wisehyun-2/my_robot_project/wheeled_biped/docs/balancing_robot_design/설계보고서.md

# 자가균형 로봇 설계 보고서 — ROS 2 + Teensy, 직접구동(Direct-Drive) 휠

> **2026-11-14:** 이 문서는 `balancing_robot_design/` 폴더에 있었다. 그 폴더는 지웠고 보고서 두 편과 `figures/`만 여기로 옮겼다. 본문에 나오는 `sim/`, `sim6/`, `sil/`, `firmware/`, `results/`의 파일은 git 태그 `before-cleanup-2026-11-14`의 `balancing_robot_design/`에 있다.

작성일 2026-10-20. 대상: 1번 레퍼런스(Ryung-coding IONIA)의 부품 구성 + DIABLO(DDTRobot) 아키텍처를 참고해 만드는 2륜 자가균형 로봇.
모든 수치 계산은 `sim/` 폴더의 스크립트로 재현 가능하며, 결과 원본은 `results/*.json`, 그림은 `figures/`에 있다.

---

## 0. 요약 (먼저 읽을 것)

| 질문 | 결론 |
|---|---|
| **1번 프로젝트 문제의 "상당수"가 균형 루프를 ROS 2에서 돌린 탓인가?** | **부분적으로만 사실.** 저자들이 기록한 문제 중 ROS 2/지연을 지목한 것은 하나도 없다. 코드를 보면 (a) 바퀴 속도 피드백이 아예 닫혀 있지 않고, (b) ODrive를 **속도 모드**로 쓰며, (c) 모터 명령이 Python 노드의 USB 동기 왕복 6회를 거치고, (d) IMU도 Python/pyserial을 거친다. 시뮬레이션상 이 구조는 지연과 무관하게 드리프트/불안정하고, I/O 경로 지연(추정 20–50 ms)은 안정 한계(30–40 ms) 근처다. 즉 원인은 "ROS 2 실행기"가 아니라 **제어 구조 + Python I/O 경로 지연 + 속도 모드**다. ROS 2 C++ 노드 100 Hz 자체의 오버헤드는 0.2 ms 수준이다. |
| **균형 루프를 MCU로 옮기는 것이 맞나?** | **맞다.** 다만 이유는 "ROS 2가 100 Hz를 못 돌려서"가 아니라 결정성(지터 µs), 센서→토크 지연 1–2 ms 확보, PC/ROS가 죽어도 서 있는 안전성(DIABLO·PX4·Segway 방식)이다. Ascento(NUC 400 Hz), Ollie(PC 1 kHz)처럼 PC에서도 가능하지만 C++·CAN·RT 커널이 전제다. |
| **어떤 제어기를 쓸 것인가?** | **LQR + 속도 적분(LQI), Teensy 4.1에서 1 kHz(최소 500 Hz), 토크(전류) 모드.** 계산 결과: 캐스케이드 PID는 수식상 상태 피드백의 부분집합이라 같은 게인이면 성능이 동일하고(그림 겹침), LQR은 그 게인을 모델에서 바로 얻는다. MPC는 회복 가능 틸트(40°)·푸시(100 N) 모두 LQR과 **동일**했고, 속도 제한 상황도 "LQR + 레퍼런스 클리핑/램프"가 MPC와 동급이었다. MPC는 Teensy에서 2–8 ms/solve라 100 Hz는 가능하나 1 kHz는 불가 → 2단계(휠-레그, 명시적 제약)로 미룬다. DIABLO도 LQR(8상태, 적분 포함)이다. |
| **직접구동 하드웨어 (5–10 kg, DDT 제품 제외)** | 24 V 6S, **MyActuator RMD-L-9015-35T**(1.67 Nm 연속/5 Nm 최대, Kt 0.45, 650 g, CAN 1 Mbps 전류 지령, 14-bit 엔코더, $219) ×2를 5 kg·10 kg 공통 1순위. 5 kg 경량화면 RMD-L-7015(360 g), 10 kg 연속토크 여유면 RMD-L-9025, 최저가·최대토크면 호버보드 허브 + ODrive S1 + 외부 엔코더, 직접구동 포기 시 CyberGear. Teensy 4.1 + CAN(FD) 트랜시버 + ICM-42688-P(SPI) → CAN 토크 명령 1 kHz, UART 460800으로 PC(ROS 2)와 100 Hz 텔레메트리/50–100 Hz 명령. |

산출물: 설계 보고서(이 문서), 동역학 모델·제어기 비교 시뮬레이션(`sim/`), 게인 생성기(`sim/gen_gains.py`), Teensy 균형 루프 스켈레톤(`firmware/teensy_balance/teensy_balance.ino`), 그림 6장.

---

## 1. 레퍼런스 1 (Ryung-coding / IONIA) 분석

### 1.1 코드가 실제로 하는 일 (저장소 HEAD 기준, 사실)

저장소: https://github.com/Ryung-coding/ICT2024_surveillance_balancing_robot

| 항목 | 내용 | 파일 |
|---|---|---|
| 균형 루프 | C++ ROS 2 노드, `rclcpp::WallRate(100)` + `spin_some` while 루프 → **100 Hz** | `src/controller/src/controller_main.cpp`, `include/controller_main.h` (`#define loop_hz 100`) |
| IMU 입력 | 시리얼 AHRS(921600 baud, roll/pitch/yaw + gyro 패킷)를 **Python pyserial** 노드가 바이트 단위 파싱 → `JointState` 토픽 | `src/serial_reciver/.../serial_reciver_node.py` |
| Teensy 역할 | SBUS 수신기·GPS 패킷을 PC로 전달하는 **센서 브리지뿐**. 균형 루프 없음 | 같은 파일 (`TeensyReceiver`) |
| 모터 명령 | C++ → `Float64MultiArray` 토픽 → **Python ODrive 노드** → `odrive` 라이브러리(USB native/fibre) → `input_vel` (**속도 모드**) | `src/odrive_controller/.../odrive_controller.py` |
| ODrive 콜백당 USB 왕복 | `hall_state`, `axis.error`, `motor.error` 읽기, `input_vel` 쓰기, `vel_estimate`, `pos_estimate` 읽기 = **6회 동기 왕복/명령** | 같은 파일 |
| 구동 바퀴 | **axis0 하나만** 명령 발행. 우측(`odrive_publisher_1`)은 주석 처리 | `controller_main.cpp` |
| "속도 외부 루프" | `computePID(0, ref[1], 0, dt, 0)` — 피드백 자리에 **조종기 스틱값**이 들어감. 바퀴 속도는 쓰이지 않음. 게다가 구독 토픽은 `dubal_vel`, ODrive 노드가 발행하는 토픽은 `dubal_data` (이름 불일치 → 데이터가 오지도 않음) | `controller_main.cpp`, `odrive_controller.py` |
| 내부 각속도 루프 | θ̇ 오차 → 모터 속도 명령. θ̈는 100 Hz 수치미분 + LPF(0.9). 코드 주석: `(Not working!!!!!!!!!!!!)` | `controller_main.cpp` |
| 기타 | 100 Hz마다 `RCLCPP_INFO` 로그, ODrive `enable_watchdog = False`, Hall 센서 기반 속도 추정, 적분 안티와인드업만 존재 | |

정리하면 README의 "3중 루프"는 실제로는 **틸트 PID + 스틱 피드포워드**이고, 바퀴 속도/위치 피드백이 없다.

### 1.2 저자들이 직접 기록한 문제

| 기록 | 출처 | 성격 |
|---|---|---|
| "시리얼 포트가 바뀌는 이슈 있으니 확인하고 해야함" | 커밋 d70d6ab (2024-08-29) | Linux 장치 이름(udev) 문제. 타이밍과 무관 |
| "축이 갈려서 D게인을 실제로 잘 반영을 못하고 있었음" | 커밋 ef11ca7 (2024-08-22) | IMU 축/부호 실수 |
| 게인 튜닝 반복(63bc319, 01f5961, 61a8018, d70d6ab) | 커밋 로그 | 통상적 튜닝 |
| 내부 루프 `Not working` | 코드 주석 | 원인 미기록 |
| 빌드 실패(`dubal_eye_and_web` 디렉토리 이름 불일치) | `log/build_*/` | 패키징 |

ROS 2, 지연, 지터, 메시지 드롭을 언급한 기록은 **없다.** (GitHub 이슈 4건은 제목이 무의미 문자열, Notion 페이지는 README 복제 + 코드 나열.)

### 1.3 "ROS 2 때문"이라는 주장의 검증

**(a) 문헌 수치 — ROS 2/Linux/USB 경로가 실제로 얼마나 느린가**

| 항목 | 수치 | 조건 | 출처 |
|---|---|---|---|
| ROS 2 pub→sub 종단 지연(프로세스 간, 3노드) | 약 0.15–0.2 ms (95%) | Foxy, i7 데스크톱, 일반 커널 | Kronauer et al. 2021, https://arxiv.org/abs/2101.02074 |
| 같은 것, Raspberry Pi 4 | 1.0–1.6 ms | 같은 조건 | 같은 논문 |
| ROS 2 1 kHz 실시간 데모 지연 | 평균 19.9 µs, **최대 2.75 ms** | 일반 커널 rclcpp | https://docs.ros.org/en/dashing/Tutorials/Real-Time-Programming.html |
| 일반 Linux 스케줄링 지연(cyclictest) | I/O 부하 시 > 5 ms, 디스크 부하 시 80–200 ms 스파이크 | 일반 커널 / PREEMPT_RT는 < 50 µs | Cerqueira & Brandenburg, OSPERT 2013 |
| **rclpy(Python) 50 Hz 타이머** | 간격이 최대 **100 ms**까지 벌어짐, 센서 메시지 200 ms 지연 | RPi4, Eloquent | https://www.barkhauseninstitut.org/research/lab-1/our-blog/posts/soft-realtime-performance-of-rclpy |
| FTDI USB-시리얼 latency timer | 기본 **16 ms** 버퍼 플러시 | Linux ftdi_sio | https://granitedevices.com/wiki/FTDI_Linux_USB_latency |
| ODrive USB native 1회 읽기/쓰기 | 0.25–0.3 ms (PC), **1.6–1.7 ms (RPi/Jetson)**; 사용자 보고: 6읽기+2쓰기로 ≈100 Hz 한계 | odrive Python 라이브러리 | https://discourse.odriverobotics.com/t/decreasing-latency/1463 |
| ODrive 공식 권고 | CAN은 "호스트 컴퓨터가 없어 지연·지터가 낮다" | | https://docs.odriverobotics.com/v/latest/guides/can-guide.html |
| ros2_control 공식 문서 | "일반 Linux 커널은 처리량에 최적화되어 하드웨어 제어에 적합하지 않다" → RT 커널·SCHED_FIFO 권고 | | https://control.ros.org/rolling/doc/ros2_control/controller_manager/doc/userdoc.html |

**(b) 실제 균형 로봇들은 어디서 균형 루프를 도는가**

| 로봇 | 위치 / 주기 | 출처 |
|---|---|---|
| DIABLO (DDT) | **MCU(ChibiOS/RT)**, BMI088 SPI, CAN→드라이버, LQR. PC는 UART로 setpoint만 | https://arxiv.org/abs/2407.21500 |
| Ascento (ETH) | Intel NUC, ROS/C++ **400 Hz**, CAN 모터 | https://arxiv.org/pdf/2005.11431 |
| Tencent Ollie | 온보드 x86 PC **1 kHz**, IMU 400 Hz | https://www.frontiersin.org/journals/neurorobotics/articles/10.3389/fnbot.2022.1102259/full |
| Rezero 볼봇 (ETH) | i7 추정기 400 Hz, MPC ≈70 Hz(ROS 노드), 토크 루프는 드라이버 2.5 kHz | https://arxiv.org/pdf/1902.10415 |
| Segway PT | 제어 프레임 ≥ **100 Hz**("100 Hz 미만이면 탑승자가 불안정하게 느낌") | 특허 US6796396B2 |
| PX4 드론 | NuttX RTOS 비행 컨트롤러, Linux는 비전만 | https://docs.px4.io/main/en/concept/architecture.html |

즉 "PC+ROS에서 균형 루프"는 C++·저지연 버스·(대개) RT 커널이면 성립하고, 100 Hz도 Segway 수준이다.

**(c) 이 로봇 모델로 직접 계산한 지연 허용치** (`sim/analysis_controllers.py`, `figures/stability_map_rate_vs_latency.png`)

세 파라미터 세트(1번 로봇 유사 / 계획 로봇 / 무거운 로봇)에 대해, 각 루프 주기마다 이산 LQR을 다시 설계하고 센서→토크 총 지연을 바꿔가며 3° 기울임에서 복귀하는지 시뮬레이션했다.

| 로봇 (불안정 극) | 50 Hz | 100 Hz | 200 Hz | 500 Hz | 1 kHz |
|---|---|---|---|---|---|
| 1번 유사(105 mm 휠, 8.2 rad/s) | 30 ms | 30 ms | 30 ms | 30 ms | 30 ms |
| 계획(10 kg, 6.5" 휠, 6.9 rad/s) | 40 ms | 40 ms | 40 ms | 40 ms | 40 ms |
| 무거운(15 kg, 8" 휠, 6.2 rad/s) | 40 ms | 40 ms | 40 ms | 40 ms | 40 ms |

(표의 값 = 복귀에 성공한 최대 총 지연. 위상여유 72°, 교차주파수 29.6 rad/s 설계 → 이론 지연여유 43 ms와 일치.)

핵심: **이 대역폭의 설계에서는 루프 주기(50 Hz–1 kHz)는 거의 무관하고, 총 지연이 30–40 ms를 넘으면 넘어진다.** 더 뻣뻣한(교차 100 rad/s) 설계라면 허용 지연이 10 ms 수준으로 줄어 1 kHz + 저지연이 필요해진다.

같은 모델에서 100 Hz + 15 ms 지연은 1 kHz + 1 ms와 거의 같은 응답(12° 복귀 정착 1.05 s vs 1.05 s)이지만, **100 Hz + 40 ms**는 서 있기는 해도 정착 3.1 s, 토크 RMS 5배, 바퀴 속도 피크 1.15 m/s(0.49 대비)로 크게 흔들린다(`figures/time_response_comparison.png`, 빨간 선).

**(d) 1번 프로젝트의 경로 지연 추정 (측정값 아님, 문헌 수치로 합산)**

IMU 내부 출력 주기(≈10 ms 추정) + USB-시리얼(CP210x 1 ms / FTDI 최대 16 ms) + Python 파싱·DDS(≈1 ms) + 100 Hz 루프 대기(평균 5 ms) + DDS→Python ODrive 노드(USB 6회 왕복: PC 2 ms, ARM 보드 10 ms) + ODrive 속도 루프(Hall 센서, 수십 ms 응답) ≈ **20–50 ms**. 안정 한계(30 ms) 근처라 "흔들리며 서 있는" 상태와 부합한다.

**(e) 그러나 구조적 문제가 더 크다** (`results/velocity_mode_latency_tolerance.json`)

1번 로봇 모델로 "속도 모드 + 바깥 PD(θ)" 구조를 시뮬레이션하면:

| 구조 | 100 Hz 허용 지연 | 500 Hz 허용 지연 |
|---|---|---|
| 토크 모드, LQR (직접구동 권장 구조) | 30 ms | 30 ms |
| 속도 모드, 드라이버 P 루프만 + 바깥 PD(θ) **+ 바퀴속도 피드백** | 40 ms | 40 ms |
| 속도 모드, 드라이버 **PI** 루프(ODrive 기본) + 바깥 PD(θ)만 (**1번 구조**) | 불안정 (지연 0에서도) | 불안정 |
| 속도 모드, P 루프 + 바깥 PD(θ)만 (바퀴 피드백 없음) | 불안정 | 불안정 |

이유(수식): 드라이버 속도 루프 τ = Kp_v(ω_ref − ω)는 토크 모드로 환산하면 바퀴 속도에 **음의 피드백**(−Kp_v/r)을 거는 것인데, 균형에는 바퀴 속도에 **양의 피드백**(LQR의 k_v > 0 항)이 필요하다. 바깥 루프가 바퀴 속도를 되먹이지 않으면 이를 상쇄할 수 없고, 적분기가 있으면 정상상태에서 토크가 θ에 의존하지 않게 되어 복원력 자체가 사라진다. 토크 모드 캐스케이드라도 바퀴 피드백이 없으면 각도는 잡히지만 속도가 0.3–0.5 m/s로 드리프트한 채 돌아오지 않는다(그림의 갈색 선).

**결론:** "1번의 문제 상당수가 ROS 2에서 균형 루프를 돌린 데서 왔다"는 **근거 없는 과장**이다. 근거 있는 원인은 (1) 바퀴 속도 피드백 누락·토픽 불일치·한쪽 바퀴만 구동, (2) ODrive 속도 모드 + 적분기, (3) Python I/O 경로(pyserial IMU, USB ODrive 6회 왕복)의 20–50 ms 지연, (4) Hall 센서 속도 추정이다. (3)은 MCU+CAN으로 옮기면 1–2 ms로 사라지므로 **이전 결정은 옳지만**, (1)(2)(4)는 Teensy로 옮겨도 그대로 재현된다. 이 보고서의 제어기·하드웨어 설계는 이 네 가지를 모두 제거하는 것을 목표로 한다.

---

## 2. DIABLO 아키텍처 — 무엇을 베낄 것인가

출처: 논문 https://arxiv.org/abs/2407.21500, SDK https://github.com/DDTRobot/diablo_ros2, 문서 https://diablo-sdk-docs.readthedocs.io, 사용자 매뉴얼 V1.1.

| 계층 | DIABLO (문서화된 사실) | 이 프로젝트에 적용 |
|---|---|---|
| 실시간 보드 | ChibiOS/RT MCU. BMI088 IMU(SPI), CAN으로 6개 M1502D 드라이버, LQR 균형/요, PD+FF 높이, 롤, 다리 split, 상보필터 추정기, 점프·낙상복구, BMS, 워치독. 루프 주기·MCU 품번은 미공개(텔레메트리 옵션 1 kHz로 보아 ≥1 kHz 추정) | Teensy 4.1 (Cortex-M7 600 MHz), 1 kHz 타이머 ISR, IMU SPI, CAN 토크, LQI |
| 호스트 링크 | UART **460800 8N1**, OSDK 프레임(SOF 0xAA, 헤더 12 B, CRC16 ×2). 명령: 활성화, 제어권 요청(`timeout_ms` 기본 500 ms 동안 유효한 메시지가 없으면 제어권 자동 해제. 해제 후 동작은 `timeout_act` 비트로 선택: 1 = 실제 RC로 전환, 0 = 전환 없이 끊김 처리 프로그램 실행. **SDK는 0 고정**, `osdk_movement.cpp`), 이동 명령(전진 m/s, 요 rad/s, 높이, 롤, 피치, split), 모드, 변신/점프, 비상 브레이크 | 동일한 UART 460800 + 경량 바이너리 프레임, 또는 micro-ROS (3.4절) |
| 텔레메트리 | 토픽별 1/10/50/100/500/1000 Hz 선택. ROS 노드는 IMU·모터 **50 Hz**, 상태 10 Hz, 전원 1 Hz. 대역폭 ≤ 0.75×baud 가드 | 상태 100 Hz, IMU 200 Hz(옵션), 전원 1 Hz |
| 명령 주기/안전 | 이동 명령은 ACK 없이 스트리밍, 마지막 명령을 **180 ms마다 재전송**(keep-alive), 모드 변경은 100 ms ACK, 수신 타임아웃 1 s → DISCONNECT. 제어권 만료 시 SDK 기본값(`timeout_act=0`)으로는 RC로 넘어가지 않고 MCU의 끊김 처리 프로그램 실행(동작 내용은 펌웨어 비공개라 미확인), RC 자동 전환은 `timeout_act=1`일 때만 | 명령 타임아웃 0.5 s → v=0 유지, 2 s → 모터 OFF, RC(SBUS) 백업 |
| 제어기 | 8상태 LQR [γ, θ, x, γ̇, θ̇, ẋ, ∫γ, ∫x], Q/R 튜닝 후 DARE 풀이(Webots), 요 LQR, 높이 PD+FF. "LQR·MPC 중 해석 가능성과 튜닝 용이성 때문에 모델 기반 LQR 선택", WBC는 향후 과제 | 5상태 LQI [x(0), ẋ, θ, θ̇, ∫ẋ] + 요 PD. 다리(높이) 추가 시 PD+FF |
| 액추에이터 | M1502D 직접구동 ×6: 정격 9.6 Nm/115 rpm, 스톨 17 Nm, 24 V, Kt 0.88, 16384 cnt 절대 엔코더, 2.3–2.6 kg. 로봇 22.9 kg, 2 m/s | 3.2절의 M15 계열 |

DDT가 "왜 균형을 MCU에 두는가"를 명시한 문장은 없지만, 논문은 "주변장치 통신과 모션 제어는 RTOS MCU, 내비게이션·인식 등 연산 집약 작업은 ROS 미니 PC"로 역할을 나누고, 균형 루프의 레퍼런스가 PC 또는 RC 둘 중 어디서든 올 수 있게 해 **PC가 없어도 서 있도록** 설계했다. 2026-10 DDT 블로그는 SDK 사용자에게 "네트워크 지연, 오래된 명령, 제어권 상실에 대한 동작을 직접 정의하라"고 쓴다.

---

## 3. 하드웨어 아키텍처 (직접구동, 고 Kt 모터)

### 3.1 필요한 토크·속도 (모델 계산, `results/torque_sizing.json`, `results/sizing_options_*.json`)

모델: 2륜 역진자(TWIP), 직접구동이라 모터 토크 = 바퀴 토크, 반작용이 몸체에 작용. 파라미터는 **가정값**이며 실제 로봇에서 측정 후 `gen_gains.py`로 재계산해야 한다. 목표 로봇 질량은 **5–10 kg**이므로 두 끝단을 모두 계산했다.

| 파라미터 세트 | 총질량 | 몸체 M_b | 휠(모터 포함) m_w | 반경 r | 무게중심 높이 l | 몸체 관성 I_b | 불안정 극 | 10°/20° 정적 유지 토크(합) |
|---|---|---|---|---|---|---|---|---|
| **소형(5 kg급)** | ≈4.6 kg | 3.2 kg | 0.7 kg | 65 mm (5") | 0.16 m | 0.07 | 6.9 rad/s (145 ms) | 0.9 / 1.7 Nm |
| **대형(10 kg급)** | ≈9.4 kg | 7 kg | 1.2 kg | 82.5 mm (6.5") | 0.25 m | 0.20 | 6.9 rad/s (145 ms) | 3.0 / 5.9 Nm |
| (참고) 1번 유사 | 5.2 kg | 4 kg | 0.6 kg | 52.5 mm | 0.18 m | 0.06 | 8.2 rad/s (122 ms) | 1.2 / 2.4 Nm |
| (참고) 15 kg급 | 15.2 kg | 12 kg | 1.6 kg | 100 mm (8") | 0.35 m | 0.60 | 6.2 rad/s (161 ms) | 7.2 / 14.1 Nm |

**바퀴당** 요구 토크 (LQR 1 kHz로 복귀 시 피크, IMU 노이즈 포함; 소형은 1번 유사 세트와 거의 같다):

| 상황 | 소형 5 kg급 (1번 유사) | **대형 10 kg급** | 15 kg급 |
|---|---|---|---|
| 5° 기울임 복귀 피크 | 0.56 Nm | 1.56 Nm | 3.2 Nm |
| 10° 복귀 피크 | 1.13 | 3.12 | 6.4 |
| 15° 복귀 피크 | 1.69 | **4.69** | 9.6 |
| 20° 복귀 피크 | 2.25 | 6.25 | 12.8 |
| 40 N × 0.1 s 푸시 | ≈0.7 | 1.36 | — |
| 1 m/s 속도 스텝(1 m/s² 램프) | 0.2 | 0.34–0.5 | — |
| 10° / 15° 경사 유지(연속) | 0.23 / 0.35 | 0.66 / 0.98 | 1.29 / 1.93 |
| 1.0 / 1.5 m/s에 필요한 바퀴 rpm | 147 / 220 (r 65 mm) | 116 / 174 | 96 / 143 |

요구 사양 요약 (바퀴당):

| | 소형 5 kg급 | 대형 10 kg급 |
|---|---|---|
| 정지 연속 토크 | ≥ 0.5–1 Nm | ≥ 1.5–2 Nm |
| 피크 토크(15–20° 복귀) | ≥ 2–2.5 Nm | ≥ 5–6.5 Nm |
| 무부하 속도 | ≥ 250 rpm (1.5 m/s + 여유) | ≥ 220 rpm |
| 휠+모터 질량 | ≤ 0.9 kg | ≤ 1.5 kg (호버보드급 2.9 kg도 가능하나 총질량 상승) |
| 전원 | 24 V (6S), 피크 15 A 이내 | 24 V (6S), 피크 15–20 A |

직접구동은 정지 상태에서 토크를 내므로 "정지 연속 토크(열)"가 구속 조건이고, 프로펠러 냉각을 전제로 한 드론 모터 스펙은 그대로 쓸 수 없다.

### 3.2 모터 + 드라이버 후보 (DDT/DIABLO 제품 제외, 시판품만. 2026-10 판매 페이지 기준, 1개 정가)

DDT를 제외하면 "기어 없는 직접구동 + FOC 드라이버·엔코더 내장 + CAN 토크 모드"를 만족하는 시판 모터는 사실상 **MyActuator RMD-L 시리즈**와 **LK Tech MF 시리즈**뿐이다. 그 외는 (a) 허브 모터 + 외부 FOC 드라이버, (b) 짐벌 모터 + 외부 FOC 드라이버, (c) 저감속비 유성기어 액추에이터(직접구동 포기)다. 구매 채널: RobotShop(한국 배송), OpenELAB, AliExpress 공식 스토어, mjbots, ODrive 공식몰; 국내몰(디바이스마트·엘레파츠)은 Teensy·IMU·트랜시버·배터리 등 주변 부품 위주.

**표 A. 직접구동 + 드라이버 내장 (1순위 계열)**

| 모델 | 정격 / 최대 토크 | Kt | 질량 | 전압 / 속도 | 엔코더·버스 | 토크 모드 | 가격 | 적합 등급 | 출처 |
|---|---|---|---|---|---|---|---|---|---|
| **MyActuator RMD-L-9015-35T** | 1.67 / **5.0 Nm** (11 A) | 0.45 | 650 g | 24 V (8–36), 정격 290 / 무부하 500 rpm | 14-bit 자기식, **CAN 1 Mbps** / RS485 | "Torque open loop"(전류 지령) 명시 | **$219** | **5 kg·10 kg 모두** | https://www.robotshop.com/products/myactuator-rmd-l-9015-35t-bldc-can-bus-servo |
| **MyActuator RMD-L-9025-35T** | 2.42–2.79 / 4.58–5.8 Nm (리셀러마다 상이) | 0.76 | 880 g | 24 V, 130–490 rpm | 14-bit, CAN 1 Mbps (2 kHz 통신) | 전류 지령 | $237–350 (일부 품절) | 10 kg | https://www.robotshop.com/products/myactuator-rmd-l-9025-35t-brushless-dc-servo-motor-can |
| **MyActuator RMD-L-7015-23T** | 1.0 / **3.8 Nm** (15 A) | 0.28 | **360 g** | 12–24 V, 정격 580 / 최대 805 rpm | 18-bit, CAN 2.0B 1 Mbps | 전류 지령 | $199 (£107) | **5 kg** | https://openelab.com/products/myactuator-rmd-l-7015-can |
| LK Tech MF9025 V2 | 2.42 / 4.5 Nm | ≈0.7 | ≈0.9 kg | 24 V | 18-bit, CAN/RS485, 토크 루프 24 kHz | 전류 지령 | 리셀러 | 10 kg | https://www.roboticscenter.ai/pt/store/product/lkmtech-mf9025-v2-motor |
| Waveshare DDSM115 | 0.96 / 2.0 Nm (8 A) | 0.75 | 770 g (타이어 포함) | 12–24 V, 115 / 200 rpm | 4096, **RS485 115200, ≤500 Hz** | 전류 루프 | $65 | 5 kg (속도 1.3 m/s 한계) | https://www.waveshare.com/wiki/DDSM115 |

DDSM115는 Waveshare 브랜드로 Waveshare 스토어·AliExpress에서 팔리지만 제조는 DDT(M0601C와 동일 스펙)이므로, DDT 제품을 피하는 이유가 "브랜드 자체"라면 제외한다.

**표 B. 허브 모터 + 외부 FOC 드라이버 (저가·재활용 계열)**

| 모터 | 토크 | Kt | 질량 | 센서 | 드라이버 | 평가 | 출처 |
|---|---|---|---|---|---|---|---|
| 호버보드 6.5" 허브 (36 V 250–350 W, 15극쌍) | 데이터시트 없음. 사용자 보고: 연속 2–3 Nm(열), 20 A 피크 ≈ 10 Nm | ≈0.52 (KV≈16, ODrive 규약 8.27/KV) | ≈2.9 kg/휠 | Hall 90 cpr → **외부 엔코더 추가 권장**(AS5047P/MT6701 + 회전 커버에 직경자화 자석, 또는 ODrive S1 온보드 엔코더) | ODrive S1 ($149, 40/80 A, CAN 1 Mbps, 8 kHz 루프, 토크 모드 `Set_Input_Torque`) | 10 kg급에 토크 여유 최대. 무겁고 총질량이 커짐. 1번 프로젝트 부품 재활용 가능 | https://docs.odriverobotics.com/v/0.5.6/hoverboard.html , https://shop.odriverobotics.com/products/odrive-s1 |
| 전동킥보드 8"/8.5" 허브 (36 V 250 W, Xiaomi M365류) | 사용자 보고 수준 | ≈0.5 | ≈2 kg | Hall | ODrive S1 / Micro | 10 kg급 대안. 타이어 포함 완제품이라 조립 쉬움 | 리셀러 |

**표 C. 짐벌/아웃러너 모터 + 외부 FOC (경량·고대역폭 계열)**

| 모터 | 토크 | Kt | 질량 | 드라이버 | 평가 | 출처 |
|---|---|---|---|---|---|---|
| iPower GM110-8 (24N28P 짐벌) | 0.78–1.18 Nm @2 A, ≤60 W | ≈0.5–0.8 | 534 g | moteus c1 ($69, 5/14 A, CAN-FD) 또는 ODrive Micro ($89, 3.5/7 A) | **5 kg에 한계**: 무부하 130 rpm(0.9 m/s), 피크 2 Nm → 모델상 30° 복귀·30 N 푸시까지. 저속 실내용 | https://shop.iflight.com/ipower-motor-gm110-8-brushless-gimbal-motor-pro197 |
| mjbots mj5208 | 1.7 Nm 피크(600 W), 연속 ≈0.4 Nm | ≈0.03 | 193 g | moteus c1 | 피크는 충분하나 피크 전류 57 A·정지 연속 토크 부족 → 5 kg도 냉각 전제 | https://mjbots.com/products/mj5208 |
| T-Motor U8 Lite KV85 / U10 II KV100 | 180 s 피크 2.1 / 3.6 Nm | ≈0.11 / 0.095 | 243 / 415 g | moteus n1 ($149, CAN-FD 5 M) | 10 kg에 피크는 가능, 정지 연속 토크는 냉각 필요. 연구용 | https://store.tmotor.com |

**표 D. 저감속 유성기어 액추에이터 (직접구동 포기 시 대안, 모두 CAN MIT식 토크 모드)**

| 모델 | 감속비 | 정격 / 최대 토크 | 질량 | 가격 | 평가 | 출처 |
|---|---|---|---|---|---|---|
| Xiaomi CyberGear | 7.75:1 | 4 / 12 Nm | 317 g | $90–165 | 가장 싸고 가볍다. 백래시·기어 마찰이 토크 투명성 저하, 지연여유 13–23 ms로 줄어듦(관성 반영) | https://openelab.io/blogs/learn/xiaomi-cybergear-micromotor-guide |
| CubeMars AK60-6 V3 | 6:1 | 3 / 9 Nm | 380 g | $230–300 | 5–10 kg 모두 가능 | https://www.cubemars.com |
| CubeMars AK70-10 / AK80-9 | 10:1 / 9:1 | 8.3 / 24 Nm, 9 / 18 Nm | 520 / 485 g | $400–580 | 10 kg 이상 | https://www.cubemars.com |

**후보별 모델 계산 결과** (`sim/sizing_options.py`, 1 kHz LQI, 2 ms 지연, 모터 토크-속도 포락선 포함)

| 후보 (바퀴당) | 5 kg급: 최대 복귀 틸트 / 푸시(0.1 s) / 1.5 m/s | 10 kg급: 틸트 / 푸시 / 1.5 m/s | 피크 상전류 |
|---|---|---|---|
| RMD-L-7015-23T | 45° / 190 N / 가능 | — (피크 3.8 Nm으로 15° 복귀 한계) | 13.6 A |
| **RMD-L-9015-35T** | 45° / 120 N / 가능 | 45° / 200 N / 가능 | 11.1 A |
| RMD-L-9025-35T | 45° / 120 N / 가능 | 45° / 200 N / 가능 | 6.0 A |
| LK MF9025 V2 | — | 45° / 170 N / 가능 | 6.4 A |
| DDSM115 | 40° / 40 N / **불가(무부하 200 rpm)** | — | 2.7 A |
| 호버보드 + ODrive S1 (12–20 A) | — | 45° / 200 N / 가능 | 11.5–19 A |
| GM110-8 + moteus c1 | 30° / 30 N / 불가 | — | 2.5 A |
| CyberGear (기어) | 45° / 110 N / 가능 | 45° / 200 N / 가능 | 13.8 A |

(틸트·푸시 상한 45°·200 N은 스윕 범위 끝이며 물리 한계가 아니다.)

**선정**

| 등급 | 1순위 | 2순위 | 근거 |
|---|---|---|---|
| **5 kg급** | **RMD-L-9015-35T ×2** ($219, 650 g, 5 Nm 피크) | RMD-L-7015-23T ×2 ($199, 360 g, 3.8 Nm 피크) — 더 가볍고 빠르나 Kt 0.28이라 피크 15 A | 요구(연속 0.5–1, 피크 2–2.5 Nm, 250 rpm)를 2배 여유로 충족, CAN 1 Mbps 전류 지령, 14/18-bit 엔코더 내장 |
| **10 kg급** | **RMD-L-9015-35T ×2** 또는 **RMD-L-9025-35T ×2** | 호버보드 6.5" + ODrive S1 + 외부 엔코더 (최저가, 토크 여유 최대, 무거움) | 9015는 피크 5 Nm으로 15–16° 복귀까지, 9025는 연속 2.4 Nm으로 경사·연속 주행 여유. 20° 이상 복귀나 거친 외란이 필요하면 호버보드+ODrive |
| 공통 대안 | CyberGear ×2 | — | 직접구동을 포기할 수 있다면 가장 싸고 가볍다 |

**RMD-L 시리즈는 5–10 kg 전 구간에서 같은 모델(9015)로 통일 가능**하므로 1순위로 둔다. 바퀴는 모터 출력 플랜지에 직접 볼트 체결하는 5"(소형) 또는 6.5"(대형) 림+타이어(전동킥보드 솔리드 타이어, AliExpress)를 쓴다. 구매 전 확인: MyActuator CAN 프로토콜 문서의 "torque closed-loop control command"(0xA1, Iq 지령 단위·스케일)와 2 kHz 통신 주기, 리셀러마다 다른 피크 토크 수치(4.58 vs 5.8 Nm)는 공식 데이터시트로 확정.

Kt 환산: Kt[Nm/A] ≈ 9.55/KV[rpm/V] (SI), ODrive 표기 규약은 8.27/KV. 벤더 간 10–15 % 차이(RMS/peak 규약)가 있으니 **전류 명령 스케일은 실측(매달고 토크 측정)으로 보정**한다.

### 3.2a 전체 BOM (시판품, 5 kg급 기준; 10 kg급은 ★ 표시 항목만 교체)

| # | 부품 | 모델 / 사양 | 수량 | 단가(USD) | 구매처 |
|---|---|---|---|---|---|
| 1 | 휠 모터(FOC·엔코더 내장) | **MyActuator RMD-L-9015-35T** CAN (★10 kg: 9015 유지 또는 9025-35T) | 2 | 219 (★ 237–350) | RobotShop, AliExpress MyActuator 공식 |
| 2 | 림+타이어 | 5" 솔리드 타이어 + 알루미늄 림, 모터 플랜지 체결 (★ 6.5") | 2 | 15–30 | AliExpress |
| 3 | MCU | **Teensy 4.1** (핀 헤더 포함) | 1 | 35 | 디바이스마트 / PJRC / SparkFun |
| 4 | CAN 트랜시버 | SN65HVD230 3.3 V 브레이크아웃(CAN 2.0B, RMD용) — CAN-FD 드라이버(moteus) 쓸 때만 MCP2562FD/TCAN330 | 1–2 | 3–10 | 디바이스마트 / AliExpress |
| 5 | IMU (SPI) | **ICM-42688-P** 브레이크아웃 (대안: Adafruit ISM330DHCX/LSM6DSOX, BMI088 보드) | 1 | 10–25 | AliExpress / Adafruit(국내 리셀러) |
| 6 | RC 수신기(백업·킬스위치) | SBUS 수신기 (FrSky/Radiomaster/ELRS) | 1 | 20–30 | 국내 RC몰 |
| 7 | 배터리 | **6S Li-ion 22.2 V 3–5 Ah** + BMS (★ 5–10 Ah) | 1 | 60–120 | 국내 배터리몰 / AliExpress |
| 8 | 전원 보호 | 블레이드 퓨즈 15 A (★ 30 A), E-stop 스위치 + 릴레이/컨택터(모터 전원만 차단), TVS 다이오드 또는 브레이크 저항(회생) | 1식 | 20–40 | 디바이스마트 |
| 9 | DC-DC | 24→5 V 5 A (Teensy·IMU·RC), 24→5 V 5 A 또는 19 V (PC) | 2 | 10–20 | 디바이스마트 |
| 10 | 컴패니언 PC | Raspberry Pi 5 8 GB (비전 경량) 또는 Jetson Orin Nano Dev Kit (비전 중량) | 1 | 80 / 250 | 국내 리셀러 |
| 11 | 카메라 | Raspberry Pi Camera 3 / USB 글로벌셔터 | 1 | 25–60 | 국내 리셀러 |
| 12 | 배선 | CAN 트위스트페어 + 120 Ω 종단 2개, XT60/XT30, 전원 분배보드 | 1식 | 20 | 디바이스마트 |
| 13 | 프레임 | 알루미늄 프로파일 2020 + 3D 프린트 브래킷 | 1식 | 50–100 | 국내 |
| | **합계(모터 2개 포함)** | | | **≈ 650–900 (5 kg) / ≈ 750–1100 (10 kg)** | |

호버보드+ODrive 경로로 바꿀 때: 1→ 호버보드 모터 중고 2개(≈40) + ODrive S1 2개(298) + AS5047P 엔코더 2개(20) + 자석·브래킷, 7→ 36 V 10S 또는 24 V(ODrive S1 12–48 V), 8→ 퓨즈 40 A·브레이크 저항 필수(ODrive S1 내장 브레이크 초퍼 사용).

### 3.2b 구매 링크 (2026-10-20 확인. ✔ = 상품 페이지 확인, 🔍 = 검색 페이지·키워드)

| 부품 | 링크 | 비고 |
|---|---|---|
| RMD-L-9015-35T | ✔ https://www.robotshop.com/products/myactuator-rmd-l-9015-35t-bldc-can-bus-servo | $219.34, 한국 배송. 제조사 코드 RMD-L-9015-200-C(CAN) 확인 후 주문 |
| RMD-L-9025-35T | ✔ https://www.robotshop.com/products/myactuator-rmd-l-9025-35t-brushless-dc-servo-motor-can | $237–350, 품절 잦음 |
| RMD-L-7015-23T | ✔ https://openelab.com/products/myactuator-rmd-l-7015-can , ✔ https://uk.robotshop.com/products/myactuator-rmd-l-7015-200-bldc-motor-w-controller-position-sensor-can-bus | $199 / £107 |
| MyActuator 전체 | ✔ https://community.robotshop.com/forum/t/myactuator-is-now-officially-part-of-the-robotshop-marketplace/78207 (RobotShop 공식 벤더), 제조사 https://www.myactuator.com | 데이터시트·CAN 프로토콜 문서는 제조사 사이트 |
| ODrive S1 / Micro | ✔ https://shop.odriverobotics.com/products/odrive-s1 , ✔ https://shop.odriverobotics.com/products/odrive-micro | 호버보드 가이드 ✔ https://docs.odriverobotics.com/v/0.5.6/hoverboard.html |
| moteus c1 / n1 / r4.11, mj5208 | ✔ https://mjbots.com/products/moteus-n1 , ✔ https://mjbots.com/products/moteus-r4-11 , ✔ https://mjbots.com/products/mj5208 , c1는 mjbots.com 상점에서 "moteus-c1" | CAN-FD, 미국 발송 |
| Waveshare DDSM115 | ✔ https://www.waveshare.com/wiki/DDSM115 (상품 링크는 위키 상단) | DDT 제조품 |
| iPower GM110-8 | ✔ https://shop.iflight.com/ipower-motor-gm110-8-brushless-gimbal-motor-pro197 | 짐벌 모터 |
| CyberGear / CubeMars | ✔ https://openelab.io/blogs/learn/xiaomi-cybergear-micromotor-guide , ✔ https://www.cubemars.com/product/ak60-6-v3-0-kv80-robotic-actuator.html | 기어드 대안 |
| Teensy 4.1 | ✔ https://www.pjrc.com/store/teensy41.html , ✔ https://www.sparkfun.com/products/16771 , 🔍 https://www.devicemart.co.kr/goods/search?keyword=Teensy%204.1 | 국내는 디바이스마트·엘레파츠 검색 |
| CAN 트랜시버 | ✔ https://www.waveshare.com/sn65hvd230-can-board.htm (CAN 2.0B, 3.3 V), ✔ https://protosupplies.com/product/mcp2562fd-high-speed-can-bus-transceiver/ (CAN-FD), ✔ https://www.tindie.com/products/fusion/single-can-fd-adapter-for-teensy-41/ , 🔍 https://www.devicemart.co.kr/goods/search?keyword=SN65HVD230 | RMD-L은 CAN 2.0B라 SN65HVD230이면 충분 |
| IMU | ✔ https://www.elecrow.com/icm-42688-p-ultra-low-power-imu-breakout.html (ICM-42688-P), ✔ https://www.digikey.com/en/products/detail/tdk-invensense/QCIOT-ICM42688P/25676496 (Pmod), ✔ https://www.adafruit.com/product/4502 (ISM330DHCX), ✔ https://www.adafruit.com/product/4438 (LSM6DSOX), 🔍 AliExpress "ICM-42688-P module" | SPI 핀이 나와 있는 보드만. Grove BMI088은 I2C 전용이라 제외 |
| 라즈베리파이 5 / Jetson | 🔍 https://www.devicemart.co.kr/goods/search?keyword=%EB%9D%BC%EC%A6%88%EB%B2%A0%EB%A6%AC%ED%8C%8C%EC%9D%B4%205 , ICbanQ·엘레파츠 "라즈베리파이 5 8GB" / "Jetson Orin Nano" | 국내 공식 리셀러 |
| 배터리·DC-DC·퓨즈·릴레이·SBUS 수신기 | 🔍 디바이스마트 "6S 리튬이온 배터리", "DC-DC 24V 5V 5A", "블레이드 퓨즈", 국내 RC몰 "SBUS 수신기 ELRS" | 범용품 |

해외 직구 시 미화 150달러(미국발 200달러) 초과분은 관세·부가세 대상이므로 모터 2개는 분할 주문이 유리할 수 있다.

### 3.3 시스템 블록도

```
                 ┌──────────────────────── 24 V 6S Li-ion 10 Ah ─────────────────────┐
                 │  메인 퓨즈 30 A ─ E-stop 컨택터(모터 전원만) ─ 회생 보호(TVS/브레이크 저항 또는 충전 허용 BMS)
                 │  DC-DC 5 V 5 A (Teensy, IMU, RC RX)   DC-DC 12/19 V (PC)
                 └──────────────┬──────────────────────────────┬──────────────────────┘
                                │                              │
   ┌──────────── Teensy 4.1 (1 kHz 균형 루프) ────────────┐    ┌───── 컴패니언 PC (ROS 2) ─────┐
   │ ICM-42688-P (SPI 10 MHz, ODR 1 kHz, LPF ≈150 Hz)    │    │ Jetson Orin Nano / RPi 5     │
   │ 상보필터/칼만 → θ, θ̇, ψ̇                             │UART│ mcu_bridge (C++)             │
   │ LQI(ẋ, θ, θ̇, ∫ẋ) + 요 PD → τ_L, τ_R                │◄──►│  /cmd_vel 50–100 Hz →        │
   │ 안전: 틸트 컷, 명령 타임아웃, 피드백 타임아웃, 토크/속도 리밋│460800│  ← /imu, /joint_states 100 Hz│
   │ SBUS RX (백업 RC, 킬 스위치)                           │    │ 카메라/비전, nav2, rosbag      │
   │ 배터리 전압·전류 ADC, 부저/LED                          │    └──────────────────────────────┘
   │ CAN1 (2.0B 1 Mbps) 또는 CAN3 (FD) + MCP2562FD/TCAN330 │
   └───────────────┬──────────────────────┬───────────────┘
                   │ 1 kHz Iq 명령 / 피드백 │
          ┌────────▼────────┐    ┌────────▼────────┐
          │ 좌 휠 RMD-L-9015 │    │ 우 휠 RMD-L-9015 │   (FOC·전류루프·절대엔코더 내장, 120 Ω 종단)
          └─────────────────┘    └─────────────────┘
```

| 버스 | 주기 | 부하 | 비고 |
|---|---|---|---|
| CAN 토크 명령 + 피드백 | 1 kHz × 2 모터 | ≈2×(8+8) B/ms ≈ 32 kbit/s ≪ 1 Mbps | Teensy 4.1 CAN1/2 = 2.0B, CAN3 = FD (FlexCAN_T4, https://github.com/tonton81/FlexCAN_T4). moteus는 CAN-FD 1M/5M |
| UART Teensy↔PC | 명령 50–100 Hz, 텔레메트리 100 Hz × ≈40 B | ≈32 kbit/s @460800 | USB CDC 대신 하드웨어 UART(결정성). DIABLO와 동일 |
| IMU SPI | 1 kHz | — | I2C 금지(지터). 차축 높이 근처, 진동 절연 마운트 |

IMU 선택: ICM-42688-P(자이로 2.8 mdps/√Hz, 1 kHz 루프에 최적) 또는 BMI088(DIABLO와 동일, 진동 강건; 230 Hz BW 설정 권장). BNO085 같은 퓨전 IMU는 회전벡터 400 Hz·지연 미문서라 균형 루프용으로는 비권장(원시 자이로+가속도에 자체 필터).

PC는 균형 루프에 **절대 끼어들지 않는다.** PC가 죽으면 Teensy는 v=0으로 제자리 균형을 유지하고, 2 s 후에도 명령이 없으면 모터를 끈다(낙상보다 안전한 쪽을 선택해 조정). RC 킬 스위치는 Teensy에 직결.

### 3.4 ROS 2 인터페이스

| 토픽 | 방향 | 메시지 | 주기 | QoS |
|---|---|---|---|---|
| `/cmd_vel` | PC→MCU | `geometry_msgs/Twist` (linear.x m/s, angular.z rad/s) | 50–100 Hz | best-effort, depth 1 |
| `/balance/state` | MCU→PC | 커스텀: θ, θ̇, ẋ, ψ̇, τ_L, τ_R, 모드, 배터리 | 100 Hz | best-effort |
| `/imu/data` | MCU→PC | `sensor_msgs/Imu` | 100–200 Hz | best-effort |
| `/joint_states` | MCU→PC | `sensor_msgs/JointState` (휠 각도·속도) → `/odom` | 100 Hz | best-effort |
| `/balance/mode` (서비스) | PC→MCU | arm / disarm / e-stop | 요청 시 | reliable |

링크 구현 두 가지:

| | micro-ROS (Teensy 4.1 공식 지원) | 커스텀 바이너리 프로토콜 (DIABLO 방식) |
|---|---|---|
| 장점 | 토픽이 그대로 보임, 브리지 코드 없음 | 가볍고 결정적, 프레임·CRC·타임아웃 직접 통제, ROS 없이도 테스트 가능 |
| 단점 | Teensy 메모리·CPU 사용, 세션 끊김 처리 번거로움 | PC 쪽 C++ 브리지 노드 작성 필요 |
| 권고 | 균형 루프를 **하드웨어 타이머 ISR**에 두고 micro-ROS spin은 메인 루프에서 돌리면 안전. 빠른 시작용 | 최종 제품·안전 요구가 명확하면 이쪽. 펌웨어 스켈레톤은 이 방식의 훅(`hostPoll/hostTelemetry`)을 둠 |

어느 쪽이든 **IMU·모터는 PC를 거치지 않는다**는 원칙이 핵심이며, 1번 프로젝트의 Python 직렬 노드는 재사용하지 않는다.

---

## 4. 제어기 선택 — 조사·계산·판단

### 4.1 모델

상태 x = [x_w, ẋ_w, θ, θ̇], 입력 τ = τ_L + τ_R (직접구동이라 모터 토크 = 바퀴 토크).

```
a11 ẍ + a12 θ̈ − M_b l sinθ θ̇² + b ẋ = τ / r
a21 ẍ + a22 θ̈ − M_b g l sinθ        = −τ
a11 = M_b + 2m_w + 2I_w/r²,  a12 = a21 = M_b l cosθ,  a22 = I_b + M_b l²
```
선형화(θ≈0)하면 Ẋ = AX + Bτ. 계획 로봇의 열린 루프 극: +6.88, −6.9, 0, −0.05 rad/s → **불안정 시정수 145 ms**. 제어기는 이보다 3–5배 빠른 교차주파수(20–35 rad/s)가 필요하고, 그 교차주파수에서의 위상여유가 허용 지연을 결정한다. 요(ψ) 축은 분리되어 I_z ψ̈ = (τ_R − τ_L)·d/(2r).

### 4.2 후보 비교

| 기준 | 캐스케이드 PID (각도 PD + 속도 PI) | **LQR / LQI** | 선형 MPC |
|---|---|---|---|
| 안정성·게인 결정 | 손 튜닝. 바깥 루프 부호가 직관과 반대(앞으로 갈수록 더 앞으로 토크)라 1번처럼 `Kp=-0.002` 식의 실수가 잦음 | 모델에서 Riccati로 한 번에. 모든 상태를 동시에 고려, 위상여유 ≥ 60° 보장(단일 입력) | 모델 + 제약 + QP. 가장 많은 설계 변수 |
| 수식 관계 | u = kp_th(θ−θ_ref) + kd_th θ̇, θ_ref = −(kp_v ev + ki_v ∫ev) ⇒ **u = −K x 꼴의 상태 피드백**. LQR 게인 공간의 한 점 | — | 제약이 활성화되지 않으면 LQR과 동일한 해 |
| 지연·주기 민감도 | 같은 게인이면 LQR과 동일 | 1 kHz–100 Hz 게인 차이 10 % (표 4.3) | 100 Hz 이하로 돌면 그 자체가 지연 |
| 제약 처리 | 클리핑 | 클리핑 + 레퍼런스 클리핑/램프 | 명시적(토크, 속도, 틸트, 토크-속도 포락선) |
| Teensy 4.1 연산량 | 수 µs | **수 µs** (5개 곱셈) | 2–8 ms/solve (TinyMPC 기준, 4.3) |
| 확장성(휠-레그) | 루프 추가마다 재튜닝 | 상태 추가·게인 스케줄링(DIABLO 8상태) | 점프·높이 제약에 유리 |
| 실제 사용 | 취미 로봇 대다수 | **DIABLO, Ascento, Segway 계열** | Rezero(70 Hz, PC), 연구 |

### 4.3 계산 결과 (`sim/analysis_controllers.py`, `sim/mpc_compare.py`)

**LQR 설계 (계획 로봇).** Q = diag(1/1², 1/1², 1/0.2², 1/2²) (위치 1 m, 속도 1 m/s, 틸트 0.2 rad, 각속도 2 rad/s 허용), R = 1/(0.5·τ_max)².

| 항목 | 값 |
|---|---|
| 연속 LQR K = [k_x, k_ẋ, k_θ, k_θ̇] | [−4.0, −7.27, −36.0, −5.87] (u = −Kx) |
| 닫힌 루프 극 | −18.8, −9.45, −0.98 ± 0.47j rad/s |
| 플랜트 입력 기준 마진 | 위상여유 72°, 교차 29.6 rad/s, 이득여유 −12.9 dB(조건 안정), **지연여유 43 ms** (`figures/bode_lqr_baseline.png`) |
| 이산 LQR 게인 100 / 200 / 500 / 1000 Hz | k_θ = −32.0 / −33.9 / −35.2 / −35.6 (1 kHz 대비 100 Hz에서 10 % 감소) |
| 등가 캐스케이드 PID | 내부 Kp_θ = 36.0 Nm/rad, Kd_θ = 5.87 Nm·s/rad; 외부 Kp_v = 0.20 rad/(m/s), Ki_v = 0.12 rad/m |

**시간 응답** (IMU 노이즈 포함, `figures/time_response_comparison.png`, `results/time_response_metrics.json`)

| 경우 | 12° 복귀 피크 토크/휠 | 정착(1°) | 40 N 푸시 피크 토크/휠 | 정착 |
|---|---|---|---|---|
| LQR 1 kHz, 1 ms | 3.84 Nm | 1.05 s | 1.36 Nm | 1.98 s |
| LQR 500 Hz, 3 ms | 3.80 | 1.02 | 1.35 | 1.97 |
| LQR 100 Hz, 15 ms | 3.54 | 1.05 | 1.55 | 2.01 |
| LQR 100 Hz, 40 ms (PC+Python 경로) | 4.64 | **3.11** | 3.81 | **3.66** |
| 캐스케이드 PID(등가 게인) 1 kHz | 3.79 | 1.06 | 1.35 | 1.96 |
| 캐스케이드 PID, 바퀴 피드백 없음(1번 구조) | 3.86 | 0.45* | 0.87 | — |

\* 각도는 빨리 잡히지만 속도가 0.3–0.5 m/s로 드리프트한 채 복귀하지 않음(실제로는 속도 한계까지 가속 → 전도).

→ **같은 게인이면 PID와 LQR은 구별되지 않는다.** 차이는 "그 게인을 어떻게 얻고, 어떤 상태를 되먹이느냐"뿐이다.

**LQI 속도 추종** (`figures/lqi_velocity_step.png`): 1 m/s 계단 레퍼런스를 그대로 주면 13.7° 기울고 3.7 Nm/휠이 필요하지만, 레퍼런스를 1 m/s²로 램프하면 5.6°, 0.34 Nm로 줄어든다(아래 MPC 표). **펌웨어에 레퍼런스 램프를 반드시 넣는다.**

**MPC vs LQR** (토크 5 Nm/휠, 모터 무부하 2.1 m/s의 토크-속도 포락선 포함, 100 Hz, N = 30, OSQP; `figures/mpc_vs_lqr_*.png`, `results/mpc_vs_lqr.json`)

| 지표 | LQR + 클리핑 | MPC(소프트 |v| ≤ 1.5, 포락선 제약) |
|---|---|---|
| 회복 가능 최대 초기 틸트 | **40°** | **40°** |
| 견디는 최대 푸시(0.1 s) | **100 N** | **100 N** |
| 1.0 m/s 스텝: 피크 틸트 / 토크·휠 | 7.1° / 1.15 Nm (레퍼런스 클리핑+램프: **5.6° / 0.34**) | 7.1° / 1.14 |
| 1.5 m/s 스텝 | 10.7° / 1.67 (클리핑+램프: 7.0° / 0.41) | 10.6° / 1.65 |
| 2.0 m/s 스텝(무부하 속도의 95 %) | 14.3° / 2.22, 피크 속도 2.11 m/s (클리핑+램프: 7.0° / 0.41, 1.40 m/s) | 10.6° / 1.65, 1.69 m/s |
| 한 번 풀이 비용(이 PC, 4코어) | — | 평균 0.51 ms, p95 0.74 ms, 최대 3.8 ms, 평균 48회 반복(185변수·401제약) |
| **Teensy 4.1 추정** (TinyMPC ICRA 2024 포스터: N = 30에서 152 µs/반복(12상태), 4상태 15 µs/반복) | — | **2.2–7.4 ms/solve** → 100–200 Hz 가능, 1 kHz 불가 |

출처: https://a2r-lab.org/files/TinyMPC_ICRA_Poster.pdf, https://tinympc.org/, https://arxiv.org/abs/2310.16985

→ 평범한 2륜 균형(다리 없음)에서는 **회복 한계가 물리(토크·속도)로 정해지고 MPC가 그 한계를 넓히지 못한다.** 속도 제한도 LQR에 레퍼런스 클리핑·램프를 붙이는 것으로 MPC와 동급 이상이다. MPC가 값어치를 하는 곳은 (1) 휠-레그에서 높이·점프·접촉 제약, (2) 토크-속도 포락선을 **명시적으로** 지켜야 하는 고속 주행, (3) PC에서 100 Hz로 레퍼런스(ẋ_ref, θ_ref)를 생성하고 MCU LQR이 1 kHz로 추종하는 계층 구조다.

### 4.4 판단

**Teensy 4.1에서 1 kHz(최소 500 Hz) LQI, 토크 모드.** 요 축은 자이로 요레이트 PD. 다리를 달면 DIABLO처럼 상태를 늘리고(γ, 높이) 높이는 PD+FF, 게인은 높이별 스케줄링. MPC는 2단계에서 PC(100 Hz) 레퍼런스 생성기 또는 TinyMPC로 실험.

근거 요약: (1) 수식상 PID 캐스케이드 ⊂ 상태 피드백이므로 PID를 고를 이유가 "익숙함"뿐이고, 1번 프로젝트의 실패(부호·피드백 누락)는 정확히 손 튜닝의 함정이었다. (2) LQR은 5개 곱셈이라 MCU 1 kHz에 비용이 없고, 지연여유 43 ms 설계가 MCU+CAN 경로(1–2 ms)에서 20배 여유를 갖는다. (3) MPC는 측정 가능한 이득이 없고 Teensy에서 100 Hz가 한계다. (4) DIABLO(상용)와 Ascento(학술) 모두 LQR이다.

### 4.5 구현 사양 (펌웨어 `firmware/teensy_balance/teensy_balance.ino`)

| 블록 | 사양 |
|---|---|
| 타이밍 | `IntervalTimer` 1 kHz ISR이 플래그만 세우고 메인 루프에서 IMU 읽기→추정→LQI→CAN 송신. CAN 수신·UART 파싱은 비차단 |
| 추정기 | 상보필터 θ = α(θ + g_y Δt) + (1−α)·atan2(a_x, a_z), α = τ/(τ+Δt), τ = 0.5 s. θ̇는 자이로 직접 사용(수치미분 금지). 바퀴 속도는 드라이버 엔코더 피드백 평균 × r. 2단계: 자이로 바이어스 포함 칼만 |
| 제어 법칙 | u = −(K_V(ẋ−v_ref) + K_TH θ + K_THD θ̇ + K_I z), z = ∫(ẋ−v_ref)dt, |z| ≤ 1 m(안티와인드업). τ_L = u/2 − τ_yaw/2, τ_R = u/2 + τ_yaw/2, τ_yaw = Kp_yaw(ψ̇_ref − ψ̇) |
| 레퍼런스 | v_ref 램프 1 m/s², |v_ref| ≤ 0.7×무부하 속도 |
| 안전 | |θ| > 34° → FAULT(토크 0); 명령 0.5 s 없음 → v_ref = 0; 2 s → OFF; 드라이버 피드백 50 ms 없음 → FAULT; 토크 리밋 τ_max; 암(arm)은 |θ| < 3°일 때만 |
| 모터 어댑터 | Iq = τ/Kt를 CAN으로. MyActuator RMD-L(0xA1 토크 지령, 응답이 피드백), moteus(위치 모드 Kp=Kd=0 + feedforward torque), ODrive(`Set_Input_Torque` 0x00E + 워치독) 중 택일 |

**게인 표 (이산 LQI, u = −(K_V·ev + K_TH·θ + K_THD·θ̇ + K_I·z))** — `python3 sim/gen_gains.py --M_b ... --l ...` 로 재생성

| 로봇 | 주기 | K_V [Nm/(m/s)] | K_TH [Nm/rad] | K_THD [Nm·s/rad] | K_I [Nm/m] |
|---|---|---|---|---|---|
| **소형 5 kg급, RMD-L-9015 (τ_max 5)** | 1 kHz | −4.424 | −18.698 | −2.762 | −2.446 (PM 77°, 지연여유 31 ms) |
| 소형 5 kg급, RMD-L-7015 (τ_max 3.8) | 1 kHz | −3.304 | −14.773 | −2.178 | −1.860 |
| **대형 10 kg급, RMD-L-9015 (τ_max 5)** | 1 kHz | −4.487 | −24.854 | −3.947 | −2.465 |
| 대형 10 kg급(τ_max 8) | 1 kHz | −7.164 | −35.588 | −5.800 | −3.940 |
| 대형 10 kg급(τ_max 8) | 500 Hz | −7.059 | −35.166 | −5.731 | −3.881 |
| 1번 유사(4 kg, τ_max 2) | 1 kHz | −1.769 | −9.701 | −1.327 | −0.985 |
| 무거운(12 kg, τ_max 15) | 1 kHz | −13.538 | −72.845 | −13.805 | −7.402 |

부호 규약: θ > 0 = 앞으로 기욺, ẋ > 0 = 전진, τ > 0 = 바퀴를 앞으로 미는 모터 토크. 게인이 모두 음수이고 u = −Kx이므로 **앞으로 기울면 앞으로 밀고, 앞으로 가고 있으면 더 앞으로 민다**(양의 바퀴속도 피드백). 이 부호가 손 튜닝에서 가장 자주 틀리는 부분이다.

### 4.6 튜닝·검증 절차

1. **파라미터 측정**: 총질량, 휠 질량, r, 무게중심 높이 l(축에서 매달아 평형점), I_b(양방향 진자 주기법), 모터 Kt(매달고 전류 vs 토크). → `gen_gains.py`에 입력.
2. **드라이버 단독**: 토크 모드에서 전류 명령 → 토크 부호·스케일 확인, 엔코더 속도 부호 확인, CAN 1 kHz 왕복 확인(Teensy에서 피드백 타임스탬프 통계).
3. **IMU 단독**: 축 정렬, 정지 노이즈(θ̇ 0.1 °/s급), 상보필터 시정수.
4. **매달기 테스트**: 바퀴가 공중에 뜬 상태에서 몸체를 기울이면 바퀴가 "넘어지는 쪽"으로 가속하는지(부호 검증), 지면 없이 토크 리밋 확인.
5. **저게인 착지**: 게인을 0.5배로 시작해 서 있으면 1.0배. 진동(≈ 교차주파수 5 Hz 근처)이 보이면 지연/필터 지연 확인(위상여유 소비).
6. **푸시·경사·속도 스텝** 로그를 rosbag으로 남기고 시뮬레이션과 비교해 모델 파라미터 보정.

흔한 실패 체크리스트: IMU 축/부호, rev/s vs rad/s, Kt의 RMS/peak 규약, 엔코더 방향, 좌우 모터 회전 방향 반전, CAN 종단 저항, 속도 모드로 잘못 설정된 드라이버, 적분 와인드업, 레퍼런스 램프 누락, 100 Hz 로그 출력으로 인한 지터.

---

## 5. 다음 단계

1. 모터 확정 전 MyActuator 공식 데이터시트로 RMD-L-9015/9025의 피크 토크(리셀러 간 4.58 vs 5.8 Nm 불일치)·CAN 토크 지령(0xA1) 스케일·통신 주기 확인. 대안으로 ODrive S1 + 외부 엔코더 경로를 동시에 준비(펌웨어 어댑터만 다름).
2. 실측 파라미터로 `gen_gains.py` → `twip_model.py` 파라미터 세트 교체 → `analysis_controllers.py` 재실행해 지연 맵·토크 피크 재확인.
3. 펌웨어 스켈레톤에 IMU 드라이버·CAN 어댑터·UART 프레임 채우기 → 매달기 테스트 → 착지.
4. ROS 2 측 `mcu_bridge` 노드(C++) 또는 micro-ROS 구성, `/cmd_vel` 램프는 MCU에서 처리.
5. 다리(휠-레그)로 확장 시 DIABLO의 8상태 LQR + 높이 PD+FF로 모델 확장, 그 단계에서 MPC 실험.

## 6. 가정과 한계

- 모델 파라미터(질량·l·I_b·마찰)는 가정값. 모터 전기 시정수, 코깅, 타이어 컴플라이언스, 백래시는 미포함(직접구동이라 백래시는 없음).
- 1번 프로젝트의 지연값은 문헌 수치의 합산 추정이며 실측이 아니다. Notion 페이지의 후속 버전(1 kHz Python 타이머로 ODrive 토크 모드)은 USB 왕복 비용상 1 kHz로 돌 수 없다는 점만 추론으로 덧붙인다.
- 제품 가격·스펙은 2026-10-20 판매 페이지 기준. DDT/DIABLO 제품은 구매 불가 조건이라 후보에서 제외했고, 5 kg급 파라미터 세트(3.2 kg 몸체, 65 mm 휠)는 가정값이다.

## 7. 주요 출처

- 1번 프로젝트: https://github.com/Ryung-coding/ICT2024_surveillance_balancing_robot
- DIABLO 논문: https://arxiv.org/abs/2407.21500 ; SDK: https://github.com/DDTRobot/diablo_ros2 ; 문서: https://diablo-sdk-docs.readthedocs.io ; 모터 예제: https://github.com/DDTRobot/motor-driver-examples
- ROS 2 지연: https://arxiv.org/abs/2101.02074 ; https://docs.ros.org/en/dashing/Tutorials/Real-Time-Programming.html ; https://design.ros2.org/articles/realtime_background.html ; https://control.ros.org/rolling/doc/ros2_control/controller_manager/doc/userdoc.html ; https://www.barkhauseninstitut.org/research/lab-1/our-blog/posts/soft-realtime-performance-of-rclpy
- USB/ODrive 지연: https://granitedevices.com/wiki/FTDI_Linux_USB_latency ; https://discourse.odriverobotics.com/t/decreasing-latency/1463 ; https://docs.odriverobotics.com/v/latest/guides/can-guide.html ; https://discourse.odriverobotics.com/t/torque-setpoint-update-rate-through-can-odrive-micro/13101
- 균형 로봇 사례: Ascento https://arxiv.org/pdf/2005.11431 ; Ollie https://www.frontiersin.org/journals/neurorobotics/articles/10.3389/fnbot.2022.1102259/full ; Rezero https://arxiv.org/pdf/1902.10415 ; Segway US6796396B2
- 모터/드라이버: https://www.robotshop.com/products/myactuator-rmd-l-9015-35t-bldc-can-bus-servo ; https://openelab.com/products/myactuator-rmd-l-7015-can ; https://www.roboticscenter.ai/pt/store/product/lkmtech-mf9025-v2-motor ; https://openelab.io/blogs/learn/xiaomi-cybergear-micromotor-guide ; https://www.cubemars.com ; https://www.waveshare.com/wiki/DDSM115 ; https://shop.odriverobotics.com ; https://mjbots.com ; https://blog.mjbots.com/2024/05/16/optimizing-moteus-command-rate/ ; https://store.tmotor.com
- Teensy/IMU: https://www.pjrc.com/store/teensy41.html ; https://github.com/tonton81/FlexCAN_T4 ; https://invensense.tdk.com/products/icm-42688-p/ ; https://www.bosch-sensortec.com/en/products/motion-sensors/imus/bmi088/
- MPC on MCU: https://tinympc.org/ ; https://a2r-lab.org/files/TinyMPC_ICRA_Poster.pdf ; https://arxiv.org/abs/2310.16985
