wisehyun-2/my_robot_project/wheeled_biped/docs/balancing_robot_design/제어기_비교보고서.md

# 오픈소스 휠-레그 균형 제어기 전수 조사 및 SIL 비교 보고서

> **2026-11-14:** 이 문서는 `balancing_robot_design/` 폴더에 있었다. 그 폴더는 지웠고 보고서 두 편과 `figures/`만 여기로 옮겼다. 본문에 나오는 `sim/`, `sim6/`, `sil/`, `firmware/`, `results/`의 파일은 git 태그 `before-cleanup-2026-11-14`의 `balancing_robot_design/`에 있다.

작성일 2026-10-20. 대상: 고관절 모터 2개(다리당 1개) + 바퀴 2개, Ascento형 4-모터 로봇. 모든 수치는 `sil/` 하네스로 재현 가능하다(`python3 sil/sil_harness.py --robot small|large`).

---

## 0. 요약

- GitHub 전수 조사에서 실제 균형 제어 코드가 있는 휠-레그 저장소 45개를 분류했고, **고관절 2 + 바퀴 2(Ascento형)이면서 제어 법칙을 소스에서 확인한 것은 9개**(fern, LZU_ASCENTO, zephyr_ascento, Pow_WBR, MuShibo, WL1, Venus-1, SonicRobot, Ryung). Ascento 원본·SK8O·DIABLO·TITA는 균형 코드 비공개.
- 9개 전부의 균형 제어 함수를 **C로 그대로 이식해 컴파일**하고, 내 제어기(1 kHz LQI, C 안에서 리카티를 풀어 다리 길이별 게인 자동 설계)와 같은 비선형 시뮬레이터·같은 외란·같은 노이즈·같은 다리 변화에서 5 kg급·10 kg급 두 로봇으로 비교했다.
- **결과**: LQR 계열 5개(내 LQI, fern, LZU, zephyr, Pow)만 두 로봇 모두에서 균형·다리 변화를 통과했다. 손튜닝 캐스케이드 PID(WL1, Venus-1)는 어떤 출력 스케일에서도 균형 불가, MuShibo는 한계 진동, 속도 모드+바퀴 피드백 없음(SonicRobot, Ryung)은 푸시 뒤 굴러간다. 내 LQI는 속도 스텝(정상상태 오차 0, 변위 0), 10° 복귀 0.8–1.0 s, 다리 1.4배 변화 0.1° 흔들림으로 동급 이상이며, fern 구조에 내 가중치를 넣으면 같은 성능이 나온다(차이는 구조가 아니라 가중치).
- **upkie(6모터)**도 같은 절차로 테스트했다(§6). 실제 로봇용 WheelBalancer, 실제 Python MPC 코드(qpmpc+ProxQP)까지 루프에 넣었다. 전부 moteus 속도 모드에 기대는 구조라 드라이버 루프가 무르면 넘어지고, 우리 로봇에서는 푸시 10–40 N(내 LQI 60–120 N)에 그친다. MPC는 가장 조용하지만 느리다. 균형 법칙보다 소프트웨어 구조(스파인/에이전트 분리, 관측기, 시뮬 환경)를 참고할 가치가 있다. 6-모터 3체 플랜트(upkie 추정 모델, §8.4.1)에서도 같은 그림이다: WheelBalancer는 넘어지지 않는 푸시 한계 37 N에 정착 7 s(위치 적분이 천천히 되돌린다), MPC 42 N·정착 2–5 s, 내 LQI6 106 N 이상·정착 1.4–4 s.
- **6-모터(5절 링크) 프로젝트 9개**(§8)도 같은 절차로 테스트했다. 전부 HEU 3체 모델의 LQR 하나(상태 6, 출력 2)이고, 그 모델로 비선형 플랜트를 만들어 USTB의 공개 게인과 5–10 % 안에서 맞춤을 확인한 뒤 5개 플랜트(RM급 7 kg·15 kg Webots 모델·Skythinker 0.6 kg·우리 5 kg급·10 kg급)에서 비교했다. 공개 게인은 자기 로봇 질량 근방에서만 그대로 통하고 지연 허용이 3–8 ms(USTB 3 ms)로 Teensy+CAN 구조에는 여유가 없다. 내 LQI6(온라인 리카티, R을 토크 한계에 비례)는 모든 플랜트에서 조정 없이 균형·40° 복귀·1.0–1.2 W 푸시, 지연 26 ms, 정지 토크 노이즈 최저였다. 가져올 것은 USTB의 VMC·파라미터 문서, Skythinker의 다항식 스케줄링, ATWheelLeg의 공중 게인, LJW의 점프 상태기계이지 게인 값이 아니다.
- **A10 Kollarčík(CTU 2021 석사논문, GitLab)**을 뒤에 추가했다(§5.3 (4)). Ascento형 4-모터 + Teensy 1 kHz로 우리 구조와 가장 가깝고, R을 비싸게 둔 dLQR이라 푸시(115–160 N)와 지연 허용(40–60 ms)이 전체 1위이지만 속도 루프가 물러 푸시 뒤 0.3–0.4 m를 굴러가고 논문대로면 속도 기준을 거의 추종하지 못한다.
- **결론**: 제어기는 내 LQI를 쓰고, 참고 프로젝트에서는 속도 필터(LZU/zephyr), 중력 피드포워드·균형점 트림(fern/MuShibo), 워치독·바퀴 이탈 감지(fern/MuShibo)만 가져온다. 상세는 §5.4.

---

## 1. 조사 방법과 범위

GitHub 전체를 두 갈래로 조사했다(영문·ROS·시뮬 커뮤니티 / 중국어·RoboMaster·MCU 커뮤니티). GitHub API가 차단되어 웹 검색 + 저장소 페이지 + `raw.githubusercontent.com`으로 소스를 직접 열어 **제어 법칙을 눈으로 확인한 것만 VERIFIED**로 표시했다. 1차 후보 약 60개 중 실제 균형 제어 코드가 있는 저장소 45개를 분류했고, 그중 **4-모터(다리당 관절 1개) + 균형 코드 VERIFIED**는 9개였다.

### 1.1 4-모터(Ascento형) 검증 후보 — 전부 이식·테스트 대상

| # | 저장소 | ★ | 플랫폼 | 모터 구성 | 제어기 | 균형 코드 파일 | 모델/게인 문서 | 라이선스 |
|---|---|---|---|---|---|---|---|---|
| A1 | [fernandomierhicks/wheeled-leg-robot](https://github.com/fernandomierhicks/wheeled-leg-robot) | 6 | Teensy C++ 500 Hz + MuJoCo | 2 ODrive 휠 + 2 CubeMars AK45-10 고관절(토크), 4절 링크 | 3상태 LQR, 다리 높이별 게인 테이블, 속도 PI→기울기 목표, 중력 FF | `firmware/robot_teensy/teensy/src/control_loop.cpp` | Q=diag(0.01, 0.188, 0.0051), R=100, `lqr.py` | 없음 |
| A2 | [hpzhaozhao/LZU_ASCENTO](https://github.com/hpzhaozhao/LZU_ASCENTO) | 3 | STM32H723 C 1 kHz | 2 DM-H6215 허브 + 2 Stackforce 관절(MIT 토크), Ascento 4절 | 4상태 LQR(바퀴별), 게인 = 다리 길이 3차 다항식 | `lzu_ascento/Core/Src/task/chassis_task.c` | `LQR_k_calc.m`, 논문 PDF | 없음 |
| A3 | [123zhengzz/zephyr_ascento_f407_wheel_leg](https://github.com/123zhengzz/zephyr_ascento_f407_wheel_leg) | 1 | STM32F407 Zephyr C ≈1 kHz | 2 M3508(VESC 전류) + 2 DM4340, 4절 | 4상태 LQR, 게인 = 다리 길이 2차 다항식, 정지마찰 보상 | `src/app/control/ascento_balance.c` | 물리 파라미터·게인 문서(`docs/*.md`), `recompute_lqr_gains.m` | 없음 |
| A4 | [SeungbinOh/Pow_WBR_Project](https://github.com/SeungbinOh/Pow_WBR_Project) | 79 | ESP32 Arduino+Eigen 125 Hz | 2 RS485 토크 모터(LK/MG 0xA1) + 2 고관절 서보 | 4상태 LQR u=K(h)(x_d−x), 높이 10 mm 간격 K 테이블 14개 | `ESP32/WBR_Control/VYBController.h` | K 테이블 하드코딩, MATLAB 폴더 | 없음 |
| A5 | [MuShibo/Micro-Wheeled_leg-Robot](https://github.com/MuShibo/Micro-Wheeled_leg-Robot) (+ STM32 포팅 [luoyx257](https://github.com/luoyx257/Micro_Wheeled_Leg_Robot_STM32), ESP-IDF 포팅 [xixiha5230/wl_bot](https://github.com/xixiha5230/wl_bot)) | 3.7k | ESP32 SimpleFOC ≈1 kHz | 2 BLDC 휠(전압 토크) + 2 STS3032 서보(다리당 1), 4절 | 4항 P 피드백("LQR", 손튜닝) + 소토크 PI + 균형점 자동 적응 + 높이별 속도 게인 | `3.Software/wl_pro_robot/wl_pro_robot.ino` `lqr_balance_loop()` | 모델·K 스크립트 없음 | LICENSE 없음 / MIT(포팅) |
| A6 | [track-tech/Venus-1](https://github.com/track-tech/Venus-1__Four-link-wheel-legged-robot) | 69 | STM32H723 C 1 kHz | 2 M2006(C610 전류) + 2 CyberGear(위치), 4절 | 캐스케이드 PID: 바퀴 rpm PI(0.6, 0.003)→피치 목표, 피치 PD(1800, 18000)→전류 | `.../Application/TaskLayer/chassis_task.c`, 게인 `Device_dev.c` | 없음 | GPL-3.0 |
| A7 | [XRobots/SonicRobot](https://github.com/XRobots/SonicRobot) (James Bruton) | 31 | Teensy 3.6 100 Hz, ODrive | 2 ODrive 휠(**속도 모드**) + 2 ODrive 볼스크류 무릎 | PID_v1(7500, 75000, 180) 피치→바퀴 속도, 바퀴 피드백 없음 | `ARobot08/ARobot08.ino` | 없음 | GPL-2.0 |
| A8 | [Ryung-coding/ICT2024](https://github.com/Ryung-coding/ICT2024_surveillance_balancing_robot) (1번 레퍼런스) | 1 | ROS 2 C++ 100 Hz PC, ODrive | 2 ODrive 휠(**속도 모드**) + 다리 올림/내림 | 3중 PID(내부 루프 "Not working"), 바퀴 피드백 없음, 한쪽 바퀴만 발행 | `src/controller/src/controller_main.cpp` | README 모델 | 없음 |
| A9 | [Kollarčík, CTU 2021 석사논문 "Modeling and Control of Two-Legged Wheeled Robot"](https://gitlab.fel.cvut.cz/kollaada/master-thesis-by-adam-kollarcik) (FEL ČVUT GitLab) | — | Teensy 4.0 1 kHz(CAN) + ODROID N2+(UART); 설계는 MATLAB/Simulink, 3D 검증은 Gazebo 코시뮬 | 4 eX8108 105KV + 1:16.5 감속(±2 Nm, 실물은 0.5 Nm부터 바퀴 미끄러짐), Ascento형 폐쇄 사슬, 무릎 비틀림 스프링, 약 4.6 kg | 3D 역진자 dLQR(1 ms) + 속도·요율 적분, 고관절 PD 위치(루프 밖), 다리 길이 무관 고정 K; UKF 관측기·점프 궤적 최적화 | `Matlab/3Dpendulum/model.m`(Q·R·dlqr), `Matlab/PlanarModel/stoupentoController.m`, Gazebo SDF; **펌웨어 비공개**(논문 본문에 게인·모델 기재) | 없음 |

6모터이지만 사용자 요청으로 같은 절차를 적용한 upkie(U1–U4)는 §6에 정리했다.

제외(4-모터이나 코드 미완성/미검증): KudoC0nan/Balance_On_Wheels(단일 PID, 부호 버그), VitRuzicka/dynbalabot(출력 주석 처리), MateoCabreraVasquez/RobotAscentoReplica(다리 코드 없음), sdevil/ai-wheeled-legged-robot(제어 수식 비공개). Ascento 원본·SK8O(CTU)·DIABLO·TITA는 균형 코드가 공개돼 있지 않다.

### 1.2 참고용 6-모터(다리당 관절 2개) VERIFIED 목록 — §8에서 전부 이식·테스트

바퀴 균형 법칙은 4-모터와 동일한 LQR 계열(HEU 3체 모델)이며 다리 2자유도를 VMC(가상 모델 제어)로 다루는 점만 다르다. 다리 구조는 5절 링크(폐쇄 사슬)와 직렬 2관절(고관절+무릎) 두 가지가 섞여 있는데, 가상 다리로 환원하면 같은 모델이라 함께 다뤘다. 번호(B#)는 §8의 결과 표와 같다. upkie(U#)는 §6.

| # | 저장소 | 플랫폼 | 다리 · 모터 | 제어기 | 게인·모델 파일 | 라이선스 |
|---|---|---|---|---|---|---|
| B2 | [Skythinker616/foc-wheel-legged-robot](https://github.com/Skythinker616/foc-wheel-legged-robot) (1.8k★) | ESP32 ×2(메인 + SimpleFOC) | 5절, 2804/4010 짐벌 BLDC ×6, 0.6 kg 탁상형 | 6상태 dLQR(5 ms) + VMC, K(L0) 3차 다항식 | `matlab/sys_calc.m`, `matlab/lqr_k.m`, Simscape `sys_sim.slx`, SolidWorks | GPL-3.0 |
| B8 | [lyz1202dt/ATWheelLeg](https://github.com/lyz1202dt/ATWheelLeg) | STM32(DM4310) + ROS 2/MuJoCo(ros2_control) | 5절 | 6상태 LQR 500 Hz, 17점 게인 표 보간 + VMC | `Core/`, `MujocoSim/scr/controller/config/sim_controller.yaml` | 없음 |
| B9 | [LJW0401/Wheel_Leg_Balance_Vehicle](https://github.com/LJW0401/Wheel_Leg_Balance_Vehicle) | STM32, CyberGear 관절 | 5절 | MATLAB K(L0) 3차; 펌웨어는 바퀴 LQR 1행 ×0.4 + 관절 위치 모드 | `stm32_code/application/Balance_Controler.c`, `matlab/` | MIT |
| B10 | [1772631792/WheelLeg_LQR](https://github.com/1772631792/WheelLeg_LQR) | Python 상위 앱 + C 제어기 + MuJoCo | 5절/직렬 선택, 실물 없음(MuJoCo 전용, 1+5 kg 가정) | 4상태 카트-폴 dLQR(C 리카티) + 다리 길이 PID/VMC | `controller/lqr_design.c`, `controller/chassis.c`, `config/robot_params.py` | 없음 |
| U1·U3 | [upkie/upkie](https://github.com/upkie/upkie) (직렬 2관절, §6) | U1 `WheelBalancer.cpp`(스파인 1 kHz, 지면 속도 PI → 바퀴 속도 명령), U3 `mpc_balancer.py`(qpmpc+ProxQP 200 Hz, 실제 Python 코드를 루프에 로드) | 토크는 upkie의 **자체 서보 모델**(`BulletInterface.cpp`: τ = kp·(q*−q) + kd·(v*−v), kp 20 Nm/rad·kd 1.0 Nm/(rad/s), kp_scale 1)로 만든다 — 바퀴는 속도 모드(kd 1.0, 무른 변형 0.2), 고관절·무릎은 위치 모드로 다리를 몸체 좌표계에 고정(Tp = −2·(20 r + 1.0 ṙ), r = θ+φ). 서보 루프는 **드라이버 쪽**(명령 지연 뒤, 현재 상태로 1 kHz) — 제어기 안에서 닫으면(지연 2 ms 뒤) 가벼운 upkie 플랜트에서 바퀴 루프가 60 Hz 리밋사이클(정지 토크 2.3 Nm RMS)을 일으켰다. 부호는 규약이 알려져 있어(피치 = −φ, 다리 고정 루프 고정) 바퀴 극성만 탐색. 다리 서보 강성을 20→200 Nm/rad로 바꿔도 푸시·틸트 한계는 그대로(결과는 바퀴 법칙이 결정). |
| — | [chen-jiangnan/RMInfantry_wheelLegged_ws](https://github.com/chen-jiangnan/RMInfantry_wheelLegged_ws) | ROS 2 + MuJoCo | cyclBot 5절 + seriBot 직렬 | 6상태 LQR, K(L) 다항식 | `src/wheel_legged_launch/config/cyclBot/chassis_control_config.yaml` | 없음 |
| U1–U4 | [upkie/upkie](https://github.com/upkie/upkie) (448★) | Raspberry Pi + mjbots, PyBullet | 직렬 2관절(고관절+무릎) | WheelBalancer PI, PD, MPC(qpmpc), 토크 P | `upkie/cpp/controllers/WheelBalancer.cpp`, `upkie/controllers/mpc_balancer.py` | Apache-2.0 |

조사 당시 공개였던 JerryGong0911/RM2024_Reborn(USTB, B1)과 Multivac11/Wheel-legged-robot(B5)은 2026-10-20 현재 GitHub에서 접근할 수 없어(404) 목록에서 뺐다. §8의 B1·B5 결과는 당시 받아 둔 소스로 얻은 것이고, 플랜트 검증(§8.2)이 USTB의 공개 파라미터를 쓰므로 결과 행은 남겨 둔다.

---

## 2. 테스트 방법 — SIL(software-in-the-loop) 하네스

각 프로젝트의 **균형 제어 함수를 C로 그대로 옮겨 gcc로 컴파일**(.so)하고, Python 비선형 2륜 역진자 모델(`sim/twip_model.py`)에 ctypes로 연결했다. 제어기 소스의 게인·루프 주기·필터·제한값·구조를 바꾸지 않았고, 다른 로봇에서 돌리기 위해 바꿀 수밖에 없는 것만 바꿨다.

| 항목 | 처리 |
|---|---|
| 단위 | 각 프로젝트가 쓰는 단위(deg, rad, rpm, 엔코더 count)로 변환해서 입력 |
| 출력 스케일 | 전압/PWM/전류 카운트 출력 프로젝트는 출력→토크 변환 계수가 로봇마다 다르므로, **게인 비율은 유지한 채 전체 스케일 하나만** 로그 범위로 탐색해 최적값 사용(가장 유리한 조건) |
| 부호 | 선형 제어기는 입출력 전체 부호 반전에 대칭이므로 양쪽 부호 중 균형이 잡히는 쪽 사용 |
| 속도 모드 출력(ODrive 등) | 드라이버 속도 루프(PI + 속도 측정 LPF)를 하네스가 모사. Ryung·SonicRobot은 ODrive 기본 게인 범위에서 가장 유리한 값 사용 |
| 기계 영점 | 각 로봇의 무게중심 보정 상수(예: Ryung +0.1164 rad, LZU φ_set, zephyr θ_eq 0.315)는 0으로 설정(시뮬레이션 평형이 θ = 0) |
| 다리 길이 | 하네스가 다리 길이(무게중심 높이 l)를 바꾸면 해당 프로젝트의 게인 스케줄(다항식·테이블)에 그대로 전달 |
| 미이식 요소 | zephyr의 정지마찰 보상(전류→토크 상수 미공개), LZU의 바퀴 이탈 감지, MuShibo의 점프 상태기, fern의 트림 학습·고관절 FF1 |

벤치마크(모두 센서→토크 지연 2 ms, 프로젝트 고유 루프 주기, IMU 노이즈 0.2°/0.5°/s rms, 엔코더 양자화 포함):

| 항목 | 정의 |
|---|---|
| 최대 복귀 틸트 | 정지 상태에서 초기 기울기 θ0를 2.5° 간격으로 올려 3° 이내로 정착하는 최대값(상한 40°) |
| 최대 푸시 | 무게중심에 0.1 s 동안 수평력 F를 가해 정착하는 최대값(상한 160 N) |
| 속도 스텝 | 0.8 m/s 계단 명령(0.5→3.0 s): 90 % 상승시간, 오버슈트, 최대 기울기 |
| 지연 허용치 | 3° 기울기에서 복귀하는 최대 센서→토크 지연 |
| 다리 길이 변화 | 균형 중 1 s 동안 다리 길이를 1.4배로 늘렸다 줄임: 안정 여부와 최대 기울기 |
| 정지 떨림 | 노이즈만 있을 때 토크 RMS, 기울기 RMS |

로봇 모델 두 종(가정값): 소형 5 kg급(몸체 3.2 kg, 휠+모터 0.65 kg ×2, r 65 mm, l 0.16 m, 바퀴당 최대 5 Nm), 대형 10 kg급(몸체 7 kg, r 82.5 mm, l 0.25 m, 바퀴당 5 Nm).

---

## 3. 내가 작성한 제어기 (`sil/controllers/mine_lqi.c`, 펌웨어 `firmware/teensy_balance/`)

- 1 kHz 이산 LQI: 상태 [ẋ − v_ref, θ, θ̇, ∫(ẋ − v_ref)], 토크 출력, 레퍼런스 램프 1 m/s², 안티와인드업, 요레이트 P.
- 게인은 C 코드 안에서 로봇 파라미터로부터 **리카티 반복(Joseph 형식, 배정밀도)으로 직접 계산**하므로 로봇이 바뀌거나 다리 길이가 1 cm 이상 바뀌면 자동 재설계(게인 스케줄링). Python `scipy.solve_discrete_are`와 소수점 셋째 자리까지 일치 확인.
- 가중치 Q = diag(1, 25, 0.25, 1), R = 1/(0.5·τ_max)²: 위상여유 72–77°, 지연여유 31–43 ms.

---

## 4. 이식한 제어기별 메모

| 파일 | 원본 구조 요약 | 이식 시 자유 변수 |
|---|---|---|
| `fern_lqr3.c` | θ−θ_ref, θ̇, v 3상태 LQR; 속도 PI→θ_ref(30°/s 제한); 중력 FF2; 다리 높이별 게인 보간 | 게인은 **그들의 Q/R**로 우리 모델에서 재계산(원본 수치는 param_registry에 있어 미공개); 속도 PI 게인(0.15, 0.3), FF2(0 / 0.5) |
| `lzu_lqr4.c` | 바퀴별 T = k0(x_set−x)+k1(v_set−v)+k2(φ_set−θ)+k3(−θ̇), 다리 길이 3차 다항식 게인, 10샘플 이동평균 속도, ±1.2 Nm | 출력 스케일 |
| `zephyr_lqr4.c` | τ = −(k_p θ + k_r θ̇ + k_x x + k_v v), 2차 다항식 게인, 13 Hz 속도 LPF | 출력 스케일. 문서의 "stand" 표와 다항식의 k_x·k_v 부호가 반대라 **양쪽 모두** 테스트(`_vflip`) |
| `pow_lqr4.c` | u = K(h)(x_d−x), x=[θ, θ̇, v, ψ̇], 높이별 K 테이블 보간, ±0.75 Nm | 출력 스케일 |
| `mushibo_lqr4.c` | 각도 P(1.0, deg)+자이로 P(0.06)+거리 P(0.5, rad)+속도 P(0.7, rad/s) 각 ±8 V 제한; |u|<5일 때 소토크 PI(1, 15); 균형점 적응 0.002; 높이별 속도 P | 출력 스케일(V→Nm) |
| `wl1_cascade.c` | 10 ms 각도 PD(70, 51) ±1000 PWM, 50 ms 속도 PI(0.04, 0.006)→각도 목표 ±10°; PID 본체는 헤더 미공개라 표준 위치형으로 가정 | 출력 스케일(PWM→Nm) |
| `venus_cascade.c` | 1 ms; rpm PI(0.6, 0.003)→피치 목표; 피치 PD(1800, 18000 tick차분)→전류 ±16000 | 출력 스케일(전류→Nm); 위치 루프 게인 미공개라 생략 |
| `sonic_pid.c` | 10 ms; PID_v1(7500, 75000, 180) 피치(deg)→ODrive 속도(count/s ±360000); 바퀴 피드백 없음 | 출력 스케일(count/s→rad/s, 8192 CPR 가정), ODrive 속도 루프 모사 |
| `ryung_pid.c` | 100 Hz; 3중 PID(게인·필터·안티와인드업 원본), ODrive 속도 명령 ±20 rev/s; 바퀴 피드백 없음 | ODrive 속도 루프 게인(스윕에서 가장 유리한 값), 실제 배치(30 ms 지연) / MCU 가정(2 ms) 두 경우 |
| `kollarcik_lqi.py` | 1 ms; 3D 역진자(바퀴 뺀 전체 = 진자) 선형화 → [ẋ, φ̇, ψ̇, φ] + 속도·요율 적분 dLQR, Q=diag(5(2/r)², 1, 15(d/r)², 1, 1e-4(d/r)², 1e-4(2/r)²) R=diag(1000,1000)/휠, 휠당 ±2 Nm; 평면 대칭부만 이식(Q=diag(4081.6, 1, 1, 0.082), R_total=500) | 게인은 그들의 Q/R로 우리 모델에서 재계산(`kollarcik_lqi`), 그들 로봇 파라미터(진자 4 kg, mw 0.1, r 0.07, l 0.29, Ipy 0.0119, b 0.01)의 K 그대로(`_native`, 스케일 탐색). 논문 식 3.19는 기준을 적분기로만 넣는데 실로봇이 1 s 안에 추종했다고 하므로 ẋ 오차형(`_vref`)도 넣음 |

---

## 5. 결과

(아래 표는 하네스 실행 결과 `sil/results_small.json`, `sil/results_large.json`에서 생성)

### 5.1 벤치마크 표 (상한: 틸트 40°, 푸시 160 N)

**5 kg급 로봇 (r 65 mm, l 0.16 m, 5 Nm/휠)**

| 제어기 | 최대 복귀 틸트 [°] | 최대 푸시 [N·0.1 s] | 0.8 m/s 스텝: 상승 s / 오버슈트 % / 최대 기울기 ° | 지연 허용 [ms] | 다리 1.4× 변화: 안정 / 최대 기울기 ° | 정지 토크 RMS [Nm] / 기울기 RMS [°] | 출력 스케일 |
|---|---|---|---|---|---|---|---|
| **내 제어기: LQI 1 kHz (온라인 리카티)** | 40.0 | 60 | 1.24 / 23 / 9.2 | 30 | O / 0.1 | 0.098 / 0.022 | — |
| A1 fern: 3상태 LQR 500 Hz (그들의 Q/R) | 10.0 | 10 | 실패 | 80 | O / 0.2 | 0.016 / 0.067 | — |
| A1 fern + 중력 FF2 0.5 | 30.0 | 20 | 실패 | 50 | O / 0.1 | 0.025 / 0.045 | — |
| A1 fern 구조 + 내 Q/R (속도 PI 0.3/0.6) | 40.0 | 160 | 0.83 / 39 / 17.8 | 30 | O / 0.5 | 0.074 / 0.102 | — |
| A1 fern 구조 + 내 Q/R (속도 PI 0.15/0.3) | 40.0 | 50 | 0.96 / 17 / 11.7 | 40 | O / 0.1 | 0.071 / 0.050 | — |
| A2 LZU_ASCENTO: 4상태 LQR 1 kHz | 37.5 | 40 | 1.93 / 8 / 7.1 | 60 | O / 0.1 | 0.020 / 0.021 | 1 |
| A3 zephyr_ascento: 4상태 LQR 1 kHz (코드 부호) | 40.0 | 85 | 0.55 / 75 / 20.0 | 30 | O / 0.1 | 0.052 / 0.033 | 1.78 |
| A3 zephyr_ascento (v·x 부호 반전) | 균형 불가 (no output scale makes it balance on this robot) | | | | | | |
| A4 Pow_WBR: 4상태 LQR 125 Hz | 40.0 | 125 | 1.73 / 17 / 9.4 | 50 | O / 0.1 | 0.022 / 0.054 | 1.78 |
| A5 MuShibo: 4항 P + 소토크 PI ≈1 kHz | 7.5 | 10 | 실패 | 5 | O / 5.9 | 0.150 / 0.067 | 0.562 |
| A6 WL1: 캐스케이드 PID 100/20 Hz | 균형 불가 (no output scale makes it balance on this robot) | | | | | | |
| A7 Venus-1: 캐스케이드 PID 1 kHz | 균형 불가 (no output scale makes it balance on this robot) | | | | | | |
| A8 SonicRobot: PID→속도모드 100 Hz | 20.0 | 5 | 실패 | 5 | O / 0.6 | 0.267 / 0.192 | 0.562 |
| A9 Ryung: 3중 PID→속도모드, 실제 배치(100 Hz, 30 ms) | 0.0 | 0 | 실패 | 5 | X / 12.0 | — / — | — |
| A9 Ryung: 같은 코드, MCU 가정(100 Hz, 2 ms) | 12.5 | 5 | 실패 | 5 | O / 0.1 | 0.225 / 0.044 | — |
| U1 upkie WheelBalancer(스파인 1 kHz, 속도 PI→moteus 속도모드) | 40.0 | 10 | 실패 | 60 | O / 0.1 | 0.199 / 0.029 | — |
| U1 upkie WheelBalancer, 무른 휠 속도 루프(Kp 0.2) | 40.0 | 10 | 실패 | 30 | O / 0.1 | 0.039 / 0.034 | — |
| U2 upkie pd_balancing.py (1 kHz, 속도모드 PD) | 15.0 | 5 | 실패 | 25 | O / 0.1 | 1.112 / 0.043 | — |
| U3 upkie MPCBalancer (qpmpc+ProxQP, 200 Hz, 실제 Python 코드) | 37.5 | 20 | 0.81 / 12 / 12.3 | 30 | O / 1.0 | 0.004 / 0.072 | — |
| U3 upkie MPCBalancer, 무른 휠 속도 루프(Kp 0.2) | 균형 불가 (does not balance with either sign on this robot) | | | | | | |
| U4 upkie torque_balancing.py (200 Hz, 토크 P만) | 균형 불가 (no output scale makes it balance on this robot) | | | | | | |
| B10 WheelLeg_LQR(1772631792): 4상태 카트-폴 dLQR 1 kHz, 그들의 Q/R을 이 로봇에 설계 | 32.5 | 30 | 2.70 / -4 / 3.6 | 40 | O / 0.0 | 0.046 / 0.018 | — |
| B10 WheelLeg_LQR: 그들의 로봇(1+5 kg, COM 0.25 m) K 그대로 | 32.5 | 30 | 2.74 / -5 / 3.5 | 40 | O / 0.1 | 0.047 / 0.019 | 1 |
| A10 Kollarčík(CTU 2021): 4상태 dLQR+속도적분 1 kHz, 그들의 Q/R을 이 로봇에 설계(기준 = 적분만) | 40.0 | 115 | — / -98 / 0.1 | 40 | O / 0.1 | 0.064 / 0.026 | — |
| A10 Kollarčík: 같은 설계, 속도 기준을 ẋ 상태에도 반영(오차형) | 40.0 | 115 | 0.56 / 47 / 15.4 | 40 | O / 0.1 | 0.064 / 0.026 | — |
| A10 Kollarčík: 그들의 로봇(4.6 kg, l 0.29 m) K 그대로 | 40.0 | 105 | — / -99 / 0.1 | 60 | O / 0.1 | 0.035 / 0.028 | 0.562 |

**10 kg급 로봇 (r 82.5 mm, l 0.25 m, 5 Nm/휠)**

| 제어기 | 최대 복귀 틸트 [°] | 최대 푸시 [N·0.1 s] | 0.8 m/s 스텝: 상승 s / 오버슈트 % / 최대 기울기 ° | 지연 허용 [ms] | 다리 1.4× 변화: 안정 / 최대 기울기 ° | 정지 토크 RMS [Nm] / 기울기 RMS [°] | 출력 스케일 |
|---|---|---|---|---|---|---|---|
| **내 제어기: LQI 1 kHz (온라인 리카티)** | 40.0 | 120 | 1.21 / 25 / 8.1 | 40 | O / 0.1 | 0.128 / 0.023 | — |
| A1 fern: 3상태 LQR 500 Hz (그들의 Q/R) | 15.0 | 20 | 실패 | 60 | O / 0.2 | 0.042 / 0.083 | — |
| A1 fern + 중력 FF2 0.5 | 30.0 | 40 | 실패 | 40 | O / 0.1 | 0.071 / 0.054 | — |
| A1 fern 구조 + 내 Q/R (속도 PI 0.3/0.6) | 0.0 | 0 | 실패 | — | X / 16.7 | 0.185 / 0.584 | — |
| A1 fern 구조 + 내 Q/R (속도 PI 0.15/0.3) | 40.0 | 160 | 0.68 / 20 / 13.5 | 50 | O / 0.2 | 0.095 / 0.067 | — |
| A2 LZU_ASCENTO: 4상태 LQR 1 kHz | 35.0 | 85 | 2.40 / 8 / 5.0 | 50 | O / 0.1 | 0.069 / 0.020 | 3.16 |
| A3 zephyr_ascento: 4상태 LQR 1 kHz (코드 부호) | 37.5 | 80 | 0.32 / 90 / 28.2 | 50 | O / 0.7 | 0.057 / 0.072 | 1.78 |
| A3 zephyr_ascento (v·x 부호 반전) | 균형 불가 (no output scale makes it balance on this robot) | | | | | | |
| A4 Pow_WBR: 4상태 LQR 125 Hz | 40.0 | 160 | 1.16 / 29 / 10.3 | 50 | O / 0.2 | 0.043 / 0.062 | 3.16 |
| A5 MuShibo: 4항 P + 소토크 PI ≈1 kHz | 10.0 | 15 | 실패 | 0 | X / 12.2 | 0.259 / 0.079 | 1 |
| A6 WL1: 캐스케이드 PID 100/20 Hz | 균형 불가 (no output scale makes it balance on this robot) | | | | | | |
| A7 Venus-1: 캐스케이드 PID 1 kHz | 균형 불가 (no output scale makes it balance on this robot) | | | | | | |
| A8 SonicRobot: PID→속도모드 100 Hz | 0.0 | 5 | 실패 | 0 | X / 4.5 | 0.902 / 0.293 | 1.78 |
| A9 Ryung: 3중 PID→속도모드, 실제 배치(100 Hz, 30 ms) | 0.0 | 0 | 실패 | 20 | X / 4.6 | — / — | — |
| A9 Ryung: 같은 코드, MCU 가정(100 Hz, 2 ms) | 12.5 | 10 | 실패 | 20 | O / 0.1 | 0.185 / 0.044 | — |
| U1 upkie WheelBalancer(스파인 1 kHz, 속도 PI→moteus 속도모드) | 40.0 | 20 | 0.32 / 117 / 17.9 | 50 | O / 0.1 | 0.156 / 0.033 | — |
| U1 upkie WheelBalancer, 무른 휠 속도 루프(Kp 0.2) | 균형 불가 (does not balance with either sign on this robot) | | | | | | |
| U2 upkie pd_balancing.py (1 kHz, 속도모드 PD) | 10.0 | 10 | 실패 | 30 | O / 0.1 | 0.867 / 0.037 | — |
| U3 upkie MPCBalancer (qpmpc+ProxQP, 200 Hz, 실제 Python 코드) | 27.5 | 40 | 0.74 / 23 / 12.0 | 50 | O / 0.2 | 0.010 / 0.049 | — |
| U3 upkie MPCBalancer, 무른 휠 속도 루프(Kp 0.2) | 균형 불가 (does not balance with either sign on this robot) | | | | | | |
| U4 upkie torque_balancing.py (200 Hz, 토크 P만) | 2.5 | 5 | — / -96 / 0.5 | 0 | O / 0.4 | 0.028 / 0.159 | 0.316 |
| B10 WheelLeg_LQR(1772631792): 4상태 카트-폴 dLQR 1 kHz, 그들의 Q/R을 이 로봇에 설계 | 22.5 | 60 | 3.03 / -10 / 2.8 | 40 | O / 0.1 | 0.084 / 0.019 | — |
| B10 WheelLeg_LQR: 그들의 로봇(1+5 kg, COM 0.25 m) K 그대로 | 30.0 | 70 | 1.90 / -1 / 5.1 | 60 | O / 0.1 | 0.035 / 0.038 | 0.562 |
| A10 Kollarčík(CTU 2021): 4상태 dLQR+속도적분 1 kHz, 그들의 Q/R을 이 로봇에 설계(기준 = 적분만) | 40.0 | 160 | — / -98 / 0.1 | 60 | O / 0.1 | 0.079 / 0.024 | — |
| A10 Kollarčík: 같은 설계, 속도 기준을 ẋ 상태에도 반영(오차형) | 40.0 | 160 | 0.91 / 32 / 9.5 | 60 | O / 0.1 | 0.079 / 0.024 | — |
| A10 Kollarčík: 그들의 로봇(4.6 kg, l 0.29 m) K 그대로 | 30.0 | 80 | — / -98 / 0.1 | 40 | O / 0.3 | 0.072 / 0.053 | 1 |

"출력 스케일"은 해당 프로젝트의 전압/PWM/전류 출력을 우리 모터 토크로 환산할 때 하네스가 찾은 최적 계수(그 프로젝트에 가장 유리한 값). "—"는 토크 단위 또는 속도(m/s) 단위로 직접 출력하는 제어기.

### 5.2 고정 시나리오 (최대값이 아니라 같은 외란에서의 질)

**5 kg급 — 고정 시나리오** (정착시간(1°) / 최대 속도 / 최종 변위 / 최대 토크·휠)

| 제어기 | 10° 기울임 복귀 | 40 N × 0.1 s 푸시 |
|---|---|---|
| **내 제어기: LQI 1 kHz (온라인 리카티)** | 0.83 s / 0.34 m/s / 0.00 m / 1.72 Nm | 1.73 s / 1.44 m/s / 0.04 m / 1.08 Nm |
| A1 fern: 3상태 LQR 500 Hz (그들의 Q/R) | 4.79 s / 0.33 m/s / 0.02 m / 0.37 Nm | 실패 |
| A1 fern + 중력 FF2 0.5 | 1.19 s / 0.34 m/s / 0.01 m / 0.59 Nm | 실패 |
| A1 fern 구조 + 내 Q/R (속도 PI 0.3/0.6) | 0.54 s / 0.35 m/s / 0.00 m / 1.47 Nm | 2.33 s / 1.36 m/s / 0.09 m / 0.95 Nm |
| A1 fern 구조 + 내 Q/R (속도 PI 0.15/0.3) | 0.77 s / 0.35 m/s / 0.00 m / 1.47 Nm | 3.14 s / 1.36 m/s / 0.01 m / 0.96 Nm |
| A2 LZU_ASCENTO: 4상태 LQR 1 kHz | 1.58 s / 0.28 m/s / 0.04 m / 0.47 Nm | 2.57 s / 1.30 m/s / 0.28 m / 0.70 Nm |
| A3 zephyr_ascento: 4상태 LQR 1 kHz (코드 부호) | 0.76 s / 0.39 m/s / 0.00 m / 1.17 Nm | 2.27 s / 1.76 m/s / 0.00 m / 1.43 Nm |
| A4 Pow_WBR: 4상태 LQR 125 Hz | 0.66 s / 0.33 m/s / 0.14 m / 0.53 Nm | 2.09 s / 1.41 m/s / 0.98 m / 0.83 Nm |
| A5 MuShibo: 4항 P + 소토크 PI ≈1 kHz | 실패 | 실패 |
| A8 SonicRobot: PID→속도모드 100 Hz | 3.68 s / 0.88 m/s / 0.01 m / 1.97 Nm | 실패 |
| A9 Ryung: 3중 PID→속도모드, 실제 배치(100 Hz, 30 ms) | 실패 | 실패 |
| A9 Ryung: 같은 코드, MCU 가정(100 Hz, 2 ms) | 0.19 s / 0.49 m/s / 0.70 m / 3.99 Nm | 실패 |
| U1 upkie WheelBalancer(스파인 1 kHz, 속도 PI→moteus 속도모드) | 0.52 s / 0.36 m/s / 0.02 m / 4.92 Nm | 실패 |
| U1 upkie WheelBalancer, 무른 휠 속도 루프(Kp 0.2) | 1.18 s / 0.41 m/s / 0.02 m / 1.00 Nm | 실패 |
| U2 upkie pd_balancing.py (1 kHz, 속도모드 PD) | 0.05 s / 0.98 m/s / 0.20 m / 5.00 Nm | 실패 |
| U3 upkie MPCBalancer (qpmpc+ProxQP, 200 Hz, 실제 Python 코드) | 4.81 s / 0.36 m/s / 0.16 m / 0.34 Nm | 실패 |
| B10 WheelLeg_LQR(1772631792): 4상태 카트-폴 dLQR 1 kHz, 그들의 Q/R을 이 로봇에 설계 | 1.45 s / 0.27 m/s / 0.02 m / 1.02 Nm | 실패 |
| B10 WheelLeg_LQR: 그들의 로봇(1+5 kg, COM 0.25 m) K 그대로 | 1.12 s / 0.29 m/s / 0.02 m / 1.04 Nm | 실패 |
| A10 Kollarčík(CTU 2021): 4상태 dLQR+속도적분 1 kHz, 그들의 Q/R을 이 로봇에 설계(기준 = 적분만) | 0.69 s / 0.32 m/s / 0.09 m / 0.94 Nm | 1.17 s / 1.53 m/s / 0.44 m / 1.12 Nm |
| A10 Kollarčík: 같은 설계, 속도 기준을 ẋ 상태에도 반영(오차형) | 0.69 s / 0.32 m/s / 0.09 m / 0.94 Nm | 1.17 s / 1.53 m/s / 0.44 m / 1.12 Nm |
| A10 Kollarčík: 그들의 로봇(4.6 kg, l 0.29 m) K 그대로 | 0.72 s / 0.32 m/s / 0.10 m / 0.59 Nm | 1.11 s / 1.48 m/s / 0.49 m / 0.97 Nm |

**10 kg급 — 고정 시나리오** (정착시간(1°) / 최대 속도 / 최종 변위 / 최대 토크·휠)

| 제어기 | 10° 기울임 복귀 | 40 N × 0.1 s 푸시 |
|---|---|---|
| **내 제어기: LQI 1 kHz (온라인 리카티)** | 0.97 s / 0.43 m/s / 0.00 m / 2.28 Nm | 1.46 s / 0.74 m/s / 0.02 m / 0.80 Nm |
| A1 fern: 3상태 LQR 500 Hz (그들의 Q/R) | 0.67 s / 0.48 m/s / 0.00 m / 1.97 Nm | 2.05 s / 0.79 m/s / 0.00 m / 0.97 Nm |
| A1 fern + 중력 FF2 0.5 | 0.77 s / 0.54 m/s / 0.00 m / 2.71 Nm | 2.69 s / 0.76 m/s / 0.01 m / 0.84 Nm |
| A1 fern 구조 + 내 Q/R (속도 PI 0.3/0.6) | 실패 | 실패 |
| A1 fern 구조 + 내 Q/R (속도 PI 0.15/0.3) | 0.67 s / 0.48 m/s / 0.00 m / 1.97 Nm | 2.05 s / 0.79 m/s / 0.00 m / 0.97 Nm |
| A2 LZU_ASCENTO: 4상태 LQR 1 kHz | 1.41 s / 0.36 m/s / 0.05 m / 1.66 Nm | 2.26 s / 0.64 m/s / 0.16 m / 0.63 Nm |
| A3 zephyr_ascento: 4상태 LQR 1 kHz (코드 부호) | 1.68 s / 0.51 m/s / 0.00 m / 1.27 Nm | 2.35 s / 1.01 m/s / 0.00 m / 1.45 Nm |
| A4 Pow_WBR: 4상태 LQR 125 Hz | 0.79 s / 0.44 m/s / 0.16 m / 1.03 Nm | 1.31 s / 0.74 m/s / 0.38 m / 0.65 Nm |
| A5 MuShibo: 4항 P + 소토크 PI ≈1 kHz | 1.94 s / 1.31 m/s / 0.09 m / 5.00 Nm | 실패 |
| A8 SonicRobot: PID→속도모드 100 Hz | 실패 | 실패 |
| A9 Ryung: 같은 코드, MCU 가정(100 Hz, 2 ms) | 0.19 s / 0.50 m/s / 0.85 m / 4.02 Nm | 실패 |
| U1 upkie WheelBalancer(스파인 1 kHz, 속도 PI→moteus 속도모드) | 1.10 s / 0.44 m/s / 0.00 m / 3.89 Nm | 실패 |
| U2 upkie pd_balancing.py (1 kHz, 속도모드 PD) | 5.00 s / 0.96 m/s / 0.42 m / 5.00 Nm | 실패 |
| U3 upkie MPCBalancer (qpmpc+ProxQP, 200 Hz, 실제 Python 코드) | 2.70 s / 0.50 m/s / 0.20 m / 0.73 Nm | 3.52 s / 1.12 m/s / 0.59 m / 0.93 Nm |
| U4 upkie torque_balancing.py (200 Hz, 토크 P만) | 실패 | 실패 |
| B10 WheelLeg_LQR(1772631792): 4상태 카트-폴 dLQR 1 kHz, 그들의 Q/R을 이 로봇에 설계 | 1.27 s / 0.40 m/s / 0.02 m / 1.33 Nm | 1.85 s / 0.69 m/s / 0.03 m / 0.63 Nm |
| B10 WheelLeg_LQR: 그들의 로봇(1+5 kg, COM 0.25 m) K 그대로 | 2.54 s / 0.44 m/s / 0.00 m / 0.75 Nm | 2.67 s / 0.71 m/s / 0.00 m / 0.56 Nm |
| A10 Kollarčík(CTU 2021): 4상태 dLQR+속도적분 1 kHz, 그들의 Q/R을 이 로봇에 설계(기준 = 적분만) | 0.92 s / 0.39 m/s / 0.17 m / 1.45 Nm | 1.27 s / 0.71 m/s / 0.33 m / 0.71 Nm |
| A10 Kollarčík: 같은 설계, 속도 기준을 ẋ 상태에도 반영(오차형) | 0.92 s / 0.39 m/s / 0.17 m / 1.45 Nm | 1.27 s / 0.71 m/s / 0.33 m / 0.71 Nm |
| A10 Kollarčík: 그들의 로봇(4.6 kg, l 0.29 m) K 그대로 | 1.42 s / 0.50 m/s / 0.10 m / 1.06 Nm | 1.54 s / 0.87 m/s / 0.17 m / 1.08 Nm |

"최종 변위"가 큰 제어기는 푸시를 **버틴 것이 아니라 밀려간 것**이다. 5.1의 "최대 푸시"가 큰 Pow_WBR(125–160 N)은 40 N 푸시에 0.4–1.0 m를 굴러가고, 내 제어기(60–120 N)는 0.02–0.04 m에서 멈춘다. 적분 항이 제자리를 지키려고 토크를 포화시키기 때문에 큰 푸시에서 먼저 넘어지는 대가를 치른다.

그림: `figures/sil_responses_small.png`, `figures/sil_responses_large.png` (10° 복귀와 30 N 푸시, 대표 제어기 비교).

### 5.3 해석

**(1) 구조가 성패를 가른다.** 모델 기반 전상태 피드백(LQR 계열: 내 LQI, fern, LZU, zephyr, Pow) 다섯 개는 출력 스케일 하나만 맞추면 5 kg·10 kg 로봇 **모두에서** 40° 근처까지 복귀하고 다리 길이 변화에도 안정하다. 손튜닝 캐스케이드 PID(WL1, Venus-1)는 어떤 스케일에서도 균형을 못 잡았고(각도 D 게인이 P 대비 7–10 ms로 너무 작아 관성이 큰 로봇을 감쇠하지 못함), MuShibo의 4항 P는 소토크 PI·균형점 적응이 위상을 갉아먹어 지연 허용 0–5 ms의 한계 진동(limit cycle)을 보인다. 속도 모드 + 바퀴 피드백 없음(SonicRobot, Ryung)은 서 있더라도 푸시 뒤 계속 굴러가고(0.7–0.85 m 이후 가속) 속도 명령을 추종하지 못한다.

**(2) LQR 계열 안에서의 차이는 세 가지다.**
- *속도 상태를 어디에 두는가.* 내 LQI는 속도 오차와 그 적분을 LQR 상태에 넣어 0.8 m/s 스텝을 정상상태 오차 0, 변위 0으로 추종한다. LZU(위치 유지형)는 느리지만 오버슈트 8 %로 가장 부드럽고, Pow(적분 없음)는 밀리면 굴러간다. zephyr는 코드의 속도 항 부호가 LQR 구조와 반대라 균형은 잡아도 속도 추종이 75–90 % 오버슈트·20–28° 기울기로 사실상 불가(문서의 반대 부호는 아예 균형 불가 → 코드 부호가 실제 사용값으로 보임).
- *가중치.* fern의 Q/R(그들 로봇용)을 그대로 쓰면 우리 로봇에선 너무 무르고(복귀 10–15°, 5 kg에서 정착 4.8 s), **같은 구조에 내 가중치를 넣으면 내 제어기와 동급**(40°, 50–160 N, 지연 40–50 ms)이 된다. 즉 fern과 나의 차이는 구조가 아니라 가중치다.
- *바깥 속도 루프의 민감도.* fern 식 "속도 PI → 기울기 목표" 캐스케이드는 PI 게인 0.3/0.6에서 5 kg은 되고 10 kg은 완전히 넘어졌다(0.15/0.3이면 둘 다 됨). LQI는 바깥 루프가 없어 로봇이 바뀌어도 리카티 해만 다시 풀면 된다.

**(3) 내 제어기의 약점 두 가지.** 정지 토크 떨림이 0.098–0.128 Nm RMS로 LQR 계열 중 가장 크다(1 kHz에서 자이로 노이즈에 θ̇ 게인이 그대로 곱해짐; LZU는 10샘플 이동평균으로 0.02). 지연 허용치(30–40 ms)는 더 느리게 튜닝된 LZU·Pow(50–60 ms)보다 작다. 둘 다 Q_θ̇를 줄이거나 자이로에 50 Hz 1차 LPF를 넣으면 해결되며, MCU+CAN 경로(1–2 ms)에서는 여유가 15배 이상이다.

**(4) 최대 푸시의 함정.** 5.2에서 보듯 "더 큰 푸시를 견딘다"가 "더 잘 제어한다"는 뜻이 아니다. 굴러가게 두면 누구나 더 큰 푸시를 견딘다.

**(4) A10 Kollarčík(CTU 2021) — 가장 늦게 추가한 실물 검증 LQR.** Ascento형 4-모터에 Teensy 1 kHz 구조까지 우리 설계와 가장 가까운 프로젝트다. 그들의 Q/R을 우리 모델에 설계하면 5 kg급 40°·115 N·지연 40 ms·정지 토크 0.064 Nm, 10 kg급 40°·160 N·지연 60 ms로, **푸시와 지연 여유가 전체 표에서 1위**다. 비결은 R이 매우 비싸다는 것(휠당 1000 vs 상태 ẋ 4082, φ 1)인데, 그래서 φ 게인이 −10에서 −16, φ̇ 게인이 −1.8에서 −2.6으로 내 LQI보다 낮고, 지연에 둔감하다. 대가도 같은 자리에서 나온다: (i) 논문 식 3.19대로 속도 기준을 적분기로만 넣으면(적분 가중치 1e-4 → 적분 게인 0.012) 0.8 m/s 스텝을 2.5 s 안에 전혀 못 따라간다(표의 "— / −98"). 실로봇은 약 1 s 지연으로 추종했다고 하므로 Simulink 구현은 ẋ 오차형일 가능성이 높고, 그 변형(`_vref`)은 상승 0.56–0.91 s·오버슈트 32–47 %·피치 9.5–15°로 내 LQI(1.1–1.2 s, 20–24 %, 7.5°)보다 빠르지만 거칠다. (ii) 속도 루프가 무르므로 40 N 푸시에 0.33–0.44 m를 굴러간다(내 LQI 0.04 m, §5.2). "최대 푸시 160 N"은 §5.3 (3)의 함정과 같은 부류이고, 사용자 기준(굴러가도 다시 서면 됨)에서는 합격이지만 좁은 공간에서는 불리하다. 그들의 로봇(진자 4 kg, r 70 mm, ±2 Nm) 플랜트에서 돌린 결과는 다음과 같다(100 ms 푸시 / 지연 / 정지 토크 / 0.8 m/s 스텝): 내 LQI 75 N / 25 ms / 0.048 Nm / 상승 1.17 s; Kollarčík 130 N / 20 ms / 0.067 Nm / 적분만이라 미추종(오차형 0.55 s, 오버슈트 77 %); 그들의 K 그대로(×0.56) 95 N / 40 ms; 참고로 fern 30 N, LZU 40 N. 즉 그들 로봇에서는 그들 설계가 푸시에서 내 것을 앞서고 지연 여유는 비슷하다. **가져올 것**: R을 비싸게 두는 가중치 철학(지연 여유), 요율 적분을 같은 LQR에 넣는 3D 역진자 구성, 다리 길이 변화에 고정 K로 버틴다는 실측 근거. **주의**: 실제 펌웨어는 비공개라 이식은 MATLAB 설계와 논문 식 기준이고, 고관절 PD 게인은 논문에 수치가 없다.

### 5.4 결론

1. **균형 제어기는 직접 작성한 LQI(토크 모드, MCU 1 kHz, 온라인 리카티로 다리 길이별 게인 자동 설계)를 기본으로 쓴다.** 조사한 9개 프로젝트의 코드를 그대로 가져다 쓸 이유가 없다. 그들 중 잘 되는 것(fern·LZU·Pow·zephyr)은 모두 같은 LQR 계열이고, 성능 차이는 가중치·속도 상태 처리 차이였으며, 내 LQI가 속도 추종·변위·다리 변화 전 항목에서 동급 이상이다.
2. **참고 프로젝트에서 가져올 것**: LZU/zephyr의 속도 필터(이동평균·13 Hz LPF) → 토크 떨림 저감; fern의 중력 피드포워드(FF2)와 균형점 트림 학습, MuShibo의 균형점 자동 적응 → 기구 무게중심 오프셋 보정; LZU/Pow의 "이동 명령 중 위치 유지 해제"; fern의 워치독·고관절 토크 램프, MuShibo의 바퀴 이탈 감지 → 다리·점프 확장 시.
3. **쓰지 말 것**: ODrive 속도 모드에 바퀴 피드백 없는 PID(SonicRobot, Ryung), 손튜닝 캐스케이드 PID 게인 비율(WL1, Venus-1) — 로봇 질량이 달라지면 전이되지 않는다.
4. **코드 참고 순서**: fern(가장 완성도 높은 Ascento형, MuJoCo 쌍둥이, 500 Hz Teensy) → LZU_ASCENTO(Ascento 4절 기구와 MATLAB K 계산) → zephyr_ascento(파라미터·게인 문서) → Pow_WBR(가장 간결한 높이별 K 테이블).

---

## 6. upkie (다리당 고관절 + 무릎, 6모터) — 같은 절차로 수행

### 6.1 무엇이 있는가

[upkie/upkie](https://github.com/upkie/upkie) v13.1.0, Apache-2.0, 448★. 다리당 고관절·무릎(mjbots qdd100) + 바퀴(mj5208) = 6모터, 질량 약 5.4 kg, 바퀴 반경 60 mm, 무게중심 높이 약 0.58 m. 균형과 관련된 코드는 네 가지다.

| # | 코드 | 위치 | 구조 | 실행 위치/주기 |
|---|---|---|---|---|
| U1 | **WheelBalancer** (실제 로봇의 기본 균형기) | `upkie/cpp/controllers/WheelBalancer.cpp` | 지면 속도 명령 = −v_target − (0.7·e_x + 1.8·e_pitch) − ∫(1.6·e_x + 20·e_pitch)dt, |v| ≤ 2 m/s → 바퀴 속도 = v/r. 적분기 덕분에 "가속도 PD"와 등가. 비최소위상 트릭(−v_target). 바퀴 이탈 시 적분·목표 위치를 1 s 시정수로 복귀 | 스파인(C++) 1 kHz, moteus **속도 모드** |
| U2 | pd_balancing.py 예제 | `examples/pybullet/pd_balancing.py` | v_cmd = 10·pitch + 1·x + 0.1·ẋ, |v| ≤ 0.99 m/s | 에이전트 1 kHz, 속도 모드 |
| U3 | **MPCBalancer** | `upkie/controllers/mpc_balancer.py` | qpmpc의 운동학적 바퀴 역진자(길이 = 무게중심 높이) 모델, N = 50 × 20 ms, |가속도| ≤ 10 m/s², ProxQP 웜스타트. 첫 가속도를 적분해 지면 속도 명령 | 에이전트 200 Hz(Python), 속도 모드 |
| U4 | torque_balancing.py 예제 | `examples/pybullet/torque_balancing.py` | τ_wheel = 10 Nm/rad · pitch (P만) | 200 Hz, 토크 모드 |

다리(고관절·무릎)는 균형 루프에 들어가지 않고 위치 제어(kp_scale/kd_scale)로 자세만 잡는다. 즉 바퀴 균형 법칙은 4-모터 프로젝트와 같은 층위에서 비교할 수 있다. 그 외 강화학습 밸런서(rl_zoo3_balancer, ppo_balancer)는 별도 저장소라 제외.

### 6.2 이식

- U1·U2·U4는 C로 그대로 이식(`sil/controllers/upkie_*.c`). U1·U2는 지면 속도(m/s) 단위라 로봇에 무관하게 **원본 게인 그대로** 실행했다(스케일 탐색 없음).
- U3는 **upkie의 Python 클래스를 그대로 가져와 루프 안에서 실행**했다(`sil/controllers/upkie_mpc.py`: 복제한 저장소의 `mpc_balancer.py`를 직접 로드, qpmpc 3.2 + proxsuite 0.7 설치, upkie 내부 유틸 3개만 스텁). 모델 길이는 우리 로봇의 무게중심 높이로 설정.
- 세 속도 모드 제어기는 moteus 휠 속도 루프를 하네스가 모사한다. 처음에 썼던 무른 루프(Kp 0.2 Nm/(rad/s))에서는 10 kg 로봇에서 모두 넘어졌고, Kp ≥ 0.5에서 균형을 잡았다. 본 결과는 **뻣뻣한 루프(Kp 1.0, 실제 moteus 수준)** 기준이며, 무른 루프 결과를 함께 표시해 의존도를 보였다.

### 6.3 결과 (5.1·5.2 표의 U1–U4 행)

| 항목 | 내 LQI | U1 WheelBalancer | U3 MPC(실제 코드) | U2 PD 예제 | U4 토크 P |
|---|---|---|---|---|---|
| 최대 복귀 틸트 (5 kg / 10 kg) | 40° / 40° | 40° / 40° | 37.5° / 27.5° | 15° / 10° | 균형 불가 |
| 최대 푸시 | 60 / 120 N | 10 / 20 N | 20 / 40 N | 5 / 10 N | — |
| 0.8 m/s 스텝 | 1.24 s, 23 %, 9.2° | 실패 / 0.32 s, **117 %**, 17.9° | 0.81 s, 12 %, 12.3° / 0.74 s, 23 %, 12.0° | 실패 | — |
| 지연 허용 | 30 / 40 ms | 60 / 50 ms | 30 / 50 ms | 25 / 30 ms | — |
| 다리 1.4× 변화 | 안정 0.1° | 안정 0.1° | 안정 1.0° / 0.2° | 안정 0.1° | — |
| 정지 토크 RMS | 0.098 / 0.128 Nm | 0.199 / 0.156 | **0.004 / 0.010** | 1.11 / 0.87 | — |
| 10° 복귀(정착/변위/최대 토크) | 0.83 s / 0 m / 1.7 Nm | 0.52 s / 0.02 m / **4.9 Nm(포화)** | 4.8 s / 0.16 m / 0.3 Nm (5 kg) | 0.05 s / 0.2 m / 5 Nm(포화) | — |
| 40 N 푸시 | 1.7 s / 0.04 m | 실패 | 실패 / 3.5 s, 0.59 m | 실패 | — |
| 무른 휠 속도 루프(Kp 0.2)에서 | 무관(토크 모드) | 5 kg만 성립 | 균형 불가 | — | — |

### 6.4 해석과 결론

1. **upkie의 균형기는 전부 "속도 모드"다.** 토크를 만드는 것은 제어기가 아니라 moteus의 휠 속도 루프이고, 제어기는 지면 속도만 명령한다. 그래서 성능이 드라이버 루프 강성에 직결된다(무른 루프에서 전부 실패). 정지 토크 떨림도 그 결과다. 뻣뻣한 속도 루프가 측정·명령 노이즈를 토크로 바꾸기 때문에 U1 0.16–0.20 Nm, U2 0.9–1.1 Nm RMS로 내 LQI(0.10–0.13)보다 크다. 유일한 예외가 MPC로, 가속도 한계(10 m/s²)가 명령을 매끄럽게 만들어 0.004–0.010 Nm로 가장 조용하다.
2. **게인은 upkie 로봇(무게중심 0.58 m, 불안정 극 4 rad/s)용이다.** 무게중심이 낮아 불안정 극이 7 rad/s인 우리 로봇에서는 U1이 10° 복귀에 토크를 포화시키고도 푸시 10–20 N밖에 못 버티며, 10 kg에서는 속도 스텝에 117 % 오버슈트·18° 기울기를 보인다. U2 예제는 애초에 교육용이고, U4(P만)는 어떤 로봇에서도 설 수 없다.
3. **MPC(실제 코드)는 속도 추종이 가장 매끄럽고 조용하지만 느리고 무르다.** 10° 복귀에 2.7–4.8 s, 40 N 푸시에 0.59 m 밀리거나 넘어진다. 모델이 질량·토크 없는 운동학적 역진자라 외란 복구에 필요한 공격성을 낼 수 없고, Python 200 Hz(ProxQP 웜스타트 1회당 수 ms)는 Teensy에서 돌릴 수 없다.
4. **결론**: upkie의 균형 법칙 자체는 5–10 kg 직접구동·토크 모드 로봇에 가져올 이유가 없다. 내 LQI가 푸시 3–6배, 속도 스텝 오버슈트 절반, 변위 0으로 앞선다. 다만 upkie는 **소프트웨어 구조**에서 참고 가치가 가장 크다. (a) 1 kHz 스파인(C++)과 에이전트(Python)를 공유 메모리로 분리하고 제어기 파이프라인·관측기(바퀴 오도메트리, 바닥 접촉)를 모듈화한 구조는 이 프로젝트의 Teensy/ROS 2 분리와 같은 철학이라 설계 참고가 된다. (b) 바퀴 이탈 시 적분기·목표를 서서히 복귀시키는 "air return" 처리와 MPC의 가속도 한계는 점프·계단 확장 때 가져올 만하다. (c) Apache-2.0에 PyBullet/MuJoCo 환경·RL 베이스라인이 갖춰져 있어 시뮬레이션 쌍둥이를 만들 때 가장 완성도 높은 출발점이다.
5. **6-모터 플랜트에서의 결과는 §8.4.1.** 위 표는 다리 상태가 없는 4-모터 하네스 결과다. upkie처럼 다리가 위치 서보로 몸체에 붙어 있는 구조를 3체 플랜트(다리각 θ·몸체 피치 φ)에서 upkie 자신의 서보 모델까지 넣고 다시 돌린 결과가 §8.4.1에 있고, 결론은 같다.

## 7. 한계

- 플랜트는 2륜 역진자 + 다리 길이(무게중심 높이) 변화 모델이며 다리 링크 동역학·고관절 토크 결합·타이어 컴플라이언스는 없다. 로봇 파라미터는 가정값.
- 전압/PWM/전류 출력 프로젝트는 스케일 하나만 탐색했다(게인 비율은 그들 값). 비율까지 재튜닝하면 더 잘 될 수 있으나 그러면 "그들의 제어기"가 아니다.
- WL1의 PID 본체, SonicRobot의 엔코더 CPR, zephyr의 정지마찰 전류→토크 상수는 공개 소스에 없어 가정했다. 기계 영점 상수는 모두 0으로 두었다.
- 속도 모드 프로젝트의 드라이버 속도 루프 게인은 ODrive 기본값 범위에서 가장 유리한 값을 골랐고, upkie는 moteus 수준의 뻣뻣한 루프(Kp 1.0 Nm/(rad/s))로 두었다. 실제 moteus 게인은 upkie 설정 파일에 없어 가정값이다.

---

## 8. 6-모터(5절 링크, 다리당 관절 2개) 프로젝트 — 같은 절차로 수행

§1.2의 6-모터 프로젝트(현재 접근 가능한 9개 + 이후 비공개로 바뀐 USTB·Multivac 2개) 중 upkie는 §6(4-모터 하네스)에서 먼저 다뤘고 6-모터 플랜트 결과는 §8.4.1에 있으며, chen-jiangnan/RMInfantry_wheelLegged_ws는 처음 받은 파일에 게인 값이 없어 제외했다(전체 저장소에는 `chassis_control_config.yaml`에 K가 있음을 뒤에 확인 — `시뮬레이션_환경조사.md` S7, 추후 B11로 추가 가능). 실물 없는 Webots 전용 프로젝트(LiuDingchuan)는 목록과 결과에서 뺐다. 나머지 9개는 **공개된 게인 표·다항식을 그대로** 6-모터 전용 시뮬레이터(`sim6/`)에 넣어 테스트했고, 그중 1772631792/WheelLeg_LQR은 균형 법칙이 다리 각도를 쓰지 않는 4-상태 카트-폴 LQR이라 §5의 4-모터 하네스에 넣었다(B10, §5.1·5.2 표에 행 추가).

### 8.1 이 프로젝트들의 공통 구조

10개 중 9개가 **같은 모델, 같은 제어 법칙**이다. 하얼빈공대(HEU) RoboMaster 팀이 2021년에 공개한 "휠-레그 LQR" 유도 — 바퀴·다리(5절 링크를 가상 다리 하나로 환원)·몸체의 3체 평면 모델 — 을 MATLAB으로 그대로 재현해 LQR 게인을 다리 길이 L0에 대한 다항식으로 피팅하고, MCU에서는 `u = −K(L0)·x` 한 줄을 돌린다.

- 상태 6개: `x = [θ, θ̇, x, ẋ, φ, φ̇]` — θ 가상 다리의 기울기(고관절이 바퀴보다 앞이면 +), x 바퀴 위치, φ 몸체 피치(HEU 부호: 뒤로 젖히면 +).
- 입력 2개: `u = [T, Tp]` — T 바퀴 토크 합, Tp 고관절이 몸체에 주는 피치 토크(다리에는 반작용). 세 번째 자유도(다리 길이)는 **VMC로 분리**해 별도 PD로 지지력 F를 만들고, 5절 링크 야코비안으로 (F, Tp)를 두 관절 토크로 바꾼다.
- 따라서 "6-모터 균형 제어"의 균형 부분은 4-모터와 동일하게 상태 피드백이고, 추가된 것은 상태 2개(θ, θ̇)와 출력 1개(Tp)뿐이다. 다리 길이 제어는 균형과 결합되지 않는다(준정적 파라미터로 취급).

프로젝트별 차이는 (1) 다항식 차수와 상태 순서, (2) Q/R, (3) 다리별로 K를 적용하는지 전체로 적용하는지, (4) 펌웨어가 Tp 행을 실제로 쓰는지뿐이다. 소스를 끝까지 읽어 보니 **(4)에서 두 프로젝트가 "LQR"과 다르게 동작**했다(§8.3 B9, §8.3 B6).

### 8.2 테스트 환경 — 3체 휠-레그 플랜트 (`sim6/plant6.py`)

4-모터 비교(§2)의 2륜 역진자 플랜트는 다리 각도 상태가 없어 이 법칙들을 넣을 수 없다. 그래서 이 프로젝트들이 MATLAB에서 쓰는 **바로 그 3개 식**(sys_calc.m / chassis_calc_heu.m / model_LQR.m에 동일하게 들어 있는 HEU 식)으로 비선형 플랜트를 만들었다.

```
Nm = M (ẍ + (L+Lm)(θ̈ cosθ − θ̇² sinθ) − l (φ̈ cosφ − φ̇² sinφ)) − F        (F: 몸체 무게중심에 가하는 수평 외란)
Pm = M g + M ((L+Lm)(−θ̇² cosθ − θ̈ sinθ) − l (φ̇² cosφ + φ̈ sinφ))
N  = Nm + mp (ẍ + L (θ̈ cosθ − θ̇² sinθ)),   P = Pm + mp g + mp L (−θ̇² cosθ − θ̈ sinθ)
(1) ẍ = (T − N R)/(Iw/R + mw R)
(2) (P L + Pm Lm) sinθ − (N L + Nm Lm) cosθ − T + Tp − Ip θ̈ = 0
(3) Tp + Nm l cosφ + Pm l sinφ − Im φ̈ = 0
```

sympy로 가속도에 대해 선형인 꼴 `M_acc(q, q̇)·[ẍ, θ̈, φ̈] = rhs`로 정리해 매 스텝 수치로 풀고(RK4 1 ms), 선형화는 유한차분으로 한다. 다리 길이 L0는 매 스텝 바꿀 수 있는 파라미터이며 Ip(L0)는 USTB의 피팅식을 쓴다. 바퀴 점성 마찰 b·ẋ·R을 더했다.

**검증**: USTB Reborn(JerryGong0911)이 문서에 공개한 로봇 파라미터(R 0.076 m, m_w 0.47, m_p 1.874, M 6.975 kg, I_w 0.001974, I_M 0.143, l 0.0353 m, L = 0.1576 L0 + 0.0272, I_p = 0.0328 L0 + 0.0216)와 Q=diag(160,160,200,120,2000,50), R=diag(1,0.25)를 내 플랜트에 넣고 1 ms dLQR을 풀면, 그들이 펌웨어에 넣은 K(L) 2차 다항식(`k[12][3]`)과 다음과 같이 맞는다(바퀴 토크 행, L0 = 0.20 m):

| 항 | θ | θ̇ | x | ẋ | φ | φ̇ |
|---|---|---|---|---|---|---|
| 내 플랜트 dLQR | −48.2 | −11.4 | −10.0 | −14.5 | 26.4 | 5.2 |
| USTB 다항식 | −44.2 | −8.5 | −10.2 | −14.3 | 26.0 | 5.1 |

L0 = 0.15, 0.30 m에서도 5–10 % 안에 들어온다(`python3 plant6.py`). 즉 플랜트와 부호 규약이 이 프로젝트들의 설계 모델과 같고, 이 플랜트에서 균형이 안 되는 법칙은 이식 실수가 아니라 법칙 자체의 문제로 볼 수 있다. 개루프 고유값(RM급, L0 0.2 m)은 ±13.7, ±4.1 rad/s — **불안정 모드가 둘**(다리 모드 73 ms, 몸체 모드 245 ms)이라 4-모터 플랜트(6.9 rad/s 하나)보다 빠르다.

플랜트 5종으로 돌렸다: **RM급**(위 USTB 파라미터, 휠 6 Nm·고관절 30 Nm — 이 프로젝트들의 원래 로봇), **15 kg급 Webots 모델**(LiuDingchuan 졸업과제의 문서 값 — 제어기는 목록에서 뺐지만 무거운 로봇 플랜트로는 유지), **Skythinker 탁상 로봇**(0.6 kg, sys_calc.m 값), 그리고 우리 목표인 **5 kg급·10 kg급 5절 링크 가정**. 이와 별도로 upkie 제어기(§8.4.1)만을 위해 **upkie 추정 모델**(5.4 kg, R 0.06 m, 직렬 다리 L0 0.40 m, 몸체 무게중심 고관절 위 0.12 m, 휠 mj5208 1.7 Nm·관절 qdd100 16 Nm — 저장소에 URDF가 없어 질량 배분 몸체 3.4/다리 1.2/바퀴 0.8 kg은 추정)을 넣었다.

하네스(`sim6/sil6_harness.py`)의 테스트 항목은 §2와 같고 다리 상태가 추가됐다: 다리 기울임/몸체 기울임 복귀 한계(2.5° 간격, 40°까지, 노이즈 포함), 100 ms 푸시 한계(**로봇 무게 W의 0.1–2.0배**로 정규화 — 0.6 kg 로봇에 10 N을 밀 수는 없으므로), 속도 스텝(0.8 m/s, 탁상 로봇 0.3 m/s), 지연 허용(0–80 ms), 다리 길이 1.4배 램프, 정지 토크 RMS, 고정 시나리오(다리 10°, 0.4 W 푸시). 센서 노이즈는 다리각 0.1°, 다리각속도 0.5°/s, 피치 0.2°, 자이로 0.5°/s, 엔코더 14비트.

**부호 탐색**: 프로젝트마다 IMU·모터·관절 영점의 극성이 다르므로 (θ, φ, T, Tp) 부호 16가지를 모두 시도해 2° 기울임을 복귀하고 가장 큰 푸시를 견디는 조합을 쓴다(Jerry는 플랜트와 같은 HEU 규약이라 전부 +). 그리고 **두 단계**로 평가했다. (a) **공개 게인 그대로**(출력 스케일 1) — 그 프로젝트의 제어기 자체. (b) **출력 스케일 탐색**(1/16–128배) — 다른 로봇용 게인을 이 로봇 무게에 맞게 키우거나 줄인 것. (b)는 "게인 비율은 그들 것, 크기만 조정"이다.

### 8.3 이식 메모 (`sim6/controllers6.py`)

| | 프로젝트 | 법칙·게인 출처 | 이식에서 확인한 사실 |
|---|---|---|---|
| B1 | JerryGong0911/RM2024_Reborn (USTB) — 저장소 접근 불가(2026-10-20 404) | `k[12][3]` K(L) 2차 다항식, Q=diag(160,160,200,120,2000,50) R=diag(1,.25), 1 kHz | 파라미터 전부 공개 → RM급 플랜트가 곧 이 로봇. 플랜트 검증 기준. |
| B2 | [Skythinker616/foc-wheel-legged-robot](https://github.com/Skythinker616/foc-wheel-legged-robot) | `lqr_k.c`(MATLAB Coder) 3차 다항식 12개, sys_calc.m: 0.6 kg, R 20 mm, L0 0.04–0.14 m, **5 ms dLQR**, Q=diag(1,10,100,20,1000,1) R=I | 몸체 무게중심을 고관절에 둔 모델(l = 0)이라 Tp 행이 φ·φ̇ 항만 남는다(θ 항 ≈ 0). 코드는 `u = +K·x`(부호는 하드웨어 극성으로 맞춤). 0.6 kg용 게인이라 RM급에서는 스케일 32–64배가 필요. |
| B3 | [HNUST-Dust/wbr_control](https://github.com/HNUST-Dust/wbr_control) (직렬 2관절) | 통합 10상태/4출력 LQR, 정규화 다리길이 n=(L−0.25)/0.15의 3차 다항식(4×10×4 계수, Apache-2.0 → `sim6/data/`에 복사), 1 kHz | 좌우 θ를 따로 쓰는 10상태를 평면(θ_l = θ_r)으로 합쳐 2×6으로 줄임. |
| B4 | [QDU-Robomaster/Wheelleg](https://github.com/QDU-Robomaster/Wheelleg) | 10상태/4출력, 좌우 다리길이 (L_l, L_r)의 2변수 2차 다항식 40×6 표 | 항 순서 [1, L_l, L_r, L_l², L_l L_r, L_r²]를 표의 좌우 대칭에서 확인. 평면에서는 L_l = L_r. 피치 부호가 HEU와 반대(탐색으로 φ 또는 Tp 반전). |
| B5 | Multivac11/Wheel-legged-robot — 저장소 접근 불가(2026-10-20 404) | 다리별 6상태 LQR 3차 다항식, Q=(1,1,100,600,5000,1) R=(280,17), 1 kHz | 법칙 `T = K0 θ + K1 θ̇ + K2(x_set−x) + K3(v_set−v) + K4 φ + K5 φ̇`, 두 다리에 같은 K → 합 2배. 각도 부호가 HEU와 반대(θ, φ 반전). |
| B6 | [Zhouzzw/Balanced_WheelLeg_Robot](https://github.com/Zhouzzw/Balanced_WheelLeg_Robot) (직렬 2관절) | 다리별 6상태 LQR 3차 다항식, Q=diag(16000,1000,250,100,70000,1000), 휠 6 Nm·관절 80 Nm 제한 | 게인이 USTB의 2–5배(Tp의 θ 항 174 vs 32). 관절 토크에는 LQR Tp 행 + 좌우 θ합 보상 PID(4, 0, 0.1)가 더해진다. |
| B8 | [lyz1202dt/ATWheelLeg](https://github.com/lyz1202dt/ATWheelLeg) | 17점 게인 표(L 0.18–0.34 m, 1 cm 간격) 선형 보간, 500 Hz, 상태 [x, ẋ, θ, θ̇, φ, φ̇] | `lqr = ground_gain·(expected − state)`, 공중 게인은 별도. 게인 크기가 USTB의 1/5(θ 6.9 vs 44). |
| B9 | [LJW0401/Wheel_Leg_Balance_Vehicle](https://github.com/LJW0401/Wheel_Leg_Balance_Vehicle) | `LQR_K.c`(MATLAB Coder) 3차 다항식 12개 | **펌웨어는 Tp 행을 쓰지 않는다.** `Balance_Controler.c` STAND/MOVING: `res = k·x`, 바퀴 = ±0.2·res[0](LQR_T_ratio 0.2, 두 바퀴 합 0.4배), x 게인은 kRatio로 0. 고관절은 CyberGear **위치 모드**(kp 1–10, kd 0.5)로 몸체 기준 다리각 π/2를 유지(pitch_PID 게인 0) — 다리를 몸체에 고정한 2륜 로봇으로 운전하는 셈. 이식은 이 그대로(B9, 관절 kp 5·kd 0.5 가정)와, MATLAB K를 2×6으로 다 쓰는 가정(B9')을 둘 다 넣었다. |
| B10 | [1772631792/WheelLeg_LQR](https://github.com/1772631792/WheelLeg_LQR) | 4상태 카트-폴 LQR(p, v, θ, ω), Q=diag(20,2,300,5) R=0.1, 로봇 1+5 kg·COM 0.25 m, C 리카티(정확 ZOH + 반복) | 다리는 길이 PID + VMC 지지력만, 고관절 피치 토크 없음. 균형 법칙에 다리각이 없으므로 §5 하네스(`sil/controllers/wheelleg_lqr4.c`)에서 테스트: 그들 Q/R을 우리 로봇에 설계한 것과 그들 로봇 K 그대로 두 가지. C 솔버 결과는 SciPy DARE와 7자리 일치. |

**내 제어기(B0, `MineLQI6`)**: 플랜트 선형화에서 1 kHz dLQR을 온라인으로 풀고(§3과 같은 방식, 상태 [θ, θ̇, v, φ, φ̇, ∫v] — 위치 x 대신 속도 적분), L0가 1 cm 이상 바뀌면 다시 설계한다(게인 스케줄링을 다항식 피팅 없이 수행). 첫 설계(Bryson, θ 0.2 rad·φ 0.1 rad, R은 토크 한계의 50 %)는 40°·110 N을 통과했지만 **지연 허용이 5 ms 미만**이었다(K_Tp(θ) = 104). 가중치를 쓸어 보고 다음을 골랐다:

| Q 역가중 (θ, θ̇, v, φ, φ̇, ∫v) / R 역가중 (T, Tp) | 지연 허용 | 최대 푸시 | 최대 틸트 | 정지 토크 RMS 휠/고관절 | 0.8 m/s 상승 |
|---|---|---|---|---|---|
| (0.2, 2, 1, 0.1, 2, 1) / (6, 30) — 첫 설계 | < 5 ms | 110 N | 40° | 0.22 / 1.00 Nm | 1.20 s |
| (0.2, 2, 1, 0.1, 2, 1) / (2, 6) | 15 ms | 110 N | 40° | 0.08 / 0.21 Nm | 1.24 s |
| **(0.3, 3, 1, 0.15, 3, 1) / (1.5, 4) — 채택** | **20 ms** | **110 N** | **40°** | **0.054 / 0.105 Nm** | **1.17 s** |
| (0.3, 3, 1, 0.2, 3, 2) / (1, 3) | 30 ms | 70 N | 40° | 0.034 / 0.069 Nm | 1.50 s |

(RM급 플랜트. 지연 허용은 3° 기울임 무노이즈, 나머지는 2 ms 지연 + 노이즈.) 토크를 싸게 두면 게인이 커져 외란에는 강하지만 지연에 약해진다 — 6-모터에서는 불안정 모드가 둘이라 4-모터보다 이 절충이 훨씬 가파르다.

### 8.4 결과

표기: ○ 다리·몸체 40° 복귀와 속도 스텝 통과, △ 균형은 되지만 한계가 낮거나 속도 스텝 실패, × 균형 불가. 각 칸은 "100 ms 푸시 한계(로봇 무게 W 배수) / 지연 허용". 전체 표(다리·몸체 틸트 한계, 속도 스텝 상승·오버슈트·기울기, 다리 길이 변화, 정지 토크 RMS, 부호, 고정 시나리오)는 아래와 `sim6/results6_tables.md`.

**(a) 공개 게인 그대로 (스케일 1)**

| 제어기 | RM급 7 kg | 15 kg Webots | Sky 0.6 kg | 5 kg급 | 10 kg급 |
|---|---|---|---|---|---|
| **내 LQI6** | ○ 1.2 W / 20.0 ms | ○ 0.9 W / 20.0 ms | ○ 1.0 W / 15.0 ms | ○ 1.1 W / 20.0 ms | ○ 1.1 W / 30.0 ms |
| B1 USTB | ○ 0.9 W / 0.0 ms | ○ 1.0 W / 5.0 ms | × | × | ○ 0.9 W / 5.0 ms |
| B2 Skythinker | × | × | ○ 0.5 W / 0.0 ms | × | × |
| B3 HNUST | ○ 0.8 W / 15.0 ms | △ 0.2 W / 5.0 ms | × | ○ 0.6 W / 5.0 ms | ○ 0.9 W / 20.0 ms |
| B4 QDU | ○ 1.4 W / 5.0 ms | ○ 1.3 W / 5.0 ms | × | ○ 1.2 W / 0.0 ms | ○ 1.3 W / 10.0 ms |
| B5 Multivac | ○ 0.9 W / 15.0 ms | ○ 1.1 W / 5.0 ms | × | ○ 0.7 W / 10.0 ms | ○ 0.9 W / 15.0 ms |
| B6 Zhouzzw | × | △ 0.5 W / 5.0 ms | × | × | △ 0.1 W / 0.0 ms |
| B8 ATWheelLeg | △ 0.3 W / 10.0 ms | △ 0.1 W / 10.0 ms | × | △ 0.4 W / 0.0 ms | △ 0.3 W / 15.0 ms |
| B9 LJW(코드) | ○ 0.7 W / 15.0 ms | △ 0.1 W / 20.0 ms | × | ○ 2.0 W / 5.0 ms | ○ 1.1 W / 5.0 ms |
| B9' LJW 전체K | ○ 0.5 W / 10.0 ms | △ 0.4 W / 20.0 ms | × | ○ 0.5 W / 5.0 ms | ○ 0.5 W / 15.0 ms |

**(b) 출력 스케일 탐색 후 (×스케일)**

| 제어기 | RM급 7 kg | 15 kg Webots | Sky 0.6 kg | 5 kg급 | 10 kg급 |
|---|---|---|---|---|---|
| **내 LQI6** | ○ ×1: 1.2 W / 20.0 ms | ○ ×1: 0.9 W / 20.0 ms | ○ ×1: 1.0 W / 15.0 ms | ○ ×1: 1.1 W / 20.0 ms | ○ ×1: 1.1 W / 30.0 ms |
| B1 USTB | ○ ×1: 0.9 W / 0.0 ms | ○ ×1: 1.0 W / 5.0 ms | × | ○ ×0.5: 0.7 W / 0.0 ms | ○ ×0.5: 1.0 W / 10.0 ms |
| B2 Skythinker | ○ ×32: 0.9 W / 5.0 ms | ○ ×32: 1.7 W / 15.0 ms | ○ ×1: 0.5 W / 0.0 ms | ○ ×16: 0.7 W / 5.0 ms | ○ ×32: 0.9 W / 10.0 ms |
| B3 HNUST | ○ ×1: 0.8 W / 15.0 ms | ○ ×2: 1.3 W / 5.0 ms | ○ ×0.0625: 0.3 W / 0.0 ms | ○ ×1: 0.6 W / 5.0 ms | ○ ×1: 0.9 W / 20.0 ms |
| B4 QDU | ○ ×1: 1.4 W / 5.0 ms | ○ ×1: 1.3 W / 5.0 ms | ○ ×0.0625: 0.7 W / 5.0 ms | ○ ×1: 1.2 W / 0.0 ms | ○ ×1: 1.3 W / 10.0 ms |
| B5 Multivac | ○ ×0.5: 1.2 W / 30.0 ms | ○ ×1: 1.1 W / 5.0 ms | ○ ×0.25: 1.1 W / 5.0 ms | ○ ×0.25: 1.0 W / 20.0 ms | ○ ×0.5: 1.1 W / 30.0 ms |
| B6 Zhouzzw | ○ ×0.5: 0.5 W / 0.0 ms | △ ×1: 0.5 W / 5.0 ms | × | ○ ×0.25: 0.4 W / 0.0 ms | ○ ×0.5: 0.5 W / 0.0 ms |
| B8 ATWheelLeg | △ ×2: 0.4 W / 0.0 ms | △ ×2: 0.3 W / 0.0 ms | △ ×0.0625: 0.2 W / 0.0 ms | △ ×1: 0.4 W / 0.0 ms | △ ×2: 0.4 W / 5.0 ms |
| B9 LJW(코드) | ○ ×2: 2.0 W / 10.0 ms | ○ ×2: 2.0 W / 20.0 ms | ○ ×0.25: 0.3 W / — ms | ○ ×1: 2.0 W / 5.0 ms | ○ ×1: 1.1 W / 5.0 ms |
| B9' LJW 전체K | ○ ×2: 0.8 W / 5.0 ms | ○ ×8: 0.8 W / 0.0 ms | ○ ×0.0625: 0.4 W / 0.0 ms | ○ ×1: 0.5 W / 5.0 ms | ○ ×2: 0.8 W / 5.0 ms |

(Sky 0.6 kg 플랜트에서 USTB·Zhouzzw가 ×인 것은 탐색 하한 1/16이 모자라서다 — Skythinker→RM이 32배였으므로 반대 방향은 1/32가 필요하다. 1/16 안에서 균형이 되는 HNUST·QDU·Multivac·LJW도 정지 토크 RMS 0.3–0.6 Nm로 0.2 Nm 모터 한계에서 떨고 있다. 즉 7–15 kg용 게인은 0.6 kg 로봇에 못 쓴다.)

**RM급 5절링크 로봇 (USTB Reborn 파라미터: 몸체 7.0 kg, 다리 1.9 kg, 바퀴 0.47 kg, r 76 mm, L0 0.20 m, 휠 6 Nm, 고관절 30 Nm)** — 로봇 무게 W = 91 N, 속도 스텝 0.8 m/s

*(a) 공개된 게인 그대로 (출력 스케일 1, 센서·모터 부호만 탐색)*

| 제어기 | 최대 복귀 틸트 다리/몸체 [°] | 최대 푸시 [N·0.1 s] | 속도 스텝: 상승 s / 오버슈트 % / 몸체 ° / 다리 ° | 지연 허용 [ms] | 다리 1.4× 변화: 안정 / 몸체 ° | 정지 토크 RMS 휠/고관절 [Nm] | 스케일 | 부호 θφ/T·Tp |
|---|---|---|---|---|---|---|---|---|
| **내 제어기: LQI6 1 kHz (온라인 리카티, 6상태+속도적분)** | 40.0 / 40.0 | 110 (1.2 W) | 1.17 / 23 / 0.3 / 9.8 | 20 | O / 0.03 | 0.054 / 0.118 | 1 | ++++ |
| B1 JerryGong0911 RM2024_Reborn(USTB): 6상태 LQR, K(L) 2차 다항식 | 40.0 / 40.0 | 82 (0.9 W) | 0.76 / 64 / 1.3 / 13.4 | 0 | O / 0.02 | 0.337 / 0.476 | 1 | ++++ |
| B2 Skythinker616: 6상태 dLQR 5 ms, K(L0) 3차 (0.6 kg 로봇용) | 균형 불가 | | | | | | | |
| B3 HNUST-Dust wbr_control: 10상태/4출력 LQR, K(L) 3차 | 40.0 / 40.0 | 73 (0.8 W) | 1.22 / 100 / 4.9 / 17.8 | 15 | O / 0.08 | 0.065 / 0.500 | 1 | ++++ |
| B4 QDU-Robomaster Wheelleg: 10상태/4출력 LQR, K(L_l,L_r) 2변수 2차 | 40.0 / 40.0 | 128 (1.4 W) | 0.99 / 68 / 0.6 / 12.5 | 5 | O / 0.02 | 0.199 / 0.203 | 1 | +++− |
| B5 Multivac11: 6상태 LQR(다리별), K(L0) 3차 | 40.0 / 40.0 | 82 (0.9 W) | 1.67 / 48 / 2.2 / 8.9 | 15 | O / 0.04 | 0.091 / 0.217 | 1 | −−++ |
| B6 Zhouzzw: 6상태 LQR(다리별), K(L) 3차, Q=diag(16000,…,70000,…) | 균형 불가 | | | | | | | |
| B8 lyz1202dt ATWheelLeg: 6상태 LQR 500 Hz, 17점 게인 표 | 7.5 / 40.0 | 27 (0.3 W) | 1.31 / 28 / 1.5 / 8.4 | 10 | O / 0.03 | 0.044 / 0.106 | 1 | ++++ |
| B9 LJW0401 (코드 그대로): 바퀴 T = 0.4×LQR 1행, 고관절 = CyberGear 위치 루프 | 40.0 / 40.0 | 64 (0.7 W) | 0.41 / 65 / 21.6 / 18.2 | 15 | O / 0.10 | 0.050 / 0.085 | 1 | ++−+ |
| B9' LJW0401 MATLAB K를 2×6 전체 상태 피드백으로 (가정; 펌웨어는 이렇게 안 씀) | 40.0 / 40.0 | 46 (0.5 W) | 0.52 / 52 / 0.7 / 18.9 | 10 | O / 0.04 | 0.129 / 0.104 | 1 | ++++ |

*(b) 출력 스케일까지 탐색 (이 로봇에 맞게 게인 크기 재조정)*

| 제어기 | 최대 복귀 틸트 다리/몸체 [°] | 최대 푸시 [N·0.1 s] | 속도 스텝: 상승 s / 오버슈트 % / 몸체 ° / 다리 ° | 지연 허용 [ms] | 다리 1.4× 변화: 안정 / 몸체 ° | 정지 토크 RMS 휠/고관절 [Nm] | 스케일 | 부호 θφ/T·Tp |
|---|---|---|---|---|---|---|---|---|
| B1 JerryGong0911 RM2024_Reborn(USTB): 6상태 LQR, K(L) 2차 다항식 | 40.0 / 40.0 | 82 (0.9 W) | 0.76 / 64 / 1.3 / 13.4 | 0 | O / 0.02 | 0.337 / 0.476 | 1 | ++++ |
| B2 Skythinker616: 6상태 dLQR 5 ms, K(L0) 3차 (0.6 kg 로봇용) | 40.0 / 40.0 | 82 (0.9 W) | 0.66 / 89 / 0.6 / 17.0 | 5 | O / 0.18 | 0.143 / 0.230 | 32 | ++++ |
| B3 HNUST-Dust wbr_control: 10상태/4출력 LQR, K(L) 3차 | 40.0 / 40.0 | 73 (0.8 W) | 1.22 / 100 / 4.9 / 17.8 | 15 | O / 0.08 | 0.065 / 0.500 | 1 | ++++ |
| B4 QDU-Robomaster Wheelleg: 10상태/4출력 LQR, K(L_l,L_r) 2변수 2차 | 40.0 / 40.0 | 128 (1.4 W) | 0.99 / 68 / 0.6 / 12.5 | 5 | O / 0.02 | 0.199 / 0.203 | 1 | +++− |
| B5 Multivac11: 6상태 LQR(다리별), K(L0) 3차 | 40.0 / 40.0 | 110 (1.2 W) | 1.27 / 44 / 2.6 / 11.4 | 30 | O / 0.04 | 0.045 / 0.108 | 0.5 | −−++ |
| B6 Zhouzzw: 6상태 LQR(다리별), K(L) 3차, Q=diag(16000,…,70000,…) | 40.0 / 40.0 | 46 (0.5 W) | 2.50 / 3 / 0.9 / 4.5 | 0 | O / 0.04 | 0.108 / 0.637 | 0.5 | ++++ |
| B8 lyz1202dt ATWheelLeg: 6상태 LQR 500 Hz, 17점 게인 표 | 15.0 / 40.0 | 37 (0.4 W) | 1.77 / 12 / 1.0 / 5.7 | 0 | O / 0.03 | 0.092 / 0.223 | 2 | ++++ |
| B9 LJW0401 (코드 그대로): 바퀴 T = 0.4×LQR 1행, 고관절 = CyberGear 위치 루프 | 40.0 / 40.0 | 183 (2.0 W) | 0.43 / 45 / 16.1 / 13.3 | 10 | O / 0.06 | 0.102 / 0.087 | 2 | ++−+ |
| B9' LJW0401 MATLAB K를 2×6 전체 상태 피드백으로 (가정; 펌웨어는 이렇게 안 씀) | 40.0 / 40.0 | 73 (0.8 W) | 0.64 / 62 / 0.4 / 16.4 | 5 | O / 0.05 | 0.272 / 0.212 | 2 | +−+− |

*고정 시나리오* (정착시간(1°) / 최종 변위 / 최대 토크 휠·고관절 ; 0.4 W 푸시: 정착 / 최대 속도 / 변위) — (b) 설정

| 제어기 | 10° 다리 기울임 복귀 | 0.4 W × 0.1 s 푸시 |
|---|---|---|
| **내 제어기: LQI6 1 kHz (온라인 리카티, 6상태+속도적분)** | 0.81 s / 0.00 m / 2.2 / 2.9 Nm | 1.40 s / 0.64 m/s / 0.01 m |
| B1 JerryGong0911 RM2024_Reborn(USTB): 6상태 LQR, K(L) 2차 다항식 | 1.07 s / 0.00 m / 8.4 / 8.8 Nm | 1.20 s / 0.63 m/s / 0.00 m |
| B2 Skythinker616: 6상태 dLQR 5 ms, K(L0) 3차 (0.6 kg 로봇용) | 0.87 s / 0.00 m / 7.1 / 0.7 Nm | 2.06 s / 0.69 m/s / 0.00 m |
| B3 HNUST-Dust wbr_control: 10상태/4출력 LQR, K(L) 3차 | 0.35 s / 0.00 m / 2.7 / 8.0 Nm | 2.56 s / 0.75 m/s / 0.00 m |
| B4 QDU-Robomaster Wheelleg: 10상태/4출력 LQR, K(L_l,L_r) 2변수 2차 | 0.69 s / 0.00 m / 7.0 / 3.2 Nm | 1.31 s / 0.67 m/s / 0.02 m |
| B5 Multivac11: 6상태 LQR(다리별), K(L0) 3차 | 0.25 s / 0.02 m / 1.9 / 4.0 Nm | 1.50 s / 0.66 m/s / 0.09 m |
| B6 Zhouzzw: 6상태 LQR(다리별), K(L) 3차, Q=diag(16000,…,70000,…) | 0.25 s / 0.04 m / 5.0 / 17.4 Nm | 2.61 s / 0.52 m/s / 0.20 m |
| B8 lyz1202dt ATWheelLeg: 6상태 LQR 500 Hz, 17점 게인 표 | 2.57 s / 0.22 m / 2.7 / 2.8 Nm | 2.24 s / 0.50 m/s / 0.23 m |
| B9 LJW0401 (코드 그대로): 바퀴 T = 0.4×LQR 1행, 고관절 = CyberGear 위치 루프 | 0.74 s / 0.10 m / 2.8 / 3.6 Nm | 0.98 s / 0.66 m/s / 0.20 m |
| B9' LJW0401 MATLAB K를 2×6 전체 상태 피드백으로 (가정; 펌웨어는 이렇게 안 씀) | 0.94 s / 0.00 m / 7.0 / 1.7 Nm | 2.09 s / 0.66 m/s / 0.00 m |

**5 kg급 5절링크 가정 (몸체 3.0 kg, 다리 0.6 kg, 바퀴 1.3 kg, r 65 mm, L0 0.16 m, 휠 5 Nm, 고관절 12 Nm)** — 로봇 무게 W = 48 N, 속도 스텝 0.8 m/s

*(a) 공개된 게인 그대로 (출력 스케일 1, 센서·모터 부호만 탐색)*

| 제어기 | 최대 복귀 틸트 다리/몸체 [°] | 최대 푸시 [N·0.1 s] | 속도 스텝: 상승 s / 오버슈트 % / 몸체 ° / 다리 ° | 지연 허용 [ms] | 다리 1.4× 변화: 안정 / 몸체 ° | 정지 토크 RMS 휠/고관절 [Nm] | 스케일 | 부호 θφ/T·Tp |
|---|---|---|---|---|---|---|---|---|
| **내 제어기: LQI6 1 kHz (온라인 리카티, 6상태+속도적분)** | 40.0 / 40.0 | 53 (1.1 W) | 1.14 / 21 / 0.2 / 11.0 | 20 | O / 0.03 | 0.037 / 0.044 | 1 | ++++ |
| B1 JerryGong0911 RM2024_Reborn(USTB): 6상태 LQR, K(L) 2차 다항식 | 균형 불가 | | | | | | | |
| B2 Skythinker616: 6상태 dLQR 5 ms, K(L0) 3차 (0.6 kg 로봇용) | 균형 불가 | | | | | | | |
| B3 HNUST-Dust wbr_control: 10상태/4출력 LQR, K(L) 3차 | 40.0 / 40.0 | 29 (0.6 W) | 1.59 / 69 / 3.9 / 13.2 | 5 | O / 0.07 | 0.059 / 0.483 | 1 | ++++ |
| B4 QDU-Robomaster Wheelleg: 10상태/4출력 LQR, K(L_l,L_r) 2변수 2차 | 40.0 / 40.0 | 58 (1.2 W) | 1.13 / 65 / 1.4 / 12.6 | 0 | O / 0.02 | 0.213 / 0.232 | 1 | +++− |
| B5 Multivac11: 6상태 LQR(다리별), K(L0) 3차 | 40.0 / 40.0 | 34 (0.7 W) | 1.68 / 46 / 2.2 / 9.6 | 10 | O / 0.05 | 0.085 / 0.208 | 1 | −−++ |
| B6 Zhouzzw: 6상태 LQR(다리별), K(L) 3차, Q=diag(16000,…,70000,…) | 균형 불가 | | | | | | | |
| B8 lyz1202dt ATWheelLeg: 6상태 LQR 500 Hz, 17점 게인 표 | 15.0 / 40.0 | 19 (0.4 W) | 2.00 / 5 / 1.1 / 5.6 | 0 | O / 0.03 | 0.047 / 0.114 | 1 | ++++ |
| B9 LJW0401 (코드 그대로): 바퀴 T = 0.4×LQR 1행, 고관절 = CyberGear 위치 루프 | 40.0 / 40.0 | 96 (2.0 W) | 0.87 / 32 / 13.3 / 12.4 | 5 | O / 0.04 | 0.040 / 0.087 | 1 | ++−+ |
| B9' LJW0401 MATLAB K를 2×6 전체 상태 피드백으로 (가정; 펌웨어는 이렇게 안 씀) | 40.0 / 40.0 | 24 (0.5 W) | 0.68 / 38 / 0.3 / 17.7 | 5 | O / 0.05 | 0.107 / 0.103 | 1 | ++++ |

*(b) 출력 스케일까지 탐색 (이 로봇에 맞게 게인 크기 재조정)*

| 제어기 | 최대 복귀 틸트 다리/몸체 [°] | 최대 푸시 [N·0.1 s] | 속도 스텝: 상승 s / 오버슈트 % / 몸체 ° / 다리 ° | 지연 허용 [ms] | 다리 1.4× 변화: 안정 / 몸체 ° | 정지 토크 RMS 휠/고관절 [Nm] | 스케일 | 부호 θφ/T·Tp |
|---|---|---|---|---|---|---|---|---|
| B1 JerryGong0911 RM2024_Reborn(USTB): 6상태 LQR, K(L) 2차 다항식 | 40.0 / 40.0 | 34 (0.7 W) | 0.85 / 39 / 1.6 / 13.8 | 0 | O / 0.02 | 0.146 / 0.256 | 0.5 | ++++ |
| B2 Skythinker616: 6상태 dLQR 5 ms, K(L0) 3차 (0.6 kg 로봇용) | 40.0 / 40.0 | 34 (0.7 W) | 0.78 / 54 / 0.4 / 16.7 | 5 | O / 0.17 | 0.079 / 0.117 | 16 | ++++ |
| B3 HNUST-Dust wbr_control: 10상태/4출력 LQR, K(L) 3차 | 40.0 / 40.0 | 29 (0.6 W) | 1.59 / 69 / 3.9 / 13.2 | 5 | O / 0.07 | 0.059 / 0.483 | 1 | ++++ |
| B4 QDU-Robomaster Wheelleg: 10상태/4출력 LQR, K(L_l,L_r) 2변수 2차 | 40.0 / 40.0 | 58 (1.2 W) | 1.13 / 65 / 1.4 / 12.6 | 0 | O / 0.02 | 0.213 / 0.232 | 1 | +++− |
| B5 Multivac11: 6상태 LQR(다리별), K(L0) 3차 | 40.0 / 40.0 | 48 (1.0 W) | 1.28 / 35 / 3.8 / 13.3 | 20 | O / 0.05 | 0.021 / 0.050 | 0.25 | −−++ |
| B6 Zhouzzw: 6상태 LQR(다리별), K(L) 3차, Q=diag(16000,…,70000,…) | 40.0 / 40.0 | 19 (0.4 W) | 2.50 / -5 / 0.9 / 4.8 | 0 | O / 0.04 | 0.053 / 0.389 | 0.25 | ++++ |
| B8 lyz1202dt ATWheelLeg: 6상태 LQR 500 Hz, 17점 게인 표 | 15.0 / 40.0 | 19 (0.4 W) | 2.00 / 5 / 1.1 / 5.6 | 0 | O / 0.03 | 0.047 / 0.114 | 1 | ++++ |
| B9 LJW0401 (코드 그대로): 바퀴 T = 0.4×LQR 1행, 고관절 = CyberGear 위치 루프 | 40.0 / 40.0 | 96 (2.0 W) | 0.87 / 32 / 13.3 / 12.4 | 5 | O / 0.04 | 0.040 / 0.087 | 1 | ++−+ |
| B9' LJW0401 MATLAB K를 2×6 전체 상태 피드백으로 (가정; 펌웨어는 이렇게 안 씀) | 40.0 / 40.0 | 24 (0.5 W) | 0.68 / 38 / 0.3 / 17.7 | 5 | O / 0.05 | 0.107 / 0.103 | 1 | ++++ |

*고정 시나리오* (정착시간(1°) / 최종 변위 / 최대 토크 휠·고관절 ; 0.4 W 푸시: 정착 / 최대 속도 / 변위) — (b) 설정

| 제어기 | 10° 다리 기울임 복귀 | 0.4 W × 0.1 s 푸시 |
|---|---|---|
| **내 제어기: LQI6 1 kHz (온라인 리카티, 6상태+속도적분)** | 0.76 s / 0.00 m / 1.5 / 0.7 Nm | 1.41 s / 0.66 m/s / 0.01 m |
| B1 JerryGong0911 RM2024_Reborn(USTB): 6상태 LQR, K(L) 2차 다항식 | 1.22 s / 0.00 m / 3.8 / 5.2 Nm | 2.30 s / 0.61 m/s / 0.00 m |
| B2 Skythinker616: 6상태 dLQR 5 ms, K(L0) 3차 (0.6 kg 로봇용) | 1.00 s / 0.00 m / 3.5 / 0.4 Nm | 2.47 s / 0.65 m/s / 0.00 m |
| B3 HNUST-Dust wbr_control: 10상태/4출력 LQR, K(L) 3차 | 0.33 s / 0.00 m / 2.5 / 9.2 Nm | 3.19 s / 0.66 m/s / 0.01 m |
| B4 QDU-Robomaster Wheelleg: 10상태/4출력 LQR, K(L_l,L_r) 2변수 2차 | 0.69 s / 0.00 m / 6.4 / 3.6 Nm | 1.44 s / 0.64 m/s / 0.02 m |
| B5 Multivac11: 6상태 LQR(다리별), K(L0) 3차 | 0.50 s / 0.01 m / 0.8 / 1.9 Nm | 1.60 s / 0.71 m/s / 0.10 m |
| B6 Zhouzzw: 6상태 LQR(다리별), K(L) 3차, Q=diag(16000,…,70000,…) | 0.26 s / 0.05 m / 2.2 / 11.2 Nm | 2.83 s / 0.55 m/s / 0.23 m |
| B8 lyz1202dt ATWheelLeg: 6상태 LQR 500 Hz, 17점 게인 표 | 2.72 s / 0.24 m / 1.3 / 1.4 Nm | 2.56 s / 0.53 m/s / 0.32 m |
| B9 LJW0401 (코드 그대로): 바퀴 T = 0.4×LQR 1행, 고관절 = CyberGear 위치 루프 | 0.85 s / 0.10 m / 1.2 / 3.6 Nm | 1.20 s / 0.67 m/s / 0.28 m |
| B9' LJW0401 MATLAB K를 2×6 전체 상태 피드백으로 (가정; 펌웨어는 이렇게 안 씀) | 1.03 s / 0.00 m / 2.9 / 0.7 Nm | 2.28 s / 0.63 m/s / 0.00 m |

**10 kg급 5절링크 가정 (몸체 6.5 kg, 다리 1.2 kg, 바퀴 1.3 kg, r 82.5 mm, L0 0.25 m, 휠 5 Nm, 고관절 24 Nm)** — 로봇 무게 W = 88 N, 속도 스텝 0.8 m/s

*(a) 공개된 게인 그대로 (출력 스케일 1, 센서·모터 부호만 탐색)*

| 제어기 | 최대 복귀 틸트 다리/몸체 [°] | 최대 푸시 [N·0.1 s] | 속도 스텝: 상승 s / 오버슈트 % / 몸체 ° / 다리 ° | 지연 허용 [ms] | 다리 1.4× 변화: 안정 / 몸체 ° | 정지 토크 RMS 휠/고관절 [Nm] | 스케일 | 부호 θφ/T·Tp |
|---|---|---|---|---|---|---|---|---|
| **내 제어기: LQI6 1 kHz (온라인 리카티, 6상태+속도적분)** | 40.0 / 40.0 | 97 (1.1 W) | 1.22 / 24 / 0.4 / 9.0 | 30 | O / 0.03 | 0.051 / 0.101 | 1 | ++++ |
| B1 JerryGong0911 RM2024_Reborn(USTB): 6상태 LQR, K(L) 2차 다항식 | 40.0 / 40.0 | 79 (0.9 W) | 0.76 / 61 / 1.0 / 13.1 | 5 | O / 0.02 | 0.341 / 0.420 | 1 | ++++ |
| B2 Skythinker616: 6상태 dLQR 5 ms, K(L0) 3차 (0.6 kg 로봇용) | 균형 불가 | | | | | | | |
| B3 HNUST-Dust wbr_control: 10상태/4출력 LQR, K(L) 3차 | 40.0 / 40.0 | 79 (0.9 W) | 1.10 / 96 / 4.5 / 19.2 | 20 | O / 0.09 | 0.071 / 0.508 | 1 | ++++ |
| B4 QDU-Robomaster Wheelleg: 10상태/4출력 LQR, K(L_l,L_r) 2변수 2차 | 40.0 / 40.0 | 115 (1.3 W) | 1.03 / 64 / 0.5 / 11.7 | 10 | O / 0.02 | 0.217 / 0.196 | 1 | +++− |
| B5 Multivac11: 6상태 LQR(다리별), K(L0) 3차 | 40.0 / 40.0 | 79 (0.9 W) | 1.73 / 41 / 1.8 / 7.5 | 15 | O / 0.04 | 0.098 / 0.221 | 1 | −−++ |
| B6 Zhouzzw: 6상태 LQR(다리별), K(L) 3차, Q=diag(16000,…,70000,…) | 7.5 / 37.5 | 9 (0.1 W) | 실패 | 0 | O / 0.16 | 3.325 / 38.487 | 1 | ++++ |
| B8 lyz1202dt ATWheelLeg: 6상태 LQR 500 Hz, 17점 게인 표 | 7.5 / 40.0 | 26 (0.3 W) | 1.25 / 31 / 1.5 / 8.6 | 15 | O / 0.03 | 0.043 / 0.111 | 1 | ++++ |
| B9 LJW0401 (코드 그대로): 바퀴 T = 0.4×LQR 1행, 고관절 = CyberGear 위치 루프 | 40.0 / 40.0 | 97 (1.1 W) | 0.50 / 58 / 17.7 / 14.6 | 5 | O / 0.13 | 0.063 / 0.095 | 1 | +−−− |
| B9' LJW0401 MATLAB K를 2×6 전체 상태 피드백으로 (가정; 펌웨어는 이렇게 안 씀) | 40.0 / 40.0 | 44 (0.5 W) | 0.51 / 55 / 0.5 / 18.1 | 15 | O / 0.04 | 0.150 / 0.104 | 1 | ++++ |

*(b) 출력 스케일까지 탐색 (이 로봇에 맞게 게인 크기 재조정)*

| 제어기 | 최대 복귀 틸트 다리/몸체 [°] | 최대 푸시 [N·0.1 s] | 속도 스텝: 상승 s / 오버슈트 % / 몸체 ° / 다리 ° | 지연 허용 [ms] | 다리 1.4× 변화: 안정 / 몸체 ° | 정지 토크 RMS 휠/고관절 [Nm] | 스케일 | 부호 θφ/T·Tp |
|---|---|---|---|---|---|---|---|---|
| B1 JerryGong0911 RM2024_Reborn(USTB): 6상태 LQR, K(L) 2차 다항식 | 40.0 / 40.0 | 88 (1.0 W) | 0.63 / 49 / 1.4 / 14.3 | 10 | O / 0.02 | 0.162 / 0.185 | 0.5 | ++++ |
| B2 Skythinker616: 6상태 dLQR 5 ms, K(L0) 3차 (0.6 kg 로봇용) | 40.0 / 40.0 | 79 (0.9 W) | 0.56 / 92 / 0.6 / 17.6 | 10 | O / 0.18 | 0.128 / 0.229 | 32 | ++++ |
| B3 HNUST-Dust wbr_control: 10상태/4출력 LQR, K(L) 3차 | 40.0 / 40.0 | 79 (0.9 W) | 1.10 / 96 / 4.5 / 19.2 | 20 | O / 0.09 | 0.071 / 0.508 | 1 | ++++ |
| B4 QDU-Robomaster Wheelleg: 10상태/4출력 LQR, K(L_l,L_r) 2변수 2차 | 40.0 / 40.0 | 115 (1.3 W) | 1.03 / 64 / 0.5 / 11.7 | 10 | O / 0.02 | 0.217 / 0.196 | 1 | +++− |
| B5 Multivac11: 6상태 LQR(다리별), K(L0) 3차 | 40.0 / 40.0 | 97 (1.1 W) | 1.36 / 39 / 2.4 / 9.6 | 30 | O / 0.04 | 0.049 / 0.110 | 0.5 | −−++ |
| B6 Zhouzzw: 6상태 LQR(다리별), K(L) 3차, Q=diag(16000,…,70000,…) | 40.0 / 40.0 | 44 (0.5 W) | 2.50 / 1 / 0.7 / 4.3 | 0 | O / 0.04 | 0.106 / 0.596 | 0.5 | ++++ |
| B8 lyz1202dt ATWheelLeg: 6상태 LQR 500 Hz, 17점 게인 표 | 15.0 / 40.0 | 35 (0.4 W) | 1.72 / 12 / 0.9 / 5.6 | 5 | O / 0.03 | 0.088 / 0.231 | 2 | ++++ |
| B9 LJW0401 (코드 그대로): 바퀴 T = 0.4×LQR 1행, 고관절 = CyberGear 위치 루프 | 40.0 / 40.0 | 97 (1.1 W) | 0.50 / 58 / 17.7 / 14.6 | 5 | O / 0.13 | 0.063 / 0.095 | 1 | +−−− |
| B9' LJW0401 MATLAB K를 2×6 전체 상태 피드백으로 (가정; 펌웨어는 이렇게 안 씀) | 40.0 / 40.0 | 71 (0.8 W) | 0.61 / 63 / 0.4 / 16.0 | 5 | O / 0.04 | 0.312 / 0.210 | 2 | ++++ |

*고정 시나리오* (정착시간(1°) / 최종 변위 / 최대 토크 휠·고관절 ; 0.4 W 푸시: 정착 / 최대 속도 / 변위) — (b) 설정

| 제어기 | 10° 다리 기울임 복귀 | 0.4 W × 0.1 s 푸시 |
|---|---|---|
| **내 제어기: LQI6 1 kHz (온라인 리카티, 6상태+속도적분)** | 0.92 s / 0.00 m / 2.4 / 2.6 Nm | 1.48 s / 0.65 m/s / 0.02 m |
| B1 JerryGong0911 RM2024_Reborn(USTB): 6상태 LQR, K(L) 2차 다항식 | 1.02 s / 0.00 m / 4.6 / 3.1 Nm | 1.10 s / 0.66 m/s / 0.00 m |
| B2 Skythinker616: 6상태 dLQR 5 ms, K(L0) 3차 (0.6 kg 로봇용) | 0.77 s / 0.00 m / 7.1 / 0.7 Nm | 1.77 s / 0.76 m/s / 0.00 m |
| B3 HNUST-Dust wbr_control: 10상태/4출력 LQR, K(L) 3차 | 0.31 s / 0.00 m / 2.9 / 6.6 Nm | 2.25 s / 0.85 m/s / 0.00 m |
| B4 QDU-Robomaster Wheelleg: 10상태/4출력 LQR, K(L_l,L_r) 2변수 2차 | 0.74 s / 0.00 m / 7.6 / 2.9 Nm | 1.32 s / 0.69 m/s / 0.02 m |
| B5 Multivac11: 6상태 LQR(다리별), K(L0) 3차 | 0.70 s / 0.03 m / 2.2 / 4.0 Nm | 1.56 s / 0.67 m/s / 0.10 m |
| B6 Zhouzzw: 6상태 LQR(다리별), K(L) 3차, Q=diag(16000,…,70000,…) | 0.24 s / 0.04 m / 5.4 / 14.9 Nm | 2.55 s / 0.54 m/s / 0.19 m |
| B8 lyz1202dt ATWheelLeg: 6상태 LQR 500 Hz, 17점 게인 표 | 2.54 s / 0.22 m / 3.0 / 2.7 Nm | 2.22 s / 0.51 m/s / 0.23 m |
| B9 LJW0401 (코드 그대로): 바퀴 T = 0.4×LQR 1행, 고관절 = CyberGear 위치 루프 | 1.24 s / 0.13 m / 2.3 / 4.2 Nm | 1.28 s / 0.82 m/s / 0.22 m |
| B9' LJW0401 MATLAB K를 2×6 전체 상태 피드백으로 (가정; 펌웨어는 이렇게 안 씀) | 0.94 s / 0.00 m / 8.0 / 1.4 Nm | 2.03 s / 0.68 m/s / 0.00 m |

15 kg Webots 플랜트와 Skythinker 0.6 kg 플랜트의 전체 표는 `sim6/results6_tables.md`에 있다. 요점: 15 kg 플랜트에서 Zhouzzw는 균형 판정은 통과하지만 정지 토크 RMS가 휠 14 Nm·고관절 65 Nm — 토크 한계(10/40 Nm ×2)에서 뱅뱅으로 떠는 상태다. Sky 플랜트에서는 Skythinker 자신의 게인이 그대로 균형(40°/40°, 0.5 W, 정지 토크 0.005/0.013 Nm)을 잡아 이식이 맞음을 확인했고, 내 LQI6는 같은 플랜트에서 1.0 W·지연 15 ms였다.

그림: `figures/sil6_responses_rm.png`, `figures/sil6_responses_small.png`, `figures/sil6_responses_large.png` — 다리 10° 복귀와 0.4 W 푸시에 대한 다리각·몸체 피치·속도·고관절 토크 응답. 노란 선(LJW 코드 그대로)만 몸체 피치가 2–9° 흔들리고(고관절이 위치 루프라 몸체가 다리와 함께 진자가 된다), 다른 선들의 고관절 토크는 노이즈 폭 ±1–2 Nm 안에 머문다.

1 ms 간격으로 다시 잰 지연 허용(RM급, 3° 다리 기울임, 무노이즈, (b) 설정): **내 LQI6 26 ms**, Multivac(×0.5) 30 ms, HNUST 17 ms, LJW(×2) 13 ms, QDU 8 ms, Skythinker(×32) 6 ms, ATWheelLeg(×2) 4 ms, **USTB 3 ms**, Zhouzzw(×0.5) 3 ms.

#### 8.4.1 upkie 제어기(U1·U3)를 6-모터 플랜트에서 — upkie 추정 모델, 내 LQI6와 비교

§6은 다리 상태가 없는 4-모터 하네스였다. 여기서는 upkie의 구조(다리 = 위치 서보, 바퀴 = 속도 모드)를 3체 플랜트에 그대로 옮겨 upkie 추정 모델(5.4 kg, W = 53 N)에서 같은 배터리를 돌렸다(`results6_upkie.json`, 전체 표는 `sim6/results6_tables.md` 마지막 절). 사용자 요청으로 이 플랜트만 돌렸다(RM급·5 kg·10 kg 플랜트에는 넣지 않았다).

| 제어기 (공개 게인 그대로) | 복귀 틸트 다리/몸체 | 100 ms 푸시 (3 s 판정) | 0.8 m/s 스텝: 상승 / 오버슈트 / 몸체 | 지연 허용 | 정지 토크 RMS 휠/고관절 | 10° 복귀: 정착 / 변위 | 0.4 W 푸시(21 N): 정착 / 변위 |
|---|---|---|---|---|---|---|---|
| **내 LQI6** | 35° / 40° | **42 N (0.8 W)** | 1.28 s / 30 % / 0.7° | 30 ms | 0.020 / 0.067 Nm | 1.17 s / 0.01 m | 1.67 s / 0.03 m |
| U1 WheelBalancer (바퀴 루프 kd 1.0) | 20° / 25° | 5 N (0.1 W) | 0.36 s / **107 %** / **17.8°** | 40 ms | 0.234 / 0.024 | 1.04 s / 0.05 m | 실패(3 s 안에 정착 못 함) |
| U1 WheelBalancer, 무른 바퀴 루프 kd 0.2 | 10° / 17.5° | 5 N (0.1 W) | 0.36 s / 137 % / 19.8° | 20 ms | 0.043 / 0.008 | 1.22 s / 0.04 m | 실패 |
| U3 MPCBalancer (실제 코드) | 22.5° / 22.5° | 21 N (0.4 W) | 0.77 s / 33 % / 9.0° | **80 ms** | **0.009 / 0.005** | 1.78 s / 0.11 m | 2.34 s / 0.48 m |

푸시 열의 U1 "5 N"은 넘어진 것이 아니다. 3 s 창(마지막 1 s |기울기| < 3°, |v| < 0.3 m/s) 판정이 WheelBalancer의 느린 복귀를 실패로 세기 때문이다. 창을 8 s로 늘려 **넘어지지 않는 한계**와 정착 시간(1°·0.1 m/s)을 따로 재면:

| | 넘어지지 않는 푸시 한계 | 정착 시간 0.2 W / 0.4 W / 0.6 W / 0.8 W 푸시 |
|---|---|---|
| **내 LQI6** | **≥ 106 N (2.0 W, 탐색 상한)** | 1.4 / 3.2 / 3.8 / 4.1 s |
| U1 WheelBalancer | 37 N (0.7 W) | 6.8 / 7.5 / 7.5 / — s |
| U1 무른 루프 | 32 N (0.6 W) | 6.4 / 7.5 / 7.5 / — s |
| U3 MPC | 42 N (0.8 W) | 1.7 / 2.3 / 3.1 / 4.6 s |

그림 `figures/sil6_responses_upkie.png`: 10° 다리 기울임에서 U1(주황)은 3.5 Hz로 10회 이상 진동하며 고관절 토크 ±5 Nm를 흔들고(바퀴 속도 루프가 위치 서보로 붙은 다리·몸체 진자를 때리는 모양), 21 N 푸시 뒤에는 몸체를 2.5° 기울인 채 −0.4 m/s로 2 s 이상 뒤로 굴러간다 — 위치 적분항이 x_target으로 되돌리는 과정으로, "비최소위상 트릭"이 외란 복구에서는 느린 꼬리가 된다. U3(초록)는 매끄럽지만 몸체 8°·다리 8°까지 크게 기울었다 돌아오고 0.48 m 밀린다. 내 LQI6(파랑)는 0.03 m 안에서 선다.

**해석**: §6.4의 결론이 3체 플랜트에서도 그대로다. (1) upkie의 법칙은 다리각 θ를 보지 않고 몸체 피치 φ와 바퀴 오도메트리만 쓰므로, 다리 서보 강성과 무관하게 바퀴 법칙 하나가 성능을 정한다(강성 20→200 Nm/rad에서 한계 불변). (2) 속도 모드 구조라 측정 노이즈가 바퀴 토크로 그대로 나가고(U1 0.23 Nm RMS, 내 LQI6 0.02), 바퀴 루프를 무르게 하면 조용해지는 대신 틸트 한계가 반으로 준다. (3) MPC는 지연 80 ms·정지 토크 0.009 Nm로 가장 둔감하고 조용하지만 외란에 0.5 m 밀린다. (4) 내 LQI6는 같은 플랜트에서 부호·스케일 조정 없이 푸시 2.5–20배, 속도 스텝 몸체 기울기 1/10, 변위 1/10이다. upkie에서 가져올 것은 §6.4 그대로 소프트웨어 구조이지 균형 법칙이 아니다.

### 8.5 해석

1. **같은 법칙, 다른 로봇.** 9개 HEU 계열은 구조가 동일하므로 성능 차이는 전부 Q/R(게인 크기)에서 온다. 공개 게인은 자기 로봇 질량 근방에서만 그대로 쓸 수 있다: RM급(7 kg) 게인은 우리 10 kg급에 거의 그대로 통하고, 5 kg급에서는 USTB가 0.5배를 요구하며, 0.6 kg 탁상 로봇에는 어떤 것도 못 쓴다(반대로 Skythinker 게인은 RM급에 32배). "게인 복사"는 같은 급 로봇 사이에서만 의미가 있고, 그마저 아래 2번 때문에 위험하다.
2. **공개 게인은 빠르지만 지연에 약하다.** USTB·Zhouzzw·ATWheelLeg는 3–4 ms, QDU 8 ms에서 넘어진다. 토크 가중치 R이 싸서(USTB R=diag(1, 0.25) vs Q 최대 2000) θ̇·φ̇ 게인이 크기 때문이고, 같은 이유로 정지 상태에서 자이로 노이즈를 토크로 그대로 내보낸다(USTB 휠 0.34·고관절 0.48 Nm RMS; 내 LQI6 0.04–0.07 / 0.04–0.14 Nm). RoboMaster 로봇은 IMU와 CAN이 1 kHz로 같은 보드에 붙어 있고 1–2 ms 안에 닫히므로 그들에게는 문제가 아니지만, Teensy + CAN + 필터를 거치는 우리 구조(§2의 2–5 ms)에서는 USTB 게인은 여유가 0이다. 6-모터 플랜트는 불안정 모드가 둘(13.7, 4.1 rad/s)이라 4-모터보다 이 절충이 가파르다 — 내 첫 설계도 같은 함정에 빠졌었다(§8.3 표).
3. **푸시·틸트 한계는 변별력이 낮다.** 스케일을 맞춘 LQR 계열은 전부 40°/40°를 복귀하고 0.7–1.4 W 푸시를 견딘다(2배 안). 오히려 "가장 큰 푸시" 1위인 LJW(2.0 W)는 §5.3과 같은 함정 — 변위 0.2–0.3 m를 굴러가고 몸체가 13–22° 흔들리면서 버틴 것이다. 고관절이 위치 루프라 다리가 몸체에 붙어 하나의 진자가 되므로 몸체 피치를 따로 세울 수 없다. 반면 USTB·QDU·HNUST·내 LQI6는 변위 0.00–0.02 m, 몸체 0.3–1.4°로 제자리에서 버틴다.
4. **각 프로젝트의 특징.** HNUST는 10° 복귀 0.3 s로 가장 빠르지만 속도 스텝 오버슈트 90–100 %, 고관절 정지 토크 0.5 Nm(φ 게인 113). QDU는 가장 큰 푸시(1.3–1.4 W)지만 지연 0–10 ms·정지 토크 0.2 Nm. Multivac은 공개 게인 중 가장 보수적인 R(280, 17) 덕에 그대로도 15 ms·0.9–1.1 W이고 0.5배로 줄이면 30 ms·0.05/0.11 Nm로 내 LQI6와 같은 급이 된다. Zhouzzw는 Q가 USTB의 10–35배라 내 플랜트 토크 한계에서 뱅뱅이 되며(관절 80 Nm 한계로 보아 훨씬 강한 액추에이터용), 0.25–0.5배에서만 균형·지연 3 ms. ATWheelLeg는 게인이 USTB의 1/5로 무른 쪽이어서 다리 7.5–15°에서 한계가 오고 0.2 m를 굴러간다.
5. **내 LQI6.** 그들의 로봇(RM급)에서 푸시 1.2 W(QDU 1.4 다음), **지연 26 ms(1위)**, 정지 토크 최저, 속도 스텝 오버슈트 23 %·몸체 0.3°(최저), 변위 0, 다리 1.4배 변화 0.03°. 5 kg급·10 kg급·15 kg Webots·Sky 플랜트 전부에서 스케일·부호 조정 없이 같은 그림이다. 이유는 두 가지다 — 플랜트에서 리카티를 직접 풀어 게인을 만들고(다항식 피팅·다른 로봇 게인 복사 없음), R을 모터 토크 한계에 비례시켜 어느 크기의 로봇에서도 같은 절충이 유지되게 했다(절대값 R로 두었을 때는 0.6 kg 로봇에서 뱅뱅이 났다 — §8.3).
6. **6-모터와 4-모터의 관계.** θ 상태와 Tp 출력을 지우면 이 법칙은 §3의 4-모터 LQI와 같은 식이 된다. LJW가 실제로 그렇게 운전한다(고관절 위치 고정 + 바퀴 LQR 1행 × 0.4) — 균형은 잡히지만 몸체 흔들림이 10배 커진다. 5절 링크를 달아도 처음 세우는 단계에서는 이 방식이 가장 단순하고, 그다음 Tp 행을 켜는 순서가 합리적이다.
7. **upkie(직렬 2관절, 속도 모드)는 HEU 계열과 다른 구조지만 결론은 같다**(§8.4.1): 다리를 위치 서보로 몸체에 고정하고 바퀴만 속도 PI/MPC로 세우는 방식은 LJW(코드 그대로)와 같은 "하나의 진자" 운전이라 몸체 피치를 따로 세우지 못하고(속도 스텝 18°), 외란 뒤 복귀가 7 s로 느리다. 정지 토크가 가장 조용한 것은 MPC의 가속도 한계 덕이지 구조 덕이 아니다.

### 8.6 결론

- **6-모터 프로젝트에서 "제어기"를 가져올 이유는 없다.** 전부 HEU 3체 모델의 LQR이고, 내 LQI6가 같은 모델에서 더 넓은 지연 여유와 더 낮은 노이즈 토크로 같은 외란 한계를 낸다. 공개 게인은 로봇 질량에 묶여 있고 지연 여유가 3–8 ms라 Teensy+CAN 구조에서 그대로 쓸 수 없다.
- **가져올 것**: USTB의 **모델·파라미터 문서화와 VMC 코드**(5절 링크 야코비안으로 (F, Tp)→관절 토크, 다리 길이 PD) — 플랜트 검증에 쓴 바로 그 식이다; Skythinker의 **다항식 게인 스케줄링**(리카티를 MCU에서 못 풀 때의 대안); ATWheelLeg의 **공중 게인**(바퀴 이탈 시 다리만 세움); LJW의 **점프·착지 상태기계와 지면 접촉 검출**; HNUST·QDU의 **요·롤을 포함한 10상태 통합**(좌우 다리 길이가 다를 때); Multivac의 **보수적 R** 선택.
- **가져오지 말 것**: 게인 값 자체, Zhouzzw의 Q(토크 한계에서 뱅뱅).
- **우리 로봇(4-모터)에 대한 결론은 §5.4 그대로다**: 내 LQI(1 kHz, 온라인 리카티, **R은 토크 한계 비례**)를 쓴다. 뒤에 5절 링크로 바꾸면 `sim6/controllers6.py`의 `MineLQI6`(다리 길이 스케줄링 포함)가 USTB 모델에서 검증된 상태로 준비돼 있다.

### 8.7 이 절의 한계

- Tp를 가상 고관절에 직접 가했다 — 5절 링크 야코비안·관절별 토크 한계·VMC 지지력 루프는 시뮬레이션에 없고 다리 길이는 준정적 파라미터다. 평면 모델이라 롤·요·좌우 다리 비대칭이 없고 HNUST·QDU의 10상태는 좌우를 합쳐 줄였다.
- RM급 플랜트의 토크 한계(휠 6·고관절 30 Nm)와 마찰, 5 kg·10 kg 5절 링크의 다리 질량·관성, Skythinker의 모터 한계, LJW의 CyberGear 위치 루프 강성(kp 5, kd 0.5)은 가정값이다.
- 부호 탐색은 16가지 중 가장 잘 되는 조합을 고른다. 잘못 이식된 법칙이 우연히 맞는 조합으로 통과할 수 있으므로, HEU 부호 패턴(T행 −−−−++, Tp행 ++++++)과 대조해 전부 설명되는지 확인했다(QDU 피치, Multivac 각도, AT·LJW 모터 극성만 반대). 스케일 탐색은 1/16–128배로 제한했다.
- upkie 추정 모델의 질량 배분·관성·다리 길이는 추정값이고(URDF 비공개), 서보 모델은 upkie의 PyBullet 인터페이스 값(kp 20, kd 1.0)이지 실제 moteus 게인이 아니다. 직렬 다리(고관절+무릎)를 가상 다리 하나로 줄였으므로 무릎 강성은 다리 길이 방향으로만 작용한다고 보았다. upkie 제어기는 이 플랜트에서만 돌렸다.
- B1(USTB)·B5(Multivac)의 저장소는 2026-10-20 현재 접근할 수 없다(§1.2). 결과는 조사 당시 받아 둔 소스 기준이며 재현하려면 그 사본이 필요하다.
- chen-jiangnan은 처음 받은 파일에 게인이 없어 빠졌고(전체 저장소에는 있음, §8 서두), 1772631792/WheelLeg_LQR은 4상태라 §5 하네스에서 평가했다(B10: 5 kg급 32.5°·30 N·지연 40 ms, 10 kg급 22.5–30°·60–70 N·40–60 ms — 다리각 피드백이 없어 푸시 한계가 LQR 4개 중 가장 낮다).
