wisehyun-2/my_robot_project/wheeled_biped/v5_mpc/TEST/results/stage_report.md

# 단계별 통과 시험 요약 — MPC

| 단계 | 내용 | 판정 | 시험 수 | 실패 | 오류 | 시간 [s] |
|---|---|---|---|---|---|---|
| 4 | + ∫기울기 | **실패** | 27 | 7 | 0 | 232.3 |

로봇: `robot_cad_v5` (mass_properties.json), 제어 주기 1000 Hz, 센서→토크 지연 10 ms, 센서 노이즈 켬, 시드 [0], 정지 시험 30 s / 외란 정지 30 s.

## 단계 4: MPC + ∫위치 + ∫기울기 — 실패 9건

| 시험 | 시드 | 지표 | 측정 | 기준 | 판정 |
|---|---|---|---|---|---|
| 1-1 정지 30 s (기준 1번) | 0 | pitch_ma_max (20 ms 이동평균 \|피치\|) | 0.352 | <= 1 deg | 통과 |
| 1-1 정지 30 s (기준 1번) | 0 | pitch_rms | 0.187 | <= 0.5 deg | 통과 |
| 1-1 정지 30 s (기준 1번) | 0 | drift_max (max \|x(t) − x(0)\|, t ≥ 2 s) | 0.026 | <= 0.05 m | 통과 |
| 1-1 정지 30 s (기준 1번) | 0 | alive (넘어지지 않음) | 1 | >= 1  | 통과 |
| 1-1 정지 30 s (기준 1번) | 0 | knee_flipped (무릎이 완전 신장 반대쪽으로 넘어가지 않음) | 0 | <= 0  | 통과 |
| 1-1 정지 30 s (기준 1번) | 0 | leg_margin_mm (완전 신장까지 남은 다리 길이) | 38.983 | >= 5 mm | 통과 |
| 1-1 정지 30 s (기준 1번) | 0 | wheel_peak (바퀴 토크 피크 ≤ AKE60 피크의 80 %) | 0.637 | <= 10 N m | 통과 |
| 1-1 정지 30 s (기준 1번) | 0 | leg_peak (hip·무릎 토크 피크 ≤ AKE60 피크의 80 %) | 3.926 | <= 10 N m | 통과 |
| 1-1 정지 30 s (기준 1번) | 0 | leg_rms (hip·무릎 토크 rms ≤ 정격) | 3.482 | <= 5 N m | 통과 |
| 1-1 정지 30 s (기준 1번) | 0 | wheel_rms10 (바퀴 토크 10 s rms ≤ 정격의 50 %) | 0.201 | <= 2.5 N m | 통과 |
| 1-2 초기 기울기 10° 복귀 (기준 2번) | 0 | settled (정착) | 1 | >= 1  | 통과 |
| 1-2 초기 기울기 10° 복귀 (기준 2번) | 0 | settle_s | 1.846 | <= 2 s | 통과 |
| 1-2 초기 기울기 10° 복귀 (기준 2번) | 0 | disp (이동) | 0.150 | <= 0.3 m | 통과 |
| 1-2 초기 기울기 10° 복귀 (기준 2번) | 0 | alive (넘어지지 않음) | 1 | >= 1  | 통과 |
| 1-2 초기 기울기 10° 복귀 (기준 2번) | 0 | knee_flipped (무릎이 완전 신장 반대쪽으로 넘어가지 않음) | 0 | <= 0  | 통과 |
| 1-2 초기 기울기 10° 복귀 (기준 2번) | 0 | leg_margin_mm (완전 신장까지 남은 다리 길이) | 38.465 | >= 5 mm | 통과 |
| 1-2 초기 기울기 10° 복귀 (기준 2번) | 0 | wheel_peak (바퀴 토크 피크 ≤ AKE60 피크의 80 %) | 4.842 | <= 10 N m | 통과 |
| 1-2 초기 기울기 10° 복귀 (기준 2번) | 0 | leg_peak (hip·무릎 토크 피크 ≤ AKE60 피크의 80 %) | 7.658 | <= 10 N m | 통과 |
| 1-2 초기 기울기 10° 복귀 (기준 2번) | 0 | leg_rms (hip·무릎 토크 rms ≤ 정격) | 3.476 | <= 5 N m | 통과 |
| 1-2 초기 기울기 10° 복귀 (기준 2번) | 0 | wheel_rms10 (바퀴 토크 10 s rms ≤ 정격의 50 %) | 0.369 | <= 2.5 N m | 통과 |
| 1-3 밀기 0.5 W, 0.1 s (기준 5번) | 0 | settled (정착) | 1 | >= 1  | 통과 |
| 1-3 밀기 0.5 W, 0.1 s (기준 5번) | 0 | settle_s | 2.112 | <= 3 s | 통과 |
| 1-3 밀기 0.5 W, 0.1 s (기준 5번) | 0 | pitch_peak | 5.792 | <= 8 deg | 통과 |
| 1-3 밀기 0.5 W, 0.1 s (기준 5번) | 0 | disp (이동) | 0.173 | <= 0.5 m | 통과 |
| 1-3 밀기 0.5 W, 0.1 s (기준 5번) | 0 | alive (넘어지지 않음) | 1 | >= 1  | 통과 |
| 1-3 밀기 0.5 W, 0.1 s (기준 5번) | 0 | knee_flipped (무릎이 완전 신장 반대쪽으로 넘어가지 않음) | 0 | <= 0  | 통과 |
| 1-3 밀기 0.5 W, 0.1 s (기준 5번) | 0 | leg_margin_mm (완전 신장까지 남은 다리 길이) | 38.834 | >= 5 mm | 통과 |
| 1-3 밀기 0.5 W, 0.1 s (기준 5번) | 0 | wheel_peak (바퀴 토크 피크 ≤ AKE60 피크의 80 %) | 3.735 | <= 10 N m | 통과 |
| 1-3 밀기 0.5 W, 0.1 s (기준 5번) | 0 | leg_peak (hip·무릎 토크 피크 ≤ AKE60 피크의 80 %) | 9.375 | <= 10 N m | 통과 |
| 1-3 밀기 0.5 W, 0.1 s (기준 5번) | 0 | leg_rms (hip·무릎 토크 rms ≤ 정격) | 3.458 | <= 5 N m | 통과 |
| 1-3 밀기 0.5 W, 0.1 s (기준 5번) | 0 | wheel_rms10 (바퀴 토크 10 s rms ≤ 정격의 50 %) | 0.428 | <= 2.5 N m | 통과 |
| 1-4 속도 스텝 0 → 0.5 m/s → 0 (기준 8번) | 0 | rise_s (90 % 도달) | 0.899 | <= 1.5 s | 통과 |
| 1-4 속도 스텝 0 → 0.5 m/s → 0 (기준 8번) | 0 | overshoot_pct | 9.362 | <= 20 % | 통과 |
| 1-4 속도 스텝 0 → 0.5 m/s → 0 (기준 8번) | 0 | ss_err (2.0~3.0 s 평균) | 0.035 | <= 0.05 m/s | 통과 |
| 1-4 속도 스텝 0 → 0.5 m/s → 0 (기준 8번) | 0 | pitch_peak | 2.030 | <= 5 deg | 통과 |
| 1-4 속도 스텝 0 → 0.5 m/s → 0 (기준 8번) | 0 | stop_disp (정지 명령 뒤 최대 이탈) | 0.214 | <= 0.5 m | 통과 |
| 1-4 속도 스텝 0 → 0.5 m/s → 0 (기준 8번) | 0 | settled (정지 뒤 정착) | 1 | >= 1  | 통과 |
| 1-4 속도 스텝 0 → 0.5 m/s → 0 (기준 8번) | 0 | stop_settle_s (정지 명령 뒤 정착 시간) | 0.997 | <= 3 s | 통과 |
| 1-4 속도 스텝 0 → 0.5 m/s → 0 (기준 8번) | 0 | alive (넘어지지 않음) | 1 | >= 1  | 통과 |
| 1-4 속도 스텝 0 → 0.5 m/s → 0 (기준 8번) | 0 | knee_flipped (무릎이 완전 신장 반대쪽으로 넘어가지 않음) | 0 | <= 0  | 통과 |
| 1-4 속도 스텝 0 → 0.5 m/s → 0 (기준 8번) | 0 | leg_margin_mm (완전 신장까지 남은 다리 길이) | 38.983 | >= 5 mm | 통과 |
| 1-4 속도 스텝 0 → 0.5 m/s → 0 (기준 8번) | 0 | wheel_peak (바퀴 토크 피크 ≤ AKE60 피크의 80 %) | 1.867 | <= 10 N m | 통과 |
| 1-4 속도 스텝 0 → 0.5 m/s → 0 (기준 8번) | 0 | leg_peak (hip·무릎 토크 피크 ≤ AKE60 피크의 80 %) | 4.483 | <= 10 N m | 통과 |
| 1-4 속도 스텝 0 → 0.5 m/s → 0 (기준 8번) | 0 | leg_rms (hip·무릎 토크 rms ≤ 정격) | 3.499 | <= 5 N m | 통과 |
| 1-4 속도 스텝 0 → 0.5 m/s → 0 (기준 8번) | 0 | wheel_rms10 (바퀴 토크 10 s rms ≤ 정격의 50 %) | 0.359 | <= 2.5 N m | 통과 |
| 2-10 한쪽 짐: 왼쪽 15 cm에 20 N | 0 | roll_end_deg (마지막 1 s 평균) | 0.018 | <= 0.1 deg | 통과 |
| 2-10 한쪽 짐: 왼쪽 15 cm에 20 N | 0 | roll_peak_deg | 0.619 | <= 1 deg | 통과 |
| 2-10 한쪽 짐: 왼쪽 15 cm에 20 N | 0 | alive (넘어지지 않음) | 1 | >= 1  | 통과 |
| 2-10 한쪽 짐: 왼쪽 15 cm에 20 N | 0 | knee_flipped (무릎이 완전 신장 반대쪽으로 넘어가지 않음) | 0 | <= 0  | 통과 |
| 2-10 한쪽 짐: 왼쪽 15 cm에 20 N | 0 | leg_margin_mm (완전 신장까지 남은 다리 길이) | 38.983 | >= 5 mm | 통과 |
| 2-10 한쪽 짐: 왼쪽 15 cm에 20 N | 0 | wheel_peak (바퀴 토크 피크 ≤ AKE60 피크의 80 %) | 0.668 | <= 10 N m | 통과 |
| 2-10 한쪽 짐: 왼쪽 15 cm에 20 N | 0 | leg_peak (hip·무릎 토크 피크 ≤ AKE60 피크의 80 %) | 5.939 | <= 10 N m | 통과 |
| 2-10 한쪽 짐: 왼쪽 15 cm에 20 N | 0 | leg_rms (hip·무릎 토크 rms ≤ 정격) | 5.263 | <= 5 N m | **실패** |
| 2-10 한쪽 짐: 왼쪽 15 cm에 20 N | 0 | wheel_rms10 (바퀴 토크 10 s rms ≤ 정격의 50 %) | 0.195 | <= 2.5 N m | 통과 |
| 2-11 방향: 왼쪽 바퀴만 날카로운 턱 2 cm, 0.3 m/s | 0 | heading_peak_deg (방향 틀어짐 최대) | 3.708 | <= 6 deg | 통과 |
| 2-11 방향: 왼쪽 바퀴만 날카로운 턱 2 cm, 0.3 m/s | 0 | heading_end_deg (정지 3 s 뒤 방향) | 1.045 | <= 2 deg | 통과 |
| 2-11 방향: 왼쪽 바퀴만 날카로운 턱 2 cm, 0.3 m/s | 0 | y_end_cm (옆 이동) | 4.748 | <= 15 cm | 통과 |
| 2-11 방향: 왼쪽 바퀴만 날카로운 턱 2 cm, 0.3 m/s | 0 | roll_peak_deg | 0.470 | <= 1 deg | 통과 |
| 2-11 방향: 왼쪽 바퀴만 날카로운 턱 2 cm, 0.3 m/s | 0 | pitch_peak | 1.672 | <= 6 deg | 통과 |
| 2-11 방향: 왼쪽 바퀴만 날카로운 턱 2 cm, 0.3 m/s | 0 | alive (넘어지지 않음) | 1 | >= 1  | 통과 |
| 2-11 방향: 왼쪽 바퀴만 날카로운 턱 2 cm, 0.3 m/s | 0 | knee_flipped (무릎이 완전 신장 반대쪽으로 넘어가지 않음) | 0 | <= 0  | 통과 |
| 2-11 방향: 왼쪽 바퀴만 날카로운 턱 2 cm, 0.3 m/s | 0 | leg_margin_mm (완전 신장까지 남은 다리 길이) | 37.366 | >= 5 mm | 통과 |
| 2-11 방향: 왼쪽 바퀴만 날카로운 턱 2 cm, 0.3 m/s | 0 | wheel_peak (바퀴 토크 피크 ≤ AKE60 피크의 80 %) | 3.170 | <= 10 N m | 통과 |
| 2-11 방향: 왼쪽 바퀴만 날카로운 턱 2 cm, 0.3 m/s | 0 | leg_peak (hip·무릎 토크 피크 ≤ AKE60 피크의 80 %) | 5.197 | <= 10 N m | 통과 |
| 2-11 방향: 왼쪽 바퀴만 날카로운 턱 2 cm, 0.3 m/s | 0 | leg_rms (hip·무릎 토크 rms ≤ 정격) | 3.909 | <= 5 N m | 통과 |
| 2-11 방향: 왼쪽 바퀴만 날카로운 턱 2 cm, 0.3 m/s | 0 | wheel_rms10 (바퀴 토크 10 s rms ≤ 정격의 50 %) | 0.534 | <= 2.5 N m | 통과 |
| 2-12 방향: 왼쪽 바퀴만 날카로운 턱 4 cm, 0.5 m/s | 0 | heading_peak_deg (방향 틀어짐 최대) | 16.325 | <= 15.5 deg | **실패** |
| 2-12 방향: 왼쪽 바퀴만 날카로운 턱 4 cm, 0.5 m/s | 0 | heading_end_deg (정지 3 s 뒤 방향) | 2.022 | <= 3.1 deg | 통과 |
| 2-12 방향: 왼쪽 바퀴만 날카로운 턱 4 cm, 0.5 m/s | 0 | y_end_cm (옆 이동) | 15.084 | <= 15 cm | **실패** |
| 2-12 방향: 왼쪽 바퀴만 날카로운 턱 4 cm, 0.5 m/s | 0 | roll_peak_deg | 1.447 | <= 1 deg | **실패** |
| 2-12 방향: 왼쪽 바퀴만 날카로운 턱 4 cm, 0.5 m/s | 0 | pitch_peak | 3.180 | <= 6 deg | 통과 |
| 2-12 방향: 왼쪽 바퀴만 날카로운 턱 4 cm, 0.5 m/s | 0 | alive (넘어지지 않음) | 1 | >= 1  | 통과 |
| 2-12 방향: 왼쪽 바퀴만 날카로운 턱 4 cm, 0.5 m/s | 0 | knee_flipped (무릎이 완전 신장 반대쪽으로 넘어가지 않음) | 0 | <= 0  | 통과 |
| 2-12 방향: 왼쪽 바퀴만 날카로운 턱 4 cm, 0.5 m/s | 0 | leg_margin_mm (완전 신장까지 남은 다리 길이) | 36.750 | >= 5 mm | 통과 |
| 2-12 방향: 왼쪽 바퀴만 날카로운 턱 4 cm, 0.5 m/s | 0 | wheel_peak (바퀴 토크 피크 ≤ AKE60 피크의 80 %) | 5.777 | <= 10 N m | 통과 |
| 2-12 방향: 왼쪽 바퀴만 날카로운 턱 4 cm, 0.5 m/s | 0 | leg_peak (hip·무릎 토크 피크 ≤ AKE60 피크의 80 %) | 7.329 | <= 10 N m | 통과 |
| 2-12 방향: 왼쪽 바퀴만 날카로운 턱 4 cm, 0.5 m/s | 0 | leg_rms (hip·무릎 토크 rms ≤ 정격) | 3.935 | <= 5 N m | 통과 |
| 2-12 방향: 왼쪽 바퀴만 날카로운 턱 4 cm, 0.5 m/s | 0 | wheel_rms10 (바퀴 토크 10 s rms ≤ 정격의 50 %) | 0.777 | <= 2.5 N m | 통과 |
| 2-13 방향: 오른쪽 바퀴만 날카로운 턱 4 cm, 1 m/s | 0 | heading_peak_deg (방향 틀어짐 최대) | 14.039 | <= 15 deg | 통과 |
| 2-13 방향: 오른쪽 바퀴만 날카로운 턱 4 cm, 1 m/s | 0 | heading_end_deg (정지 3 s 뒤 방향) | 1.350 | <= 2 deg | 통과 |
| 2-13 방향: 오른쪽 바퀴만 날카로운 턱 4 cm, 1 m/s | 0 | y_end_cm (옆 이동) | 16.926 | <= 17.5 cm | 통과 |
| 2-13 방향: 오른쪽 바퀴만 날카로운 턱 4 cm, 1 m/s | 0 | roll_peak_deg | 1.908 | <= 1 deg | **실패** |
| 2-13 방향: 오른쪽 바퀴만 날카로운 턱 4 cm, 1 m/s | 0 | pitch_peak | 4.821 | <= 7.5 deg | 통과 |
| 2-13 방향: 오른쪽 바퀴만 날카로운 턱 4 cm, 1 m/s | 0 | alive (넘어지지 않음) | 1 | >= 1  | 통과 |
| 2-13 방향: 오른쪽 바퀴만 날카로운 턱 4 cm, 1 m/s | 0 | knee_flipped (무릎이 완전 신장 반대쪽으로 넘어가지 않음) | 0 | <= 0  | 통과 |
| 2-13 방향: 오른쪽 바퀴만 날카로운 턱 4 cm, 1 m/s | 0 | leg_margin_mm (완전 신장까지 남은 다리 길이) | 34.968 | >= 5 mm | 통과 |
| 2-13 방향: 오른쪽 바퀴만 날카로운 턱 4 cm, 1 m/s | 0 | wheel_peak (바퀴 토크 피크 ≤ AKE60 피크의 80 %) | 8.146 | <= 10 N m | 통과 |
| 2-13 방향: 오른쪽 바퀴만 날카로운 턱 4 cm, 1 m/s | 0 | leg_peak (hip·무릎 토크 피크 ≤ AKE60 피크의 80 %) | 9.383 | <= 10 N m | 통과 |
| 2-13 방향: 오른쪽 바퀴만 날카로운 턱 4 cm, 1 m/s | 0 | leg_rms (hip·무릎 토크 rms ≤ 정격) | 3.994 | <= 5 N m | 통과 |
| 2-13 방향: 오른쪽 바퀴만 날카로운 턱 4 cm, 1 m/s | 0 | wheel_rms10 (바퀴 토크 10 s rms ≤ 정격의 50 %) | 1.048 | <= 2.5 N m | 통과 |
| 2-14 IMU: 1 m/s 출발·정지의 자세 추정 | 0 | pitch_err_deg (추정 − 실제 피치, 50 ms 평균의 최대) | 0.160 | <= 0.5 deg | 통과 |
| 2-14 IMU: 1 m/s 출발·정지의 자세 추정 | 0 | pitch_peak (실제 피치 최대) | 3.289 | <= 3.2 deg | **실패** |
| 2-14 IMU: 1 m/s 출발·정지의 자세 추정 | 0 | alive (넘어지지 않음) | 1 | >= 1  | 통과 |
| 2-14 IMU: 1 m/s 출발·정지의 자세 추정 | 0 | knee_flipped (무릎이 완전 신장 반대쪽으로 넘어가지 않음) | 0 | <= 0  | 통과 |
| 2-14 IMU: 1 m/s 출발·정지의 자세 추정 | 0 | leg_margin_mm (완전 신장까지 남은 다리 길이) | 38.983 | >= 5 mm | 통과 |
| 2-14 IMU: 1 m/s 출발·정지의 자세 추정 | 0 | wheel_peak (바퀴 토크 피크 ≤ AKE60 피크의 80 %) | 1.799 | <= 10 N m | 통과 |
| 2-14 IMU: 1 m/s 출발·정지의 자세 추정 | 0 | leg_peak (hip·무릎 토크 피크 ≤ AKE60 피크의 80 %) | 4.405 | <= 10 N m | 통과 |
| 2-14 IMU: 1 m/s 출발·정지의 자세 추정 | 0 | leg_rms (hip·무릎 토크 rms ≤ 정격) | 3.536 | <= 5 N m | 통과 |
| 2-14 IMU: 1 m/s 출발·정지의 자세 추정 | 0 | wheel_rms10 (바퀴 토크 10 s rms ≤ 정격의 50 %) | 0.510 | <= 2.5 N m | 통과 |
| 2-15 IMU: 1 m/s로 가며 2 rad/s 회전의 자세 추정 | 0 | pitch_err_deg (추정 − 실제 피치) | 0.406 | <= 0.5 deg | 통과 |
| 2-15 IMU: 1 m/s로 가며 2 rad/s 회전의 자세 추정 | 0 | roll_err_deg (추정 − 실제 롤) | 0.200 | <= 0.5 deg | 통과 |
| 2-15 IMU: 1 m/s로 가며 2 rad/s 회전의 자세 추정 | 0 | alive (넘어지지 않음) | 1 | >= 1  | 통과 |
| 2-15 IMU: 1 m/s로 가며 2 rad/s 회전의 자세 추정 | 0 | knee_flipped (무릎이 완전 신장 반대쪽으로 넘어가지 않음) | 0 | <= 0  | 통과 |
| 2-15 IMU: 1 m/s로 가며 2 rad/s 회전의 자세 추정 | 0 | leg_margin_mm (완전 신장까지 남은 다리 길이) | 37.040 | >= 5 mm | 통과 |
| 2-15 IMU: 1 m/s로 가며 2 rad/s 회전의 자세 추정 | 0 | wheel_peak (바퀴 토크 피크 ≤ AKE60 피크의 80 %) | 3.098 | <= 10 N m | 통과 |
| 2-15 IMU: 1 m/s로 가며 2 rad/s 회전의 자세 추정 | 0 | leg_peak (hip·무릎 토크 피크 ≤ AKE60 피크의 80 %) | 7.829 | <= 10 N m | 통과 |
| 2-15 IMU: 1 m/s로 가며 2 rad/s 회전의 자세 추정 | 0 | leg_rms (hip·무릎 토크 rms ≤ 정격) | 5.027 | <= 5 N m | **실패** |
| 2-15 IMU: 1 m/s로 가며 2 rad/s 회전의 자세 추정 | 0 | wheel_rms10 (바퀴 토크 10 s rms ≤ 정격의 50 %) | 0.682 | <= 2.5 N m | 통과 |
| 2-16 IMU: 2 rad/s로 30 s 회전 뒤 정지 | 0 | yaw_err_pct (회전 끝의 요 속도 오차) | 0.009 | <= 5 % | 통과 |
| 2-16 IMU: 2 rad/s로 30 s 회전 뒤 정지 | 0 | yaw_rate_end (정지 뒤 남은 요 속도) | 0.001 | <= 0.01 rad/s | 통과 |
| 2-16 IMU: 2 rad/s로 30 s 회전 뒤 정지 | 0 | alive (넘어지지 않음) | 1 | >= 1  | 통과 |
| 2-16 IMU: 2 rad/s로 30 s 회전 뒤 정지 | 0 | knee_flipped (무릎이 완전 신장 반대쪽으로 넘어가지 않음) | 0 | <= 0  | 통과 |
| 2-16 IMU: 2 rad/s로 30 s 회전 뒤 정지 | 0 | leg_margin_mm (완전 신장까지 남은 다리 길이) | 38.983 | >= 5 mm | 통과 |
| 2-16 IMU: 2 rad/s로 30 s 회전 뒤 정지 | 0 | wheel_peak (바퀴 토크 피크 ≤ AKE60 피크의 80 %) | 1.284 | <= 10 N m | 통과 |
| 2-16 IMU: 2 rad/s로 30 s 회전 뒤 정지 | 0 | leg_peak (hip·무릎 토크 피크 ≤ AKE60 피크의 80 %) | 5.901 | <= 10 N m | 통과 |
| 2-16 IMU: 2 rad/s로 30 s 회전 뒤 정지 | 0 | leg_rms (hip·무릎 토크 rms ≤ 정격) | 3.982 | <= 5 N m | 통과 |
| 2-16 IMU: 2 rad/s로 30 s 회전 뒤 정지 | 0 | wheel_rms10 (바퀴 토크 10 s rms ≤ 정격의 50 %) | 0.360 | <= 2.5 N m | 통과 |
| 2-17 곡선 턱 10 cm, 왼쪽 바퀴, 0.3 m/s | 0 | roll_peak_deg (턱 구간 롤 최대) | 0.495 | <= 1 deg | 통과 |
| 2-17 곡선 턱 10 cm, 왼쪽 바퀴, 0.3 m/s | 0 | pitch_peak | 1.588 | <= 4 deg | 통과 |
| 2-17 곡선 턱 10 cm, 왼쪽 바퀴, 0.3 m/s | 0 | heading_peak_deg | 5.063 | <= 8 deg | 통과 |
| 2-17 곡선 턱 10 cm, 왼쪽 바퀴, 0.3 m/s | 0 | rise_mm (몸통 상승(턱 높이의 절반이면 평균 길이 유지)) | 8.641 | <= 22 mm | 통과 |
| 2-17 곡선 턱 10 cm, 왼쪽 바퀴, 0.3 m/s | 0 | heave_peak (몸통 수직 가속도) | 0.232 | <= 1.5 m/s^2 | 통과 |
| 2-17 곡선 턱 10 cm, 왼쪽 바퀴, 0.3 m/s | 0 | alive (넘어지지 않음) | 1 | >= 1  | 통과 |
| 2-17 곡선 턱 10 cm, 왼쪽 바퀴, 0.3 m/s | 0 | knee_flipped (무릎이 완전 신장 반대쪽으로 넘어가지 않음) | 0 | <= 0  | 통과 |
| 2-17 곡선 턱 10 cm, 왼쪽 바퀴, 0.3 m/s | 0 | leg_margin_mm (완전 신장까지 남은 다리 길이) | 27.950 | >= 5 mm | 통과 |
| 2-17 곡선 턱 10 cm, 왼쪽 바퀴, 0.3 m/s | 0 | wheel_peak (바퀴 토크 피크 ≤ AKE60 피크의 80 %) | 1.930 | <= 10 N m | 통과 |
| 2-17 곡선 턱 10 cm, 왼쪽 바퀴, 0.3 m/s | 0 | leg_peak (hip·무릎 토크 피크 ≤ AKE60 피크의 80 %) | 7.135 | <= 10 N m | 통과 |
| 2-17 곡선 턱 10 cm, 왼쪽 바퀴, 0.3 m/s | 0 | leg_rms (hip·무릎 토크 rms ≤ 정격) | 3.872 | <= 5 N m | 통과 |
| 2-17 곡선 턱 10 cm, 왼쪽 바퀴, 0.3 m/s | 0 | wheel_rms10 (바퀴 토크 10 s rms ≤ 정격의 50 %) | 0.723 | <= 2.5 N m | 통과 |
| 2-18 곡선 턱 14 cm, 오른쪽 바퀴, 0.3 m/s | 0 | roll_peak_deg (턱 구간 롤 최대) | 0.642 | <= 1.5 deg | 통과 |
| 2-18 곡선 턱 14 cm, 오른쪽 바퀴, 0.3 m/s | 0 | pitch_peak | 1.615 | <= 4 deg | 통과 |
| 2-18 곡선 턱 14 cm, 오른쪽 바퀴, 0.3 m/s | 0 | heading_peak_deg | 5.593 | <= 8 deg | 통과 |
| 2-18 곡선 턱 14 cm, 오른쪽 바퀴, 0.3 m/s | 0 | alive (넘어지지 않음) | 1 | >= 1  | 통과 |
| 2-18 곡선 턱 14 cm, 오른쪽 바퀴, 0.3 m/s | 0 | knee_flipped (무릎이 완전 신장 반대쪽으로 넘어가지 않음) | 0 | <= 0  | 통과 |
| 2-18 곡선 턱 14 cm, 오른쪽 바퀴, 0.3 m/s | 0 | leg_margin_mm (완전 신장까지 남은 다리 길이) | 18.523 | >= 5 mm | 통과 |
| 2-18 곡선 턱 14 cm, 오른쪽 바퀴, 0.3 m/s | 0 | wheel_peak (바퀴 토크 피크 ≤ AKE60 피크의 80 %) | 1.972 | <= 10 N m | 통과 |
| 2-18 곡선 턱 14 cm, 오른쪽 바퀴, 0.3 m/s | 0 | leg_peak (hip·무릎 토크 피크 ≤ AKE60 피크의 80 %) | 7.850 | <= 10 N m | 통과 |
| 2-18 곡선 턱 14 cm, 오른쪽 바퀴, 0.3 m/s | 0 | leg_rms (hip·무릎 토크 rms ≤ 정격) | 4.156 | <= 5 N m | 통과 |
| 2-18 곡선 턱 14 cm, 오른쪽 바퀴, 0.3 m/s | 0 | wheel_rms10 (바퀴 토크 10 s rms ≤ 정격의 50 %) | 0.863 | <= 2.5 N m | 통과 |
| 2-19 곡선 턱 20 cm, 왼쪽 바퀴, 0.3 m/s | 0 | alive (넘어지지 않음) | 1 | >= 1  | 통과 |
| 2-19 곡선 턱 20 cm, 왼쪽 바퀴, 0.3 m/s | 0 | knee_flipped (무릎이 완전 신장 반대쪽으로 넘어가지 않음) | 0 | <= 0  | 통과 |
| 2-19 곡선 턱 20 cm, 왼쪽 바퀴, 0.3 m/s | 0 | leg_margin_mm (완전 신장까지 남은 다리 길이) | 7.509 | >= 5 mm | 통과 |
| 2-19 곡선 턱 20 cm, 왼쪽 바퀴, 0.3 m/s | 0 | roll_peak_deg (턱 구간 롤 최대) | 3.038 | <= 8 deg | 통과 |
| 2-19 곡선 턱 20 cm, 왼쪽 바퀴, 0.3 m/s | 0 | roll_top_deg (턱 위 평균 롤) | 2.320 | <= 7 deg | 통과 |
| 2-19 곡선 턱 20 cm, 왼쪽 바퀴, 0.3 m/s | 0 | pitch_peak | 1.591 | <= 5 deg | 통과 |
| 2-19 곡선 턱 20 cm, 왼쪽 바퀴, 0.3 m/s | 0 | leg_peak (hip·무릎 토크 피크 ≤ AKE60 피크) | 12.500 | <= 12.5 N m | 통과 |
| 2-19 곡선 턱 20 cm, 왼쪽 바퀴, 0.3 m/s | 0 | leg_rms (hip·무릎 토크 rms ≤ 정격) | 4.871 | <= 5 N m | 통과 |
| 2-1 높이: 4 cm 웅크림 후 복귀 (기준 10번) | 0 | pitch_peak | 0.503 | <= 3 deg | 통과 |
| 2-1 높이: 4 cm 웅크림 후 복귀 (기준 10번) | 0 | settled (복귀 후 정착) | 1 | >= 1  | 통과 |
| 2-1 높이: 4 cm 웅크림 후 복귀 (기준 10번) | 0 | crouch_err_mm (웅크린 길이 오차) | 0.029 | <= 3 mm | 통과 |
| 2-1 높이: 4 cm 웅크림 후 복귀 (기준 10번) | 0 | return_err_mm (복귀 길이 오차) | 0.045 | <= 3 mm | 통과 |
| 2-1 높이: 4 cm 웅크림 후 복귀 (기준 10번) | 0 | alive (넘어지지 않음) | 1 | >= 1  | 통과 |
| 2-1 높이: 4 cm 웅크림 후 복귀 (기준 10번) | 0 | knee_flipped (무릎이 완전 신장 반대쪽으로 넘어가지 않음) | 0 | <= 0  | 통과 |
| 2-1 높이: 4 cm 웅크림 후 복귀 (기준 10번) | 0 | leg_margin_mm (완전 신장까지 남은 다리 길이) | 34.372 | >= 5 mm | 통과 |
| 2-1 높이: 4 cm 웅크림 후 복귀 (기준 10번) | 0 | wheel_peak (바퀴 토크 피크 ≤ AKE60 피크의 80 %) | 0.707 | <= 10 N m | 통과 |
| 2-1 높이: 4 cm 웅크림 후 복귀 (기준 10번) | 0 | leg_peak (hip·무릎 토크 피크 ≤ AKE60 피크의 80 %) | 7.385 | <= 10 N m | 통과 |
| 2-1 높이: 4 cm 웅크림 후 복귀 (기준 10번) | 0 | leg_rms (hip·무릎 토크 rms ≤ 정격) | 4.235 | <= 5 N m | 통과 |
| 2-1 높이: 4 cm 웅크림 후 복귀 (기준 10번) | 0 | wheel_rms10 (바퀴 토크 10 s rms ≤ 정격의 50 %) | 0.216 | <= 2.5 N m | 통과 |
| 2-20 감속: 곡선 턱 10 cm, 명령 0.5 m/s | 0 | v_top (턱 위 속도) | 0.180 | <= 0.3 m/s | 통과 |
| 2-20 감속: 곡선 턱 10 cm, 명령 0.5 m/s | 0 | brake_peak (감속도 최대) | 0.595 | <= 1.2 m/s^2 | 통과 |
| 2-20 감속: 곡선 턱 10 cm, 명령 0.5 m/s | 0 | roll_peak_deg | 0.763 | <= 1.5 deg | 통과 |
| 2-20 감속: 곡선 턱 10 cm, 명령 0.5 m/s | 0 | pitch_peak | 2.034 | <= 4 deg | 통과 |
| 2-20 감속: 곡선 턱 10 cm, 명령 0.5 m/s | 0 | alive (넘어지지 않음) | 1 | >= 1  | 통과 |
| 2-20 감속: 곡선 턱 10 cm, 명령 0.5 m/s | 0 | knee_flipped (무릎이 완전 신장 반대쪽으로 넘어가지 않음) | 0 | <= 0  | 통과 |
| 2-20 감속: 곡선 턱 10 cm, 명령 0.5 m/s | 0 | leg_margin_mm (완전 신장까지 남은 다리 길이) | 28.490 | >= 5 mm | 통과 |
| 2-20 감속: 곡선 턱 10 cm, 명령 0.5 m/s | 0 | wheel_peak (바퀴 토크 피크 ≤ AKE60 피크의 80 %) | 2.064 | <= 10 N m | 통과 |
| 2-20 감속: 곡선 턱 10 cm, 명령 0.5 m/s | 0 | leg_peak (hip·무릎 토크 피크 ≤ AKE60 피크의 80 %) | 6.534 | <= 10 N m | 통과 |
| 2-20 감속: 곡선 턱 10 cm, 명령 0.5 m/s | 0 | leg_rms (hip·무릎 토크 rms ≤ 정격) | 3.789 | <= 5 N m | 통과 |
| 2-20 감속: 곡선 턱 10 cm, 명령 0.5 m/s | 0 | wheel_rms10 (바퀴 토크 10 s rms ≤ 정격의 50 %) | 0.602 | <= 2.5 N m | 통과 |
| 2-21 감속 복귀: 곡선 턱 10 cm, 명령 1 m/s | 0 | v_after (턱을 지나 2.5 s 뒤 속도) | 0.988 | >= 0.8 m/s | 통과 |
| 2-21 감속 복귀: 곡선 턱 10 cm, 명령 1 m/s | 0 | brake_peak (감속도 최대) | 0.939 | <= 1.2 m/s^2 | 통과 |
| 2-21 감속 복귀: 곡선 턱 10 cm, 명령 1 m/s | 0 | roll_peak_deg | 1.205 | <= 1.5 deg | 통과 |
| 2-21 감속 복귀: 곡선 턱 10 cm, 명령 1 m/s | 0 | pitch_peak | 3.218 | <= 4 deg | 통과 |
| 2-21 감속 복귀: 곡선 턱 10 cm, 명령 1 m/s | 0 | alive (넘어지지 않음) | 1 | >= 1  | 통과 |
| 2-21 감속 복귀: 곡선 턱 10 cm, 명령 1 m/s | 0 | knee_flipped (무릎이 완전 신장 반대쪽으로 넘어가지 않음) | 0 | <= 0  | 통과 |
| 2-21 감속 복귀: 곡선 턱 10 cm, 명령 1 m/s | 0 | leg_margin_mm (완전 신장까지 남은 다리 길이) | 28.490 | >= 5 mm | 통과 |
| 2-21 감속 복귀: 곡선 턱 10 cm, 명령 1 m/s | 0 | wheel_peak (바퀴 토크 피크 ≤ AKE60 피크의 80 %) | 2.678 | <= 10 N m | 통과 |
| 2-21 감속 복귀: 곡선 턱 10 cm, 명령 1 m/s | 0 | leg_peak (hip·무릎 토크 피크 ≤ AKE60 피크의 80 %) | 5.521 | <= 10 N m | 통과 |
| 2-21 감속 복귀: 곡선 턱 10 cm, 명령 1 m/s | 0 | leg_rms (hip·무릎 토크 rms ≤ 정격) | 3.888 | <= 5 N m | 통과 |
| 2-21 감속 복귀: 곡선 턱 10 cm, 명령 1 m/s | 0 | wheel_rms10 (바퀴 토크 10 s rms ≤ 정격의 50 %) | 0.766 | <= 2.5 N m | 통과 |
| 2-2 요: 1 rad/s, 2 s (기준 9번) | 0 | yaw_err_pct (마지막 1 s 평균) | 0.399 | <= 10 % | 통과 |
| 2-2 요: 1 rad/s, 2 s (기준 9번) | 0 | pitch_peak | 0.120 | <= 2 deg | 통과 |
| 2-2 요: 1 rad/s, 2 s (기준 9번) | 0 | alive (넘어지지 않음) | 1 | >= 1  | 통과 |
| 2-2 요: 1 rad/s, 2 s (기준 9번) | 0 | knee_flipped (무릎이 완전 신장 반대쪽으로 넘어가지 않음) | 0 | <= 0  | 통과 |
| 2-2 요: 1 rad/s, 2 s (기준 9번) | 0 | leg_margin_mm (완전 신장까지 남은 다리 길이) | 38.983 | >= 5 mm | 통과 |
| 2-2 요: 1 rad/s, 2 s (기준 9번) | 0 | wheel_peak (바퀴 토크 피크 ≤ AKE60 피크의 80 %) | 1.235 | <= 10 N m | 통과 |
| 2-2 요: 1 rad/s, 2 s (기준 9번) | 0 | leg_peak (hip·무릎 토크 피크 ≤ AKE60 피크의 80 %) | 5.846 | <= 10 N m | 통과 |
| 2-2 요: 1 rad/s, 2 s (기준 9번) | 0 | leg_rms (hip·무릎 토크 rms ≤ 정격) | 4.203 | <= 5 N m | 통과 |
| 2-2 요: 1 rad/s, 2 s (기준 9번) | 0 | wheel_rms10 (바퀴 토크 10 s rms ≤ 정격의 50 %) | 0.412 | <= 2.5 N m | 통과 |
| 2-3 롤: 기준 3° | 0 | roll_err_deg (마지막 1 s 평균의 오차) | 0.047 | <= 0.5 deg | 통과 |
| 2-3 롤: 기준 3° | 0 | pitch_peak | 0.228 | <= 2 deg | 통과 |
| 2-3 롤: 기준 3° | 0 | alive (넘어지지 않음) | 1 | >= 1  | 통과 |
| 2-3 롤: 기준 3° | 0 | knee_flipped (무릎이 완전 신장 반대쪽으로 넘어가지 않음) | 0 | <= 0  | 통과 |
| 2-3 롤: 기준 3° | 0 | leg_margin_mm (완전 신장까지 남은 다리 길이) | 36.032 | >= 5 mm | 통과 |
| 2-3 롤: 기준 3° | 0 | wheel_peak (바퀴 토크 피크 ≤ AKE60 피크의 80 %) | 0.708 | <= 10 N m | 통과 |
| 2-3 롤: 기준 3° | 0 | leg_peak (hip·무릎 토크 피크 ≤ AKE60 피크의 80 %) | 6.057 | <= 10 N m | 통과 |
| 2-3 롤: 기준 3° | 0 | leg_rms (hip·무릎 토크 rms ≤ 정격) | 5.193 | <= 5 N m | **실패** |
| 2-3 롤: 기준 3° | 0 | wheel_rms10 (바퀴 토크 10 s rms ≤ 정격의 50 %) | 0.224 | <= 2.5 N m | 통과 |
| 2-4 다리 벌어짐: 0.5 m/s로 가며 1 rad/s 회전 | 0 | yaw_err_pct | 0.169 | <= 10 % | 통과 |
| 2-4 다리 벌어짐: 0.5 m/s로 가며 1 rad/s 회전 | 0 | split_peak_deg (좌우 다리각 차 최대) | 3.274 | <= 5 deg | 통과 |
| 2-4 다리 벌어짐: 0.5 m/s로 가며 1 rad/s 회전 | 0 | pitch_peak | 2.071 | <= 5 deg | 통과 |
| 2-4 다리 벌어짐: 0.5 m/s로 가며 1 rad/s 회전 | 0 | stop_settle_s (정지 명령 뒤 정착 시간) | 1.159 | <= 3 s | 통과 |
| 2-4 다리 벌어짐: 0.5 m/s로 가며 1 rad/s 회전 | 0 | alive (넘어지지 않음) | 1 | >= 1  | 통과 |
| 2-4 다리 벌어짐: 0.5 m/s로 가며 1 rad/s 회전 | 0 | knee_flipped (무릎이 완전 신장 반대쪽으로 넘어가지 않음) | 0 | <= 0  | 통과 |
| 2-4 다리 벌어짐: 0.5 m/s로 가며 1 rad/s 회전 | 0 | leg_margin_mm (완전 신장까지 남은 다리 길이) | 38.170 | >= 5 mm | 통과 |
| 2-4 다리 벌어짐: 0.5 m/s로 가며 1 rad/s 회전 | 0 | wheel_peak (바퀴 토크 피크 ≤ AKE60 피크의 80 %) | 1.903 | <= 10 N m | 통과 |
| 2-4 다리 벌어짐: 0.5 m/s로 가며 1 rad/s 회전 | 0 | leg_peak (hip·무릎 토크 피크 ≤ AKE60 피크의 80 %) | 6.468 | <= 10 N m | 통과 |
| 2-4 다리 벌어짐: 0.5 m/s로 가며 1 rad/s 회전 | 0 | leg_rms (hip·무릎 토크 rms ≤ 정격) | 3.998 | <= 5 N m | 통과 |
| 2-4 다리 벌어짐: 0.5 m/s로 가며 1 rad/s 회전 | 0 | wheel_rms10 (바퀴 토크 10 s rms ≤ 정격의 50 %) | 0.441 | <= 2.5 N m | 통과 |
| 2-5 무릎 결합 보상: 경사 10° 정지 | 0 | leg_err_mm (마지막 1 s 평균 \|L0 − L_ref\|) | 0.432 | <= 1 mm | 통과 |
| 2-5 무릎 결합 보상: 경사 10° 정지 | 0 | alive (넘어지지 않음) | 1 | >= 1  | 통과 |
| 2-5 무릎 결합 보상: 경사 10° 정지 | 0 | knee_flipped (무릎이 완전 신장 반대쪽으로 넘어가지 않음) | 0 | <= 0  | 통과 |
| 2-5 무릎 결합 보상: 경사 10° 정지 | 0 | leg_margin_mm (완전 신장까지 남은 다리 길이) | 38.797 | >= 5 mm | 통과 |
| 2-5 무릎 결합 보상: 경사 10° 정지 | 0 | wheel_peak (바퀴 토크 피크 ≤ AKE60 피크의 80 %) | 1.541 | <= 10 N m | 통과 |
| 2-5 무릎 결합 보상: 경사 10° 정지 | 0 | leg_peak (hip·무릎 토크 피크 ≤ AKE60 피크의 80 %) | 4.251 | <= 10 N m | 통과 |
| 2-5 무릎 결합 보상: 경사 10° 정지 | 0 | leg_rms (hip·무릎 토크 rms ≤ 정격) | 3.883 | <= 5 N m | 통과 |
| 2-5 무릎 결합 보상: 경사 10° 정지 | 0 | wheel_rms10 (바퀴 토크 10 s rms ≤ 정격의 50 %) | 0.990 | <= 2.5 N m | 통과 |
| 2-6 무릎 결합 보상: 밀기 0.5 W, 0.1 s | 0 | leg_dev_mm (밀기 뒤 다리 길이 오차 변화 최대) | 2.514 | <= 3 mm | 통과 |
| 2-6 무릎 결합 보상: 밀기 0.5 W, 0.1 s | 0 | alive (넘어지지 않음) | 1 | >= 1  | 통과 |
| 2-6 무릎 결합 보상: 밀기 0.5 W, 0.1 s | 0 | knee_flipped (무릎이 완전 신장 반대쪽으로 넘어가지 않음) | 0 | <= 0  | 통과 |
| 2-6 무릎 결합 보상: 밀기 0.5 W, 0.1 s | 0 | leg_margin_mm (완전 신장까지 남은 다리 길이) | 38.834 | >= 5 mm | 통과 |
| 2-6 무릎 결합 보상: 밀기 0.5 W, 0.1 s | 0 | wheel_peak (바퀴 토크 피크 ≤ AKE60 피크의 80 %) | 3.735 | <= 10 N m | 통과 |
| 2-6 무릎 결합 보상: 밀기 0.5 W, 0.1 s | 0 | leg_peak (hip·무릎 토크 피크 ≤ AKE60 피크의 80 %) | 9.375 | <= 10 N m | 통과 |
| 2-6 무릎 결합 보상: 밀기 0.5 W, 0.1 s | 0 | leg_rms (hip·무릎 토크 rms ≤ 정격) | 3.303 | <= 5 N m | 통과 |
| 2-6 무릎 결합 보상: 밀기 0.5 W, 0.1 s | 0 | wheel_rms10 (바퀴 토크 10 s rms ≤ 정격의 50 %) | 0.784 | <= 2.5 N m | 통과 |
| 2-7 순응 롤: 왼쪽 바퀴만 턱 4 cm, 0.5 m/s | 0 | roll_peak_deg (턱 구간 롤 최대) | 0.299 | <= 0.5 deg | 통과 |
| 2-7 순응 롤: 왼쪽 바퀴만 턱 4 cm, 0.5 m/s | 0 | roll_top_deg (턱 위 평균 롤) | 0.082 | <= 0.2 deg | 통과 |
| 2-7 순응 롤: 왼쪽 바퀴만 턱 4 cm, 0.5 m/s | 0 | yield_pct (턱 위 좌우 다리 길이 차 / 턱 높이) | 102.972 | >= 90 % | 통과 |
| 2-7 순응 롤: 왼쪽 바퀴만 턱 4 cm, 0.5 m/s | 0 | pitch_peak | 1.594 | <= 3 deg | 통과 |
| 2-7 순응 롤: 왼쪽 바퀴만 턱 4 cm, 0.5 m/s | 0 | alive (넘어지지 않음) | 1 | >= 1  | 통과 |
| 2-7 순응 롤: 왼쪽 바퀴만 턱 4 cm, 0.5 m/s | 0 | knee_flipped (무릎이 완전 신장 반대쪽으로 넘어가지 않음) | 0 | <= 0  | 통과 |
| 2-7 순응 롤: 왼쪽 바퀴만 턱 4 cm, 0.5 m/s | 0 | leg_margin_mm (완전 신장까지 남은 다리 길이) | 37.840 | >= 5 mm | 통과 |
| 2-7 순응 롤: 왼쪽 바퀴만 턱 4 cm, 0.5 m/s | 0 | wheel_peak (바퀴 토크 피크 ≤ AKE60 피크의 80 %) | 1.806 | <= 10 N m | 통과 |
| 2-7 순응 롤: 왼쪽 바퀴만 턱 4 cm, 0.5 m/s | 0 | leg_peak (hip·무릎 토크 피크 ≤ AKE60 피크의 80 %) | 5.874 | <= 10 N m | 통과 |
| 2-7 순응 롤: 왼쪽 바퀴만 턱 4 cm, 0.5 m/s | 0 | leg_rms (hip·무릎 토크 rms ≤ 정격) | 3.936 | <= 5 N m | 통과 |
| 2-7 순응 롤: 왼쪽 바퀴만 턱 4 cm, 0.5 m/s | 0 | wheel_rms10 (바퀴 토크 10 s rms ≤ 정격의 50 %) | 0.487 | <= 2.5 N m | 통과 |
| 2-8 순응 롤: 오른쪽 바퀴만 턱 4 cm, 1 m/s | 0 | roll_peak_deg (턱 구간 롤 최대) | 0.484 | <= 0.5 deg | 통과 |
| 2-8 순응 롤: 오른쪽 바퀴만 턱 4 cm, 1 m/s | 0 | roll_top_deg (턱 위 평균 롤) | 0.087 | <= 0.2 deg | 통과 |
| 2-8 순응 롤: 오른쪽 바퀴만 턱 4 cm, 1 m/s | 0 | yield_pct (턱 위 좌우 다리 길이 차 / 턱 높이) | 97.502 | >= 90 % | 통과 |
| 2-8 순응 롤: 오른쪽 바퀴만 턱 4 cm, 1 m/s | 0 | pitch_peak | 2.711 | <= 3 deg | 통과 |
| 2-8 순응 롤: 오른쪽 바퀴만 턱 4 cm, 1 m/s | 0 | alive (넘어지지 않음) | 1 | >= 1  | 통과 |
| 2-8 순응 롤: 오른쪽 바퀴만 턱 4 cm, 1 m/s | 0 | knee_flipped (무릎이 완전 신장 반대쪽으로 넘어가지 않음) | 0 | <= 0  | 통과 |
| 2-8 순응 롤: 오른쪽 바퀴만 턱 4 cm, 1 m/s | 0 | leg_margin_mm (완전 신장까지 남은 다리 길이) | 37.804 | >= 5 mm | 통과 |
| 2-8 순응 롤: 오른쪽 바퀴만 턱 4 cm, 1 m/s | 0 | wheel_peak (바퀴 토크 피크 ≤ AKE60 피크의 80 %) | 2.404 | <= 10 N m | 통과 |
| 2-8 순응 롤: 오른쪽 바퀴만 턱 4 cm, 1 m/s | 0 | leg_peak (hip·무릎 토크 피크 ≤ AKE60 피크의 80 %) | 5.211 | <= 10 N m | 통과 |
| 2-8 순응 롤: 오른쪽 바퀴만 턱 4 cm, 1 m/s | 0 | leg_rms (hip·무릎 토크 rms ≤ 정격) | 3.635 | <= 5 N m | 통과 |
| 2-8 순응 롤: 오른쪽 바퀴만 턱 4 cm, 1 m/s | 0 | wheel_rms10 (바퀴 토크 10 s rms ≤ 정격의 50 %) | 0.714 | <= 2.5 N m | 통과 |
| 2-9 다리 길이 한계: 기립 +20 mm에서 롤 6° 명령 | 0 | roll_end_deg (한계 안에서 낼 수 있는 롤) | 6.154 | >= 3 deg | 통과 |
| 2-9 다리 길이 한계: 기립 +20 mm에서 롤 6° 명령 | 0 | alive (넘어지지 않음) | 1 | >= 1  | 통과 |
| 2-9 다리 길이 한계: 기립 +20 mm에서 롤 6° 명령 | 0 | knee_flipped (무릎이 완전 신장 반대쪽으로 넘어가지 않음) | 0 | <= 0  | 통과 |
| 2-9 다리 길이 한계: 기립 +20 mm에서 롤 6° 명령 | 0 | leg_margin_mm (완전 신장까지 남은 다리 길이) | 14.316 | >= 5 mm | 통과 |
| 2-9 다리 길이 한계: 기립 +20 mm에서 롤 6° 명령 | 0 | wheel_peak (바퀴 토크 피크 ≤ AKE60 피크의 80 %) | 0.796 | <= 10 N m | 통과 |
| 2-9 다리 길이 한계: 기립 +20 mm에서 롤 6° 명령 | 0 | leg_peak (hip·무릎 토크 피크 ≤ AKE60 피크의 80 %) | 7.850 | <= 10 N m | 통과 |
| 2-9 다리 길이 한계: 기립 +20 mm에서 롤 6° 명령 | 0 | leg_rms (hip·무릎 토크 rms ≤ 정격) | 6.479 | <= 5 N m | **실패** |
| 2-9 다리 길이 한계: 기립 +20 mm에서 롤 6° 명령 | 0 | wheel_rms10 (바퀴 토크 10 s rms ≤ 정격의 50 %) | 0.259 | <= 2.5 N m | 통과 |
| 3-1 경사 5° 정지 30 s: 위치 | 0 | offset_end_cm (마지막 5 s 평균 위치 − 출발 위치) | 1.394 | <= 3 cm | 통과 |
| 3-1 경사 5° 정지 30 s: 위치 | 0 | excursion_max_cm (최대 이탈, t ≥ 2 s (기준 12·16·17번)) | 3.996 | <= 10 cm | 통과 |
| 3-1 경사 5° 정지 30 s: 위치 | 0 | alive (넘어지지 않음) | 1 | >= 1  | 통과 |
| 3-1 경사 5° 정지 30 s: 위치 | 0 | knee_flipped (무릎이 완전 신장 반대쪽으로 넘어가지 않음) | 0 | <= 0  | 통과 |
| 3-1 경사 5° 정지 30 s: 위치 | 0 | leg_margin_mm (완전 신장까지 남은 다리 길이) | 38.946 | >= 5 mm | 통과 |
| 3-1 경사 5° 정지 30 s: 위치 | 0 | wheel_peak (바퀴 토크 피크 ≤ AKE60 피크의 80 %) | 1.212 | <= 10 N m | 통과 |
| 3-1 경사 5° 정지 30 s: 위치 | 0 | leg_peak (hip·무릎 토크 피크 ≤ AKE60 피크의 80 %) | 4.163 | <= 10 N m | 통과 |
| 3-1 경사 5° 정지 30 s: 위치 | 0 | leg_rms (hip·무릎 토크 rms ≤ 정격) | 3.687 | <= 5 N m | 통과 |
| 3-1 경사 5° 정지 30 s: 위치 | 0 | wheel_rms10 (바퀴 토크 10 s rms ≤ 정격의 50 %) | 0.550 | <= 2.5 N m | 통과 |
| 3-2 IMU 피치 오차 +1° 정지 30 s: 위치 | 0 | offset_end_cm (마지막 5 s 평균 위치 − 출발 위치) | 0.070 | <= 3 cm | 통과 |
| 3-2 IMU 피치 오차 +1° 정지 30 s: 위치 | 0 | excursion_max_cm (최대 이탈, t ≥ 2 s (기준 12·16·17번)) | 8.630 | <= 10 cm | 통과 |
| 3-2 IMU 피치 오차 +1° 정지 30 s: 위치 | 0 | alive (넘어지지 않음) | 1 | >= 1  | 통과 |
| 3-2 IMU 피치 오차 +1° 정지 30 s: 위치 | 0 | knee_flipped (무릎이 완전 신장 반대쪽으로 넘어가지 않음) | 0 | <= 0  | 통과 |
| 3-2 IMU 피치 오차 +1° 정지 30 s: 위치 | 0 | leg_margin_mm (완전 신장까지 남은 다리 길이) | 38.946 | >= 5 mm | 통과 |
| 3-2 IMU 피치 오차 +1° 정지 30 s: 위치 | 0 | wheel_peak (바퀴 토크 피크 ≤ AKE60 피크의 80 %) | 0.754 | <= 10 N m | 통과 |
| 3-2 IMU 피치 오차 +1° 정지 30 s: 위치 | 0 | leg_peak (hip·무릎 토크 피크 ≤ AKE60 피크의 80 %) | 3.932 | <= 10 N m | 통과 |
| 3-2 IMU 피치 오차 +1° 정지 30 s: 위치 | 0 | leg_rms (hip·무릎 토크 rms ≤ 정격) | 3.492 | <= 5 N m | 통과 |
| 3-2 IMU 피치 오차 +1° 정지 30 s: 위치 | 0 | wheel_rms10 (바퀴 토크 10 s rms ≤ 정격의 50 %) | 0.203 | <= 2.5 N m | 통과 |
| 3-3 앞쪽 짐 0.5 kg (+10 cm) 정지 30 s: 위치 | 0 | offset_end_cm (마지막 5 s 평균 위치 − 출발 위치) | 0.602 | <= 3 cm | 통과 |
| 3-3 앞쪽 짐 0.5 kg (+10 cm) 정지 30 s: 위치 | 0 | excursion_max_cm (최대 이탈, t ≥ 2 s (기준 12·16·17번)) | 6.016 | <= 10 cm | 통과 |
| 3-3 앞쪽 짐 0.5 kg (+10 cm) 정지 30 s: 위치 | 0 | alive (넘어지지 않음) | 1 | >= 1  | 통과 |
| 3-3 앞쪽 짐 0.5 kg (+10 cm) 정지 30 s: 위치 | 0 | knee_flipped (무릎이 완전 신장 반대쪽으로 넘어가지 않음) | 0 | <= 0  | 통과 |
| 3-3 앞쪽 짐 0.5 kg (+10 cm) 정지 30 s: 위치 | 0 | leg_margin_mm (완전 신장까지 남은 다리 길이) | 39.057 | >= 5 mm | 통과 |
| 3-3 앞쪽 짐 0.5 kg (+10 cm) 정지 30 s: 위치 | 0 | wheel_peak (바퀴 토크 피크 ≤ AKE60 피크의 80 %) | 0.654 | <= 10 N m | 통과 |
| 3-3 앞쪽 짐 0.5 kg (+10 cm) 정지 30 s: 위치 | 0 | leg_peak (hip·무릎 토크 피크 ≤ AKE60 피크의 80 %) | 4.362 | <= 10 N m | 통과 |
| 3-3 앞쪽 짐 0.5 kg (+10 cm) 정지 30 s: 위치 | 0 | leg_rms (hip·무릎 토크 rms ≤ 정격) | 3.901 | <= 5 N m | 통과 |
| 3-3 앞쪽 짐 0.5 kg (+10 cm) 정지 30 s: 위치 | 0 | wheel_rms10 (바퀴 토크 10 s rms ≤ 정격의 50 %) | 0.203 | <= 2.5 N m | 통과 |
| 4-1 경사 5° 정지 30 s: 몸통 기울기 | 0 | pitch_end_deg (마지막 5 s 평균 실제 피치) | 0.005 | <= 0.5 deg | 통과 |
| 4-1 경사 5° 정지 30 s: 몸통 기울기 | 0 | pitch_rms_end_deg (마지막 5 s 흔들림) | 0.206 | <= 0.5 deg | 통과 |
| 4-2 IMU 피치 오차 +1° 정지 30 s: 몸통 기울기 | 0 | pitch_end_deg (마지막 5 s 평균 실제 피치) | 0.000 | <= 0.5 deg | 통과 |
| 4-2 IMU 피치 오차 +1° 정지 30 s: 몸통 기울기 | 0 | pitch_rms_end_deg (마지막 5 s 흔들림) | 0.214 | <= 0.5 deg | 통과 |
| 4-3 앞쪽 짐 0.5 kg (+10 cm) 정지 30 s: 몸통 기울기 | 0 | pitch_end_deg (마지막 5 s 평균 실제 피치) | 0.181 | <= 0.5 deg | 통과 |
| 4-3 앞쪽 짐 0.5 kg (+10 cm) 정지 30 s: 몸통 기울기 | 0 | pitch_rms_end_deg (마지막 5 s 흔들림) | 0.183 | <= 0.5 deg | 통과 |
