wisehyun-2/my_robot_project/robot_cad_v5/calc/strength_v5.md

# v5 강도 손계산 — 링크를 PETG로 (`python calc/strength_v5.py`)

사용자 결정: 11-01 허벅지·정강이를 MJF PA12 대신 **PETG(FDM)** 로 계산, 11-02 **PETG로 출력하기로 함**, 11-07 **링크 25 cm + 리브 3.0**.  형상은 v5 (`fusion/legs_v5.py`, 링크 250 mm): 바깥 막대 y 263.5 ~ 288.5, 갈래 틈 59.5, 허벅지 상자 폭 110.5, 정강이 기본층 y 208 ~ 238(무릎 판과 틈 4.0), 바퀴는 바깥쪽(타이어 중심면 y 270.0, 11-02 바퀴 묶음 2.5 mm 바깥으로), hub 인서트는 6061 받침 링으로 PETG 벽을 끼워 고정(11-02).  하중·식은 v4(`v4/calc/strength_v4.py`)와 같다: 정지 60 N/바퀴, 설계 300 N, 검토 600 N(안전계수 2), 옆 150 / 300 N, 관절 토크 설계 12.5 / 검토 25 N·m.  응력은 검토 하중, 처짐은 설계 하중.

재료: PETG — 탄성 2000 MPa, 층 안 인장·굽힘 45 MPa, 지압 50 MPa(v2·v3 값), **층 사이(출력 높이 방향)는 0.6배인 27 MPa로 가정**(시험 출력으로 확인), 밀도 1.27, HDT 약 70 °C.  링크는 안쪽 면을 바닥에 놓고(y가 출력 높이) 출력한다고 본다: 링크 굽힘·비틀림의 면판 응력은 층 안, 인서트를 뽑는 힘은 층 사이로 간다.  비교로 MJF PA12(탄성 1700, 인장 48)도 같은 단면으로 계산했다.

## 1. 링크 — 갈래 허벅지와 정강이 상자

단면은 링크 축을 따라 200곳에서 잡았다.  허벅지는 크로치(s 153.2)까지 상자 하나(y 178 ~ 288, 벽 3.5), 그 아래는 안쪽 갈래와 바깥 막대 두 상자다.  두 상자가 **함께 굽는다고 본 값(무릎 끝이 정강이 머리와 두 베어링으로 이어짐)**과 **따로 굽는다고 본 값(아래 한계)** 을 둘 다 냈다.  비틀림은 두 칸을 더하기만 했다(틀 작용 무시, 보수적).  정강이는 r 70 패드가 깊이 전체를 덮는 곳까지(무릎에서 약 57 mm)만 패드를 넣었다.  리브는 단면마다 하나가 대각선으로 걸린다고 보고 옆 굽힘에만 넣었다(v4와 같음).  "링크 끝 옆 처짐"은 v2부터 쓴 지표(옆 굽힘만, 한계 1 mm), "접지점 옆 변위"는 굽힘 + 비틀림 전체다.

| 단면 | 링크 끝 옆 처짐 허벅지 / 정강이 [mm] (한계 1) | 접지점 옆 변위 [mm] (비틀림) | 검토 응력 / 강도 [MPa] | 면판 압축 / 좌굴 [MPa] | 판정 |
| --- | --- | --- | --- | --- | --- |
| **PETG, 갈래 함께 굽음** | 0.45 / 4.98 | 17.5 (6.4) | 18 (정강이 s 250) / 45 | 16 / 29 (폭 80) | **초과** |
| PETG, 갈래 따로 굽음 (아래 한계) | 1.33 / 4.98 | 22.3 (6.4) | 18 (정강이 s 250) / 45 | 16 / 29 (폭 80) | **초과** |
| 참고: MJF PA12, 갈래 함께 굽음 | 0.54 / 5.86 | 20.8 (7.8) | 18 (정강이 s 250) / 48 | 16 / 24 (폭 80) | **초과** |

**링크 25 cm + 리브 3.0 (11-07)**: 관절 사이 거리를 75 mm 늘렸다.  관절 원과 그 안의 모터 자리, 갈래는 175 mm 링크 그대로고, 옆면은 관절 원에서 관절 원까지 한 직선이다.  리브 간격을 유지해 허벅지 9개, 정강이 10개로 늘렸다.  링크 응력은 거의 그대로지만 옆 처짐은 길이만큼 늘고, **리브를 2.0 → 3.0로 두껍게 해도 옆 처짐은 정강이 끝 5.06 → 4.98 mm, 접지점 17.7 → 17.5 mm로 거의 줄지 않는다**(옆 처짐은 면·옆 벽이 정한다).  리브가 좋아지는 곳은 리브 자체의 전단 좌굴이다(10.5 → 23.5 MPa).

| 항목 | 175 mm, 리브 2.0 (허브 버전 9) | 250 mm, 리브 3.0 |
| --- | --- | --- |
| 검토 응력 [MPa] | 18.4 | 18.2 |
| 링크 끝 옆 처짐 허벅지 / 정강이 [mm] | 0.18 / 1.90 | 0.45 / 4.98 |
| 접지점 옆 변위, 갈래 함께 / 따로 [mm] | 8.6 / 12.2 | 17.5 / 22.3 |
| 로봇 질량 [kg] | 10.931 | 11.597 |

- PETG(탄성 2000)는 MJF PA12(1700)보다 조금 단단해서 같은 형상이면 처짐이 약 15 % 작다.  강도는 비슷하다(45 / 48).
- **정강이 옆 처짐 4.98 mm가 v2부터 쓴 링크 하나 1 mm 기준을 넘는다**: 정강이는 무릎 패드(r 70) 밖에서 폭이 30 mm뿐이다(v4 정강이는 바깥으로 55까지 넓혔지만, v5는 그쪽에 타이어가 있다).  허벅지는 폭 110 상자라 단단하다(0.45 mm).  접지점 전체 옆 변위는 17.5 mm로 v4(10.5) · v2(12.8) · 175 mm v5(8.6)보다 크다.  링크 하나 기준을 지킬지, 접지점 변위로 볼지는 결정할 것 — 줄이려면 정강이 폭을 키워야 하는데 바깥에 타이어, 안쪽에 허벅지가 있다.
- 갈래를 따로 굽는다고 보면 접지점 옆 변위 17.5 → 22.3 mm, 검토 응력 18 → 18 MPa — 실제는 그 사이다.  크로치 아래 두 상자를 잇는 것은 무릎 끝(모터 + 61807)뿐이라 함께 굽음은 위쪽 값이다.
- 비교: v4 SLA 레진 상자(바퀴 안쪽) 링크 끝 처짐 0.87 / 0.94 mm, 접지점 옆 변위 10.5 mm, v2 PETG 0.95 / 1.00 · 12.8 mm.
- 질량(Fusion 부피, 한쪽): 허벅지 651.6 cm³ → PETG **828 g** (PA12였다면 658), 정강이 331.3 cm³ → **421 g** (335), 6061 받침 링 12 g × 2.  벽 3.5 · 리브 2.0은 노즐 0.4로 둘레선만으로 채워지므로 꽉 찬 밀도로 셌다.  로봇(PETG 다리 모델) **11.60 kg** (PA12였다면 약 11.09 kg).  닫힌 칸은 허벅지 1294 cm³ · 정강이 428 cm³ — FDM이라 빈칸 그대로다(11-02 배출 구멍 없앰).

## 2. 관절부

| 부위 | 응력·힘 | 판정 |
| --- | --- | --- |
| hip 출력면 옆 모멘트 검토 225 N·m | ② M3 12.9 인장 7499 N (보증 4879), 와셔 면압 246 MPa (6061 260), 6061 Ø28 보스 굽힘 115 MPa (276) | **초과** |
| hip ⑥ 플랜지 → 받침 링 (PETG 벽 6 mm를 끼움), 검토 | M3 × 16 12.9 6개 (r 18, 6061 링 탭 6 mm 물림) 하나에 외력 4166 N + 예압 1000 = 5166 N (보증 4879); 받침 링 밑 PETG 벽 압축 44 MPa (50, 층 사이로 눌림) | **초과** |
| hip 출력면 옆 모멘트 설계 112 N·m | ② M3 12.9 인장 3749 N (보증 4879), 와셔 면압 123 MPa (6061 260), 6061 Ø28 보스 굽힘 57 MPa (276) | 통과 |
| hip ⑥ 플랜지 → 받침 링 (PETG 벽 6 mm를 끼움), 설계 | M3 × 16 12.9 6개 (r 18, 6061 링 탭 6 mm 물림) 하나에 외력 2083 N + 예압 1000 = 3083 N (보증 4879); 받침 링 밑 PETG 벽 압축 26 MPa (50, 층 사이로 눌림) | 통과 |
| knee 출력면 옆 모멘트 검토 144 N·m (모터가 다 받을 때) | ② M3 12.9 인장 4807 N (보증 4879), 와셔 면압 158 MPa (6061 260), 6061 Ø28 보스 굽힘 74 MPa (276) | 통과 |
| knee ⑥ 플랜지 → 받침 링 (PETG 벽 6 mm를 끼움), 검토 | M3 × 16 12.9 6개 (r 18, 6061 링 탭 6 mm 물림) 하나에 외력 2670 N + 예압 1000 = 3670 N (보증 4879); 받침 링 밑 PETG 벽 압축 31 MPa (50, 층 사이로 눌림) | 통과 |
| knee 출력면 옆 모멘트 설계 72 N·m (모터가 다 받을 때) | ② M3 12.9 인장 2403 N (보증 4879), 와셔 면압 79 MPa (6061 260), 6061 Ø28 보스 굽힘 37 MPa (276) | 통과 |
| knee ⑥ 플랜지 → 받침 링 (PETG 벽 6 mm를 끼움), 설계 | M3 × 16 12.9 6개 (r 18, 6061 링 탭 6 mm 물림) 하나에 외력 1335 N + 예압 1000 = 2335 N (보증 4879); 받침 링 밑 PETG 벽 압축 20 MPa (50, 층 사이로 눌림) | 통과 |
| hip 고정링 ① M2.5 12.9 · 6061 hip 판, 검토 | 인장 4109 N (보증 3288), 머리 면압 422 MPa (260); hip 판 웹 5 mm (v3 식 비례: 한 단면이 다 받으면) 489 MPa (276) | **초과** |
| hip 고정링 ① M2.5 12.9 · 6061 hip 판, 설계 | 인장 2054 N (보증 3288), 머리 면압 211 MPa (260); hip 판 웹 5 mm (v3 식 비례: 한 단면이 다 받으면) 244 MPa (276) | 통과 |
| knee PETG 모터 판 9 mm + 고정링 ① M2.5 8.8, 검토: 144 N·m (모터가 다 받을 때) | 판 굽힘 바깥 고정 34 / 단순 지지 48 (리드 홈 자리 7 mm: 80) MPa; 나사 인장 2634 N (보증 2034), SUS 링 밑 PETG 면압 29 MPa | **초과** |
| knee PETG 모터 판 9 mm + 고정링 ① M2.5 8.8, 설계: 72 N·m (모터가 다 받을 때) | 판 굽힘 바깥 고정 17 / 단순 지지 24 (리드 홈 자리 7 mm: 40) MPa; 나사 인장 1317 N (보증 2034), SUS 링 밑 PETG 면압 14 MPa | 통과 |
| wheel PETG 모터 판 9 mm + 고정링 ① M2.5 8.8, 검토: 65 N·m | 판 굽힘 바깥 고정 15 / 단순 지지 22 (리드 홈 자리 7 mm: 36) MPa; 나사 인장 1195 N (보증 2034), SUS 링 밑 PETG 면압 13 MPa | 통과 |
| wheel PETG 모터 판 9 mm + 고정링 ① M2.5 8.8, 설계: 33 N·m | 판 굽힘 바깥 고정 8 / 단순 지지 11 (리드 홈 자리 7 mm: 18) MPa; 나사 인장 597 N (보증 2034), SUS 링 밑 PETG 면압 7 MPa | 통과 |
| ⑥ 토크 25 N·m (검토) | 예압 마찰(μ 0.2)로 22 N·m; 마찰을 빼도 볼트 하나에 옆 힘 231 N → PETG 벽 구멍 지압 11.3 MPa (Ø3.4 × 6) | 통과 |
| 고정링 → PETG 모터 판, 토크 25 N·m (검토) | M2.5 6 (r 18.25): 개당 228 N → 구멍 지압 32.6 MPa (웹 2.8 mm) | 통과 |

**무릎 바깥 지지 (61807)** — 모터 출력 베어링이 모멘트를 못 받는다고(핀) 보면 무릎 옆 모멘트는 두 베어링의 짝힘이 된다.  AKE60 출력 베어링 자리는 비공개라 출력면 안쪽 4 mm로 잡았다.

| 경우 | 힘·응력 | 판정 |
| --- | --- | --- |
| 무릎 검토: 모멘트 147 N·m를 모터 베어링과 61807이 짝힘으로 (간격 56 mm) | 61807 반경 하중 2.64 kN (C0 3.35 kN), 정강이 자리 PETG 면압 8.0 MPa; 캡 관 굽힘 17 MPa (6061, 팔 14.0 mm); 캡 관이 막대 구멍에 꼭 맞음(Ø35 H7/g6, 11-02) → 구멍 면압 26 MPa (50), 캡 M2.5 인서트 3개는 예압만 (관이 놀면 인발 3091 N, 어림 한계 600) | 61807·자리·관 통과, 캡 구멍 통과 |
| 무릎 설계: 모멘트 73 N·m를 모터 베어링과 61807이 짝힘으로 (간격 56 mm) | 61807 반경 하중 1.32 kN (C0 3.35 kN), 정강이 자리 PETG 면압 4.0 MPa; 캡 관 굽힘 8 MPa (6061, 팔 14.0 mm); 캡 관이 막대 구멍에 꼭 맞음(Ø35 H7/g6, 11-02) → 구멍 면압 13 MPa (50), 캡 M2.5 인서트 3개는 예압만 (관이 놀면 인발 1545 N, 어림 한계 600) | 61807·자리·관 통과, 캡 구멍 통과 |

## 3. 정리

- **링크 몸통(PETG 상자) 강도는 통과**: 검토 응력 18 MPa < 45, 면판 좌굴 여유 2.4배.  처짐은 허벅지 0.45 mm로 단단하고 **정강이 4.98 mm는 v2의 링크 하나 1 mm 기준을 넘는다**(1절); 접지점 전체 옆 변위는 17.5 mm(갈래 따로 굽으면 22.3)로 v4(10.5) · v2(12.8)보다 크다.  정강이는 바깥에 타이어, 안쪽에 허벅지가 있어 폭 30을 못 넘는다 — **기준을 접지점 변위로 볼지 결정할 것**.
- **⑥ hub 인서트 고정은 hip 검토 하중에서 보증을 넘는다 (링크 25 cm, 설계 하중은 통과)**: M3 × 16 12.9 6개가 플랜지 → PETG 벽 6 mm → 6061 받침 링(Ø43 / Ø29 × 6, 링크 바깥 면 쪽 Ø44 구멍으로 넣음)의 탭에 물린다.  PETG는 눌리기만 한다.  hip 검토 하중에서 볼트 하나 5.2 kN(예압 1 kN 포함, 보증 4.9 kN, 175 mm에서 4.4 kN), 벽 압축 44 MPa (50).  hip이 높아져 옆 힘의 팔이 길어진 탓이고, 관절부를 바꾸지 않기로 해서(사용자 11-07) 그대로 두었다.  조임은 약 0.7 N·m + 나사 고정제, 처음 몇 주 다시 조인다(PETG 크리프).
- **hip 출력 ② M3 12.9는 검토 하중에서 보증을 넘는다**(7499 N > 4879, 바깥 바퀴 + 긴 링크로 hip 옆 모멘트가 225 N·m가 됨, 175 mm에서 185, 안쪽 바퀴였다면 167).  ① M2.5 12.9도 넘고, hip 판 웹은 한 단면이 다 받는다고 보면 489 MPa로 6061 항복을 넘는다.  링크 재료와 무관한 바깥 바퀴 + AKE60 출력부(M3 6개, PCD 20)의 한계라 다리 설계로는 못 고친다(설계 하중에서는 통과).
- 바퀴 PETG 모터 판·고정링은 통과.  **무릎은 모터가 옆 모멘트를 다 받는다고 보면 검토 하중에서 PETG 판(리드 홈 자리 7 mm)과 고정링 M2.5 8.8이 넘는다**.  실제로는 61807이 짝힘으로 나눠 받아 통과 쪽이며, 11-02 캡 관을 막대 구멍에 꼭 맞게 해 61807 쪽 길이 단단해졌다(실제 몫은 두 베어링 강성에 달림).  61807과 정강이 자리·캡 관·캡 구멍은 통과.

## 4. 열 · 출력 메모 (PETG FDM)

- PETG는 약 70 °C에서 물러진다.  무릎·바퀴 모터가 PETG 판에 붙는다(v2와 같음).  v2 계산: 짐 5 kg에 L0 0.240 m면 무릎 정지 토크가 정격의 144 % → 모터 외피가 PETG 연화 온도에 가까워질 수 있음.  실물에서 모터 링 면 온도를 재서 50 °C 밑인지 확인할 것.
- 출력 방향(11-02): **정강이는 안쪽 면(y 208, 평평)을 바닥에** — 바퀴 모터 칸(Ø74) 안, 바퀴 판 밑에만 받침.  **허벅지는 바깥 면(y 288.5, 평평: Ø44 hip 구멍과 무릎 캡 자리만)을 바닥에** — 무릎 하우징이 안쪽 면보다 4 mm 나와 있어 그쪽은 바닥으로 못 쓴다.  허벅지 안쪽 갈래는 갈래 틈(59.5 mm) 위에 떠 있어 틈 안에 받침이 필요하다(무릎 쪽이 열려 있어 빼기 쉬움).  닫힌 칸의 천장은 리브 칸 위를 브리지로 건넌다 — 칸 폭이 넓은 곳(약 30~40 mm)은 첫 층이 처질 수 있으니 브리지 설정(냉각 최대, 느리게)을 쓴다.
- 링크에 남은 열압입 인서트는 컵 기둥 M2.5와 무릎 캡 M2.5뿐이다(⑥ 인서트 없앰).  벽 3.5는 둘레선(0.45 × 8)으로 채우고 채움 100 %%로 출력한다.  PETG는 오래 눌리면 줄어든다(크리프) — 조임 토크를 낮게(M3 0.7~1.0 N·m, M2.5 0.5 N·m), 나사 고정제를 쓰고 처음 몇 주 다시 조인다.
