wisehyun-2/my_robot_project/wheeled_biped/docs/robot_v5_model.md

# v5 로봇 전용 모델과 IMU (2026-11-07)

v5 시뮬레이션과 제어기에서 upkie의 URDF와 IMU 값을 빼고, Fusion 모델에서 뽑은 값으로 바꾼 기록이다.
실제 코드와 측정값의 위치를 함께 적었다. 측정은 모두 시뮬레이션이고 실기로 확인한 값은 아니다.

**11-07 사용자: 링크 25 cm(허브 버전 10).** 모델과 게인은 25 cm로 옮겼고 내용은 10절에 있다. 1절 대조표는 25 cm 값이고, 3~7절의 측정값은 17.5 cm 때 값이다.

## 1. 모델: `models/wheelbiped_v5`

| 파일 | 내용 |
|---|---|
| `wheelbiped_v5.urdf`, `meshes/` | 로봇 기술. 링크 7개 + IMU, 메시는 Fusion에서 링크별로 내보낸 것 |
| `wheelbiped_v5.xml`, `scene.xml` | URDF에서 컴파일한 MuJoCo 모델(자유 관절, 모터, IMU 센서, 접촉 설정) |
| `plant_params.json` | 이 모델에서 계산한 제어기 플랜트 파라미터 |
| `description.json` | 타이어, 윤거, 모터 한계, 관절 부호, IMU 위치·방향, 게인 |

다시 만드는 순서:
1. Fusion: `v5run.save_mass_json()`(숨긴 몸체를 켠 상태), `v5run.urdf_export()` → `robot_cad_v5/calc/mass_properties.json`, `calc/urdf_data.json`, `export/links_stl/*.stl`
2. `wheeled_biped/`에서 `python -m wbr.models.build_v5`
3. 플랜트 대조: `python -m wbr.models.verify_plan4_plant --model wheelbiped_v5 --out results/wheelbiped_v5_model`

프레임: q = 0은 다리를 곧게 편 자세다. 베이스 원점은 **hip 축 중앙**(DIABLO 논문의 몸통 프레임)이고 x 앞, y 왼쪽, z 위다.
**로봇의 앞은 로커 스위치 쪽이다**(11-07 사용자). 이것은 CAD의 −x라서, 베이스 축은 CAD 축을 z축으로 180° 돌린 것이다(`R_ROBOT_FROM_CAD`). 기구는 그대로이고 로봇 기준으로 무릎이 뒤를 향한다(`KNEE_SIGN` +1).
Fusion JSON의 좌표는 CAD 좌표 그대로지만 부품 이름은 로봇 기준이다(11-08 사용자): `shell_front`는 스위치 쪽, `_L` 부품은 로봇 왼쪽(CAD −y)이다. `build_v5`는 이름과 CAD 쪽이 어긋난 JSON(허브 버전 10 이전에서 뽑은 것)이면 멈춘다.
관절 축 6개는 모두 +y라서 양의 각도가 좌우 모두 제어기의 u-규약과 같다(`JOINT_SIGNS` 전부 +1). upkie의 좌우 반대 관절과 부호표는 없다.

CAD와 대조한 값(기본 자세, `tests/test_robot_v5.py`):

| 항목 | 모델 | Fusion |
|---|---|---|
| 총 질량 | 11.5970 kg | 11.5970 kg |
| 무게중심 | (−21.29, +0.06, 409.71) mm | CAD (21.29, −0.06, 409.71)을 돌린 값 (0.01 mm 안) |
| 관성 Ixx / Iyy / Izz | 967511 / 594153 / 474998 kg mm² 근방 | 같음 (2 kg mm² 안) |
| 관절 위치 | hip (0, 543.86), 무릎 (−116.06, 322.43), 바퀴 (0, 101) mm(그리는 자세 L0 442.86) | CAD 무릎 x +116.06을 돌린 값 |

플랜트와 MuJoCo의 일치: L0 460 mm 불안정 극 6.127 / 8.014 ↔ 6.125 / 8.003 rad/s(차이 0.15 % 이하), L0 372 mm 6.326 / 8.154 ↔ 6.326 / 8.157, L0 485 mm 6.068 / 7.975 ↔ 6.068 / 7.975(`results/wheelbiped_v5_model`, `--L0 0.46 0.40 0.372 0.485`).

## 2. pi3hat의 축과 프레임

[pi3hat docs/reference.md](https://github.com/mjbots/pi3hat/blob/master/docs/reference.md)의 "Orientation":
- 원시 IMU 축: **+x CAN 커넥터·Pi HDMI 쪽, +y Pi USB 쪽, +z Pi에서 hat 쪽**
- 자세의 기준 프레임: x 앞, y 오른쪽, z 아래(FRD). 장착 각도를 안 넣으면 "Pi를 뒤집어야 roll·pitch가 0"이다.

v5에서 잰 방향(Fusion, `v5run.imu_pose()`, 커넥터 형상까지 확인):

| pi3hat 축 | CAD 축 | 로봇 기준 |
|---|---|---|
| +x (CAN·HDMI) | +x | 뒤(무릎 쪽) |
| +y (USB) | +y | 오른쪽 |
| +z (Pi → hat) | +z | 위 |

그래서 **`R_base_to_imu` = diag(−1, −1, 1)**이다(z축 180°). 예전 코드의 `diag(−1, 1, −1)`은 Pi를 뒤집어 단 upkie의 값이었다. 시뮬레이션이 같은 상수로 쓰고 읽어서 시험에서는 드러나지 않았지만,
실기에서는 수평으로 선 로봇이 롤 180°로 읽혀 바로 FAULT가 났을 값이다(`tests/test_robot_v5.py`).

hat이 위를 보는 v5는 수평일 때 보드 자세가 롤 180°로 나온다(`q ≈ (0, 1, 0, 0)`). 정상이고, `R_ars_to_world = diag(1, −1, −1)`이 이것을 수평으로 되돌린다. 보드의 요 0은 자기 +x(로봇 뒤)라서 베이스 요는 180°로 나오지만, 제어기는 롤·피치와 요 속도만 쓰므로 영향이 없다:

```
R_base_to_world = R_ars_to_world · R_imu_to_ars(보드 쿼터니언) · R_base_to_imu
```

실기 설정: `mounting_deg`는 0, 0, 0, `attitude_rate_hz`는 1000(라이브러리 기본값 400).

`images/13_imu_axes.png`에 표시했다.

## 3. IMU 위치

강체에서 **각도와 각속도는 어느 점에서나 같다.** 위치가 들어가는 것은 가속도계뿐이다: `a_imu = a_hip + α × r + ω × (ω × r)`.
DIABLO 논문에서 IMU를 hip 축 중앙에 둔 것은 몸통 프레임의 원점을 거기 잡기 위해서이고, 논문 식에도 우리 플랜트에도 IMU 위치 항은 없다.
논문이 IMU 때문에 언급한 오차는 위치가 아니라 **장착 각도**다(Fig. 9의 θ 치우침).

측정(시드 3개, 1 kHz, 지연 10 ms, 잡음 켬, 추정 오차는 50 ms 평균의 최대). 로봇 좌표로 이전 칩 위치 (−8, +68.3, −35.5) mm, 새 위치 (−0.5, −2.45, −35.5) mm, hip 중앙 (0, 0, 0):

| 보드 자세만 쓸 때 | 이전 위치 | 새 위치 | hip 중앙 |
|---|---|---|---|
| 제자리 2 rad/s: 피치 추정 오차 | 0.28° | 0.06° | 0.06° |
| 1 m/s + 2 rad/s: 피치 추정 오차 / 실제 롤 최대 | 1.56° / 1.06° | 1.78° / 1.22° | 1.78° / 1.22° |
| 밀기 0.5 W: 실제 피치 최대 | 3.44° | 3.52° | 3.54° |
| 1 m/s 출발·정지, 턱 | 차이 없음 | | |

- 새 위치와 hip 중앙은 같은 값을 낸다. 즉 높이(hip 축 아래 35.5 mm)는 영향이 없다.
- 옆(y) 오프셋의 영향은 **주행·회전 방향에 따라 부호가 바뀐다.** 스위치 쪽 앞 기준의 왼쪽 회전에서는 이전 위치가 오히려 작게 나오고(1.56°), 같은 회전을 무릎 쪽으로 주행하면 크다(앞을 무릎 쪽으로 두고 쟀을 때 2.10°, 새 위치 1.78°). 제자리 회전 오차는 위치와 함께 커진다.
- 그래서 전장 데크에서 **Pi와 pi3hat을 중심선으로 옮겼다**(`torso.centre_imu()`, `v5run.relayout()`). 방향에 따른 치우침이 없어지고, 제자리 회전 오차가 줄어든다. 높이를 hip 축까지 올리는 것은 41 mm 받침이 더 필요하고 재본 이득이 없어 하지 않았다.
- 몸통 무게중심의 옆 치우침도 CAD y −0.71 → −0.13 mm로 줄었다.

## 4. 시뮬레이션의 IMU 경로

```
MuJoCo 사이트 imu(칩 위치, 원시 축) → 자이로·가속도(지렛대 효과 포함) → 센서 잡음(자이로 0.5°/s, 가속도 0.05 m/s²)
→ pi3hat 펌웨어 필터 포팅(wbr/observers/pi3hat_ars.py, UKF 7상태, 같은 잡음 값) → 지연 10 ms → MCU
```

`wbr/plans/plan_v5.py`. 예전에는 참 자세에 흰 잡음 0.2°를 얹었다(`imu_model="ideal"`로 비교 가능). 합격기준의 흰 잡음은 Plan 4(upkie) 판정에 그대로 남겼다.

펌웨어 필터를 넣자 두 가지가 드러났다.

**가속도를 기울기로 읽는다.** 필터가 가속도계를 중력으로 본다. 수평인 몸통이 2 m/s²로 0.5 s 가속하면 1.6°(전원 켠 뒤 1분 기준) 틀어지고, hip이 그 값을 따라가 몸통이 실제로 기운다.

**회전 후 요 속도가 틀어진다.** 펌웨어에는 yaw 관측이 없어서 "요 속도 0" 가짜 측정이 z 바이어스를 끌어간다. `rate_dps`를 그대로 요 제어에 쓰면 회전이 끝나도 로봇이 계속 돈다.

## 5. MCU의 자세 추정

DIABLO 논문의 구조(III-C절 "IMU, 모터 엔코더, 모터 드라이버 정보를 쓰는 상보 필터 기반 상태 추정기")대로 MCU에 상보 필터를 넣었다. `wbr/observers/body_attitude.py`.

```
위 방향 ẑ: 자이로로 적분, 시간 상수 5 s로 (f − a_imu) 방향에 맞춤
a_imu = a_hip + α × r + ω × (ω × r)      r: hip 중앙에서 IMU까지 (여기에 IMU 위치가 들어간다)
a_hip = d/dt(v + d/dt(L0 sin θ), d/dt(L0 cos θ)), 옆으로 ω_z · v
```

충격 중에는(로봇 자체 가속도 3 m/s² 초과, 또는 보정 후 크기가 1 g에서 1 m/s² 넘게 벗어남) 가속도 보정을 건너뛰고 자이로만 쓴다.
요 속도는 원시 자이로(`rate − bias`)에서, 바퀴가 돌지 않을 때 배운 오프셋을 뺀 값이다(`McuParams.yaw_offset_tau` 20 s).

| 시드 3개, 새 위치 | 보드 자세·속도만 | **MCU 필터** | 참 자세(비교용) |
|---|---|---|---|
| 1 m/s 출발·정지: 피치 추정 오차 / 실제 피치 최대 | 1.49° / 3.92° | **0.14° / 2.56°** | — / 2.46° |
| 1 m/s + 2 rad/s: 피치 / 롤 추정 오차 | 1.78° / 1.02° | **0.13° / 0.15°** | — |
| 밀기 0.5 W: 실제 피치 최대 | 3.52° | **3.32°** | 3.37° |
| 턱 4 cm 0.5 m/s: 실제 피치 최대 | 2.76° | **1.84°** | 1.81° |
| 2 rad/s 6 s 뒤 / 30 s 뒤 남은 요 속도 | 0.157 / 0.69 rad/s | **0.000 / 0.000 rad/s** | 0.000 |

이 필터에서는 이전 위치도 hip 중앙과 같은 값을 낸다(위치를 알려 줄 때). 위치를 무시하면(r = 0) 이전 위치의 제자리 2 rad/s 피치 오차가 0.05 → 0.19°가 된다. 새 위치에서는 무시해도 차이가 없다.

실기 브리지에서 받을 값(pi3hat 라이브러리 `Attitude`, `request_attitude_detail`):
- 원시 자이로 = `rate_dps − bias_dps`, 원시 가속도 = `accel_mps2 + 9.81 × conj(q)·(0, 0, −1)`(펌웨어 `OrientationToAccel`: ARS 프레임의 위 방향을 IMU 축으로 본 값, hat이 위인 정지 상태에서 (0, 0, +1); 물리적인 아래 방향으로 넣으면 부호가 틀린다)
- 시뮬레이션의 `obs["imu"]`: `orientation`(보드 쿼터니언), `angular_velocity`(`rate`), `bias_rps`, `linear_acceleration`(원시)

지연 여유(밀기 0.25 / 0.5 / 1 W × 시드 2개, 마지막 3 s 피치 흔들림 3° 초과를 "떨림"으로 셈):

| 센서 → 토크 지연 | 10 ms | 11 ms | 12 ms | 13 ms |
|---|---|---|---|---|
| 전체 제어기, 펌웨어 필터 + MCU 필터 | 0/6 | 0/6 | 4/6 | 6/6 |
| 전체 제어기, 참 자세 + 흰 잡음 | | | 4/6 | 6/6 |
| 순수 LQR, 펌웨어 필터 + MCU 필터 | | 4/6 | 6/6 | 6/6 |
| 전체 제어기, 예전 upkie 모델 경로(`--model upkie`, 무릎 쪽이 앞) | | 0/6 | 2/6 | 6/6 |
| 순수 LQR, 예전 upkie 모델 경로 | | 0/6 | 6/6 | |

IMU 경로는 지연 여유를 줄이지 않는다(위 두 줄이 같다). 모델을 바꿔도 시작점이 12~13 ms로 거의 같다. 단계 시험은 10 ms에서 돌므로 이 절벽을 보지 못한다. 10 s 안에 넘어지지는 않았지만 12 ms부터 몸통 피치가 8~10° 폭으로 흔들리고 다리 토크 명령 `Tp`의 rms가 19~22 N·m까지 오른다.

## 6. 앞뒤 방향에 따른 차이

기구는 앞뒤가 대칭이 아니다. 같은 로봇을 양쪽 방향으로 잰 값이다(단계 4, 시드 0). 스위치 쪽 앞 기준의 주행은 **무릎이 뒤따르는** 방향이고, 2-11~2-13, 2-5의 기준을 정할 때 재지 않았던 방향이다.

| 시나리오 | 스위치 쪽으로(앞) | 무릎 쪽으로(뒤) |
|---|---|---|
| 날카로운 턱 4 cm, 0.5 m/s: 방향 최대 / 정지 뒤 방향 / 옆 이동 | 16.5° / 3.3° / 18.5 cm | 8.6° / 0.8° / 9.3 cm |
| 날카로운 턱 4 cm, 1 m/s: 방향 최대 / 옆 이동 / hip 피크 | 12.7° / 20.2 cm / 10.9 N·m | 7.0° / 10.5 cm / 4.6 N·m |
| 날카로운 턱 2 cm, 0.3 m/s: 방향 최대 | 3.5° | 2.8° |
| 경사 10° 정지(스위치 쪽이 오르막 / 내리막): 다리 길이 오차 | 1.2 mm | 0.2 mm |
| 기울기 25°에서 복귀(스위치 쪽으로 / 무릎 쪽으로): 무릎 피크 | 10.9 N·m | 4.8 N·m |

`kw_yaw`로는 앞 방향 턱을 고치지 못했다. 5배 → 7.5·10배에서 바퀴와 hip이 12.5 N·m로 포화하고 결과가 들쭉날쭉하며, 15배면 평지 회전에서도 넘어진다(`ki_yaw` 2~4배 조합 포함). 그래서 게인은 그대로 뒀다. 
### 원인 (전체 제어기, 시드 0, 코드 변경 없는 측정)

**턱의 방향 틀어짐: 무릎 쪽 기하.** 충돌 접촉 힘(4 cm 턱에서 진행 방향 뒤로 0.8, 위로 0.6)이 무릎을 접느냐, 정강이를 따라 hip으로 가느냐가 방향에 따라 다르다.

| L0 310 mm, 턱 4 cm, 전체 모델의 충격량 계산 | 무릎이 뒤따름(앞 주행) | 무릎이 앞섬(뒤 주행) |
|---|---|---|
| 접촉 힘선과 정강이의 각도 | 34° | 77° |
| 힘선에서 무릎까지 거리 | 85 mm | 170 mm |
| 1 N·s당 무릎 / hip 각속도 | 0.61 / 1.53 rad/s | 2.96 / 0.02 rad/s |

무릎이 뒤따르면 정강이가 버팀대처럼 힘을 받아 다리가 줄지 않고 다리 전체가 hip을 중심으로 돈다. 시계열(0.5 m/s)도 같다: 눌린 다리 길이 100 ms 뒤 310.0 / 302.2 mm, 바퀴가 뜬 시간 121 / 58 ms, 다시 닿을 때 수직력 121 / 92 N, 턱 오르는 시간 341 / 277 ms, 요 속도 최대 1.39 / 0.92 rad/s.

다른 후보는 하나씩 바꿔 확인했다(4 cm, 0.5 m/s, 방향 최대, 앞 / 뒤 주행).

| 바꾼 것 | 앞 주행 | 뒤 주행 | 판단 |
|---|---|---|---|
| 기준 | 16.4° | 8.5° | |
| 몸통 무게중심 +28.5 mm(양쪽 다리 기울기 1.1~1.3°로 같음) | 17.2° | 8.6° | 기울기는 원인이 아니다. 이 줄이 무릎 쪽 기하만 남긴 비교다 |
| 몸통 무게중심 +57 mm(기울기 뒤집힘) | 16.1° | 8.7° | 같음 |
| hip·무릎 회전자 관성 0 | 16.8° | 8.3° | 원인 아님 |
| hip·무릎 마찰 0 | 14.7° | 8.2° | 일부 |
| 무릎 결합 보상 끔 | 12.3° | 11.4° | 모터 반작용이 앞 주행에서는 다리를 줄여 돕고 뒤 주행에서는 늘여 방해한다. 보상이 이것을 지워 기하 차이만 남는다 |

보상을 늦춰도 해결되지 않는다: 지연 50 ms에서 14.4 / 10.1°이지만 정지 뒤 방향 2.9°, 옆 이동 16.7 cm는 기준을 넘고, 밀기 뒤 다리 길이 변화가 0.43 → 3.0 mm(기준 3)가 된다. 100 ms 이상이면 3.9 mm 이상이고 1 m/s에서 hip이 12.5 N·m로 포화한다.

**2-13의 hip 피크: 다리 벌어짐 PD의 D항.** 충격이 눌린 쪽 hip으로만 들어가 좌우 다리 각속도 차가 커진다. `tau_split` 최대 13.2(앞) / 7.5 N·m(뒤).

**2-5의 다리 길이 오차: 기울기에서의 정적 힘.** 무릎 결합 보상 문제가 아니다. 다리 무게중심이 무릎 쪽에 있어 정적 기울기가 +3.8°이고, 경사가 더해지면 스위치 쪽 오르막에서 8.9°, 내리막에서 −0.9°가 된다. 제어기는 `F_ff / cos θ`를 쓰는데, 필요한 힘은 `½ g [(m_b + m_l c') cos θ − m_l d' sin θ]`다(`d' = 0.49`: 다리 길이가 변할 때 다리 무게중심이 앞뒤로 움직인다).

| 경사 | 다리 기울기 | 측정 오차 | 위 식의 예측 | cos 항 / 다리 무게중심 항 |
|---|---|---|---|---|
| +10° | 8.9° | +1.20 mm | +1.43 mm | +0.47 / +0.82 |
| +5° | 6.4° | +0.77 mm | +0.92 mm | +0.23 / +0.57 |
| 0° | 4.1° | +0.26 mm | +0.52 mm | +0.12 / +0.41 |
| −5° | 1.5° | +0.07 mm | +0.17 mm | +0.02 / +0.18 |
| −10° | −0.9° | −0.23 mm | −0.09 mm | 0.00 / −0.07 |

한계: 타이어가 단단한 타원체라 충돌 크기는 실물과 다를 수 있다. 위 비교는 전체 제어기, 시드 하나다.

### 수정 (11-07, 전체 제어기, 시드 5개)

1. **다리 정적 힘**: `SerialPlant.static_leg_force(L0, θ)`(위 식, 표에서 c', d'를 L0별로 읽음)가 `F_ff / cos θ`를 대신한다(`PlanV5Config.exact_leg_force`, Plan 4는 그대로).
2. **벌어짐 PD 80 / 2**(`ake_cad.SPLIT_KP`, `SPLIT_KD`, 전 60 / 3, Plan 4는 그대로). D를 낮추면 hip 피크가 줄고, P는 낮추면 안 된다. 벌어짐 모드는 로봇 무게가 얹혀 중립에 가깝다: 회전 중 벌어짐이 kp 100에서 1.8°, 80에서 2.4°, 60에서 3.4°, 50에서 5.7°이고 30에서는 85° 넘게 벌어지며 20에서는 넘어진다. 처음 생각한 절반(30 / 1.5)은 쓸 수 없는 값이었다.

| 지표 | 전 | 후 | 기준 |
|---|---|---|---|
| 2-5 경사 10° 다리 길이 오차 | 1.16~1.30 mm | **0.12~0.28 mm** | ≤ 1 |
| 2-1 웅크림 / 복귀 다리 길이 오차 | 0.64~0.73 / 0.46~0.51 mm | 0.01~0.06 / 0.01~0.07 mm | ≤ 3 |
| 2-4 좌우 다리각 차 | 3.4° | 2.4° | ≤ 5 |
| 2-6 밀기 뒤 다리 길이 변화 | 0.39~0.43 mm | 0.57~0.63 mm | ≤ 3 |
| 2-12 방향 최대 | 15.2~16.5° | 14.5~15.0° | ≤ 15 |
| 2-12 정지 뒤 방향 / 옆 이동 | 3.1~3.3° / 17.2~18.5 cm | **2.9~3.1° / 16.8~17.2 cm** | ≤ 2 / 15 |
| 2-13 방향 최대 | 12.5~12.9° | 11.9~12.1° | ≤ 12 |
| 2-13 정지 뒤 방향 | 2.1~2.2° | 1.6° | ≤ 2 |
| 2-13 옆 이동 | 20.1~20.5 cm | **17.9~18.2 cm** | ≤ 15 |
| 2-13 다리 토크 피크 / 피치 | 10.4~11.0 N·m / 5.8~6.0° | 7.7~7.9 N·m / 5.4~5.6° | ≤ 10 / 6 |
| 벤치 기울기 25° 무릎 피크(로봇) | 10.52 N·m | 9.40 N·m | |

이 표는 7절의 서스펜션·감속을 넣기 전 값이다. 넣은 뒤의 값과 다시 정한 기준은 `v5_lqi/TEST/README.md` 5절에 있다.

## 7. 과속방지턱: 서스펜션과 감속 (11-07 사용자: 속도보다 안정성, 부드럽게, 다리가 턱에 순응)

턱 모양은 `v5_lqi/TEST/README.md` 3절. 전체 제어기, 시드 0, 한쪽 바퀴.

**다리.** 이전에는 평균 다리 길이를 유지해서 한쪽 바퀴가 올라가면 몸통도 턱 높이의 절반만큼 들리고 반대쪽 다리가 늘어났다. 이제 긴 쪽 다리의 길이를 유지한다(`McuParams.suspension`). 턱에 오른 다리는 밀어내는 힘 없이 접히고 몸통 높이는 거의 그대로다. 다리별 댐퍼(`kd_leg_own`)가 바퀴 튐을 막는다. 다리 차가 50 mm를 넘으면 반대쪽 다리도 서서히 함께 움직여(`suspension_share`) 어느 쪽도 범위 끝에 갑자기 닿지 않는다. 벽은 기존의 절반으로 무르게 했다(`LEG_WALL_SCALE`).

| 턱 높이(0.3 m/s) | 4 cm | 6 cm | 8 cm | 10 cm | 12 cm | 14 cm | 16 cm | 18 cm | 20 cm |
|---|---|---|---|---|---|---|---|---|---|
| 롤 피크 | 0.11° | 0.16° | 0.26° | 0.32° | 0.36° | 0.46° | 1.96° | 4.13° | 6.37° |
| 턱 위 평균 롤 | 0.04° | 0.04° | 0.07° | 0.09° | 0.12° | 0.22° | 1.38° | 3.35° | 5.49° |
| 몸통 상승 | 2 mm | 2 mm | 8 mm | 15 mm | 22 mm | 32 mm | 42 mm | 51 mm | 60 mm |
| 다리 토크 피크 | 4.6 | 5.1 | 5.7 | 6.1 | 6.6 | 8.0 | 8.9 | 9.2 | 9.4 N·m |

이전 방식: 10 cm 롤 0.84°, 상승 31 mm / 14 cm 2.75°, 43 mm / 20 cm 11.6°, 74 mm. 명령 1 m/s에서는 20 cm 롤 6.36°, 다리 토크 9.8 N·m, 완전 신장 여유 4.7 mm(권장 5 mm보다 약간 작다). 넘어지거나 무릎이 꺾인 경우는 없다.

**20 cm가 완전히 수평이 되지 않는 이유.** 수평이려면 다리 길이 차가 200 mm여야 하는데 쓸 수 있는 범위가 약 144 mm(200~344 mm)다. 남는 56 mm가 윤거 540 mm에 대해 약 6°다.
- 무릎을 더 펴도 효과가 작다. 거의 펴진 다리는 무릎 각도가 크게 변해도 길이가 조금만 변한다(339 mm 29°, 345 mm 19°, 349 mm 9°, 350 mm 0°). 349 mm까지 펴도 롤은 6.6°에서 5.8°다. 벽을 344 mm 이상으로 두면 무릎이 반대로 꺾였다.
- 더 짧게 접는 쪽(200 mm 아래)은 Fusion 간섭 검사 범위 밖이라 쓰지 않았다.

**반대쪽 다리의 움직임.** 긴 쪽 다리는 기준을 2~25 ms 지연으로 따라간다. 늦어 보이는 것은 제어 지연이 아니라 필요할 때까지 움직이지 않게 설계했기 때문이다. 눌린 다리가 80 mm 접혔을 때 8 mm, 110 mm일 때 19 mm, 130 mm일 때 26 mm 움직인다.

**속도.** 다리 길이 차가 5 mm를 넘는 순간부터 제한이 내려와 30 mm에서 0.2 m/s가 된다(`uneven_speed`, `uneven_d0`, `uneven_d1`). 기준은 0.8 m/s²로, 0.2 s 필터를 거쳐 내려가고(`uneven_brake`, `uneven_brake_tau`), 다리를 그만큼 뒤로 기울인다(`uneven_lean`: 균형 로봇은 기울어야 감속한다). 다리 차가 없어지고 0.5 s 뒤 1 m/s²로 돌아온다. 주행 중 다리 차가 있는 동안 위치·기울기 적분을 멈춘다(`uneven_hold_int`): 멈추지 않으면 늦어진 만큼 따라잡으려고 0.5 m/s로 다시 가속했다.

| 명령 1 m/s | 10 cm | 14 cm | 20 cm |
|---|---|---|---|
| 턱 위 속도 | 0.81 m/s | 0.68 m/s | 0.46 m/s |
| 감속도 최대 | 0.77 m/s² | 0.64 m/s² | 0.74 m/s² |

명령 0.5 m/s, 10 cm에서 턱 위 속도는 0.22 m/s다. 턱에 올라선 뒤에야 알 수 있어 빠르게 들어오면 짧은 턱 위에서는 충분히 줄지 않는다. 그래도 10 cm에서 롤 0.42°, 몸통 상승 19 mm로 흔들림은 작다. 양쪽 바퀴가 함께 넘는 턱은 다리 차가 없어 이 동작이 걸리지 않는다(서스펜션 전 측정: 20 cm, 0.3 m/s에서 롤 0.03°, 피치 4.1°).

날카로운 턱에는 불리한 점도 있다. 4 cm 턱을 0.3 m/s로 들어가면 바퀴가 끼여 방향이 44° 틀어진다(이전에도 같음, 시험 범위 밖).

## 8. upkie 값 점검표

| 항목 | 예전 | 지금 |
|---|---|---|
| 모델 | upkie URDF의 링크를 늘리고 질량을 덮어씀(몸체 34개 +34 g, upkie 충돌 상자) | v5 URDF |
| 관절 부호 | `UPKIE_JOINT_SIGNS` | 전부 +1 |
| 베이스 원점 | upkie `base` | hip 축 중앙 |
| IMU 회전 | `diag(−1, 1, −1)` | `diag(−1, −1, 1)`(Fusion 측정 + 앞이 스위치 쪽, URDF `imu_fix`) |
| IMU 위치 | `base` 사이트, 효과 없음 | 칩 실제 위치, 필터에 사용 |
| 자세 입력 | 참값 + 흰 잡음 | 펌웨어 필터 → MCU 상보 필터 |
| 바닥에 닿는 부분 | upkie 발목 상자(약 57 mm) | 바퀴 모터 하우징 r 46.4(바닥에서 54.6 mm), 링크 치수 |
| 모터 한계 | upkie 값 패치 | AKE60-8 12.5 N·m(`description.json`) |
| LQR 토크 가중치 | upkie 한계 × 질량·반경 비 | `m g R`의 11.6 %, `m g × 0.31 m`의 29.6 %(10절) |
| 적분 멈춤 토크 | 2 × 6.3 / 2 × 32.9 N·m(upkie 환산) | 2 × 12.5 N·m(모터 피크) |
| 요·다리 길이 게인 | upkie 값 × 환산비 | 대역폭 상수 `YAW_WC` 10.06, `LEG_WN` 23.93 rad/s 등(값은 거의 같다) |
| 마찰 보상 | upkie 0.08 / 0.016 N·m | AKE60 추정 백드라이브의 0.8배 |
| 다리 벌어짐 PD 60 / 3 | upkie 튜닝 | 80 / 2 × 링크 길이 비(v5에서 측정해 결정, 6·10절) |
| 다리 정적 힘 | `F_ff / cos θ` | `static_leg_force(L0, θ)`(v5 플랜트, 6절) |
| 관절 점성 0.02 / 0.001 | upkie 값 | **유지(가정)**: AKE60 자료가 없다 |
| L_min 240, L_max 335 | upkie에서 온 값 | 링크 길이에서 계산(`build_v5.leg_range`, 372 / 460 / 485 mm, 10절), CAD 간섭 검사 범위(286~479 mm와 460·372 mm) 안 |
| 엔코더 14비트 | 설계 보고서 값 | **유지**: 실제는 로터 14비트 + 8:1이라 더 좋다(보수적) |

코드에 upkie 이름이 남은 곳은 하네스 클래스 상속(`PlanV5` ← `Plan4LQI8`), 파라미터 계산 함수 위치(`wbr/models/upkie_params.py`)다. v5 경로에서 upkie 값은 쓰지 않는다(`tests/test_robot_v5.py`가 확인).
Plan 2·4 기본값 궤적은 이번 변경 전과 차이 0.0이다. v2~v4 CAD와 `--model upkie`는 예전 경로로 그대로 돈다.

## 9. 실기로 확인할 것

- 타이어는 단단한 타원체이고 점으로 닿는다. 날카로운 턱의 끼임 결과는 실제와 다를 수 있다.
- 자이로 바이어스 잔차를 넣지 않았다(보드가 수렴했다고 가정). 전원을 켠 직후에는 필터가 더 흔들린다(가속 0.5 s에 10초 뒤 2.9°, 1분 뒤 1.6°, 15분 뒤 0.9°).
- 데크(PETG)의 진동은 모델에 없다. 몸통이 강체라는 가정에서 나온 결과다.
- r4.5 IMU 위치는 `hw/r4.5/pi3_hat.brd`의 값이다. 모델의 hat STEP은 커넥터 배치가 r4.1~r4.4 것이어서 JC3~JC5 자리가 실물과 몇 mm 다르다. BMI088(U8)과 ICM-42688(U14) 중 어느 칩이 실렸는지는 실물에서 확인한다(시뮬레이션은 BMI088, 두 자리 차이 5 mm).
  - **2026-11-14 실물 확인: ICM-42688-P(U14)가 실렸고 BMI088 자리(U8)는 비어 있다.** 근거는 칩 윗면 표기 `I428P`(TDK 데이터시트 11절의 ICM-42688-P 표기)와 IMU 주기다. `pi3hat_tool`의 400 Hz 요청이 1000 Hz로 올라갔는데, 이 칩의 주기 표에는 200 Hz 다음이 1000 Hz다(`fw/icm42688.cc:184-196`). 그래서 이 보드에서 쓸 수 있는 IMU 주기는 100 / 200 / 1000 Hz이고, 설정 `attitude_rate_hz = 1000`은 그대로 맞다.
  - **남은 일(시뮬레이션은 아직 BMI088 자리):** `wbr/models/build_v5.py`의 `IMU_CHIP`를 `"ICM42688"`로 바꾼다 → `python -m wbr.models.build_v5` → `python -m unittest discover -s tests` → `python v5_lqi/TEST/run_stages.py --stage 4 --keep-going` → 결과 비교 뒤 커밋. IMU는 로봇 축으로 (+1.0, +4.9, 0) mm 옮겨지므로 결과 차이는 작을 것으로 본다. 2026-11-14 Windows PC에서 시도했지만, 스마트 앱 컨트롤이 `mujoco\_structs.cp314-win_amd64.pyd`를 막아 하지 못했다(사용자: 데스크톱에 Ubuntu를 설치한 뒤 다시 한다).
- 25 cm PETG 링크의 옆 휨(10절). 롤 대역을 올리기 전에 실물에서 확인한다.

## 10. 링크 25 cm (11-07 사용자, 허브 버전 10)

허벅지 = 정강이 = 250 mm, 11.597 kg, 무게중심 높이 409.7 mm(L0 442.86 기준). upkie·v2~v4 경로는 바뀌지 않았다(단위 테스트 131개 통과).

| 항목 | 17.5 cm | 25 cm | 코드 | 이유 |
|---|---|---|---|---|
| 기립 / 최저 / 최고 다리 길이 | 310 / 240 / 335 mm | **460 / 372 / 485 mm** | `build_v5.leg_range` | 완전 신장에서 같은 거리(40, 15 mm). 최저는 짐 5 kg 정지 무릎 10 N·m가 되는 자세 |
| 한쪽 다리 벽 | 208 / 337 mm | 326 / 485 mm | `PlanV5Config.L_min_margin`, `L_max_margin` | 20 cm 턱에서도 완전 신장까지 5 mm 이상 |
| 게인 표 범위 | 220 ~ 340 mm | 312 ~ 497 mm | `build_v5`, `PlanV5._lqi_design` | 다리 길이 범위를 덮도록 |
| LQR hip 가중치 | `0.296 m g L0` | **`0.296 m g × 0.31 m`** | `ake_cad.LQR_R_HIP_ARM` | hip은 몸통을 움직이고 몸통 관성은 그대로다. L0에 비례시키면 hip 루프가 빨라져 지연 10 ms에서 13~14 Hz로 떨렸다(28개 중 8개 회복) |
| 다리 벌어짐 PD | 80 / 2 | **114.3 / 2.86** | `ake_cad.v5_gains` | 벌어짐 모드의 음의 강성이 무게 × 다리 길이에 비례 |
| 롤 대역 | 34 rad/s | **17 rad/s** | `ake_cad.V5_ROLL_WN` | PETG 옆 휨(아래) |

나머지 게인은 같은 식으로 새 모델에서 다시 계산된다: 요 PI 1.76 / 10.58, `kw_yaw` 8.82, 다리 길이 PD 1503 / 75, 롤 577 / 346 / 71.9. 전체 값은 `models/wheelbiped_v5/description.json`이고, **실기 MCU에도 같은 값을 넣어야 한다.**

**벤치(`results/ake_cad_v5`, 시나리오 28개, 잡음):**

| 경우 | 지연 | 회복 | 최대 토크 hip / 무릎 / 바퀴 [N·m] | 무릎 정지 토크, 최저 / 기립 |
|---|---|---|---|---|
| 로봇만 | 2 ms | 27 (밀기 1.5 W 넘어짐) | 12.50 / 11.88 / 10.47 | 5.85 / 3.47 |
| 로봇만 | 10 ms | 27 (같음) | 12.50 / 12.02 / 9.75 | 5.86 / 3.47 |
| 로봇만 | 12 ms | 27 (같음) | 12.50 / 12.50 / 9.75 | 같음 |
| 로봇만 | 14 ms | 14 (hip 떨림) | 12.50 / 12.50 / 9.75 | 같음 |
| 짐 5 kg | 2 ms | 28 | 12.50 / 12.50 / 12.50 | 10.03 / 5.90 |
| 짐 5 kg | 10 ms | 27 (밀기 1.5 W 넘어짐) | 12.50 / 12.50 / 12.50 | 10.02 / 5.90 |

17.5 cm는 모두 회복했고 로봇만 지연 12 ms 25개, 14 ms 9개였다. 지연 여유는 오히려 늘었고, 잃은 것은 무게의 1.5배 밀기다. 짐 5 kg 기립 무릎 5.90 N·m는 정격 5 N·m를 넘는다.

**PETG 옆 휨.** MuJoCo 링크는 강체라서 옆 휨이 없다. hip에 x축 힌지를 넣어 접지점 옆 강성을 맞췄다(`calc/strength_v5.py`로 0.09 mm/N, 감쇠비 2 %, 제어기는 모른다). 무릎 rms / 피크 [N·m], 지연 10 ms:

| 롤 대역 | 휨 | 기립 460 | 중간 416 | 최저 372 | 회전 1 rad/s | 0.5 W 밀기 |
|---|---|---|---|---|---|---|
| 17 | 없음 | 3.46 / 3.8 | 4.94 / 5.3 | 5.93 / 6.4 | 4.13 / 6.0 | 3.44 / 7.3 |
| **17** | **0.09** | **3.46 / 3.8** | **4.92 / 5.3** | **5.91 / 6.5** | **4.02 / 5.2** | **4.65 / 7.9** |
| 24 | 0.09 | 3.47 / 3.9 | 6.92 / 10.8 | 8.12 / 12.5 | 4.84 / 8.1 | 4.77 / 8.0 |
| 34 | 0.09 | 4.90 / 8.0 | 7.12 / 11.4 | 8.24 / 12.5 | 5.00 / 8.2 | 4.95 / 11.1 |

힌지 하나는 대략적인 대용품이다. 약 40 Hz로 몸통이 다리 위에서 까딱이는 모드가 나오는데 실제 링크와 같은 모드라고 볼 근거는 없다. 17.5 cm도 이 힌지를 넣으면 턱 시험의 롤이 나빠지므로(4 cm 턱 0.8~1.2°) 절대값이 아니라 대역 사이의 비교로만 썼다.

**단계 시험**은 일부 기준을 넘는다. 표와 이유는 `v5_lqi/TEST/README.md` "링크 25 cm 결과". 기준은 바꾸지 않았다.
