wisehyun-2/my_robot_project/wheeled_biped/docs/HANDOFF.md

# 인수인계: Windows 세션 → 우분투(듀얼부팅)에서 이어가기

작성 2026-10-22, 갱신 2026-10-23(Plan 4), 2026-11-11(Plan 1·2·3의 코드·모델·벤치마크·ROS 2 패키지 삭제 — 사용자 결정, ROS 2는 TITA 구조로 새로 짬; 결과와 보고서는 기록으로 남김; 균형 제어기 이름은 LQI8). 이 문서는 Windows PC의 Claude Code 세션에서 한 일과, 우분투에서 Claude Code로 이어갈 때 필요한 것을 정리한 것이다. 대화 기록 요약본은 `docs/session_log_2026-10-21.md`, 기술 결론은 `docs/비교보고서.md`(Plan 4는 11절), 독립 검토는 `docs/review_opus*.md`·`docs/review_plan4_r*.md`에 있다.

## 0. 최종 확정안 (2026-10-22)

**Plan 4 = upkie 하드웨어(직렬 무릎 다리, qdd100 ×4 + mj5208 ×2, 112 mm 타이어) + LQI8 균형기 + DIABLO식 호스트/MCU 분리.** 2단계로 호스트 MPC 기준 생성기를 LQI8 위에 둔다. 라이다·카메라·SLAM·로봇팔 2개는 균형 제어가 실기에서 안정된 뒤에 붙인다(그때 팔 관절 질량 피드포워드, 롤 보상, Jetson 호스트, 3D 라이다 관성 오도메트리가 필요).

핵심 문서: `docs/합격기준.md`(사용자가 정한 시뮬 합격 기준), `docs/plan4_model.md`(플랜트 유도·MuJoCo 대조), `docs/plan4_lqi8.md`(제어기·합격 판정 결과), `docs/plan4_mpc_host.md`(2단계).

## 1. 한 일 (상태)

| 항목 | 상태 | 위치 |
|---|---|---|
| ROS 비의존 코어 `wbr`(MuJoCo 백엔드, LQI8 + 직렬 다리 VMC, DIABLO MCU/호스트 링크 에뮬레이션, pi3hat 필터 포팅·MCU 자세 필터, 합격 판정·단계 시험, 라이브 뷰어, 영상) | 완료, Windows에서 검증 | `wbr/` |
| 로봇 모델: **upkie_plan4(타이어 0.056 = BOM 112 mm)**, v5 로봇 `wheelbiped_v5`(Fusion에서 뽑음) | 완료. Plan 1의 upkie(타이어 0.05)와 DIABLO-lite 6 kg 모델은 2026-11-11 삭제 | `models/`, `wbr/models/` |
| Plan 1/2/3 조립과 벤치마크 | 완료(비교보고서 0~10절) 뒤 2026-11-11 코드 삭제(git 이력). 결과·보고서만 남김 | `results/bench`, `docs/비교보고서.md` |
| **Plan 4**: 직렬 다리 기구학(`serial_leg.py`), 3체 플랜트 라그랑지안 유도·선형화(`plant_serial.py`), 파라미터 표(`upkie_params.py`), MuJoCo 대조(`verify_plan4_plant.py`), 조립(`plans/plan4_lqi8.py`), 합격 판정 배터리(`bench/acceptance.py`) | 완료, Windows에서 검증. 모델은 `models/upkie_plan4`(112 mm 타원체 타이어) | `wbr/`, `docs/plan4_*.md`, `results/acceptance/` |
| 2단계 호스트 MPC(`wbr/controllers/mpc_host/`) | 완료(검토 2라운드 반영판): 두 주기 모두 19~23 통과(19번 정지 최대 이탈 여유 ×0.99 — 넘김 1.0 s·제동 1.17배로 맞춤), 24번 기록 통과 | `docs/plan4_mpc_host.md` |
| Plan 4 합격 판정(전체 매트릭스, 캐시 `r5_s1`·`r5_s2`, 코드 해시 345db37b94) | **두 주기 모두 합격**: 1단계 1~13·16·17 통과(16·17은 2026-10-23 사용자 위임 결정 — 드리프트 x(0) 기준·10 cm, 합격기준 6.3: 7.2~8.7 cm), 2단계 19~23 통과; 15번 기록 20/25 ms(강건 여유 12/15 ms) | `results/acceptance/` |
| 독립 검토 | 1라운드(Opus 5.5 ×2) major 10건, 2라운드 major 5건 전부 반영(`docs/review_plan4_r1_response.md`, 1·2라운드 절); 3라운드(축소: 반영 추적·재현) `docs/review_plan4_r3.md`·`review_plan4_mpc_r3.md` | `docs/` |
| Plan 2 15 kg 모터 토크 산정(2026-10-23, qdd100 품절로 Plan 2 재검토) | 완료(시뮬): 권장 hip ×4 정격 ≥ 10·최대 ≥ 20 N·m, 바퀴 ×2 정격 ≥ 2.5·최대 7~8 N·m·≥ 60 rad/s(R 65 mm). 확정안은 아직 Plan 4. 계산 코드(`wbr/bench/torque_sizing.py`)는 2026-11-11 Plan 2와 함께 삭제 | `docs/plan2_15kg_torque_sizing.md`, `results/torque_sizing/` |
| 사용자 제작안 AKE 모터 점검(2026-10-25, upkie 다리 + 몸통 2.5 kg, 전체 4.88 kg, hip·knee AKE50-8 / 바퀴 AKE60-8) | 완료(시뮬, Plan 4 LQI8): AKE50-8 사용 가능(무릎 최저 자세 정지 유지가 정격의 81 %로 연속 여유 작음), AKE60-8 바퀴 지름 125~400 mm 사용 가능·권장 150~300 mm(112 mm는 속도 부족으로 1.5 W 밀기 실패). upkie 다리 배치 그대로면 바퀴(다리 안쪽)가 Ø250부터 무릎 모터 브래킷에 닿아 실제 권장은 150~240 mm | `docs/ake_motor_sizing.md`, `wbr/bench/ake_sizing.py`, `results/ake_sizing/` |
| 단위 테스트 | `python -m unittest discover -s tests`. 2026-11-11 Plan 1~3 시험을 빼고 `test_core.py`(MuJoCo 없이 도는 10개)의 LQI8 시험을 v5 플랜트로, MCU 시험 2개(변신 거부, 연결 끊김 뒤 모터 끄기)를 `test_plan4.py`로 옮김 | `tests/` |
| ROS 2 Jazzy 패키지(메시지 3종, upkie 4패키지, diablo_lite 4패키지) | Plan 1·2용으로 작성만 하고 빌드하지 않은 채 2026-11-11 삭제. 실기용은 TITA `ros2_control` 구조로 새로 짬(`ros2_ws/README.md`) | `ros2_ws/README.md` |

## 2. 우분투에서 할 일 (순서대로)

1. 환경: Ubuntu 24.04 + ROS 2 Jazzy desktop, `git clone https://github.com/wisehyun-2/my_robot_project`, NVIDIA 드라이버(RTX 5080은 570 이상, 오픈 커널 모듈 권장).
2. 파이썬: `ros2_ws/README.md` 1절의 (a) 방식 — `python3 -m venv --system-site-packages ~/wbr_venv && source ~/wbr_venv/bin/activate && pip install -e wheeled_biped`. (`qpsolvers`, `daqp`, `osqp`, `qpmpc`, `sympy`, `imageio[ffmpeg]`도 필요.)
3. 코어 확인(ROS 없이): `cd wheeled_biped && python -m wbr.models.build_upkie --out models/upkie_plan4 --tire-radius 0.056 --tire-shape ellipsoid --tire-condim 4 && python -m wbr.models.upkie_params && python -m wbr.models.build_v5 && python -m unittest discover -s tests && python -m wbr.viewer.live --plan 4 --noise --latency-ms 10`. 합격 판정 재현: `python -m wbr.bench.acceptance --rate both --matrix full --seeds 5`(8분, 12프로세스; upkie PI 참고 열 `--reference`는 Plan 1과 함께 2026-11-11 삭제) 뒤 `python -m wbr.bench.acceptance --host mpc --stage2 --rate both --matrix full --seeds 5`(10분; 20번이 1단계 JSON을 읽는다). v5 로봇: `python v5_lqi/TEST/run_stages.py --stage 4 --keep-going`.
4. ROS 2(2026-11-12부터 브랜치 `ros2-v5`, 준비 순서·결정·구조 안·작업 순서는 `ros2_ws/README.md`): 이 저장소의 옛 패키지(Plan 1·2용)는 2026-11-11 삭제했다. 실기용은 TITA `ros2_control` 패키지 구조(Jazzy, 2026-11-08 결정)를 가져와 균형 제어기 자리만 `wbr` 이식으로 바꾼다 — 이식 대상은 `wbr/controllers/diablo_arch/mcu.py`, `wbr/controllers/lqi8/`, `wbr/observers/body_attitude.py`, 하드웨어 인터페이스는 pi3hat·moteus, URDF는 `models/wheelbiped_v5`(`ros2_ws/README.md`).
5. 지연 예산: ROS 경로를 거칠 때 지연·지터가 지연 허용(Plan 4: 설계 10 ms; 강건 여유 1 kHz 12 ms·200 Hz 15 ms, 3° 무노이즈 기준 시험 20/25 ms — 합격 판정 15번과 `docs/plan4_lqi8.md` 2절 12; v5는 `docs/robot_v5_model.md` 5절, 12 ms부터 떨림)의 몇 %인지 측정한다.
6. (선택) Isaac Sim 5.x로 `models/upkie_plan4/upkie.xml`(또는 upkie URDF) 교차 검증.
7. 실기 전: 설계보고서 §4.6 절차(파라미터 측정 → `wbr/models/upkie_params.py` 재생성 또는 `models/upkie_plan4/plan4_params.json` 교체 → 게인 자동 생성 → 매달기 테스트 → 저게인 착지). 실기에서 확정할 것: qdd100 연속 토크(합격기준 1절), 관절 건마찰 크기(마찰 보상 파라미터 `friction_comp_Nm`), 112 mm 타이어 사용 여부(100 mm면 발목 하우징이 7°에서 바닥에 닿음), 드라이버 피드백 타임아웃.

### 2.1 실기 이식 체크리스트 (검토 1라운드 반영, 2026-10-23)

검토 문서 `docs/review_plan4_r1.md`·`review_plan4_mpc_r1.md`와 응답 `docs/review_plan4_r1_response.md`의 실기 관련 항목이다. 시뮬에서 검증한 것과 실기에서 반드시 확인할 것을 나눈다.

**시뮬에서 이미 들어간 보호(그대로 가져갈 것)**
- 센서 가드(`DiabloMcu.estimate`): 비유한 쿼터니언/자이로/관절값은 추정값 유지 → 5주기 넘으면 FAULT; 시간 스탬프가 50 ms 멈추면 FAULT; 비유한 토크 명령은 0 + FAULT + 이벤트. 실기에서는 관측 dict의 `time`에 스파인의 표본 시각을 넣어야 정지 감시가 작동한다.
- IMU 관례 어댑터: MCU가 upkie `BaseOrientation`과 같은 변환(`imu_rotation_base_to_imu` = diag(−1, 1, −1), `imu_rotation_ars_to_world` = diag(1, −1, −1))을 쓴다. 스파인의 `imu.orientation`(ARS 좌표 IMU 자세)과 `imu.angular_velocity`(IMU 좌표)를 그대로 넣으면 된다. 실기의 IMU 장착 회전이 URDF와 다르면 `rotation_base_to_imu`를 URDF에서 다시 읽어 넘길 것.
- 피치·롤 34° FAULT, 호스트 링크 타임아웃 500 ms → 단절 프로그램(속도·요 0, 자세 유지).

**실기에서 확인할 것(순서대로)**
1. **첫 매달기 시험에서 부호 확인**: 로봇을 들고 앞으로 기울이면 `est.pitch` > 0, 오른쪽으로 기울이면 `est.roll` 부호가 롤 PI의 다리 길이 보정 방향(오른쪽 다리 신장)과 맞는지, 왼쪽으로 돌리면 `est.yaw_rate` > 0인지 각각 확인한다. 셋 중 하나라도 뒤집히면 롤·요 루프가 양의 되먹임이 된다(검토 M3).
2. **무장 해제 시작**: 실기 진입점은 `mcu.reset(mode, armed=False)` 뒤 직립 확인 후 `arm()`을 부른다(시뮬 하네스는 `armed=True`). 들림(바퀴 접지 상실) 감지와 관절 한계 FAULT는 아직 없다 — 균형 코드 바깥의 안전 루프(모터 전원 차단 스위치)를 먼저 둘 것.
3. **마찰 보상은 0에서 시작**: 시뮬 값 0.08/0.016 Nm는 모델의 건마찰(0.1/0.02 Nm)의 80 %다. 실기 관절 마찰을 재고(`friction_comp_Nm`, `friction_comp_wheel_Nm`) 0부터 올린다. 피치 속도 게이트(`friction_comp_rate_gate` 0.1 rad/s)는 유지.
4. **지연 예산**: 설계 지연 10 ms. 강건 여유(노이즈·2 mm 낙하·0.5 W 밀기)는 1 kHz 12 ms, 200 Hz 15 ms이고 그 위에서는 ±3° 13 Hz 한계 사이클 → 전복이다. 실기 루프 지연(IMU 필터 + CAN + 제어 주기)을 재서 10 ms 안인지 확인한다. 넘으면 10 ms 예측기(`predict_ms`, 밀기 피치 2배 비용) 또는 게인 재설계.
5. **MPC 호스트 텔레메트리**: 호스트는 `est.v`(지상 속도)와 `est.v_ref`(MCU 자체 기준)를 쓴다. 실기 50 Hz 텔레메트리 형식을 정한 뒤 관측기 잡음(`obs_sigma_v`)과 예측 모델의 지연(`plan.cfg.latency_ms` 대신 측정 지연)을 다시 맞춘다.
6. **타이어 접촉**: Plan 4 모델은 타원체 타이어 + condim 4(비틀림 마찰 0.005). 제자리 회전 바퀴 전류를 재서 9번 요 항목의 유지 토크(시뮬 0.08~0.11 Nm rms)와 비교한다.
7. **관측 시각과 서보별 신선도**: MCU의 정지 감시는 관측 dict의 `time`만 본다. 실기 진입점에서 `time`은 필수(없으면 감시가 꺼진다 → 진입점에서 FAULT 처리)이고, 시각은 진행하는데 특정 서보만 마지막 값을 되돌려 주는 드라이버(응답 누락)는 검출하지 못하므로 moteus 응답 카운터나 서보별 표본 나이 감시를 진입점에 둘 것(2라운드 검토 m7).
8. **바퀴 관성**: 시뮬의 바퀴 로터 아마추어 J_w는 MuJoCo 의미론(관절 속도)이다. 실기에서는 바퀴+로터 관성을 통째로 재서 I_w에 넣고 J_w = 0(`docs/plan4_model.md` 2절).
9. **저마찰 바닥**: 20° 기울기(4번)는 μ0.5에서 세 질량 모두 전복한다(바퀴 접지 한계). 실기 저마찰 바닥에서 큰 기울기 시험은 피한다.
10. **마찰 보상의 게이트는 필수**: 보상(3번 항목)을 켜면 피치 속도 게이트(`friction_comp_rate_gate` 0.1 rad/s)도 켜 둘 것 — 게이트 없이는 0.75 W 밀기 복귀의 바퀴 rms가 0.21 Nm(기준 0.2)로 실패했다.
11. **호스트 패킷**: MCU 링크는 비유한 필드가 있는 MotionCtrl을 거부하고(이벤트), 계속되면 500 ms 타임아웃으로 단절 프로그램에 들어간다. 호스트 쪽에서도 송신 전 유한성 검사를 둘 것.
12. **기동 시 영점 보정(16·17 대응)**: 로봇을 세워 놓고(또는 거치대에서) 2~3 s 정지한 뒤 ① IMU 피치 바이어스 = 엔코더 다리각 θ + φ로 추정한 정적 기울기와 IMU 피치의 차, ② 탑재물·무게중심 오프셋 = 정적 엉덩이 토크 (Tp − Tp_ff)의 평균을 저장해 Tp_ff와 IMU 영점에 더한다. 시뮬 판정의 16·17은 보정 없이 10 cm 이탈 안에서 서는 것을 보장하는 상한 시험이다(합격기준 6.3).
13. **MPC 호스트의 명령 지연**: 호스트 → MCU 명령 경로 지연이 10~20 ms만 있어도 19번 정지 거리가 0.30~0.31 m로 늘어난다(2라운드 검토 m7). 실기 지연을 재서 `MpcConfig.model_extra_latency_ms`에 넣고(예측 모델의 **기준 입력에 순수 지연**으로 들어간다, MCU 스텝 단위; 3라운드 검토 m1 — 전에는 관측 지연에 더해져 10 ms 이상이면 내부 루프 모델이 불안정 판정을 받아 MPC가 꺼졌다) 제동 계수(`decel_factor`)를 다시 맞춘다. 정지 넘김은 목표 0 뒤 1.0 s 이상 지났고 텔레메트리 속도 < 0.05 m/s일 때(최대 3 s)이므로 실기 텔레메트리에는 `est.v`가 꼭 실려야 한다(3라운드 m2). 50 Hz 단일 표본 텔레메트리·텔레메트리 20 ms 지연·`v_ref` 부재는 영향이 작다.

## 3. 우분투에서 Claude Code에 줄 첫 메시지(예시)

```
이 저장소의 CLAUDE.md와 wheeled_biped/docs/HANDOFF.md, docs/비교보고서.md(11절), docs/plan4_lqi8.md, docs/합격기준.md를 읽고,
HANDOFF.md 2절의 순서대로 우분투에서 코어 확인 뒤 TITA ros2_control 구조로 ROS 2 Jazzy 패키지를 만들어줘. v5 로봇(LQI8)부터.
```

## 4. 이 기록이 있는 곳

- GitHub: https://github.com/wisehyun-2/my_robot_project (브랜치 `main`).
- 대화 기록 요약본: `wheeled_biped/docs/session_log_2026-10-21.md` (사용자 발화 + Claude 서술만).
- 전체 원본(도구 출력 포함, 약 18 MB zip): Windows PC `C:\Users\User\Downloads\session-export-*.zip` — 필요하면 USB 등으로 옮겨 Claude에게 파일을 읽히면 된다(저장소에는 넣지 않았다).
- Windows의 Claude Code 메모리(`C:\Users\User\.claude\projects\C--Users-User-Desktop-myrobot\memory\`)의 요점은 저장소 루트 `CLAUDE.md`에 옮겨 적었다. 우분투에서는 경로가 달라 자동으로 로드되지 않는다.

## 5. Windows 쪽에서 알아둘 것

- Windows에는 ROS 2·WSL·Docker·MSVC가 없고, MuJoCo는 `C:\Users\User\Desktop\myrobot\.venv`(Python 3.14)에서 동작한다(Smart App Control이 새 DLL을 한 번 막았다가 허용함; `scipy.optimize`는 차단되어 쓰지 않음).
- 참조 저장소 클론은 `C:\Users\User\Desktop\myrobot\references\`에 있다(저장소 밖).
- 합격 판정 결과 캐시는 `results/acceptance/cache/<tag>/`에 있고 제어기 소스 해시로 키가 매겨진다(코드를 바꾸면 자동 무효화).
