wisehyun-2/my_robot_project/wheeled_biped/docs/ake_motor_sizing.md

# 사용자 로봇(upkie 다리 + CubeMars AKE 모터)의 모터 적정성과 바퀴 지름 산정

작성 2026-10-25. 대상: 무릎 토크 계산기에 저장한 값(2026-10-24)대로 만든 upkie 직렬 다리 로봇에 hip·knee = CubeMars **AKE50-8 KV110**, 바퀴 = **AKE60-8 KV80**을 단 경우. 측정 코드는 `wbr/bench/ake_sizing.py`, 결과는 `results/ake_sizing/`(케이스별 `*.json`, 표 `summary.md`, 바퀴와 다리 사이 틈 `clearance.md`).

재현(표준 케이스 16개, 케이스마다 약 70 s, 병렬):
```
python -m wbr.bench.ake_sizing
python -m wbr.bench.ake_sizing --diameter 180 --tag my_case [--seed 1] [--volt 22.2]   # 임의 지름 하나
python -m wbr.bench.ake_sizing --clearance            # upkie 배치에서 바퀴와 다리 부품 사이 틈(4.5절)
```

## 0. 요약

| 질문 | 답 | 근거(시뮬, 24 V) |
|---|---|---|
| **AKE50-8을 hip에 써도 되나** | **된다(여유 큼)** | 최대 4.3~5.2 N·m(최대 7.5의 58~69 %), RMS 최대 0.46~0.52 N·m(정격 2.5의 18~21 %), 속도 최대 7.9 rad/s(무부하 33.5) |
| **AKE50-8을 knee에 써도 되나** | **된다. 다만 연속 토크 여유가 작다** | 가장 낮은 자세(다리 길이 0.24 m) 정지 유지 2.03 N·m = **정격의 81 %**(기본 자세 0.31 m에서는 1.20 N·m, 48 %). 최대 3.2~3.3 N·m(Ø300 이하) |
| **AKE60-8 바퀴로 쓸 수 있는 지름** | **125~400 mm, 최대 400 mm** | Ø112는 1.5 W 밀기에서 넘어짐(바퀴가 무부하 속도 25 rad/s에 걸림). Ø450부터 바퀴 12.5 N·m·무릎·hip 7.5 N·m 포화로 넘어짐 |
| **권장 바퀴 지름** | **150~300 mm** | 22.2 V(6S 배터리 공칭)에서도 통과하는 최소 지름이 150 mm. 300 mm까지는 큰 외란에서 바퀴가 바닥에서 뜨는 시간이 30 ms 이하이고 무릎 충격이 없다. Ø400은 1.5 W 밀기에서 바퀴가 76~82 ms 뜨고, 다시 닿을 때 무릎이 6.8~7.5 N·m(최대치)까지 올라가는 한계선 |
| **upkie 다리 배치 그대로 쓸 수 있는 지름** | **240 mm 이하** | upkie는 바퀴가 정강이 **안쪽**에 있고, 허벅지 링크·무릎 모터 브래킷이 바퀴와 같은 좌우 위치에 있다. Ø250부터 무릎 브래킷에, Ø300부터 허벅지 링크에도 닿는다(4.5절). 그래서 upkie 배치로는 **150~240 mm**가 실제 권장 범위 |

- upkie 원래 타이어(112 mm)는 AKE60-8과 맞지 않는다. 토크는 충분한데 **속도가 모자란다**: 1.5 W 밀기를 받아내려면 바퀴가 26 rad/s 이상 돌아야 하는데, AKE60-8의 24 V 무부하 속도가 25.1 rad/s다(4.3절).
- 무릎은 위쪽 질량에 거의 비례한다. 지금 몸통(2.5 kg)에 약 0.9 kg을 더 얹으면 가장 낮은 자세에서 정지 유지만으로 정격 2.5 N·m에 닿는다(4.1절 식으로 추정).
- 시뮬레이션은 타이어가 바닥과만 닿게 해서 바퀴와 다리의 간섭을 뺐다(3.3절). 토크 결과는 바퀴를 어디에 달든 거의 같지만, 250 mm 이상을 쓰려면 바퀴 위치나 무릎 브래킷을 다시 설계해야 한다. upkie는 바퀴가 다리 안쪽이라 "조금 바깥으로 빼기"로는 안 되고, 바깥으로 옮기려면 한쪽 약 130 mm를 옮겨야 한다(4.5절).

## 1. 배경

- 2026-10-24: 사용자가 무릎 토크 계산기(아티팩트)에 실제 제작안을 저장했다. 몸통 2.5 kg(배터리 1.8 kg, 라즈베리파이 4B 약 0.15 kg, 3D 프린팅 프레임), 몸통 무게중심은 몸통 길이 정중앙(hip 축 위), 링크·바퀴 질량은 upkie 값, 모터 질량은 고른 모터 값. 저장된 결과: 전체 4.88 kg, upkie 균형 자세 θ = 93°(다리 길이 249 mm)에서 무릎 토크 한쪽 1.949 N·m.
- 2026-10-25: hip·knee에 AKE50-8, 바퀴에 AKE60-8을 고른 뒤 두 가지를 물었다. (1) 이 모터들로 토크가 충분한가, (2) 바퀴 모터로 쓸 수 있는 최대 바퀴 지름은 얼마인가.
- Plan 4의 qdd100(hip·knee)이 품절이라 upkie 다리 구조는 유지하고 모터만 바꾸는 안이다. 제어기는 Plan 4(LQI8 + DIABLO식 MCU)를 그대로 쓴다.

## 2. 로봇과 모터

### 2.1 질량 (MuJoCo 모델, 한쪽 기준)

| 항목 | 질량 | 비고 |
|---|---|---|
| 몸통(모터 제외) | 2.50 kg | 배터리 1.80 kg를 hip 축 바로 위에 두고, 나머지 0.70 kg(라즈베리파이·프레임·손잡이·IMU)는 몸통 바디에. 몸통 무게중심 = hip 축 위 |
| hip 모터 AKE50-8 | 0.19 kg × 2 | upkie qdd100 자리(고정자 0.175 + 로터 0.015) |
| 허벅지 링크 | 0.207 kg × 2 | upkie 값(hip 혼 + 대퇴 + 무릎 브래킷) |
| knee 모터 AKE50-8 | 0.19 kg × 2 | |
| 정강이 링크 | 0.208 kg × 2 | upkie 값(무릎 혼 + 경골 + 발목 베이스·플레이트) |
| 바퀴 모터 AKE60-8 | 0.26 kg × 2 | upkie mj5208 자리(고정자 0.21 + 로터 0.05) |
| 바퀴(허브 + 타이어) | 0.135 kg × 2 | **모든 지름에서 같은 질량**, 타이어 관성만 지름² 비례로 키움 |
| **전체** | **4.881 kg** | 계산기 4.88 kg과 같음 |

링크 길이(허벅지 168 mm, 정강이 175 mm), 다리 길이 범위 0.24~0.335 m(기본 0.31 m), 좌우 바퀴 간격은 upkie 그대로다.

### 2.2 모터 사양과 모델

| | AKE50-8 KV110 (hip, knee) | AKE60-8 KV80 (바퀴) |
|---|---|---|
| 최대 / 정격 토크(출력축) | 7.5 / 2.5 N·m | 12.5 / 5.0 N·m |
| 기어비 | 8:1 | 8:1 |
| 무부하 속도(24 V) | 320 rpm = 33.5 rad/s | 240 rpm = 25.1 rad/s |
| 토크 상수(모터축) / 저항 | 0.104 N·m/A / 0.792 Ω | 0.13 N·m/A / 0.577 Ω |
| 로터 관성 → 출력축 반사 관성(× 8²) | 153.81 g·cm² → 9.84×10⁻⁴ kg·m² | 647.39 g·cm² → 4.14×10⁻³ kg·m² |
| 역구동 토크 | 0.09 N·m | 0.12 N·m(**미공개, 가정**) |
| 질량 | 190 g | 260 g |
| 최대 토크를 낼 수 있는 속도(24 V / 22.2 V) | 23.5 / 21.0 rad/s | 17.9 / 16.0 rad/s |
| 토크가 0이 되는 속도(24 V / 22.2 V) | 33.5 / 31.0 rad/s | 25.1 / 23.2 rad/s |

모델에 넣은 방식:
- **토크-속도 한계**: 모터가 힘을 내는 방향(τ·ω > 0)일 때 낼 수 있는 토크 = min(최대, K_t·(V − K_e·|ω|)/R). K_e는 24 V 무부하 속도에서 구했다(K_e = 24 V / ω₀). 제동 방향은 최대 토크까지 허용한다. 서보 모델 출력과 MuJoCo 관절 한계(`actfrcrange`) 둘 다에 건다.
- **반사 로터 관성**을 관절 armature로, **역구동 토크**를 관절 마찰(`frictionloss`)로 넣었다. 마찰 보상은 Plan 4와 같이 역구동 토크의 80 %.
- 저항 값이 상간인지 선간인지, 드라이버 전류 한계, 약계자, 발열은 넣지 않았다(6절).

## 3. 방법

### 3.1 제어

- 제어 스택은 Plan 4 그대로다: DIABLO식 MCU 1 kHz, LQI8(다리 길이별 이산 LQR 게인표), IMU·엔코더 노이즈, 관측 지연 2 ms. Plan 4 코드는 바꾸지 않고, 케이스 하나 동안만 모델 폴더·바퀴 반경·토크 한계를 바꿔 끼운다(`patched_plan4()`).
- 플랜트 파라미터는 이 모델에서 다시 뽑았다(`upkie_params.build_params`): 다리 위 질량 m_b = 2.85 kg, 몸통 무게중심 앞뒤 오프셋 b_x = 0, 바퀴 반사 관성 J_w = 8.3×10⁻³ kg·m²(두 바퀴).
- LQI8 입력 가중치는 토크 예산의 비율로 정해진다. 예산은 Plan 4 튜닝(바퀴 1.7, hip 16 N·m)을 질량비(4.881/5.339)와 바퀴 반경비(R/0.056)로 키웠다: 바퀴 1.55(Ø112) ~ 5.55 N·m(Ø400), hip 14.6 N·m. 검증된 Plan 4와 같은 폐루프를 쓰겠다는 뜻이고, **실제 모터 한계(7.5 / 12.5 N·m와 토크-속도 직선)는 구동기에서 자른다.** 즉 "Plan 4 제어기를 그대로 올렸을 때 AKE 모터가 버티는가"를 본 것이다.

### 3.2 측정

- 1 kHz마다 참값 `actuator_force`(모터 6개), 관절 속도, 몸통 속도, **타이어별 수직 접촉력과 미끄럼 속도**(바퀴 중심 속도 − 림 속도, 구르면 0)를 기록한다.
- 시나리오별로 hip·knee·바퀴 각각 최대 |τ|, 모터별 RMS 중 최댓값, 최대 관절 속도, **포화율**(|τ|가 그 속도에서 낼 수 있는 토크의 98 % 이상인 시간 비율)을 낸다. 정지 시나리오는 정상 구간 평균(유지 토크)도 낸다.
- **바퀴가 뜬 시간**: 수직 접촉력 < 1 N인 시간(바퀴 둘 중 긴 쪽). 리셋 직후 0.1 s(0.5 mm 위에서 떨어뜨리는 구간)는 뺀다.
- **넘어짐**: |피치| > 1 rad 또는 바닥 위 높이 < 서 있는 높이의 절반. **회복**: 넘어지지 않고 마지막 1 s 동안 |피치| < 3°.

### 3.3 타이어 접촉

처음 스윕에서 Ø300 이상은 모터 한계를 풀어도 넘어졌다. 추적해 보니 커진 타이어가 로봇 자신의 다리 부품과 겹쳐 바퀴가 잠긴 채(바퀴 속도 ≈ 0) 미끄러지고 있었다. 겹친 부품은 **허벅지 쪽의 무릎 모터 브래킷과 허벅지 링크**다. upkie는 바퀴가 정강이 안쪽에 있어서 이 부품들과 좌우 위치가 같다(4.5절). 이 문서의 목적은 모터 토크와 지름에 따른 동특성을 보는 것이라, 타이어는 **바닥과만** 닿게 했다(타이어 `contype 2, conaffinity 0`, 바닥 `conaffinity 3`). 즉 시뮬레이션은 바퀴가 다리에 닿지 않게 만들었다고 가정한 결과다. 바퀴의 좌우 위치(좌우 바퀴 간격)는 upkie 그대로 두었다. 타이어는 Plan 4와 같은 타원체(condim 4)다.

### 3.4 시나리오 (케이스마다 28개)

| 이름 | 내용 |
|---|---|
| `stand_L*` | 다리 길이 0.24 / 0.27 / 0.31 / 0.335 m에서 5 s 정지(유지 토크 = 2 s 뒤 평균) |
| `tilt_*` | 몸통 5~25° 기울인 채 시작, 6 s 회복 |
| `push_*` | 1 s 뒤 몸통에 체중 × 0.25~1.5의 힘을 0.1 s 가함, 6 s 회복 |
| `velocity_*` | 0.5 / 0.8 / 1.0 m/s 스텝 3 s 뒤 정지 3 s |
| `yaw_1.0` | 제자리 회전 1 rad/s, 2.5 s |
| `height_full_range` | 기본 → 최저 0.24 → 최고 0.335 → 기본, 각 2 s |
| `slope_*` | 바닥을 5 / 10 / 15° 기울여 6 s 정지(유지 토크 = 3 s 뒤 평균), 오르막·내리막 0.5 m/s 주행 |

케이스: 지름 112, 125, 135, 150, 200, 250, 300, 400, 450, 500, 600 mm(시드 0, 24 V), 112·150·400 mm 시드 1, 125·150 mm 22.2 V(6S 리튬폴리머 공칭 전압).

## 4. 결과

전체 표는 `results/ake_sizing/summary.md`.

### 4.1 hip과 knee (AKE50-8)

| 항목 | 측정(Ø112~Ø400) | AKE50-8 | 비율 |
|---|---|---|---|
| knee 정지 유지, 최저 자세 0.24 m | 2.02~2.03 N·m | 정격 2.5 | **81 %** |
| knee 정지 유지, 0.27 / 0.31(기본) / 0.335 m | 1.75 / 1.20 / 0.59 N·m | 정격 2.5 | 70 / 48 / 24 % |
| knee RMS 최댓값(= 최저 자세 정지) | 2.03 N·m | 정격 2.5 | 81 % |
| knee 최대 | 3.17~3.31 N·m(Ø300 이하, 1.5 W 밀기) / 6.79~7.50(Ø400, 1.5 W 밀기 착지) | 최대 7.5 | 42~44 % / 91~100 % |
| knee 속도 최대 | 3.7~4.4 rad/s(Ø300 이하) / 14.6~15.7(Ø400) | 무부하 33.5 | |
| hip 정지 유지 | ≈ 0(0.01 N·m 이하) | | 몸통 무게중심이 hip 축 위라서 |
| hip RMS 최댓값 | 0.46 N·m(Ø125~300) / 0.52(Ø400). Ø112는 넘어지는 1.5 W 밀기에서 1.21 | 정격 2.5 | 18~21 % |
| hip 최대 | 4.31~5.18 N·m(25° 기울기 회복, 지름이 클수록 큼) | 최대 7.5 | 58~69 % |
| hip 속도 최대 | 7.4~7.9 rad/s | 무부하 33.5 | |

- **계산기와 대조**: 계산기 저장값은 다리 길이 249 mm에서 1.949 N·m다. MuJoCo 정지 유지 토크(0.24 m 2.02, 0.27 m 1.75)를 249 mm로 보간하면 1.94 N·m로 0.5 % 안에서 맞는다.
- **무릎 연속 토크 여유**: 균형 자세 무릎 토크는 τ = g·d·(몸통/2 + hip 모터 + 허벅지 + knee 모터 + 정강이 × 0.417)이다(d = 무릎과 바퀴축의 수평 거리). 괄호 안이 지금 1.92 kg이고 최저 자세에서 g·d ≈ 1.06 m²/s²(= 2.03 N·m ÷ 1.92 kg)이므로, 괄호 안이 2.37 kg(몸통 기준 약 +0.9 kg)이 되면 정지 유지만으로 정격 2.5 N·m에 닿는다. 팔·라이다 등을 올릴 계획이면 최저 자세에 오래 머물지 않게 하거나 무릎 모터를 한 단계 큰 것으로 바꾸는 안을 검토해야 한다(예: AKE60-8은 정격 5 N·m, 개당 +70 g. 이 안은 시뮬하지 않았다).
- hip은 몸통 무게중심이 hip 축 바로 위라서 정지 부하가 거의 없다. 무게중심이 앞뒤로 2 cm 벗어나면 hip 하나당 약 0.25 N·m(2.5 kg × g × 0.02 / 2)가 더해지는데, 정격 대비 10 % 수준이다.

### 4.2 바퀴 지름별 결과 (AKE60-8)

| 지름 [mm] | 회복 실패 | 바퀴 최대 [N·m] | 바퀴 RMS 최대 | 1.5 W 밀기 포화율 | 1.5 W 밀기 피치 최대 | 15° 경사 정지 유지 | 바퀴 뜬 시간 최대 / 미끄럼 최대 | hip / knee 최대 |
|---|---|---|---|---|---|---|---|---|
| 112(upkie) | `push_1.5`(시드 0·1 모두) | 3.30 | 0.62 | **76.5 %** | 33°(넘어짐) | 0.31 | 0 ms / 0.01 m/s | 4.34 / 3.31 |
| 125 | 없음 | 3.46 | 0.48 | 10.8 % | 11.6° | 0.35 | 0 / 0.01 | 4.50 / 3.29 |
| 125, 22.2 V | `push_1.5` | 3.46 | 0.54 | **78.6 %** | 30°(넘어짐) | 0.35 | 0 / 0.01 | 4.50 / 3.29 |
| 135 | 없음 | 3.64 | 0.51 | 3.9 % | 10.7° | 0.37 | 0 / 0.01 | 4.58 / 3.29 |
| **150** | 없음(시드 0·1) | 3.85 | 0.56 | 2.1 % | 10.9° | 0.42 | 2 / 0.02 | 4.68 / 3.23 |
| **150, 22.2 V** | 없음 | 3.85 | 0.56 | 2.7 % | 10.9° | 0.42 | 2 / 0.02 | 4.68 / 3.23 |
| 200 | 없음 | 4.71 | 0.70 | 0.9 % | 11.5° | 0.58 | 5 / 0.03 | 4.84 / 3.19 |
| 250 | 없음 | 5.53 | 0.86 | 0.0 % | 11.9° | 0.76 | 19 / 0.07 | 4.94 / 3.17 |
| **300** | 없음 | 6.44 | 1.01 | 0.0 % | 12.1° | 0.96 | 30 / 0.15 | 5.02 / 3.21 |
| 400 | 없음(시드 0·1) | 8.22~8.35 | 1.31 | 0.7 % | 12.5° | 1.19 | **76~82 / 1.27~1.54** | 5.18 / **6.79~7.50** |
| 450 | `push_1.5`, `slope_15_down` | **12.50(포화)** | 4.98 | 49.9 % | 58°(넘어짐) | 1.34 | – | 7.50 / 7.50 |
| 500 | 4건 | 12.50 | 5.06 | 60.4 % | 넘어짐 | 1.50 | – | 7.50 / 7.50 |
| 600 | 7건 | 12.50 | 5.58 | 56.4 % | 넘어짐 | 넘어짐 | – | 7.50 / 7.50 |

- 바퀴 최대 토크는 모두 25° 기울기 회복(`tilt_25`)에서 나왔고, 바퀴 RMS 최댓값은 15° 오르막 주행에서 나왔다(정격 5 N·m의 10~26 %).
- 1.0 m/s 명령은 모든 지름에서 따라간다(측정 평균 1.04~1.09 m/s).
- 15° 경사 정지 유지 토크는 해석값 m·g·R·sin α / 2와 맞는다(Ø400: 해석 1.24, 시뮬 1.19 N·m).
- 뜬 시간과 미끄럼은 회복한 시나리오만 셌다(넘어지는 경우는 당연히 뜬다).

### 4.3 작은 바퀴가 실패하는 이유: 속도

1.5 W 밀기의 충격량은 1.5 × 4.881 kg × 9.81 × 0.1 s = 7.2 N·s로, 로봇 전체 속도를 1.47 m/s 바꾼다. 바퀴가 몸통 아래로 다시 들어가려면 바퀴가 이보다 빨리 굴러야 한다.

| 지름 | 필요한 바퀴 속도 1.47 m/s ÷ R | AKE60-8 무부하 24 V / 22.2 V | 결과 |
|---|---|---|---|
| 112 mm | 26.3 rad/s | 25.1 / 23.2 rad/s | 두 전압 모두 실패(포화율 76 %) |
| 125 mm | 23.5 rad/s | 25.1 / 23.2 | 24 V 통과(포화 10.8 %), 22.2 V 실패 |
| 150 mm | 19.6 rad/s | 25.1 / 23.2 | 두 전압 모두 통과 |

AKE60-8은 17.9 rad/s(24 V) 위에서 토크가 직선으로 줄어 25.1 rad/s에서 0이 된다. 토크(최대 3.3 N·m, 한계 12.5)는 남는데 속도가 막히는 것이다. 그래서 **최소 지름은 전압으로 정해지고**, 배터리가 방전돼 전압이 내려가면 더 커진다. 무부하 기준 최고 주행 속도는 ω₀·R = 1.41 m/s(Ø112), 1.88 m/s(Ø150), 3.77 m/s(Ø300)다.

### 4.4 큰 바퀴가 실패하는 이유: 토크와 바퀴 뜸

- 같은 바닥 힘을 내는 데 필요한 바퀴 토크는 R에 비례한다. 25° 기울기 회복 최대는 3.3 N·m(Ø112) → 8.2 N·m(Ø400)으로 커지고, Ø450에서는 1.5 W 밀기 중 절반(49.9 %)이 12.5 N·m에 걸린 채 넘어진다.
- 바퀴가 커지면 로봇 전체가 그만큼 높이 서고 바퀴 관성도 커져서, 큰 외란에서 다리가 바퀴를 들어 올리는 일이 생긴다. 1.5 W 밀기에서 바퀴가 뜬 시간은 0 ms(Ø150) → 5(Ø200) → 19(Ø250) → 30(Ø300) → **76~82 ms(Ø400)**로 늘었다. 뜬 동안 바퀴 모터가 바퀴를 무부하 속도(25 rad/s)까지 헛돌리고, 다시 닿을 때 1.3~1.5 m/s 미끄러지면서 무릎에 6.8~7.5 N·m(AKE50-8 최대치)의 충격이 걸린다. Ø400은 두 시드 모두 회복했지만 바퀴·무릎이 모두 한계에 닿은 경계 지점이다.
- 해석 한계는 실제 제약이 아니었다: 바닥 마찰 한계 μ·m·g·R/2 = 12.5 N·m가 되는 지름은 1.04 m(μ = 1), 15° 경사 정지 유지가 정격 5 N·m가 되는 지름은 1.61 m다. 동적 외란 회복이 Ø400~450에서 먼저 막힌다.

### 4.5 바퀴와 다리의 간섭 (upkie 배치)

MuJoCo 충돌 모양으로 바퀴(왼쪽)와 다리 부품 사이 가장 작은 틈을 쟀다(`--clearance`, `mj_geomDistance`). 무릎을 굽힐 수 있는 범위 전체를 훑었다. 전체 표는 `results/ake_sizing/clearance.md`.

좌우 배치(로봇 중심선에서 바깥쪽으로 잰 거리 |y|):

| 부품 | |y| [mm] | 바퀴와의 관계 |
|---|---|---|
| hip 모터(qdd100) | 85~115 | 바퀴보다 안쪽 |
| hip 혼(허벅지 위쪽 끝) | 114~164 | **바퀴와 같은 폭** |
| 무릎 모터 브래킷(허벅지 쪽, 무릎 축을 중심으로 반지름 약 50 mm) | 121~181 | **바퀴와 같은 폭** |
| 허벅지 링크 | 127~151 | **바퀴와 같은 폭** |
| **타이어** | **132~172** | |
| 바퀴 모터(mj5208 자리) → 발목 → 정강이 | 175~257 | 바퀴 바로 바깥 |
| 무릎 모터 몸체 / 무릎 혼 | 181~211 / 210~260 | 바퀴 바깥 |

가장 작은 틈 [mm]. 왼쪽은 Plan 4 다리 길이 0.24~0.335 m, 오른쪽은 무릎 내각 60° 이상(이 로봇이 균형 자세로 갈 수 있는 62~180°를 덮음). 음수 = 겹침:

| 부품 | Ø150 | Ø200 | Ø240 | Ø250 | Ø260 | Ø300 | Ø400 |
|---|---|---|---|---|---|---|---|
| 무릎 모터 브래킷 | 50 / 50 | 25 / 25 | 5 / 5 | **0 / 0** | **−5 / −5** | **−25 / −25** | **−44 / −44** |
| 허벅지 링크 | 67 / 66 | 42 / 42 | 23 / 22 | 18 / 17 | 13 / 13 | **−3 / −4** | **−12 / −13** |
| hip 혼 | ≥ 100 / 59 | 94 / 34 | 74 / 15 | 69 / 10 | 64 / 5 | 45 / **−11** | **−3 / −24** |
| 바퀴 모터 로터(옆면) | 3 | 3 | 3 | 3 | 3 | 3 | 3 |

- **무릎 모터 브래킷이 상한을 정한다.** 무릎 축과 바퀴축 사이 거리는 정강이 길이 175 mm로 자세와 관계없이 같고, 브래킷은 무릎 축을 중심으로 반지름 약 50 mm다. 그래서 바퀴 반지름이 175 − 50 = 125 mm(Ø250)를 넘으면 **어떤 자세에서든** 닿는다. 일반식: 최대 바퀴 반지름 = 175 mm − (바퀴와 같은 폭에 있는 무릎 부품의 반지름) − 여유.
- 무릎 모터 몸체는 바퀴보다 9 mm 바깥이라 직접 닿지 않는다. 바퀴 모터 로터는 바퀴 바로 옆(3 mm)에 붙어 있는 정상 배치다.
- 허벅지 링크·hip 혼은 깊게 웅크릴수록 바퀴에 가까워진다(Ø300 이상에서 닿음).
- 이 수치는 upkie 부품(qdd100 무릎 모터와 그 브래킷) 기준이다. AKE50-8에 맞춰 브래킷을 새로 설계하면 그 치수로 다시 재야 한다.

250 mm 이상을 쓰는 방법과 비용:
- **바퀴를 다리 바깥쪽으로 옮기기**: 바퀴가 다리 안쪽에 있으므로, 바깥으로 옮기려면 타이어 안쪽 면이 무릎 혼·발목(260 mm)보다 바깥에 있어야 한다. 한쪽 약 130 mm, 좌우 바퀴 간격은 약 260 mm 넓어진다. 바퀴축이 그만큼 튀어나와 바퀴 모터·정강이에 굽힘 모멘트가 걸린다(정지 때 바퀴 하나 약 24 N × 0.13 m ≈ 3 N·m, Ø400 1.5 W 밀기에서는 바퀴 하나의 수직력이 순간 57 N까지 올라 약 7 N·m). 모터 토크가 아니라 축·베어링·구조물이 견뎌야 하는 하중이다.
- **바퀴를 안쪽으로 옮기기**: hip 모터(85~115 mm)와 hip 혼(114~164 mm)이 바로 안쪽에 있어 공간이 거의 없다.
- **무릎 브래킷을 작게 다시 설계**: 바퀴와 같은 폭에 있는 무릎 부품의 반지름을 줄이면 위 식대로 상한이 올라간다(예: 반지름 30 mm면 반지름 145 mm = Ø290까지, 여유 제외).

바퀴의 좌우 위치는 피치 방향(앞뒤 균형) 토크에 거의 영향이 없어서, 4.1~4.4절의 토크 결과와 무릎 토크 계산기 값은 그대로 쓸 수 있다. 다만 바퀴를 옮겼을 때 달라지는 좌우 간격(회전·롤), 축 연장 부품의 질량, 굽힘 하중은 시뮬레이션에 없다.

## 5. 결론과 권장

**hip·knee: AKE50-8 사용 가능**
- hip은 최대·연속 모두 여유가 크다(최대 69 % 이하, 연속 21 % 이하).
- knee는 최대 토크 여유는 크지만(Ø300 이하에서 44 % 이하) 연속 여유가 작다. 가장 낮은 자세 정지 유지가 정격의 81 %다. 기본 자세(0.31 m)로 서 있으면 48 %라 문제없다. 탑재물을 늘리면 4.1절 식으로 다시 확인한다.

**바퀴: AKE60-8, 지름 125~400 mm 사용 가능(최대 400 mm), 권장 150~300 mm**
- 하한 150 mm: 6S 배터리 공칭 22.2 V에서도 1.5 W 밀기를 받아낸다(125 mm는 24 V에서만 통과).
- 상한 300 mm: 큰 외란에서 바퀴가 뜨는 시간이 30 ms 이하, 미끄럼 0.15 m/s 이하, 바퀴 최대 6.4 N·m(최대치의 52 %), 무릎 최대 3.2 N·m로 지름의 영향을 받지 않는다.
- 400 mm는 통과는 하지만 바퀴가 뜨고 무릎이 최대치에 닿는 경계라 권하지 않는다. 450 mm 이상은 쓸 수 없다.
- upkie 원래 112 mm 타이어는 AKE60-8로는 쓸 수 없다(1.5 W 밀기 실패). 112 mm를 써야 한다면 무부하 속도가 더 높은(KV가 높은) 바퀴 모터가 필요하다.
- **upkie 다리 배치를 그대로 쓰면 상한은 240 mm**다. 250 mm부터 바퀴가 무릎 모터 브래킷에 닿는다(4.5절). 따라서 실제 권장은 **150~240 mm**이고, 250~300 mm를 쓰려면 바퀴 위치나 무릎 브래킷을 다시 설계해야 한다.

**제작할 때 확인할 것**
- 바퀴와 같은 좌우 폭에 있는 무릎·허벅지 부품이 바퀴 원 안에 들어오지 않는지 확인한다: 바퀴 반지름 < 175 mm − (그 부품의 무릎 축 기준 반지름) − 여유(4.5절). AKE50-8용 브래킷을 설계하면 `--clearance`로 다시 잰다(모델에 반영한 뒤).
- 바퀴를 다리 바깥쪽으로 옮기면 좌우 간격이 넓어져 회전 저항과 요 동특성이 바뀌고, 튀어나온 축에 굽힘 하중이 걸린다.
- 큰 바퀴의 실제 질량은 이 모델(0.135 kg 고정)보다 무겁다. 바퀴 질량이 크게 늘면 그 값을 넣어 다시 돌린다.
- 배터리 전압을 정하면 `--volt`로 다시 돌린다. 하한 지름은 전압에 거의 반비례한다.

## 6. 가정과 한계

- 모터 모델은 단순화했다: 최대 토크 클램프 + 전압 직선(24 V 무부하 속도와 카탈로그 저항으로 계산). 드라이버 전류 한계, 약계자, 발열(정격 = 연속 열 한계로 가정), 배터리 전압 강하, 토크 리플, 기어 백래시는 넣지 않았다. AKE60-8의 역구동 토크 0.12 N·m는 공개 값이 없어 가정했다.
- LQI8 가중치는 AKE 한계에 맞춰 다시 설계하지 않았다. Plan 4 예산을 질량·반경으로 키운 값이고(hip 예산 14.6 N·m > AKE50-8 최대 7.5), 실제 한계는 구동기에서 자른다. 실제 한계로 다시 설계하면 큰 바퀴의 결과는 조금 나아질 수 있다.
- 바퀴 질량은 지름과 관계없이 0.135 kg으로 두고 타이어 관성만 R²로 키웠다. 바닥은 평평하고 마찰은 기본값이며, 턱·착지 같은 충격은 없다.
- 시드는 0(일부 1)만 돌렸다. Plan 4 합격 판정(`docs/합격기준.md`)처럼 질량·마찰 변동 × 시드 매트릭스로 검증하지 않았다. 지름과 모터를 확정하면 그 모델로 합격 판정 배터리를 다시 돌려야 한다.
- 1.5 W 밀기는 이 스윕에서 정한 큰 외란이다. 1.0 W 밀기까지는 Ø112도 회복한다(포화율 1.2 %).

## 7. 재현

```
python -m wbr.bench.ake_sizing                        # 표준 16케이스 -> results/ake_sizing/*.json, summary.md
python -m wbr.bench.ake_sizing --only d150 d400       # 표준 케이스 중 일부
python -m wbr.bench.ake_sizing --diameter 180 --tag d180 --volt 22.2 --seed 1
python -m wbr.bench.ake_sizing --diameter 300 --tag d300_nolim --no-limits     # 모터 한계 해제(진단용)
python -m wbr.bench.ake_sizing --clearance [150 250 300]   # 바퀴와 다리 부품 사이 틈 -> results/ake_sizing/clearance.md
```

모델은 케이스마다 임시 폴더에 새로 만든다(`build_model()`: Plan 4 빌더로 지름을 바꿔 만든 뒤 질량·모터·접촉을 고침). 질량이나 모터를 바꾸려면 `Case`의 `torso_kg`·`battery_kg`, 모듈의 `AKE50_8`·`AKE60_8` 값을 고친다.
