wisehyun-2/my_robot_project/wheeled_biped/docs/plan4_lqi8.md

# Plan 4 균형 제어기(LQI8 + 정적 자세·위치 적분)와 합격 판정 결과

작성 2026-10-23(검토 1라운드 반영판; 1라운드 전 판의 내용은 git 이력과 `docs/review_plan4_r1.md`·`docs/review_plan4_r1_response.md`에 있다). 대상: Plan 4 = upkie 하드웨어(직렬 무릎 다리, 112 mm 둥근 타이어) + LQI8 + DIABLO식 호스트/MCU 분리(`wbr/plans/plan4_lqi8.py`). 플랜트 유도와 모델 대조는 `docs/plan4_model.md`, 합격 기준은 `docs/합격기준.md`(측정 정의 변경은 6.2절), 판정 코드는 `wbr/bench/acceptance.py`, 결과는 `results/acceptance/plan4_<rate>Hz.md|json`(1단계, 램프 호스트)과 `plan4_mpc_<rate>Hz.md|json`(2단계, MPC 호스트: `docs/plan4_mpc_host.md`).

재현(전체 매트릭스 9조합 × 5시드 × 2주기 + 생존 항목 시드 5개 + 기록 항목; 12프로세스):
```
python -m wbr.bench.acceptance --rate both --matrix full --seeds 5 --reference --tag r4_s1 --jobs 12
```

## 0. 요약

| | 1 kHz | 200 Hz |
|---|---|---|
| 필수 항목 통과 | **1~13·16·17 (15/15)** | **1~13·16·17 (15/15)** |
| 16·17(일정 외란 정지, 드리프트 ≤ 10 cm — 합격기준 6.3) | 16: max \|x(t) − x(0)\| (t ≥ 2 s) 0.072 m(×0.72, m×1.15 μ0.5 s3), 17: 0.086 m(×0.86, m×0.85 μ0.75 s2) | 16: 0.073 m(×0.73), 17: 0.087 m(×0.87) |
| 기록 15(지연 허용, 3° 기울기·무노이즈) | 20 ms(기준 25 ms 미달); 강건 여유(노이즈·2 mm 낙하·0.5 W 밀기) **12 ms** | 25 ms(통과); 강건 여유 **15 ms** |
| 기록 24(0.3 m/s 순항 중 0.75 W 밀기) | 정착 1.90 s, 후진 0.003 m/s | 정착 1.99 s, 후진 0.004 m/s |
| 가장 빠듯한 통과 지표(여유율) | 2 바퀴 피크 1.323/1.36 Nm(×0.97, m×0.85·μ0.5 s3), 13 도달 1.384/1.5 s(×0.92), 13 바퀴 rms 0.176/0.2(×0.88), 8 도달 1.250/1.5(×0.83), 11 정지 2.36/3 s(×0.79), 12 바퀴 rms 0.156/0.2(×0.78) | 2 바퀴 피크 1.288/1.36(×0.95), 13 도달 1.405/1.5(×0.94), 13 바퀴 rms 0.178/0.2(×0.89), 8 도달 1.245/1.5(×0.83), 11 정지 2.39/3(×0.80), 12 바퀴 rms 0.159/0.2(×0.79) |

종합 판정은 두 주기 모두 **합격**(캐시 `r5_s1`, 코드 해시 345db37b94). 16·17은 2026-10-23 사용자가 위임한 결정(합격기준 6.3: 드리프트 기준점 x(0)·탐색 t ≥ 2 s, 두 항목의 한계는 12번과 같은 10 cm)으로 통과했고, 그 외 수치는 2라운드 반영판 `r4_s1`과 1,170/1,170회 비트 단위로 같다(3라운드 반영은 판정 코드·가드·테스트만 바꿨다). 1라운드 전과 비교: 1 kHz 6번(밀기 0.75 W)의 바퀴 10 s rms 실패(m×0.85·μ0.75/1.0, 10/45회, 0.22 Nm)가 **사라졌다**(최악 0.122 Nm). 원인은 **마찰 보상의 피치 속도 게이트**다: 현재 모델·게인에서 게이트만 끄면 같은 조합이 0.208~0.214 Nm로 다시 실패하고(2라운드 검토 m2), 보상을 아예 끄면 0.113~0.115로 통과한다 — 밀기 복귀 중 릴레이형 보상이 바퀴 토크 rms를 키우던 것이다. 정의 변경(최대 이탈·유지 1 s·모터별 rms)으로 바뀐 판정은 없다. 2단계(MPC 호스트)의 결과는 `docs/plan4_mpc_host.md` 7절.

**검토 1라운드 반영으로 바뀐 것**(상세 `docs/review_plan4_r1_response.md`):
- **플랜트**: 바퀴 로터 아마추어 J_w와 바퀴 점성 감쇠를 바퀴 관절 속도 ẋ/R − θ̇에 붙였다(전에는 I_w에 합쳐 절대 회전에). MuJoCo 대조 오차가 빠른 극 3 % → 0.02 %, B 성분 7 % → 0.3 %가 됐고 LQI8 게인이 2~3 % 바뀌었다(1.2절).
- **MCU 센서 가드**: 비유한 표본은 추정값 유지 → 5주기 넘으면 FAULT, 시간 스탬프 정지 50 ms → FAULT, 비유한 토크 명령 → 0 + FAULT, 롤 34° FAULT. LQI8은 비유한 입력에서 직전 출력 유지(1.6절).
- **IMU 관례 어댑터**: MCU가 upkie 스파인의 `BaseOrientation` 변환(ARS 좌표 + IMU 180° 장착)을 갖고, 시뮬레이션은 IMU 표본을 스파인이 보고하는 방식으로 내보내 어댑터가 모든 판정에서 실행된다(1.1절).
- **마찰 보상 피치 속도 게이트** 1/(1 + (φ̇/0.1 rad/s)²): 보상은 정지 보조로만 작동하고 균형 루프 대역에 이득을 더하지 않는다(1.4절, 2절 12).
- **타이어 접촉**: 타원체 + `condim 4`(비틀림 마찰 0.005). 9번 요 항목의 유지 토크가 조금 늘었다(바퀴 rms 0.07 → 0.11 Nm, 기준 0.2).
- **판정 정의**(합격기준 6.2): 이동·정지 거리 = 최대 이탈, 정착 유지 1 s, 정지형 항목 생존 검사, 모터별 rms, 생존 항목 시드 5개, 11번 3 s 순항 뒤 끊김, 15번 강건 여유 기록, 24번 기록 항목(주행 중 밀기), 캐시 해시 범위.
- **시뮬 지연선**: 준비 구간의 반복 표본을 과거 시각으로 스탬프한다(`ObservationDelay(dt=…)`). 정지 감시가 시작 시 추정을 붙잡으면 첫 표본의 1스텝 미분 속도 잡음이 10 ms 동안 유지되어 1 kHz 10°·15° 복귀가 깨졌다(2절 13).
- 2단계용으로 LQI8 플레인 모드(호스트 성형 기준)에 "가속 중 적분기 전부 동결"이 들어갔다. 1단계(램프 호스트, 자체 성형)에는 영향이 없다.

## 1. 제어기 구조

### 1.1 상태와 입력

MCU(`DiabloMcu`, 1 kHz 또는 200 Hz)가 IMU와 6개 관절을 읽어 추정하고 `LQI8Law`가 총 바퀴 토크 T와 총 엉덩이 토크 Tp를 낸다(u = −K x). 상태(플랜트 규약은 `docs/plan4_model.md` 3절):

| 상태 | 정의 | 측정 |
|---|---|---|
| θ | 가상 다리 월드 각 − θ_eq(L0) (θ_eq(0.31) = −3.48°) | 엔코더(몸체 기준 다리각) + IMU 피치 |
| θ̇ | 다리각 속도 | 5 ms 위치 차분 속도 + 자이로 |
| v − v_ref | 바퀴 접지 속도 − 성형된 기준 | 바퀴·종아리 5 ms 차분 속도 + 자이로 |
| φ | 몸체 피치(−IMU 피치, 뒤로 기울면 +) | IMU |
| φ̇ | 몸체 피치 속도 | 자이로 |
| z1 | ∫(v − v_ref) dt (= 위치 오차) | |
| z2 | ∫e_att dt, e_att = θ + φ + (Tp − T)/(g·M(L0)) — 정적 몸체 기울기(IMU 바이어스가 θ + φ에서 상쇄) | 엔코더 + 명령 토크 |
| z3 | ∫z1 dt — 위치 오차의 적분(일정 외란 토크를 위치 오프셋 없이 떠안음) | |

- **IMU 입력**: 실기 upkie의 pi3hat은 IMU 자세를 ARS 좌표(x 앞, y 오른쪽, z 아래)로, 각속도를 IMU 좌표로 보고하고 IMU는 토르소에 y축 180° 돌려 붙어 있다. MCU는 upkie 스파인과 같은 변환 R_base→world = R_ARS→world · R_IMU→ARS · R_base→IMU(`McuParams.imu_rotation_base_to_imu` = diag(−1, 1, −1), `imu_rotation_ars_to_world` = diag(1, −1, −1))으로 base 자세·각속도를 복원한다. 시뮬 플랜은 base 사이트의 센서값을 그 관례로 재표현해 넘긴다(`Plan4Config.real_imu_convention`, 기본 켬) — 변환 왕복이 세계 좌표 추정과 1e−9 안에서 같음을 단위 테스트로 확인했다. 실기에서 장착 회전이 다르면 URDF에서 다시 읽어 넘긴다.
- 입력 u = [T, Tp]: T는 두 바퀴 합(양 = 전진 구동), Tp는 두 엉덩이 합(다리에 +y로 작용). MCU가 T·Tp에 마찰 보상, 요 토크(차동), anti-split, 다리 길이 PD + 무게 피드포워드를 더해 직렬 다리 VMC(τ = Jᵀ[F u + (Tp/L0) u′])로 관절 토크를 만든다. VMC의 무릎 토크에는 hip 토크의 영향 보상(`L2 cos β / L0 · τ_h`, L1 = L2면 τ_h/2)이 이미 들어 있다. 바퀴 토크 반작용 보상(`L1 cos α / L0 · τ_w`, `wheel_reaction_ff`)은 Plan 4 기본값에서 꺼져 있고 CAD 로봇(`wbr.bench.ake_cad`, 11-06)에서 켠다(`robot_cad_v5/README.md` 6절). upkie 관절은 좌우 거울상이라 부호 어댑터(`UPKIE_JOINT_SIGNS`)를 거친다. MCU에 넘기는 관측 dict에는 시뮬 참값(`sim` 키)이 없다.

### 1.2 게인 설계

- 플랜트: `plant_serial.py`의 3체 직렬 다리 모델을 L0 = 0.22~0.34 m(5 mm 간격)에서 선형화, 제어 주기 Ts(1 ms 또는 5 ms)로 ZOH 이산화, 적분 상태 z1·z2·z3을 붙여 이산 LQR(DARE)을 격자마다 풀어 표로 두고 실행 중에는 측정 L0로 보간한다(MCU 안에서 리카티를 풀지 않음). 플랜트 파라미터는 `models/upkie_plan4/plan4_params.json`(`python -m wbr.models.upkie_params`로 재생성, 실기 측정값으로 교체 가능).
- Bryson 가중치(Q = diag(1/q²), R = diag(1/(r·τ_max)²)): q_θ 0.3 rad, q_θ̇ 3 rad/s, q_v 0.5 m/s, q_φ 0.15 rad, q_φ̇ 3 rad/s, q_int 0.2 m, q_att 0.2 rad·s, q_pos 0.5 m·s, r_wheel 0.2 × 1.7 Nm(바퀴가 병목), r_hip 0.3 × 16 Nm.
- L0 = 0.31 게인(8상태 [θ, θ̇, v−v_ref, φ, φ̇, z1, z2, z3]):
  - 1 kHz: K_T = [−7.62, −1.13, −1.98, 1.59, 0.23, −2.25, 0.47, −0.64], K_Tp = [20.36, 2.72, 5.32, 29.56, 1.43, 8.42, 22.11, 2.56]
  - 200 Hz: K_T = [−7.37, −1.09, −1.88, 1.54, 0.22, −2.14, 0.46, −0.61], K_Tp = [17.09, 2.25, 4.38, 25.35, 1.28, 6.97, 18.77, 2.12]
- 위치 강성(정상상태 외란 토크 → 위치 오프셋)은 z1 게인 2.25 Nm/m가 정하고, z3이 그 오프셋을 시간이 지나면 0으로 되돌린다. 바퀴 채널의 θ 게인(−7.6 Nm/rad)과 엉덩이 채널의 φ 게인(30 Nm/rad)이 각각 다리와 몸체의 역진자를 세운다.

### 1.3 정적 자세 적분 z2

정지 상태에서 Σm·x(바퀴축 기준) = T/g 이고 엉덩이 정적 토크 = 몸체(+탑재물)의 엉덩이 기준 중력 모멘트다. θ, φ에 대해 선형화하면 φ_실제 ≈ Δθ_body + (ΔTp − T)/(g M), M = ∂Σm x/∂θ ≈ 1.15 kg·m(L0 = 0.31)이고 Δθ_body = θ + φ는 엔코더만으로 정해진다(IMU 바이어스 상쇄). 이것을 적분 상태로 LQR에 넣어 정상상태에서 실제 몸체가 수평이 되게 한다. 유효한 것은 준정적 상태뿐이라 기준 가속도(0.1 s 저역통과)가 0.1 m/s²를 넘는 동안과 그 뒤 0.1 s(유지 시간 `freeze_hold_s`)는 적분을 멈춘다. 이 유지 시간은 2단계 2라운드 검토(m4)로 추가된 것인데 1단계 자체 성형 모드의 z2 동결에도 적용되어 8·11·13번 수치가 판정 지표 기준 최대 2.2 % 바뀌었다(판정 불변; 3라운드 검토 m2 — 11.6절의 "r3_s1과 같다"는 서술은 이 때문에 틀렸었다). 남는 오차: 탑재물 질량 자체의 모멘트 차(17번에서 +0.4°), 질량 ±15 %(∓0.25°).

### 1.4 피드포워드와 보상

- Tp 피드포워드 Tp_eq = m_b g b_x = −0.314 Nm(몸체 무게중심이 엉덩이 1.15 cm 뒤). 상수는 선형화를 바꾸지 않는다.
- 다리 힘 피드포워드 F_ff = ½(m_b + (c/L0) m_l) g = 18.2 N/다리(다리 무게의 42 %만 가상 다리로 전달; 전체 무게를 쓰면 7 mm 과신장). 다리 길이 PD 800 N/m, 40 N s/m.
- **마찰 보상**(모델 건마찰 엉덩이 0.1·바퀴 0.02 Nm의 80 %): 엉덩이 +2·0.08·tanh(dev/0.02), 바퀴 +2·0.016·tanh(T/0.02), dev = (Tp − Tp_ff) − LPF₁ₛ(Tp − Tp_ff). 두 항에 **피치 속도 게이트** 1/(1 + (φ̇/0.1)²)를 곱한다(검토 1라운드 M1): 보상은 정지 중 건마찰 헌팅(피치·x 왕복)을 없애기 위한 것이고, 릴레이처럼 작동하는 tanh 항이 큰 진폭 진동에서 균형 루프의 고주파 이득을 키우던 것을 막는다. 정지 품질·드리프트는 게이트 전과 같고(피치 MA 0.28°, 드리프트 2 cm) 1 kHz 12 ms 지연에서 2.1° 한계 사이클이 사라진다(2절 12). 실기에서는 0에서 시작해 측정한 마찰로 올린다(HANDOFF 2.1).
- anti-split PD kp 60 Nm/rad·kd 3 Nm s/rad(upkie의 가벼운 다리는 Plan 2의 15/0.8로는 묶이지 않아 차동 토크가 요 대신 다리를 벌렸다). 요 PI kp 0.4·ki 0.8, 적분 한계 1.0 rad. 롤: 다리 길이 차 PI. CAD 로봇(`wbr.bench.ake_cad`, 11-07)은 순응 롤을 쓴다(`roll_compliant`: 다리 길이 PD는 평균 길이만 잡고, IMU 롤의 차동 힘 + 다리 범위 벽으로 한쪽 턱에서 몸통 수평 유지. `robot_cad_v5/README.md` 6절)와 바퀴 속도 차 요 항(`kw_yaw`: 날카로운 턱에 한쪽 바퀴가 멈춰도 로봇이 돌지 않게 차동 토크가 바퀴 속도 차에도 반응, 같은 절)을 쓴다; Plan 4 기본값에서는 둘 다 꺼져 있다.
- 속도 기준 성형(1단계·폴백): 램프 2 m/s² → 1차 전치필터 τ 0.3 s(가속 시에만) → 기준이 움직이는 동안 z1·z2·z3 동결, 전치필터가 램프의 0.05 m/s 안에 들면 해제. 0.5 m/s 스텝 오버슈트 7~13 %(전체 매트릭스), 90 % 도달 1.14~1.25 s, 정지 최대 이탈 0.21~0.24 m(끝점 0.08~0.09 m: 정지 뒤 0.12~0.16 m 되돌아감 — 동결이 풀린 z1이 정지 중 쌓인 속도 오차를 되갚는 것. 2라운드 2단계 검토 n5). 가속 피드포워드는 비최소위상 특성 때문에 악화된다(47 %).

### 1.5 200 Hz 지원

같은 설계를 Ts = 5 ms로 다시 이산화한다(게인 표, 지연 10 ms = 2 스텝, 속도 창 5 ms = 1 스텝). 200 Hz 결과는 1 kHz와 거의 같고 지연 허용(15번)은 25 ms로 기준을 만족한다(1 kHz 20 ms).

### 1.6 센서 가드와 FAULT (검토 1라운드 M2·m12)

| 조건 | 동작 |
|---|---|
| IMU 쿼터니언 비유한 또는 노름 ≠ 1 ± 0.1, 자이로·관절 위치·속도 비유한 | 추정값 유지(위치 차분 창은 시간축 유지), `max_bad_samples`(5) 연속 초과 → FAULT + 이벤트 |
| 관측 시간 스탬프가 전진하지 않음(드라이버 데이터 정지) | 추정값 유지, 50 ms(`stale_fault_s`) 초과 → FAULT |
| LQI8 입력 비유한 | 직전 출력 유지(적분기 갱신 없음) |
| 관절 토크 명령 비유한 | 0 전송 + FAULT + 이벤트(전에는 조용히 0) |
| \|피치\| > 34°, \|롤\| > 34° | FAULT(전 관절 무토크) |
| 호스트 MotionCtrl에 비유한 필드(forward·left·up·roll·pitch·leg_split) | 링크가 패킷을 거부(명령·하트비트 갱신 없음, 이벤트). 계속되면 500 ms 타임아웃 → 단절 프로그램. MCU 쪽도 비유한 명령은 적용하지 않고 `Ramp`는 비유한 목표를 무시 |
| 균형 법칙 입력 비유한 5주기 초과 | FAULT(LQI8은 그동안 직전 출력 유지) |
| 호스트 링크 500 ms 타임아웃 | 단절 프로그램(속도·요 0, 자세 유지, `host_shaped = False` → 자체 성형) |

VMC·다리 PD는 마지막 유효 서보 표본을 쓴다(2라운드 검토 M1: 엉덩이·무릎 위치 NaN이 원시 관측을 통해 VMC로 들어가 즉시 FAULT·전복했다). 단위 테스트(`tests/test_plan4_safety.py`, 두 주기): 자이로·바퀴·엉덩이·무릎 NaN 1표본(유지, 전복 없음)·8표본(FAULT 이벤트에 원인 채널명, 무토크), 같은 관측 dict를 제자리에서 NaN으로 바꿔도 유지(3라운드 m1: 200 Hz에서는 속도 창이 1스텝이라 유지 표본이 호출자 dict의 별칭이었다 → 복사해 보관), 정지 시간 스탬프(40 ms 유지, 60 ms FAULT), 시간축 유지, 지연선 준비 구간, 롤 FAULT, IMU 어댑터 왕복, 호스트 NaN 패킷(6개 필드 각각 거부, forward·pitch 0.7 s 지속 시 단절 프로그램으로 서 있음, 거부 이벤트는 첫 번째와 50개마다), 법칙 입력 비유한 계수 → MCU FAULT. 실기 진입점은 `reset(armed=False)` 뒤 직립 확인 후 `arm()`(시뮬 하네스는 armed=True); 들림 감지·관절 한계 FAULT는 아직 없다(HANDOFF 2.1).

### 1.7 호스트 성형 플래그와 플레인 모드

호스트가 `MotionCtrl.host_shaped = True`를 보내면(2단계 MPC) MCU가 LQI8을 플레인 추종(램프 4 m/s², 필터 없음)으로 바꾸고, **기준이 가속하는 동안(저역통과 0.1 s 가속도 > 0.1 m/s²) 적분기 z1·z2·z3 전부를 동결**한다(`freeze_int_on_accel_plain`). 링크 타임아웃이나 호스트의 QP 실패(폴백) 때는 플래그가 거짓이 되어 1단계 성형으로 돌아간다. MCU는 자체 기준 `v_ref`(성형된 v_filt)를 텔레메트리에 싣는다(호스트의 무충격 재동기용).

## 2. 튠 과정에서 배운 것

1. **건마찰 헌팅**: 엉덩이·무릎 0.1 Nm 건마찰은 선형 모델에 없고, 노이즈를 모두 꺼도 피치 왕복(rms 0.16°)과 x 왕복 ±3 cm를 만든다(마찰을 끄면 사라짐). 토크 노이즈가 디더 역할을 하고 있었기 때문에 속도 필터만 넣으면 헌팅이 커진다 → 운동 방향 기준 마찰 보상과 함께 써야 한다. 엉덩이 보상을 끄면 정지 피치 MA가 0.28 → 0.46~0.50°로 나빠진다.
2. **바퀴 떨림의 원인은 엔코더 미분 노이즈**: 14-bit 엔코더를 1 kHz 한 스텝으로 미분한 ±0.38 rad/s 노이즈가 θ̇ 게인을 거쳐 바퀴 토크 노이즈(rms 0.096 Nm)와 베이스 고주파 속도 6.1 mm/s가 됐다. 5 ms 위치 차분(지연 2.5 ms)으로 0.037 Nm·1.0 mm/s. 바퀴 보상(0.016 Nm)을 끄면 토크 rms가 0.029로 더 줄지만 피치 MA 0.27 → 0.44°, 드리프트 1.8 → 2.7 cm로 나빠져 유지한다.
3. **바퀴 토크 1.7 Nm 병목**: 10° 기울기 복귀 바퀴 피크가 1.27~1.32 Nm(한계 1.36)로 가장 먼저 걸린다. 위치·속도 루프를 세게 하는 모든 변경이 이 한계에 먼저 닿는다.
4. **저마찰 15° 복귀는 바퀴 슬립과의 경쟁**: m×0.85·μ0.5에서 바퀴가 0.1 s 이상 포화하면 미끄러져 넘어진다. q_pos 0.5가 포화를 0.007 s로 줄여 통과시켰고, 더 센 적분(q_int 0.1~0.15)은 다시 넘어지거나 1 kHz에서 불안정했다.
5. **요가 다리 벌어짐으로 샌다**: anti-split 60 Nm/rad. 그리고 **타이어 스크럽**: 원기둥 충돌체의 림 양끝 두 접점이 제자리 회전 때 서로 미끄러져 바퀴당 0.12~0.22 Nm를 계속 먹는다 → 타원체 충돌체. condim 4(비틀림 마찰)에서도 9번은 바퀴 rms 0.11 Nm로 통과한다(기준 0.2).
6. **경사가 적용되지 않던 버그**: `geom_quat`만 바꾸면 컴파일러의 `geom_sameframe` 표시 때문에 무시된다.
7. **질량 스케일과 밀기 힘**: `body_mass`만 바꾸면 총질량 파생값이 갱신되지 않는다(`mj_setConst`).
8. **일정 외란은 위치 이탈로 나타난다**: z1(속도 적분 = 위치)이 외란 토크를 떠안아 이동 = 외란 토크 / K_z1. 경사·페이로드·IMU 바이어스가 모두 같은 식이다. q_int 0.2 + q_pos 0.5로 경사 정지(12)는 10 cm 기준을 통과하지만 16·17의 5 cm 기준은 9~11 cm로 미달이다(4절).
9. **z_att의 유효 범위**: 가속 중에는 적분하면 안 된다(2단계 19번). 반대로 속도 오차가 클 때 멈추면 밀기 복귀가 느려진다(5번).
10. **지연 허용은 엉덩이 루프 대역폭이 정한다**: r_hip 0.15로 낮추면 30 ms지만 밀기 피치가 +3°. 10 ms 예측기를 켜면 30 ms지만 밀기 피치가 두 배다.
11. **극한 강건성과의 교환**: 합격 판정용 튠으로 표준 벤치마크의 최대 기울기는 30 → 25°, 최대 밀기는 2.5 → 1.5 W(1 kHz)·1.75 W(200 Hz)로 줄었다. 기준(20° 생존, 1.0 W 생존)은 유지된다.
12. **지연 여유는 15번 시험(3° 기울기·무노이즈)이 보여주는 것보다 작다**(검토 1라운드 M1): 노이즈·2 mm 낙하·0.5 W 밀기 조건에서 1 kHz는 12 ms까지만 깨끗하고 13 ms부터 ±3° 13 Hz 한계 사이클(20 s 동안 전복은 없음), 14 ms부터 전복; 200 Hz는 15 ms까지, 20 ms 전복. 마찰 보상을 둘 다 꺼도 같다. **주 요인은 5 ms 위치 차분 속도 창의 지연(+2.5 ms)**이다(2라운드 검토 m1): 창을 2 ms로 줄이면 1 kHz 강건 여유가 15 ms 이상이 되지만(정지 바퀴 rms 0.037 → 0.044 Nm) 10° 기울기 바퀴 피크가 1.39~1.47 Nm(> 1.36, 2번 실패), m×0.85·μ0.5 15° 복귀가 미정착(3번 실패)이 되어 5 ms를 유지한다 — 속도 창 지연 ↔ 바퀴 피크·저마찰 복귀의 교환이다. 보상의 피치 속도 게이트는 12 ms를 깨끗하게 만든다(+1 ms). 15번 기준값(≥ 25 ms)은 1 kHz 20 ms로 미달, 200 Hz 25 ms로 충족이며, 강건 여유(12/15 ms)를 함께 기록한다. 실기 루프 지연은 10 ms 안이어야 한다.
13. **지연선 준비 구간**: 시뮬 지연선이 첫 표본을 10번 반복하면 MCU의 정지 감시가 추정을 붙잡아(첫 틱의 1스텝 미분 속도 잡음 ±0.38 rad/s를 10 ms 유지) 1 kHz 10° 복귀 바퀴 피크가 1.38 Nm(> 1.36), 15° μ0.5 복귀가 공회전·전복으로 변했다. 반복 표본을 과거 시각으로 스탬프해 해결. 실기에서는 표본마다 시각이 전진하므로 생기지 않는다.
14. **타이어 condim**: 3(비틀림 마찰 없음)이 가장 낙관적이고 4가 접촉 패치를 반영한다. 9번 바퀴 rms 0.07 → 0.11 Nm 외에는 결과 차이가 작다.

## 3. 합격 판정 결과 (전체 매트릭스, `results/acceptance/plan4_<rate>Hz.md`)

### 3.1 1 kHz

| # | 항목 | 등급 | 판정 | 실행 수 | 가장 빠듯한 지표 (측정 / 기준, 여유율) | 최악 조합 |
|---|---|---|---|---|---|---|
| 1 | 정지 60 s | 필수-정착 | 통과 | 45 | pitch_rms: 0.288 <= 0.500 (×0.58) | m×1.15 μ1.00 s0 |
| 2 | 초기 기울기 10° | 필수-정착 | 통과 | 45 | wheel_peak: 1.323 <= 1.360 (×0.97) | m×0.85 μ0.50 s3 |
| 3 | 초기 기울기 15° | 필수-정착 | 통과 | 45 | wheel_rms10: 0.125 <= 0.200 (×0.63) | m×0.85 μ0.50 s0 |
| 4 | 초기 기울기 20° | 필수-생존 | 통과 | 5 | alive: O >= 1 (×0.00) | m×1.00 μ0.75 s0 |
| 5 | 밀기 0.5 W | 필수-정착 | 통과 | 45 | settle_s: 1.899 <= 3.000 (×0.63) | m×0.85 μ0.75 s1 |
| 6 | 밀기 0.75 W | 필수-정착 | 통과 | 45 | wheel_rms10: 0.122 <= 0.200 (×0.61) | m×0.85 μ1.00 s3 |
| 7 | 밀기 1.0 W | 필수-생존 | 통과 | 5 | alive: O >= 1 (×0.00) | m×1.00 μ0.75 s0 |
| 8 | 속도 스텝 0.5 m/s | 필수-정착 | 통과 | 45 | rise_s: 1.250 <= 1.500 (×0.83) | m×0.85 μ1.00 s1 |
| 9 | 요 1 rad/s | 필수-정착 | 통과 | 45 | wheel_rms10: 0.107 <= 0.200 (×0.53) | m×1.15 μ1.00 s1 |
| 10 | 4 cm 웅크림 후 복귀 | 필수-정착 | 통과 | 45 | leg_rms: 1.975 <= 4.000 (×0.49) | m×1.15 μ0.50 s2 |
| 11 | 링크 끊김(0.5 m/s 주행 중) | 필수-정착 | 통과 | 45 | stop_time: 2.358 <= 3.000 (×0.79) | m×0.85 μ1.00 s2 |
| 12 | 경사 5° 정지 | 필수-정착 | 통과 | 45 | wheel_rms10: 0.156 <= 0.200 (×0.78) | m×1.15 μ0.75 s2 |
| 13 | 경사 5° 주행 0.5 m/s(오르기·내리기) | 필수-정착 | 통과 | 45 | rise_s: 1.384 <= 1.500 (×0.92) | m×1.15 μ0.50 s0 |
| 15 | 지연 스윕(3° 기울기, 무노이즈; 강건 여유도 함께 기록) | 기록 | **실패** | 1 | max_latency_ms: 20 >= 25.000 (×1.25) | m×1.00 μ0.75 s0 |
| 16 | IMU 피치 바이어스 +1° | 필수-정착 | 통과 | 45 | drift_max: 0.072 <= 0.100 (×0.72) | m×1.15 μ0.50 s3 |
| 17 | 무게중심 전방 오프셋(0.3 kg, +10 cm) | 필수-정착 | 통과 | 45 | drift_max: 0.086 <= 0.100 (×0.86) | m×0.85 μ0.75 s2 |
| 24 | 주행 중 밀기(0.3 m/s 순항, 0.75 W; 기록, 검토 r1) | 기록 | 통과 | 1 | settle_s: 1.897 <= 4.000 (×0.47) | m×1.00 μ0.75 s0 |

실패 목록(조합별 집계):
- 15 지연 스윕(3° 기울기, 무노이즈; 강건 여유도 함께 기록): `max_latency_ms` 1회 실패(측정 20.000~20.000, 기준 >= 25.0) — m×1.00 μ0.75

### 3.2 200 Hz

| # | 항목 | 등급 | 판정 | 실행 수 | 가장 빠듯한 지표 (측정 / 기준, 여유율) | 최악 조합 |
|---|---|---|---|---|---|---|
| 1 | 정지 60 s | 필수-정착 | 통과 | 45 | pitch_ma_max: 0.686 <= 1.000 (×0.69) | m×1.15 μ0.75 s4 |
| 2 | 초기 기울기 10° | 필수-정착 | 통과 | 45 | wheel_peak: 1.288 <= 1.360 (×0.95) | m×0.85 μ0.50 s0 |
| 3 | 초기 기울기 15° | 필수-정착 | 통과 | 45 | wheel_rms10: 0.118 <= 0.200 (×0.59) | m×1.15 μ0.50 s3 |
| 4 | 초기 기울기 20° | 필수-생존 | 통과 | 5 | alive: O >= 1 (×0.00) | m×1.00 μ0.75 s0 |
| 5 | 밀기 0.5 W | 필수-정착 | 통과 | 45 | settle_s: 1.940 <= 3.000 (×0.65) | m×0.85 μ0.50 s3 |
| 6 | 밀기 0.75 W | 필수-정착 | 통과 | 45 | wheel_rms10: 0.112 <= 0.200 (×0.56) | m×1.15 μ0.50 s2 |
| 7 | 밀기 1.0 W | 필수-생존 | 통과 | 5 | alive: O >= 1 (×0.00) | m×1.00 μ0.75 s0 |
| 8 | 속도 스텝 0.5 m/s | 필수-정착 | 통과 | 45 | rise_s: 1.245 <= 1.500 (×0.83) | m×0.85 μ0.50 s3 |
| 9 | 요 1 rad/s | 필수-정착 | 통과 | 45 | wheel_rms10: 0.109 <= 0.200 (×0.54) | m×1.15 μ1.00 s1 |
| 10 | 4 cm 웅크림 후 복귀 | 필수-정착 | 통과 | 45 | leg_rms: 1.977 <= 4.000 (×0.49) | m×1.15 μ1.00 s4 |
| 11 | 링크 끊김(0.5 m/s 주행 중) | 필수-정착 | 통과 | 45 | stop_time: 2.390 <= 3.000 (×0.80) | m×0.85 μ0.50 s1 |
| 12 | 경사 5° 정지 | 필수-정착 | 통과 | 45 | wheel_rms10: 0.159 <= 0.200 (×0.79) | m×1.15 μ1.00 s2 |
| 13 | 경사 5° 주행 0.5 m/s(오르기·내리기) | 필수-정착 | 통과 | 45 | rise_s: 1.405 <= 1.500 (×0.94) | m×1.15 μ0.50 s0 |
| 15 | 지연 스윕(3° 기울기, 무노이즈; 강건 여유도 함께 기록) | 기록 | 통과 | 1 | max_latency_ms: 25 >= 25.000 (×1.00) | m×1.00 μ0.75 s0 |
| 16 | IMU 피치 바이어스 +1° | 필수-정착 | 통과 | 45 | drift_max: 0.073 <= 0.100 (×0.73) | m×1.15 μ0.75 s4 |
| 17 | 무게중심 전방 오프셋(0.3 kg, +10 cm) | 필수-정착 | 통과 | 45 | drift_max: 0.087 <= 0.100 (×0.87) | m×0.85 μ1.00 s1 |
| 24 | 주행 중 밀기(0.3 m/s 순항, 0.75 W; 기록, 검토 r1) | 기록 | 통과 | 1 | settle_s: 1.990 <= 4.000 (×0.50) | m×1.00 μ0.75 s0 |

실패 목록(조합별 집계):
- 없음

### 3.3 참고 열: upkie 기본 PI 제어기(plan1_pid, 같은 하드웨어·1 kHz·공칭·시드 0, 판정에 쓰지 않음)

| 항목 | upkie PI(참고) | Plan 4 LQI8(1 kHz 최악, 3.1절) |
|---|---|---|
| 1 정지 60 s | 피치 MA 피크 2.06°, rms 1.07°, 드리프트 0.334 m | 3.1절 표 |
| 2·3·4 기울기 10/15/20° | 생존하지만 정착 못 함(바퀴 1.7 Nm 포화) | 정착, 20° 생존 |
| 5 밀기 0.5 W | 정착 못 함, 피치 16° | 정착 ≤ 2 s |
| 6·7 밀기 0.75/1.0 W | 전복 | 정착/생존 |
| 8 속도 스텝 0.5 m/s | 오버슈트 42 %, 정상 오차 0.18 m/s, 피치 11.7° | 오버슈트 ≤ 11 %, 0.04 m/s |
| 9 요 1 rad/s | 오차 7.3 %, 바퀴 rms 0.215 Nm | ≤ 0.5 %, 0.11 Nm |
| 10 4 cm 웅크림 | 생존, 피치 6.2° | 정착 |

## 4. 실패·미해결 항목의 원인과 선택지

### 4.1 16·17(IMU 바이어스 +1°, 페이로드 0.3 kg): max |x(t) − x(0)| (t ≥ 2 s) 6.0~8.7 cm — 기준 10 cm(합격기준 6.3) 통과, 5 cm였다면 45/45회 실패

**결정(2026-10-23, 사용자 위임)**: (1) 드리프트 = 합격기준 3절 문구대로 기준점 x(0), 최댓값 탐색은 리셋 과도 2 s 뒤(`drift_max`; 옛 2 s-시점 기준은 `drift_max_from_t2`, 전 구간 x(0) 기준은 `drift_max_from_t0`로 함께 기록). (2) 16·17은 12번(경사 5° 정지)과 같은 "일정 외란 아래의 정지" 부류이고 외란 토크도 같은 등급(0.25 Nm ≈ 0.29 Nm)이라 드리프트 한계를 10 cm로 둔다; 1번은 5 cm 유지. 근거는 합격기준 6.3. **r5_s1 결과**(45회 × 2주기): 16번 7.0~7.2 / 7.1~7.3 cm(1 kHz / 200 Hz; 전 구간 x(0) 기준 최대 7.3 / 7.5, 옛 2 s 기준 8.4~8.8 / 8.4~9.1), 17번 6.2~8.6 / 6.0~8.7 cm(전 구간 x(0) 기준 최대 9.0 / 9.2, 옛 2 s 기준 8.2~10.7 / 8.1~11.0 — 옛 기준이면 m×0.85 15/45회가 10 cm를 넘는다), 1번 ≤ 1.9 / 2.0 cm(옛 2 s 기준 ≤ 2.5). 어느 x(0) 기준으로도 16·17은 10 cm 안이고 5 cm 기준으로는 두 정의 모두 실패다. 아래는 결정 전의 분석(그대로 유효).

놓은 뒤 2~4 s 동안 로봇이 6~7 cm 이동하며 새 평형(기울어진 몸체 또는 바뀐 무게중심)을 찾고, 이후 느린 왕복 ±2 cm가 겹친다. 이동량은 위치 루프의 강성(K_z1 ≈ 2.3 Nm/m)과 외란 모멘트(0.29 Nm 페이로드, 바이어스 1°에 대한 LQR 토크)로 정해지며 적분기 속도(z2·z3을 정지 중 3~10배 빠르게)로는 줄지 않았다. 강성을 더 올리는 조합(q_int 0.1~0.15, q_pos 0.3, q_v 0.3)은 모두 다른 필수 항목을 깨뜨렸다: 10° 기울기 바퀴 피크 1.45~1.53 Nm(> 1.36), μ0.5 15° 전복, 1 kHz 정지 불안정, 밀기 정착 3.2 s. 가장 가까운 조합(q_int 0.15·r_wheel 0.15·q_pos 0.2·r_hip 0.25)도 6.1~7.1 cm였다. 실제 피치는 두 항목 모두 수평에 가깝다(16번 평균 −0.01°, 17번 +0.4°: z2가 작동). **드리프트 기준점**: 합격기준 3절은 max |x(t) − x(0)|, 6절은 "2 s 시점 위치 기준"이고 배터리는 6절(2 s 기준)을 쓴다. 16·17에서는 2 s 기준이 초기 과도 중간을 기준점으로 잡아 실행마다 1~2 cm 더 크다(2라운드 검토 m3): 17번은 2 s 기준으로 10 cm를 m×0.85 전 조합 15/45회(10.2~11.0 cm) 넘지만 x(0) 기준으로는 전부 9.2 cm 이하, 16번은 두 정의 모두 ≤ 9.1 cm, 1번은 x(0) 기준 ≤ 2.0 cm(2 s 기준 ≤ 2.5 cm; 3라운드 n5). 5 cm 기준에서는 두 정의 모두 실패라 판정은 같다. **선택지였던 것**: (가) 16·17의 이탈 기준을 경사 정지(12)와 같은 10 cm로 두기 → **채택**(합격기준 6.3), (나) 실기에서 기동 시 무게중심·IMU 영점 보정 절차 → HANDOFF 2.1 12번에 운용 절차로 둠(10 cm는 보정 없이 제어기가 보장하는 상한), (다) 바퀴 모터를 2~2.5 Nm급으로 올려 위치 루프를 세게 할 여유 확보 → 하드웨어 변경이라 보류.

### 4.2 15번(지연 허용, 기록): 기준 시험 1 kHz 20 ms(미달)·200 Hz 25 ms, 강건 여유 12 / 15 ms

기준 시험(3° 기울기, 무노이즈, 정착)으로는 1 kHz 20 ms(1라운드 전 15 ms; 게이트 효과), 200 Hz 25 ms다. 검토 1라운드가 지적한 대로 이 시험은 큰 진폭의 한계 사이클을 보지 못한다: 노이즈·2 mm 낙하·0.5 W 밀기 조건에서는 1 kHz 12 ms, 200 Hz 15 ms까지만 깨끗하고 그 위에서는 13 Hz ±3° 한계 사이클 → 전복이다(2절 12). 마찰 보상을 꺼도 같고, 주 요인은 5 ms 위치 차분 속도 창의 지연이다(2라운드 검토 m1). 넓히는 방법은 r_hip 0.15(30 ms, 밀기 피치 +3°), 10 ms 예측기(30 ms, 밀기 피치 2배), 속도 창 2 ms(1 kHz 강건 여유 ≥ 15 ms, 그러나 10° 기울기 바퀴 피크 1.39~1.47 Nm로 2번 실패·μ0.5 15° 미정착으로 3번 실패)인데 모두 다른 필수 항목의 여유를 깎아 채택하지 않았다. 실기가 200 Hz(강건 15 ms)로 돈다면 1 kHz 여유는 참고값이다. 실기 루프 지연은 10 ms 안이어야 하며 측정 절차를 HANDOFF 2.1에 적었다. 15번은 사용자 결정으로 기록 항목으로 유지한다(강건 여유는 기준이 아니라 실기 요구치; `합격기준.md` 6.4).

### 4.3 4번(20° 기울기)의 저마찰 바닥 — 기록

기준상 4번은 공칭 조합(μ0.75)에서만 판정하며 시드 0~4 모두 생존한다. 참고로 μ0.5에서는 세 질량 모두 전복한다(1 kHz 피치 34~44°, 200 Hz 38~44°, 바퀴 포화 0.10~0.13 s; μ1.0은 모두 생존). 20° 복귀에 필요한 바퀴 토크가 μ0.5 접지 한계(바퀴당 약 0.6 Nm)를 넘기 때문이고, 실기에서 저마찰 바닥 위의 큰 기울기는 피해야 한다(HANDOFF 2.1).

### 4.4 측정점: base 원점

판정의 속도(vx)·위치(x)는 몸체(base) 원점 기준이다. 바퀴축 기준으로 재면 다리가 기울어진 만큼 달라서 5번 이동이 +0.04~0.05 m, 8번 정지 최대 이탈이 +0.02~0.03 m 길다(1단계 기준 0.5 m 안, 판정 불변; 2단계 19번의 0.3 m에는 민감 — `docs/plan4_mpc_host.md` 9절). 측정점은 사용자 결정으로 base 원점으로 확정(`합격기준.md` 6.4).

### 4.5 3·6번 "포화 허용"의 해석(2026-10-23 사용자 결정: 현행 유지)

판정 코드는 "포화 허용" 항목에서 바퀴 피크 상한만 빼고 10 s 이동 rms 상한은 유지한다(보수적). 이 해석과 정지 거리 정의(최대 이탈·base 원점, 4.4절), 15번의 기록 항목 유지(4.2절)는 사용자가 현행대로 확정했다(`합격기준.md` 6.4).

## 5. 남은 과제

- 16·17의 사용자 결정(4절), 3·6번 "포화 허용" 해석, 15번 강건 여유의 기준 편입 여부(합격기준 6.2).
- 실기 전 확인(HANDOFF 2.1): IMU·관절 부호, 무장 해제 시작, 마찰 보상 0부터, 루프 지연 10 ms 안, qdd100 연속 토크(다리 rms 기준 4 Nm는 가정), 112 mm 타이어와 제자리 회전 바퀴 전류.
- 다리 길이 변화 중(웅크림) 주행과 큰 롤 외란은 시험 항목에 없다.
- 플랜트 파라미터는 MuJoCo 모델값이다. 실기 측정 후 `plan4_params.json`을 다시 만들면 게인 표가 자동으로 바뀐다.

## 부록: 검토 1라운드 코드 변경(2026-10-23)

- `wbr/controllers/diablo_arch/mcu.py`: `_sample_valid`·정지 감시·`_hold_history`(센서 가드), `BaseOrientation` 어댑터(`imu_rotation_*`), `fall_roll`, `friction_comp_rate_gate`, `Estimate.v_ref`, 비유한 토크 → FAULT.
- `wbr/controllers/lqi8/lqi8.py`: 비유한 입력 가드, `reset()`이 성형 복원, `freeze_int_on_accel_plain`(플레인 모드 적분기 동결).
- `wbr/controllers/lqi8/plant_serial.py`, `wbr/models/upkie_params.py`: J_w(관절 속도), 바퀴 감쇠 관절 속도, I_w 강체만.
- `wbr/models/verify_plan4_plant.py`: 대조용 강성 접촉(`--soft-contact`), 성분별 B 오차, 선형 구간 rms, `linearization.md`.
- `wbr/models/build_upkie.py`: `--tire-condim`. 모델 `models/upkie_plan4` 재생성(타원체, condim 4).
- `wbr/plans/plan4_lqi8.py`: IMU 관례 에뮬레이션(`real_imu_convention`), 참값 키 제거, `fallen` 실제 피치, 게이트 전달. `wbr/plans/common.py`: `ObservationDelay(dt=…)` 준비 구간 스탬프.
- `wbr/controllers/diablo_arch/host_link.py`: HostEmulator 고정 게시 격자.
- `wbr/bench/acceptance.py`, `acceptance_mpc.py`: 합격기준 6.2의 정의 변경, 15번 강건 기록, 20번 자동 행, 21번 패킷 검사, 23번 일시 실패 변형, 24번.
- 2라운드: `mcu.py` VMC 입력을 마지막 유효 서보 표본으로, 쿼터니언 정규화, 법칙 입력 비유한 FAULT, 호스트 패킷 거부 이벤트; `host_link.py` 비유한 MotionCtrl 거부; `lqi8.py` 비유한 계수; `filters.py Ramp` NaN 무시; `acceptance.py` 11번 `motors_on`에 fault 반영, 캐시 키에 mujoco·numpy 버전.
- 3라운드(`docs/review_plan4_r3.md`·`review_plan4_mpc_r3.md`): `mcu.py` 유지 서보 표본을 복사해 보관(200 Hz 별칭, m1), 센서 FAULT 이벤트에 채널명(n1), 거부 패킷 이벤트 상한(n2); `acceptance.py` 16·17 드리프트 정의·10 cm(`STAND_CHECKS_DISTURBED`, 합격기준 6.3), 캐시 키에 scipy 버전(n8), 20번 이름 "< 10 %"; `acceptance_mpc.py` 패킷 속도 상한을 구간 첫 패킷에도; `reference_mpc.py`·`model.py` 명령 지연 = 기준 입력 순수 지연(`with_input_delay`, 2단계 m1), 넘김 조건(텔레메트리 속도 < 0.05 m/s, 최대 3 s)과 예측 없을 때 제동 방향 = 텔레메트리 속도(2단계 m2), QP 캐시 키, 독스트링(2단계 m4); `regression.py` 머리말.
- `tests/test_plan4_safety.py`(25개: 2라운드 20 + 3라운드 5 — 제자리 NaN·거부 이벤트 상한·법칙 입력 → MCU FAULT·지연 손잡이·0.8 m/s 정지 넘김; 기존 테스트는 두 주기·6개 필드로 확장), `tests/test_plan4.py`(기대값 2곳 갱신): 총 **83개**.
