wisehyun-2/my_robot_project/wheeled_biped/docs/review_plan4_r1.md

# Plan 4 1단계 독립 검토 — 1차 (review_plan4_r1)

작성 2026-10-23. 대상: Plan 4 1단계 = upkie 하드웨어(직렬 무릎 다리, qdd100 ×4 + mj5208 ×2, 112 mm 타이어) + LQI6(직렬 다리 3체 플랜트로 설계) + DIABLO식 호스트/MCU 분리, 램프 호스트, MuJoCo. 코드 해시 `c0d681a94d`(보고된 `results/acceptance/plan4_1000Hz.json`·`plan4_200Hz.json`과 같음). 검토자는 저자 결론을 모르는 상태에서 시작한 독립 검증자(Opus 5.5)다. 2단계 MPC 호스트(`wbr/controllers/mpc_host/`)는 다른 검토자의 범위이며 여기서는 `host_shaped` 플래그가 1단계에 미치는 영향만 봤다.

검토 중 저장소 파일은 이 문서 외에 하나도 바꾸지 않았다. 재현 실행·실험 스크립트·로그는 모두 `results/review_scratch/`(gitignore 대상)에 있다(부록 목록).

---

## 0. 요약

**major 5 · minor 13 · nit 8**

**한 줄 결론**: 보고된 합격 판정 수치는 비트 단위로 재현되고(축소 매트릭스 84회, 값 1,410개 차이 0) 판정 코드의 계산도 원시 시뮬 상태로 독립 재계산한 값과 일치하며 1단계 종합 불합격(1 kHz 6·16·17, 200 Hz 16·17)도 맞다. 그러나 **실기 안전 측면에서 (1) 1 kHz의 실제 지연 여유가 1 ms 수준(12 ms부터 한계 사이클, 15 ms 전복)으로 15번 기록 시험이 보고한 15 ms/25 ms보다 훨씬 작고, (2) NaN 센서 샘플 하나로 적분기가 영구 오염되어 FAULT 없이 넘어지며, (3) 부호 어댑터가 관절만 다뤄 실기 upkie 스파인의 IMU 관례에서 롤·요 부호가 뒤집힌다.** 문서의 6번 실패 건수(3/45 → 실제 10/45)와 모델 대조 표(원기둥 타이어 시절 수치)는 결과 파일·현재 모델로 재현되지 않는다.

| # | major 요지 | 위치 |
|---|---|---|
| M1 | 지연 여유 과대 보고: 1 kHz 정지에서 12 ms(설계 10 ms의 +20 %)부터 한계 사이클(12 ms 피치 rms 2.2°, 13 ms 13 Hz·3.4°·바퀴 rms 0.63 Nm), 15 ms 전복. 원인은 엉덩이 마찰 보상(+5 ms 속도 창). 15번 시험(3° 기울기·무노이즈·6 s)이 못 잡음 | `mcu.py:322-333`, `plan4_upkie_lqi6.py:67-69`, `acceptance.py:421-434`, `plan4_lqi8.md:16,22,85,154-161` |
| M2 | NaN 샘플 하나(자이로, 1 kHz에서는 바퀴 엔코더도)가 LQI 적분기를 영구 NaN으로 만들어 토크 0 → FAULT·이벤트 없이 0.25 s 안에 전복 | `mcu.py:176-203,348-350`, `lqi6.py:227-252` |
| M3 | 부호 어댑터가 관절만 변환. 실기 스파인의 `imu`(ARS 좌표 + IMU 180° 장착)를 그대로 넣으면 피치는 맞지만 롤·롤 속도·요 속도 부호 반전 → 롤·요 루프 양의 되먹임 | `plan4_upkie_lqi6.py:211-215`, `mcu.py:178-183`, `upkie.xml:31,240-242` |
| M4 | 6번 실패를 문서 4곳이 "m×0.85·μ0.75 시드 0~2, 45회 중 3회"로 적었으나 결과 파일은 10/45(μ0.75·μ1.0 × 시드 0~4). 원인 분석("경계 조합")도 틀림 | `plan4_lqi8.md:15,146-148`, `비교보고서.md:302`, `HANDOFF.md:20` |
| M5 | `plan4_model.md` 0·5절과 `비교보고서.md` 11.2의 MuJoCo 대조 수치가 현재 모델(타원체 타이어)로 재현되지 않음(예: L0 = 0.25 3° 응답 오차 1.33°/1.38° → 2.63°/3.07°, 정적 엉덩이 토크 −0.304~−0.310 → −0.272~−0.303 Nm). 커밋된 `linearization.json`은 L0 = 0.31 하나뿐 | `plan4_model.md:11,101,106-113`, `비교보고서.md:268` |

---

## 1. 재현 결과

### 1.1 실행

```
python -m wbr.bench.acceptance --rate both --matrix reduced --seeds 1 --tag review_r1 --jobs 6 --out results/review_scratch/acceptance
```

- 84회(정착 13항목 × 3조합 × 2주기 + 생존·기록 3 × 2), 6프로세스 61 s, 코드 해시 `c0d681a94d`. 작업자를 브리프의 8 대신 6으로 둔 것은 같은 시각 대조·단위 테스트 프로세스 2개와 합쳐 8개 이하를 지키기 위해서다. 각 실행은 시드로 결정되므로 결과는 작업자 수와 무관하다.
- 판정: 1 kHz 불합격(16·17 실패, 15 기록 실패), 200 Hz 불합격(16·17 실패). 축소 조합에는 6번의 실패 조합(m×0.85·μ ≥ 0.75)이 없으므로 6번 통과는 정상이다.
- **같은 실행끼리 비교**: 코드 해시가 같으면 캐시 키가 같으므로 84개 실행을 저자 캐시 `results/acceptance/cache/final_s1/`의 같은 키 파일과 1:1로 비교했다(`results/review_scratch/compare_runs.py`). 비교한 값 1,410개, **최대 상대 차이 0(비트 단위 동일), 판정 뒤집힘 0**.
- **보고 JSON 자체의 정합성**: 저자 캐시 1,176개(전체 매트릭스 9조합 × 5시드 × 2주기 + 생존·기록) 전부를 현재 `summarize()`에 넣어 만든 요약이 `plan4_1000Hz.json`·`plan4_200Hz.json`의 통과 여부·실패 목록·항목별 최악값과 모두 일치(불일치 0).

### 1.2 항목별 비교표

각 항목에서 재현 실행의 가장 빠듯한 지표(여유율 최대)를 골라, 같은 (항목, 조합, 시드 0, 주기)의 보고값(저자 캐시)과 재현값을 적었다. 마지막 열은 보고 JSON의 전체 매트릭스 최악값(다른 시드·조합일 수 있음)이다. ✗ = 기준 초과.

| # | 주기 | 지표 | 조합(시드 0) | 보고값 | 재현값 | 차이 | 보고 JSON 최악값 (최악 조합) |
|---|---|---|---|---|---|---|---|
| 1 | 1 kHz | pitch_rms [°] | m×1.15 μ1.00 | 0.2883 | 0.2883 | 0 | 0.2896 (m×1.15 μ1.00 s3) |
| 2 | 1 kHz | wheel_peak [Nm] | m×0.85 μ0.50 | 1.287 | 1.287 | 0 | 1.293 (m×0.85 μ0.50 s3) |
| 3 | 1 kHz | wheel_rms10 [Nm] | m×0.85 μ0.50 | 0.1171 | 0.1171 | 0 | 0.1243 (m×0.85 μ0.50 s4) |
| 4 | 1 kHz | alive | 공칭 | O | O | 0 | O |
| 5 | 1 kHz | settle_s [s] | m×0.85 μ0.50 | 1.875 | 1.875 | 0 | 1.882 (m×0.85 μ0.75 s3) |
| 6 | 1 kHz | wheel_rms10 [Nm] | m×1.15 μ1.00 | 0.1179 | 0.1179 | 0 | 0.2269 ✗ (m×0.85 μ0.75 s2) |
| 7 | 1 kHz | alive | 공칭 | O | O | 0 | O |
| 8 | 1 kHz | rise_s [s] | m×0.85 μ0.50 | 1.234 | 1.234 | 0 | 1.248 (m×0.85 μ0.50 s1) |
| 9 | 1 kHz | wheel_rms10 [Nm] | m×1.15 μ1.00 | 0.06837 | 0.06837 | 0 | 0.06891 (m×1.15 μ1.00 s2) |
| 10 | 1 kHz | leg_rms [Nm] | m×1.15 μ1.00 | 1.406 | 1.406 | 0 | 1.407 (m×1.15 μ0.50 s1) |
| 11 | 1 kHz | stop_time [s] | m×0.85 μ0.50 | 2.259 | 2.259 | 0 | 2.286 (m×0.85 μ0.50 s2) |
| 12 | 1 kHz | wheel_rms10 [Nm] | m×1.15 μ1.00 | 0.1543 | 0.1543 | 0 | 0.1547 (m×1.15 μ0.50 s2) |
| 13 | 1 kHz | rise_s [s] | m×1.15 μ1.00 | 1.385 | 1.385 | 0 | 1.390 (m×1.15 μ0.50 s2) |
| 15 | 1 kHz | max_latency_ms | 공칭 | 15 | 15 | 0 | 15 ✗ (기준 ≥ 25, 기록) |
| 16 | 1 kHz | drift_max [m] | m×0.85 μ0.50 | 0.08623 ✗ | 0.08623 ✗ | 0 | 0.08688 ✗ (m×0.85 μ0.50 s2) |
| 17 | 1 kHz | drift_max [m] | m×0.85 μ0.50 | 0.1036 ✗ | 0.1036 ✗ | 0 | 0.1048 ✗ (m×0.85 μ0.50 s1) |
| 1 | 200 Hz | pitch_ma_max [°] | m×1.15 μ1.00 | 0.6212 | 0.6212 | 0 | 0.6874 (m×1.15 μ0.50 s4) |
| 2 | 200 Hz | wheel_peak [Nm] | 공칭 | 1.251 | 1.251 | 0 | 1.251 (m×1.00 μ0.50 s0) |
| 3 | 200 Hz | wheel_rms10 [Nm] | m×1.15 μ1.00 | 0.1167 | 0.1167 | 0 | 0.1175 (m×1.15 μ0.50 s3) |
| 4 | 200 Hz | alive | 공칭 | O | O | 0 | O |
| 5 | 200 Hz | settle_s [s] | m×0.85 μ0.50 | 1.935 | 1.935 | 0 | 1.945 (m×0.85 μ0.50 s1) |
| 6 | 200 Hz | wheel_rms10 [Nm] | m×1.15 μ1.00 | 0.1099 | 0.1099 | 0 | 0.1120 (m×1.15 μ0.75 s2) |
| 7 | 200 Hz | alive | 공칭 | O | O | 0 | O |
| 8 | 200 Hz | rise_s [s] | m×0.85 μ0.50 | 1.215 | 1.215 | 0 | 1.245 (m×0.85 μ0.50 s3) |
| 9 | 200 Hz | wheel_rms10 [Nm] | m×1.15 μ1.00 | 0.0711 | 0.0711 | 0 | 0.07339 (m×1.15 μ1.00 s2) |
| 10 | 200 Hz | leg_rms [Nm] | m×1.15 μ1.00 | 1.406 | 1.406 | 0 | 1.409 (m×1.15 μ0.50 s4) |
| 11 | 200 Hz | stop_time [s] | m×0.85 μ0.50 | 2.300 | 2.300 | 0 | 2.365 (m×0.85 μ0.50 s1) |
| 12 | 200 Hz | wheel_rms10 [Nm] | m×1.15 μ1.00 | 0.1557 | 0.1557 | 0 | 0.1558 (m×1.15 μ0.75 s0) |
| 13 | 200 Hz | rise_s [s] | m×1.15 μ1.00 | 1.410 | 1.410 | 0 | 1.410 (m×1.15 μ0.50 s0) |
| 15 | 200 Hz | max_latency_ms | 공칭 | 25 | 25 | 0 | 25 |
| 16 | 200 Hz | drift_max [m] | 공칭 | 0.08765 ✗ | 0.08765 ✗ | 0 | 0.08817 ✗ (m×0.85 μ0.50 s4) |
| 17 | 200 Hz | drift_max [m] | m×0.85 μ0.50 | 0.0990 ✗ | 0.0990 ✗ | 0 | 0.1075 ✗ (m×0.85 μ0.75 s1) |

5 % 초과 차이나 판정 뒤집힘은 없다(브리프 기준의 재현 major 없음).

### 1.3 원시 로그로 한 독립 재계산 (판정 코드 버그 탐지)

`results/review_scratch/independent_metrics.py`: 판정 시나리오와 같은 호출 순서(같은 RNG·물리)로 돌리되, 매 제어 스텝 뒤 `mujoco.MjData`에서 직접(지연 없는 `actuator_force`, `xmat`에서 자체 공식으로 구한 피치, 바퀴축 위치) 기록하고, 이동평균·10 s 이동 rms·정착 시간을 판정 코드를 쓰지 않고 다시 구현해 계산했다.

| 항목 | 지표 | 독립 1 kHz | 판정/캐시 1 kHz | 독립 200 Hz | 판정/캐시 200 Hz |
|---|---|---|---|---|---|
| 1 | pitch_ma_max(2 s 이후, 20 ms 중심 이동평균, 가장자리 복제) | 0.2932° | 0.2932° | 0.4212° | 0.4212° |
| 1 | pitch_rms | 0.1484° | 0.1484° | 0.1511° | 0.1511° |
| 1 | drift_max(2 s 시점 기준) | 0.0228 m | 0.0228 m | 0.0170 m | 0.0170 m |
| 1 | wheel_rms10(지연 없는 실제 토크) | 0.0372 Nm | 0.0372 Nm | 0.0443 Nm | 0.0443 Nm |
| 1 | wheel_peak / 포화 비율 | 0.1207 / 0 | 0.1207 / 0 | 0.1291 / 0 | 0.1291 / 0 |
| 5 | settle_s | 1.817 s | 1.817 s | 1.795 s | 1.795 s |
| 5 | pitch_peak | 2.600° | 2.600° | 3.089° | 3.089° |
| 5 | wheel_peak / wheel_rms10 | 0.4492 / 0.0740 | 0.4492 / 0.0740 | 0.3095 / 0.0693 | 0.3095 / 0.0693 |
| 8 | rise_s / overshoot / ss_err | 1.222 s / 8.97 % / 0.0344 | 같음 | 1.200 s / 10.40 % / 0.0351 | 같음 |
| 8 | pitch_peak | 1.232° | 1.232° | 1.306° | 1.306° |
| 11 | stop_time | 2.162 s | 2.162 s | 2.160 s | 2.160 s |
| 10 | 최소 다리 길이(실제 기하 / MCU 추정) | 0.2662 m | 0.2661 m | 0.2654 m | 0.2655 m |
| 2 | settle_s | 1.348 s | 1.347 s | 1.380 s | 1.375 s |
| 2 | wheel_peak | 1.2341 Nm | 1.2341 Nm | 1.2509 Nm | 1.2509 Nm |

2번 settle_s의 1샘플 차이는 경계 부등호(내 구현 `≥ 1°`, 판정 `> 1°`) 차이다. **로그 토크가 10 ms 지연된 관측값이라는 점(아래 5절)은 피크·rms에 영향이 없음**을 확인했다. 같은 스크립트의 대안 정의 값(끝점 대신 최대 이탈 등)은 m2·m5에 정리했다.

---

## 2. 모델 유도 검토 (`docs/plan4_model.md`, `plant_serial.py`, `serial_leg.py`, `upkie_params.py`)

### 2.1 유도의 수학적 타당성 — 정상

- **일반화 좌표**: q = (x, θ, φ). θ = 가상 다리(바퀴축→엉덩이) 각, +y 회전·엉덩이가 앞일 때 양; φ = 몸체 피치, −y 회전(= −IMU 피치). 엉덩이 p_h = (x + L0 sin θ, R + L0 cos θ), 몸체 COM = p_h + R_y(−φ)(b_x, b_z), 다리 COM = 바퀴축 + c(sin θ, cos θ) + d(cos θ, −sin θ). 모두 회전 규약과 일치한다(`plant_serial.py:66-68`).
- **운동 에너지**: 바퀴 ½(m_w + I_w/R²)ẋ², 다리 ½m_l|ṗ_l|² + ½I_l θ̇²(L0 고정 → 허벅지·종아리가 가상 다리와 강체 회전), 몸체 ½m_b|ṗ_b|² + ½I_b φ̇², 엉덩이 로터 ½J_h(θ̇ + φ̇)². 위치 에너지 V = g(m_l z_l + m_b z_b)(바퀴 높이 일정).
- **입력(가상일)**: 엉덩이 모터는 몸체–허벅지 사이 → δW = Tp(δθ − δψ_body) = Tp(δθ + δφ) ⇒ θ·φ 모두 +Tp. 바퀴 모터는 종아리–바퀴 사이 → δW = T(δx/R − δθ) ⇒ Q_x = T/R, Q_θ = −T(반작용은 다리만). 브리프의 "q_hip = θ + φ, 양쪽 +Tp, 다리에 −T"와 정확히 같다(`plant_serial.py:81`). 평행사변형 가정은 없다(5절 링크용 `plant6.py`를 쓰지 않음).
- **평형**: φ = 0, T = 0에서 ∂V/∂θ = Q_θ = Tp, ∂V/∂φ = Q_φ = Tp ⇒ m_l(d cos θ + c sin θ) + m_b(L0 sin θ + b_x) = 0(전체 COM이 바퀴축 위), Tp_eq = m_b g b_x = −0.314 Nm. 직접 다시 유도해 같은 식을 얻었다.
- **선형화**: E가 q에 무관하고 평형에서 q̇ = 0이므로 M(q_eq)δq̈ = −H_V δq − Dδq̇ + Eδu가 정확한 1차 근사다(코리올리 항은 2차, ∂V/∂q ≠ 0인 평형이지만 H_V로 선형화하는 것이 맞음). 단위 테스트가 비선형 deriv의 수치 미분과 A·B를 1e−6 수준으로 맞춘다.
- **정적 자세 적분 e_att = θ + φ + (Tp − T)/(gM)**: 정적 방정식 −gM δθ = −δT + δTp에서 정지 시 e_att = φ_true가 되고, IMU 바이어스는 θ + φ(= 엔코더의 몸체 기준 다리각)에서 상쇄된다. 수식이 맞고 결과도 일치한다(16번 실제 피치 평균 −0.006~−0.017°, 17번 +0.39°: 문서 1.3절과 같음). M(0.31) = 1.153 kg·m(문서 1.15).

### 2.2 `python -m wbr.models.verify_plan4_plant` 재실행

기본 `--out`이 저장소의 `results/plan4_model/`을 덮어쓰므로 `--out results/review_scratch/plan4_model`로 돌렸다(n6 참고). L0 = 0.31 결과는 커밋된 `linearization.json`과 비트 단위로 같다.

| L0 [m] | θ_eq | 불안정 극 모델 / MuJoCo [rad/s] | 극 오차 | B 오차(노름) 바퀴 / 엉덩이 | 3° 0.3 s rms 오차 θ / φ / x | 0.3 s 후 θ MuJoCo / 모델 | 정적 엉덩이 토크 MuJoCo / 모델 [Nm] |
|---|---|---|---|---|---|---|---|
| 0.25 | −8.00° | 6.114, 10.255 / 6.146, 9.943 | 0.52 %, 3.04 % | 5.04 % / 1.26 % | 2.63° / 3.07° / 12.2 mm | 11.3° / 21.1° | −0.272 / −0.314 |
| 0.28 | −5.79° | 6.122, 10.175 / 6.148, 9.875 | 0.42 %, 2.95 % | 4.83 % / 1.13 % | 0.24° / 1.79° / 2.0 mm | 20.8° / 22.4° | −0.280 / −0.314 |
| 0.31 | −3.48° | 6.127, 10.065 / 6.146, 9.778 | 0.31 %, 2.85 % | 4.61 % / 1.01 % | 0.28° / 1.21° / 1.9 mm | 22.9° / 23.7° | −0.291 / −0.314 |
| 0.33 | −1.54° | 6.128, 9.979 / 6.142, 9.702 | 0.22 %, 2.78 % | 4.46 % / 0.93 % | 0.43° / 0.64° / 2.3 mm | 23.8° / 25.0° | −0.303 / −0.314 |

- 브리프 기준: **불안정 극 오차 < 10 %(두 극 모두) 충족, B 오차 < 10 % 충족**. 개루프 3° 응답은 L0 ≥ 0.28에서 양호, L0 = 0.25에서 0.3 s 뒤 θ가 MuJoCo 11.3° vs 모델 21.1°로 크게 갈린다(문서 표는 15.0° vs 21.1°로 적혀 있어 재현되지 않음 → M5).
- 모든 L0에서 정적 평형의 base 잔차가 1.18(성분: **Fz = −1.176 N**, My = 0.0225 Nm)이고 정적 토크를 건 순동역학 가속도가 0이 아니다(base 0.93, hip 1.17). 원인은 m10 참고.
- **B 행렬 성분별 오차**(L0 = 0.31): 바퀴 토크 (ẍ, θ̈, φ̈) = (3.3 %, 4.8 %, 0.2 %), 엉덩이 토크 = (**7.2 %**, 3.6 %, 0.2 %). 벡터 노름 오차(1.0 %)는 큰 φ̈ 성분이 지배해 ẍ 성분의 7 %를 가린다.

### 2.3 단순화에 대한 의견

- **무릎 잠금(아마추어 1000 kg·m²)**: 질량 행렬의 슈어 보수로 보면 M_kk → ∞에서 나머지 자유도는 무릎을 강체로 묶은 계와 같아지므로 축약 모델의 가정(L0 고정)을 검증하는 방법으로 타당하다. 다만 폐루프에서는 다리 PD(800 N/m, ≈3 Hz)가 L0를 잡으므로 다리 길이 모드는 모델 밖이다(문서 6절에 명시).
- **건마찰 0으로 끔**: 쿨롱 마찰은 미분할 수 없어 유한 차분 선형화에서 꺼야 한다(켜면 엉덩이가 잠긴 것처럼 보여 극 하나가 사라짐: 문서 5절). 그러나 **폐루프 거동에서는 이 0.1 Nm 마찰과 그 보상기가 지배적인 비선형성**이 되어(M1의 한계 사이클), 선형 모델의 지연 여유가 실제 여유를 대표하지 못한다.
- **noslip 끔**: `mj_inverse`와의 일관성을 위해 필요하다. 합격 판정 시뮬은 noslip 2를 쓰지만 선형 대조에는 영향이 작다.
- **연한 접촉 임피던스(solimp 0.9/0.95)**: base 잔차 Fz −1.18 N과 정적 엉덩이 토크의 7 % 차이(−0.291 vs −0.314)의 원인이다. 바닥·타이어 solimp를 0.99/0.999로 올리면 잔차 0.16 N, 정적 토크 −0.3165(0.8 %), 느린 극 오차 0.03 %, 3° φ 오차 1.21° → 0.03°가 된다(B 오차는 변하지 않음). 즉 플랜트 문제가 아니라 대조 절차의 문제다(m10).
- **바퀴 로터 아마추어의 처리**(문서에 없는 단순화): `upkie_params.py:116`이 바퀴 관절 아마추어(2×0.0003 kg·m², I_w의 63 %)를 I_w에 넣어 절대 회전 ẋ/R에 붙이는데, MuJoCo는 아마추어를 관절 상대 속도 ẋ/R − θ̇에 붙인다. 이것을 ½J_a(ẋ/R − θ̇)²로 고치면(바퀴 감쇠도 상대 속도로) **빠른 불안정 극 오차가 2.8~3.1 % → 0.04~0.05 %(네 L0 모두, MuJoCo 극 기준), B 성분 오차가 최대 7.2 % → 1.3 %**로 줄어든다. 문서가 "다리 관성의 집중화와 로터 아마추어 처리에서 오는 것으로 보인다"고 한 3 % 차이의 원인이 이것으로 특정된다(m9).

---

## 3. 코드 검토 findings (등급순)

### Major

#### M1. 지연 여유가 15번 기록 시험보다 훨씬 작다 — 1 kHz는 12 ms부터 한계 사이클, 15 ms 전복 (실기 안전)

- **위치**: `wbr/controllers/diablo_arch/mcu.py:322-333`(엉덩이·바퀴 마찰 보상), `wbr/plans/plan4_upkie_lqi6.py:67-69`(0.08 / 0.016 Nm, 5 ms 속도 창), `wbr/bench/acceptance.py:421-434`(15번: 3° 기울기·무노이즈·6 s만), 문서 `plan4_lqi8.md:16,22,85,154-161`, `HANDOFF.md:31`.
- **근거**(`results/review_scratch/latency_stand.log`, `latency_excitation.log`, `latency_tilt_vs_stand.log`, `limit_cycle_cause.log`, `extra_checks.json`):
  - 1 kHz, 30 s 정지(1번과 같은 0.5 mm 낙하 시작): 10~12 ms 피치 rms 0.09~0.16°. **13 ms: 노이즈 유무와 무관하게 13.1 Hz 진동이 계속(피치 rms 3.4°, 바퀴 rms 0.63 Nm)**, 14 ms: 12.6 Hz·4.0°, **15·16 ms: 0.9~1.9 s 안에 전복**(시드 3개 + 무노이즈 모두).
  - 교란 크기별(1 kHz): 10·11 ms는 2·5 mm 낙하, 0.2·0.5 W 밀기(+노이즈)에 모두 견고. **12 ms: 2 mm 낙하나 0.5 W 밀기 뒤 피치 rms 2.22°의 한계 사이클이 끝까지 남음**. 13 ms + 노이즈 + 0.5 W 밀기 → 3.45 s에 전복. 즉 견고한 여유는 설계 지연 10 ms 대비 **+1 ms**다.
  - 같은 지연에서 3° 기울기로 시작하거나 낙하 없이 시작하면 30 s 동안 안정하다(13·15·16 ms). 평형점은 국소적으로 안정하지만 **큰 진폭의 한계 사이클이 공존**하는 비선형 거동이라, 기울기 시작만 보는 15번 시험(그리고 저자의 1 ms 단위 결과 16 ms까지 "정착")은 이것을 볼 수 없다.
  - 200 Hz: 15 ms는 낙하·밀기·노이즈에 견고, **20 ms는 2 mm·5 mm 낙하에서 0.75~1.0 s에 전복**, 노이즈 3° 기울기 20 ms는 5시드 중 3개, 25 ms는 5개 모두 전복(15번 보고값 25 ms는 무노이즈 기준).
  - 원인 분리(1 kHz, 낙하 시작, 무노이즈): 엉덩이 마찰 보상만 끄면 13 ms 0.14°·15 ms 0.12°(안정), 바퀴 보상만 끄면 13 ms 안정·15 ms 전복, tanh 폭 0.02 → 0.2 Nm는 효과 없음(3.41°, 전복), 속도 창 5 → 2 ms면 13·15 ms 모두 0.08°, 10 ms 예측기를 켜면 0.09°. **엉덩이 마찰 보상이 고역통과된 토크 편차(dev − LPF₁ₛ(dev))를 ±0.16 Nm 릴레이에 넣어 균형 루프의 고주파 이득을 키우는 것이 주 원인이고, 5 ms 위치 차분 속도(지연 +2.5 ms)가 여유를 더 깎는다.**
- **영향**: 1·16·17번 같은 정지 항목의 판정 조건(10 ms)에서는 문제가 없지만, 실기 지연이 12 ms만 돼도 바닥 착지나 가벼운 접촉으로 ±5° 13 Hz 진동이 시작될 수 있다. 문서의 "지연 허용 1 kHz 15 ms·200 Hz 25 ms(20 ms)"는 실기 안전 판단 근거로 쓸 수 없다.
- **수정안**: (1) 엉덩이 마찰 보상을 균형 루프 대역(≈10 Hz)에 이득을 더하지 않는 형태로 바꾼다 — 측정 관절 속도의 부호(데드밴드·히스테리시스)나 0.5 Hz 이하로 저역통과한 dev를 쓰거나, 크기를 낮추거나, 끄고 헌팅은 적분기 설계로 다룬다. (2) 속도 창을 2 ms로 줄이거나 지연이 작은 2차 필터로 바꾼다. (3) 1 kHz는 10 ms 예측기도 후보(문서 3.5의 밀기 피치 비용과 비교). (4) 바꾼 뒤 전체 매트릭스 재판정. (5) 사용자에게 15번 보조 기록 지표를 제안: "수평 시작 2 mm 낙하 + 0.5 W 밀기 + 노이즈, 20 s, 1 kHz는 1 ms·200 Hz는 5 ms 간격, 마지막 10 s 피치 rms < 0.5°를 유지하는 최대 지연"(기준 변경은 사용자 결정). (6) `plan4_lqi8.md`·`HANDOFF.md`·`비교보고서.md`의 지연 허용 서술 정정.

#### M2. NaN 센서 샘플 하나로 적분기가 영구 오염되어 FAULT 없이 넘어진다 (실기 안전)

- **위치**: `mcu.py:176-203`(추정기에 입력 검증 없음), `lqi6.py:227-252`(z, z_att, z_pos가 NaN을 그대로 적분), `mcu.py:348-350`(NaN 토크를 조용히 0으로 바꿈, 이벤트·FAULT 없음).
- **근거**(`results/review_scratch/extra_checks.py` D, 노이즈 ON, 10 ms 지연, t = 2 s에 한 샘플만 NaN): 1 kHz 자이로 NaN → 2.253 s에 전복, `fault=False, armed=True, events=[]`, 적분기 비유한. 1 kHz 왼쪽 바퀴 엔코더 NaN → 같은 결과(5 ms 위치 차분이 NaN 속도를 만듦). 200 Hz 자이로 NaN → 2.255 s 전복. 200 Hz 엔코더 NaN만 생존(이 주기에서는 위치 차분을 쓰지 않음).
- **영향**: 실기에서 IMU 패킷 손상·CAN 읽기 오류 한 번이면 모든 토크가 0이 된 채(무장 상태 유지) 로봇이 쓰러지고 원인 기록도 남지 않는다. `review B13`의 "모터에 NaN을 보내지 않는다" 보호가 오히려 고장을 숨긴다.
- **수정안**: 추정기 입구에서 쿼터니언(유한, 노름 ≈ 1)·자이로·관절 위치·속도의 유한성을 검사하고, 무효면 마지막 유효 샘플을 최대 N주기(예: 5 ms) 유지한 뒤 FAULT로 전환한다. LQI6 적분기는 비유한 입력이면 갱신하지 않고 이전 값을 복원한다. 출력 토크가 비유한이면 0으로 바꾸는 대신 FAULT + 이벤트를 남긴다. 두 주기 × (자이로, 엔코더) NaN 주입 단위 테스트를 추가한다.

#### M3. 부호 어댑터가 관절만 다룬다 — 실기 upkie의 IMU 관례에서 롤·요 부호가 뒤집힌다 (실기 안전, 이식 시 확실히 발생)

- **위치**: `plan4_upkie_lqi6.py:211-215`(관절 위치·속도·토크만 변환), `mcu.py:178-183`(`obs["imu"]`를 월드(z 위) 기준 base 자세로 가정), `models/upkie_plan4/upkie.xml:240-242`(시뮬 IMU 센서는 `base` 사이트), `:31`(실제 IMU 바디는 quat `0 0 1 0` = y축 180° 장착).
- **근거**: 참조 upkie 스파인에서 `observation("imu")`의 `orientation`은 ARS 좌표(+x 앞, +y 오른쪽, +z 아래)의 IMU 자세, `angular_velocity`는 IMU 좌표다(`references/upkie/upkie/cpp/observers/BaseOrientation.cpp:19-30`, `upkie/model/model.py:105-106`의 `rotation_ars_to_world = diag(1, −1, −1)`, `rotation_base_to_imu`는 URDF에서). `results/review_scratch/imu_convention_check.py`로 MCU 추정 세 줄을 그 관례에 적용하면: 피치 +5° → +5°, 피치 속도 정상, **롤 +4° → −4°, 롤 속도 +0.2 → −0.2, 요 속도 +1.0 → −1.0 rad/s**. 롤 PI(다리 길이 차)와 요 PI(차동 바퀴 토크)가 양의 되먹임이 된다. HANDOFF 2절 5단계는 "`Plan4UpkieLQI6`의 MCU를 균형 노드로 쓰고"라고만 적어 이 변환이 빠질 위험이 크다.
- **수정안**: 어댑터에 IMU 변환을 추가한다 — upkie의 `compute_base_orientation_from_imu`·`compute_base_angular_velocity_from_imu`(ARS → 월드, IMU → base)와 같은 변환을 하거나 스파인의 `base_orientation` 관측기 출력을 쓴다. 시뮬도 IMU 센서를 `imu` 사이트 + ARS 반전으로 내보내게 바꿔 어댑터가 매 판정에서 실행되게 하고, 알려진 base 운동(롤·피치·요)에 대해 MCU 추정 부호를 확인하는 단위 테스트를 둔다. 실기 첫 매달기 시험에서 롤·요 부호를 따로 확인하는 절차를 HANDOFF에 넣는다.

#### M4. 6번 실패 건수와 원인 분석이 결과 파일과 다르다 (재현되지 않는 수치, 사용자 결정에 영향)

- **위치**: `docs/plan4_lqi8.md:15`(요약표), `:146-148`(4.1절 제목·분석), `docs/비교보고서.md:302`, `docs/HANDOFF.md:20`.
- **근거**: 네 곳 모두 "m×0.85·μ0.75 시드 0~2, 45회 중 3회"라고 적었지만 `results/acceptance/plan4_1000Hz.md`의 실패 목록과 저자 캐시는 **10/45회**: m×0.85·μ0.75 시드 0~4(0.2219~0.2269 Nm)와 m×0.85·μ1.00 시드 0~4(0.2215~0.2258 Nm). 200 Hz는 0/45. 4.1절의 "가벼운 로봇(0.85)이 μ0.75에서 접지가 잡힐 때의 경계 조합"이라는 설명도 μ1.0이 같은 크기로 실패하므로 맞지 않다. 이 실패는 시드와 무관한 **m×0.85·μ ≥ 0.75의 체계적 실패**다.
- **수정안**: 네 곳을 "10/45회(m×0.85의 μ0.75·μ1.0, 시드 0~4, 0.2215~0.2269 Nm)"로 고치고, 4.1절의 원인 분석과 선택지(1 kHz 바퀴 채널 게인 조정 vs 200 Hz 운용)를 이 사실에 맞게 다시 쓴다. 200 Hz 운용으로 "확정"하는 것은 18번(두 주기 모두 채점)과 충돌하므로 사용자 결정임을 분명히 한다.

#### M5. 모델 대조 문서 수치가 현재 모델로 재현되지 않는다 (재현되지 않는 수치)

- **위치**: `docs/plan4_model.md:11`(요약), `:101`(정적 토크), `:106-113`(대조 표), `docs/비교보고서.md:268`(11.2), `results/plan4_model/linearization.json`(L0 = 0.31만 있음).
- **근거**(2.2절 표, `results/review_scratch/verify_plant.log`): 문서 vs 재실행 — 정적 엉덩이 토크 −0.304~−0.310 vs **−0.272~−0.303 Nm**; L0 = 0.31 MuJoCo 극 6.133, 9.771 vs 6.146, 9.778; 3° rms θ/φ 0.47°/0.61° vs **0.28°/1.21°**; L0 = 0.25 1.33°/1.38°/6.0 mm vs **2.63°/3.07°/12.2 mm**, 0.3 s 후 θ(MuJoCo) 15.0° vs **11.3°**; L0 = 0.28 φ 0.79° vs 1.79°. 문서 수치는 타이어를 원기둥에서 타원체로 바꾸기 전(`plan4_lqi8.md:26`)의 것으로 보이며, 커밋된 JSON은 L0 = 0.31 하나만 다시 만들어졌다. 결론("극 오차 < 10 %")은 유지된다.
- **수정안**: 현재 모델로 네 L0를 모두 다시 돌려 `linearization.json`·그림·두 문서의 표와 요약을 갱신한다. 표에 base 잔차와 B 성분별 오차를 추가하고 m9·m10을 반영한 뒤의 값도 함께 적는다.

### Minor

| # | 내용 | 위치 | 근거 | 수정안 |
|---|---|---|---|---|
| m1 | 필수-생존(4·7)을 시드 0 하나로만 실행. 기준은 "노이즈 시드 5개, 필수 항목은 전부 통과" + "생존은 공칭 조합에서만" | `acceptance.py:613-614` | 시드 1~4를 추가로 돌려 두 주기 모두 통과(판정 불변). 참고: 4번(20°)은 **μ0.5에서 세 질량 모두 전복**(피치 35~46°, 바퀴 포화 0.09~0.14 s), 7번은 9조합 모두 생존 — 기준상 판정 대상은 아니나 실기 저마찰 바닥 위험 | 생존·기록 항목도 공칭 조합 × 시드 0~4로 실행. 4번 μ0.5 결과를 보고서에 참고로 기록 |
| m2 | "이동"(2·3·5번)과 "정지 거리"(8·13번)를 끝점 변위로 계산. 위치 적분 z3이 로봇을 출발점으로 되돌려 실제 이탈을 크게 과소평가 | `acceptance.py:275,292,320` | 9조합 최악: 5번 끝점 0.0036 m vs 최대 이탈 0.148 m(40배), 2번 0.087 vs 0.134, 3번 0.131 vs 0.190, 8번 0.086 vs 0.241, 13번 0.116 vs 0.239 m. 모두 기준(0.3/0.5 m) 안이라 판정 불변 | 최대 이탈(max |x − x_ref|)을 판정값으로, 끝점은 기록으로. 속도 지표가 base COM 속도라는 점도 명시(바퀴축 속도 기준 오버슈트는 13.4~13.7 %로 더 큼, 둘 다 < 20 %) |
| m3 | 정지형 항목(1·12·16·17) 판정 목록에 `alive`가 없음 — 높이 기준(베이스 < 60 %)으로 넘어져 로그가 잘린 실행이 통과할 수 있음 | `acceptance.py:96-102,126-128` | `evaluate(item, {alive: False, 나머지 정상값})` → 네 항목 모두 전 검사 통과(합성 시험). 실제 180회 실행은 모두 alive라 판정 불변 | `Check("alive", ">=", 1)`을 STAND_CHECKS와 12번에 추가 |
| m4 | 정착 정의에 최소 유지 시간이 없음(마지막 위반이 끝에서 3샘플 전이면 "정착") | `acceptance.py:179-181` | 8·10·11·13번은 `settled`만 보므로 영향 가능. 9조합 최소 유지 시간 8번 1.09 s, 13번 1.07 s, 10번 2.5 s, 11번 3.7 s로 현재는 판정 불변 | 위반 후 유지 ≥ 1 s 조건을 추가하거나 정지 구간을 늘림 |
| m5 | 11번이 0.5 m/s "주행 중"이 아니라 1 s 가속 직후(9조합에서 약 0.37~0.39 m/s, 최소 0.372)에 링크를 끊음. 램프 2 m/s² + 0.3 s 전치필터로 1 s 안에 0.5에 못 미침 | `acceptance.py:383` | 끊긴 뒤 500 ms 타임아웃 동안 0.5 명령이 유지되어 해제 시점 속도는 0.50 m/s 이상(최소 0.503). 3 s 순항 뒤 끊으면 정지 2.385/2.42 s(1 kHz/200 Hz, ≤ 3 s), 생존·armed 유지 — 판정 불변 | 끊기 전 2.5~3 s 주행으로 기준 문구와 맞춤 |
| m6 | 다리 rms를 4관절 합동·전 구간으로 계산(모터별이 아님), 포화 비율은 두 바퀴 평균 | `acceptance.py:191-195` | 관절별 최댓값 1.97 Nm vs 합동 1.41 Nm(10번, 기준 4 Nm). 바퀴별 포화 비율은 평균과 같음 — 판정 불변 | 모터별 rms(필요하면 10 s 이동 rms)의 최댓값, 바퀴별 포화 비율의 최댓값으로 판정 |
| m7 | 3·6번 "포화 허용"의 해석: 합격기준 3절 "바퀴 피크 상한을 빼고 포화 지속만 본다"를 판정 코드는 "피크만 빼고 10 s rms는 유지"로 해석 | `acceptance.py:110,115,488-496` | 6번 1 kHz 실패(10/45)는 전부 wheel_rms10. "바퀴는 포화 지속만"으로 읽으면 1 kHz 6번은 통과 | 보수적 해석은 타당하나 판정을 바꾸는 해석이므로 사용자 확인을 받아 기준 문서에 명시 |
| m8 | 캐시 해시가 일부 파일만 포함(`upkie.xml`·`scene.xml`·`wbr/common/*.py`·`fivebar.py`·`plant6.py`·`wbr/models/*` 없음) | `acceptance.py:505-517` | 이번에는 타이어 변경과 `plan4_params.json` 재생성이 동시였지만, 모델 XML만 바꾸면 오래된 캐시를 그대로 씀 | `wbr/` 전체 `.py`와 모델 디렉터리 전체 파일을 해시 |
| m9 | 플랜트가 바퀴 로터 아마추어(및 바퀴 감쇠)를 절대 회전 ẋ/R에 붙임(MuJoCo는 상대 회전 ẋ/R − θ̇) | `plant_serial.py:74,81,241`, `upkie_params.py:116` | 2.3절: 고치면 빠른 극 오차 2.8~3.1 % → 0.04~0.05 %, B 성분 오차 최대 7.2 % → 1.3 % (`results/review_scratch/armature_poles.py`, `model_and_doc_checks.log`) | KE에 ½J_a(ẋ/R − θ̇)²를 따로 두고 I_w에서 아마추어를 빼며, 바퀴 감쇠를 상대 속도로. 게인 표 재생성 |
| m10 | 대조 스크립트의 절차 문제: (a) `mj_inverse` + 연한 접촉으로 base Fz 잔차 −1.18 N(평형이 아님) → 정적 엉덩이 토크 7 % 차이·개루프 φ 오차 과대, (b) B 오차를 벡터 노름으로 내 성분 오차(7.2 %)를 가림, (c) 0.3 s 개루프 창이 20° 이상 비선형 영역까지 감 | `verify_plan4_plant.py:87-93,194,237` | 2.2·2.3절. solimp 0.99/0.999면 잔차 0.16 N, 정적 토크 0.8 %, φ 오차 0.03° | 대조 시 접촉 임피던스를 강하게 하거나 잔차를 보정, 성분별 상대 오차 보고, 응답 비교는 |Δθ| < 6° 구간으로 |
| m11 | 9번(요)이 타이어 접촉 모델에 민감: 타원체 + condim 3(비틀림 마찰 0)이 가장 낙관적 | `upkie.xml:114,204`, `합격기준.md:97` | `extra_checks.json` C: 타원체 condim 4/6(기본 비틀림 계수 0.005)에서도 바퀴 rms 0.093~0.109 Nm로 통과, 원기둥은 m×1.15·μ1.0에서 0.247/0.248 Nm로 실패(문서 주장 재현), 공칭은 0.176/0.177로 통과 | 접촉 패치를 반영하는 condim 4 타원체를 기본 모델로 쓰고 원기둥을 상한 참고로 함께 보고. 실기 제자리 회전 바퀴 전류 측정 |
| m12 | MCU 안전 로직의 실기 공백: 시작 시 `armed=True`(시험 하네스 기본), 센서 데이터 정지(stale) 감시 없음, 바퀴 들림 감지 없음(들면 적분기 와인드업), FAULT는 피치만 | `mcu.py:109,268-291`, `plan4_upkie_lqi6.py:251` | HANDOFF 2절 5단계가 이 MCU를 그대로 균형 노드로 쓰라고 함 | 실기 진입점은 `reset(armed=False)` + `arm()`(직립 확인), IMU·서보 데이터 나이 감시 → FAULT, 바퀴 접지/들림 판정 시 적분기 리셋, 롤·관절 한계 FAULT 추가 |
| m13 | 실기에서 달라질 하드코딩과 참값 경로: 마찰 보상 0.08/0.016 Nm는 시뮬 frictionloss의 80 %(M1의 원인), 바퀴 부호를 left-wheeled로 고정(upkie는 URDF에서 `left_wheeled` 판단, Cookie형은 반대), MCU 관측 dict에 `obs["sim"]`(시뮬 참값)이 그대로 들어감(현재 미사용) | `plan4_upkie_lqi6.py:67-68,211-215,262`, `serial_leg.py:37-38` | 코드 확인. MCU·LQI6Law·램프 호스트가 참값을 읽지 않음은 확인함 | 마찰 보상은 실기 식별 후 0부터 올리는 절차로, 바퀴 부호는 모델에서 유도, `_obs_to_mcu`에서 `"sim"` 키 제거 |

### Nit

| # | 내용 | 위치 |
|---|---|---|
| n1 | 독스트링 "Plan 4 uses q_att only; q_pos ... default off" — 실제로 q_pos 0.5를 씀 | `lqi6.py:48` |
| n2 | 요 적분 한계 주석이 원기둥 타이어 림 접점 설명(지금은 타원체) | `plan4_upkie_lqi6.py:62-64` |
| n3 | "KNOWN CORE BUG ... Remove the decorator" 독스트링 — 데코레이터는 없고 버그는 고쳐짐(`Tp_eq`가 정확한 이분법 사용) | `tests/test_plan4.py:289-292` |
| n4 | 문서 간 불일치: HANDOFF "200 Hz 20 ms" vs plan4_lqi6 "25 ms", 비교보고서 11.4의 옛 값(q_int 0.3, 링크 끊김 후 정지 2.7~2.9 s), plan4_lqi6 1.4절 "오버슈트 5~10 %"(현재 최악 13.3 %) | `HANDOFF.md:31`, `비교보고서.md:281,280`, `plan4_lqi8.md:67` |
| n5 | `fallen`이 MCU 추정 피치를 씀(판정 피치는 실제 피치가 원칙). 노이즈 0.2°라 영향 없음 | `plan4_upkie_lqi6.py:300` |
| n6 | 지연 스윕 결과가 "정착한 마지막 지연"(비단조면 과대). 현재 결과는 단조. 또 `verify_plan4_plant`의 기본 `--out`이 저장소 결과를 덮어씀 | `acceptance.py:431-433`, `verify_plan4_plant.py:283` |
| n7 | 15번 스윕은 `friction`을 넘기지 않아 μ = 1.0(모델 기본)에서 도는데 표에는 "μ0.75"로 표시. 경계 지연(1 kHz 15/20 ms, 200 Hz 25/30 ms)에서 μ0.75와 결과 같음 | `acceptance.py:427` |
| n8 | 12번에 1번의 "포화 없음" 검사가 없음(전 실행 포화 0이라 영향 없음) | `acceptance.py:126-128` |

---

## 4. 판정 코드 검토 (`wbr/bench/acceptance.py` ↔ `docs/합격기준.md`)

| 기준 | 구현 | 결과 |
|---|---|---|
| 판정 피치 = 시뮬 실제 피치 | `plan4_upkie_lqi6.py:282`, 지연·노이즈 없는 `raw["sim"]` 자세 | 정상 |
| 단위(°, Nm, rad/s, m) | 내부 rad → 판정 시 deg 변환 | 정상 |
| 20 ms 이동평균, 가장자리 복제 | `moving_average:153-157`, 중심 창, `mode="edge"` | 정상(독립 구현과 일치, 200 Hz는 4샘플) |
| 정지형 2 s 제외, 드리프트 2 s 시점 기준 최대 이탈, 과도 포함값 기록 | `scenario_stand:245-267`(토크 지표도 2 s 이후) | 정상 |
| 경사 정지 5 s 제외, 평형 오프셋 = 마지막 10 s 평균 | `:409-416`(피치만 제외, 이동·토크는 0 s부터 = 보수적) | 정상 |
| 80 % 한계 1.36 / 12.8 Nm, 88.8 / 23.0 rad/s | `:31-35` | 정상 |
| 바퀴 10 s 이동 rms 최댓값, 짧은 항목은 전체 rms | `moving_rms_max:160-165` | 정상(독립 구현 일치) |
| 포화 지속 비율 ≤ 5 %, 1·16·17 포화 없음 | `:191-194`, STAND_CHECKS `wheel_sat_duty ≤ 0`(중복 지표는 엄한 쪽 유지) | 정상(두 바퀴 평균: m6) |
| 포화 허용(3·6) 바퀴 피크 제외, 3번 포화 지속 ≤ 0.3 s | `wheel_peak_check=False`, `wheel_sat_s`(총 포화 시간 = 연속 지속보다 보수적) | 해석 문제 m7 |
| 필수-생존은 피크·포화 기록만 | `torque_margin=False`, 캐시에 기록 | 정상 |
| 정착 정의·정착 시간 | `settle_time_true:168-181` | 정상(최소 유지 없음: m4) |
| 매트릭스: 정착 9조합 × 5시드, 생존·기록 공칭 | `build_tasks:605-615` | 생존 시드 0만(m1) |
| 밀기 = 총 COM에 0.1 s, W = 스케일된 총질량 × g | `:284`, `mj_setConst` | 정상(22.26/26.19/30.12 N = 0.5 × 44.5/52.4/60.2 N) |
| 속도 스텝: 90 % 도달, 0.5~3 s 오버슈트, 2~3 s 정상 오차, 3 s 이후 정지 | `_velocity_profile:297-323` | 정상(정지 거리 끝점: m2) |
| 경사 주행 두 방향 중 나쁜 값 | `scenario_slope_drive:330-344` | 정상 |
| 요 마지막 1 s 평균, 피치 ≤ 2° | `scenario_yaw:347-362`(월드 z 각속도) | 정상 |
| 4 cm 웅크림 후 복귀 | `scenario_height:365-377` | 정상(실제 다리 길이 0.310 → 0.266 m, 베이스 4.5 cm 하강 확인) |
| 링크 끊김: 3 s 안에 \|v\| < 0.1, 서 있음, armed 유지 | `scenario_link_loss:380-402`, MCU는 500 ms 타임아웃으로만 감지 | 정상(끊김 시점 속도: m5) |
| 경사 +x 오르막, `geom_sameframe = 0` | `plan4_upkie_lqi6.py:202-208` | 정상(단위 테스트의 바닥 법선, 질량 ±15 %에서 평형 오프셋 ±0.4°) |
| 페이로드 0.3 kg(+10 cm, 토르소 COM 높이, 질량 스케일 제외), IMU 바이어스 +1° | `:167-196`, `common.py:30-32` | 정상 |
| 지연 10 ms | `:139` ceil → 1 kHz 10스텝·200 Hz 2스텝, `DelayLine` 의미 확인 | 정상 |
| 15번 지연 스윕 | 기준 문구대로(3° 기울기·무노이즈) | 기준대로 구현, 그러나 여유 과대평가(M1), μ 표기(n7) |
| 종합 판정 = 필수 항목만, 기록 15번 제외 | `summarize:559-562` | 정상 |
| 여유율(플래그·0 한계는 통과 0/실패 ∞) | `Check.margin` | 정상 |
| 2 s 안에 넘어진 정지 실행은 전 지표 실패 | `:250-255` | 정상(2 s 이후 높이 기준 넘어짐은 m3) |

---

## 5. 검증한 것 (정상 확인 목록 — 다시 볼 필요 없음)

1. **재현**: 축소 매트릭스 84회 비트 단위 동일, 보고 JSON = 저자 캐시 1,176회의 `summarize()` 결과(불일치 0), 현재 코드 해시 = 보고 해시.
2. **판정 계산**: 원시 시뮬 상태 기반 독립 재계산(1.3절)과 일치. 로그 토크가 10 ms 지연 관측값이어도 피크·rms·포화에 영향 없음. 정착 시간 1샘플 이내.
3. **단위 테스트**: `python -m unittest discover -s tests` → **58개 통과(9.3 s)**(test_core 20 + test_plan4 38, HANDOFF 기재와 같음).
4. **플랜트 유도**: 2.1절 전부(좌표·에너지·가상일·평형·선형화·e_att). `verify_plan4_plant` 불안정 극 오차 0.2~0.5 % / 2.8~3.0 %, B 노름 오차 ≤ 5.1 % / ≤ 1.3 %(모두 < 10 %). θ_eq(−8.00/−5.79/−3.48/−1.54°), Tp_eq −0.314 Nm, 플랜트 극 6.127/10.065.
5. **게인**: 문서 1.2절의 L0 = 0.31 게인(1 kHz·200 Hz, 8상태)이 실행 중 게인 표와 소수 둘째 자리까지 같다. 게인 표 범위 0.22~0.34 m가 MCU 다리 범위 0.24~0.335 m를 덮고 범위 밖은 끝값으로 고정(외삽 없음).
6. **참값 비사용**: MCU(`estimate`·`tick`), `LQI6Law`, 램프 호스트는 `obs["imu"]`·`obs["servo"]`만 읽는다(참값 키는 전달되지만 미사용: m13).
7. **관절 부호**: URDF 관절축 기반 `UPKIE_JOINT_SIGNS`(테스트로 확인)는 upkie v1/v2(left-wheeled) 관례와 맞다. anti-split(θ_L > θ_R → 왼쪽 Tp 감소), 요(+τ_yaw → 오른쪽 바퀴 전진 토크 증가 = 좌회전), 롤(+롤 → 왼쪽 다리 단축) 모두 음의 되먹임.
8. **호스트/MCU 경계**: 500 ms 타임아웃 → 단절 프로그램(속도·요 0, 자세 유지, 속도 모드 입력 0), `disconnect_off_s = 0`이라 모터 유지(기준 11번 "모터 OFF 없음"과 일치), 링크 복귀 시 재획득, FAULT(|피치| > 34°) 래치와 전 관절 무토크, `arm()`의 직립·측정·래치 조건, 패킷 deep copy.
9. **host_shaped 플래그(1단계 영향)**: 램프 호스트와 단절 프로그램의 `MotionCtrl.host_shaped`는 항상 False → `set_reference_shaping(True)`는 매 주기 no-op, 1단계 성형(램프 2 m/s², 전치필터 0.3 s, 적분 동결)만 쓰인다. z_att 게이팅(기준 가속도 저역통과 > 0.1 m/s²)은 1단계 결과에 포함되어 있다.
10. **문서 수치(맞는 것)**: 16·17번 실제 피치 평균(−0.01°, +0.39°), 200 Hz·1 kHz "가장 빠듯한 통과 지표"들, M(0.31) = 1.153 kg·m, F_ff = 18.18 N/다리, 밀기 힘 스케일, 원기둥 타이어에서 9번 0.25 Nm 실패.
11. **그 밖의 확인**: 7번(1.0 W)은 9조합 모두 생존, 4·7번 시드 1~4 생존, 3초 순항 뒤 링크 끊김도 통과, 끝점→최대 이탈로 바꿔도 판정 불변(m2).

---

## 6. 권고 (우선순위)

1. **실기 전 필수**: M1(마찰 보상·속도 창 재설계 후 수평 시작 + 낙하/밀기 + 노이즈 조건의 지연 여유 재측정), M2(입력 검증·적분기 보호·NaN → FAULT), M3(IMU 어댑터와 실기 관례 단위 테스트), m12(무장 해제 시작·데이터 감시·들림 감지).
2. **문서 정정**: M4(6번 10/45와 원인 분석), M5(모델 대조 표 재생성), n4(지연 허용치·옛 수치), M1에 따른 지연 허용 서술.
3. **판정 코드 보강**(현재 판정은 바뀌지 않음): m3(정지형 alive), m1(생존 시드 0~4), m2(최대 이탈), m4(최소 유지), m5(순항 후 끊김), m6(모터별 rms·바퀴별 포화), m8(캐시 해시), n7(15번 μ).
4. **모델 정확도**: m9(아마추어 상대 회전), m10(대조 절차), m11(condim 4 타이어를 기본으로, 원기둥은 상한 참고).
5. **사용자 결정 필요**: m7(3·6번 "포화 지속만" 해석), 15번 보조 기록 지표 추가 제안(M1), 6·16·17 실패의 선택지(문서 4절, M4 반영 후).

---

## 부록: 검토에 쓴 스크립트와 로그 (`results/review_scratch/`)

| 파일 | 내용 |
|---|---|
| `acceptance/`, `acceptance_r1.log` | 축소 매트릭스 재현 실행(캐시 태그 review_r1) |
| `compare_runs.py` | 실행별 1:1 비교, 보고 JSON 재구성 |
| `repro_table.py` / `.md` | 1.2절 표 |
| `independent_metrics.py`, `independent_1000.log`, `independent_200.log` | 원시 상태 기반 독립 재계산 |
| `definition_checks.py` / `.json` | 9조합 대안 정의(최대 이탈, 유지 시간, 순항 후 끊김, 관절별 rms) |
| `extra_checks.py` / `.json` | 생존 시드 1~4·9조합, 지연(노이즈), 타이어 모델, NaN 주입 |
| `latency_stand.py` / `.log`, `latency_excitation.py` / `.log`, `latency_tilt_vs_stand.py` / `.log`, `limit_cycle_cause.py` / `.log`, `latency_sweep_mu.py` / `.log` | M1 근거 |
| `imu_convention_check.py` | M3 근거 |
| `verify_plant.log`, `plan4_model/` | 모델 대조 재실행(저장소 결과를 덮어쓰지 않도록 별도 출력) |
| `model_and_doc_checks.py` / `.log`, `armature_poles.py` | base 잔차 성분, 접촉 임피던스·아마추어 영향, 문서 수치 대조 |
| `unittest.log` | 단위 테스트 58개 통과 |
