wisehyun-2/my_robot_project/wheeled_biped/docs/review_plan4_r2.md

# Plan 4 1단계 독립 검토 — 2차 (review_plan4_r2)

작성 2026-10-23. 대상: Plan 4 1단계 = upkie 하드웨어(직렬 무릎 다리, qdd100 ×4 + mj5208 ×2, 112 mm 타이어) + LQI6(직렬 다리 3체 플랜트로 설계) + DIABLO식 호스트/MCU 분리, 램프 호스트, MuJoCo. 코드 해시 `a9b9530c55`(공식 캐시 `results/acceptance/cache/r3_s1/` 1,194건의 키와 전부 일치 = 보고된 `plan4_1000Hz.json`·`plan4_200Hz.json`을 만든 코드). 검토자는 문서 외에 저자 결론을 모르는 상태에서 시작한 2라운드 독립 검증자(Opus 5.5)다. 2단계 MPC 호스트는 다른 검토자의 범위다.

검토 중 저장소 파일은 이 문서 외에 하나도 바꾸지 않았다(재현 이후 `wbr/`·`models/upkie_plan4/` 수정 파일 0, 코드 해시 불변 확인). 스크립트·로그는 `results/review_scratch/r2/`에 있다(2단계 검토자와 같은 폴더를 썼으므로 이 검토의 파일 목록은 부록에 따로 적었다).

---

## 0. 요약

**major 2 · minor 8 · nit 14**

**한 줄 결론**: 1단계 판정(두 주기 모두 1~13 통과, 16·17 실패, 15번 기록 1 kHz 20 ms 미달·200 Hz 25 ms)은 비트 단위로 재현되고(축소 매트릭스 86회·값 1,560개 차이 0, 공식 JSON = 캐시 1,194회의 재집계) 원시 시뮬 상태로 한 독립 재계산·플랜트 독립 투영 검사와도 일치한다. 1라운드 M3(IMU 관례)·M4(6번 건수)·M5(모델 표)는 해결됐고, M1(지연 여유)은 보고 수치가 정확해졌다(강건 여유 12/15 ms를 시드 5개로 재현, 게이트는 헌팅을 되살리지 않음). 그러나 **(1) M2의 센서 가드가 엉덩이·무릎 위치에는 적용되지 않아 그 NaN 1표본으로 즉시 FAULT·전복하고, (2) MCU가 호스트 MotionCtrl 값을 검증하지 않아 NaN이 지속되면 LQI6가 출력을 얼린 채 전복하고 요·높이 NaN은 한 패킷만으로 전복한다(다리 길이 램프는 영구 NaN).** 문서에는 6번 통과 원인, 16·17 선택지 (가)의 결과, 비교보고서 11.4의 옛 수치 등 결과와 다른 서술이 남아 있다.

### 0.1 1라운드 추적 표

| 1라운드 항목 | 응답 판정 | 2라운드 상태 | 근거(이 문서) |
|---|---|---|---|
| M1 지연 여유 과대 보고 | 반영(부분)·반박 부분 | **부분** — 보고 수치 정확(1 kHz 12 ms·200 Hz 15 ms, 시드 5개 재현), 게이트로 12 ms 한계 사이클 제거·정지 품질 불변·헌팅 재발 없음 확인. 반박의 결론("보상 끄기로는 13 ms 이상 안 됨")은 맞지만 원인 서술("LQI6 루프 자체")은 부정확: 주 요인은 5 ms 속도 창(+2.5 ms 지연) | 3절 minor m1, 5절 |
| M2 NaN → 적분기 오염 | 반영 | **부분(미해결 major)** — 자이로·쿼터니언·바퀴 엔코더·관절 속도·정지 표본은 문서대로 유지 → FAULT. 엉덩이·무릎 **위치** NaN은 1표본에 즉시 FAULT·전복(유지 없음) | 3절 **M1** |
| M3 IMU 관례 | 반영 | **해결** — 시뮬 표본 = upkie Bullet 공식으로 IMU 바디에서 독립 생성한 표본(차이 0), MCU 추정 = 참값(1e−16), 롤·요 루프 부호 교정 방향 | 5절 |
| M4 6번 건수 | 반영 | **해결**(건수: 0/45 = JSON). 단, 새로 적은 통과 원인이 틀림 | 3절 minor m2 |
| M5 모델 표 재현 | 반영 | **해결** — 강성 접촉 재실행 = 커밋 JSON(값 643개 동일), 연한 접촉 수치도 문서와 일치 | 2절 |
| m1 생존 시드 | 반영 | **부분** — 시드 0~4 실행 확인. "4번 μ0.5 전복을 보고서에 참고 기록"은 누락(현 제어기도 3질량 × 2주기 전복) | minor m5 |
| m2 끝점 변위 | 반영 | **부분** — 최대 이탈 판정 확인. "속도·위치 지표가 base 기준"이라는 명시 누락 | minor m6 |
| m3 정지형 alive | 반영 | 해결 | 4절 |
| m4 정착 유지 1 s | 반영 | 해결(독립 구현과 일치, 판정 불변) | 1.3·4절 |
| m5 11번 3 s 순항 | 반영 | 해결 | 4절 |
| m6 모터별 rms | 반영 | 해결 | 4절 |
| m7 "포화 허용" 해석 | 보류(사용자) | 보류 타당 — 3·6번이 두 해석 모두 통과, 판정 불변 | 4절 |
| m8 캐시 해시 | 반영 | 해결 — 판정 경로 전 소스 + 모델 XML/JSON 포함, 제외 모듈은 판정 경로에서 import 안 됨, 메시는 시각 전용 | 4절 |
| m9 아마추어 상대 회전 | 반영 | 해결(독립 투영 검사로 M·D·E 일치). 실기 식별 때의 주의는 minor m8 | 2절 |
| m10 대조 절차 | 반영 | 해결 | 2절 |
| m11 타이어 condim | 반영 | 해결(`upkie.xml` 타원체 + condim 4) | — |
| m12 실기 안전 공백 | 반영(부분) | 부분(명시대로) — 남은 공백은 HANDOFF에 기재됨. 정지 감시의 범위 한계는 minor m7 | minor m7 |
| m13 하드코딩·참값 | 반영(부분) | 부분(명시대로) — `sim` 키 제거 확인, 마찰 보상 0부터 절차 기재 | — |
| n1·n2·n5·n7·n8 | 반영 | 해결 | — |
| n3 테스트 독스트링 | 반영 | **미해결** | nit n1 |
| n4 문서 간 불일치 | 반영 | **부분** — HANDOFF·plan4_lqi6 지연 서술은 고침, 비교보고서 11.4 옛 수치는 그대로 | minor m4 |
| n6 비단조 스윕 / verify `--out` | 반영(부분) | 부분(명시대로) — 첫 실패에서 중단 확인, 기본 `--out`은 도움말에 명시 | — |

---

## 1. 재현 결과

### 1.1 실행

```
python -m wbr.bench.acceptance --rate both --matrix reduced --seeds 1 --tag review_r2 --jobs 8 --out results/review_scratch/r2/acceptance
```

- 86회(정착 13항목 × 3조합 × 2주기 = 78, 생존 4·7 × 2, 기록 15·24 × 2), 8프로세스 65 s, 코드 해시 `a9b9530c55`. 판정: 두 주기 모두 불합격(16·17 실패), 1 kHz 15번 기록 실패 — 공식 결과와 같다.
- **같은 실행끼리 1:1 비교**(`compare_runs_r2.py`): 코드 해시가 같으므로 86개 실행을 `cache/r3_s1/`의 같은 키 파일과 비교했다. 수치 잎 1,560개(중첩된 13번 오르막/내리막, 15번 스윕 포함), **최대 상대 차이 0, 판정 뒤집힘 0**.
- **공식 JSON의 정합성**: `r3_s1` 캐시 1,194회(9조합 × 5시드 × 2주기 + 생존 시드 5개 + 기록)를 현재 `summarize()`에 넣은 결과가 `plan4_1000Hz.json`·`plan4_200Hz.json`의 통과 여부·실행 수·실패 건수(16·17 각 45/45, 6번 0/45)·항목별 최악값·최악 조합과 전부 일치(불일치 0).
- 단위 테스트: `python -m unittest discover -s tests` → **74개 통과(15.6 s)** = test_core 20 + test_plan4 38 + test_plan4_safety 16(HANDOFF와 같음).

5 % 초과 차이나 판정 뒤집힘은 없다(브리프 기준의 재현 major 없음).

### 1.2 항목별 비교표

축소 3조합(시드 0)에서 가장 빠듯한 지표를 골라 공식 캐시 값과 재현 값을 적었다. 마지막 열은 공식 JSON의 전체 매트릭스 최악값이다(✗ = 기준 초과).

| # | 주기 | 지표 | 조합(시드 0) | 공식 캐시 | 재현 | 차이 | 공식 JSON 최악값(조합) |
|---|---|---|---|---|---|---|---|
| 1 | 1 kHz | pitch_rms [°] | m×1.15 μ1.00 | 0.2875 | 0.2875 | 0 | 0.2875 (m×1.15 μ1.00 s0) |
| 2 | 1 kHz | wheel_peak [Nm] | m×0.85 μ0.50 | 1.286 | 1.286 | 0 | 1.323 (m×0.85 μ0.50 s3) |
| 3 | 1 kHz | wheel_rms10 [Nm] | m×0.85 μ0.50 | 0.125 | 0.125 | 0 | 0.125 (m×0.85 μ0.50 s0) |
| 4 | 1 kHz | alive | 공칭 | O | O | 0 | O |
| 5 | 1 kHz | settle_s [s] | m×0.85 μ0.50 | 1.885 | 1.885 | 0 | 1.899 (m×0.85 μ0.75 s1) |
| 6 | 1 kHz | wheel_rms10 | m×1.15 μ1.00 | 0.1157 | 0.1157 | 0 | 0.1215 (m×0.85 μ1.00 s3) |
| 7 | 1 kHz | alive | 공칭 | O | O | 0 | O |
| 8 | 1 kHz | rise_s [s] | m×0.85 μ0.50 | 1.231 | 1.231 | 0 | 1.25 (m×0.85 μ1.00 s1) |
| 9 | 1 kHz | wheel_rms10 | m×1.15 μ1.00 | 0.1062 | 0.1062 | 0 | 0.1066 (m×1.15 μ1.00 s1) |
| 10 | 1 kHz | leg_rms [Nm] | m×1.15 μ1.00 | 1.974 | 1.974 | 0 | 1.975 (m×1.15 μ0.50 s2) |
| 11 | 1 kHz | stop_time [s] | m×0.85 μ0.50 | 2.351 | 2.351 | 0 | 2.356 (m×0.85 μ0.75 s2) |
| 12 | 1 kHz | wheel_rms10 | m×1.15 μ1.00 | 0.1548 | 0.1548 | 0 | 0.1564 (m×1.15 μ0.75 s2) |
| 13 | 1 kHz | rise_s | m×1.15 μ1.00 | 1.359 | 1.359 | 0 | 1.384 (m×1.15 μ0.50 s0) |
| 15 | 1 kHz | max_latency_ms | 공칭 | 20 | 20 | 0 | 20 ✗ (기준 ≥ 25, 기록) |
| 16 | 1 kHz | drift_max [m] | m×0.85 μ0.50 | 0.08718 ✗ | 0.08718 ✗ | 0 | 0.08769 ✗ (m×0.85 μ1.00 s3) |
| 17 | 1 kHz | drift_max | m×0.85 μ0.50 | 0.1057 ✗ | 0.1057 ✗ | 0 | 0.107 ✗ (m×0.85 μ0.75 s1) |
| 24 | 1 kHz | settle_s | 공칭 | 1.897 | 1.897 | 0 | 1.897 (기록) |
| 1 | 200 Hz | pitch_ma_max [°] | m×1.15 μ1.00 | 0.6386 | 0.6386 | 0 | 0.6857 (m×1.15 μ0.75 s4) |
| 2 | 200 Hz | wheel_peak | m×0.85 μ0.50 | 1.288 | 1.288 | 0 | 1.288 (m×0.85 μ0.50 s0) |
| 3 | 200 Hz | wheel_rms10 | m×1.15 μ1.00 | 0.1166 | 0.1166 | 0 | 0.1177 (m×1.15 μ0.50 s3) |
| 4 | 200 Hz | alive | 공칭 | O | O | 0 | O |
| 5 | 200 Hz | settle_s | m×0.85 μ0.50 | 1.93 | 1.93 | 0 | 1.94 (m×0.85 μ0.50 s3) |
| 6 | 200 Hz | wheel_rms10 | m×1.15 μ1.00 | 0.1103 | 0.1103 | 0 | 0.1122 (m×1.15 μ0.50 s2) |
| 7 | 200 Hz | alive | 공칭 | O | O | 0 | O |
| 8 | 200 Hz | rise_s | m×0.85 μ0.50 | 1.215 | 1.215 | 0 | 1.245 (m×0.85 μ0.50 s3) |
| 9 | 200 Hz | wheel_rms10 | m×1.15 μ1.00 | 0.1085 | 0.1085 | 0 | 0.1088 (m×1.15 μ1.00 s1) |
| 10 | 200 Hz | leg_rms | m×1.15 μ1.00 | 1.971 | 1.971 | 0 | 1.977 (m×1.15 μ1.00 s4) |
| 11 | 200 Hz | stop_time | m×0.85 μ0.50 | 2.34 | 2.34 | 0 | 2.39 (m×0.85 μ0.50 s1) |
| 12 | 200 Hz | wheel_rms10 | m×1.15 μ1.00 | 0.1565 | 0.1565 | 0 | 0.1585 (m×1.15 μ1.00 s2) |
| 13 | 200 Hz | rise_s | m×1.15 μ1.00 | 1.405 | 1.405 | 0 | 1.405 (m×1.15 μ0.50 s0) |
| 15 | 200 Hz | max_latency_ms | 공칭 | 25 | 25 | 0 | 25 (통과) |
| 16 | 200 Hz | drift_max | 공칭 | 0.08878 ✗ | 0.08878 ✗ | 0 | 0.09062 ✗ (m×0.85 μ0.75 s4) |
| 17 | 200 Hz | drift_max | m×0.85 μ0.50 | 0.102 ✗ | 0.102 ✗ | 0 | 0.1095 ✗ (m×0.85 μ0.50 s1) |
| 24 | 200 Hz | settle_s | 공칭 | 1.99 | 1.99 | 0 | 1.99 (기록) |

### 1.3 원시 시뮬 상태로 한 독립 재계산

`independent_metrics_r2.py`: 판정 시나리오를 그대로 돌리되(같은 계획 팩토리·호출 순서 = 같은 궤적) `plan.step` 래퍼가 매 제어 스텝 뒤 `MjData`에서 직접 base x(그리고 바퀴축 x), base 위치의 유한차분 속도, `xmat`에서 자체 공식(atan2)으로 구한 피치, 지연 없는 `actuator_force`를 기록했다. 이동평균(누적합, 가장자리 복제), 10 s 이동 rms, 최대 이탈, **1 s 유지 조건을 넣은 정착 시간**을 판정 코드를 쓰지 않고 다시 구현했다.

| 항목·조합(시드 0) | 지표 | 1 kHz 독립 / 공식 | 200 Hz 독립 / 공식 |
|---|---|---|---|
| 1 정지 공칭 | pitch_ma_max · pitch_rms [°] | 0.2848·0.1403 / 같음 | 0.4061·0.1500 / 같음 |
| 1 정지 공칭 | drift_max(2 s 기준) · x(0) 기준 [m] | 0.02244·0.01652 / 같음 | 0.01705·0.01761 / 같음 |
| 1 정지 공칭 | wheel_rms10 [Nm] | 0.03759 / 같음 | 0.04374 / 같음 |
| 2 기울기 10° m×0.85 μ0.5 | settle_s(1 s 유지) · disp · wheel_peak | 1.323 s · 0.1329 m · 1.286 Nm / 같음 | 1.370 · 0.1334 · 1.288 / 같음 |
| 5 밀기 0.5 W m×0.85 μ0.5 | settle_s · disp · pitch_peak | 1.885 s · 0.1476 m · 2.155° / 같음 | 1.930 · 0.1484 · 2.549 / 같음 |
| 8 속도 스텝 m×0.85 μ0.5 | rise · ss_err · stop_disp · settled | 1.231 s · 0.0384 · 0.2348 m · 1 / 같음 | 1.215 · 0.0388 · 0.2350 · 1 / 같음 |
| 8 속도 스텝 | overshoot [%] | 10.16 / 10.16 | 11.33 / 11.39 |

22회(정지 4, 2·5·8번 × 3조합 × 2주기) 모두 차이 0이다. 오버슈트만 0.02~1.5 % 다른 것은 내가 base 위치의 유한차분 속도를, 판정 코드는 `mj_objectVelocity` 순간 속도를 쓰기 때문이다. 로그 토크가 10 ms 지연 관측값이어도 피크·rms는 같다. 참고로 **바퀴축 위치 기준**으로 재면 2번 이동 0.096~0.107 m(base 0.133), 5번 이동 0.188~0.194 m(base 0.139~0.148), 8번 정지 0.245~0.259 m(base 0.212~0.235)다(minor m6).

---

## 2. 모델 검토

### 2.1 유도 재확인 (`plant_serial.py:62-101, 239-259`)

- 바퀴 모터는 종아리(L0 고정이면 가상 다리와 함께 θ로 회전)와 바퀴(절대각 x/R) 사이에 있으므로 관절 좌표는 ω = ẋ/R − θ̇다. 가상일 δW = T(δx/R − δθ) ⇒ Q_x = T/R, Q_θ = −T. 감쇠 토크 −c_w ω도 같은 자리에 걸려 Q_x = −c_w ω/R, Q_θ = +c_w ω. MuJoCo `dof_armature`는 관절 좌표의 질량 행렬 대각에 더해지므로 운동 에너지 항은 ½J_w ω² = ½J_w(ẋ/R − θ̇)²(코드 80행, 84~85행과 같음).
- 엉덩이 모터는 몸체–허벅지 사이 q̇_hip = θ̇ + φ̇: ½J_h(θ̇ + φ̇)², Q_θ·Q_φ에 +Tp와 −c_h(θ̇ + φ̇).
- 감쇠 행렬: Q_damp = −D q̇에서 D = [[c_w/R², −c_w/R, 0], [−c_w/R, c_w + c_h, c_h], [0, c_h, c_h]](247행과 같음). E = [[1/R, 0], [−1, 1], [0, 1]](248행).
- 나머지(바퀴 절대 회전 ½I_w(ẋ/R)², 다리 ½m_l|ṗ_l|² + ½I_lθ̇², 몸체 ½m_b|ṗ_b|² + ½I_bφ̇², V = g(m_l z_l + m_b z_b))는 1라운드에서 확인한 그대로다.

### 2.2 MuJoCo 투영 독립 검사 (`plant_projection_check.py`)

평면 좌표 (x, θ, φ) → MuJoCo `qpos` 사상을 직접 만들고(IK, 무릎 고정, 바퀴 관절 = x/R − 종아리 절대각, 축이 (x, R)에 오게 base 배치) 그 접공간 사상 P를 `mj_differentiatePos` 중앙차분으로 구해 verify 스크립트의 손으로 쓴 P와 독립적으로 비교했다(L0 = 0.25·0.28·0.31·0.33).

| 항목 | MuJoCo 투영 vs 플랜트 |
|---|---|
| 질량 행렬 Pᵀ M P vs M(q) | 상대 오차 최대 5.95e−4 — M_xx 5.6387 vs 5.6420뿐, 나머지 성분은 6자리 일치 |
| 감쇠 Pᵀ diag(dof_damping) P vs D | 2.5e−11 |
| 입력 Pᵀ qfrc_actuator vs E | 2.5e−11 |
| 중력 기울기 Pᵀ qfrc_bias vs ∂V/∂q | 6e−9 N(m) (−0.31392 = Tp_eq) |
| 중력 헤시안(기울기의 중앙차분) vs H_V | θθ −11.3115 vs −11.3115, φφ −1.2400 vs −1.2400; xx 0.294 vs 0 |

M_xx와 H_xx의 차이는 바퀴 그룹 무게중심이 축에서 약 0.25 mm 벗어나 있는 URDF 편심(바퀴 회전각에 따라 부호가 바뀌는 항, Σm r_z ≈ −9.4e−5 kg·m)이 만드는 것이고 구름 플랜트로는 표현할 수 없다(영향 무시 가능). 즉 **J_w·c_w를 관절 속도에 둔 m9 수정은 MuJoCo의 질량·감쇠·입력과 기계 정밀도로 일치한다.** 같은 계산에서 1라운드 전 배치(J_w를 ẋ/R에)는 M과 0.19 % 다르다.

### 2.3 `verify_plan4_plant` 재실행 (네 L0)

`--out results/review_scratch/r2/plan4_model`(기본 강성 접촉)과 `--soft-contact --out …/plan4_model_soft`.

- **강성 접촉**: `linearization.json` 값 643개가 커밋된 파일과 전부 같고 `linearization.md` 표도 같다 → `plan4_model.md` 5절 표(극 6.116~6.129 / 9.697~9.938 vs MuJoCo 6.112~6.127 / 9.695~9.936, 오차 ≤ 0.06 %·≤ 0.02 %, B 노름 ≤ 0.24 %·0.03 %, 성분 ≤ 0.34 %·0.24 %, 3° 응답 0.03°/0.12°/0.1 mm(0.31), 0.3 s 후 θ 19.2/14.5 … 23.5/23.4°, 정적 엉덩이 토크 −0.314 / −0.315~−0.319, 잔차 0.16 N)와 0요약·3절 개루프 극(+6.13, +9.77, −7.53, −10.76, 0, −0.11)이 재현된다. 무릎 정적 토크 1.362 Nm/무릎(0.31).
- **연한 접촉**: 극 오차 0.22~0.50 % / 0.05~0.06 %, B 성분 ≤ 1.27 %, 정적 엉덩이 토크 −0.272~−0.303 Nm, base 잔차 1.18 N — 문서의 연한 접촉 서술(−0.272~−0.303, 1.18 N)과 일치. 빠른 극 오차가 연한 접촉에서도 0.05 %라는 점은 m9 수정이 접촉 모델과 무관하게 맞다는 뜻이다.
- MuJoCo 평면 고유값에 −0.057 ± 0.21j·±0.037이 보이는 것은 무릎 잠금 아마추어 1000 kg·m²가 만드는 느린 무릎 모드로, 불안정 극 비교에는 영향이 없다.

### 2.4 의견

- 플랜트는 MuJoCo 모델의 충실한 축약이다(유도·투영·고유값 모두 일치). 실기 이식 때 주의할 점 하나: 바퀴 아마추어는 MuJoCo 의미론(관절 좌표)에 맞춘 것이고 직결 구동 mj5208의 실제 로터는 바퀴와 함께 절대 회전한다(minor m8).

---

## 3. 코드 findings (등급순)

### Major

#### M1. 엉덩이·무릎 위치 NaN 1표본에 즉시 FAULT → 무토크 → 전복 (1라운드 M2 부분 해결, 실기 안전)

- **위치**: `wbr/controllers/diablo_arch/mcu.py:432-433`(VMC가 검증·유지된 값이 아니라 원시 `obs["servo"][…]["position"]`을 씀), `:236-243`(가드는 추정값만 유지), `:437-441`(비유한 토크 → FAULT), 문서 `docs/plan4_lqi8.md:81,88`, `docs/HANDOFF.md:41`, 테스트 `tests/test_plan4_safety.py:26-45`(NaN을 자이로와 `left_wheel` 위치에만 주입).
- **근거**(`guard_checks.py`, `guard_1000.log`, `guard_200.log`; 노이즈 ON, 10 ms 지연, 1.5 s 정지 뒤 MCU가 읽을 관측에 주입, 시뮬은 계속 진행):

| 주입 | 1 kHz | 200 Hz |
|---|---|---|
| 자이로 NaN 1·3·5표본 | 유지, FAULT 없음, 피치 ≤ 0.22° | 유지, ≤ 0.15° |
| 자이로 / 쿼터니언 / 바퀴 엔코더 위치 / 바퀴 속도 NaN 8표본 | 6번째 표본에 FAULT "non-finite sensor data for 6 cycles" | 같음 |
| 쿼터니언 노름 2, 엉덩이 속도 NaN 1표본 | 유지 | 유지 |
| 정지 표본(같은 시각) 20·40 ms | 유지(정지 피치 ≤ 0.21°, 0.5 m/s 주행 중 2.2°/4.3°) | 유지(0.76°/0.87°) |
| 정지 표본 60 ms | 52번째 틱 FAULT "sensor data stale for 51 ms" | 12번째 틱 "55 ms" |
| **엉덩이 위치 NaN 1표본**(정지 / 0.5 m/s 주행) | **1번째 틱에 FAULT "non-finite torque command on left_hip" → 전복**(피치 30.6° / 20.4°) | **같음**(30.7° / 20.9°) |
| **무릎 위치 NaN 1표본** | **즉시 FAULT("…on right_hip") → 전복**(30.4°) | **같음**(30.5°) |

- **원인**: `estimate()`는 무효 표본에서 추정값을 유지하지만 `tick()`의 VMC가 같은 관측의 원시 엉덩이·무릎 위치로 `vmc_torques`를 부르므로 토크가 NaN이 되고, 비유한 토크 가드가 그 틱에 FAULT를 건다. 문서(`plan4_lqi8.md` 1.6 표, HANDOFF 2.1)는 "관절 위치·속도 비유한 → 추정값 유지, 5주기 넘으면 FAULT"라고 적었으나 6개 관절 위치 중 다리 4개에는 성립하지 않는다. 이벤트는 남으므로 1라운드처럼 "조용한" 전복은 아니지만, 원인 문구도 엉뚱한 관절(무릎 NaN → "on right_hip")을 가리킨다.
- **영향**: 실기에서 엉덩이·무릎 서보 응답 하나가 손상되면(디코드 오류, 미수신 표본의 NaN 기본값 등) 균형 중인 로봇이 그 자리에서 모든 관절 무토크로 쓰러진다. 가드의 설계 의도(드롭 패킷을 5주기 넘기기)가 다리 관절에는 없다.
- **수정안**: `estimate()`가 마지막 유효 서보 표본(`self._last_valid_servo`)을 보관하고 `tick()`의 VMC·다리 길이 PD가 그것을 쓰게 한다(유지 중에는 유지된 위치). 테스트에 두 주기 × (엉덩이·무릎 위치) × (1표본 유지·6표본 FAULT)를 추가한다. FAULT 문구에 원인 관절을 적는다.

#### M2. MCU가 호스트 MotionCtrl 값을 검증하지 않는다 — NaN 지속 시 LQI6 출력 동결 후 전복, 요·높이 NaN은 한 패킷에 전복 (실기 안전, 호스트/MCU 경계)

- **위치**: `wbr/controllers/diablo_arch/host_link.py:85-90`(`receive`가 값 검사 없이 저장), `mcu.py:298-311`(`clamp`/`clamp_abs`는 NaN을 그대로 통과: `wbr/common/filters.py:7-12`), `mcu.py:380`(요 적분기), `mcu.py:300-303`·`filters.Ramp`(다리 길이 목표·램프), `wbr/controllers/lqi6/lqi6.py:218-219`(비유한 입력이면 직전 출력을 **무기한** 반환), 문서 `plan4_lqi8.md:83`("LQI6 입력 비유한 → 직전 출력 유지").
- **근거**(`host_nan_check.py`/`.log`; 노이즈 ON, 10 ms 지연, 1 s 정지 뒤 호스트 명령의 한 필드를 NaN으로, 50 Hz 게시):

| MotionCtrl 필드 | 1 kHz | 200 Hz |
|---|---|---|
| forward 또는 pitch NaN 한 패킷(20 ms) | 생존(직전 출력 20 ms 유지) | 생존 |
| **forward 또는 pitch NaN 지속** | **LQI6가 출력을 얼린 채 개루프 → 1.42 s 뒤 전복**, 이벤트는 "FAULT: pitch"뿐(원인 없음), 링크는 정상으로 보임 | **0.61 s 뒤 전복**, 같음 |
| **left(요 속도) NaN 한 패킷** | 요 적분기 NaN → 즉시 FAULT "non-finite torque command on left_wheel" → **0.25 s 전복** | 0.26 s |
| **up(높이) NaN 한 패킷** | 다리 길이 목표·램프 NaN → 즉시 FAULT → **0.25 s 전복**. `Ramp`는 한 번 NaN이 되면 유효 목표를 받아도 NaN으로 남는다(직접 확인) → `mcu.reset()` 전까지 재무장해도 다시 FAULT | 같음 |

- **영향**: 호스트는 별도 컴퓨터(ROS 2 / Jetson, 2단계 MPC)이고 그쪽의 소프트웨어 결함(조이스틱 매핑의 0 나눗셈, QP의 NaN 해 등)이 MotionCtrl에 그대로 실린다. 현재 구조에서는 호스트 패킷 하나로 균형 중인 로봇이 쓰러지거나, 호스트가 NaN을 계속 보내면 링크 타임아웃도 걸리지 않은 채 균형 제어가 멈춘다. 1라운드 M2(비유한 입력 → 조용한 실패)와 같은 종류가 명령 경로에 남아 있고, M2 대응으로 넣은 LQI6의 "직전 출력 유지"가 이 경로에서는 오히려 피드백을 끊는다(센서 경로에서는 MCU 가드가 NaN을 먼저 막으므로 이 분기에 닿는 것은 사실상 명령 경로뿐이다).
- **수정안**: (1) `HostLink.receive` 또는 `apply_command` 입구에서 forward·left·up·roll·pitch·leg_split의 유한성을 검사하고, 비유한 패킷은 버리고 마지막 유효 명령을 유지하며 이벤트를 남긴다. N개(예: 25 = 0.5 s) 연속이면 링크 끊김과 같이 단절 프로그램으로 간다. (2) LQI6의 비유한 입력 분기는 몇 주기만 유지하고 그 뒤에는 FAULT를 요청한다(무기한 유지 금지). (3) `Ramp`·`yaw_int`·`roll_int`·`L_target`에 NaN이 들어가지 않게 한다. (4) 두 주기 × 각 필드 NaN(한 패킷·지속) 테스트를 추가한다.

### Minor

| # | 내용 | 위치 | 근거 | 수정안 |
|---|---|---|---|---|
| m1 | 1라운드 M1 반박의 원인 서술이 부정확: "한계는 10 ms로 설계된 LQI6 루프 자체의 비선형 여유"가 아니라 주로 **5 ms 위치 차분 속도 창(+2.5 ms 지연)** 이다. 다만 그 창을 줄이면 2·3번이 깨지므로 "5 ms 유지" 결론은 맞다 — 문서의 "넓히는 방법"(r_hip 0.15, 10 ms 예측기) 목록에 이 교환이 빠져 있다 | `plan4_lqi8.md:107,186`, `review_plan4_r1_response.md:9`, `plan4_upkie_lqi6.py:70` | `velwindow_check.log`: 1 kHz 강건 시험(노이즈·2 mm·0.5 W, 시드 0~2) 창 2 ms·0 ms에서 13·15 ms 모두 정착(꼬리 0.09~0.13°), 20 ms 전복 → 강건 여유 ≥ 15 ms(현재 12 ms). 정지 바퀴 rms 0.037(5 ms) → 0.044(2 ms) → 0.125 Nm(1스텝). `velwindow_items.log`: 창 2 ms면 2번 m×0.85·μ0.5 바퀴 피크 1.39~1.47 Nm(5/5 실패), 3번 m×0.85·μ0.5 미정착(3/3, 포화 31~38 %); 1·5·6·8번은 통과 | 원인 서술을 "속도 창 지연 ↔ 바퀴 피크·저마찰 복귀의 교환"으로 고치고 선택지에 추가. 실기가 200 Hz(강건 15 ms)로 돈다면 1 kHz 여유는 참고값임을 명시 |
| m2 | 6번(1 kHz) 통과의 원인을 "플랜트 재유도의 게인 +2 %와 condim 4의 복합 효과"로 적었으나, 실제로는 **마찰 보상 피치 속도 게이트**가 결정적이다 | `plan4_lqi8.md:20`, `비교보고서.md:309` | `item6_and_15.log`: 현재 모델·게인, 1 kHz m×0.85 μ0.75/1.0 시드 0~1에서 기본 0.116~0.120 Nm(통과), **게이트만 끄면 0.208~0.214 Nm(4/4 실패, 1라운드 실패값 0.22와 같은 수준)**, 보상을 끄면 0.113~0.115(통과) | 원인을 정정하고, 게이트가 6번의 통과 조건이라는 점(보상을 켜면 게이트 필수)을 실기 체크리스트에 적기 |
| m3 | 16·17 드리프트의 기준점: 기준 3절은 max \|x(t) − x(0)\|, 6절은 "2 s 시점 위치 기준". 16·17에서는 2 s 기준이 오히려 실행마다 1~2 cm 크다(초기 과도 중간에서 재기 때문). 이 때문에 4.1절 선택지 **(가) "10 cm로 두기 — 17번 최악 조합은 이것도 빠듯"은 틀리다**: 배터리 정의로 17번은 10 cm로도 m×0.85 전 조합에서 15/45회 실패 | `합격기준.md:33,82`, `acceptance.py:279`, `plan4_lqi8.md:182` | `count_10cm.py`, `doc_numbers.log`: 17번 drift_max(2 s 기준) > 10 cm — 1 kHz 15/45(10.4~10.7 cm), 200 Hz 15/45(10.2~11.0 cm), 모두 m×0.85; x(0) 기준으로는 0/45(최대 9.0 / 9.2 cm). 16번은 두 정의 모두 ≤ 9.1 cm. 현재 기준 5 cm에서는 두 정의 모두 실패라 판정 불변. 1번은 두 정의 모두 통과(최대 1.9 cm) | 선택지 (가)의 결과를 두 정의별로 사실대로 적고, 16·17 드리프트 기준점을 사용자 결정 항목으로 올리기 |
| m4 | 비교보고서 11.4가 옛 수치를 현재형으로 적음(1라운드 n4 미해결): q_int 0.3(현재 0.2), 오버슈트 5~8 %·90 % 상승 1.4 s·정지 거리 0.11 m·링크 끊김 후 정지 2.7~2.9 s, 10° 바퀴 피크 1.28 Nm, "지연 허용치(15 ms)는 유지" | `비교보고서.md:280,281,284` | 공식 캐시: 8번 오버슈트 7.4~12.6 %, 상승 1.14~1.25 s, 정지 최대 이탈 0.21~0.235 m(끝점 0.08 m), 11번 정지 2.10~2.39 s, 2번 피크 최대 1.323 Nm; 지연은 기준 시험 20/25 ms·강건 12/15 ms | 현재 결과로 고치거나 "튠 당시 값"으로 표시 |
| m5 | 1라운드 m1 응답의 "4번 μ0.5 전복은 보고서 참고로 기록"이 반영되지 않음. 현 제어기도 같다 | `plan4_lqi8.md`(해당 서술 없음) | `item4_mu05.log`: 20° 기울기, μ0.5에서 m×0.85/1.0/1.15 모두 전복(1 kHz 피치 34.4/44.4/41.0°, 200 Hz 43.9/42.0/37.8°, 바퀴 포화 0.10~0.13 s), μ1.0은 모두 생존. 기준상 판정 대상은 공칭 조합뿐이라 판정 불변 | 실기 저마찰 바닥 위험으로 보고서·HANDOFF에 기록 |
| m6 | 1라운드 m2 응답의 "속도 지표가 base 속도임을 명시"가 반영되지 않음. 이동·정지 거리도 base 위치 기준이며, 바퀴축 기준으로는 밀기·정지가 더 길다 | `plan4_upkie_lqi6.py:308`, `acceptance.py:287-357`, `합격기준.md` 6.2 | 1.3절: 5번 이동 base 0.139~0.148 vs 축 0.188~0.194 m, 8번 정지 0.212~0.235 vs 0.245~0.259 m(1단계 기준 0.5 m 안, 판정 불변). 2단계 19번(정지 0.3 m, 여유 0~3 %)은 정의에 민감 | 측정점(base)을 기준 문서에 명시하고 바퀴축 값을 기록 열로 추가; 19번 해석은 사용자 확인 |
| m7 | 정지(stale) 감시는 전역 시간 스탬프만 본다: 관측에 `time`이 없으면 조용히 꺼지고, 시각은 진행하는데 특정 서보 값만 멈춘 경우(응답 누락 시 마지막 값을 다시 주는 드라이버)는 검출하지 못한다 | `mcu.py:228-235,244-250` | 코드 확인. HANDOFF는 `time`을 넣으라고만 적음 | 실기 진입점에서 `time` 필수(없으면 FAULT), 서보별 표본 나이(또는 moteus 응답 카운터) 감시 추가 |
| m8 | 바퀴 로터 아마추어 J_w(2×0.0003 kg·m²)를 관절 속도에 둔 것은 MuJoCo `armature` 의미론과의 일치이지 물리가 아니다. mj5208은 직결 구동이라 실제 로터는 바퀴와 함께 절대 회전 ẋ/R로 돌고, 모델에는 로터 바디(0.05 kg)가 이미 있어 아마추어는 중복일 가능성이 크다(J_w = 강체 바퀴 I_w 0.00035의 1.7배) | `build_upkie.py:86`, `plant_serial.py:80`, `plan4_model.md:46` | 2.2절, 모델 관성 확인. 배치 차이는 빠른 극 약 3 %·게인 2~3 %(1라운드 m9) | 실기 식별 때 바퀴 관성을 통째로 재서 I_w(절대 회전)에 넣고 J_w = 0으로; 시뮬 모델의 바퀴 아마추어 근거를 문서화 |

### Nit

| # | 내용 | 위치 |
|---|---|---|
| n1 | 1라운드 n3 미해결: "KNOWN CORE BUG … Remove the decorator" 독스트링이 남아 있음(버그는 고쳐졌고 데코레이터도 없음) | `tests/test_plan4.py:289-292` |
| n2 | 쿼터니언 노름을 0.9~1.1까지 받아들인 뒤 정규화 없이 회전 행렬로 씀(노름 1.05면 자세 5 % 왜곡) | `mcu.py:202,259`, `upkie_observers.py:40` |
| n3 | 11번 `motors_on`이 `fault`를 보지 않음(FAULT 상태도 armed면 1). 지금은 FAULT면 넘어져 alive가 잡음 | `acceptance.py:432` |
| n4 | "오버슈트 6~10 %, 90 % 도달 1.2~1.25 s" — 실제 7.4~12.6 %, 1.14~1.25 s | `plan4_lqi8.md:71` |
| n5 | 참고 열 비교의 Plan 4 요 오차 "1~3 %" — 실제 0.003~0.49 % | `plan4_lqi8.md:175` |
| n6 | 4.1절 제목 "8.5~11.0 cm" — 실제 최소 8.1 cm(17번 200 Hz) | `plan4_lqi8.md:180` |
| n7 | 1.2절 게인 반올림: 1 kHz K_T의 z1 −2.26(실제 −2.2548), 200 Hz K_T의 φ̇ 0.23(실제 0.2248) | `plan4_lqi8.md:57-58` |
| n8 | "마찰 보상을 둘 다 꺼도 … 13 ms 전복", 응답의 "게이트 없음 … 13 ms 전복" — 시드 5개 측정은 13 ms에서 20 s 동안 전복 없는 13.2 Hz 한계 사이클(꼬리 3.2°), 전복은 14 ms부터. 결론은 같음 | `plan4_lqi8.md:107`, `review_plan4_r1_response.md:9` |
| n9 | "지연 허용치 15~20 ms … 15번의 25 ms에 못 미친다" — 같은 절 표는 20/20 ms이고 200 Hz는 15번 25 ms를 충족 | `비교보고서.md:296` |
| n10 | "# 73 tests" — 현재 74개 | `비교보고서.md:332` |
| n11 | 오타 "오른쳍은"; 무릎 정적 토크 4절 1.38 vs 5절 1.36 Nm(강성 접촉 재실행 1.362); "기본값 `--soft-contact`로 …" 문구(기본은 강성); "0.3 s 뒤 θ가 15° 이상"(MuJoCo 14.5°) | `plan4_model.md:31,91,99,101,113` |
| n12 | "9번 유지 토크(시뮬 0.07~0.11 Nm rms)" — condim 4 현재 0.083~0.109 | `HANDOFF.md:51` |
| n13 | 11.5 벤치 행의 원본 `results/bench/summary.md`(04:04)는 마지막 코드 변경(mcu.py 04:11, plan4·common.py 04:14) 이전 결과이고 `run_bench`에는 `--out`이 없어 저장소를 덮지 않고는 재현할 수 없음 → 이번 검토에서 검증하지 못함 | `비교보고서.md` 11.5, `wbr/bench/run_bench.py:109` |
| n14 | 캐시 키에 mujoco·numpy 버전이 없음(라이브러리 갱신 뒤 오래된 캐시를 그대로 쓸 수 있음) | `acceptance.py:585-604` |

---

## 4. 판정 코드 검토 (`acceptance.py` ↔ `합격기준.md`, 6.2의 측정 정의 변경)

| 6.2 변경 | 구현 확인 | 기준 문구 대비 | 판정 영향 |
|---|---|---|---|
| 이동·정지 거리 = 사건 뒤 최대 이탈(`disp`, `stop_disp`), 끝점·되돌아감 기록 | `scenario_tilt:287`, `scenario_push:299`, `_velocity_profile:316`(13번은 두 방향 최악) — 독립 재계산과 일치 | 문구("이동 ≤", "… 안에 정지")의 자연스러운 해석, 끝점보다 엄격 | 없음(2번 0.133~0.135/0.3, 5번 0.138~0.151/0.5, 8번 0.21~0.235/0.5, 13번 0.21~0.233/0.5 m). 측정점은 base(m6) |
| 정착 1 s 유지(`SETTLE_HOLD_S`) | `settle_time_true:184-197` — 독립 구현(자체 이동평균·자체 탐색)과 22회 일치 | 문구("어떤 시점 이후 끝까지 유지")보다 엄격 | 없음. 15번 기준 시험의 1 kHz 25 ms·200 Hz 30 ms 실패는 0.81/0.93 s 전복이라 유지 조건과 무관(`item6_and_15.log`) |
| 정지형 항목 alive, 12번 포화 없음 | `STAND_CHECKS`, 12번 검사 목록 | 기준 1번 조건 + 생존 정의 | 없음 |
| 모터별 rms·바퀴별 포화 비율 | `torque_metrics:200-214` | 모터 한계는 모터별 — 엄격 | 없음 |
| 필수-생존 시드 0~4 | `build_tasks:724-737`, JSON 4·7번 실행 수 5 | 2절 "시드 5개, 필수는 전부 통과" + "생존은 공칭에서만"과 일치 | 없음(5/5 생존) |
| 11번 3 s 순항 뒤 끊김 | `scenario_link_loss:413-436`(정지 시간은 호스트 정지 시각부터, 500 ms 타임아웃 포함) | "0.5 m/s 주행 중"에 부합, 보수적 | 없음(2.10~2.39 s / 3 s). `motors_on`은 n3 |
| 15번 강건 여유 기록 | `scenario_latency_sweep:454-491`(노이즈·2 mm 낙하·1 s에 0.5 W·20 s·꼬리 5 s rms < 0.5°, 첫 실패에서 중단, μ 0.75) | 기록 항목, 종합 판정 제외(`summarize`) | 없음. 시드 0만 쓰지만 시드 5개 재측정과 같은 값(12/15 ms, 5절) |
| 24번 기록 | `scenario_drive_push:494`, 등급 record | 기준에 없는 기록 항목 | 없음(종합 판정 제외 확인) |
| 캐시 해시 | `code_hash:585-600`: `wbr/` 전 `.py`(viewer·video·plots·run_bench·battery·compare_hosts·regression 제외) + `models/upkie_plan4/*.xml·*.json` | 제외 모듈은 판정 경로에서 import되지 않음(grep), 모델 메시는 모두 `contype 0`·`density 0`(충돌·질량 기여 없음) → 결과를 바꾸는 파일은 모두 포함 | 라이브러리 버전 미포함(n14) |
| (6절, 6.2 이전) 정지형 2 s 제외 | `scenario_stand:262-284` | 3절 드리프트 정의 x(0)과 불일치 | 1번 불변(두 정의 모두 통과), 16·17 현재 기준 불변, **선택지 (가)의 결과를 바꿈**(m3) |
| (보류) 3·6번 "포화 허용" | 바퀴 피크만 제외, 10 s rms 유지 | 해석 갈림(사용자 결정) | 현재는 두 해석 모두 통과 |
| IMU 관례 에뮬레이션 | `_observe:275-286`, MCU 어댑터 | "판정에 영향 없어야" | 반올림 수준(2번 동일, 5번 정착 1.828 vs 1.831 s, `imu_effect.log`) |

---

## 5. 검증한 것 (정상 확인 — 다시 볼 필요 없음)

1. **재현**: 축소 매트릭스 86회 비트 단위 동일, 공식 JSON = `r3_s1` 캐시 1,194회의 재집계(불일치 0), 현재 코드 해시 = 공식 캐시 해시, 검토 중 저장소 코드 변경 없음.
2. **독립 재계산**: 정지·2·5·8번(두 주기, 22회) 지표가 판정·캐시와 일치(1.3절).
3. **플랜트**: 2절(해석적 재유도, 독립 투영 M·D·E·∇V·H_V, `verify_plan4_plant` 강성·연한 접촉 재실행 = 문서 표). θ_eq·Tp_eq −0.3139 Nm·M(0.31) = 1.1531 kg·m·F_ff 18.18 N/다리.
4. **M1 재측정**(`latency_robust.log`, 시드 0~4, 노이즈·2 mm 낙하·0.5 W·20 s): 기본(게이트 0.1 rad/s) 1 kHz 10~12 ms 5/5 깨끗(꼬리 0.12~0.15°), 13 ms 0/5(5/5 생존, 13.2 Hz 한계 사이클 3.2°), 14 ms 2/5(4/5 생존, 비단조), 15 ms 0/5(전복); 200 Hz 10·15 ms 5/5, 20 ms 1/5(4/5 전복) → 문서의 강건 여유 12/15 ms 재현. 게이트 끔: 1 kHz 12 ms 한계 사이클(14.0 Hz 2.14°), 14 ms 전복 → 게이트의 효과는 +1 ms. 보상 둘 다 끔: 12 ms 깨끗, 13 ms 한계 사이클(게이트 켬과 같음), 200 Hz 20 ms 3/5 → "보상이 13 ms 한계의 원인이 아니다"는 맞음(원인 서술은 m1).
5. **게이트와 헌팅**(`gate_hunting.log`, 60 s 정지, 10 ms, 공칭): 1 kHz 노이즈 ON 게이트 켬/끔 피치 MA 0.279~0.303° / 0.279~0.296°, rms 0.135~0.140 / 0.138~0.142°, 드리프트 2.2~2.5 / 2.2~2.4 cm, 30~60 s x 왕복 2.9~3.0 / 2.8~2.9 cm, 바퀴 rms 0.037~0.038(같음); 보상 끔 0.535~0.598°, 3.5 cm, 4.0 cm. 노이즈 OFF도 같은 양상(게이트 켬 0.329°/2.4 cm, 끔 0.312°/2.4 cm, 보상 끔 0.633°/3.7 cm). 200 Hz도 같다 → 문서 주장(정지 품질 불변, 피치 MA 0.28°·드리프트 2 cm) 맞고 헌팅 재발 없음.
6. **M2의 나머지 가드**: 3절 M1 표의 자이로·쿼터니언·바퀴 엔코더·관절 속도·정지 표본 경우는 문서대로(유지 → 6번째 표본 또는 50 ms 초과 시 FAULT + 이벤트, 두 주기). 1 kHz에서 0.5 m/s 주행 중 40 ms 정지 표본은 피치 4.3°까지 흔들리지만 생존(유지 뒤 5 ms 창이 유지 구간의 위치 점프를 한 번에 미분하는 효과; 200 Hz 0.87°).
7. **M3 IMU**(`imu_sign_check.log`): 롤 ±4·6°, 피치 +5°, 요 0.4 + 피치 0.1 + 롤 0.05, 각속도 (0.2, 0.3, 1.0)·(−0.5, 0, −0.7)의 여섯 경우에서 시뮬 에뮬레이션 표본 = upkie `read_imu_data.h` 공식을 MuJoCo `imu` 바디(y축 180° 장착)에 적용한 독립 표본(차이 0), MCU 추정(롤·피치·롤 속도·피치 속도·요 속도) = 참값(최대 1.1e−16). 어댑터 = upkie `BaseOrientation.h:29-36,144-147`. 롤 +3° → dL −0.026 m(왼 다리 단축 = 교정), 요 명령 +1 rad/s → 오른 바퀴 +0.2/왼 −0.2 Nm(좌회전). pi3hat 각속도는 IMU 좌표(`pi3hat/imu.h:49-52`)라 어댑터 가정과 맞다.
8. **M4·문서 수치(맞는 것)**: 6번 0/45(두 주기), 16·17 45/45, 0절 표의 가장 빠듯한 지표 12개, 24번(1.90 s·0.003 m/s / 1.99 s·0.004 m/s), 15번 20/25 ms·강건 12/15 ms, 3.3절 참고 열(PI 피치 MA 2.06°·rms 1.07°·드리프트 0.334 m, 밀기 16°, 오버슈트 41.7 %·0.18 m/s·11.7°, 요 7.3 %·0.215 Nm, 웅크림 6.2°, 6·7번 전복), 17번 실제 피치 +0.34~+0.40°, 16번 질량 ±15 %에서 ∓0.25°, 9번 바퀴 rms 0.11 Nm, 비교보고서 11.6 표, 11.5 행 = `results/bench/summary.md`(n13).
9. **IMU 어댑터 판정 영향**: 반올림 수준(4절).
10. **판정 코드**: 4절 전부. 1번은 기준 3절 문구(x(0), 과도 포함)로 재도 45/45 통과(최대 1.9 cm, 0.69°).
11. **단위 테스트** 74개 통과.

---

## 6. 권고 (우선순위)

1. **실기 전 필수(major)**: M1 — VMC·다리 PD가 검증·유지된 서보 표본을 쓰게 하고 엉덩이·무릎 위치 NaN 테스트(두 주기, 1표본 유지·6표본 FAULT) 추가. M2 — MotionCtrl 유한성 검사(버리고 마지막 유효 명령 유지 + 이벤트, 연속 N개면 단절 프로그램), LQI6 비유한 분기의 무기한 유지 → 몇 주기 뒤 FAULT, `Ramp`·적분기 NaN 차단, 필드별 NaN 테스트.
2. **사용자 결정에 직접 영향하는 문서 정정**: m3(선택지 (가)의 결과를 드리프트 정의별로: 2 s 기준이면 17번 m×0.85 15/45회 실패, x(0) 기준이면 전부 통과 — 기준점 자체를 결정 항목으로), m2(6번 통과는 게이트 덕), m1(1 kHz 지연 여유의 실제 교환 관계).
3. **실기 이식**: m7(`time` 필수·서보별 표본 나이), m8(바퀴 관성 실측, J_w = 0), m5(μ0.5에서 20° 전복을 저마찰 바닥 위험으로 기록), n2(쿼터니언 정규화).
4. **문서·테스트 정리**: m4(비교보고서 11.4), m6(측정점 명시), nit 전부.
5. **사용자 결정(기존 + 이번)**: 16·17 드리프트 기준점과 선택지 (가)~(다), 3·6번 "포화 허용" 해석(m7 보류), 15번 강건 여유의 기준 편입 여부, 1 kHz 운용 시 속도 창 교환(지연 여유 +3 ms ↔ 2·3번 m×0.85·μ0.5 실패).

---

## 부록: 이 검토의 스크립트와 로그 (`results/review_scratch/r2/`)

같은 폴더에 2단계 검토자의 파일(`acceptance_mpc/`, `exp_*`, `sweep19*`, `analyze_*`, `battery_variant*`, `identify/` 등)도 있다. 아래가 이 검토의 것이다.

| 파일 | 내용 |
|---|---|
| `acceptance/`, `acceptance_reduced.log` | 축소 매트릭스 재현(캐시 태그 review_r2) |
| `cache_map.py`, `compare_runs_r2.py`, `repro_rows.json`, `make_repro_table.py`, `repro_table.md` | 현재 해시 ↔ r3_s1 키 대응, 1:1 비교, 공식 JSON 재집계, 1.2절 표 |
| `independent_metrics_r2.py` / `.json` / `.log` | 원시 상태 기반 독립 재계산(1.3절) |
| `plan4_model/`, `plan4_model_soft/`, `verify_stiff.log`, `verify_soft.log`, `check_linearization.py` | 모델 대조 재실행과 커밋 결과 비교 |
| `plant_projection_check.py` / `.log` | MuJoCo 투영 독립 검사(2.2절) |
| `guard_checks.py`, `guard_1000.log`, `guard_200.log`, `guard_checks_*.json` | 센서 가드 폐루프 주입(M1) |
| `host_nan_check.py` / `.json` / `.log` | 호스트 명령 NaN 주입(M2) |
| `imu_sign_check.py` / `.log`, `imu_effect.py` / `.log` | IMU 관례 독립 검사, 판정 영향 |
| `latency_robust.py` / `.json` / `.log`, `velwindow_check.py` / `.log`, `velwindow_items.py` / `.log` | 강건 지연 여유 재측정, 속도 창 교환 |
| `gate_hunting.py` / `.json` / `.log` | 게이트와 정지 헌팅 |
| `item6_and_15.py` / `.json` / `.log` | 6번 통과 원인, 15번 유지 조건 영향 |
| `item4_mu05.py` / `.json` / `.log` | 4번 저마찰 |
| `doc_numbers.py` / `.log`, `count_10cm.py`, `gains_check.py` | 문서 수치 대조, 16·17 10 cm 집계, 게인 |
| `unittest.log` | 단위 테스트 74개 통과 |
