wisehyun-2/my_robot_project/wheeled_biped/docs/review_plan4_r3.md

# Plan 4 1단계 독립 검토 — 3차 (review_plan4_r3)

작성 2026-10-23. 대상: Plan 4 1단계(upkie 직렬 다리 하드웨어 + LQI6 + DIABLO식 호스트/MCU 분리, 램프 호스트, MuJoCo). 이번 라운드는 **좁은 검증**이다: 2라운드 지적(`docs/review_plan4_r2.md`: M1·M2, m1~m8, n1~n14)이 실제로 고쳐졌는지와 공식 결과가 재현되는지만 보았고 새 영역은 찾아 나서지 않았다(지나가다 본 것만 적었다). 코드 해시 `1cbc282b92` = 공식 `results/acceptance/plan4_1000Hz.json`·`plan4_200Hz.json` 머리말의 해시 = 캐시 `results/acceptance/cache/r4_s1/`의 공식 작업 1,194건 키(그 폴더의 나머지 10개 파일은 다른 해시의 잔여물). 작업 트리는 커밋 `22e58a3`(2라운드 반영)과 같다.

저장소 파일은 이 문서 외에 하나도 바꾸지 않았다. 스크립트·로그는 `results/review_scratch/r3/stage1/`, 축소 매트릭스 재현 출력은 `results/review_scratch/r3/acceptance/`(캐시 태그 `review_r3`)에 있다. 같은 `r3` 폴더를 2단계 검토자도 쓰고 있어 `results/review_scratch/r3/acceptance_reduced.log`는 그쪽 MPC 실행 로그로 덮였다 — 이 검토의 재현 결과는 `acceptance/plan4_*Hz.md|json`과 그 사본 `stage1/plan4_*Hz.*`다.

---

## 0. 요약

**major 0 · minor 2 · nit 9**

**한 줄 결론**: 2라운드 major 2건은 **둘 다 해결**됐고 공식 결과는 **비트 단위로 재현**된다. 남은 것은 (1) M1 수정의 200 Hz 잠재 결함 — 유지 표본 `servo_valid`가 호출자 관측 dict의 별칭이라, 관측 dict를 제자리 갱신하는 진입점이면 M1이 200 Hz에서 그대로 재발한다(현 시뮬·upkie 스파인 경로에서는 생기지 않음), (2) "r4_s1은 r3_s1과 수치가 같다"는 서술이 틀림 — 2단계용 `freeze_hold_s`(0.1 s)가 1단계 자체 성형 모드의 z_att 동결에도 걸려 8·11·13번 270회가 전부 바뀌었다(판정 불변, 판정 지표 ≤ 2.2 %), 그리고 문서·테스트 nit이다. 판정(두 주기 모두 1~13 통과, 16·17 실패, 15번 기록 1 kHz 20 ms 미달·200 Hz 25 ms)은 바뀌지 않는다.

- **재현**: 축소 매트릭스 86회의 수치 잎 1,552개가 `r4_s1`의 같은 키 파일과 전부 같다(최대 상대 차이 0, 판정 뒤집힘 0). `r4_s1` 1,194회를 현재 `summarize()`에 넣으면 공식 JSON 두 개와 잎 831·829개가 모두 같다. 단위 테스트 78개 통과. 비교보고서 11.5의 Plan 4 벤치 두 행도 `run_bench`의 함수로 스크래치에서 다시 돌려 64작업 전부 같은 값으로 재현됐다(2라운드 n13에서 검증하지 못한 것).
- **2라운드 M1·M2 재실험**(폐루프 126사례, 두 주기, 노이즈 ON·10 ms 지연): 기대와 다른 사례 0. 엉덩이·무릎(한쪽·양쪽)·전 서보·바퀴·자이로·쿼터니언 NaN 1~5표본은 유지(정지·0.5 m/s 주행, 피치 ≤ 0.84°, FAULT 없음), 8표본은 6번째 표본에 "FAULT: non-finite sensor data for 6 cycles" → 무토크(원인 없는 전복 없음). 정지 시간 스탬프 40 ms 유지·60 ms FAULT. MotionCtrl 6개 필드 NaN 1패킷은 링크가 거부하고 로봇은 서 있다; 0.7 s 쓰레기(35패킷)는 0.475~0.48 s 뒤 타임아웃 → 단절 프로그램, 서 있음(0.5 m/s 주행 중이어도 정지); 링크를 우회해 MCU에 직접 넣어도 무시된다. 법칙 입력 비유한 3·5주기는 유지, 8주기면 6번째에 "FAULT: non-finite balance-law input". 게시 격자 20 s에 1,000패킷·간격 오차 4.7e−14 s. 11번 끝 직전 FAULT → `motors_on` 0.

### 0.1 2라운드 추적 표

| 2라운드 항목 | 응답 | 3라운드 상태 | 근거 |
|---|---|---|---|
| **M1** 엉덩이·무릎 위치 NaN → 즉시 FAULT·전복 | 반영 | **해결**(잠재 결함 → minor m1) | 2.1절: 1~5표본 유지·8표본 FAULT, 두 주기, 정지·주행. 단 200 Hz에서 `servo_valid`가 호출자 dict 자체 |
| **M2** 호스트 MotionCtrl 무검증 | 반영 | **해결** | 2.2·2.3절: 6개 필드 × (1패킷·0.7 s·직접 주입) × 두 주기 전부 서 있음, 0.7 s → 단절 프로그램, Ramp·LQI6 계수기·MCU FAULT 확인. 테스트는 부분(nit n3) |
| m1 지연 여유 원인 서술 | 반영 | 해결 | 4절: 속도 창 2 ms 재측정 = 문서(10° 피크 1.392~1.470 Nm 5/5 실패, 15° 미정착 3/3, 강건 13·15 ms 3/3 통과, 정지 바퀴 rms 0.0445) |
| m2 6번 통과 원인 | 반영 | 해결 | 4절: 게이트 끔 0.208~0.214 Nm 4/4 실패, 보상 끔 0.114~0.116 통과 |
| m3 드리프트 기준점 | 반영(문서)+보류(사용자) | 해결 | 4절: 17번 10 cm 초과 2 s 기준 15/45(주기마다, m×0.85), x(0) 기준 0/45. "1번 ≤ 1.9 cm"만 틀림(nit n5) |
| m4 비교보고서 11.4 옛 수치 | 반영 | **부분** | 280·281행은 현재 값. 284행 "지연 허용치(15 ms)는 유지된다"가 그대로(nit n6) |
| m5 4번 μ0.5 전복 기록 | 반영 | 해결 | 4절: 재측정이 문서와 같음 |
| m6 측정점 base | 반영 | 해결 | 합격기준 6.2, `plan4_lqi8.md` 4.4 |
| m7 정지 감시 범위 | 반영(문서) | 해결(문서) | HANDOFF 2.1 7번. 코드는 그대로(`time` 없으면 감시 꺼짐 — 진입점 과제로 명시) |
| m8 J_w 의미론 | 반영(문서) | 해결(문서) | `plan4_model.md` 2절, HANDOFF 2.1 8번 |
| n1 테스트 독스트링 | 반영 | 해결 | 해당 문구 없음(2라운드 커밋의 `test_plan4.py` 변경은 독스트링뿐) |
| n2 쿼터니언 정규화 | 반영 | 해결 | `mcu.py:256-257`(9번이 1e−11 수준으로 바뀐 원인으로 보임, 1.4절) |
| n3 11번 motors_on | 반영 | 해결 | 2.3절 기능 시험 |
| n4 오버슈트·도달 서술 | 반영 | 해결 | r4_s1: 7.40~12.59 %, 1.14~1.25 s |
| n5 요 오차 | 반영 | 해결 | 최대 0.494 % |
| n6 4.1절 범위 | 반영 | 해결 | 8.14~10.95 cm |
| n7 게인 반올림 | 반영 | **부분** | 1.2절 목록은 맞음. 59행 "z1 게인 2.26 Nm/m" 남음(nit n4) |
| n8 13 ms 한계 사이클 | 반영 | **부분** | `plan4_lqi8.md` 2절 12는 고침. 응답 9행 "게이트 없음 … 13 ms 전복" 남음(nit n7) |
| n9 15번 서술 | 반영 | 해결 | 비교보고서 11.5 해석 문단 |
| n10 테스트 수 | 반영 | 해결 | 11.9 "78 tests"(9절 "# 20 tests"는 nit n9) |
| n11 모델 문서 오타·수치 | 반영 | 해결 | 오타 없음, 1.36 Nm 두 곳, `--soft-contact` 문구, 14.5° |
| n12 9번 유지 토크 | 반영 | 해결 | r4_s1 0.083~0.109 Nm |
| n13 벤치 행 시점 | 반영 | 해결 | 1.5절 재현(64작업 동일, `summary.md` 07:17 > 마지막 코드 변경 06:55) |
| n14 캐시 키 라이브러리 버전 | 반영 | **부분** | mujoco·numpy 포함, scipy 없음(nit n8) |

---

## 1. 재현 결과

### 1.1 실행

```
python -m wbr.bench.acceptance --rate both --matrix reduced --seeds 1 --tag review_r3 --jobs 8 --out results/review_scratch/r3/acceptance
```

86회(정착 13항목 × 3조합 × 2주기 = 78, 생존 4·7 × 2, 기록 15·24 × 2), 8프로세스 약 67 s, 코드 해시 `1cbc282b92`. 판정: 두 주기 모두 불합격(16·17), 1 kHz 15번 기록 실패 — 공식과 같다.

### 1.2 비교 (`stage1/compare_repro.py`, `compare_repro.log`)

- **같은 실행끼리 1:1**: 해시가 같으므로 86회를 `r4_s1`의 같은 키 파일과 비교했다. 수치 잎 1,552개(13번 오르막/내리막, 15번 스윕 포함) **차이 0, 판정 뒤집힘 0**.
- **공식 JSON = 캐시 재집계**: `r4_s1` 1,194회(9조합 × 5시드 × 2주기 + 생존 시드 5개 + 기록)를 현재 `summarize()`에 넣은 결과가 `plan4_1000Hz.json`(잎 831개)·`plan4_200Hz.json`(829개)과 **전부 같다**(참고 열 plan1_pid는 비교에서 뺐다). 항목별 통과 여부·실행 수·실패 건수(16·17 각 45/45, 15번 1 kHz 1건) 일치.
- **단위 테스트**: `python -m unittest discover -s tests` → **78개 통과(18.8 s)** = test_core 20 + test_plan4 38 + test_plan4_safety 20(`stage1/unittest.log`).

5 % 초과 차이나 판정 뒤집힘이 없으므로 재현 major는 없다.

### 1.3 항목별 표 (`stage1/repro_table_r3.md`)

축소 3조합(시드 0)에서 가장 빠듯한 지표(여유율 최대)를 골라 공식 캐시 값과 재현 값을 적었다. 마지막 열은 공식 JSON의 전체 매트릭스 최악값이다(✗ = 기준 초과).

| # | 주기 | 가장 빠듯한 지표 | 조합(시드 0) | 공식 캐시 r4_s1 | 재현 | 차이 | 공식 JSON 최악값(조합) |
|---|---|---|---|---|---|---|---|
| 1 | 1 kHz | pitch_rms [°] | m×1.15 μ1.00 | 0.2875 | 0.2875 | 0 | 0.2875 (m×1.15 μ1.00 s0) |
| 2 | 1 kHz | wheel_peak [Nm] | m×0.85 μ0.50 | 1.286 | 1.286 | 0 | 1.323 (m×0.85 μ0.50 s3) |
| 3 | 1 kHz | wheel_rms10 [Nm] | m×0.85 μ0.50 | 0.125 | 0.125 | 0 | 0.125 (m×0.85 μ0.50 s0) |
| 4 | 1 kHz | alive | 공칭 | O | O | 0 | O |
| 5 | 1 kHz | settle_s [s] | m×0.85 μ0.50 | 1.885 | 1.885 | 0 | 1.899 (m×0.85 μ0.75 s1) |
| 6 | 1 kHz | wheel_rms10 | m×1.15 μ1.00 | 0.1157 | 0.1157 | 0 | 0.1215 (m×0.85 μ1.00 s3) |
| 7 | 1 kHz | alive | 공칭 | O | O | 0 | O |
| 8 | 1 kHz | rise_s [s] | m×0.85 μ0.50 | 1.231 | 1.231 | 0 | 1.25 (m×0.85 μ1.00 s1) |
| 9 | 1 kHz | wheel_rms10 | m×1.15 μ1.00 | 0.1062 | 0.1062 | 0 | 0.1066 (m×1.15 μ1.00 s1) |
| 10 | 1 kHz | leg_rms [Nm] | m×1.15 μ1.00 | 1.974 | 1.974 | 0 | 1.975 (m×1.15 μ0.50 s2) |
| 11 | 1 kHz | stop_time [s] | m×0.85 μ0.50 | 2.345 | 2.345 | 0 | 2.358 (m×0.85 μ1.00 s2) |
| 12 | 1 kHz | wheel_rms10 | m×1.15 μ1.00 | 0.1548 | 0.1548 | 0 | 0.1564 (m×1.15 μ0.75 s2) |
| 13 | 1 kHz | rise_s | m×1.15 μ1.00 | 1.359 | 1.359 | 0 | 1.384 (m×1.15 μ0.50 s0) |
| 15 | 1 kHz | max_latency_ms | 공칭 | 20 ✗ | 20 ✗ | 0 | 20 ✗ (기준 ≥ 25, 기록) |
| 16 | 1 kHz | drift_max [m] | m×0.85 μ0.50 | 0.08718 ✗ | 0.08718 ✗ | 0 | 0.08769 ✗ (m×0.85 μ1.00 s3) |
| 17 | 1 kHz | drift_max | m×0.85 μ0.50 | 0.1057 ✗ | 0.1057 ✗ | 0 | 0.107 ✗ (m×0.85 μ0.75 s1) |
| 24 | 1 kHz | settle_s | 공칭 | 1.897 | 1.897 | 0 | 1.897 (기록) |
| 1 | 200 Hz | pitch_ma_max [°] | m×1.15 μ1.00 | 0.6386 | 0.6386 | 0 | 0.6857 (m×1.15 μ0.75 s4) |
| 2 | 200 Hz | wheel_peak | m×0.85 μ0.50 | 1.288 | 1.288 | 0 | 1.288 (m×0.85 μ0.50 s0) |
| 3 | 200 Hz | wheel_rms10 | m×1.15 μ1.00 | 0.1166 | 0.1166 | 0 | 0.1177 (m×1.15 μ0.50 s3) |
| 4 | 200 Hz | alive | 공칭 | O | O | 0 | O |
| 5 | 200 Hz | settle_s | m×0.85 μ0.50 | 1.93 | 1.93 | 0 | 1.94 (m×0.85 μ0.50 s3) |
| 6 | 200 Hz | wheel_rms10 | m×1.15 μ1.00 | 0.1103 | 0.1103 | 0 | 0.1122 (m×1.15 μ0.50 s2) |
| 7 | 200 Hz | alive | 공칭 | O | O | 0 | O |
| 8 | 200 Hz | rise_s | m×0.85 μ0.50 | 1.215 | 1.215 | 0 | 1.245 (m×0.85 μ0.50 s3) |
| 9 | 200 Hz | wheel_rms10 | m×1.15 μ1.00 | 0.1085 | 0.1085 | 0 | 0.1088 (m×1.15 μ1.00 s1) |
| 10 | 200 Hz | leg_rms | m×1.15 μ1.00 | 1.971 | 1.971 | 0 | 1.977 (m×1.15 μ1.00 s4) |
| 11 | 200 Hz | stop_time | m×0.85 μ0.50 | 2.34 | 2.34 | 0 | 2.39 (m×0.85 μ0.50 s1) |
| 12 | 200 Hz | wheel_rms10 | m×1.15 μ1.00 | 0.1565 | 0.1565 | 0 | 0.1585 (m×1.15 μ1.00 s2) |
| 13 | 200 Hz | rise_s | m×1.15 μ1.00 | 1.405 | 1.405 | 0 | 1.405 (m×1.15 μ0.50 s0) |
| 15 | 200 Hz | max_latency_ms | 공칭 | 25 | 25 | 0 | 25 (통과) |
| 16 | 200 Hz | drift_max | 공칭 | 0.08878 ✗ | 0.08878 ✗ | 0 | 0.09062 ✗ (m×0.85 μ0.75 s4) |
| 17 | 200 Hz | drift_max | m×0.85 μ0.50 | 0.102 ✗ | 0.102 ✗ | 0 | 0.1095 ✗ (m×0.85 μ0.50 s1) |
| 24 | 200 Hz | settle_s | 공칭 | 1.99 | 1.99 | 0 | 1.99 (기록) |

### 1.4 2라운드가 바꾼 1단계 수치 (`r3_s1` ↔ `r4_s1`, 같은 1,194작업; `compare_repro.log` (c), `r3_vs_r4_metrics.log`)

| 항목 | 같은 실행 | 다른 실행 | 판정 지표 최대 변화 | 뒤집힘 |
|---|---|---|---|---|
| 1~7, 10, 12, 15, 16, 17 | 전부 | 0 | 0 | 0 |
| 8 | 0 | 90 | leg_peak 1.63 %, wheel_rms10 0.73 %, stop_disp 0.28 %(도달·오버슈트·정상 오차·피치 피크는 불변) | 0 |
| 11 | 0 | 90 | leg_peak 2.19 %, wheel_rms10 1.92 %, stop_time 1.41 %(기록 v_end는 최대 25 %: −0.020 → −0.015 m/s) | 0 |
| 13 | 0 | 90 | leg_peak 1.05 %, stop_disp 0.26 % | 0 |
| 9 | 19 | 71 | ≤ 3.5e−11(쿼터니언 정규화 수준) | 0 |
| 24 | 0 | 2 | `disp` 지표 제거뿐(2단계 n4), 나머지 동일 | — |

8·11번을 `lqi_kwargs={"freeze_hold_s": 0}`으로 돌리면 두 주기 모두 `r3_s1`과 **비트 단위로 같고**, 기본값(0.1 s)은 `r4_s1`과 같다(`doc_checks_r3.log` hold 행) → 1단계 수치 변화의 원인은 2단계 2라운드 m4의 동결 유지 시간 하나다(minor m2).

### 1.5 벤치 행 (2라운드 n13, `stage1/bench_repro_r3.py`, `.log`)

`run_bench`의 `build_tasks`·`run_task`·`aggregate`·`summary_table`을 그대로 써서 `plan4_lqi6`·`plan4_lqi6_200hz`의 64작업을 스크래치로만 돌렸다(저장소 `results/bench/`는 건드리지 않음). `results/bench/raw_results.json`과 수치 잎 30,602개가 같고(나머지 8개 차이는 링크 끊김 `events`가 튜플/리스트로 직렬화되는 형식 차이일 뿐, JSON으로 바꾸면 같음), 두 행이 `results/bench/summary.md`(07:17) 및 비교보고서 11.5와 RT 배율 외 전부 같다.

---

## 2. 2라운드 major 재실험 (폐루프; `stage1/guard_checks_r3.py`, `.log`, `.json`, 기대 동작 대조 `tally_guards_r3.log`)

모든 사례: Plan 4, 노이즈 ON, 지연 10 ms, 시드 0. 1.5 s(주행 사례는 0.5 m/s로 1.5 s 또는 3 s 순항) 뒤 MCU가 다음에 읽을 관측(또는 호스트 패킷)에 주입하고, 시뮬은 계속 진행해 2~2.5 s 더 관찰했다. 126사례(센서 62, 호스트 52, 법칙 입력 6, 게시 격자 2, motors_on 4) **전부 기대대로**다.

### 2.1 센서 가드 (2라운드 M1, 1라운드 M2)

| 주입 | 1 kHz | 200 Hz |
|---|---|---|
| NaN 1표본(정지): 왼·오른 엉덩이 위치, 왼·오른 무릎 위치, 양쪽 엉덩이, 전 서보 위치·속도, 바퀴 엔코더, 바퀴 속도, 무릎 속도, 자이로, 쿼터니언 | 유지, FAULT·이벤트 없음, 실제 피치 ≤ 0.22°, 토크·적분기·기준 유한 | 같음, ≤ 0.15° |
| NaN 5표본(정지): 엉덩이·무릎·전 서보 | 유지, ≤ 0.22° | 유지, ≤ 0.15° |
| 0.5 m/s 주행 중: 엉덩이·무릎·자이로 1표본, 엉덩이·전 서보 5표본 | 유지, ≤ 0.84° | 유지, ≤ 0.83° |
| NaN 8표본(엉덩이·무릎·전 서보·바퀴 엔코더·바퀴 속도·자이로·쿼터니언 등 9종) | 6번째 표본에 "FAULT: non-finite sensor data for 6 cycles" → 무토크(그 뒤 넘어짐은 설계된 안전 상태) | 같음 |
| 정지 시간 스탬프 40 ms(정지 / 0.5 m/s) | 유지(0.19° / 4.34°, 생존) | 유지(0.14° / 0.87°) |
| 정지 시간 스탬프 60 ms | 52번째 틱 "sensor data stale for 51 ms" | 12번째 틱 "55 ms" |

2라운드에서 1표본에 즉시 FAULT·전복하던 엉덩이·무릎 위치가 이제 다른 채널과 같은 유지 → FAULT 경로를 탄다. 시뮬 하네스(`_obs_to_mcu`가 매 주기 새 dict를 만든다)에서는 두 주기 모두 성립한다. 200 Hz의 별칭 문제는 minor m1.

### 2.2 호스트 MotionCtrl (2라운드 M2)

| 주입(정지, 50 Hz 게시) | 1 kHz | 200 Hz |
|---|---|---|
| forward·left·up·roll·pitch·leg_split 각각 NaN 1패킷 | `rejected` 1, 링크 이벤트 + MCU 이벤트 "host packet rejected", FAULT 없음, 피치 ≤ 0.21°, 기준(v_ref·yaw_rate_ref·L_target·L_ref·roll/pitch_ref·yaw_int·roll_int) 유한 | 같음, ≤ 0.14° |
| 각 필드 0.7 s 쓰레기(35패킷) | 35개 전부 거부, 주입 시작 0.479 s 뒤 "control released (timeout)" → 단절 프로그램, FAULT 없음, 서 있음(≤ 0.21°), 유효 패킷 재개 뒤 제어권 재획득 | 0.475 s, 같음 |
| 같은 NaN 명령을 `mcu.tick(host_cmd=…)`로 직접(링크 우회) 1틱 / 0.7 s | `apply_command`가 무시, FAULT 없음, 서 있음 | 같음 |
| 0.5 m/s 순항 중 forward 0.7 s 쓰레기 | 0.48 s 동안 직전 유효 명령(0.5 m/s) 유지 → 단절 프로그램으로 정지, 이후 피치 ≤ 0.40°, 끝 속도 −0.016 m/s | ≤ 0.54°, −0.009 m/s |
| 0.5 m/s 순항 중 left NaN 1패킷 | 거부, 서 있음 | 같음 |

2라운드의 실패(forward·pitch NaN 지속 → LQI6 출력 동결 후 1.42/0.61 s 전복, left·up NaN 1패킷 → 0.25 s 전복, Ramp 영구 NaN)는 모두 사라졌다.

### 2.3 법칙 입력·Ramp·게시 격자·motors_on

- **LQI6 비유한 계수기 → MCU FAULT**: `theta_eq`가 n틱 동안 NaN을 내게 해 법칙 입력을 직접 오염했다(센서·명령 가드를 모두 지난 뒤의 마지막 방어선). n = 3·5: 직전 출력 유지, FAULT 없음, 계수 3·5 뒤 0으로 복귀. n = 8: 6번째 틱에 "FAULT: non-finite balance-law input"(두 주기).
- **Ramp**: NaN·+inf·−inf 목표를 무시(값 유지)하고 다음 유한 목표는 속도 제한대로 따른다. `HostLink.valid`는 6개 필드의 NaN·±inf를 모두 거부하고, 거부된 패킷은 `last_cmd`·`last_rx_time`(하트비트)을 바꾸지 않는다(`unit_checks_r3.log`).
- **HostEmulator 고정 격자**: 실행 중인 플랜(시뮬 시각)에서 20 s에 1,000패킷, 간격 0.02 s ± 4.7e−14 s(두 주기). 200 Hz 틱·누적 시각 60 s 단위 시험도 3,000패킷 정확히 20 ms.
- **11번 `motors_on`**: 정상 실행은 1. 끝 15 ms(1 kHz)/40 ms(200 Hz) 전에 자이로 NaN을 넣으면 9.991/9.990 s에 FAULT가 걸리고, 로봇은 아직 서 있는데 `motors_on` 0 → 11번 실패로 판정된다(2라운드 코드라면 1로 통과).

---

## 3. Findings (등급순)

### Major

없음.

### Minor

#### m1. 200 Hz에서 유지 표본 `servo_valid`가 호출자의 관측 dict 자체다 — 관측 dict를 제자리 갱신하는 진입점이면 2라운드 M1이 200 Hz에서 그대로 재발

- **위치**: `wbr/controllers/diablo_arch/mcu.py:183-185`(`n <= 1`이면 `_filtered_servo`가 입력 `servo` dict를 그대로 반환; 200 Hz에서는 5 ms 창 = 1스텝이라 항상 이 분기), `:270-271`(`self.servo_valid = servo`), `:446-448`(VMC가 `servo_valid`의 위치를 읽음).
- **근거**(`stage1/alias_check_r3.py`, `.log`): 200 Hz에서 `mcu.servo_valid is obs["servo"]`가 참이다. 같은 관측 dict를 매 주기 갱신해 넘기면서 엉덩이 위치 하나에 NaN을 쓰면 그 틱에 "FAULT: non-finite torque command on left_hip"(2라운드 M1과 같은 증상: 즉시 FAULT → 무토크 → 전복)이다. 같은 손상을 새 dict로 넘기면(시뮬 하네스 방식) 유지되고 FAULT가 없다. 1 kHz는 `_filtered_servo`가 새 dict를 만들기 때문에 두 방식 모두 유지된다.
- **영향**: 현 코드 경로(시뮬 `_obs_to_mcu`, upkie 스파인 Python 인터페이스 `spine_interface.py:108-126`의 매 주기 msgpack 역직렬화)에서는 생기지 않으므로 major로 올리지 않았다. 그러나 실기 계획의 균형 주기가 200 Hz이고(HANDOFF 2절 5번), ROS 2 균형 노드에서 구독 콜백이 관측 dict 하나를 제자리 갱신하고 타이머가 그 dict를 `tick()`에 넘기는 흔한 구조로 진입점을 쓰면 M1 수정이 그 주기에서만 무력해진다.
- **수정안**: `estimate()`에서 `self.servo_valid = {k: dict(v) for k, v in servo.items()}`로 복사해 보관하거나 `_filtered_servo`가 `n <= 1`에서도 새 dict를 반환하게 한다. 200 Hz에서 같은 dict를 제자리 변조하는 테스트를 추가한다. 진입점 계약("관측 dict는 매 주기 새 객체")을 HANDOFF에 적는 것은 보조책이다.

#### m2. "r4_s1은 r3_s1과 수치가 같다"는 틀림 — 2단계용 `freeze_hold_s`(0.1 s)가 1단계 자체 성형 모드의 z_att 동결에도 걸려 8·11·13번 270회가 전부 바뀌었고, 1단계 문서에는 이 변경이 없다

- **위치**: `wbr/controllers/lqi6/lqi6.py:247-256`(유지 카운트가 붙은 `accelerating`이 `att_ramping`에 들어가 성형 모드의 z_att 적분(`:273`)에도 쓰인다; z1·z3 동결은 성형 모드에서 `ramping`만 본다), `docs/비교보고서.md:309`("1라운드 반영판 `r3_s1`과 수치가 같다"), `docs/plan4_lqi8.md:63`(1.3절: "기준 가속도(0.1 s 저역통과)가 0.1 m/s²를 넘는 동안은 적분을 멈춘다" — 유지 시간 없음), `:219`(부록의 2라운드 변경 목록에 `freeze_hold_s` 없음), `docs/review_plan4_r1_response.md:99`(2단계 m4로만 기록).
- **근거**: 1.4절 — 8·11·13번은 두 주기·전 조합·전 시드 270회가 모두 다르다(판정 지표 최대 변화 leg_peak 2.19 %, wheel_rms10 1.92 %, stop_time 1.41 %, stop_disp 0.28 %). `freeze_hold_s = 0`이면 8·11번이 `r3_s1`과 비트 단위로 같다. 정지 단계에서 저역통과 가속도가 임계를 내려간 뒤 z_att 적분이 0.1 s 늦게 재개되는 효과다(커밋 `22e58a3`의 `lqi6.py` 차이로도 확인: 전에는 `att_ramping = |a_lp| > thresh or …`).
- **영향**: 판정 뒤집힘 0이고, 문서에 인용된 범위(오버슈트 7~13 %, 도달 1.14~1.25 s, 정지 0.21~0.24 m, 링크 끊김 뒤 정지 2.1~2.4 s, 11번 최악 2.36/2.39 s)는 인용 자릿수에서 그대로라 수치 재현성 문제는 아니다. 그러나 공유 LQI6의 1단계 동작이 2단계 수정으로 바뀐 사실이 1단계 문서에서 빠져 있고, 11.6절은 반대로 "같다"고 적었다.
- **수정안**: 11.6절을 "1~7·10·12·15~17은 r3_s1과 같고, 8·11·13은 2단계 m4의 동결 유지 0.1 s가 1단계 z_att 동결에도 적용되어 ≤ 2.2 % 바뀜(판정 불변)"으로 고치고, `plan4_lqi8.md` 1.3절·부록에 유지 시간을 적는다. 1단계에 적용할 의도가 아니었다면 유지 카운트를 플레인 모드(`not self.shaping_on`)로 한정하고 1단계를 다시 돌린다.

### Nit

| # | 내용 | 위치 |
|---|---|---|
| n1 | 센서 FAULT 이벤트가 원인 채널을 적지 않는다("non-finite sensor data for 6 cycles"). 2라운드 M1 수정안의 셋째 항목(원인 관절 기록)이 반영되지 않았다 — 실기 진단에는 채널명이 필요 | `mcu.py:244` |
| n2 | MCU가 거부된 호스트 패킷마다 이벤트를 하나씩 쌓는다(50 Hz 쓰레기면 초당 50개, 상한 없음; 링크는 1·50·100…번째만 기록). 실시간 보드에서는 목록이 무한히 자란다(`unit_checks_r3.log`: 2 s에 MCU +100, 링크 +4) | `mcu.py:334-337` |
| n3 | 새 테스트의 범위가 응답·문서 서술보다 좁다: M2 테스트는 1 kHz만, 단일 패킷은 forward·left·up·pitch만(roll·leg_split 없음), 지속은 forward만. 지속 테스트의 "서 있음" 검사(`pitch_true[-1]`, `all_torques_finite`)는 `_nan_packets`가 로그를 남기지 않아 **쓰레기 주입 전** 표본을 본다. 법칙 입력 테스트는 계수기만 보고 MCU FAULT("non-finite balance-law input")는 시험하지 않는다. 자이로 8표본 FAULT는 1 kHz만인데 문서는 "두 주기". 118행은 아무 일도 하지 않는 줄이다. 동작 자체는 2절에서 확인됨 | `tests/test_plan4_safety.py:47-56,113-158`, `docs/plan4_lqi8.md:90` |
| n4 | "z1 게인 2.26 Nm/m" — 같은 절 목록과 실제 값은 −2.25(−2.2548). 2라운드 n7의 나머지 | `plan4_lqi8.md:59` |
| n5 | "1번은 두 정의 모두 ≤ 1.9 cm" — r4_s1의 1번 최대 이탈은 2 s 기준 2.52 / 2.51 cm, x(0) 기준 1.88 / 1.96 cm(1 kHz / 200 Hz). 판정 무관 | `plan4_lqi8.md:184` |
| n6 | 11.4 바퀴 떨림 문단의 "지연 허용치(15 ms)는 유지된다"가 2라운드 m4가 지적한 그대로 남아 있다(현재 벤치 20 ms, 15번 20/25 ms, 강건 12/15 ms). 튠 당시 값임을 표시하거나 현재 값으로 | `비교보고서.md:284` |
| n7 | 응답 1단계 M1 행의 "게이트 없음 … 13 ms 전복" — 2라운드 시드 5개 측정(`results/review_scratch/r2/latency_robust.log`)은 게이트 끔 13 ms에서 5/5 생존(한계 사이클 3.2°), 전복은 14 ms부터. 2라운드 n8의 나머지(같은 행의 변형 E 서술과 `plan4_lqi8.md`는 고침) | `review_plan4_r1_response.md:9` |
| n8 | 캐시 해시에 scipy 버전이 없다(LQR 설계 `scipy.linalg.solve_discrete_are`·`expm`가 판정 경로에 있다). 2라운드 n14의 나머지 | `acceptance.py:591` |
| n9 | 9절 재현 블록의 "# 20 tests" — 지금 같은 명령은 78개를 돈다 | `비교보고서.md:204` |

범위 밖 관찰(2단계 검토자 몫, 집계하지 않음): `docs/합격기준.md:112`의 "제동 한계 a_dec = 1.3 a_max"는 현재 `decel_factor` 1.17(`reference_mpc.py:73`, `plan4_mpc_host.md:19`)과 다르다.

---

## 4. 2라운드에서 바뀐 문서 수치의 대조 (`doc_checks_r3.log`, `doc_numbers_r3.log`, `drift_ref_diff_r3.log`)

| 서술(위치) | 측정(현재 코드 `1cbc282b92`) | 판정 |
|---|---|---|
| 6번 통과 원인 = 피치 속도 게이트: 게이트 끔 0.208~0.214 Nm 실패, 보상 끔 0.113~0.115 통과(`plan4_lqi8.md` 0, 비교보고서 11.6, HANDOFF 2.1 10번) | 1 kHz m×0.85 μ0.75/1.0 시드 0~1: 게이트 끔 0.2082~0.2135(4/4 실패), 보상 끔 0.1135~0.1156(통과), 기본 0.1162~0.1197 | 맞음 |
| 강건 여유 1 kHz 12 ms·200 Hz 15 ms, 3° 기준 시험 20/25 ms(`plan4_lqi8.md` 0·4.2, HANDOFF 2.1 4번, 비교보고서 11.5·11.6) | r4_s1 15번: 20/25 ms, 강건 12 ms(15 ms 전복)/15 ms(20 ms 전복) | 맞음 |
| 5 ms 창 교환: 2 ms면 강건 ≥ 15 ms·정지 바퀴 rms 0.037 → 0.044, 10° 피크 1.39~1.47(2번 실패), μ0.5 15° 미정착(3번 실패)(`plan4_lqi8.md` 2절 12·4.2) | 2 ms: 강건 13·15 ms 시드 0~2 전부 통과(꼬리 0.11~0.12°), 정지 바퀴 rms 0.0445, 10° 피크 1.392~1.470(5/5 실패), 15° m×0.85 μ0.5 미정착 3/3(포화 31~38 %) | 맞음 |
| 드리프트 기준점: 16·17은 2 s 기준이 1~2 cm 큼, 17번 10 cm 초과 2 s 기준 m×0.85 15/45(10.2~11.0), x(0) 기준 ≤ 9.2, 16번 ≤ 9.1(합격기준 6.2, `plan4_lqi8.md` 4.1) | 실행별 차이 16번 1.13~1.64, 17번 1.21~1.76 cm; 17번 2 s 기준 15/45(1 kHz 10.44~10.70, 200 Hz 10.18~10.95), x(0) 0/45(최대 9.00/9.22); 16번 최대 8.77/9.06 | 맞음(1번 ≤ 1.9는 nit n5) |
| 4번 μ0.5: 세 질량 모두 전복, 1 kHz 34~44°, 200 Hz 38~44°, 포화 0.10~0.13 s, μ1.0 생존(`plan4_lqi8.md` 4.3, HANDOFF 2.1 9번) | 1 kHz 34.4/44.4/41.0°, 200 Hz 43.9/42.0/37.8°, 포화 0.099~0.133 s, μ1.0 여섯 경우 생존 | 맞음 |
| 게인(`plan4_lqi8.md` 1.2) | 1 kHz K_T [−7.6199, −1.1283, −1.9794, 1.5877, 0.2328, −2.2548, 0.4719, −0.6442], K_Tp [20.355, 2.7174, 5.324, 29.5601, 1.4319, 8.4195, 22.1112, 2.563]; 200 Hz K_T [−7.3698, −1.0854, −1.884, 1.5351, 0.2248, −2.1394, 0.4567, −0.6108], K_Tp [17.0901, 2.2513, 4.3836, 25.3464, 1.2796, 6.9726, 18.7673, 2.1242] | 목록 맞음(59행 2.26은 nit n4) |
| 테스트 수 78(HANDOFF 1절, 비교보고서 11.9, `plan4_lqi8.md` 부록, 응답 머리말) | 78 통과(20 + 38 + 20) | 맞음(9절 20은 nit n9) |
| 벤치 행(비교보고서 11.5) = `results/bench/summary.md` | 재현 동일(1.5절) | 맞음 |
| 성형 결과: 오버슈트 7~13 %, 도달 1.14~1.25 s, 정지 0.21~0.24 m(끝점 0.08), 링크 끊김 정지 2.1~2.4 s(`plan4_lqi8.md` 1.4, 비교보고서 11.4) | r4_s1: 7.40~12.59 %, 1.14~1.25 s, 0.209~0.236 m(끝점 0.079~0.089), 2.095~2.39 s | 맞음 |
| 9번 바퀴 rms 0.08~0.11 Nm(HANDOFF 2.1 6번), 요 오차 ≤ 0.5 %(`plan4_lqi8.md` 3.3) | 0.083~0.109 Nm, ≤ 0.494 % | 맞음 |
| 0절의 가장 빠듯한 지표·16·17 최악값(`plan4_lqi8.md` 0, 비교보고서 11.6) | 공식 JSON과 같음(1.2절 재집계) | 맞음 |
| "r4_s1은 r3_s1과 수치가 같다"(비교보고서 11.6) | 8·11·13번 270회가 다름(1.4절) | **틀림**(minor m2) |

---

## 5. 검증한 것 (정상 확인)

1. **재현**: 축소 매트릭스 86회 비트 단위 동일, 공식 JSON 두 개 = r4_s1 1,194회 재집계(차이 0), 현재 코드 해시 = 공식 해시, 단위 테스트 78개 통과, Plan 4 벤치 두 행 재현.
2. **M1**: `servo_valid` 경로(`mcu.py:156,270-271,446-448`) 코드 확인 + 2.1절 폐루프 62사례(두 주기, 정지·주행, 1·5·8표본). 첫 유효 표본 전에는 원시 관측으로 떨어지는 분기(`:446`)가 남지만 그때는 `est_valid`가 거짓이라 실기 진입점의 `arm()`이 거부한다.
3. **M2**: `HostLink.valid/receive`(`host_link.py:90-104`), `apply_command` 입구 검사(`mcu.py:294-295`), `Ramp` 가드(`filters.py:41-42`), LQI6 계수기·MCU FAULT(`lqi6.py:224-227`, `mcu.py:413-415`), 거부 이벤트(`mcu.py:334-337`) 코드 확인 + 2.2·2.3절 폐루프 58사례와 단위 검사.
4. **센서 가드의 나머지**: 정지 시간 스탬프(40 ms 유지 / 60 ms FAULT, 두 주기), 쿼터니언 정규화, 지연선 준비 구간(모든 사례의 주입 전 구간에 FAULT·이벤트 없음).
5. **11번 `motors_on`**: FAULT 반영(2.3절).
6. **HostEmulator 고정 격자**: 두 주기 실행 중 + 60 s 단위 시험.
7. **문서 수치**: 4절 전부.
8. **r3_s1 ↔ r4_s1**: 어느 항목이 왜 바뀌었는지(1.4절). 2라운드 커밋 `22e58a3`의 1단계 관련 코드 차이(`mcu.py`, `lqi6.py`, `host_link.py`, `filters.py`, `acceptance.py`, `tests/`)를 응답 표와 하나씩 대조했다 — 표에 없는 1단계 동작 변경은 `freeze_hold_s`의 1단계 효과(minor m2)뿐이고, `test_plan4.py`의 변경은 독스트링뿐(기대값 완화 없음).

---

## 부록: 이 검토의 스크립트와 로그 (`results/review_scratch/r3/stage1/`)

| 파일 | 내용 |
|---|---|
| `../acceptance/`(캐시 `review_r3`), `plan4_1000Hz.*`·`plan4_200Hz.*`(사본) | 축소 매트릭스 재현(1.1절) |
| `hash_and_keys.py` / `.log` | 현재 해시 = 공식 해시, r4_s1 키 대응 |
| `compare_repro.py` / `.log`, `repro_rows.json` | 1:1 비교, 공식 JSON 재집계, r3_s1 ↔ r4_s1(1.2·1.4절) |
| `make_table_r3.py`, `repro_table_r3.md` | 1.3절 표 |
| `r3_vs_r4_metrics.py` / `.log` | 1.4절 판정 지표 변화 |
| `bench_repro_r3.py` / `.log`, `bench_repro_r3_raw.json` | 1.5절 벤치 행 재현 |
| `guard_checks_r3.py` / `.log` / `.json` / `.stdout`, `tally_guards_r3.py` / `.log` | 2절 폐루프 126사례 |
| `unit_checks_r3.py` / `.log` | Ramp·HostLink·200 Hz 격자·이벤트 증가 |
| `alias_check_r3.py` / `.log` | minor m1 |
| `doc_checks_r3.py` / `.log` / `.json` | 4절 재측정(게인, 6번 원인, 2 ms 창, 4번 μ0.5, freeze_hold 원인) |
| `doc_numbers_r3.py` / `.log`, `drift_ref_diff_r3.py` / `.log` | 4절 캐시 집계 |
| `unittest.log` | 단위 테스트 78개 통과 |
