wisehyun-2/my_robot_project/wheeled_biped/docs/비교보고서.md

# 6모터 휠-레그 로봇 — Plan 1 / 2 / 3 구현·시뮬레이션 비교 보고서 (1차: Windows + MuJoCo)

작성일 2026-10-21, 검토 반영 2026-10-22(10절), Plan 4 추가 2026-10-23(11절). 대상: 모터 6개(다리당 3개) wheeled bipedal 로봇의 세 가지 설계안. 모든 수치는 `wheeled_biped/` 아래의 코드로 재현 가능하며(`python -m wbr.bench.run_bench`, 약 15초), 원본은 `results/bench/*.json`, 그림은 `results/figures/`, 영상은 `results/videos/`에 있다.

---

## 0. 요약과 추천

| 질문 | 결론 |
|---|---|
| **세 플랜 모두 시뮬레이션에서 동작하는가?** | **예.** 세 플랜 모두 MuJoCo(1 kHz 제어, 0.5 ms 물리, IMU·엔코더 노이즈, 2 ms 지연)에서 서서 균형을 잡고, 10~30° 기울임에서 복귀하고, 0.8 m/s 주행·1 rad/s 선회·푸시 외란을 견딘다. 각 플랜의 세부 요구사항 달성 여부는 3절의 체크리스트 참조. |
| **어느 플랜이 가장 좋은가?** | **Plan 2 (DIABLO 아키텍처 + 설계보고서의 LQI6 제어기)** 가 모든 항목에서 가장 좋다: 복귀 가능 기울임 30°(상한은 바퀴 토크 5 Nm), **체중 2.5배(147 N)×0.1 s 푸시 복귀**(다른 플랜은 0.25~0.75배), 10° 기울임 정착 0.36 s·변위 1 cm(다른 플랜 0.7~1.7 s·최대 0.6 m), 0.5 W 푸시에 피치 1.7°(다른 플랜 10~14°), 0.8 m/s 가속 중 피치 2°(다른 플랜 9~19°), 6 cm 웅크림 중 피치 0.9°, 60 s 기립 드리프트 2 cm, 호스트 링크 단절 시 0.5 s 후 자동 정지. |
| **왜 Plan 1/3(upkie 제어 코드)은 뒤지는가?** | upkie의 WheelBalancer는 "피치 PI + 위치 PI → 바퀴 속도" 구조라 (a) 바퀴 속도 루프가 무르고(kd = 1 Nm·s/rad), (b) 목표 피치가 0으로 고정돼 COM 오프셋이 생기면(웅크림, 다리 질량) 약 1 m의 위치 오차로 보상해야 하며, (c) 전상태 피드백이 아니라 복귀가 느리고 진동한다(그림 1). MPC도 바퀴 속도 명령을 내는 구조라 같은 한계를 공유한다. 이는 설계보고서 §6의 SIL 결과(upkie PD의 정착 4.8 s, 10~15° 복귀)와 일치한다. |
| **Plan 3은 의미가 있는가?** | 구조는 성립하지만(DIABLO MCU 안에서 upkie 관측기·서보 의미론이 그대로 돈다) 성능 이득이 없다. upkie 코드에서 가져올 가치가 있는 것은 제어 법칙이 아니라 **관측기(접지 판정·바퀴 오도메트리), 서보 명령 추상화(position/velocity/feedforward/kp·kd scale), URDF 규약, 시뮬↔실기 워크플로**이며, 이것들은 Plan 2에도 그대로 넣을 수 있다(이미 코드에 포함). |
| **ROS 2는?** | 세 플랜 모두 ROS 2 Jazzy용 패키지(메시지, 노드, launch, URDF)를 `ros2_ws/src`에 작성했다. Windows에는 ROS 2·컴파일러가 없어 **빌드·실행은 우분투에서 검증해야 한다**(8절). 제어기·시뮬레이터 코어(`wbr`)는 ROS에 의존하지 않도록 만들어 Windows에서 전부 테스트했다. |

**최종 추천: Plan 2.** 실시간 보드(1 kHz, 토크 모드, LQI6 + VMC)가 균형을 맡고 ROS 2 호스트는 DIABLO와 같은 토픽(`/diablo/MotionCmd`, `/diablo/sensor/*`)으로 명령·텔레메트리만 주고받는 구조. 보완할 점은 7절.

> **2026-10-23 갱신:** 사용자가 제작 가능성(FreeCAD 설계 파일)을 이유로 **upkie 기구 + LQI6 + 호스트/MCU 분리 = Plan 4**를 최종안으로 확정했다. Plan 4의 모델 유도·하드웨어 발견·제어기·합격 판정은 **11절**에 있다. 1~10절의 Plan 1~3 비교는 그대로 유효하다.

---

## 1. 작업 환경과 방법

- **환경**: Windows 11, Python 3.14 venv, MuJoCo 3.16. ROS 2·WSL·Docker·MSVC가 없어 ROS 2 패키지는 작성만 하고 빌드는 우분투로 미룸. Isaac Sim은 설치 부담(수십 GB)과 Windows 제약 때문에 MuJoCo를 주력으로 사용.
- **코드 구조**: ROS 비의존 코어 `wbr`(제어기·관측기·시뮬·벤치마크) + `ros2_ws/src`(얇은 rclpy 래퍼). 같은 코어가 라이브 뷰어, 벤치마크, ROS 2 노드에서 쓰인다.
- **시뮬레이션 조건(공통)**: 물리 0.5 ms(implicitfast, elliptic cone, noslip 2), 제어 1 kHz, 서보 PD는 매 물리 스텝 평가(moteus처럼 서보 루프가 제어 루프보다 빠름), 바퀴 마찰 1.0.
- **센서 모델(설계보고서 §8.2의 SIL 하네스와 동일)**: 피치 0.2°, 자이로 0.5°/s, 가속도 0.05 m/s², 14-bit 엔코더 양자화(위치) + 그 양자화를 1 kHz로 미분한 속도 노이즈(균등 ±0.38 rad/s, σ≈12.7°/s) + 0.5°/s 가우시안, 관측 지연 2 ms(지연 허용 시험은 0~80 ms 스윕). 이 노이즈는 제어기 입력에만 들어가고 서보 PD는 참값을 쓴다. 토크모드인 Plan 2의 정지 토크 RMS는 이 속도 노이즈로 결정된다(문서대로 0.5°/s만 넣으면 0.073→0.032 Nm).
- **판정 기준**: *alive* = 마지막까지 서 있음(|피치| < 57°, 높이 유지). *settled* = alive이고 마지막 1 s 동안 |피치| < 3°, |속도 − 기준| < 0.3 m/s(설계보고서 SIL 하네스와 동일). 정착시간은 |피치| > 1° 또는 |속도 오차| > 0.1 m/s인 마지막 시각.
- **시나리오**: 기립 6 s, 초기 기울임 5~40°(2.5° 간격이 아닌 5° 간격, 8 s), 몸통 푸시 0.25~3.0×체중(0.1 s, 8 s), 0.8 m/s 속도 스텝(2.5 s 유지 후 정지), 요 1 rad/s 2 s, 2/4/6 cm 웅크림, 지연 0~80 ms(3° 기울임, 노이즈 없음), 호스트 링크 단절(0.5 m/s 주행 중), 실시간 배율.

---

## 2. 만든 것

### 2.1 로봇 모델

| | Plan 1: Upkie | Plan 2·3: DIABLO-lite (6 kg) |
|---|---|---|
| 출처 | `upkie_description` URDF/xacro(Apache-2.0)를 MuJoCo `MjSpec`로 그대로 읽어 MJCF 생성(`wbr/models/build_upkie.py`) | DIABLO SDF(`DiabloSTLSDF`)에서 다리 기구를 읽어 파라메트릭 MJCF + URDF 생성(`wbr/models/build_diablo_lite.py`) |
| 질량 | 5.34 kg (URDF 그대로: 토르소 1.0, 배터리 0.8, qdd100 ×4 0.47, …) | **6.00 kg**: 토르소 2.0 + 고관절 모터 4×0.45 + 다리(허벅지 0.25, 정강이 0.25, 크랭크 0.05, 로드 0.05)×2 + 바퀴·모터 0.5×2 |
| 다리 | 직렬 2링크(고관절·무릎 qdd100), 바퀴 mj5208, 다리 길이 0.343 m, 바퀴 반경 0.05, 트랙 0.305 m | **DIABLO와 같은 평행사변형 5절 링크**: 동축 고관절 모터 2개(Motor1→허벅지 0.14 m, Motor0→크랭크 0.09 m + 로드 0.14 m → 정강이 0.14 m의 절대각 결정), 바퀴 반경 0.065, 트랙 0.38 m, 기립 다리 길이 0.198 m(0.12~0.26) |
| 토크 한계 | 고관절·무릎 16 Nm, 바퀴 1.7 Nm (upkie 규격) | 고관절 12 Nm, 바퀴 5 Nm (설계보고서 5 kg급 RMD-L 계열 가정) |
| 관성 | URDF 값 | 프리미티브 형상에서 MuJoCo가 계산(몸체 관성 base 프레임 기준 Ixx 0.046 / **Iyy(피치) 0.023** / Izz 0.038 kg·m², COM 고관절 위 5.3 cm) |
| 검증 | 42 바디, 기립 높이 0.557 m, 바퀴 접지점 ±0.1524 m가 upkie `contact_radius`와 일치 | 폐루프 잔차 3×10⁻¹⁰ m(무하중), 기립 하중 시 0.00 mm(구속 강성 solref 1 ms), 5절 링크 FK가 MuJoCo와 일치(세 자세), 야코비안 유한차분 오차 10⁻¹¹ |

DIABLO 실물(22.9 kg)의 질량·관성은 전부 6 kg급으로 다시 잡았다(요청 사항 Plan 2-3, 3-3). 실제 DIABLO URDF(`diablo_simulation.urdf`)는 질량이 비현실적(137 kg)이라 형상 참고용으로만 썼고, 기구 치수는 SDF(0.14/0.14/0.09 m)를 따랐다.

### 2.2 제어·아키텍처 구현

| 구성요소 | 내용 | 파일 |
|---|---|---|
| 서보 모델 | moteus식 τ = τ_ff + kp·kp_scale(q*−q) + kd·kd_scale(q̇*−q̇), 클램프 (upkie Bullet spine kp 20, kd 1) | `wbr/common/servo.py` |
| upkie 관측기 포팅 | BaseOrientation(피치 부호 규약 포함), WheelContact(겉보기 관성 |τ|/|α|), FloorContact, WheelOdometry | `wbr/observers/upkie_observers.py` |
| upkie 제어 포팅 | WheelBalancer(PI, 비최소위상 트릭, 다리 kp/kd 스케일), MPCBalancer(qpmpc 동일 문제, ProxQP 대신 DAQP), Gyropod 서보 매핑 | `wbr/controllers/upkie/` |
| LQI6 | 설계보고서 §8의 `MineLQI6` 포팅: 3체 플랜트(`plant6`) 선형화 → 1 kHz dLQR, 상태 [θ, θ̇, v−v_ref, φ, φ̇, ∫(v−v_ref)], R은 토크 한계 비례. 게인은 다리 길이 0.10~0.28 m(1 cm 격자)에서 미리 설계해 보간(MCU 1 kHz 루프 안에 리카티 없음, 설계 실패 시 마지막 게인 유지), 포화 시 조건부 적분 | `wbr/controllers/lqi6/` |
| 5절 링크 VMC | FK/IK/야코비안, (다리 힘 F, 고관절 토크 Tp) → (τ_hip, τ_crank) = Jᵀ[F·u + (Tp/L0)·u′] | `wbr/controllers/lqi6/fivebar.py` |
| DIABLO MCU 에뮬레이션 | 모드 상태기계(CAR/TRANSITION/STAND; lite에는 보조 바퀴가 없어 주저앉기(transform down)는 거부), 추정기(피치·롤·월드 요레이트·가상다리 각/길이·바퀴 지면속도), 명령 의미론(forward·left·up·roll·pitch, 각도/속도 모드), 다리 길이 PD+중력 FF, 요 PI(차동 바퀴 토크), 롤(기하 피드포워드+PI, 다리 길이 차), **anti-split PD**, arm(|피치|<3°)·34° FAULT 시 전 관절 토크 0, NaN 가드, 플러그인 균형 법칙 | `wbr/controllers/diablo_arch/mcu.py` |
| 호스트 링크 | `obtain_control(timeout 500 ms)`, 180 ms 하트비트 재전송(`diablo_ctrl_node`와 동일), 패킷은 복사본으로 전달, 타임아웃 시 제어권 해제 + 정지 프로그램(속도·속도모드 입력 0, 자세 유지) | `wbr/controllers/diablo_arch/host_link.py` |
| Plan 3 법칙 | upkie WheelBalancer/MPC + upkie 관측기 + 바퀴 속도모드 + 고관절 위치모드(IK) + `feedforward_torque`로 중력 보상 | `wbr/controllers/diablo_arch/upkie_law.py` |
| 벤치마크·뷰어·영상 | 멀티프로세스 배터리(293 과제 15 s), 그래프, 라이브 뷰어(키보드 조종), MP4 렌더 | `wbr/bench/`, `wbr/viewer/` |
| 단위 테스트 | 회전 규약, 서보, 램프/지연, 5절 링크 FK/IK/야코비안/VMC, LQI6 폐루프 안정성·게인 표, 링크 타임아웃·패킷 복사, MCU 안전(주저앉기 거부·FAULT·arm·링크 OFF), 정착 판정, Plan 1 웅크림, 세 플랜 기립 스모크 | `tests/test_core.py` (20개 통과) |

---

## 3. 플랜별 요구사항 달성 체크리스트

### Plan 1 — upkie 참고, ROS 2 구조로 재작성, upkie URDF/xacro, MuJoCo

| 요구 | 상태 | 비고 |
|---|---|---|
| 1. upkie 제어기·코드를 참고해 ROS 2 구조로 재작성 | **코어 완료 / ROS 2 래퍼 작성(빌드 미검증)** | 관측기·균형기·서보 매핑을 Python으로 포팅. ROS 2 설계: `upkie_spine`(1 kHz 루프, 관측 발행, 서보 명령 구독, upkie처럼 균형기를 spine 안에 둘 수 있는 `embedded_balancer`), `upkie_balancer`(PI/MPC 노드), `upkie_bringup`(launch, rviz) |
| 2. ROS 2 humble/jazzy, URDF·xacro는 upkie_description | **완료** | `models/upkie_description` 그대로 사용(ROS 패키지 형식 유지), MJCF는 URDF에서 자동 생성 |
| 3. pixi 시뮬 대신 MuJoCo | **완료** | `models/upkie/scene.xml`, mjlab_upkie는 MJCF 작성 참고(접촉·관성 설정) |
| 4. 꼼꼼한 테스트 | **완료(MuJoCo)** | 4절 결과. upkie 고유 특성: 접지 판정기가 정지·무토크에서 작동하지 않아(겉보기 관성 방식, 시뮬에서 첫 판정까지 약 0.7 s) MPC 변형은 시뮬 접촉 플래그 사용(각주 ①), 1 cm 낙하 착지로 시작(upkie Bullet spine과 같은 방식). 관측 피치에서 모델 평형 피치(1.3°, 웅크림 시 재계산)를 빼는 IMU 영점 보정을 넣었다(각주 ②, `pitch_offset="none"`으로 끌 수 있음) |

### Plan 2 — DIABLO 아키텍처 + LQI6, 6 kg 재설계, MuJoCo

| 요구 | 상태 | 비고 |
|---|---|---|
| 1. DIABLO 아키텍처(균형기 제외) + 내가 설계한 제어기 | **완료** | MCU/호스트 분리, 모드·명령·타임아웃·하트비트·텔레메트리 주기(IMU·모터 50 Hz, 상태 10 Hz)까지 DIABLO SDK와 같은 의미론. 균형 법칙만 LQI6 |
| 2. ROS 2 humble/jazzy | **래퍼 작성(빌드 미검증)** | `motion_msgs`/`ception_msgs`를 DIABLO와 동일하게 두어 DIABLO teleop·도구 호환 |
| 3. 6 kg급 질량·관성 재설정 | **완료** | 2.1절 표. LQI6 설계용 플랜트도 모델에서 자동 도출(몸체 관성은 MuJoCo 값) |
| 4. MuJoCo에서 작동 확인 | **완료** | 4절. 최고 성능 |
| 보조 저장소 조사 | **완료** | `diablo-sim-env`(Webots, 제어기 없음), `DiabloSTLSDF`(5절 링크 기구 치수·질량), `Col_DIABLO_Issac_RL`(VMC·PD 게인 참고), `diablo_sdk`/`diablo-sdk-docs`(프로토콜·명령) |

### Plan 3 — DIABLO 아키텍처 + upkie 제어 코드, 6 kg, ROS 2

| 요구 | 상태 | 비고 |
|---|---|---|
| 1·2. DIABLO ROS 2 구조 + upkie 제어 코드 결합 | **완료(코어) / 래퍼 공유** | Plan 2와 같은 MCU·호스트·ROS 2 패키지, `balancer` 파라미터만 `upkie_pid`/`upkie_mpc`. upkie 코드 수정점: 같은 방향 바퀴 축(미러 아님), 5절 링크 IK로 "다리 중립 자세", 고관절 중력 보상(upkie 서보 API의 `feedforward_torque` 사용) |
| 3. 6 kg 재설정 | **완료** | Plan 2와 동일 모델 |
| 4. 테스트 | **완료** | upkie PI 게인은 upkie(5.3 kg, r 5 cm)용이라 6 kg·r 6.5 cm에선 푸시 내성이 낮다; 게인 스케일 1.5~3배로 1.0 W까지 개선되나 정착은 여전히 느림 |

---

## 4. 벤치마크 결과

### 4.1 요약표 (`results/bench/summary.md`, 노이즈 + 2 ms 지연, 검토 반영 후 재실행)

W = 로봇 무게(upkie 52 N, DIABLO-lite 59 N). "settled / alive" = 정착 기준 통과 / 넘어지지 않음. 정착시간은 20 ms 이동평균 피치가 1° 안에, 속도가 0.1 m/s 안에 머무는 시각.

| 변형 | 최대 복귀 기울임 [°] | 최대 푸시 [×W] | 지연 허용 [ms] | 기립: 피치 RMS [°] / 6 s 드리프트 [m] / 바퀴 토크 RMS [Nm] | 10° 복귀 정착 [s] / 변위 [m] | 0.5 W 푸시: 피치 피크 [°] / 정착 [s] | 0.8 m/s 스텝: 상승 [s] / 오버슈트 [%] / 피치 피크 [°] | 요 1 rad/s → [rad/s] | 최대 웅크림 | 링크 단절 (생존 / 6 s 후 속도) | 실시간 배율 |
|---|---|---|---|---|---|---|---|---|---|---|---|
| **Plan 1 upkie PI** | 25 / 25 | 0.25 / 0.50 | 40 / 60 | 1.08 / 0.096 / 0.102 | 0.94 / 0.05 | 14.3 / 미정착 | 0.54 / 31 / 18.6 | 0.93 | 생존·미정착 (2 cm, 피치 4.3°) | 해당 없음 | 8.2 |
| Plan 1 upkie MPC ① | 20 / 20 | 0.75 / 0.75 | 80 / 80 | 0.31 / 0.072 / 0.022 | 1.67 / 0.62 | 10.4 / 2.40 | 0.93 / 15 / 8.6 | 0.93 | 6 cm (4.0°) | 해당 없음 | 7.4 |
| **Plan 2 DIABLO + LQI6** | **30 / 30** | **2.50 / 2.50 (147 N)** | 30 / 30 | **0.21 / 0.008** / 0.073 | **0.36 / 0.01** | **1.7 / 2.83** | 1.16 / 22 / **2.1** | **1.00** | **6 cm (피치 0.9°)** | O / 0.01 | 4.3 |
| Plan 3 DIABLO + upkie PI | 30 / 30 | 0.25 / 0.75 | 60 / 60 | 0.71 / 0.292 / 0.092 | 0.72 / 0.01 | 11.8 / 미정착 | 0.52 / 25 / 17.5 | 0.93 | 6 cm (4.0°) | O / 0.02 | 4.4 |
| Plan 3 DIABLO + upkie MPC ① | 30 / 30 | 0.50 / 0.50 | 80 / 80 | 0.22 / 0.005 / 0.020 | 1.22 / 0.17 | 12.7 / 2.06 | 0.91 / 4 / 10.5 | 0.93 | 6 cm (1.3°) | O / −0.01 | 4.2 |
| Plan 3 upkie PI, 게인 ×3 | 30 / 30 | 0.25 / 1.25 | — | 0.91 / 0.043 / 0.265 | 0.31 / 0.00 | 4.8 / 미정착 | — | — | — | — | 4.4 |
| Plan 1 upkie PI, 게인 ×1.5 | 25 / 25 | 0.50 / 0.75 | — | 0.38 / 0.049 / 0.148 | 0.89 / 0.04 | 8.9 / 미정착 | — | — | — | — | 7.4 |

(기울임 35°·40°는 모든 플랜이 실패 — 바퀴 토크 한계(1.7 / 5 Nm). Plan 2는 3.0 W 푸시에서 바퀴 토크 5 Nm 포화로 실패. 지연 허용 30 ms는 설계보고서 LQI6의 20~30 ms와 일치한다. MPC 변형의 80 ms는 제어가 무르기 때문이며, 같은 이유로 푸시 내성이 낮다. ① MPC 변형은 시뮬 진실 접지 플래그 사용(10절 각주).)

### 4.2 그림

- `results/figures/time_responses.png` — 10° 기울임 / 0.5 W 푸시 / 0.8 m/s 스텝의 피치·속도 시계열(그림 1). Plan 2(빨강)만 피치가 2° 안에서 머물고 1 s 안에 정착한다. upkie 계열은 ±5~14° 진동 뒤 느리게 수렴하거나(PI) 0.1 m/s 수준의 표류가 남는다(MPC).
- `results/figures/robustness.png` — 최대 기울임, 최대 푸시, 지연 허용, 정지 바퀴 토크 RMS 막대그래프.
- `results/figures/pi_gain_sweep.png` — upkie PI 게인 스케일(0.5~3배) 대비 최대 푸시: 게인을 올리면 푸시 내성은 0.25→1.0 W로 오르지만 정착시간은 8 s 가까이 그대로.
- `results/videos/plan{1,2,3}_*.mp4` — 10 s 데모(기립 → 0.6 W 푸시 → 0.6 m/s 주행 + 0.8 rad/s 선회 → 6 cm 웅크림 → 복귀).

### 4.3 60 s 장기 기립 (`results/bench/endurance_60s.json`, 노이즈 + 2 ms 지연, 명령 0)

| 변형 | 생존 | 피치 RMS [°] | 피치 최대 [°] | 58 s 동안 이동 거리 [m] | 바퀴 토크 RMS [Nm] |
|---|---|---|---|---|---|
| Plan 1 upkie PI | O | 0.42 | 2.2 | 0.21 | 0.101 |
| Plan 1 upkie MPC ① | O | 0.33 | 1.2 | **2.06** (3.4 cm/s 표류) | 0.021 |
| **Plan 2 DIABLO + LQI6** | O | **0.21** | **1.0** | **0.020** | 0.076 |
| Plan 3 DIABLO + upkie PI | O | 0.49 | 4.6 | 0.016 | 0.091 |
| Plan 3 DIABLO + upkie MPC ① | O | 0.21 | 0.9 | 0.31 | 0.020 |

Plan 1 MPC는 넘어지지 않지만 제자리를 지키지 못한다(바퀴 속도 명령 구조 + 남은 COM 오프셋 → 3.4 cm/s 표류; upkie에서는 조이스틱 사용자가 보정한다). Plan 3 MPC는 검토 반영(고관절 중력 보상·구속 강성) 후 표류가 5.9 m에서 0.31 m로 줄었다. LQI6는 속도 적분 상태가 있어 60 s에 2 cm만 움직인다.

### 4.4 해석

1. **구조가 성패를 가른다**(설계보고서 §5.3의 결론과 같다). 전상태 피드백(θ, θ̇, v, φ, φ̇, ∫v) + 토크 모드 + VMC인 Plan 2는 0.5 W 푸시를 1.7°에서 흡수하고 10° 기울임에서 0.36 s에 정착한다. upkie 계열은 피치·위치 PI가 바퀴 **속도** 명령을 만들고 kd = 1 Nm·s/rad의 무른 속도 루프가 그것을 따라가므로 진동이 크고 느리다.
2. **COM 오프셋에 대한 민감도**. upkie 균형기는 목표 피치 0이 고정되어 있어 COM이 접지점 위에 없으면(웅크림, 다리 질량, 적재물) 위치 적분으로만 보상한다 → Plan 1 PI는 2 cm 웅크림에서 넘어지지는 않지만 4.3° 피치 뒤 2.5 s 안에 정착하지 못하고(IMU 영점을 계단식으로 바꾸던 하네스 산물을 2차 검토에서 고친 뒤의 결과), MPC는 6 cm까지 가능(피치 4.0°). IMU 영점 보정(평형 피치 1.3°, 웅크림 시 1 s 시정수로 추종)이 없으면 MPC는 0.15 m/s 표류한다(각주 ②). Plan 2는 다리 길이별 평형 다리각 표(θ_eq(L0))로 이를 흡수해 6 cm 웅크림 중 피치 0.9°.
3. **지연 허용 30 ms vs 80 ms**: LQI6는 교차주파수가 높아 지연 허용이 30 ms다. 이는 MCU+CAN 경로(1~2 ms)에는 15배 여유지만, **균형 루프를 PC의 ROS 2 Python 노드에 두면(수십 ms 지터) 위험**하다는 뜻이다. DIABLO처럼 MCU에 두는 Plan 2/3 구조가 맞다. Plan 1을 ROS 2 노드로 돌릴 때도 균형기를 spine 노드 안에 두고(설계: `embedded_balancer: true`) 토픽 왕복은 명령·관측 발행에만 쓰는 것이 안전하다.
4. **요·링크 단절**: 세 플랜 모두 1 rad/s 요를 0.93~1.00으로 추종(REP-103 반시계 양수). Plan 2/3는 호스트가 죽으면 타임아웃까지 0.5 s 동안 마지막 명령대로 달린 뒤 제어권을 해제하고 정지(6 s 후 |v| ≤ 0.02 m/s).
5. **실시간성**: Python 1 kHz 루프 + MuJoCo가 실시간의 4~8배 속도로 돈다(라이브 뷰어는 1.0배로 페이싱). ROS 2 노드도 같은 코어를 쓰므로 PC 시뮬은 문제없다. 단, 시뮬은 제어기와 물리를 락스텝으로 돌리므로 GIL·스케줄링 지터는 반영되지 않는다(검토 C8).

---

## 5. 개발 중 발견해 고친 문제 (실기에서도 그대로 나타날 것들)

| 문제 | 증상 | 원인 | 수정 |
|---|---|---|---|
| 다리 벌어짐(split) 불안정 (Plan 2) | 1.5 s 뒤 왼/오른 다리가 −68°/+59°로 벌어지며 주저앉음 | LQI6는 양다리 **평균** 각만 제어 → 좌우 차 모드가 불안정 | anti-split PD (15 Nm/rad, 0.8 Nm·s/rad)를 고관절 토크에 ± 적용 (DIABLO `leg_split`, RM 로봇들의 다리 협조 제어와 동일) |
| 전진 표류 + 뒤로 기운 평형 (Plan 2) | 정지 명령인데 0.25 m/s로 흐르고 다리각 −4° | plant6는 다리 COM이 가상다리 선 위에 있다고 가정하지만 무릎-전방 5절 링크는 다리 질량이 앞에 있음 | MuJoCo 모델에서 다리 길이별 평형 다리각 θ_eq(L0)을 이분법으로 구해 LQI6 기준에 반영(−6.2°@0.12 m … −1.2°@0.26 m), 시작 자세도 평형 자세 |
| 요 추종 0.17 rad/s (Plan 2) | kp_yaw 0.6으로는 타이어 비틀림 저항을 못 이김 | — | 요 PI (2.5 Nm/(rad/s), 4 Nm/rad) → 0.98 |
| MPC가 즉시 전도 (Plan 1·3) | 0.1 s 만에 넘어짐 | upkie MPC는 접지 플래그가 없으면 출력 0; upkie 접지 판정은 겉보기 관성 방식이라 토크가 0인 정지 상태에서는 절대 켜지지 않음(교착). 실제 upkie는 낙하 착지 충격으로 시작 | MPC 변형은 시뮬 접촉 사용 + 1 cm 낙하 착지. **실기에서는 착지 충격 또는 상시 소토크 바이어스가 필요** |
| upkie PI 웅크림 전도 (Plan 1) | 6 cm 웅크림 중 피치가 서서히 커져 전도 | 목표 피치 0 고정 + COM 2 cm 전방 이동 → 위치 적분으로만 보상(~1 m 필요) | 구조적 한계로 기록(2 cm도 실패). upkie는 설계상 다리를 곧게 유지 |
| Plan 3 고관절 처짐 | 위치모드 고관절(kp 40 Nm/rad)이 하중에 3.6° 처져 COM 이동, 피치 −1.2° | 중력 보상 없음 | upkie 서보 API의 `feedforward_torque`에 VMC 정적 하중 토크 → 6 cm 웅크림 가능 |
| 요 부호 (Plan 1) | upkie 코드는 +yaw가 시계방향 | upkie 규약 | ROS REP-103(반시계 +)에 맞게 Plan 1에서 부호 반전 |

---

## 6. 한계와 주의

- 모터는 이상 토크원(한계·마찰·로터 관성만 반영). 전류 루프 지연, 코깅, CAN 지터, 엔코더 오프셋은 없다 → 실기 지연 여유는 2~3 ms 소비를 가정해야 한다(여유 30 ms 중).
- 타이어는 강체 실린더, 접촉은 MuJoCo soft contact(noslip 2). 미끄러짐·요 저항은 실제와 다를 수 있다(요 게인은 실기에서 재조정).
- DIABLO-lite의 질량 배분은 설계 가정값이다. 설계보고서 §4.6의 절차(질량·COM·관성 측정 → `plant6` 파라미터 교체 → 자동 게인)를 그대로 쓰면 된다. LQI6는 온라인 리카티라 파라미터만 바꾸면 게인이 따라온다.
- upkie 접지 판정기의 파라미터(liftoff/touchdown 관성 0.001/0.004, 최소 토크 0.015 Nm, 최소 가속도 2 rad/s², 컷오프 0.2 s)는 upkie `spine_backend.py`의 기본값이다. 시뮬에서는 바퀴 토크가 작아 첫 접지 판정까지 약 0.7 s가 걸린다.
- 35°·40° 기울임 실패는 바퀴 토크 한계 때문이며 제어기 한계가 아니다(1.7 Nm upkie, 5 Nm DIABLO-lite).
- CAR 모드(앉기/일어서기 변신)는 DIABLO의 보조 바퀴가 없는 lite 모델에서 물리적으로 모델링하지 않았다(상태기계·다리 램프만 구현).
- **ROS 2 패키지는 작성만 되었고 빌드·실행은 우분투에서 검증해야 한다.**

---

## 7. 추천: Plan 2, 그리고 보완점

**Plan 2를 추천하는 이유**
1. 성능: 4절의 모든 지표에서 1위이고 차이가 크다(푸시 3~10배, 10° 복귀 정착 2~5배 빠름, 0.5 W 푸시 피치 1/6~1/8, 주행 중 피치 1/4~1/9).
2. 아키텍처: DIABLO 방식(실시간 보드가 균형, ROS 2는 명령·텔레메트리)은 PC/ROS가 죽어도 서 있고, 지연 허용 30 ms를 MCU+CAN 1~2 ms로 15배 여유 있게 쓴다. 설계보고서의 Teensy 4.1 + CAN 토크 모드 계획과 그대로 맞물린다.
3. 재사용성: LQI6는 모델 파라미터에서 게인을 자동으로 얻으므로 질량이 바뀌어도(5~10 kg) 손튜닝이 없다. 설계보고서 §8에서 5개 플랜트에서 검증된 결과와 이번 5절 링크 전체 모델 결과가 일치한다.
4. 호환성: DIABLO의 `motion_msgs`/`ception_msgs`·토픽 이름을 그대로 쓰면 DIABLO용 teleop·SLAM 스택(`autonomy_stack_diablo_setup` 등)을 거의 수정 없이 붙일 수 있다.

**Plan 2에 upkie에서 가져올 것(이미 코드에 있음)**: 접지 판정·바퀴 오도메트리 관측기(공중/착지 처리), 서보 명령 추상화(position/velocity/feedforward_torque/kp·kd scale/maximum_torque — moteus·RMD·ODrive 어댑터 공통), URDF 명명 규약과 `upkie_description`식 패키지 구조, 라이브 뷰어/벤치마크 워크플로.

**Plan 1을 택할 이유가 있다면**: 검증된 하드웨어 설계(BOM·조립 문서·spine 펌웨어)를 그대로 쓰고 싶을 때. 대신 qdd100×4 + moteus 구성은 설계보고서의 RMD-L 구성보다 3배가량 비싸고, 균형 성능은 위 표대로다.

**Plan 3을 택할 이유**: 없음. 같은 하드웨어에서 Plan 2가 상위 호환이다.

**하드웨어 함의(Plan 2)**: 고관절 토크는 벤치마크 최대 3.5 Nm(30° 복귀)·정적 2.4 Nm → 12 Nm 한계는 여유. 바퀴는 30° 복귀에서 3.3 Nm, 2.5 W 푸시에서 5 Nm 포화(3 W는 실패) → 설계보고서의 RMD-L-9015(5 Nm 피크) 선정과 일치. 다리당 동축 고관절 모터 2개는 9015/7015급으로 충분(평행사변형이라 정강이 토크가 고관절 축에 걸림).

---

## 8. 우분투에서 할 일 (다음 단계)

1. Ubuntu 24.04 + ROS 2 Jazzy 설치, `pip install -e wheeled_biped`(venv `--system-site-packages`), `colcon build`(`ros2_ws/README.md`).
2. Plan 2 시뮬 런치: `ros2 launch diablo_lite_bringup sim.launch.py balancer:=lqi6` → `ros2 topic hz /diablo/sensor/Imu`, teleop(`diablo_lite_ctrl teleop_node`, DIABLO 키맵) 및 `/cmd_vel` 브리지 확인, rviz2에서 URDF·TF 확인.
3. Plan 1: `ros2 launch upkie_bringup sim.launch.py balancer:=pid embedded:=true` 와 `embedded:=false`(토픽 경유)를 비교해 **ROS 2 경유 지연이 지연 허용(40 ms)의 몇 %인지 측정**.
4. Plan 3: 같은 런치에 `balancer:=upkie_pid`.
5. (선택) Isaac Sim 5.x에서 `models/diablo_lite/diablo_lite.urdf`를 불러 ROS 2 브리지로 같은 MCU 노드를 연결해 교차 검증. 5절 링크 폐루프는 Isaac에서 `fixed joint`/`mimic`으로 흉내 내야 하므로 MuJoCo 결과가 1차 기준이다.
6. 실기 전: 설계보고서 §4.6 절차(파라미터 측정 → `plant6` 교체 → 매달기 테스트 → 저게인 착지).

---

## 9. 재현

```bash
cd my_robot_project/wheeled_biped
python -m wbr.models.build_upkie && python -m wbr.models.build_diablo_lite
python -m unittest discover -s tests          # 83 tests
python -m wbr.bench.run_bench                 # results/bench/summary.md (약 15 s, 16 프로세스)
python -m wbr.bench.plots                     # results/figures
python -m wbr.bench.video --plan 2            # results/videos/plan2_lqi6.mp4
python -m wbr.viewer.live --plan 2            # 라이브 뷰어 (방향키 주행, P 푸시, H/J 높이, T 10° 기울임, R 리셋)
```

---

## 10. 독립 검토(Opus 5.5, xhigh) 반영 내역 — 2026-10-22

`docs/review_opus.md`에 전체 검토 보고서가 있다(critical 0, major 7, minor 다수). 반영한 수정과 그 영향:

| ID | 내용 | 수정 | 영향 |
|---|---|---|---|
| B1 | LQI6 설계 플랜트의 몸체 피치 관성에 MuJoCo `body_inertia`의 **요 축 값(0.038)** 을 썼음(주관성 프레임이 x축 90° 회전) | base 프레임으로 회전해 Iyy = 0.0234 사용 | 게인 소폭 변화(K_T φ항 3.37→2.93); 성능 차이는 작다(재실행 표 4.1: 푸시 2.5 W, 10° 정착 0.36 s) |
| B2 | 호스트 에뮬레이터가 명령 객체를 참조로 넘겨 "죽은 호스트"의 명령이 MCU에 새어 들어감 → 링크 단절 시험이 끊긴 순간부터 감속 | 패킷을 복사본으로 전달 | 링크 단절 시 타임아웃 전 0.5 s 동안 0.5→0.59 m/s로 계속 주행 후 해제·정지(6 s 후 −0.006 m/s). 결론 동일 |
| B3/C4 | DIABLO 모드 패킷 `stand_mode=false`(teleop의 v/b/n/m 키) 하나로 보조 바퀴 없는 lite 로봇이 주저앉아 전도 | MCU에서 transform down 거부(`allow_transform_down=False`), 데이터클래스 기본값을 ROS 메시지와 일치 | teleop 호환 경로 안전 |
| B4 | 설계보고서 §4.5 안전 규정 미구현(FAULT 뒤에도 다리 힘 유지, arm 조건 없음) | FAULT/비무장 시 6관절 토크 0, `arm()`은 \|피치\|<3°일 때만, 링크 단절 후 모터 OFF 시간 옵션(`disconnect_off_s`, 기본은 DIABLO처럼 계속 균형) | 실기 안전 |
| B5/B6 | 비균형 구간 적분기 windup, 1 kHz 루프 안 온라인 DARE(0.6~1.7 ms, 예외 미처리) | 비균형 시 적분기 초기화, 포화 시 조건부 적분, 다리 길이 격자 게인 표 사전계산+보간(설계 실패 시 마지막 게인 유지) | MCU 이식 가능한 구조 |
| B7 | 평행사변형 폐루프 구속이 물러 하중 시 1.7° 어긋남 | `connect` solref 1 ms, solimp 0.99 | 기립 하중 잔차 2.7 mm → 0.00 mm |
| B8/B9/B10/B11/B13 | 롤 P 제어 43% 정상상태 오차, 끊김 시 속도모드 입력 유지, F_ff·cosθ, 동체 자이로를 요레이트로, L0 0 나눗셈 | 롤 기하 피드포워드+PI(0.1 rad 명령→0.106), 끊김 시 속도모드 입력 0, F_ff/cosθ, 월드 요레이트, 가드+NaN 검사 | 정확도·강건성 |
| A1 | upkie `BaseOrientation` 포팅에 ARS→world·IMU 장착 회전이 없어 실제 Upkie IMU에서 피치가 틀림 | upkie 기본 회전(diag(−1,1,−1), diag(1,−1,−1))을 기본값으로, 시뮬은 항등 행렬을 명시 | 실기 경로 |
| A3/A4/A5/A6 | 모델 피치 영점·진실 접지(MPC)·속도 노이즈 σ·접지 파라미터 "추정값" 서술 | `pitch_offset` 옵션(웅크림 시 재계산), 각주 ①②, 1절 노이즈 서술 수정, `min_touchdown_torque` 0.015(upkie `spine_backend` 기본값) | 비교의 투명성 |
| A7/A8/A9/A10 | 저역필터 Nyquist 위반 묵인, gyropod 요 부호 조합 함정, 로그 시간축, MPC 회전 시 다리 게인 | `ValueError`, 바퀴별 차동 형태로 재작성, `sim.time` 사용, 2+2 스케일 | 정리 |
| C1 | ROS Plan 1 경로(spine 내장·balancer_node)에서 **요 방향 반대** | `Plan1Upkie.control_step()`를 두 노드가 공용(요 부호 한 곳), balancer_node `yaw_sign` 파라미터 | REP-103 준수 |
| C2 | `embedded:=false balancer:=mpc`가 접지 플래그 없이 전도 | launch에서 해당 조합에 `use_sim_contact:=true` | README 명령 동작 |
| C3 | `mcu_node`가 1 ms 안의 연속 패킷을 하나로 합쳐 모드 명령(teleop `z`) 유실 | 패킷 큐(순서 보존), 모드 패킷 즉시 적용 | DIABLO teleop 호환 |
| C5/C6/C7 | `/cmd_vel` 타임아웃 기본 0, 외부 균형기 시작 전 주저앉음·리셋 킥, `LegMotors` pos/enc_rev 이중 계산 | 기본 500 ms, 첫 명령 전 시뮬 정지·오도메트리 점프 시 균형기 재초기화, DIABLO 규약(한 바퀴 안 각 + 회전수) | 안전·호환 |

반영 후 단위 테스트 16개 통과, 벤치마크 재실행 결과는 4절 표에 반영했다(Plan 2의 결론·순위 변화 없음). 아직 반영하지 않은 항목: B12(플랜트 armature·다리 COM 단순화 — 6절에 명시), B14(`leg_split`/jump/split 미지원 — README에 명시), C8(락스텝 시뮬이라 실시간 효과 미반영 — 8절 3번 측정으로 보완), C9·C11·C12(nit).

### 10.1 2차 검증 (Opus 5.5 xhigh, `docs/review_opus_pass2.md`)

1차 지적의 반영 여부를 코드·수치로 재검증한 결과: 검증 대상 29건 중 26건 VERIFIED, 3건 PARTIAL(문서 문장·arm 게이트·C10 파라미터), **NOT FIXED·REGRESSION 없음**. 1차 리뷰의 A1 심각도는 정정됐다(upkie 기본 회전을 빼도 피치·피치율은 불변이고 롤·요 성분만 뒤집힘 → minor). 2차에서 새로 지적된 것과 반영:

| ID | 내용 | 반영 |
|---|---|---|
| N1 | arm 게이트가 측정 전(리셋 직후 pitch=0)에도 통과 | `est_valid` 플래그: 첫 추정 전·링크 OFF 래치 중에는 arm 거부 |
| N2 | `disconnect_off_s>0`이면 연결된 적 없이도 부팅 즉시 OFF, arm/disarm 1 kHz 반복 | 한 번이라도 연결된 뒤에만 카운트, OFF 래치, 호스트 복귀 시 래치 해제·재arm |
| N3 | 웅크림 시 IMU 영점이 1.3°→−4.2°로 계단 변화해 Plan 1 PI가 4 cm에서 전도 | 영점을 다리 필터와 같은 1 s 시정수로 추종 → Plan 1 PI가 2/4/6 cm 웅크림에서 생존(표 4.1 갱신) |
| N4 | `settle_time` 0 패딩이 끝까지 1°를 넘는 신호를 "정착 7.99 s"로 보고 | 가장자리 값 복제 패딩 → 미정착으로 정확히 보고 |
| N5/C10 | spine의 `pitch_offset` 파라미터 부재 | `spine_node` 파라미터·`spine.yaml` 추가 |
| N7/N8/N9 | 낡은 문서·주석, Plan 3 MPC 회전 시 다리 게인 고정, `_down_refused` 미초기화 | 수정 |
| `start_mode: car` | lite 로봇은 CAR 자세가 없어 0.6 s에 FAULT | `mcu_node`가 `car`를 거부(명시적 오류) |
| 미반영 | 드라이버 피드백 50 ms 타임아웃(실기 펌웨어 항목), N6 오도메트리 0.1 m 안 리셋 감지, N10 조건부 적분의 근사 포화 판정 | 실기 단계에서 처리 |

단위 테스트 20개 통과(arm 게이트, OFF 래치, settle_time, Plan 1 4 cm 웅크림, 게인 표 5점 추가).

각주 ① MPC 변형(Plan 1·3)은 시뮬 진실 접지 플래그를 쓴다. upkie 접지 판정기는 바퀴 토크가 있어야 켜지므로 정지 상태에서 MPC 출력 0과 교착한다(실기에서는 착지 충격이나 "시작 시 접지 가정" 상태기계가 필요). ② Plan 1은 모델에서 계산한 평형 피치(1.3°)를 관측 피치에서 뺀다(실기의 IMU 영점 보정에 해당, upkie 순정 코드에는 없음). 이 보정 없이 돌리면 MPC 변형은 0.15 m/s로 표류한다.

---

## 11. Plan 4 — 최종 확정안: upkie 하드웨어 + LQI6 + 호스트/MCU 분리 (2026-10-22~23)

### 11.1 배경과 정의

사용자는 설계 파일(FreeCAD)이 있어 제작 가능한 upkie 기구를 쓰기로 하고, 제어는 Plan 2에서 검증한 LQI6와 DIABLO식 호스트/MCU 분리를 가져오는 **Plan 4 = upkie 모델(직렬 무릎 다리) + LQI6 + 호스트/MCU 분리**를 최종안으로 확정했다. 상위에 호스트 MPC 기준 생성기를 두는 것은 2단계다. 1~3절의 세 플랜 비교는 그대로 유효하며, Plan 4는 "Plan 2의 제어 구조를 upkie 기구에 올린 것"이다. 플랜트는 5절 평행사변형 가정을 쓰지 않고 upkie 기구학으로 다시 유도했다(`docs/plan4_model.md`). 합격 기준은 사용자가 정한 `docs/합격기준.md`를 따른다.

### 11.2 모델 (요약, 상세는 `docs/plan4_model.md`)

- 직렬 다리 L1 = 0.168 m, L2 = 0.175 m. 가상 다리(엉덩이→바퀴축)의 길이·각도를 상태로 쓰고, VMC로 가상 다리 힘·토크를 엉덩이·무릎 토크에 사상한다. upkie 관절은 좌우 거울상이라 부호 어댑터를 둔다.
- 3체(바퀴·다리·몸체) 라그랑지안을 직렬 구조로 유도. 다리 집중 파라미터(질량 2.18 kg, 무게중심 높이·전방 오프셋, 관성)는 L0마다 MuJoCo에서 계산한 표를 쓴다. 엉덩이 토크가 몸체–허벅지 관절 q_hip = θ + φ에 걸리는 점, 엉덩이 로터 아마추어(q̇_hip), 바퀴 로터 아마추어·감쇠(바퀴 관절 속도 ẋ/R − θ̇; 검토 1라운드 m9에서 절대 회전에 붙였던 것을 고침), 관절 점성 감쇠를 반영했다.
- 서는 자세 L0 = 0.31 m(무릎 51°, 무릎 앞), 평형 다리각 −3.48°, 정적 엉덩이 토크 −0.314 Nm. 개루프 불안정 극 6.13 / 9.77 rad/s.
- MuJoCo 대조(`mjd_transitionFD`, 무릎 잠금, 대조용 강성 접촉): L0 = 0.25~0.33에서 불안정 극 오차 ≤ 0.06 % / ≤ 0.02 %, 입력 행렬 오차 노름 바퀴 ≤ 0.24 %·엉덩이 ≤ 0.03 %(성분별 ≤ 0.34 %), 정적 엉덩이 토크 1 % 안, 3° 개루프 응답 0.3 s rms 오차 θ 0.03°·φ 0.12°(0.31). 대조 과정에서 관절 건마찰·noslip이 선형화를 가리는 것을 확인하고 끈 뒤 비교했고, 검토 1라운드(M5·m9·m10) 뒤 아마추어 처리와 접촉 임피던스를 고쳐 표를 다시 만들었다(이전 표: 빠른 극 3 %, B 성분 7 %, 정적 토크 7 %).

### 11.3 하드웨어 발견: 타이어 반경과 발목 하우징

upkie_description의 타이어 충돌 반경은 0.05 m인데, 발목 모터 하우징(ankle_stator 박스 92×68×56 mm)의 최저점이 선 자세에서 바닥 위 3.5~10 mm다. 이 모델로는 L0 = 0.31에서 앞으로 **7°** 기울면 하우징이 바닥에 닿고, 4 cm 웅크린 0.27 m에서는 수직 자세에서도 닿는다. 실제 upkie BOM은 112 mm RC 타이어(R = 0.056)이고 스파인 설정은 0.06 m를 쓴다. BOM 값으로 Plan 4 전용 모델 `models/upkie_plan4`를 만들면 한계가 앞 32°·뒤 40° 이상으로 늘어난다. Plan 1~3 결과는 기존 모델(0.05)로 낸 것이어서 그대로 두었다. **실기 구매 시 112 mm 타이어가 필수**이고, 100 mm를 쓰면 기울기·웅크림 여유가 거의 없다.

### 11.4 제어기 설계와 튠에서 배운 것 (상세는 `docs/plan4_lqi8.md`)

- LQI6 상태·구조는 Plan 2와 같다. 게인은 11.2의 A(L0), B(L0)에서 L0 격자별로 설계해 표로 두고 보간한다. 평형 다리각 θ_eq(L0)과 정적 엉덩이 토크를 피드포워드한다. 1 kHz와 200 Hz(upkie 에이전트 주기) 모두 지원한다.
- **다리 힘 피드포워드**: 질량 없는 다리 VMC에 로봇 전체 무게를 넣으면 다리가 7 mm 과신장된다. 몸체 무게 + 다리 무게의 c/L0(≈42 %)로 18.2 N/다리가 맞다.
- **관절 건마찰 헌팅**: 모델의 엉덩이·무릎 0.1 Nm, 바퀴 0.02 Nm 쿨롱 마찰이 속도 적분과 만나 8~10 s 주기의 x 왕복(±3 cm)과 피치 왕복을 만든다(노이즈를 전부 꺼도 남고, 마찰을 끄면 사라짐). 명령 토크 부호로 보상하면 정적 엉덩이 토크 때문에 한쪽으로만 보상되어 효과가 없고, **의도한 운동 방향(Tp − Tp_ff, 바퀴는 T)의 부호**로 보상해야 줄어든다(피치 rms 0.15→0.08°, x 이탈 3.3→2.5 cm).
- **요가 다리 벌어짐으로 새는 문제**: upkie의 가벼운 직렬 다리는 anti-split PD 15 Nm/rad(Plan 2 값)로는 묶이지 않아, 차동 바퀴 토크가 몸체를 돌리지 않고 두 다리를 앞뒤로 벌렸다(다리각 좌우 +19°/−26°, 요 속도 0). 60 Nm/rad·3 Nm·s/rad로 올리면 1 rad/s 명령에 0.99 rad/s를 낸다.
- **속도 기준 성형**: LQI6 속도 루프는 저감쇠라 스텝 오버슈트가 31~35 %였다. 가속 피드포워드는 비최소위상 특성 때문에 악화(47 %)된다. 램프 2 m/s² + 가속 시에만 0.3 s 1차 선필터 + 램프 중 적분 동결로 오버슈트 7~13 %, 90 % 상승 1.14~1.25 s, 정지 최대 이탈 0.21~0.24 m(끝점 0.08 m), 링크 끊김 후 정지 2.1~2.4 s가 된다(전체 매트릭스, 검토 1라운드 반영판).
- 바퀴 모터(1.7 Nm)가 병목이어서 LQR 가중을 바퀴 토크 벌점 r_wheel 0.2, 엉덩이 r_hip 0.3, 적분 q_int 0.2(위치 적분 q_pos 0.5, 자세 적분 q_att 0.2)로 두었다(10° 기울기 복귀 바퀴 피크 최악 1.32 Nm ≤ 1.36).
- 합격 판정의 피치는 시뮬 실제 피치를 쓴다(추정 피치에는 0.2° 센서 노이즈가 섞임). 리셋 과도(0.05 s에 1° 피크)는 2 s 제외.
- **검토 1라운드 반영(2026-10-23, `docs/review_plan4_r1_response.md`)**: 마찰 보상에 피치 속도 게이트(정지 보조로만 작동; 1 kHz 12 ms 지연의 한계 사이클 제거), MCU 센서 가드(비유한·정지 표본 → 유지 뒤 FAULT, 롤 FAULT), upkie 스파인 IMU 관례(ARS 좌표·180° 장착) 어댑터를 MCU에 두고 시뮬이 그 좌표계로 표본을 내보냄, 바퀴 로터 아마추어·감쇠를 관절 속도에(게인 2~3 % 변화), 타이어 condim 4, 판정 정의 정밀화(최대 이탈·정착 유지 1 s·모터별 rms·생존 항목 시드 5개·11번 3 s 순항 뒤 끊김·15번 강건 여유 기록·24번 기록 항목). 지연 여유의 실제 값: 노이즈·낙하·밀기 조건에서 1 kHz 12 ms, 200 Hz 15 ms(기준 시험 3° 무노이즈로는 20/25 ms).
- **바퀴 떨림(사용자 지적, 2026-10-23)**: 뷰어에서 바퀴가 미세하게 떨리고 조금씩 움직였다. 원인은 두 가지였다. (a) 14-bit 엔코더를 1 kHz 한 스텝으로 미분한 속도의 양자화 노이즈(±0.38 rad/s)가 LQI6의 θ̇·L̇0 게인을 거쳐 바퀴 토크 노이즈(rms 0.096 Nm)와 엉덩이 토크 교류 성분(0.62 Nm)이 되어 바퀴가 떨렸다(베이스 고주파 속도 rms 6.1 mm/s). MCU가 양자화 위치를 **5 ms 창으로 차분**해 속도를 만들면(노이즈 1/5, 지연 +2.5 ms) 토크 노이즈가 0.033 Nm, 고주파 속도가 1.0 mm/s로 줄고, 튠 당시 벤치의 지연 허용치 15 ms는 유지됐다(현재 값: 벤치 20 ms, 15번 기준 시험 20/25 ms, 강건 여유 12/15 ms — 11.5·11.6절). (b) 8~10 s 주기 ±2 cm의 느린 왕복은 저감쇠 느린 모드(속도 적분 = 위치 강성, 속도 피드백 = 감쇠)가 피치 노이즈와 잔여 건마찰로 흔들리는 것이라 q_v를 1.0→0.5로 낮춰 감쇠를 올리고(r_wheel 0.25), 왕복은 1.5~2 cm로 남는다. 토크 노이즈가 디더 역할을 하고 있었기 때문에 속도 필터만 넣으면 건마찰 헌팅이 다시 커지며(피치 rms 0.06→0.14°), 마찰 보상(엉덩이 0.08·바퀴 0.016 Nm)과 함께 써야 한다. 이 조합은 경사 5° 정지 이동도 10.6→7.2 cm로 개선해 기준(10 cm)을 통과시킨다.

### 11.5 표준 벤치마크 행 (4.1절과 같은 조건: 노이즈 + 2 ms 지연)

| variant | 기울기 정착/생존 [°] | 밀기 정착/생존 [×W] | 지연 허용 [ms] | 정지: 피치 rms / 드리프트 / 바퀴 rms | 10° 정착 [s] / 변위 [m] | 0.5 W 밀기 피치 [°] / 정착 [s] | 0.8 m/s 스텝 상승 / 오버슈트 / 피치 | 요 | 웅크림 | 링크 끊김 | RT |
|---|---|---|---|---|---|---|---|---|---|---|---|
| plan2_lqi6 (DIABLO-lite, 5 Nm 바퀴) | 30 / 30 | 2.50 / 2.50 | 30 / 30 | 0.21° / 0.008 m / 0.073 Nm | 0.36 / 0.01 | 1.7 / 2.83 | 1.16 s / 22 % / 2.1° | 1.00 | 6 cm (0.9°) | O / 0.01 | 5.6 |
| **plan4_lqi6 (upkie, 1.7 Nm 바퀴, 1 kHz, 검토 2라운드 반영판)** | 25 / 25 | 1.50 / 1.50 | 20 / 20 | 0.23° / 0.018 m / 0.037 Nm | 1.42 / 0.03 | 3.2 / 1.83 | 1.35 s / 6 % / 2.4° | 1.00 | 6 cm (1.1°) | O / −0.02 | 2.7* |
| plan4_lqi6_200hz (검토 2라운드 반영판) | 25 / 25 | 1.75 / 1.75 | 20 / 20 | 0.22° / 0.007 m / 0.040 Nm | 1.37 / 0.02 | 3.4 / 1.80 | 1.35 s / 7 % / 2.7° | 1.00 | 6 cm (1.0°) | O / −0.02 | 8.1* |

\* RT 배율은 다른 작업과 동시에 돌려 낮게 나온 값(이전 단독 측정 3.6 / 13.1). 행은 최종 코드(`results/bench/summary.md`, 07:17)로 다시 만든 것이다.

해석: 합격 판정용으로 튠한 최종 제어기(위치 강성·바퀴 벌점·5 ms 속도 창·마찰 보상·위치 적분)는 극한 강건성을 일부 내주었다: 최대 기울기 30 → 25°, 최대 밀기 2.5 → 1.5 W(1 kHz)·1.75 W(200 Hz)(튠 전 첫 행은 30°·2.5 W였다). 합격 기준(20° 생존, 1.0 W 생존)은 유지되고, 속도 스텝 오버슈트는 Plan 2의 22 %에서 6~7 %(벤치 0.8 m/s 스텝; 합격 판정 0.5 m/s 스텝은 7~13 %)가 됐다. 10° 정착이 Plan 2(0.36 s)보다 느린 1.4 s인 것은 바퀴 토크가 5 Nm→1.7 Nm로 줄어 가속 여유가 작기 때문이다. 정지 바퀴 토크 rms는 0.095 → 0.037 Nm(바퀴 떨림 수정). **지연 허용치(벤치 정의) 20 ms는 Plan 2(30 ms)보다 낮다**; 합격 판정 15번(3° 무노이즈)은 1 kHz 20 ms(기준 25 미달)·200 Hz 25 ms(충족), 강건 여유는 12/15 ms다(11.6). 200 Hz 행은 2 ms 지연이 0스텝으로 양자화되어 지연 없이 돈 것이라 두 행을 같은 조건으로 비교할 수 없다(합격 판정은 10 ms = 1 kHz 10스텝·200 Hz 2스텝으로 동일).

### 11.6 합격 판정 (1단계, `docs/합격기준.md`, 전체 매트릭스 9조합 × 5시드 × 2주기)

결과 표와 분석은 `docs/plan4_lqi8.md` 0·3·4절, 원본은 `results/acceptance/plan4_<rate>Hz.md|json`.

| | 1 kHz | 200 Hz |
|---|---|---|
| 필수 통과 | **1~13·16·17(15/15)** | **1~13·16·17(15/15)** |
| 16·17(드리프트 ≤ 10 cm, 합격기준 6.3) | 16(IMU 바이어스 +1°): max \|x(t) − x(0)\|, t ≥ 2 s 7.2 cm(×0.72), 17(페이로드 0.3 kg): 8.6 cm(×0.86) | 16: 7.3 cm, 17: 8.7 cm |
| 기록 15(지연 허용, 3° 무노이즈 / 강건 여유) | 20 ms(기준 25 미달) / 12 ms | 25 ms / 15 ms |
| 가장 빠듯한 통과 | 10° 기울기 바퀴 피크 1.32/1.36 Nm(×0.97), 경사 주행 도달 1.38/1.5 s(×0.92) | 경사 주행 도달 1.41/1.5 s(×0.94), 바퀴 피크 1.29/1.36(×0.95) |

검토 3라운드 반영판(캐시 태그 `r5_s1`, 코드 해시 345db37b94; **종합 합격**). 시뮬 수치는 2라운드 반영판 `r4_s1`과 1,170/1,170회 비트 단위로 같고(3라운드는 판정 코드·가드·테스트만 바꿨다), 16·17은 사용자가 위임한 결정(합격기준 6.3: 드리프트 기준점 x(0)·탐색 t ≥ 2 s, 한계는 12번과 같은 10 cm)으로 통과했다. `r4_s1`은 1라운드 반영판 `r3_s1`과 1~7·10·12·15~17은 같고 8·11·13은 2단계 2라운드 m4의 적분기 동결 유지 0.1 s가 1단계 z2 동결에도 적용되어 판정 지표가 최대 2.2 % 바뀌었다(판정 불변; 3라운드 검토 m2 — 전 판의 "같다"는 서술은 틀렸었다). 1라운드 전에 1 kHz에서 실패했던 6번(밀기 0.75 W, m×0.85·μ ≥ 0.75, 10/45회, 바퀴 rms 0.22 Nm; 1라운드 전 문서는 3/45회로 잘못 적었다 — 검토 M4)은 마찰 보상의 피치 속도 게이트 덕에 통과한다(최악 0.12 Nm; 게이트만 끄면 0.21 Nm로 다시 실패 — 2라운드 검토 m2). 16·17은 일정 외란에 대한 위치 루프 강성 한계로, 강성을 더 올리는 모든 조합이 10° 기울기 바퀴 여유·저마찰 15° 복귀·1 kHz 안정성을 깨뜨린다(최선 6 cm). 5 cm 기준이었다면 45/45회 실패(x(0) 기준 6.0~8.7 cm)다; 선택지(기준 10 cm, 실기 기동 시 무게중심·IMU 보정, 바퀴 모터 상향) 가운데 10 cm(12번과 같은 일정 외란 부류)와 실기 보정 절차(HANDOFF 2.1 12번)를 택했다(`docs/plan4_lqi8.md` 4.1, 합격기준 6.3). 참고 열의 upkie 기본 PI 제어기는 같은 하드웨어에서 10° 기울기도 정착하지 못하고 0.75 W 밀기에 넘어진다(`docs/plan4_lqi8.md` 3.3절).

### 11.7 2단계: 호스트 MPC 기준 생성기 (`docs/plan4_mpc_host.md`)

- 구조: 50 Hz 호스트, 1.5 s 구간 75단 QP(qpmpc 응축 + DAQP, OSQP 백업 10 ms 제한). 출력은 속도·요·높이 기준뿐(피치·롤 기준 없음), 적분기 없음.
- 내부 루프(MPC 모드): MCU LQI6가 플레인 추종하되 **기준이 가속하는 동안 적분기 전부 동결**(검토 1라운드 뒤). 예측 모델은 그 영역의 **적분기 없는 폐루프**의 선형 축약(플랜트 선형화 + LQI6 이득표 앞 5열 + 10 ms 지연 → 20 ms 리프팅 → 균형 절단 1 kHz 4차·200 Hz 5차; 속도 스텝 rms 오차 5.0~5.4 %, 실측 피치 피크가 모델의 1.18~1.29배).
- 제약: 속도 1 m/s, 가속 0.889/0.884 m/s²(19번 피치 예산 1.5°를 모델 오차 계수 1.3으로 나눈 값이 결정), **제동 1.17배**(로봇 진행 방향과 반대인 가속도; 순항 중 몸체가 마찰을 이기려 앞으로 기울어 있어 제동 피치가 작음; 2라운드 검토 뒤 넘김 시간 1.0 s와 함께 격자에서 고른 값), 저크 a_max/0.10 s, 다리 길이는 통과값 클립. 텔레메트리 보정은 기동 중과 정지 뒤 1.0 s까지, 혁신 0.1 m/s 게이트, 목표 데드밴드 0.02 m/s.
- 호스트/MCU 인터페이스: `MotionCtrl.host_shaped` 플래그(MCU 성형 ↔ 플레인 추종), MCU 텔레메트리 `v_ref`로 무충격 재동기, QP 실패 → 원시 목표 + 플래그 거짓, 복귀 조건(1 s, |a| < 0.05, |v − v*| < 0.1).
- 결과(전체 매트릭스, 캐시 `r5_s2`, 검토 3라운드 반영판, 코드 해시 345db37b94): 두 주기 모두 **19·20·21·22·23 통과**, 1단계 항목도 전부 통과 → **종합 합격**. 19번 최악: 피치 1.90°/1.98°(m×1.15), 오버슈트 2.7/4.3 %, 90 % 도달 1.10/1.08 s, 정지 최대 이탈 0.296/0.297 m(×0.99, m×0.85). 1라운드 반영판에서 200 Hz 19번이 0.03~0.04 % 넘었던 것은 "물리적 한계"가 아니라 튜닝 문제였다(2라운드 검토 M1): 넘김 시간 0.5 → 1.0 s(정지가 끝날 때까지 예측·보정 유지)와 제동 계수 1.3 → 1.17을 격자에서 골라 통과시켰고 여유는 여전히 1~5 %다. 3라운드 반영으로 넘김은 "1.0 s 이상 그리고 텔레메트리 속도 < 0.05 m/s(최대 3 s)"가 되어 0.8~1.0 m/s 정지의 패킷 위반(3/2건)이 사라졌고 0.5 m/s 정지의 판정 지표는 그대로다. 20번은 항목 기준으로 회귀 0이지만 지표별로는 8·13번 정지 최대 이탈이 ×0.47 → ×0.59(26~27 %)로 나빠진다 — MPC가 19번의 피치 2°를 지키느라 1단계 램프(2 m/s² 제동, 피치 5° 기준)보다 부드럽게 멈추기 때문이며, 비교 단위는 사용자 결정으로 항목 기준 유지(합격기준 6.4). QP p99 0.33/0.31 ms(벽시계, 실행마다 10~17 % 다름), 위반 0(QP 자기 검사와 송신 패킷 독립 검사 모두), 기동 중 일시 실패 뒤 복귀 확인.
- 1라운드 전 판(정지 거리 끝점 0.07 m, 피치 1.65°)은 끝점 정의가 0.2 m 되돌아감을 숨긴 것이었고, 적분기 동결로 되돌아감이 0.04~0.07 m가 된 대신 최대 이탈이 기준에 닿는다.

### 11.8 독립 검토 라운드 (Opus 5.5)

검증 라운드 결과는 `docs/review_plan4_r<n>.md`(1단계)·`docs/review_plan4_mpc_r<n>.md`(2단계), 반영·반박·보류 표는 `docs/review_plan4_r<n>_response.md`.

**1라운드(2026-10-23, Opus 5.5 ×2, 독립)**: 1단계 major 5·minor 13·nit 8, 2단계 major 5·minor 11·nit 7. 재현성은 두 단계 모두 비트 단위로 확인됐고, major는 (1단계) 지연 여유 과대 보고, NaN 표본의 적분기 오염, IMU 관례 어댑터 부재, 문서의 6번 건수 오기, 모델 대조 수치의 재현 불가; (2단계) 텔레메트리 보정이 LQI6 적분기와 싸움, 일시 QP 실패 뒤 복귀 불가, 정지 거리 끝점 정의, 예측 모델의 z_att 게이팅 누락, 재현되지 않는 수치였다. 전부 반영했고(반박 1건: 지연 한계의 주원인은 마찰 보상이 아니다 — 2라운드가 5 ms 속도 창 지연으로 특정; 보류 3건: 3·6번 포화 허용 해석, 정지 거리 해석, 15번 강건 여유의 기준 편입은 사용자 결정), 그 과정에서 2단계 내부 루프(기동 중 적분기 동결)와 예측 모델(적분기 없는 루프), 가속·제동 한계(피치 모델 오차 계수 1.3, 비대칭 제동, 저크 0.10 s)를 다시 설계했다.

**2라운드(2026-10-23, Opus 5.5 ×2, 새 에이전트)**: 1단계 major 2·minor 8·nit 14(`docs/review_plan4_r2.md`), 2단계 major 3·minor 9·nit 6(`docs/review_plan4_mpc_r2.md`). 재현성 비트 단위 확인, 1라운드 major 10건 중 7건 해결·3건 부분 해결 판정. 새 major: (1단계) 엉덩이·무릎 위치 NaN 1표본에 VMC가 원시 관측을 써서 즉시 FAULT·전복, 호스트 MotionCtrl 값 무검증(NaN 패킷으로 균형 루프 개방); (2단계) "19번 200 Hz 실패 = 물리적 한계" 결론의 반증(넘김 시간 1.0 s + 제동 계수 1.15~1.2로 통과), 20번 비교 단위(항목 vs 지표) 해석이 사용자 결정 항목에 없음, 서술 수치 불일치. 전부 반영했다(`docs/review_plan4_r1_response.md` 2라운드 절): VMC는 마지막 유효 서보 표본 사용, 링크가 비유한 패킷 거부, 넘김 1.0 s·제동 1.17, 20번 행에 지표별 악화 기록 + 사용자 결정 항목 추가, 결과 표에 코드 해시, 낡은 산출물 삭제·재생성.

**3라운드(2026-10-23, Opus 5.5 ×2, 새 에이전트, 좁은 범위: 2라운드 반영 확인 + 재현)**: 1단계 **major 0**·minor 2·nit 9(`docs/review_plan4_r3.md`), 2단계 **major 1**·minor 4·nit 6(`docs/review_plan4_mpc_r3.md`). 재현은 두 단계 모두 비트 단위(1단계 축소 86회 + 공식 JSON 재집계 1,194회 + 벤치 행 64작업, 2단계 축소 102회 + 19번 원자료 90회 + 20번 독립 재계산), 2라운드 major 5건 전부 해결 판정. 새 major 1건은 2라운드 M3의 잔여(현재 코드로 재현되지 않는 문서 수치: 3.4절 비채택 행, "정지 뒤 기준 −0.09 m/s", "OSQP 90 % 수렴", 비교보고서·합격기준·주석·응답 1라운드 행) — 판정 무관, 전부 정정했다. minor: (1단계) 200 Hz에서 유지 서보 표본이 호출자 dict의 별칭(복사로 수정), `freeze_hold_s`의 1단계 영향 미기재(문서); (2단계) `model_extra_latency_ms`가 내부 루프 지연으로 들어가 10 ms 이상이면 MPC가 꺼짐(기준 입력 순수 지연으로 수정), 넘김 1.0 s가 0.8~1.0 m/s 정지를 못 덮음(텔레메트리 속도 조건 + 텔레메트리 기반 제동 방향으로 수정), 동결 유지 0.1 s의 범위(문서), 독스트링. 같은 시점에 사용자가 위임한 16·17 결정(드리프트 x(0) 기준·10 cm, 합격기준 6.3)을 적용해 전체 매트릭스를 다시 돌렸다(`r5_s1`·`r5_s2`): **두 단계·두 주기 모두 합격**. 반영 표는 `docs/review_plan4_r1_response.md` 3라운드 절. 3라운드 수정을 확인하는 4라운드는 사용자 결정으로 생략했다(3라운드의 major는 문서 수치 하나였고 정정은 결과 파일에서 자동 생성; 코드 수정분은 단위 테스트 83개와 전체 매트릭스 재실행으로 확인).

### 11.9 재현

```
python -m wbr.models.build_upkie --out models/upkie_plan4 --tire-radius 0.056 --tire-shape ellipsoid --tire-condim 4
python -m wbr.models.upkie_params                      # models/upkie_plan4/plan4_params.json
python -m wbr.models.verify_plan4_plant                # results/plan4_model/ (대조용 강성 접촉; --soft-contact로 모델 기본값)
python -m unittest discover -s tests                   # 83 tests
python -m wbr.controllers.mpc_host.identify            # 2단계 예측 모델 검증 → results/plan4_mpc/model_fit.png
python -m wbr.bench.acceptance --host mpc --stage2 --rate both --matrix full --seeds 5   # 2단계(1단계 JSON 뒤에)
python -m wbr.bench.run_bench --plans plan4_lqi6 plan4_lqi6_200hz
python -m wbr.bench.acceptance --rate both --matrix full --seeds 5 --reference
python -m wbr.viewer.live --plan 4 --noise --latency-ms 10 [--rate 200]
python -m wbr.bench.video --plan 4
```
