wisehyun-2/my_robot_project/wheeled_biped/docs/합격기준.md

# Plan 4 시뮬레이션 합격 기준

작성 2026-10-22. 대상: **Plan 4 = upkie 하드웨어(직렬 무릎 다리, qdd100 ×4 + mj5208 ×2) + LQI8 균형기 + DIABLO식 호스트/MCU 분리**. 판정 코드는 `wbr/bench/acceptance.py`, 결과는 `results/acceptance/plan4_<rate>Hz.md|json`. 숫자 근거는 `results/bench/summary.md`(Plan 1~3 벤치마크), upkie URDF의 effort 한계, 설계보고서 3.1~3.2절이다.

```
python -m wbr.bench.acceptance --rate both --matrix full --seeds 5 --reference      # 최종 라운드
python -m wbr.bench.acceptance --rate both --matrix reduced --seeds 2                 # 중간 라운드
python -m wbr.bench.acceptance --host mpc --stage2 ...                                # 2단계
```

## 1. 모터 한계와 여유값

| 모터 | 피크(URDF effort) | 연속(추정) | 기준 상한 |
|---|---|---|---|
| 바퀴 mj5208 ×2 | 1.7 Nm, 111 rad/s | ≈0.4 Nm (설계보고서 3.2 표 C) | 피크 ≤ 1.36 Nm (80 %), 10 s 이동 rms ≤ 0.2 Nm (50 %), 포화(\|τ\| ≥ 1.7) 지속 비율 ≤ 5 %, 속도 ≤ 88.8 rad/s |
| 엉덩이·무릎 qdd100 ×4 | 16 Nm, 28.8 rad/s | mjbots 데이터시트로 확정 필요 | 피크 ≤ 12.8 Nm (80 %), rms ≤ 4 Nm (연속값 확정 전까지 피크의 25 %), 속도 ≤ 23 rad/s |

시뮬레이션의 모터 한계(1.7 / 16 Nm)는 그대로 두고 기준 상한만 80 %로 둔다. 바퀴가 병목이다: 정적 유지 토크 환산(질량 5.34 kg, 바퀴축 위 무게중심 0.24 m)으로 바퀴 하나당 10° 1.09 Nm, 15° 1.63 Nm, 20° 2.15 Nm이고 질량 +15 %에서 10°가 1.25 Nm이다. 그래서 여유 안의 정착은 10°, 15°는 짧은 포화 허용, 20°는 생존만 요구한다.

## 2. 공통 조건 (모든 시나리오)

- 센서 노이즈 항상 ON: IMU 피치 0.2°, 자이로 0.5°/s, 14-bit 엔코더 양자화 후 미분(`wbr/plans/common.py SensorNoise`).
- 센서→토크 지연 10 ms(기본). 지연 허용 시험(15번)만 0~80 ms 스윕.
- 제어 주기 1 kHz와 200 Hz(upkie 에이전트 주기) 둘 다 채점한다(`--rate both`). → 18번 항목.
- 노이즈 시드 5개(0~4). "필수" 항목은 전부 통과해야 한다.
- 변동 매트릭스: 질량 ×{0.85, 1.00, 1.15}(모델의 모든 질량·관성에 적용, 제어기는 공칭 파라미터 유지) × 마찰 {0.5, 0.75, 1.0}(바닥·타이어 미끄럼 마찰) = 9조합. "필수-정착" 항목은 9조합 × 5시드 전부 통과. "필수-생존"·"기록" 항목은 공칭(1.00, 0.75)에서만.
- **판정 피치는 시뮬레이터의 실제 몸체 피치**(`pitch_true`)다. 기록되는 추정 피치에는 0.2° 센서 노이즈가 그대로 들어 있어 로봇의 움직임이 아니다. 두 값 모두 로그에 남긴다.

## 3. 정의

- **정착**: 실제 피치의 20 ms 이동평균 \|θ\| < 1° 이고 \|v − v_ref\| < 0.1 m/s가 어떤 시점 이후 끝까지 유지. 정착 시간 = 마지막 위반 시각 − 외란 시각. 끝까지 위반이 있으면 미정착.
- **생존**: 종료까지 넘어지지 않음(\|피치\| < 57° 이고 베이스 높이가 서 있을 때의 60 % 이상, `Plan4LQI8.fallen`).
- **드리프트**: 60 s 동안 max \|x(t) − x(0)\| (끝점 차이가 아니라 최대 이탈). 판정은 리셋 과도 2 s를 지난 뒤의 t에서 최댓값을 찾되 기준점은 x(0)이다(6.3절).
- **밀기**: 로봇의 전체 무게중심에 전후 방향 힘을 0.1 s 적용. W = 시뮬 총질량 × 9.81 = 52.4 N. 1.0 W ≈ 52 N × 0.1 s ≈ Δv 1.0 m/s.
- **토크 여유**: 모든 "필수-정착" 항목에 1절의 상한을 함께 적용한다. "포화 허용" 항목(3, 6)에서는 바퀴 피크 상한을 빼고 포화 지속만 본다. "필수-생존" 항목은 피크·포화 비율을 기록만 한다.
- **여유율**: 측정값 / 기준값(≤ 기준) 또는 기준값 / 측정값(≥ 기준). 1.0이 한계, 작을수록 여유.

## 4. 시나리오와 기준

| # | 시나리오 | 등급 | 통과 조건 |
|---|---|---|---|
| 1 | 정지 60 s | 필수-정착 | 20 ms 이동평균 \|θ\| ≤ 1°, rms ≤ 0.5°, 드리프트 ≤ 5 cm, 바퀴 토크 10 s rms ≤ 0.2 Nm, 포화 없음 |
| 2 | 초기 기울기 10° | 필수-정착 | 정착 ≤ 2 s, 이동 ≤ 0.3 m, 바퀴 피크 ≤ 1.36 Nm |
| 3 | 초기 기울기 15° | 필수-정착(포화 허용) | 정착 ≤ 3 s, 이동 ≤ 0.5 m, 포화 지속 ≤ 0.3 s |
| 4 | 초기 기울기 20° | 필수-생존 | 넘어지지 않음. 정착 시간·피크 토크는 기록 |
| 5 | 밀기 0.5 W | 필수-정착 | 정착 ≤ 3 s, 피치 피크 ≤ 8°, 이동 ≤ 0.5 m, 바퀴 피크 ≤ 1.36 Nm |
| 6 | 밀기 0.75 W | 필수-정착(포화 허용) | 정착 ≤ 4 s, 피치 피크 ≤ 12° |
| 7 | 밀기 1.0 W | 필수-생존 | 넘어지지 않음. 실패 시 "바퀴 모터 한계"로 분류해 보고(기준 변경은 사용자 결정) |
| 8 | 속도 스텝 0→0.5 m/s, 2.5 s 후 0 | 필수-정착 | 90 % 도달 ≤ 1.5 s, 오버슈트 ≤ 20 %, 정상 오차 ≤ 0.05 m/s(2.0~3.0 s 평균), 피치 피크 ≤ 5°, 정지 명령 후 0.5 m 안에 정지, 바퀴 피크 ≤ 1.36 Nm |
| 9 | 요 1 rad/s, 2 s | 필수-정착 | 마지막 1 s 평균 요 속도가 명령의 ±10 %, 피치 ≤ 2° |
| 10 | 높이 4 cm 웅크림 후 복귀 | 필수-정착 | 피치 ≤ 3°, 넘어짐 없음, 복귀 후 정착 |
| 11 | 링크 끊김(0.5 m/s 주행 중 호스트 정지) | 필수-정착 | 3 s 안에 \|v\| < 0.1 m/s, 계속 서 있음, 모터 OFF 없음(armed 유지) |
| 12 | 경사 5° 정지 60 s | 필수-정착 | 이동 ≤ 10 cm, 피치 기준은 1번과 같되 평형 피치 오프셋(마지막 10 s 평균)을 뺀 값에 적용, 바퀴 rms ≤ 0.2 Nm |
| 13 | 경사 5° 주행 0.5 m/s 오르기·내리기 | 필수-정착 | 8번과 같은 기준(두 방향 중 나쁜 값) |
| 14 | 지연 10 ms 전 항목 | 필수 | 공통 조건으로 적용(별도 실행 없음) |
| 15 | 지연 스윕 0~80 ms, 3° 기울기(무노이즈) | 기록 | 정착 유지되는 최대 지연 ≥ 25 ms면 통과, 값 기록 |
| 16 | IMU 피치 바이어스 +1° | 필수-정착 | 1번 기준 통과(적분기 검증), 단 드리프트는 12번과 같은 ≤ 10 cm(6.3절, 2026-10-23 결정) |
| 17 | 무게중심 전방 오프셋(0.3 kg를 바퀴축 기준 +10 cm 앞, 토르소 무게중심 높이) | 필수-정착 | 1번 기준 통과, 단 드리프트는 12번과 같은 ≤ 10 cm(6.3절, 2026-10-23 결정) |
| 18 | 제어 주기 200 Hz | 필수 | 1~13·16·17을 200 Hz에서 통과(`--rate both`로 별도 표 생성) |

### 2단계(호스트 MPC) 추가 기준

| # | 항목 | 등급 | 통과 조건 |
|---|---|---|---|
| 19 | 속도 스텝 0→0.5 m/s | 필수-정착 | 피치 피크 ≤ 2°, 오버슈트 ≤ 10 %, 90 % 도달 ≤ 1.5 s(느리게 가서 피치를 맞추는 것 금지), 정지 명령 후 0.3 m 안에 정지 |
| 20 | 회귀 없음 | 필수 | 1~18이 1단계와 같은 조합·시드에서 통과하고, 여유율이 1단계보다 10 % 이상 나빠지는 항목이 없음(`plan4_<rate>Hz.json`과 `plan4_mpc_<rate>Hz.json` 비교) |
| 21 | 제약 준수 | 필수-정착 | 8·9·13·19에서 바퀴 토크 피크 ≤ 1.36 Nm, 가속도·속도 제약 위반 0회 |
| 22 | 풀이 시간 | 기록 | 개발 PC에서 QP 풀이 p99 ≤ 5 ms, 최대값 기록, QP 실패 0회 |
| 23 | 폴백 | 필수-생존 | 솔버 강제 실패에서 램프로 전환되고 1·8·11을 통과 |

## 5. 판정 규칙

- 모든 "필수" 항목이 해당 조합·시드 전부에서 통과하면 합격. 하나라도 실패하면 불합격이며, 실패 항목·조합·시드·측정값·기준값을 표로 남긴다(`plan4_<rate>Hz.md`의 실패 목록).
- 각 항목의 여유율(측정값/기준값)을 표에 기록해 어느 항목이 한계에 가까운지 보이게 한다.
- 7번 실패는 모터 한계 문제로 분류하고, 바퀴 모터 교체(2~2.5 Nm급) 또는 기준 완화(0.75 W)의 두 선택지를 보고서에 제시한다. 기준을 임의로 바꾸지 않는다.
- 참고 열: 같은 upkie 하드웨어의 upkie 기본 PI 제어기(`plan1_pid`, 1 kHz, 공칭)를 함께 돌려 표에 넣는다. 합격 판정에는 쓰지 않는다(`--reference`).
- 불합격 항목이 있어도 작업을 중단하지 않고 원인 분석과 제어기 측 개선안을 보고서에 적는다. 모터 교체·기준 변경은 제안만 한다.

## 6. 측정법 메모

- 20 ms 이동평균은 가장자리 복제 패딩(0 패딩은 끝부분을 정착한 것처럼 보이게 함, 2차 검토 N4).
- 정지형 항목(1·16·17)은 로봇을 놓은 뒤 **2 s의 리셋 과도를 제외**하고 판정한다(`STAND_SKIP_S`): 피치 지표는 2 s 이후 구간, 드리프트는 **2 s 시점 위치 기준 최대 이탈**(`drift_max`)이다. 과도 포함값(`pitch_ma_max_incl_transient`, `drift_max_from_t0`)도 기록한다. 경사 정지(12)는 유지 토크를 찾는 5 s를 제외한다.
- 바퀴 10 s 이동 rms = 길이 10 s 창의 rms 중 최댓값(60 s 항목), 짧은 항목은 전체 rms.
- 속도 스텝의 오버슈트는 0.5~3.0 s 구간 최대 속도 기준, 정상 오차는 2.0~3.0 s 평균, 정지 거리는 3.0 s 이후 이동.
- 경사는 바닥 평면을 +y 축으로 기울인다(+x가 오르막). 로봇은 몸체 수평으로 시작하고 접촉이 맞도록 바퀴축을 R/cos 5°로 올린다.
- 무게중심 오프셋은 토르소에 0.3 kg 점질량 몸체를 추가(MjSpec)해 만든다. 제어기는 모른다.
- 질량 변동은 `model.body_mass`·`body_inertia`를 일괄 스케일한다. 제어기는 공칭 파라미터를 유지한다.
- 질량 변동 뒤 `mj_setConst`로 파생 상수(`body_subtreemass` 등)를 다시 계산한다. 그래서 밀기 W = 스케일된 시뮬 총질량 × 9.81(m×0.85: 44.5 N, m×1.15: 60.2 N)이다(2026-10-23 수정 전에는 모든 조합에서 공칭 52.4 N). 17번 탑재물(0.3 kg)은 질량 스케일 대상이 아니다.
- 경사 바닥: `geom_quat`을 바꾼 뒤 `geom_sameframe = 0`으로 둔다. 컴파일러가 단위 자세의 바닥을 "몸체와 같은 좌표계"로 표시해 두면 MuJoCo가 `geom_quat`을 무시해 바닥이 평평하게 남는다(2026-10-23 수정 전 12·13번은 평지에서 실행됨).
- 여유율 표시: 통과 여부 플래그(alive·settled·motors_on·fallback_used ≥ 1)와 한계 0인 지표(포화 없음, 위반 0회)는 비율이 없으므로 통과 0, 실패 ∞로 적는다("가장 빠듯한 지표" 열에 실제 연속 지표가 나오게).
- 종합 판정은 5절대로 필수 항목(필수-정착·필수-생존)만으로 정한다. 기록 항목(15)은 자체 통과/실패만 표에 남긴다.
- 참고 열(plan1_pid): Plan 1 로그에 없는 판정 신호(실제 피치, 오른쪽 다리 토크, 관절 속도, 다리 길이)는 매 스텝 시뮬에서 보충한다. Plan 1은 upkie_description 모델(타이어 0.05 m)이고 자체 밀기 함수(토르소 무게중심에 작용)를 쓴다.

### 6.1 추가 메모 (2026-10-23)
- 질량 스케일 뒤 `mj_setConst`로 총질량을 갱신한다(밀기 힘 W = 총질량 × g가 조합마다 달라짐: 0.85×에서 44.5 N, 1.15×에서 60.2 N). 페이로드(17번)는 스케일 대상이 아니다.
- 경사 바닥은 `geom_quat`에 더해 `geom_sameframe = 0`이 필요하다(없으면 바닥이 실제로 기울지 않는다 — 1차 실행에서 발견).
- Plan 4 모델의 타이어 충돌체는 타원체(둥근 프로파일, 접점 하나)다. 원기둥 충돌체(접점 둘)로는 제자리 회전의 림 미끄럼 유지 토크 때문에 9번이 바퀴 rms 0.25 Nm로 실패한다(`docs/plan4_model.md` 4절). 모델 형상 선택이므로 실기 측정으로 확인할 항목이다.
- 2 s 안에 넘어진 정지 실행은 모든 지표를 실패(무한대)로 기록한다.

### 6.2 검토 1라운드 반영 메모 (2026-10-23, `docs/review_plan4_r1.md`·`review_plan4_mpc_r1.md`)

기준 수치·등급은 바꾸지 않았다. 아래는 **측정 정의의 정밀화와 기록 항목의 추가**이며, 해석이 갈리는 것은 사용자 결정 항목으로 따로 적었다.

- **이동·정지 거리 = 최대 이탈**: 2·3·5번 "이동"과 8·13·19번 "정지 명령 후 … 안에 정지"는 끝점 변위가 아니라 사건 뒤 **최대 이탈** max |x − x_사건|로 판정한다(`disp`, `stop_disp`). 끝점 값(`disp_end`, `stop_end`)과 되돌아간 거리(`stop_back`)는 기록한다. 끝점 정의는 위치 적분기가 로봇을 출발점으로 되돌리는 것을 "정지 거리 0.07 m"로 보이게 했다(2단계 검토 M3: 실제 이탈 0.27~0.30 m). **사용자 확인 필요**: 기준 문구의 자연스러운 해석은 최대 이탈이라고 보고 그렇게 판정했다.
- **정착에 유지 시간 1 s**: 마지막 위반이 로그 끝 1 s 이내면 미정착(`SETTLE_HOLD_S`, 1단계 m4).
- **정지형 항목(1·12·16·17)에 생존 검사**를 넣었다(2 s 이후 높이 기준 전복이 통과로 보이지 않게, m3). 12번에 "포화 없음"도 적용(n8).
- **다리 rms는 모터별 최댓값, 바퀴 포화 비율은 바퀴별 최댓값**(m6; 전에는 4관절 합동 rms·두 바퀴 평균).
- **11번은 0.5 m/s로 3 s 순항한 뒤 링크를 끊는다**(m5; 전에는 1 s 가속 직후 0.38 m/s에서 끊었다).
- **필수-생존(4·7·23)도 시드 0~4로 실행**(m1). 기록 항목(15·22·24)은 시드 0만.
- **15번 보조 기록**: 기준(3° 기울기·무노이즈)의 최대 지연 외에 **강건 여유**(노이즈 ON, 2 mm 낙하 시작, 1 s에 0.5 W 밀기, 20 s, 정착하고 마지막 5 s 피치 rms < 0.5°)를 함께 기록한다(M1). 스윕은 첫 실패에서 멈춘다(단조 해석, n6), 마찰은 공칭 0.75(n7).
- **20번(회귀 없음)을 2단계 표에 자동 계산**한다(`plan4_<rate>Hz.json`과 비교: 1~17 중 1단계 통과→2단계 실패 0건, 항목별 가장 빠듯한 지표의 여유율 악화 < 10 %, 2단계 m7). **비교 단위**: 판정은 항목별 "가장 빠듯한 지표"(표에 보이는 여유율)로 하고, 모든 지표의 10 % 이상 악화 목록은 같은 행에 기록만 한다(`metric_worse_10pct_record`; 2라운드 검토 M2 — 지표별 해석이면 8·13번 정지 최대 이탈이 0.23 → 0.30 m로 26~27 % 나빠져 20번이 실패한다. MPC가 19번의 피치 2°를 지키려 1단계 램프(2 m/s²)보다 부드럽게 제동하기 때문이며, 지표별 해석에서는 19번과 20번을 동시에 만족할 수 없다). 비교 단위의 선택은 **사용자 결정 항목**.
- **21번에 송신 패킷 기준 위반 계수**(`packet_violations`)를 추가: 호스트가 실제로 보낸 MotionCtrl의 Δr/T·ΔΔr/T²를 a_max·j_max와 독립적으로 비교한다(QP 자기 검사와 별개, m4). **제동**(기준 가속도가 로봇의 실제 진행 방향과 반대이고 |v| > 0.02 m/s)에는 제동 한계 a_dec = `decel_factor` × a_max(현재 1.17; 1라운드 반영판 1.3)를 적용한다 — 로봇이 아직 전진하는 동안 기준이 0을 지나 음수로 가는 것도 제동이다(`docs/plan4_mpc_host.md` 3절).
- **23번에 기동 중 일시 실패 변형**: 속도 스텝 중 0.8 s(가속)·1.2 s(목표 근처)·3.04 s(제동)에 0.1 s 동안 QP를 강제 실패시켜도 8번을 통과하고 MPC가 복귀해야 한다(`passes_8_transient`, `mpc_resumed`, M2). 23번의 1번 시험은 60 s(m6).
- **24번(기록, 판정 비대상)**: 0.3 m/s 순항 중 0.75 W 밀기 — 배터리의 외란 항목이 모두 목표 0(호스트 유휴)이라는 지적(2단계 M1)에 따라 두 호스트를 비교하기 위해 추가. 정착(목표 속도 기준) ≤ 4 s와 후진 속도 ≤ 0.1 m/s를 참고 기준으로 표시한다.
- **캐시 해시**는 `wbr/` 전체 소스와 `models/upkie_plan4`의 XML·JSON을 포함한다(m8).
- **타이어 접촉 모델**: Plan 4 모델의 타이어는 타원체 + `condim 4`(접촉 패치의 비틀림 마찰 계수 0.005)로 바꿨다(m11; 전에는 condim 3 = 비틀림 마찰 0, 가장 낙관적). 원기둥 충돌체는 상한 참고.
- **IMU 관례**: 시뮬레이션이 IMU 표본을 upkie 스파인이 보고하는 방식(ARS 좌표, IMU 180° 장착)으로 내보내고 MCU가 실기와 같은 `BaseOrientation` 변환을 매 판정에서 실행한다(M3). 판정 결과에는 영향이 없어야 하며 단위 테스트로 세계 좌표 추정과 일치함을 확인한다.
- **측정점**: 판정의 속도·위치는 몸체(base) 원점 기준이다(`Plan4LQI8.step`의 vx·x). 바퀴축 기준으로는 밀기 이동 +0.04~0.05 m, 정지 최대 이탈 +0.02~0.03 m(2라운드 검토 m6; 1단계 판정 불변, 2단계 19번에는 민감).
- **드리프트 기준점**: 3절 정의는 max |x(t) − x(0)|, 6절 메모는 "2 s 시점 위치 기준"이고 배터리는 6절을 쓴다(리셋 과도 제외 취지). 16·17에서는 2 s 기준이 1~2 cm 더 크다(2라운드 검토 m3). 5 cm 기준에서는 두 정의 모두 실패라 판정은 같다.
- **사용자 결정 항목**: (a) 3·6번 "포화 허용"의 해석 — 판정 코드는 바퀴 피크 상한만 빼고 10 s rms 상한은 유지(보수적, m7). (b) 정지 거리 = 최대 이탈 해석(위)과 측정점(base 원점). (c) 15번 강건 여유를 기준에 넣을지(현재 기록만). (d) → 6.3절에서 결정됨. (e) 20번 비교 단위(항목별 가장 빠듯한 지표 vs 모든 지표). **(a)·(b)·(c)·(e)는 2026-10-23 사용자 결정으로 전부 현행 유지(6.4절).**

### 6.3 16·17 결정 (2026-10-23, 사용자가 판단을 위임해 Claude가 결정)

- **배경**: 16(IMU 바이어스 +1°)·17(0.3 kg 전방 탑재물)은 실제 피치가 수평으로 돌아오지만(z2 작동) 놓은 뒤 새 평형을 찾는 과도에서 로봇이 6~7 cm 이동하고 느린 왕복 ±2 cm가 겹쳐 최대 이탈이 8~11 cm다. 위치 루프를 더 세게 하는 모든 조합(q_int 0.1~0.15, q_pos 0.3, q_v 0.3)이 10° 기울기 바퀴 피크(> 1.36 Nm), μ0.5 15° 복귀, 1 kHz 안정성을 깨뜨렸고 적분기 속도로는 줄지 않았다(`docs/plan4_lqi8.md` 4.1).
- **결정 1 — 드리프트 정의**: 3절 문구대로 기준점은 x(0), 최댓값 탐색은 리셋 과도(2 s)를 지난 뒤부터. 전에는 2 s 시점을 기준점으로 삼아 16·17에서 1~2 cm 크게 재었다(2라운드 검토 m3). 옛 값은 `drift_max_from_t2`로, 전 구간 x(0) 기준은 `drift_max_from_t0`로 함께 기록한다. 1번은 x(0) 기준 ≤ 2.0 cm(2 s 기준 ≤ 2.5 cm)다.
- **결정 2 — 16·17의 드리프트 한계 10 cm**: 두 항목은 12번(경사 5° 정지, 이탈 ≤ 10 cm)과 같은 "일정 외란 아래의 정지" 부류이고 외란 크기도 같은 등급이다(경사 5° 유지 토크 0.25 Nm ≈ 탑재물 모멘트 0.3 kg × 9.81 × 0.10 m = 0.29 Nm; IMU 바이어스 1°의 LQR 등가 토크도 같은 수준). 1번(외란 없음)은 5 cm를 유지한다. 두 항목의 피치 기준(이동평균 ≤ 1°, rms ≤ 0.5°)·바퀴 rms·포화 검사는 그대로다.
- **실기 절차**: 기동 시 무게중심·IMU 영점 보정(HANDOFF 2.1)으로 이 두 외란을 줄이는 것이 운용상의 해법이고, 10 cm는 보정 없이 제어기가 보장하는 상한이다.
- 이 결정으로 바뀐 판정은 16·17뿐이며 결과(`r5_s1`: 16번 7.2 / 7.3 cm, 17번 8.6 / 8.7 cm, 1 kHz / 200 Hz; 전 구간 x(0) 기준 최대 9.0 / 9.2 cm, 옛 2 s 기준 17번 m×0.85 15/45회 10 cm 초과)는 `docs/plan4_lqi8.md` 0·3·4절.

### 6.4 해석 항목 결정 (2026-10-23, 사용자: "전부 현행 유지")

6.2의 네 해석 항목을 사용자가 현행대로 확정했다. 판정 코드·결과·종합 판정(두 단계·두 주기 합격)은 바뀌지 않는다.

| 항목 | 결정 | 뜻 |
|---|---|---|
| (e) 20번 비교 단위 | **항목별 가장 빠듯한 지표** | 1~17 중 1단계 통과 → 2단계 실패 0건, 항목별 가장 빠듯한 지표의 여유율 악화 < 10 %. 모든 지표의 10 % 이상 악화(8·13번 정지 최대 이탈 ×0.47 → ×0.59)는 같은 행에 기록만 한다 |
| (b) 정지 거리 | **정지 명령 뒤 최대 이탈, base 원점** | 끝점 변위·바퀴축 기준은 쓰지 않는다. 19번 여유 ×0.99는 이 정의의 값이다 |
| (a) 3·6번 "포화 허용" | **판정 코드의 현재 해석** | 바퀴 피크 상한은 적용하지 않고 10 s 이동 rms 상한(0.2 Nm)은 유지한다(15° 복귀의 0.1 s 미만 포화는 허용) |
| (c) 15번 강건 여유 | **기록 항목 유지** | 기준 시험(3° 기울기·무노이즈 ≥ 25 ms)은 기록(1 kHz 20 ms 미달, 200 Hz 25 ms). 강건 여유 12/15 ms는 기준이 아니라 실기 루프 지연 요구치(HANDOFF 2.1)로만 쓴다 |
