wisehyun-2/my_robot_project/wheeled_biped/docs/plan2_15kg_torque_sizing.md

# Plan 2(DIABLO-lite + LQI6) 15 kg 로봇의 모터 토크 산정

작성 2026-10-23. 대상: Plan 2 = DIABLO식 평행사변형 5절 링크 다리(다리마다 동축 hip 모터 2개) + 바퀴 2개 + LQI6 균형기(`wbr/plans/plan2_diablo_lqi6.py`)를 **전체 질량 15 kg**으로 키운 로봇. 측정 코드는 `wbr/bench/torque_sizing.py`, 결과는 `results/torque_sizing/`(케이스별 `*.json`, 표 `summary.md`).

재현(표준 케이스 7개, 케이스마다 약 50 s, 병렬):
```
python -m wbr.bench.torque_sizing
python -m wbr.bench.torque_sizing --mass 15 --clamp-hip 20 --clamp-wheel 8 --tag my_case   # 임의 케이스 하나
```

## 0. 요약

**권장 토크 사양(출력축, 모터 한 개 기준)**

| | 최소(시뮬 전 시나리오 통과, 큰 외란에서 포화) | **권장** | 근거(15 kg 측정값) |
|---|---|---|---|
| **hip 모터 ×4** 정격(연속) | 7 N·m | **≥ 10 N·m** | 가장 낮은 자세(L0 0.12 m) 정지 유지 6.7, 제자리 회전 중 RMS 6.3 |
| hip 최대 | 12 N·m | **≥ 20 N·m** | 측정 최대 14.0~14.5(2 W 밀기)에 약 40 % 여유 |
| hip 속도 | 7 rad/s | **≥ 10 rad/s (약 100 rpm)** | 측정 최대 7.0 rad/s(2 W 밀기) |
| **바퀴 모터 ×2** 정격(연속) | 1.5 N·m | **≥ 2.5 N·m** | 경사 15° 정지 1.22, 제자리 회전 RMS 2.07 |
| 바퀴 최대 | 5 N·m | **7~8 N·m** | 측정 최대 6.8~7.0(25° 기울기 회복). 반경 65 mm에서는 약 5 N·m 위가 바닥 마찰 한계라 8 N·m를 넘겨도 쓸 데가 없다 |
| 바퀴 속도 | 35 rad/s (약 330 rpm) | **≥ 60 rad/s (약 570 rpm)** | 1 m/s 주행 19, 1 W 밀기 32, 2 W 밀기 66.5 rad/s. 순간 기계 출력 85 W(1 W)~313 W(2 W) |

- 바퀴 반경 R을 바꾸면 바퀴 토크는 R/0.065배, 바퀴 속도는 0.065/R배로 환산한다.
- 모터 한계 12/5 N·m(기존 6 kg 사양)에서도 모든 시나리오를 통과하지만, 2 W 밀기와 20° 이상 기울기에서는 토크가 한계에 계속 걸린다(2 W 밀기 피치 최대 5.7° → 7.7°). 20/8 N·m에서는 포화 없이 통과한다(5절).
- 15 kg 측정값은 6 kg의 **2.50배**(시나리오별 2.45~2.58배)로, 질량 비례 스케일링이 의도대로 됐다(2.2절).
- 요 2 rad/s 제자리 회전은 6 kg 원래 모델에서도 한계 없이 돌리면 넘어진다. 토크가 아니라 제어기의 한계라서 산정에서 뺐다.

## 1. 배경과 전제

- 2026-10-23: Plan 4의 hip·knee 모터 mjbots qdd100 beta 3가 사실상 구매 불가(최소 주문 50개)라서, 사용자가 Plan 2로 돌아가는 안을 검토하고 로봇 질량을 15 kg으로 정했다.
- **Plan 2도 모터는 6개다**(다리마다 동축 hip 모터 2개 + 바퀴 2개). Plan 4(hip 2 + knee 2 + 바퀴 2)와 개수는 같다. 바뀌는 점은 qdd100에 묶이지 않고 사양에 맞는 모터를 고를 수 있다는 것이다.
- 평행사변형 다리에서 hip 모터(허벅지)와 crank 모터(크랭크 → 정강이)는 각각 링크 하나의 절대 각도를 정하고, 정적 하중에서는 **크기가 같고 방향이 반대인 토크**를 낸다(정지 시나리오 8개에서 두 모터의 정상 평균 크기 차이가 0.02 N·m 이하). 그래서 다리용 4개는 같은 모터로 한다.
- Plan 4는 upkie 기구부(FreeCAD 파일)가 있어서 골랐다. Plan 2의 5절 링크 기구부는 CAD가 없으므로 새로 설계해야 한다.

## 2. 모델과 방법

### 2.1 15 kg 모델

`build_diablo_lite.DiabloLiteParams`의 치수는 그대로 두고, 질량·로터 관성(armature)·관절 마찰을 모두 k = 15/6 = 2.5배로 키웠다. 모델은 실행할 때 임시 폴더에 만들고 Plan 2 코드는 바꾸지 않는다(`scaled_plan2()`가 케이스 하나 동안만 파라미터와 모델 폴더를 바꿔 끼운다).

| 항목 | 6 kg(원래) | 15 kg |
|---|---|---|
| 몸통 | 2.0 kg | 5.0 kg |
| hip 모터(몸통에 고정) | 0.45 kg × 4 | 1.125 kg × 4 |
| 다리 링크(허벅지·정강이·크랭크·로드) | 0.6 kg × 2 | 1.5 kg × 2 |
| 바퀴 + 모터 | 0.5 kg × 2 | 1.25 kg × 2 |
| 링크 길이 L1 = L2 / 크랭크 / 로드 | 0.14 / 0.09 / 0.14 m | 같음 |
| 바퀴 반경 / 좌우 바퀴 간격 | 0.065 / 0.38 m | 같음 |
| 다리 길이(엉덩이 → 바퀴축) 범위, 기본 높이 | 0.12~0.26 m, 0.198 m | 같음 |

### 2.2 제어와 스케일링

- 제어 스택은 Plan 2 그대로다: DIABLO식 MCU 1 kHz, LQI6(다리 길이별 이산 LQR 게인표), 5절 링크 VMC, IMU·엔코더 노이즈, 관측 지연 2 ms(벤치마크와 같은 조건).
- 힘에 비례하는 MCU 게인 6개(다리 PD `kp_leg`·`kd_leg`, 좌우 벌어짐 방지 `kp_split`·`kd_split`, 요 PI `kp_yaw`·`ki_yaw`)를 k배 했다. 다리 정적 힘 피드포워드는 원래 `mass_total`에서 계산되므로 자동으로 따라간다.
- LQI6의 입력 가중치는 토크 예산의 비율(`r_wheel_frac`·`r_hip_frac`)로 정해진다. 예산을 6 kg 값의 k배(hip 30 N·m, 바퀴 12.5 N·m)로 두면, 질량과 관성이 모두 k배인 플랜트에서 LQR 해는 게인만 k배가 되고 폐루프는 6 kg과 같다. 따라서 모든 토크가 k배가 되어야 하고, 측정에서도 15 kg/6 kg 비가 평균 2.502(2.45~2.58)로 나왔다. 남는 차이는 노이즈와 접촉 때문이다.
- 즉 이 산정은 "**6 kg Plan 2와 같은 응답 성능을 15 kg에서 내려면 모터가 얼마나 필요한가**"에 대한 답이다. 더 부드럽게 튜닝하면 최대 토크는 줄고(5절 `design20_8`), 대신 외란 피치가 커진다.

### 2.3 측정

- **한계 해제 측정**: MCU 클램프, 서보 최대 토크, MuJoCo `ctrlrange`를 모두 10⁴ N·m로 풀어 제어기가 실제로 요구하는 토크를 잰다.
- 1 kHz마다 시뮬레이터의 참값 `actuator_force`(6개 모터)와 관절 속도 `qvel`을 기록한다. 시나리오별로 hip 4개·바퀴 2개 중 최악의 최대 |τ|, 모터별 RMS의 최댓값, 최대 관절 속도, 최대 순간 기계 출력 |τ·ω|를 낸다. 정지 시나리오는 정상 구간 평균(유지 토크)도 낸다.
- **회복 판정**: 넘어지지 않고(|피치| ≤ 1 rad, 바닥 위 높이 ≥ 0.08 m), 마지막 1 s 동안 |피치| < 3°. Plan 2의 넘어짐 판정은 몸통의 세계 z를 보는데, 내리막에서는 바닥이 낮아져 서 있어도 넘어짐으로 잡힌다. 그래서 바닥 위 높이로 바꿔 판정한다.
- 자세를 바꿔 시작하는 시나리오는 MCU의 다리 길이 램프도 그 자세에서 시작하게 했다(그러지 않으면 기본 높이로 갔다가 돌아오는 과도 토크가 유지 토크에 섞인다).

시나리오(케이스마다 44개):

| 이름 | 내용 |
|---|---|
| `stand_L*` | 다리 길이 0.12~0.26 m 8단계에서 5 s 정지(유지 토크 = 2 s 뒤 평균) |
| `tilt_*` | 몸통 5~25° 기울인 채 시작, 6 s 회복 |
| `push_*` | 1 s 뒤 몸통에 체중 × 0.25~2.0의 힘을 0.1 s 가함, 6 s 회복 |
| `velocity_*` | 0.5 / 0.8 / 1.0 m/s 스텝 3 s 뒤 정지 3 s. `_L0.14`·`_L0.24`는 웅크린·높은 자세로 0.8 m/s |
| `yaw_*` | 제자리 회전 1 / 2 rad/s, 2.5 s |
| `height_full_range` | 기본 높이 → 최저 0.12 → 최고 0.26 → 기본, 다리 램프 0.25 m/s, 균형 유지 |
| `slope_*` | 바닥을 5 / 10 / 15° 기울여 6 s 정지, 오르막·내리막 0.5 m/s 주행 |

### 2.4 한계 검증

권장값을 정하기 위해, 같은 제어기에 모터 한계만 걸고 다시 돌렸다(12/5, 15/6, 20/8 N·m). 제어기 토크 예산까지 20/8로 낮춘 케이스(`clamp_15kg_design20_8`)도 함께 돌렸다.

## 3. 정적 해석과 시뮬레이션 대조

### 3.1 hip 정적 유지 토크

해석값은 VMC 식 τ = Jᵀ·F(`FiveBarLeg.vmc_torques`)에 다리 하나의 하중 F = (전체 − 바퀴) × g / 2를 평형 다리 각도에서 넣은 것이다. 다리 링크 질량까지 전부 엉덩이에 얹은 셈이라 **상한**이고, 시뮬레이션은 실제 질량 분포를 쓴다.

| 다리 길이 L0 [m] | 0.12 | 0.14 | 0.16 | 0.18 | 0.198 | 0.22 | 0.24 | 0.26 |
|---|---|---|---|---|---|---|---|---|
| 15 kg 시뮬 [N·m] | **6.71** | 6.42 | 6.06 | 5.63 | **5.15** | 4.43 | 3.56 | 2.30 |
| 15 kg 해석(상한) | 7.80 | 7.46 | 7.06 | 6.59 | 6.01 | 5.31 | 4.42 | 3.19 |
| 6 kg 시뮬 | 2.68 | 2.57 | 2.42 | 2.25 | 2.06 | 1.77 | 1.42 | 0.93 |

웅크릴수록 무릎이 앞으로 나와 지렛대가 길어지므로 유지 토크가 커진다. hip 정격은 오래 머물 가장 낮은 자세에서 정한다.

### 3.2 바퀴

| 항목 | 식 | 15 kg 해석 | 15 kg 시뮬 |
|---|---|---|---|
| 경사 5° / 10° / 15° 정지 | m·g·R·sinα / 2 | 0.42 / 0.83 / 1.24 N·m | 0.41 / 0.82 / 1.22 N·m |
| 1 m/s² 가속(바퀴 관성 제외) | m·a·R / 2 | 0.49 N·m | – |
| 바닥 마찰 한계(정적 하중) | μ·m·g·R / 2 | 4.8 N·m(μ = 1), 3.3 N·m(μ = 0.7) | – |
| 1 m/s 주행 바퀴 속도 | v / R | 15.4 rad/s(147 rpm) | 19.0 rad/s(가속 중 최대) |

바퀴 토크는 바닥이 받아 줄 수 있는 만큼만 쓸모가 있다. 회복 동작 중에는 수직 하중이 순간적으로 늘어 한계가 조금 올라가지만, 반경 65 mm에서는 최대 7~8 N·m 위로는 의미가 없다.

## 4. 시뮬레이션 결과 (15 kg, 한계 해제, 시드 0)

hip은 4개 중, 바퀴는 2개 중 최악값. 전체 표는 `results/torque_sizing/summary.md`.

| 시나리오 | hip 최대 / RMS [N·m] | 바퀴 최대 / RMS [N·m] | hip / 바퀴 속도 최대 [rad/s] | 바퀴 출력 최대 [W] |
|---|---|---|---|---|
| 정지, 기본 높이 0.198 m | 6.32 / 5.15 | 0.70 / 0.19 | 0.4 / 0.5 | 0 |
| 정지, 최저 0.12 m | 8.13 / 6.72 | 0.59 / 0.15 | 0.4 / 0.5 | 0 |
| 주행 1.0 m/s 스텝 | 6.38 / 5.16 | 1.17 / 0.37 | 0.4 / 19.0 | 16 |
| 주행 0.8 m/s, 웅크린 자세 0.14 m | 7.75 / 6.43 | 1.07 / 0.30 | 0.4 / 15.3 | 10 |
| 제자리 회전 1 rad/s | 9.41 / 6.33 | 3.87 / **2.07** | 3.1 / 12.8 | 37 |
| 높이 전체 범위 이동 | **9.95** / 5.28 | 0.78 / 0.19 | 2.7 / 2.7 | 1 |
| 경사 15° 정지 | 6.41 / 4.40 | 1.87 / **1.25** | 1.5 / 3.0 | 4 |
| 경사 15° 오르막 0.5 m/s | 5.01 / 4.40 | 2.29 / 1.28 | 0.4 / 9.7 | 18 |
| 기울기 10° / 20° / 25° 회복 | 7.42 / 8.61 / 9.42 | 2.71 / 5.58 / **6.79** | 0.8~2.0 / 7.6~19.4 | 9 / 31 / 49 |
| 밀기 0.5 W / 1 W | 6.82 / 8.90 | 2.15 / 3.60 | 1.4 / 3.0, 바퀴 15.9 / 32.0 | 23 / 85 |
| 밀기 1.5 W / 2 W | 11.36 / **14.03** | 5.06 / 6.71 | 5.0 / **7.0**, 바퀴 48.4 / **66.5** | 180 / **313** |

- 시드 1: hip 최대 14.47(2 W 밀기), 바퀴 최대 7.00(25° 기울기). 시드 간 차이 3 % 이내.
- 6 kg(`demand_6kg`): hip 최대 5.46, 바퀴 최대 2.72, 바퀴 속도 최대 65.7 rad/s. 속도는 질량과 무관하다(같은 폐루프).
- 제자리 회전 중 바퀴 RMS 2.07 N·m는 대부분 타이어가 바닥을 비비는 저항이다(원통 타이어, 폭 30 mm). 실제 값은 타이어 폭·재질·공기압에 따라 크게 다르다.
- 요 2 rad/s(`yaw_2.0`)는 넘어졌다. 6 kg에서도 한계 없이 돌리면 넘어지므로 토크 부족이 아니라 제어기 한계다. 오히려 한계를 12/5, 15/6으로 걸면 통과했다. 2 rad/s 회전이 필요하면 요 제어(최대 요 속도·롤 보상)를 따로 다듬어야 한다.

## 5. 모터 한계 검증

| 케이스 | LQI6 예산 hip / 바퀴 | 한계 hip / 바퀴 | 회복 실패 | 2 W 밀기: 피치 / hip / 바퀴 최대 | 25° 기울기: 피치 / hip / 바퀴 최대 |
|---|---|---|---|---|---|
| `demand_15kg`(한계 없음) | 30 / 12.5 | – | `yaw_2.0` | 5.7° / 14.0 / 6.7 | 25.3° / 9.4 / 6.8 |
| `clamp_15kg_12_5` | 30 / 12.5 | 12 / 5 | 없음 | **7.7°** / 12.0 / 5.0 (포화) | 25.3° / 9.4 / 5.0 (포화) |
| `clamp_15kg_15_6` | 30 / 12.5 | 15 / 6 | 없음 | 5.8° / 14.1 / 6.0 (바퀴 포화) | 25.3° / 9.4 / 6.0 (포화) |
| `clamp_15kg_20_8` | 30 / 12.5 | 20 / 8 | `yaw_2.0` | 5.7° / 14.0 / 6.7 | 25.3° / 9.4 / 6.8 |
| `clamp_15kg_design20_8` | 20 / 8 | 20 / 8 | `yaw_2.0`, `slope_10_up`, `slope_15_up` | 7.9° / 12.9 / 6.5 | 25.3° / 8.5 / 5.4 |

- 12/5 N·m에서도 모든 시나리오를 통과한다. 다만 큰 외란에서 한계에 걸린 채 버티는 것이라, 시뮬에 없는 충격(턱, 착지)이나 질량 오차에 여유가 없다. 그래서 "최소"로 둔다.
- 20/8 N·m에서는 측정된 요구량이 모두 한계 안에 든다. 권장 최대 토크를 hip 20, 바퀴 7~8로 정한 근거다.
- 제어기 예산을 20/8로 낮추면(더 부드러운 튜닝) 최대 토크는 3~20 % 줄지만(25° 기울기 바퀴 6.8 → 5.4, 2 W 밀기 hip 14.0 → 12.9), 밀기 피치가 약 1.4배 커진다(2 W 5.7° → 7.9°). 경사 오르막 두 건은 넘어지지 않았지만 마지막 1 s 피치가 3°를 넘어 "회복"으로 세지 않았다. 권장 사양은 6 kg과 같은 튜닝(예산 30/12.5) 기준이다.

## 6. 권장 사양의 근거와 모터 선택

**hip 모터 ×4**
- 정격 ≥ 10 N·m: 다리 하중은 서 있는 동안 계속 걸리므로 정격이 핵심이다. 가장 낮은 자세 6.7 N·m, 웅크린 채 주행 RMS 6.4 N·m에 약 1.5배 여유를 뒀다(발열·탑재물 추가·무게중심 오차).
- 최대 ≥ 20 N·m: 측정 최대 14.0~14.5에 약 40 % 여유.
- 속도 ≥ 10 rad/s, 토크 모드, 역구동성이 좋은 구조(다이렉트 드라이브 또는 약 10:1 이하 QDD), 출력축 절대 엔코더. DIABLO는 같은 역할에 다이렉트 드라이브(M1502D, 정격 9.6 / 스톨 17~20 N·m)를 쓴다.

**바퀴 모터 ×2 (R = 65 mm)**
- 정격 ≥ 2.5 N·m: 경사 15° 정지 1.22, 회전 중 RMS 2.07.
- 최대 7~8 N·m: 측정 최대 6.8~7.0. 그 이상은 바닥 마찰 한계에 막힌다.
- 속도 ≥ 60 rad/s(약 570 rpm), 순간 출력 바퀴당 200 W 이상. 30 rad/s 근처에서도 3~4 N·m를 낼 수 있어야 1 W 밀기 회복에서 토크가 모자라지 않는다. 이 시뮬레이션은 토크-속도 곡선을 넣지 않았으므로, 후보 모터의 곡선과 대조해야 한다.

**참고: 그동안 본 모터와의 비교**

| 모터 | 사양 | 판단 |
|---|---|---|
| mjbots qdd100 beta 3 | 최대 16, 연속 3.3 N·m | 15 kg에서는 hip에 부족: 기본 높이 유지 5.15 N·m가 연속 토크를 넘는다 |
| CubeMars AK80-9 V3.0 | 정격 9, 최대 22 N·m, 9:1, 490 g, 48 V | hip 권장치에 거의 맞음(정격 9 vs 권장 10). 드라이버 없는 버전이면 moteus로 구동 가능 |
| CubeMars AKE50-8 / AKE60-8 | 최대 7.5 / 12.5 N·m | hip에는 부족 |
| ODrive M8325s | 다이렉트 드라이브, 0.083 N·m/A(선형 계산 약 3.3 N·m @ 40 A, 6.6 N·m @ 80 A 3 s; 실제는 포화로 더 낮음), 840 g | 바퀴 후보. 최대 토크를 쓰려면 60~80 A 드라이버(moteus-x1 등)가 필요 |

## 7. 한계와 다음 단계

- 모터는 이상적인 토크원이다. 속도에 따른 토크 감소, 발열, 전류 한계, 기어 백래시·마찰 변화는 넣지 않았다.
- 15 kg 모델은 6 kg 모델의 질량 배분을 그대로 키운 것이다. 무게가 몸통 위쪽(팔, 라이다, 배터리)에 몰리거나 링크 길이·바퀴 반경이 바뀌면 `--mass`·`--wheel-radius`를 바꿔 다시 돌리거나, 모델 파라미터를 직접 정해 다시 산정해야 한다.
- 착지·턱 넘기·점프 같은 충격 하중은 시나리오에 없다(권장 최대 토크의 여유로 일부만 덮는다).
- Plan 4처럼 합격 기준 매트릭스(`docs/합격기준.md`, 질량·마찰 변동 × 시드)로 검증하지는 않았다. Plan 2를 15 kg으로 확정하면 다음 순서로 진행한다: 실제 모터를 고른 뒤 그 사양(질량, 토크-속도 곡선, 로터 관성)으로 모델을 만들고, LQI6 예산을 실제 한계로 다시 설계한 다음, 합격 기준 배터리를 Plan 2용으로 돌린다.
