wisehyun-2/my_robot_project/robot_cad_v5/v4/calc/strength_v4.md

# v4 강도 손계산 — SLA 레진 허벅지·정강이 (`python calc/strength_v4.py`)

하중은 v3와 같다(브리프: 로봇 7 kg + 짐 5 kg): 정지 60 N/바퀴, 설계 300 N, 검토 600 N(안전계수 2), 옆 150 / 300 N, 관절 토크 설계 12.5 / 검토 25 N·m.  응력은 검토 하중으로, 처짐은 설계 하중으로 본다.  계산식은 `robot_cad_v3/calc/strength.py`(1절 상자·접지점 3차원 모멘트, 1b절 원판)와 같다.

재료(사용자 자료, 11-01): SLA 유사ABS 검정 레진 — 밀도 1.20, 인장 41~58 MPa, 인장 탄성 2731 MPa, 굽힘 69~76 MPa, 연신 11 %, HDT 60 °C(0.45 MPa).  전단 탄성은 ν 0.35로 1011 MPa.  **판정은 낮은 쪽 값**: 링크 보(굽힘 + 비틀림 + 축력)는 인장 41, 판·보스 굽힘은 굽힘강도 69 MPa와 비교.

## 1. 링크 단면 — 왜 넓히고, 왜 닫힌 상자 + 트러스인가

SLA는 속을 채워 출력하므로 꽉 찬 링크는 레진(=값)과 무게만 늘고, 옆 강성은 단면의 바깥 치수가 정한다(옆 굽힘 ∝ 폭³, 비틀림 ∝ 둘러싼 넓이²).  그래서 v2 PETG처럼 바깥쪽으로 넓히고(허벅지 30 → 76, 정강이 30 → 55 mm), 속은 비운 닫힌 상자에 대각선 리브(와렌 트러스)를 넣었다.  옆이 뚫린 평면 트러스는 비틀림이 거의 0이라 이 다리에 맞지 않는다(v3 1절: 기운 링크에서 옆 하중의 상당 부분이 비틀림).  "보 질량"은 175 mm 보 부분만(관절 자리 제외), 리브는 단면마다 하나가 대각선으로 걸린다고 보고 옆 굽힘에만 넣었다.

| 단면 | 링크 끝 옆 처짐 허벅지 / 정강이 [mm] (한계 1) | 접지점 옆 변위 [mm] (비틀림) | 검토 응력 / 강도 [MPa] | 면판 압축 / 좌굴 [MPa] (폭 56) | 보 질량 [g] | 판정 |
| --- | --- | --- | --- | --- | --- | --- |
| SLA, v3 폭(30 mm), 꽉 채움 | 2.58 / 1.76 | 20.0 (8.9) | 20 / 41 | - | 668 | **초과** |
| SLA, 넓힌 외형, 꽉 채움 | 0.40 / 0.42 | 7.1 (4.0) | 16 / 41 | - | 1176 | 통과 |
| SLA, 넓힌 상자 벽 2.5 | 1.11 / 1.19 | 12.7 (5.0) | 34 / 41 | 24 / 20 | 212 | **초과** |
| SLA, 넓힌 상자 벽 2.5 + 리브 2 | 0.99 / 1.08 | 12.0 (5.0) | 32 / 41 | 23 / 41 (리브 칸) | 270 | **초과** |
| SLA, 넓힌 상자 벽 3.0 | 0.96 / 1.02 | 11.0 (4.3) | 29 / 41 | 21 / 29 | 252 | **초과** |
| **SLA, 넓힌 상자 벽 3.0 + 리브 2.0 (v4)** | 0.87 / 0.94 | 10.5 (4.3) | 28 / 41 | 20 / 59 (리브 칸) | 308 | 통과 |
| SLA, 넓힌 상자 벽 4.0 + 리브 2 | 0.72 / 0.77 | 8.6 (3.5) | 23 / 41 | 17 / 104 (리브 칸) | 384 | 통과 |
| 참고: v3 6061 상자 (30 mm, 벽 2.5 / 덮개 3) | 0.20 / 0.14 | 1.2 (0.4) | 42 / 276 | - | 391 | 통과 |

- v3 폭(30 mm)으로는 레진을 꽉 채워도 링크 끝이 2.6 mm 휜다 — **넓히는 것이 먼저**다.  넓힌 외형은 꽉 채우면 처짐 0.4 mm지만 보 부분만 1.2 kg(링크 4개 약 2.8 kg)이라 값·무게가 맞지 않는다.
- **면판 좌굴**: 옆 굽힘에서 눌리는 면판(폭 최대 56 mm)은 리브가 없으면 긴 판으로 좌굴한다(k = 4) — 벽 2.5는 좌굴 20 MPa로 검토 압축보다 낮아 리브 없이는 안 된다.  리브가 면판을 삼각형 칸(변 약 45~55 mm)으로 나누면 좌굴 응력이 대략 2배(k ≈ 8: 벽 2.5 41, 벽 3.0 59 MPa)가 된다.  v4 벽 3.0는 리브 없이도 29 MPa로 버티지만 리브 칸 기준 여유가 약 3.0배다 — **트러스 리브의 실제 몫은 얇은 벽이 좌굴하지 않게 붙잡는 것**이고, 리브가 더하는 옆 강성은 10 % 안팎이다.
- v4(벽 3.0 + 리브 2.0): 링크 끝 옆 처짐 0.87 / 0.94 mm(v2 PETG 0.95 / 1.00), 접지점 옆 변위 10.5 mm(v2 PETG 12.8, v3 6061 1.3), 검토 응력 28 MPa < 41.  비틀림이 접지점 변위의 41 %로 여전히 크다 — 더 줄이려면 면내 높이를 키워야 한다(+10 mm면 약 8.7 mm, 자세 스윕 다시 필요).
- Fusion 실측(한쪽, 관절부 포함, 11-02 구멍 없앤 뒤): 허벅지 254.3 cm³ = **305 g**, 정강이 223.7 cm³ = **268 g** — v3 6061 377 / 394 g, v2 PETG 424 / 381 g.  레진은 링크 4개 956 cm³(SLA 견적은 보통 레진 부피·높이로 정해진다).

## 2. 레진 관절부 (v2 출력 설계: 모터 판 9 mm, SUS 클램프 링, 접착 인서트)

| 부위 | 응력 | 판정 |
| --- | --- | --- |
| knee 모터 판 9 mm (r 22.8 → 37), 검토: 관절 모멘트 94 N·m | 바깥 고정 22 / 단순 지지 32 MPa (리드 홈 자리 7 mm: 52) | 통과 |
| knee 모터 판 9 mm (r 22.8 → 37), 설계: 관절 모멘트 47 N·m | 바깥 고정 11 / 단순 지지 16 MPa (리드 홈 자리 7 mm: 26) | 통과 |
| wheel 모터 판 9 mm (r 22.8 → 37), 검토: 관절 모멘트 53 N·m | 바깥 고정 12 / 단순 지지 18 MPa (리드 홈 자리 7 mm: 30) | 통과 |
| wheel 모터 판 9 mm (r 22.8 → 37), 설계: 관절 모멘트 27 N·m | 바깥 고정 6 / 단순 지지 9 MPa (리드 홈 자리 7 mm: 15) | 통과 |
| hip 구동 보스 Ø28(레진), 옆 하중 검토: Mx 133 N·m | 굽힘 68 MPa; M3 12.9 인장 4420 N → SUS 출력 링 밑 레진 최대 면압 53 MPa(퍼짐 18 mm) | 통과 |
| hip 구동 보스 Ø28(레진), 옆 하중 설계: Mx 66 N·m | 굽힘 34 MPa; M3 12.9 인장 2210 N → SUS 출력 링 밑 레진 최대 면압 26 MPa(퍼짐 18 mm) | 통과 |
| knee 구동 보스 Ø28(레진), 옆 하중 검토: Mx 95 N·m | 굽힘 49 MPa; M3 12.9 인장 3170 N → SUS 출력 링 밑 레진 최대 면압 38 MPa(퍼짐 18 mm) | 통과 |
| knee 구동 보스 Ø28(레진), 옆 하중 설계: Mx 48 N·m | 굽힘 24 MPa; M3 12.9 인장 1585 N → SUS 출력 링 밑 레진 최대 면압 19 MPa(퍼짐 18 mm) | 통과 |
| knee 고정링 M2.5 8.8, 옆 하중 검토: Mx 95 N·m | 인장 1737 N (보증 2034) → SUS 고정 링 밑 레진 최대 면압 21 MPa(퍼짐 18 mm), 허벅지 모터 판 | 통과 |
| wheel 고정링 M2.5 8.8, 옆 하중 검토: Mx 53 N·m | 인장 970 N (보증 2034) → SUS 고정 링 밑 레진 최대 면압 12 MPa(퍼짐 18 mm), 정강이 모터 판 | 통과 |
| 구동 보스 ← 출력, 토크 25 N·m(검토) | M3 6 + 다웰 3 (r 10): 개당 278 N | 레진 구멍 지압 10.1 MPa (보스 9.2 mm) | 통과 |
| 고정링 → 레진 모터 판, 토크 25 N·m(검토) | M2.5 6 (r 18.25): 개당 228 N | 레진 구멍 지압 32.6 MPa (포켓·링 자리 사이 2.8 mm, 마찰 무시) | 통과 |

- **hip 구동 보스 Ø28이 가장 빠듯하다**: 검토 68 MPa로 굽힘강도 69와 거의 같다(설계 하중에서 34 MPa, 안전계수 약 2).  v2 PETG도 같은 자리에서 SF 2 검토를 넘었다(68 / 45).  Ø28은 hip 판 Ø30 구멍이 정해서 키울 수 없다 — 실물에서 걱정되면 보스만 6061 선반 부품(링크에 M3로 체결)으로 바꾸는 길이 있다(5절).
- 모터 판 9 mm는 리드 홈 자리에서도 검토 하중 굽힘강도 안이다(무릎 52 MPa).  SUS 클램프 링이 나사 힘을 퍼뜨려 레진 면압을 낮춘다 — 링이 없으면 M2.5 머리 바로 밑이 100 MPa를 넘는다.
- 레진은 오래 눌리면 서서히 줄어든다(크리프).  **조임 토크를 금속보다 낮게**: 출력 M3 12.9는 1.0 N·m(약 1.7 kN), 고정링 M2.5는 0.5 N·m 정도로 두고 나사 고정제(중강도)를 쓴다.  처음 몇 주는 풀림을 다시 확인.

## 3. 열 — HDT 60 °C

v3는 knee·wheel 모터가 6061 링크에 붙어 열이 금속으로 빠졌지만, v4는 v2처럼 수지에 붙는다.  AKE60-8 구리 손실은 정격 5 N·m에서 약 10 W(v3 strength.md 4절) — 계속 정격을 내면 고정자 링 면이 60 °C를 넘을 수 있고, 그 온도에서 레진 모터 판은 고정링 나사 체결력에 눌려 변형된다.  실물에서 서 있기·주행 뒤 **모터 링 면 온도를 재서 50 °C 밑**인지 확인할 것.  넘으면 (a) 무릎·바퀴 모터 자리만 6061 링(선반, 레진 판에 끼워 같은 M2.5로 체결)으로 바꾸거나 (b) 고온용 레진(HDT 80 °C 이상)으로 출력한다.

## 4. 출력 메모

- 한 덩어리 출력(덮개 없음).  11-02부터 배선 창·리브 채널·배수 구멍이 없어 칸 4개가 모두 닫혀 있다(Fusion: 링크마다 셸 5개 = 바깥 1 + 닫힌 빈 공간 4).  질량·강도는 **칸 안에 레진이 남지 않는다고 가정**했다(사용자 11-02).  출력 업체가 배수 구멍을 요구하면 그 자리를 정해야 한다.
- Ø42.05 모터 포켓·Ø3 다웰 구멍은 출력 오차(±0.1~0.2)가 있으니 실물에 맞춰 사포·리머로 맞춘다.  M2.5 인서트는 열압입이 안 되므로(열경화 수지) 에폭시로 붙인다.
- 모델에 배선이 없다(사용자 11-02).  링크 안으로 선을 넣을 길이 없으므로 다리 선은 링크 바깥으로 둘러야 한다.

## 5. 더 단단하게 / 더 싸게 하려면 (결정할 것)

1. 면내 높이 +10 mm(허벅지 60, 정강이 66): 접지점 변위 10.5 → 약 8.7 mm.  자세 스윕을 다시 봐야 한다.
2. hip 구동 보스만 6061 선반 부품: 보스 굽힘 여유 4배, 가공비는 링크 가공의 몇 분의 1.
3. 열이 문제면 무릎·바퀴 모터 자리 6061 링(3절).
