wisehyun-2/my_robot_project/robot_cad_v5/manufacturing/drawings/electronics_deck.pdf

## +y(바깥)에서 본 그림

## 위(+z)에서 본 그림

## 앞(-x, 스위치 쪽)에서 본 그림

110.0 (x)

32.4 (z)

243.5 (y)

주기

1. 단위 mm, 3각법이 아닌 CAD 축 방향 그림(그림 이름 참고, 로봇 앞 = -x). 전체 크기만 적었다 — 형상의 원본은 STEP (export/parts_step/electronics_deck_L, electronics_deck_R.step, CAD 좌표).
2. 부피 62.7 cm³. v4 부품(v5 전장 배치)을 y 80(라즈베리파이와 +y 끝 창 사이)에서 두 조각으로 나누고 이음 턱 두 장을 붙임 — 턱은 리브 바깥 면까지(x ±41.5, 셸 바닥 경사와 1.5 mm; split_v5.py, 사용자 11-09)(robot_cad_v4
코드로 만듦).
3. 두 조각으로 출력(사용자 11-09: 베드 300 × 300): y 80에서 잘라 각 조각의 자른 면 바닥 밑에 이음 턱 3 × 8 mm. 두 턱을 맞대고 ISO 7380 M3 × 10 + DIN 934 M3 2쌍(x -25, +25, 머리는 -y 조각 쪽)으로 조인다 — 원하면 턱 면을 접착. 왼쪽(_L) = CAD -y 조각, 오른쪽(_R) = +y 조각, 서로 다른 모양.
품명 | 전장 데크 왼쪽 조각 (electronics_deck_L) | 도번 | WBv5-S12 (1/2)
재질 | PLA 또는 PETG | 수량 | 왼 1 + 오른 1 (두 조각)
공정 | 3D 프린트 30 %, 두 조각, 보스를 위로 | 척도 | 1:2
후처리 | - | 투상 | 3각법
STEP | ../export/parts_step/electronics_deck_L.step | 일반 공차 | KS B ISO 2768-mK / 출력 ±0.2
프로젝트 | WheelBiped v5 (robot_cad_v5) | 작성일 | 2026-11-08

## +y(바깥)에서 본 그림

## 위(+z)에서 본 그림

## 앞(-x, 스위치 쪽)에서 본 그림

110.0 (x)

32.4 (z)

83.5 (y)

주기

1. 단위 mm, 3각법이 아닌 CAD 축 방향 그림(그림 이름 참고, 로봇 앞 = -x). 전체 크기만 적었다 — 형상의 원본은 STEP (export/parts_step/electronics_deck_L, electronics_deck_R.step, CAD 좌표).
2. 부피 20.8 cm³. v4 부품(v5 전장 배치)을 y 80(라즈베리파이와 +y 끝 창 사이)에서 두 조각으로 나누고 이음 턱 두 장을 붙임 — 턱은 리브 바깥 면까지(x ±41.5, 셸 바닥 경사와 1.5 mm; split_v5.py, 사용자 11-09)(robot_cad_v4
코드로 만듦).
3. 두 조각으로 출력(사용자 11-09: 베드 300 × 300): y 80에서 잘라 각 조각의 자른 면 바닥 밑에 이음 턱 3 × 8 mm. 두 턱을 맞대고 ISO 7380 M3 × 10 + DIN 934 M3 2쌍(x -25, +25, 머리는 -y 조각 쪽)으로 조인다 — 원하면 턱 면을 접착. 왼쪽(_L) = CAD -y 조각, 오른쪽(_R) = +y 조각, 서로 다른 모양.
품명 | 전장 데크 오른쪽 조각 (electronics_deck_R) | 도번 | WBv5-S12 (2/2)
재질 | PLA 또는 PETG | 수량 | 왼 1 + 오른 1 (두 조각)
공정 | 3D 프린트 30 %, 두 조각, 보스를 위로 | 척도 | 1:1
후처리 | - | 투상 | 3각법
STEP | ../export/parts_step/electronics_deck_R.step | 일반 공차 | KS B ISO 2768-mK / 출력 ±0.2
프로젝트 | WheelBiped v5 (robot_cad_v5) | 작성일 | 2026-11-08
