wisehyun-2/my_robot_project/wheeled_biped/docs/plan4_mpc_host.md

# Plan 4 2단계: 호스트 MPC 기준 생성기

작성 2026-10-23(검토 1라운드 반영판: 이전 판의 "시점 A/B/C" 설계 기록은 `docs/review_plan4_mpc_r1.md`·`docs/review_plan4_r1_response.md`와 git 이력에 있다). 대상: Plan 4(upkie 하드웨어 + LQI8 + DIABLO식 호스트/MCU 분리)의 호스트 쪽 MPC 기준 생성기. 기존 `HostEmulator` 자리에 들어가 MCU의 LQI8 균형기 위에서 속도 기준만 만든다. 코드는 `wbr/controllers/mpc_host/`(`model.py` 예측 모델, `reference_mpc.py` MpcHost·QP·한계 유도·관측기·폴백, `fallback.py` 1단계 성형, `identify.py` 모델 검증), 합격 시험 연결은 `wbr/bench/acceptance_mpc.py`, 결과는 `results/acceptance/plan4_mpc_<rate>Hz.md|json`과 `results/plan4_mpc/`(`model_fit.png/json`), 모델 JSON은 `models/upkie_plan4/plan4_closed_loop.json`.

```
python -m wbr.controllers.mpc_host.identify                                            # 모델 검증 그림·JSON
python -m wbr.bench.acceptance --rate both --matrix full --seeds 5 --reference --tag r4_s1   # 1단계(20번 비교의 기준)
python -m wbr.bench.acceptance --host mpc --stage2 --rate both --matrix full --seeds 5 --tag r4_s2
python -m wbr.bench.acceptance_mpc 1000                                                # 8·9·13·19 제약 점검(공칭)
```

## 0. 요약

| 항목 | 결과 |
|---|---|
| 구조 | 50 Hz 호스트, 1.5 s 구간(75단) QP. MotionCtrl(forward = 최적 기준 궤적의 첫 값, left 통과, up 다리 길이 범위로 클립, pitch = 0, roll·leg_split = 0) → MCU LQI8. **MPC에 적분기 없음** |
| 내부 루프(MPC 모드) | `host_shaped = True` → LQI8 플레인 추종(4 m/s² 램프로 기준을 따라붙음, 전치 필터 없음). **기준이 가속하는 동안(저역통과 0.1 s 가속도 > 0.1 m/s²) 적분기 z·z_att·z_pos 전부 동결**(`freeze_int_on_accel_plain`). 타임아웃·QP 실패 때는 플래그 거짓 → 1단계 성형(램프 2 + 전치 필터 0.3 s + 동결) |
| 예측 모델 | (a) 선형 폐루프 축약, **기동 영역의 적분기 없는 상태 되먹임 루프**(플랜트 5상태 + 10 ms 관측 지연 → 1 kHz 55상태 / 200 Hz 15상태 → 20 ms 리프팅 → 균형 절단 1 kHz 4차·200 Hz 5차). 속도 스텝 rms 오차 0.025~0.027 m/s(0.5 m/s의 5 %), 피치 0.32~0.38°; 실측 피치 피크가 모델의 1.18~1.30배(건마찰·5 ms 속도 창) |
| 제약 | \|r\| ≤ 1.0 m/s; 가속 \|a\| ≤ a_max = **0.889 / 0.884 m/s²**(1 kHz / 200 Hz; 19번 피치 예산 (2° − 0.5°)/모델 오차 계수 1.3이 결정); **제동**(로봇의 예측 속도와 반대 방향) ≤ a_dec = 1.17 a_max = **1.040 / 1.035**; 저크 \|Δa\| ≤ j_max T, j_max = a_max/0.10 s = 8.9; up은 다리 길이 [0.24, 0.335] m로 클립 |
| 텔레메트리 보정 | 기동 중(목표 ≠ 0, 끝난 뒤 `obs_hold_s` 1.0 s, 그 뒤에도 텔레메트리 속도 > 0.05 m/s면 최대 3 s까지 — 3라운드 m2)에만, 20 ms 평균 est.v로 축약 모델의 가장 느린 모드를 칼만 보정(σ_z 0.0005, 관측기 극 0.91/20 ms ≈ 0.22 s). **혁신 \|y − ŷ\| > 0.1 m/s는 외란으로 보고 보정하지 않음**, 목표 \|v*\| < 0.02 m/s는 정확히 0 |
| QP | 변수 75, 부등식 300 + 상하한 150, qpmpc 응축 + DAQP(warm start), OSQP 백업(시간 제한 = 주기의 절반 10 ms). 풀이 시간은 7절 22번 |
| 폴백 | QP 실패·비가용 → 그 주기부터 원시 목표 + `host_shaped = False`(MCU 1단계 성형), 이벤트 기록. 복귀: 1 s 뒤 내부 램프 \|a\| < 0.05 m/s², \|측정 속도 − 목표\| < 0.1 m/s이면 MCU 텔레메트리 `v_ref`로 재동기한 뒤 QP 재시도 |
| 2단계 결과 | 7절(전체 매트릭스 9조합 × 5시드 × 2주기). 1단계와 같은 실패(16·17)는 내부 루프 문제 |
| 얇은 여유 | 19번(정지 명령 후 **최대 이탈** ≤ 0.3 m 그리고 피치 ≤ 2°)은 질량 ±15 %에서 여유가 몇 %뿐이다: 내부 루프가 기준을 0.26 s 늦게 따르므로(0.5 m/s에서 0.13 m) 제동 한계가 정지 거리를, 무거운 로봇의 제동 피치가 제동 한계를 정한다. 2라운드 검토 뒤 넘김 시간 1.0 s + 제동 계수 1.17로 두 주기 모두 통과(3.4절·7절); 1라운드 반영판의 "물리적 한계" 결론은 틀렸다 |

## 1. 구조와 데이터 흐름

```
 사용자 목표: forward v*(목표 속도), left(요 속도), up(높이)            plan.step(v, w) → host.set_command(...) 매 MCU 스텝
        │
        ▼
 ┌──────────────────────── MpcHost (호스트 프로세스, 50 Hz 고정 격자 게시) ─────────────────────────────────────┐
 │ ① 목표 데드밴드(|v*| < 0.02 → 0) → 기준 모델(임계 감쇠 2차): 원하는 응답 v_d(t)(가속 ω 3.5, 감속 ω 10 rad/s)    │
 │ ② 예측 상태 x̂(축약 폐루프 4~5차): 자신이 보낸 r로 전파 + 기동 중에만 텔레메트리 속도로 칼만 보정(혁신 게이트) │
 │ ③ QP(qpmpc 응축 + DAQP, OSQP 백업, warm start): 1.5 s 구간 75단 기준 궤적 → 첫 값 r_0 송신                   │
 │    단계별 가속도 상하한: 로봇 예측 속도와 반대 방향(제동)은 a_dec, 그 외 a_max; 저크 상하한; |r| ≤ v_max         │
 │ ④ 폴백: QP 실패/솔버 없음 → 원시 목표 + host_shaped = False (MCU 1단계 성형), 이벤트 기록, 조건부 복귀         │
 └──────────────────────┬──────────────────────────────────────────────────────────────────────────────────────┘
                        │ link.receive(MotionCtrl(forward = r_0, left = 통과, up = 클립, pitch = roll = leg_split = 0,
                        │                         host_shaped = True), t)
                        ▼
 HostLink (500 ms 타임아웃 → MCU 단절 프로그램, host_shaped = False)   ▲ 텔레메트리 plan.mcu.est: v, v_ref(MCU 자체 기준),
                        ▼                                            │ position, pitch, pitch_rate, theta_v_mean, L0_mean
 MCU 1 kHz / 200 Hz: 추정기 → LQI8(플레인 추종, 기동 중 적분기 동결) → 다리 PD·VMC → 토크
```

- 호스트는 LQI8을 대체하지 않는다. 내려보내는 것은 속도·요·높이 기준뿐이고 피치 기준은 항상 0(`pitch_ctrl_mode = False`), roll·leg_split도 0으로 고정한다(사양 "속도·요·높이만").
- 호스트가 읽는 실행 중 정보는 `plan.mcu.est`(텔레메트리)뿐이다. 모델·이득·MCU 주기·지연은 설계 정보(같은 펌웨어의 이득표, 설정 지연 `latency_ms` — 실기에서는 측정 지연으로 바꿀 것)로 쓴다. 시뮬레이터 상태는 쓰지 않는다(`Plan4LQI8._obs_to_mcu`가 참값 키를 제거하고, 호스트는 MCU 추정만 본다).
- 정지 중(목표 0이고 기동이 끝난 뒤)에는 기준이 정확히 0이고 보정도 하지 않는다. 그래서 목표 0인 항목(1~7, 9, 10, 12, 15~17)은 1단계와 같은 내부 루프 응답이다(1단계 HostEmulator도 고정 격자 50 Hz로 게시하므로 20번 비교는 같은 호스트 주기에서 이루어진다).
- 사양 범위 검사: 호스트 주기 50~100 Hz, 구간 1~2 s, MCU 주기의 정수배가 아니면 생성 시 `ValueError`(조용히 꺼지지 않음). 내부 폐루프가 불안정하면(지연 ≥ 20 ms) 예측 모델이 무의미하므로 MPC를 끄고 1단계 성형만 쓴다(이벤트).
- 인터페이스(`reference_mpc.MpcHost`): `MpcHost(link, plan, publish_hz=50, horizon_s=None, config=MpcConfig())`; `set_command(**fields)`, `tick(t)`, 속성 `enabled`, `cmd`, `sent`, `violations`, `solve_times_ms`, `qp_failures`, `solver_failures`, `fallback_used`, `force_fail`, `events`, `trace`, `corrections`, `gated_corrections`, `stats()`.

## 2. 예측 모델

### 2.1 선택: (a) 선형 폐루프 축약

플랜트와 이득이 모두 알려져 있으므로(`plan.plant.linearize(L0)`, MCU 이득표) 해석 모델을 쓴다. 비최소 위상(가속하려면 먼저 몸을 앞으로 기울임)과 지연·피치 응답을 그대로 담고, 이득표에서 실행 시점에 다시 만들기 때문에 내부 루프의 이득·구조가 바뀌어도 따라간다. (b) 2차계 피팅은 비최소 위상과 피치를 표현하지 못한다(3~4차 축약과 비교: 아래 표).

### 2.2 기동 영역의 내부 루프 = 적분기 없는 상태 되먹임 (검토 1라운드 M4)

MCU의 LQI8은 호스트 기준이 움직이는 동안 **모든 적분기를 동결**한다(`lqi8.py`: `freeze_int_on_accel_plain`, z_att는 그 전부터 같은 조건으로 게이팅). 그래서 MPC가 예측해야 하는 폐루프는 u = −K_5 [θ, θ̇, v − r, φ, φ̇]의 순수 상태 되먹임 루프다(`model.lqi8_options(ctrl, L0)` → `use_int = False`, `att_gM = None`, `use_pos = False`, `select_gains`가 K의 앞 5열만 쓴다). 적분기를 포함한 모델(1라운드 전)은 가속 중 z_att가 적분한다고 보아 스텝 피치 피크를 1.8° 대 실제 1.0°로 과대 예측했다. 적분기가 다시 켜지는 것은 가속이 끝난 뒤(순항·정지)이고, 그때의 잔류 속도 오차는 MCU의 z가 없앤다(선형 무마찰 모델의 r → v 정상상태 이득은 1.017: 관절 점성 감쇠를 이기는 정상 토크 때문).

구성(`model.py lqi8_closed_loop`): 플랜트 5상태 s = [θ, θ̇, v, φ, φ̇]를 MCU 주기로 ZOH 이산화(`LQI8.design`과 같은 c2d), 측정 e = s_{k−d}(관측 지연 d = 10 ms = 1 kHz 10스텝 / 200 Hz 2스텝), u_k = −K_5[e_θ, e_θ̇, e_v − r_k, e_φ, e_φ̇]. 상태 수 1 kHz 5 + 50 = 55, 200 Hz 5 + 10 = 15. 입력 r(LQI8이 쓰는 기준), F(전체 무게중심 수평 힘, 밀기 검증용), Tf(바퀴 외란 토크). 출력 v(텔레메트리 est.v), v_base(= 판정 vx = v + L0 cos θ_eq θ̇ − h_b φ̇, h_b 0.164 m), pitch(= −φ), θ, T, Tp. 호스트 주기 리프팅(20 ms 동안 r 고정) 뒤 제곱근 균형 절단 + DC 맞춤(채널 가중 r 1 m/s ~ Tf 0.05 N·m, v_base 0.1 m/s ~ 피치 1°), 차수는 단위 스텝 오차가 속도 1 %·피치 0.1° 이하가 되는 최소값 자동 선택.

| 차수 | 3 | 4 | 5 |
|---|---|---|---|
| 1 kHz: v_base / 피치 단위 스텝 rms 오차(전차 대비) | 4.95 % / 0.55° | **0.62 % / 0.046°** | — |
| 200 Hz | 7.59 % / 0.96° | 1.05 % / 0.064° | **0.25 % / 0.018°** |

정지 영역(`regime = "rest"`: 모든 적분기 활성)의 모델은 밀기 응답 비교에만 쓴다(2.3절). MPC는 쓰지 않는다.

### 2.3 검증: 모델 대 시뮬레이션(`identify.py`, 그림 `results/plan4_mpc/model_fit.png`, 수치 `model_fit.json`)

내부 루프를 MPC 모드 그대로(HostEmulator가 `host_shaped = True`를 보냄 → 플레인 추종 + 가속 중 동결) 두고 ① 0 → 0.5 m/s 속도 스텝(MCU 4 m/s² 램프, 2.5 s 유지 후 0), ② 서 있는 상태에서 0.5 W 밀기(0.1 s)를 돌렸다. 모델 입력은 LQI8이 실제로 쓴 기준(`law.ctrl.v_filt`, 매 스텝 기록)과 같은 밀기 힘. 오차는 사건 이후 구간 rms(모델 − 시뮬), 피치는 실제 몸체 피치. 스텝은 기동 모델, 밀기는 정지 모델(적분기 활성)과 비교한다(정지 중 밀기는 호스트가 아무것도 하지 않는 영역이다).

| 조건 | 주기 | 스텝 v_base rms | 스텝 피치 rms | 스텝 피치 피크 시뮬 / 모델 | 밀기 v_base rms(정지 모델) | 밀기 피치 rms | 축약 모델 스텝 v_base |
|---|---|---|---|---|---|---|---|
| A 사양: 노이즈 끔, 지연 0 | 1 kHz | 0.026 m/s (5.1 %) | 0.35° | 2.11° / 1.71° | 0.025 m/s | 0.23° | 0.026 |
| B 합격 조건: 노이즈, 10 ms | 1 kHz | 0.025 (5.0 %) | 0.34° | 2.10° / 1.78° | 0.028 | 0.21° | 0.025 |
| C = B − 관절 건마찰 | 1 kHz | **0.009 (1.9 %)** | 0.17° | 1.70° / 1.78° | 0.031 | 0.18° | 0.010 |
| A | 200 Hz | 0.027 (5.4 %) | 0.38° | 2.23° / 1.72° | 0.026 | 0.24° | 0.028 |
| B | 200 Hz | 0.025 (5.0 %) | 0.32° | 2.20° / 1.80° | 0.024 | 0.21° | 0.026 |
| C | 200 Hz | 0.011 (2.1 %) | 0.18° | 1.79° / 1.80° | 0.007 | 0.10° | 0.011 |

(2라운드 반영판 `model_fit.json`; 적분기 동결 유지 시간 0.1 s가 들어가 1라운드 반영판보다 속도 오차가 0.029 → 0.025 m/s로 조금 줄었다.)
- 속도 채널은 15 % 기준 안(5.0~5.4 %, 마찰 제거 시 1.9~2.1 %)이므로 (b)로 넘어가지 않았다. 축약 모델(호스트가 실제로 쓰는 것)의 오차는 전차 모델과 같다.
- **피치 피크는 실측이 모델의 1.18~1.29배**(건마찰이 없으면 0.95~0.99배). 원인은 관절 건마찰(가속 시작의 데드밴드)과 5 ms 위치 차분 속도의 추가 지연이다. 이 비를 가속도 한계 유도의 **모델 오차 계수 `pitch_model_factor` 1.3**으로 반영한다(3.1절).
- 기동 모델로 밀기를 예측하면 rms 0.10 m/s로 틀린다(정지 중에는 적분기가 살아 있으므로): 영역을 나눠 비교하는 이유이고, 호스트가 정지 중에 보정을 하지 않는 이유다.

## 3. 제약 유도

### 3.1 가속도 한계 a_max (`derive_limits`)

기준 가속도 a(시작 저크 j = a / 0.10 s)의 두 기동을 2.2절의 전차 폐루프 모델(5 ms 분해능)에 넣고 피크를 a의 함수로 구한 뒤 이분법으로 한계를 찾는다. 피치 예산은 모델 오차 계수 1.3으로 나눈다.

| 한계 | 예산(모델 기준) | 1 kHz | 200 Hz |
|---|---|---|---|
| 바퀴 토크 a_T(반전 −1 → +1 m/s) | (1.36 − 정지 중 잡음 토크 0.30) / 질량 +15 % = 0.922 N·m/바퀴 | ≥ 3.2(상한 a_mcu에서 잘림; a = 3에서 0.53 N·m) | ≥ 3.2 |
| 피치(일반, 8·13번) a_p,gen(반전) | (5° − 0.5°) / 1.3 = 3.46° | 2.34 | 2.31 |
| **피치(19번 기동 0 → 0.5) a_p,step** | (2° − 0.5°) / 1.3 = **1.154°** | **0.889** | **0.884** |
| 다리 기울기 a_lean(반전) | 0.8 × 32°(발목 하우징 접촉) = 25.6° | ≥ 3.2 | ≥ 3.2 |
| MCU 램프 a_mcu | 0.8 × 플레인 램프 4 m/s² | 3.2 | 3.2 |
| **a_max** | min | **0.889 m/s²** | **0.884 m/s²** |
| j_max = a_max / 0.10 s | | 8.89 m/s³ | 8.84 |
| **제동 a_dec = 1.17 a_max** | 3.4절(시험으로 맞춘 값) | **1.040** | **1.035** |

a_max에서의 모델 피크: 19번 기동 바퀴 T/2 0.149 N·m, 피치 1.153°(예산), 다리 기울기 5.8°; 반전 기동 0.193 N·m, 1.59°, 7.1°. 계수 1.3은 공칭 질량의 identify 스텝(실측/모델 1.18~1.29, 2.3절) 기준이고, m×1.15에서는 19번 실측 제동 피치 1.90~1.98°가 모델 예산 1.153°의 1.65~1.72배로 계수를 넘는다 — 그 초과분은 예비분 0.5°가 흡수한다(1.3 × 1.153° = 1.5° = 2° − 0.5°; 2라운드 n6). 모델의 피크 표(1 kHz; 200 Hz는 ±1 % 안):

| a [m/s²] | 0.25 | 0.5 | 1.0 | 1.5 | 2.0 | 3.0 |
|---|---|---|---|---|---|---|
| 0 → 0.5 m/s: 바퀴 T/2 [N·m] | 0.053 | 0.096 | 0.160 | 0.200 | 0.223 | 0.248 |
| 0 → 0.5 m/s: 피치 [°] | 0.44 | 0.77 | 1.23 | 1.47 | 1.59 | 1.70 |
| 반전: 바퀴 T/2 [N·m] | 0.081 | 0.125 | 0.213 | 0.302 | 0.383 | 0.530 |
| 반전: 피치 [°] | 0.69 | 1.04 | 1.74 | 2.43 | 3.07 | 4.14 |
| 반전: 다리 기울기 [°] | 2.0 | 4.0 | 8.0 | 11.9 | 15.4 | 21.0 |

적분기 없는 기동 모델에서는 피치가 가속도에 거의 비례하므로(1라운드 전 모델에서는 z_att 때문에 속도 변화량에 비례해 보였다) 사양의 "피치 한계에서 유도한 가속도 한계"가 성립하고, 19번 피치를 묶는 a_p,step이 결정한다(`pitch_step_binds` 기본 참). 계수 1.3이 없으면 a_max가 1.6~1.7 m/s²가 되어 m×1.15 스텝 피치가 2.6~2.9°로 19번을 깬다(측정; 저크 0.15 s 시절 1.73/2.58°, 2라운드 재실행 1.61/2.88°).

### 3.2 저크 한계

피크는 저크에 둔감하다. 저크 한계의 역할은 50 Hz 계단 기준이 내부 루프 빠른 극(≈17 rad/s, 58 ms)을 흔들지 않게 하는 것이다. a_max까지 오르는 시간 0.10 s(= 1.7 × 58 ms; 1라운드 전 0.15 s): 0.15 → 0.10으로 정지 거리가 5 mm 줄고 피치 피크는 0.03° 안에서 바뀐다.

### 3.3 속도와 다리 길이

- \|r\| ≤ v_max = 1.0 m/s는 **기준**에 대한 제약이다. 전 범위 반전 기동에서 몸체 속도는 기준을 2~6 % 넘을 수 있다(사양의 "속도 한계"를 기준 속도로 해석; 몸체 속도 상한이 필요하면 예측 v̂에 제약을 추가해야 한다 — 보류).
- 다리 길이 범위는 QP 밖에서 처리한다: up을 L_stand + 0.06·up ∈ [0.24, 0.335] m가 되도록 클립(MCU도 같은 범위를 지킨다). 예측 모델은 서는 길이 0.31 m 하나다(웅크린 채 주행은 시험 항목에 없음).

### 3.4 비대칭 제동 한계와 정지 거리 (검토 1라운드 M3)

정지 거리는 **정지 명령 뒤 최대 이탈**로 잰다(`stop_disp`; 끝점으로 재면 0.07 m처럼 보이지만 실제로는 0.3 m 가서 되돌아온 것이었다). 측정(0.5 m/s 스텝, 노이즈·10 ms, 두 주기):

| 설정(저크 0.10 s, 제동 = 로봇 속도 기준) | 정지 최대 이탈 1 kHz / 200 Hz(모서리 8조합 최악) | 제동 피치 1 kHz / 200 Hz | 비고 |
|---|---|---|---|
| 대칭 한계 a_dec = a_max(0.889 / 0.884), 넘김 0.5 s | 0.342 / 0.344 m(최소 0.312) | ≤ 1.52 / 1.62° | 19번 정지 **실패**(8조합 전부) |
| a_dec = 1.3 a_max, 넘김 0.5 s | 0.299 / 0.302 | 1.91 / 2.03° | 200 Hz 8조합 중 5개 **실패**(정지 +0.6 %, 피치 +1.2 %); 1라운드 반영판(a_max 0.93 시절) 공식 결과는 4/45 실패(0.03~0.04 % 초과) |
| a_dec = 1.5 a_max, 넘김 0.5 s | 0.273 / 0.274 | 2.16~2.33°(m×1.15) | 19번 피치 **실패**(3/8) |
| a_dec = 1.15 a_max, 넘김 1.0 s | 0.298 / 0.299 | 1.86 / 1.96° | 최소 여유 ×1.003 |
| a_dec = 1.20 a_max, 넘김 1.0 s | 0.293 / 0.294 | 1.91 / 2.01° | 200 Hz 피치 초과(1/8) |
| **a_dec = 1.17 a_max, 넘김 1.0 s(채택)** | 전체 매트릭스 45시드 최악 0.296 / 0.297 | 1.90 / 1.98° | 두 손잡이의 교환 곡선이 달라 함께 써야 통과한다; 여유 1 % / 1~5 % |

비채택 행(앞 다섯 행)은 3라운드 검토가 2라운드 반영 코드(`22e58a3`)로 모서리 8조합(m×0.85 μ0.5/0.75/1.0 s4, m×0.85 μ0.5 s1, m×1.15 μ0.75 s3, m×1.15 μ1.0 s2, m×1.15 μ0.5 s0, 공칭 s0)을 다시 잰 값이다(`results/review_scratch/r3/table34_rows.log`; 1라운드 반영판 a_max 0.93 시절의 수치는 3라운드 M1 지적으로 지웠다). 채택 행은 전체 매트릭스(7절).

- 제동 피치가 가속 피치보다 작은 이유(계수 1.3을 쓴 가속보다 제동을 더 허용할 수 있는 이유): 순항 중 몸체는 건마찰을 이기려 앞으로 기울어 있고 제동은 그 기울기를 먼저 푼다. 측정으로 정한 값이며 모델에는 없다(`MpcConfig.decel_factor`).
- "제동"의 정의: **기준 가속도가 로봇의 예측 속도와 반대 방향**인 것(`ReferenceQP.stage_bounds`: 직전 계획의 v̂_k 부호로 단계마다 상하한을 둠, |v̂| < 0.02 m/s면 대칭). 기준 r의 부호로 정하면 로봇이 아직 전진하는데 기준이 0을 지나 음수가 되는 순간부터 제동을 풀어야 해 정지가 0.02 m 길어진다. 모드 전환 시의 가능성은 "현재 가속도에서 저크 한계로 도달 가능한 값 아래로는 상한을 내리지 않음"으로 보장한다.
- 판정의 패킷 검사(`acceptance_mpc.packet_violations`, 21번)는 호스트가 보낸 패킷의 Δr/T·ΔΔr/T²를 같은 정의(패킷 시점의 로봇 속도와 반대면 a_dec, 아니면 a_max; 저크 j_max T)로 독립 계수한다.
- **넘김 시점 `obs_hold_s`**(2라운드 검토 M1): 목표가 0이 된 뒤 0.5 s에 예측 상태를 버리고 넘기면 로봇이 아직 0.3 m/s로 구르는 중이어서 그 뒤의 제동 방향을 기준 부호로만 정하게 되고 정지가 약 5 % 길어졌다. 1.0 s로 늘리면 정지 끝까지 보정·예측이 이어진다(정지 −5 %, 제동 피치 +2 %). 제동 계수와 넘김 시간의 격자(위 표의 뒤 세 행)에서 두 주기의 최소 여유가 가장 큰 조합(넘김 1.0 s, 계수 1.15~1.2 사이)을 골라 **1.17**로 두었다. 1라운드 반영판이 "물리적 한계"라고 적은 것은 제동 계수·저크만 쓸어 본 결과였고 틀렸다 — 두 손잡이를 함께 쓰면 전체 매트릭스를 통과하되 여유는 여전히 몇 % 안이다(7절). **3라운드 검토(m2)**: 고정 1.0 s는 0.5 m/s 정지만 덮고 0.8~1.0 m/s 정지에서는 로봇이 아직 0.17~0.37 m/s로 구르는 중에 넘겨, 넘김 뒤 기준 부호로 정한 제동 방향이 실제 진행 방향과 어긋나 몇 패킷이 a_max를 넘었다(0.8 m/s에서 3/2건). 그래서 넘김을 "목표 0이 된 뒤 1.0 s 이상 지났고 텔레메트리 속도 < `obs_hold_v` 0.05 m/s(상한 `obs_hold_max_s` 3 s)"로 바꾸고, 예측이 없을 때(넘김·재동기 직후)의 제동 방향은 기준 부호가 아니라 텔레메트리 속도로 정한다(`ReferenceQP.stage_bounds(v_tel)`). 0.5 m/s 정지에서는 1.0 s에 이미 |v| < 0.05라 판정 결과에는 영향이 없다(7절 r5 결과).
- **한계**: 내부 루프가 기준을 약 0.26 s 늦게 따르므로 0.5 m/s에서 0.13 m는 호스트가 줄일 수 없고, 제동 거리 0.5²/(2·1.04) + 저크 구간 ≈ 0.16 m를 더하면 0.29~0.30 m다. 정지(질량 ×0.85)와 제동 피치(질량 ×1.15)가 반대 방향으로 움직이므로 어느 설정이든 여유는 몇 % 안이다. 제동 계수 1.17은 모델로 유도한 값이 아니라 시험으로 맞춘 값이고(제동 피치의 실측/모델 비 0.65~1.32로 모델이 제동 피치를 예측하지 못함, 2라운드 m2), 정지 뒤 기준은 −0.137 m/s(공칭)까지 역방향으로 내려갔다가 0으로 돌아온다(로봇을 세우기 위한 정상 동작, 2라운드 n3; 넘김 0.5 s 시절에는 −0.09였고, 1.0 s로 늘린 대가로 되돌아감이 0.04 → 최대 0.071 m가 됐다 — 전체 매트릭스 19번 0.050~0.070 / 0.046~0.071 m; 3라운드 M1이 지적한 '−0.09'는 옛 설정의 값이었다). 실기에서 명령 경로 지연 10~20 ms가 더해지면 정지가 0.30~0.31 m로 늘어 19번이 깨진다(2라운드 m7): 예측 모델에 `model_extra_latency_ms`로 넣고 제동 계수를 다시 맞출 것. 이 값은 예측 모델의 **기준 입력에 순수 지연**(MCU 스텝 단위의 지연 사슬 `model.with_input_delay`)으로 들어간다 — 3라운드 검토(m1) 전에는 관측 지연에 더해져 내부 루프 모델의 극이 바뀌었고 10 ms 이상이면 "불안정" 판정으로 MPC가 꺼졌다. 지금은 10·20 ms에서 모델이 안정하고 a_max가 바뀌지 않으며(응답이 그만큼 늦어질 뿐), QP 캐시 키에도 들어간다(`tests/test_plan4_safety.py MpcHostTests`).

## 4. QP 정식화

| 항목 | 내용 |
|---|---|
| 주기 T | 20 ms(50 Hz; 50~100 Hz, MCU 주기의 정수배) |
| 구간 | 1.5 s → N = 75(1~2 s) |
| 결정 변수 | u_k = Δa_k(기준 가속도의 단당 증분), k = 0..74 |
| MPC 상태 ξ_k | [x_k(축약 폐루프 4~5차), s_k(이번 풀이 시점부터의 변위), r_{k−1}, a_{k−1}] |
| 동역학 | a_k = a_{k−1} + u_k, r_k = r_{k−1} + T a_k, x_{k+1} = A_r x_k + B_r r_k, s_{k+1} = s_k + T v̂_k |
| 비용 | Σ_k w_v (v̂_base,k − v_d,k)² + w_p (p̂_k − p_ss)² + w_r (r_k − v_d,k)² + w_a a_k² + w_u u_k² + 종단(마지막 단 ×20) |
| 가중 | w_v = 1/0.05², w_p = 1/(1°)², w_r = 1/0.5², w_a = 1, w_u = 1 |
| 원하는 응답 v_d | 목표 v*의 임계 감쇠 2차 응답(가속 ω 3.5 rad/s, 감속 ω 10 rad/s), 매 주기 현재 상태에서 1.5 s 예측 |
| 제약 | \|r_k\| ≤ 1.0, 단계별 가속도 상하한(3.4절: 제동 a_dec / 그 외 a_max, 모드 전환 시 저크 도달 가능 한계), \|u_k\| ≤ j_max T |
| 크기 | 변수 75, 부등식 300(r·a 상하 4 × 75) + 변수 상하한 150 |
| 응축 | qpmpc `MPCProblem/MPCQP`의 Φ, Ψ, G; 출력 가중 비용 P = 2(MᵀWM + w_u I)는 직접 조립. P, G 고정(가속/감속 두 벌), 매 풀이마다 q(x0, v_d)와 h(x0, 단계 상하한) 갱신 |
| 솔버 | qpsolvers + DAQP(warm start = 지난 해를 한 단 당김). DAQP 실패 시 같은 주기에 OSQP(`time_limit` 10 ms) |
| 적분기 | 없음. 외란·오차 적분 상태가 없고 정상 상태 오차는 내부 LQI8의 적분기(가속이 끝난 뒤)가 없앤다 |

송신값은 최적 기준 궤적의 첫 값 r_0 = r_{−1} + T(a_{−1} + u_0)다.

## 5. 텔레메트리 보정 (검토 1라운드 M1)

- 측정 y = 직전 20 ms 동안의 est.v 평균(σ_v 0.01 m/s), 예측 ŷ = 한 주기 전 예측. 보정 x̂ ← x̂ + A L (y − ŷ), L은 가장 느린 축약 모드 방향의 과정 잡음 σ_z = 0.0005/주기로 정한 정상 상태 칼만 이득(관측기 극 |λ| ≤ 0.912 / 0.913 per 20 ms ≈ 0.22 s; 1라운드 전 σ_z 0.002는 극 0.80으로 텔레메트리를 거의 그대로 따라가는 것이었다).
- **혁신 게이트**: |y − ŷ| > 0.1 m/s이면 모델 오차가 아니라 외란(밀기)으로 보고 보정하지 않는다(`gated_corrections` 집계). 1라운드에서는 주행 중 밀기에 호스트가 기준을 −0.67 m/s까지 흔들었다(LQI8 적분기와 같은 오차를 둘이 적분).
- 보정은 목표가 0이 아닌 동안과 목표가 0이 된 뒤 `obs_hold_s` = 1.0 s까지만(정지가 끝날 때까지; 3.4절); 목표는 데드밴드 0.02 m/s로 정확히 0이 된다(1e−4 m/s 조이스틱 잔류가 보정을 켜 두던 문제). 기동이 끝나면 예측 상태를 0으로 넘긴다(handover). 단계별 제동 방향에 쓰는 예측 속도는 직전 주기의 계획(한 단 지연, 2라운드 n2)이다.
- 적분기 판정: 단위원 위 극이 없고 외란 상태도 없다. 1.5 s 시정수의 강한 바깥 속도 루프였던 1라운드 설정과 달리 0.2 s의 약한 보정이며, 내부 적분기가 기동 중 동결되어 "두 적분기의 싸움"이 구조적으로 없다. 측정(24번: 0.3 m/s 순항 중 0.75 W 밀기): 공칭 정착 MPC 1.91/2.03 s(1 kHz/200 Hz) 대 램프 호스트 1.90/1.99 s, 후진 최대 0.006 m/s(1라운드 0.67 m/s); 2라운드 검토의 9조합 재실험에서도 정착 최대 MPC 2.25 s 대 램프 2.33 s, 후진 ≤ 0.018 m/s.

## 6. 폴백 규칙 (검토 1라운드 M2)

1. **전환**: 매 주기 DAQP, 실패하면 같은 주기 OSQP(10 ms 제한). 둘 다 실패·비가용·`force_fail`이면 그 주기부터 **원시 목표 + `host_shaped = False`**를 보낸다 → MCU가 1단계 성형(램프 2 m/s² + 전치 필터 0.3 s + 적분 동결)으로 추종. 이벤트 "fallback engaged: raw target handed to the MCU's stage-1 shaping".
2. **복귀**: 폴백 1 s 이상 지났고, 내부 램프의 가속도 |a| < 0.05 m/s², |측정 속도 − 목표| < 0.1 m/s, `force_fail` 아님 → MCU 텔레메트리 `est.v_ref`(MCU 자체 기준)로 예측 상태를 재동기(무충격)하고 QP를 다시 푼다. 성공하면 "MPC resumed". 1라운드의 조건 |a| < 1e−6은 잡음 때문에 성립하지 않아 복귀가 없었다.
3. **기동 중 실패**(23번 변형): 속도 스텝 중 0.8 s(가속)·1.2 s(목표 근처)·3.04 s(제동)에 0.1 s 강제 실패 → MCU 성형으로 넘어가도 적분기가 동결되어 있어 혼합 과도가 없다(8번 통과), 약 1.8~2.2 s에 MPC 복귀(0.8·1.2 s 실패, 공칭, 두 주기; 3.04 s 제동 중 실패는 정지가 끝난 4.8 s에 복귀. 2라운드 검토의 실패 시각 확장 90회도 모두 8번 통과·복귀). 7절 23번.
4. 내부 폐루프가 불안정(지연 ≥ 20 ms)하거나 모델을 못 만들면 MPC를 끄고 1단계 성형만(이벤트).

## 7. 2단계 결과(전체 매트릭스 9조합 × 5시드 × 2주기, 노이즈·10 ms) — `results/acceptance/plan4_mpc_<rate>Hz.md`

캐시 태그 `r5_s2`(검토 3라운드 반영판; 1단계 `r5_s1`과 같은 코드, 결과 파일 머리에 코드 해시 345db37b94). 두 주기 합계 1386회(주기당 693, 2단계 항목 포함; 20번은 비교 15항목), 12프로세스 535 s. 2라운드 반영판 `r4_s2`와의 차이는 넘김 조건(텔레메트리 속도 < 0.05 m/s, 3.4절)이 바꾼 정지 뒤 구간뿐이다 — 19번의 판정 지표(정지 최대 이탈·피치 피크는 넘김 전에 결정)는 그대로다.

| | 1 kHz | 200 Hz |
|---|---|---|
| 19 MPC 속도 스텝 | **통과**(45/45): 피치 피크 최악 1.90°(m×1.15 μ0.75 s0, ×0.95), 오버슈트 2.7 %, 90 % 도달 1.10 s, 정지 최대 이탈 0.296 m(×0.99, m×0.85 μ0.75 s0), 되돌아감 0.050~0.070 m, 바퀴 피크 0.29 N·m | **통과**(45/45): 피치 1.98°(m×1.15 μ0.75 s3, ×0.99), 오버슈트 4.3 %, 도달 1.085 s, 정지 0.297 m(×0.99, m×0.85 μ0.75 s4), 되돌아감 0.046~0.071 m |
| 20 회귀 없음 | 통과(항목 기준): 1~17 중 1단계 통과 → 2단계 실패 0, 가장 빠듯한 지표 여유율 10 % 이상 악화 0(15항목). **기록(지표별)**: 8:stop_disp ×0.47→×0.59, 13:stop_disp ×0.47→×0.59(8절; 정지 최대 이탈 +25.7 / +27.0 %) | 통과(같음), 기록 같음(+25.9 / +27.4 %) |
| 21 제약 준수 | 통과: QP 자기 검사 위반 0, **송신 패킷 독립 검사(가속·제동·저크·속도, 구간 첫 패킷 포함) 위반 0**(8·9·13·19 × 45), 바퀴 피크 0.44 N·m(≤ 1.36) | 통과: 위반 0, 0.42 N·m |
| 22 풀이 시간(기록) | p99 0.33 ms(≤ 5), QP 실패 0 — 벽시계 값이라 실행마다 10~17 % 다르다(3라운드 n6: 2라운드 반영판 0.31, 검토 재현 0.27) | p99 0.31 ms(2라운드 반영판 0.26, 재현 0.21) |
| 23 폴백 | 통과(시드 0~4): t = 0 강제 실패 → 1(60 s)·8·11 통과; **기동 중 0.1 s 실패(0.8·1.2·3.04 s) 뒤 8번 통과·MPC 복귀** | 통과(같음) |
| 24 주행 중 밀기(기록) | 정착 1.91 s, 후진 0.004 m/s(램프 호스트 1.90 s / 0.003) | 2.02 s, 0.006(램프 1.99 / 0.004) |
| 1~17 | 1단계와 같은 통과(16·17은 합격기준 6.3의 10 cm로 통과, 15 기록 20 ms 미달) | 같음(15 기록 25 ms) |

MPC 호스트가 바꾸는 항목(8·11·13; 최악값끼리, 1 kHz / 200 Hz): 8번 90 % 도달 1.25 / 1.24 → 1.10 / 1.085 s, 오버슈트 10.6 / 12.6 → 2.7 / 4.3 %, 정상 오차 0.039 / 0.039 → 0.0032 / 0.0035 m/s, 피치 최악 2.14 / 2.20 → 1.90 / 1.98°, 정지 최대 이탈 0.235 / 0.236 → 0.296 / 0.297 m(램프 호스트는 2 m/s² 제동으로 피치 5° 한계 안에서 더 세게 멈춘다; MPC는 19번의 2° 피치 한계를 지키느라 제동이 1.04 m/s²다 — 8절의 지표별 기록); 11번 정지 2.36 / 2.39 → 2.33 / 2.36 s; 13번 90 % 도달 1.38 / 1.40 → 1.42 / 1.47 s(오르막, m×1.15·μ0.5; 1단계보다 느려졌지만 ≤ 1.5 s), 피치 2.45 / 2.58°(한계 5°).

종합 판정은 두 주기 모두 **합격**이다(1단계 16·17은 사용자 위임 결정으로 통과, 합격기준 6.3). 19번은 두 주기 모두 통과하되 정지 최대 이탈 여유가 ×0.99 / ×0.99(3.4절의 넘김 1.0 s·제동 1.17배 조합)다. 남은 사용자 결정 항목은 9절.

1 kHz:

| # | 항목 | 등급 | 판정 | 실행 수 | 가장 빠듯한 지표 (측정 / 기준, 여유율) | 최악 조합 |
|---|---|---|---|---|---|---|
| 1 | 정지 60 s | 필수-정착 | 통과 | 45 | pitch_rms: 0.288 <= 0.500 (×0.58) | m×1.15 μ1.00 s0 |
| 2 | 초기 기울기 10° | 필수-정착 | 통과 | 45 | wheel_peak: 1.323 <= 1.360 (×0.97) | m×0.85 μ0.50 s3 |
| 3 | 초기 기울기 15° | 필수-정착 | 통과 | 45 | wheel_rms10: 0.125 <= 0.200 (×0.63) | m×0.85 μ0.50 s0 |
| 4 | 초기 기울기 20° | 필수-생존 | 통과 | 5 | alive: O >= 1 (×0.00) | m×1.00 μ0.75 s0 |
| 5 | 밀기 0.5 W | 필수-정착 | 통과 | 45 | settle_s: 1.899 <= 3.000 (×0.63) | m×0.85 μ0.75 s1 |
| 6 | 밀기 0.75 W | 필수-정착 | 통과 | 45 | wheel_rms10: 0.122 <= 0.200 (×0.61) | m×0.85 μ1.00 s3 |
| 7 | 밀기 1.0 W | 필수-생존 | 통과 | 5 | alive: O >= 1 (×0.00) | m×1.00 μ0.75 s0 |
| 8 | 속도 스텝 0.5 m/s | 필수-정착 | 통과 | 45 | rise_s: 1.103 <= 1.500 (×0.74) | m×0.85 μ1.00 s1 |
| 9 | 요 1 rad/s | 필수-정착 | 통과 | 45 | wheel_rms10: 0.107 <= 0.200 (×0.53) | m×1.15 μ1.00 s1 |
| 10 | 4 cm 웅크림 후 복귀 | 필수-정착 | 통과 | 45 | leg_rms: 1.975 <= 4.000 (×0.49) | m×1.15 μ0.50 s2 |
| 11 | 링크 끊김(0.5 m/s 주행 중) | 필수-정착 | 통과 | 45 | stop_time: 2.326 <= 3.000 (×0.78) | m×0.85 μ1.00 s3 |
| 12 | 경사 5° 정지 | 필수-정착 | 통과 | 45 | wheel_rms10: 0.156 <= 0.200 (×0.78) | m×1.15 μ0.75 s2 |
| 13 | 경사 5° 주행 0.5 m/s(오르기·내리기) | 필수-정착 | 통과 | 45 | rise_s: 1.417 <= 1.500 (×0.94) | m×1.15 μ0.50 s1 |
| 15 | 지연 스윕(3° 기울기, 무노이즈; 강건 여유도 함께 기록) | 기록 | **실패** | 1 | max_latency_ms: 20 >= 25.000 (×1.25) | m×1.00 μ0.75 s0 |
| 16 | IMU 피치 바이어스 +1° | 필수-정착 | 통과 | 45 | drift_max: 0.072 <= 0.100 (×0.72) | m×1.15 μ0.50 s3 |
| 17 | 무게중심 전방 오프셋(0.3 kg, +10 cm) | 필수-정착 | 통과 | 45 | drift_max: 0.086 <= 0.100 (×0.86) | m×0.85 μ0.75 s2 |
| 19 | MPC 속도 스텝 0.5 m/s | 필수-정착 | 통과 | 45 | stop_disp: 0.296 <= 0.300 (×0.99) | m×0.85 μ0.75 s0 |
| 20 | 회귀 없음(1~17: 1단계 통과 유지, 가장 빠듯한 지표 여유율 악화 < 10 %) | 필수-정착 | 통과 | 15 | regression_flips: 0 <= 0 (×0.00) | - |
| 21 | MPC 제약 준수(8·9·13·19) | 필수-정착 | 통과 | 45 | wheel_peak: 0.440 <= 1.360 (×0.32) | m×1.15 μ0.50 s0 |
| 22 | MPC 풀이 시간 | 기록 | 통과 | 1 | solve_p99_ms: 0.330 <= 5.000 (×0.07) | m×1.00 μ0.75 s0 |
| 23 | MPC 폴백(솔버 강제 실패) | 필수-생존 | 통과 | 5 | alive: 1 >= 1 (×0.00) | m×1.00 μ0.75 s0 |
| 24 | 주행 중 밀기(0.3 m/s 순항, 0.75 W; 기록, 검토 r1) | 기록 | 통과 | 1 | settle_s: 1.911 <= 4.000 (×0.48) | m×1.00 μ0.75 s0 |

실패 목록(조합별 집계):
- 15 지연 스윕(3° 기울기, 무노이즈; 강건 여유도 함께 기록): `max_latency_ms` 1회 실패(측정 20.000~20.000, 기준 >= 25.0) — m×1.00 μ0.75

200 Hz:

| # | 항목 | 등급 | 판정 | 실행 수 | 가장 빠듯한 지표 (측정 / 기준, 여유율) | 최악 조합 |
|---|---|---|---|---|---|---|
| 1 | 정지 60 s | 필수-정착 | 통과 | 45 | pitch_ma_max: 0.686 <= 1.000 (×0.69) | m×1.15 μ0.75 s4 |
| 2 | 초기 기울기 10° | 필수-정착 | 통과 | 45 | wheel_peak: 1.288 <= 1.360 (×0.95) | m×0.85 μ0.50 s0 |
| 3 | 초기 기울기 15° | 필수-정착 | 통과 | 45 | wheel_rms10: 0.118 <= 0.200 (×0.59) | m×1.15 μ0.50 s3 |
| 4 | 초기 기울기 20° | 필수-생존 | 통과 | 5 | alive: O >= 1 (×0.00) | m×1.00 μ0.75 s0 |
| 5 | 밀기 0.5 W | 필수-정착 | 통과 | 45 | settle_s: 1.940 <= 3.000 (×0.65) | m×0.85 μ0.50 s3 |
| 6 | 밀기 0.75 W | 필수-정착 | 통과 | 45 | wheel_rms10: 0.112 <= 0.200 (×0.56) | m×1.15 μ0.50 s2 |
| 7 | 밀기 1.0 W | 필수-생존 | 통과 | 5 | alive: O >= 1 (×0.00) | m×1.00 μ0.75 s0 |
| 8 | 속도 스텝 0.5 m/s | 필수-정착 | 통과 | 45 | rise_s: 1.085 <= 1.500 (×0.72) | m×0.85 μ0.50 s4 |
| 9 | 요 1 rad/s | 필수-정착 | 통과 | 45 | wheel_rms10: 0.109 <= 0.200 (×0.54) | m×1.15 μ1.00 s1 |
| 10 | 4 cm 웅크림 후 복귀 | 필수-정착 | 통과 | 45 | leg_rms: 1.977 <= 4.000 (×0.49) | m×1.15 μ1.00 s4 |
| 11 | 링크 끊김(0.5 m/s 주행 중) | 필수-정착 | 통과 | 45 | stop_time: 2.360 <= 3.000 (×0.79) | m×0.85 μ0.50 s4 |
| 12 | 경사 5° 정지 | 필수-정착 | 통과 | 45 | wheel_rms10: 0.159 <= 0.200 (×0.79) | m×1.15 μ1.00 s2 |
| 13 | 경사 5° 주행 0.5 m/s(오르기·내리기) | 필수-정착 | 통과 | 45 | rise_s: 1.470 <= 1.500 (×0.98) | m×1.15 μ0.50 s2 |
| 15 | 지연 스윕(3° 기울기, 무노이즈; 강건 여유도 함께 기록) | 기록 | 통과 | 1 | max_latency_ms: 25 >= 25.000 (×1.00) | m×1.00 μ0.75 s0 |
| 16 | IMU 피치 바이어스 +1° | 필수-정착 | 통과 | 45 | drift_max: 0.073 <= 0.100 (×0.73) | m×1.15 μ0.75 s4 |
| 17 | 무게중심 전방 오프셋(0.3 kg, +10 cm) | 필수-정착 | 통과 | 45 | drift_max: 0.087 <= 0.100 (×0.87) | m×0.85 μ1.00 s1 |
| 19 | MPC 속도 스텝 0.5 m/s | 필수-정착 | 통과 | 45 | stop_disp: 0.297 <= 0.300 (×0.99) | m×0.85 μ0.75 s4 |
| 20 | 회귀 없음(1~17: 1단계 통과 유지, 가장 빠듯한 지표 여유율 악화 < 10 %) | 필수-정착 | 통과 | 15 | regression_flips: 0 <= 0 (×0.00) | - |
| 21 | MPC 제약 준수(8·9·13·19) | 필수-정착 | 통과 | 45 | wheel_peak: 0.422 <= 1.360 (×0.31) | m×1.15 μ0.50 s1 |
| 22 | MPC 풀이 시간 | 기록 | 통과 | 1 | solve_p99_ms: 0.313 <= 5.000 (×0.06) | m×1.00 μ0.75 s0 |
| 23 | MPC 폴백(솔버 강제 실패) | 필수-생존 | 통과 | 5 | alive: 1 >= 1 (×0.00) | m×1.00 μ0.75 s0 |
| 24 | 주행 중 밀기(0.3 m/s 순항, 0.75 W; 기록, 검토 r1) | 기록 | 통과 | 1 | settle_s: 2.025 <= 4.000 (×0.51) | m×1.00 μ0.75 s0 |

실패 목록(조합별 집계):
- 없음

## 8. 1단계 대비 변화(20번)

- 1000 Hz: 통과 — 1단계 통과 → 2단계 실패 0건(-), 항목별 가장 빠듯한 지표의 여유율 10 % 이상 악화 0건(-); 비교 항목 15개. **기록(모든 지표, 여유 ≥ 0.05)**: 10 % 이상 악화 2건 — 8:stop_disp ×0.47→×0.59, 13:stop_disp ×0.47→×0.59
- 200 Hz: 통과 — 1단계 통과 → 2단계 실패 0건(-), 항목별 가장 빠듯한 지표의 여유율 10 % 이상 악화 0건(-); 비교 항목 15개. **기록(모든 지표, 여유 ≥ 0.05)**: 10 % 이상 악화 2건 — 8:stop_disp ×0.47→×0.59, 13:stop_disp ×0.47→×0.59

지표별 악화는 MPC가 19번의 피치 2°를 지키려 1단계 램프(2 m/s² 제동)보다 부드럽게 멈추기 때문이다(정지 최대 이탈 0.23 → 0.30 m). 항목 기준(기준 문구의 "항목")으로는 회귀가 없고, 지표 기준으로는 20번이 실패한다 — 비교 단위는 사용자 결정 항목(합격기준 6.2, 9절).

## 9. 남은 과제와 사용자 결정 항목

사용자 결정(2026-10-23, 합격기준 6.4): 정지 거리 정의(최대 이탈·base 원점)와 20번 비교 단위(항목별 가장 빠듯한 지표)는 **현행 유지**로 확정됐다. 아래 두 항목은 그 결정의 결과를 적어 둔 것이고, 나머지는 남은 과제다.

- **19번의 얇은 여유**(3.4절): 정지 최대 이탈 ≤ 0.3 m와 피치 ≤ 2°를 질량 ±15 % 전부에서 동시에 지키는 여유가 몇 % 안이다(튜닝으로 통과). 정지 거리를 끝점 기준으로 읽거나 질량 범위·정지 거리 기준을 바꾸는 선택지는 사용자가 택하지 않았다(최대 이탈·base 원점 유지). 여유를 넓히려면 내부 루프의 속도 응답을 빨리 하는 재설계가 필요한데 바퀴 토크 여유가 다른 항목에서 먼저 막힌다.
- **20번 비교 단위**(2라운드 M2, 8절): 항목별 가장 빠듯한 지표로는 회귀 0이지만 지표별로는 8·13번 정지 최대 이탈이 26~27 %, 8번 피치·바퀴 피크 ~20 % 나빠진다(MPC가 19번 피치를 지키려 더 부드럽게 제동). 지표별 해석을 택하면 19·20을 동시에 만족할 수 없다 — 사용자 결정으로 항목 기준을 유지하고 지표별 악화는 기록만 한다.
- **일시 QP 실패 뒤 1 s**(2라운드 m5): 폴백 중에는 MCU 1단계 성형(2 m/s² 램프, 피치 ≤ 5° 기준)이 돌아 질량 극단에서 19번 기준(정지 0.31 m, 피치 2.1~2.3°)은 넘는다. 23번 판정(8번 기준)에는 영향이 없고, 폴백은 8번 등급으로 설계된 것이다.
- **OSQP 백업**(2라운드 m1): `ReferenceQP.solve`의 시간 제한이 잘못된 속성을 참조해 1라운드 반영판에서는 백업이 한 번도 실행되지 않았다(고침). 고친 뒤의 그림자 측정(22번 시나리오의 QP 750회를 OSQP로도 풀어 봄, 3라운드 검토): 10 ms 제한 안에 99.6~99.7 % 수렴, p99 6.4 / 7.2 ms, 최대 11.8 ms — 미수렴은 스텝·제동 시작 순간에 몰리는데 그 순간이 DAQP가 실패할 만한 순간과 겹칠 수 있다는 점이 한계다(미수렴이면 폴백 → 복귀). DAQP를 강제로 실패시킨 12회 중 11회는 OSQP가 같은 주기에 풀었다. DAQP 실패 자체가 0회라 판정에는 영향이 없다. 2라운드 반영판 문서의 "90 %만 수렴(p99 11 ms)"은 틀린 값이었다(3라운드 M1).
- 높이 변화(L0 0.24~0.335 m)에 따른 모델 스케줄링은 없다(서는 길이 0.31 m 하나).
- 몸체 속도 상한(기준 상한만 있음, 3.3절).
- 실기: 텔레메트리가 50 Hz 단일 표본이면 σ_v와 혁신 게이트를 다시 정한다; 예측 모델의 지연을 측정값으로; `est.v_ref`를 텔레메트리에 실어 보낼 것(HANDOFF 2.1).
- 건마찰을 모델에 구조적으로 넣는 것(피치 모델 오차 계수 1.3이 대신한다).
- **적분기 동결 유지 0.1 s의 범위**(3라운드 m3): 제동→복귀의 가속도 부호 교차(간격 41~45 ms)는 덮어 90/90에서 z·z_att·z_pos가 불변이지만, 가속 끝의 교차(간격 121~165 ms)는 유지가 끝난 뒤 20~65 ms 적분한다(|Δz| ≤ 1.9e−3, 해제 순간 속도 오차 ≤ 0.047 m/s). 효과가 작아 그대로 두었다 — 유지 시간을 0.2 s로 늘리면 1단계 z2 동결에도 걸려 두 단계 전체를 다시 맞춰야 한다(19번 여유 1 %). "기동 중 적분기 전부 동결"은 이 범위 안에서의 서술이다.
