wisehyun-2/my_robot_project/wheeled_biped/docs/review_plan4_mpc_r1.md

# Plan 4 2단계(호스트 MPC 기준 생성기) 독립 검증 — 1차

작성 2026-10-23. 대상: `wbr/controllers/mpc_host/`, `wbr/bench/acceptance_mpc.py`, `acceptance.py`의 19~23 판정, 호스트/MCU 경계(`host_link.py`, `mcu.py`, `lqi6.py`, `plan4_upkie_lqi6.py`), `results/acceptance/plan4_mpc_<rate>Hz.*`, `results/plan4_mpc/`, `docs/plan4_mpc_host.md`(맨 앞 "최종 상태" 절이 본문보다 우선한다는 전제로 검토).
코드 상태: 코드 해시 `c0d681a94d`(검토 시작·끝 모두 같음), git `13938e4`(작업 트리 깨끗). 저장소에서 새로 만든 파일은 이 문서뿐이고 나머지 산출물은 `results/review_scratch/`(git 무시 대상)에 있다. `identify.py`는 출력 경로를 스크래치로 돌려 실행했다(원래는 `models/upkie_plan4/plan4_closed_loop.json`과 `results/plan4_mpc/model_fit.*`를 덮어쓴다).

## 0. 요약

- **재현성: 좋음.** 축소 매트릭스 재현(100회, 8프로세스 62 s)이 공식 캐시(`final_s2`)와 **모든 지표에서 비트 단위로 같다**(시간 지표 22번만 실행마다 다름: p99 0.321/0.295 ms 대 공식 0.376/0.331 ms). 통과/실패 뒤집힘 0. 공식 `plan4_mpc_*Hz.json`·`plan4_*Hz.json`은 각자의 캐시에서 다시 집계해도 차이 0이다.
- **19·21·22·23 통과는 재현된다.** 독립 재계산(시뮬레이터 원자료에서 피치·속도·위치·바퀴 토크를 다시 계산, 송신 패킷에서 기준 속도·가속도·저크를 다시 계산)도 판정 코드 값과 일치했다. 피치 기준 송신 없음, 20 ms 고정 격자, 제약 위반 0, QP 실패 0(21번 90회 × 4시나리오).
- **그러나 판정 배터리가 시험하지 않는 조건에서 2단계 호스트의 약점이 드러난다.** 등급 집계: **MAJOR 5, minor 11, nit 7.**
  - **M1** 텔레메트리 보정 + MPC가 외란 때 LQI6 적분기와 싸운다(형식상 적분기는 아니지만 극 0.987·DC 이득 −1.57의 1.5 s 속도 피드백). 목표가 정확히 0이 아니면(1e-4 m/s) 6번이 200 Hz에서 6/45, 1 kHz에서 15회 추가로 실패하고, 0.3 m/s 주행 중 밀기에서는 복귀가 2배(2.2 → 4.2~4.5 s) 느려지고 로봇이 최대 −0.67 m/s로 후진한다. 배터리의 외란 항목은 모두 목표 정확히 0(호스트가 아무것도 안 하는 상태)으로만 돈다.
  - **M2** 기동 중 0.1 s 동안의 QP 실패 한 번으로 MPC가 **다시 켜지지 않고**(복귀 조건 `|a| < 1e-6`이 잡음 때문에 성립하지 않음) 혼합 과도로 8번(18회 중 12~18회)·19번(18/18)이 실패한다. 23번은 t = 0부터의 강제 실패(= 1단계와 같은 동작)만 시험한다.
  - **M3** 정지 거리 판정이 끝점 |x_끝 − x(3 s)|이라 실제 정지 이탈(정지 명령 뒤 처음 멈출 때까지 간 거리) 0.27~0.30 m를 0.06~0.075 m로 보고한다. 19번 기준 0.3 m에 대한 실제 여유는 ×0.24가 아니라 **×0.99**(최악 0.297 m)이고, MPC는 1단계(0.21~0.24 m)보다 22~26 % 더 가서 0.21~0.23 m 되돌아온다. 문서는 반대로 적었다.
  - **M4** 예측 모델이 최종 내부 루프의 z_att 게이팅을 담지 않아 피치 채널이 틀린다(MPC 스텝: 모델 1.80~1.87° 대 실제 0.97~1.17°, a_max를 유도한 반전 기동: 모델 4.5° 대 실제 0.36~0.69°). 사양의 "가속도 한계(…피치 한계에서 유도)"가 실제 폐루프에서 유도되지 않았다(방향은 보수적).
  - **M5** 재현되지 않는 수치: `model_fit.*`(최종 lqi6.py 이전 산출, 스텝 피치 rms 0.46~0.52° → 재실행 0.66~0.70°), 최종 상태 절의 "19번 최악 1.65°/1.51°"(공식 1.172°/1.292°), "6번 3회"(공식 10회), `results/plan4_mpc/`의 회귀·비교·제약 산출물(시점 B).
- 판정 결론 자체(19·21·22·23 통과, 20 항목 기준 회귀 없음, 종합 불합격 = 1단계에서 넘어온 6(1 kHz)·16·17)는 재현된다. 위 MAJOR는 "그 판정이 무엇을 보장하지 않는가"에 관한 것이다.

## 1. 재현 결과

### 1.1 축소 매트릭스 재현

명령(지시 그대로): `python -m wbr.bench.acceptance --host mpc --stage2 --rate both --matrix reduced --seeds 1 --tag review_mpc_r1 --jobs 8 --out results/review_scratch/acceptance_mpc` → 100회, 62 s, 코드 해시 c0d681a94d. 같은 (항목, 조합, 시드 0, 주기)의 공식 실행(`results/acceptance/cache/final_s2`, 전체 매트릭스의 부분집합)과 실행 단위로 비교했다(`per_run_compare.py`: 실행 결과의 모든 키).

| # | 주기 | 재현 판정 | 공식(같은 3조합·시드 0) 판정 | 가장 빠듯한 지표: 재현 값 (여유율) | 공식 값 | 차이 |
|---|---|---|---|---|---|---|
| 1 | 1000 | 통과 | 통과 | pitch_rms 0.288 (×0.577) | 0.288 | 0 (비트 동일) |
| 1 | 200 | 통과 | 통과 | pitch_ma_max 0.621 (×0.621) | 0.621 | 0 (비트 동일) |
| 2 | 1000 | 통과 | 통과 | wheel_peak 1.287 (×0.946) | 1.287 | 0 (비트 동일) |
| 2 | 200 | 통과 | 통과 | wheel_peak 1.251 (×0.920) | 1.251 | 0 (비트 동일) |
| 3 | 1000 | 통과 | 통과 | wheel_rms10 0.117 (×0.586) | 0.117 | 0 (비트 동일) |
| 3 | 200 | 통과 | 통과 | wheel_rms10 0.117 (×0.583) | 0.117 | 0 (비트 동일) |
| 4 | 1000 / 200 | 통과 | 통과 | alive | alive | 0 |
| 5 | 1000 | 통과 | 통과 | settle_s 1.875 (×0.625) | 1.875 | 0 (비트 동일) |
| 5 | 200 | 통과 | 통과 | settle_s 1.935 (×0.645) | 1.935 | 0 (비트 동일) |
| 6 | 1000 | 통과 | 통과 | wheel_rms10 0.118 (×0.590) | 0.118 | 0 (비트 동일) |
| 6 | 200 | 통과 | 통과 | wheel_rms10 0.110 (×0.549) | 0.110 | 0 (비트 동일) |
| 7 | 1000 / 200 | 통과 | 통과 | alive | alive | 0 |
| 8 | 1000 | 통과 | 통과 | rise_s 0.932 (×0.621) | 0.932 | 0 (비트 동일) |
| 8 | 200 | 통과 | 통과 | rise_s 0.990 (×0.660) | 0.990 | 0 (비트 동일) |
| 9 | 1000 | 통과 | 통과 | wheel_rms10 0.068 (×0.342) | 0.068 | 0 (비트 동일) |
| 9 | 200 | 통과 | 통과 | wheel_rms10 0.071 (×0.355) | 0.071 | 0 (비트 동일) |
| 10 | 1000 / 200 | 통과 | 통과 | leg_rms 1.406 (×0.351) | 1.406 | 0 (비트 동일) |
| 11 | 1000 | 통과 | 통과 | stop_time 2.102 (×0.701) | 2.102 | 0 (비트 동일) |
| 11 | 200 | 통과 | 통과 | stop_time 2.160 (×0.720) | 2.160 | 0 (비트 동일) |
| 12 | 1000 | 통과 | 통과 | wheel_rms10 0.154 (×0.771) | 0.154 | 0 (비트 동일) |
| 12 | 200 | 통과 | 통과 | wheel_rms10 0.156 (×0.779) | 0.156 | 0 (비트 동일) |
| 13 | 1000 | 통과 | 통과 | rise_s 1.381 (×0.921) | 1.381 | 0 (비트 동일) |
| 13 | 200 | 통과 | 통과 | wheel_rms10 0.177 (×0.883) | 0.177 | 0 (비트 동일) |
| 15 | 1000 | **실패** | **실패** | max_latency_ms 15 (×1.667) | 15 | 0 |
| 15 | 200 | 통과 | 통과 | max_latency_ms 25 (×1.000) | 25 | 0 |
| 16 | 1000 | **실패** | **실패** | drift_max 0.086 (×1.725) | 0.086 | 0 (비트 동일) |
| 16 | 200 | **실패** | **실패** | drift_max 0.088 (×1.753) | 0.088 | 0 (비트 동일) |
| 17 | 1000 | **실패** | **실패** | drift_max 0.104 (×2.071) | 0.104 | 0 (비트 동일) |
| 17 | 200 | **실패** | **실패** | drift_max 0.099 (×1.980) | 0.099 | 0 (비트 동일) |
| 19 | 1000 | 통과 | 통과 | rise_s 0.932 (×0.621) | 0.932 | 0 (비트 동일) |
| 19 | 200 | 통과 | 통과 | rise_s 0.990 (×0.660) | 0.990 | 0 (비트 동일) |
| 21 | 1000 | 통과 | 통과 | wheel_peak 0.406 (×0.299) | 0.406 | 0 (비트 동일) |
| 21 | 200 | 통과 | 통과 | wheel_peak 0.410 (×0.302) | 0.410 | 0 (비트 동일) |
| 22 | 1000 | 통과 | 통과 | solve_p99_ms 0.321 (×0.064) | 0.376 | −14.6 % (시간 지표, 실행마다 다름) |
| 22 | 200 | 통과 | 통과 | solve_p99_ms 0.295 (×0.059) | 0.331 | −10.7 % (같음) |
| 23 | 1000 / 200 | 통과 | 통과 | passes_1_8_11 1 | 1 | 0 (비트 동일) |

- 100회 중 98회는 결과 사전의 모든 키가 같다. 다른 2회는 22번(두 주기)의 시간 지표(실행 환경 의존, 결정적이지 않음)이며, 그 밖에 5 % 넘는 지표 차이·판정 뒤집힘은 없다.
- 공식 요약 JSON이 캐시와 맞는지: `final_s2`(1360회)·`final_s1`(1186회) 캐시로 `acceptance.summarize`를 다시 돌린 결과가 `plan4_mpc_<rate>Hz.json`·`plan4_<rate>Hz.json`의 모든 최악값·판정과 차이 0.

### 1.2 제약 점검(`python -m wbr.bench.acceptance_mpc 1000`)과 송신 패킷 독립 검사

- `acceptance_mpc 1000`(공칭, 시드 0): 8·9·13·19의 바퀴 피크 0.267 / 0.309 / 0.406 / 0.267 N·m, 위반 0, QP 실패 0, 생존. 저장된 `results/plan4_mpc/constraint_check.json`(01:25)은 0.426 / 0.443 / 0.527 / 0.426 N·m로 **최종 코드와 다르다**(시점 B 산출, M5).
- 공식 21번 전체(9조합 × 5시드 × 2주기 = 90회, 회당 4시나리오): QP 실패 0, 위반 0, 생존 90, 최악 바퀴 피크 0.438 N·m(1 kHz, m×1.15 μ0.75 s3, 13번).
- 송신 패킷 독립 검사(`spot_check_19.py`, `link.receive`를 가로채 MotionCtrl 300개 기록, 1 kHz·200 Hz 공칭, 1 kHz m×1.15 μ1.0 s2): 간격은 모두 정확히 20.000 ms, |r| 최대 0.461~0.468 m/s(≤ 1.0), |Δr/T| 최대 0.83546 = a_max, |Δa| 최대 0.11139 = j_max·T(한계에 정확히 붙어 있고 1e-3 상대 허용을 넘는 것 0), `pitch` = 0·`pitch_ctrl_mode` = 거짓이 300개 모두, `host_shaped` = 참이 300개 모두.

### 1.3 MPC 속도 스텝 한 개의 독립 재계산(원자료)

`plan.step`을 감싸 매 스텝 `sim.data.xmat`(몸체 자세 → 피치), `xpos`(몸체 x, 유한차분 속도), `actuator_force`(바퀴 토크)를 직접 읽어 다시 계산했다.

| 경우 | 지표 | 판정 코드 | 독립 재계산 |
|---|---|---|---|
| 1 kHz 공칭 s0 | 피치 피크 / 오버슈트 / 90 % 도달 | 0.9635° / −0.795 % / 0.932 s | 0.9635° / −0.800 %(유한차분 속도) / 0.932 s |
| | 정지 거리(끝점) / **최대 이탈** / 되돌아간 거리 | 0.0666 m / — / — | 0.0666 m / **0.287 m** / 0.221 m |
| | 바퀴 피크, vx 대 유한차분 속도 rms | 0.2669 N·m | 0.2669 N·m, 0.0002 m/s |
| 200 Hz 공칭 s0 | 피치 / 오버슈트 / 도달 / 끝점 / 최대 이탈 | 0.929° / 0.909 % / 0.955 s / 0.064 m | 0.929° / 0.878 % / 0.955 s / 0.064 m / **0.284 m** |
| 1 kHz m×1.15 μ1.0 s2(19번 최악 피치) | 같음 | 1.172° / −0.59 % / 0.897 s / 0.071 m | 1.172° / −0.60 % / 0.896 s / 0.071 m / **0.281 m** |

판정 코드의 피치·오버슈트·도달 시간·바퀴 피크는 원자료와 맞는다. 정지 거리만 정의가 다르다(M3).

### 1.4 풀이 시간(22번)

| 측정 | p50 [ms] | p99 [ms] | 최대 [ms] |
|---|---|---|---|
| 공식 22번 1 kHz / 200 Hz(750회) | 0.092 / 0.092 | 0.376 / 0.331 | 0.576 / 0.564 |
| 재현 22번 1 kHz / 200 Hz(750회) | 0.096 / 0.079 | 0.321 / 0.295 | 0.623 / 0.511 |
| 기동 구간만(0.5~4 s, 1 kHz 스텝) | — | 0.332 | — |
| 호스트 주기 전체 `_update`(q·h 빌드·위반 검사·관측기 포함, 1 kHz 스텝 300회) | 0.264 | 0.369 | 0.530 |
| OSQP를 1차 솔버로(최종 코드, 1 kHz 스텝 300회) | 3.92 | 16.3 | **20.8** |

`solve_times_ms`는 DAQP와 백업 OSQP의 `solve_problem` 시간을 합산하므로 "백업 포함 전체 풀이"는 맞다. q·h 빌드(+0.07~0.1 ms)와 예외로 끝난 솔버 호출 시간은 빠진다(n2). 22번 결론(p99 ≪ 5 ms, 실패 0)은 바뀌지 않지만 DAQP가 실패해 OSQP로 넘어가면 한 주기(20 ms)를 넘길 수 있다(m8).

### 1.5 `identify` 재실행(출력만 스크래치로)

`results/review_scratch/run_identify_scratch.py`(모듈의 `OUT_JSON`·`OUT_DIR`만 바꿈). 오차는 사건 이후 rms(모델 − 시뮬), 피치는 실제 몸체 피치.

| 조건 | 주기 | 스텝 v_base rms 저장 → 재실행 | 스텝 피치 rms 저장 → 재실행 | 밀기 v rms 저장 → 재실행 | 밀기 피치 rms 저장 → 재실행 | 스텝 피치 피크 시뮬 / 모델(재실행) |
|---|---|---|---|---|---|---|
| A 노이즈 끔·지연 0 | 1 kHz | 0.0257 → 0.0252 (5.0 %) | 0.498 → **0.668°** | 0.0282 → 0.0274 | 0.489 → 0.278° | 1.77 / 2.37° |
| B 노이즈·10 ms | 1 kHz | 0.0265 → 0.0263 (5.3 %) | 0.520 → **0.700°** | 0.0358 → 0.0335 | 0.467 → 0.262° | 1.81 / 2.31° |
| C = B − 건마찰 | 1 kHz | 0.0090 → 0.0092 | 0.571 → **0.678°** | 0.0421 → 0.0364 | 0.511 → 0.206° | 1.47 / 2.31° |
| A | 200 Hz | 0.0264 → 0.0259 | 0.504 → **0.659°** | 0.0290 → 0.0283 | 0.487 → 0.293° | 1.86 / 2.39° |
| B | 200 Hz | 0.0263 → 0.0259 | 0.462 → **0.662°** | 0.0274 → 0.0266 | 0.550 → 0.244° | 1.95 / 2.33° |
| C | 200 Hz | 0.0099 → 0.0100 | 0.575 → **0.670°** | 0.0091 → 0.0080 | 0.591 → 0.106° | 1.47 / 2.33° |

- 속도 채널은 재현되고 문서의 15 % 규칙(0.5 m/s 스텝 기준) 안이다: 스텝 5.0~5.3 %, 마찰 제거 시 1.8~2.0 %, 밀기 0.027~0.036 m/s.
- 피치 채널은 저장값과 다르다(스텝 +27~43 %, 밀기 −40~−82 %). 저장된 `model_fit.json/png`는 01:56에 만들어졌고 `lqi6.py`는 02:00에 바뀌었다(최종 실행 02:07·02:15). 건마찰을 없애도(C) 피치 오차가 줄지 않으므로 오차의 원인은 마찰이 아니라 모델 구조다(M4).
- 축약 차수는 두 주기 모두 7차(본문 2.3절의 "1 kHz 6차"는 낡음), a_max 0.8355 / 0.8336 m/s²(본문 3.1절 0.833·0.848과 다름), 다리 기울기 후보 2.46 m/s²(본문 "≥ 3.2"/3.11).

### 1.6 정지 이탈(전체 매트릭스, `stop_excursion_matrix.py`, 9조합 × 5시드 × 2주기 × 2호스트)

| 항목 · 호스트 · 주기 | 판정값(끝점) 최대 | 최대 이탈 최소 / 중앙 / 최대 | 0.3 m 초과 |
|---|---|---|---|
| 8·19(평지) MPC 1 kHz | 0.071 m | 0.278 / 0.286 / **0.293 m** | 0 |
| 8·19 MPC 200 Hz | 0.075 m | 0.268 / 0.283 / **0.297 m** | 0 |
| 8 램프(1단계) 1 kHz | 0.087 m | 0.217 / 0.229 / 0.240 m | 0 |
| 8 램프 200 Hz | 0.088 m | 0.209 / 0.224 / 0.236 m | 0 |
| 13 MPC 1 kHz 오르막 / 내리막 | 0.059 / 0.093 m | 최대 0.293 / 0.291 m | 0 |
| 13 MPC 200 Hz 오르막 / 내리막 | 0.059 / 0.107 m | 최대 0.296 / **0.303 m** | 3(내리막; 13번 기준은 0.5 m) |
| 13 램프 1 kHz / 200 Hz | ≤ 0.119 m | 최대 0.238 / 0.233 m | 0 |

최대 이탈 = 정지 명령(3.0 s) 뒤 진행 방향 최대 변위 = 처음 멈춘 지점(20 ms 평균 속도가 처음 0을 지나는 지점과 일치). MPC는 그 뒤 0.21~0.23 m 되돌아간다.

## 2. 사양 준수 검토

| 사양(사용자 문구) | 구현 | 판정 |
|---|---|---|
| 호스트 프로세스, HostEmulator 자리, MotionCtrl(전진, 요, 높이) 출력 | `Plan4UpkieLQI6._make_host`(plan4_upkie_lqi6.py:151-158)가 `MpcHost(link, plan, publish_hz)`로 교체, `set_command`/`tick` 같은 인터페이스 | 충족 |
| LQI6를 대체하지 않음 | MCU의 LQI6 그대로. `host_shaped`로 MCU 쪽 성형(램프·전치 필터·동결)만 켜고 끔(mcu.py:247-248, lqi6.py:103-109) | 충족 |
| 피치 기준을 내려보내지 않음 | `_send`가 `pitch = 0`, `pitch_ctrl_mode = False`를 강제(reference_mpc.py:891-892). 패킷 300개 검사로 확인. `roll`·`leg_split` 등은 사용자 명령 그대로 통과(n5) | 충족 |
| MPC에 적분기 없음 | 외란·오차 적분 상태 없음. QP 상태 [x̂, s, r, a], s는 매 풀이 0, w_x = 0. 단, 텔레메트리 보정은 1.5 s 시정수의 강한 속도 피드백(3.4절)으로 외란 때 사실상 두 번째 적분 루프처럼 작동(M1) | 형식상 충족, 취지는 외란 때 미충족 |
| 호스트는 텔레메트리만 읽음 | 실행 중 읽는 것은 `plan.mcu.est`(MCU 추정값, 지연·노이즈 포함)뿐. `sim` 접근 없음. 설계 정보로 이득표·플랜트 파라미터·MCU 파라미터·`plan.cfg.latency_ms`(설정 지연)를 씀 | 충족(n6: 설정 지연을 "측정 지연"으로 씀) |
| 주기 50~100 Hz, 구간 1~2 s | 50 Hz 고정 격자(간격 20.000 ms 확인), 1.5 s(N = 75). 범위 검사 없음, MCU 주기 정수배가 아니면 MPC가 조용히 꺼짐(n4) | 충족 |
| 솔버 qpmpc + daqp(또는 osqp) | qpmpc `MPCProblem/MPCQP`로 Φ, Ψ, G, h(x0) 생성, 출력 가중 비용은 직접 조립, DAQP(warm start: daqp 0.10.3이 `primal_start` 지원) → 같은 주기 OSQP 백업. 응축 행렬을 직접 시뮬레이션과 대조: 오차 2e-15, 제약 행 1.3e-15, 헤시안 조건수 8.0e5 | 충족 |
| 제약: 속도 한계 | |r_k| ≤ 1.0(reference_mpc.py:406-410). 기준에만 걸려 실제 몸체 속도는 반전 기동에서 1.02~1.06 m/s(m3) | 기준 제약으로 충족 |
| 제약: 가속도 한계(바퀴 토크 80 %·피치 한계에서 유도) | |a_k| ≤ a_max = 0.835 / 0.834 m/s², 결정 후보는 "피치 5° 일반 한계". 그러나 유도에 쓴 모델이 최종 내부 루프의 피치를 4.5° 대 실제 0.36~0.69°로 틀린다(M4). 토크 후보는 a_mcu 상한 1.6에서 잘림(m1) | 형식상 충족, 유도 근거 무효 |
| 제약: 다리 길이 범위 | QP에 없음. `up`을 [L_min, L_max]에 맞게 클립(reference_mpc.py:869-878, MCU 클램프와 중복) | 부분 충족(m2) |
| 제약: 저크 한계 | |Δa| ≤ j_max·T 변수 상하한(reference_mpc.py:471-472), j_max = a_max / 0.15 s | 충족 |
| QP 실패·비가용 → 램프 제한기로 즉시 전환, 이벤트 기록 | 같은 주기에 원시 목표 + `host_shaped = False` → MCU 1단계 성형. 이벤트는 남지만 문구가 실제 동작과 다름(m5). 복귀가 사실상 불가능하고 기동 중 전환 과도가 8·19를 깸(M2) | 부분 충족 |
| 예측 모델 (a)/(b) 중 택1 + 근거 | (a) 선형 폐루프 축약, 근거 기술(2.1절) | 충족 |
| 1단계 벤치 스텝·밀기 응답과 모델 예측을 겹쳐 그리고 rms 기록 | `model_fit.png/json` 있음. 최종 코드 이전 산출이라 피치 rms가 재현되지 않음(M5), 피치 채널 자체가 틀림(M4) | 부분 충족 |
| host_shaped 의미: 타임아웃·QP 실패 때 MCU가 자체 성형으로 복귀 | 타임아웃: `HostLink.poll`의 단절 패킷은 플래그 거짓(host_link.py:98-106) → 성형 켜짐. QP 실패: 호스트가 거짓 송신. 전환 시 `v_filt = v_ramp`로 연속(MCU 한 스텝 최대 기준 변화 0.004 m/s(1 kHz)·0.0167 m/s(200 Hz)) | 충족 |

## 3. 예측 모델 검토

### 3.1 유도의 정확성

`model.lqi6_closed_loop`를 `lqi6.py`의 실행 순서와 한 줄씩 대조했다.
- 플랜트: `plan.plant.linearize(L0)`에서 x를 뺀 5상태를 MCU 주기로 ZOH 이산화 — `LQI6.design`과 같다. 밀기 입력 열(전체 무게중심 수평 힘)도 맞다.
- 제어기: 이득은 MCU의 이득표(`_gains_no_side_effect`, 같은 보간), 적분 z(∫(v − r)), z_att(θ + φ + (Tp − T)/gM, 직전 출력 사용), z_pos(∫z)의 갱신 순서와 부호가 `LQI6.step`과 같다. 관측 지연 10 ms = 10 / 2 스텝(플랜의 `ObservationDelay`와 같은 값)을 측정 사슬로 둔 것도 맞다.
- 리프팅(A^m, ΣA^iB)과 제곱근 균형 절단 + 특이 섭동 DC 맞춤도 맞다. 자동 차수는 두 주기 모두 7차.
- 내 복제본(`spot_check_19.py`의 `closed_loop_gated`, 게이팅 끔)이 저장소 모델과 2e-15 안에서 같다.

모델에 없는 것: **z_att 게이팅**(저역통과 기준 가속도 > 0.1 m/s² 동안 적분 정지, lqi6.py:224-246 — model.py:127 주석 "conditional integration … not modelled"), 5 ms 위치 차분 속도의 추가 지연(약 2.5 ms), MCU 4 m/s² 램프(ZOH로 봄), 포화·적분 클램프, 관절 건마찰과 마찰 보상. 이 중 게이팅이 결정적이다.

### 3.2 피치 채널: 게이팅 누락의 정량화

MPC가 실제로 보낸 기준(LQI6가 쓴 `v_filt`, 매 MCU 스텝)을 모델에 넣어 MPC 구동 스텝을 비교했다(`spot_check_19.py`).

| 경우 | v_base rms(모델) | 피치 rms(모델) | 피치 피크 실제 / 모델 | 게이팅을 흉내 낸 모델: 피치 rms / 피크 | z_att 정지 시간 비율 |
|---|---|---|---|---|---|
| 1 kHz 공칭 s0 | 0.0235 m/s | 0.639° | 0.97 / **1.82°** | 0.180° / 0.82° | 38.9 % |
| 200 Hz 공칭 s0 | 0.0245 | 0.658° | 0.97 / **1.80°** | 0.191° / 0.81° | 37.8 % |
| 1 kHz m×1.15 μ1.0 s2 | 0.0231 | 0.637° | 1.17 / **1.87°** | 0.336° / 0.82° | 37.9 % |

게이팅(같은 저역통과·임계값으로 z_att 행만 동결)을 넣으면 피치 rms가 1/2~1/3.5로 준다. 시뮬레이션의 실제 정지 비율과 흉내 모델의 비율은 소수 넷째 자리까지 같다.

a_max를 결정한 기동(−1 → +1 m/s 반전, `experiments_stage2.py`)을 실제 MPC 호스트로 돌린 결과: 반전 구간 실제 피치 피크 0.42 / 0.69 / 0.39°(1 kHz, 질량 1.0 / 1.15 / 0.85), 0.47 / 0.67 / 0.36°(200 Hz). 모델은 a_max에서 4.50°를 예측한다. 바퀴 피크 0.24~0.29 N·m(예산 0.92), 다리 기울기 |θ_v| ≤ 14.4°(예산 25.6°). 즉 a_max = 0.835는 "피치 5° 한계"가 아니라 모델의 허상이 정한 값이고, 피치 비용 w_p도 존재하지 않는 피치 1.8°에 작용한다. 방향은 보수적(실제 피치가 더 작음)이라 안전 문제는 아니다.

### 3.3 a_max 유도 수치 대조(문서 3.1절 ↔ 코드)

| 항목 | 문서(시점 B / C) | 코드 재실행(identify 플랜, ramp 4.0) | 합격 시험 플랜(MpcHost 생성 시점, ramp 2.0) |
|---|---|---|---|
| 예산: 토크 / 피치 일반 / 19번 피치 / 다리 | 0.922 N·m / 4.5° / 1.5° / 25.6° | 같음 | 같음 |
| 강체 근사 (mR + I_w/R)/2 | 0.158 | 0.158 | 0.158 |
| a_T | ≥ 3.2 | 3.2(상한) | **1.6(상한)** |
| a_p,gen(결정) | 0.833 / 0.848 | 0.8354 / 0.8336 | 0.8355 / 0.8336 |
| a_p,step(보고만) | 0.33 / 0.345 | 0.327 / 0.326 | 0.328 / 0.326 |
| a_lean | ≥ 3.2 / 3.11 | 2.465 / 2.459 | **1.6(상한)** |
| a_mcu = 0.8 × MCU 램프 | 3.2 | 3.2 | **1.6** |
| a_max, j_max | 0.833 / 0.848, 5.55 | 0.835 / 0.834, 5.57 / 5.56 | 0.835 / 0.834, 5.57 / 5.56 |

예산 산식은 코드와 맞다. 수치는 본문이 낡았고(최종 상태 절은 이 값을 다시 적지 않음, n1), 합격 시험에서는 a_mcu가 MCU가 MPC 모드에서 실제로 쓰는 4 m/s²가 아니라 생성 시점의 성형 램프 2 m/s²로 계산된다(m1).

### 3.4 텔레메트리 보정은 숨은 적분기인가

`host_analysis.py`: 무제약 MPC 법칙(u₀ = g₀·q(x₀), 목표 0)과 정상상태 칼만 보정(x̂ ← x̂ + A L (y − ŷ))을 합쳐, 측정 속도 y에서 송신 기준 r까지의 호스트를 선형 제어기로 놓고 극과 DC 이득을 구했다.

| | 1 kHz | 200 Hz |
|---|---|---|
| 축약 모델 최대 |고윳값| (20 ms) | 0.9865 | 0.9864 |
| 관측기 오차 극 최대 | 0.9858 | 0.9858 |
| 호스트 제어기(y → r) 최대 |극| / 시정수 | 0.9871 / 1.55 s | 0.9872 / 1.56 s |
| DC 이득 y → r | **−1.57** | **−1.54** |

- 형식 판정: 단위원 위 극이 없고 DC 이득이 유한하므로 **적분기는 아니다**(외란 상태도 없음).
- 동특성 판정: 1.5 s 시정수에 DC 이득 −1.57이므로, 기동 시간 규모(1~3 s)에서는 측정-예측 속도 차를 적분하듯 기준을 움직이는 강한 바깥 속도 루프다. 보정 방향은 LQI6 속도 적분기 z의 방향이라, 밀기처럼 모델에 없는 외란이 생기면 호스트가 그것을 "적분기 와인드업"으로 읽고 기준을 크게 움직인다. 0.3 m/s 주행 중 0.75 W 밀기(1 kHz, m×1.15 μ0.75)에서 기준은 0.28 → −0.003(3.5 s) → 0.51(4.3 s) → 0.16(5.0 s) → 0.33 m/s로 흔들리고 로봇은 −0.29 m/s까지 후진했다(램프 호스트: 기준 0.30 고정, 최저 −0.02 m/s). 사양이 "MPC에는 적분기를 두지 않는다"로 막으려던 "두 적분기의 싸움"이 외란 때 그대로 나타난다(M1).
- 정지 중(목표 정확히 0이고 기동 종료 0.5 s 뒤)에는 보정이 꺼져 이 문제가 없다. 그래서 배터리의 외란 항목에서는 보이지 않는다.

## 4. 코드 findings(등급순)

### MAJOR

**M1. 텔레메트리 보정 + MPC가 외란 때 LQI6 적분기와 싸운다; 배터리는 호스트가 꺼진 상태로만 외란을 시험한다**
- 위치: `reference_mpc.py:703-725`(`_correct`; 활성 조건 `v_star != 0.0`의 정확한 부동소수 비교 708·713행), `:193-228`(관측기: 과정 잡음을 z 방향에만 둠), `:113-116`(handover, obs_hold_s); `acceptance.py:281-294`(밀기 시나리오의 목표 0), `docs/plan4_mpc_host.md:96, 127`("외란은 1단계처럼 내부 루프에 맡긴다").
- 근거(`experiments2/3_stage2.py`, 배터리 시나리오·판정 코드 그대로):
  - 6번(0.75 W)을 목표 **1e-4 m/s**로: 1 kHz 25/45 실패(기존 바퀴 rms 10회 + **새로 정착 4.05~4.27 s > 4 s 15회**, m×1.15 전부), 200 Hz **6/45 실패**(정착 4.005~4.195 s, m×1.15 시드 2·4). 목표 정확히 0이면 10/45, 0/45. 2·5번은 통과하지만 이동이 0.001~0.09 → 0.09~0.17 m로 커진다.
  - 0.3 m/s 주행 중 밀기(기준 밖 시나리오, 시드 0, 9조합): 정착 시간 램프 호스트 대 MPC 호스트 — 1 kHz 0.75 W: m×0.85 2.05 → 2.97 s(μ0.75), m×1.0 1.87 → 3.30 s, m×1.15 2.25 → **4.50 s**; 200 Hz 0.75 W m×1.15 2.25 → **4.21 s**; 0.5 W m×1.15 2.05 → 3.31 s(1 kHz), 2.22 → 3.18 s(200 Hz). MPC 쪽 최저 속도 −0.13 ~ **−0.67 m/s**(후진), 바퀴 rms도 큼. 6번의 정착 기준(4 s)을 적용하면 m×1.15에서 MPC만 실패.
- 영향: 실기에서는 조이스틱·플래너가 0이 아닌 작은 값을 보내거나 주행 중 부딪히는 일이 흔하다. 검증된 "1~7·9·10·12·15~17은 1단계와 같다"는 목표가 정확히 0.0일 때만 성립한다. 판정 뒤집힘(6번, 200 Hz)과 실기 거동 두 기준에서 MAJOR.
- 수정 제안: (1) 목표 데드밴드(예: |v*| < 0.02 m/s → 0) — 최소 조치; (2) 혁신 게이팅: |y − ŷ|가 관측 잡음·마찰 오차 규모(수 cm/s)를 넘으면 보정하지 않거나 크기를 제한, 또는 MCU 피치·토크 이상 신호 때 보정 정지; (3) σ_z를 줄이거나 보정을 "가속 구간의 마찰 와인드업"으로 한정; (4) 배터리에 "주행 중 밀기"(0.3 m/s, 0.5·0.75 W)와 "목표 1e-4" 변형을 추가하고 두 호스트를 비교.

**M2. 기동 중 일시적 QP 실패 뒤 MPC가 복귀하지 않고, 혼합 과도가 8·19번을 깬다; 23번 시험은 t = 0 실패만 본다**
- 위치: `reference_mpc.py:741-753`(복귀 조건 `abs(self._a) < 1e-6`, 743-744행), `:880-889`(폴백 때 원시 목표 + 플래그 거짓), `:780-805`(송신하지 않는 명시 해로 내부 상태 전파); `acceptance_mpc.py:79-97`(`force_fail = True`를 생성 직후부터 → 23번은 1단계와 같은 동작만 시험).
- 근거(`experiments2_stage2.py`, `force_fail`을 0.1 s만 켬, 배터리 `_velocity_profile`과 8·19 판정 그대로, 9조합 × 2주기, 시드 0):

| 실패 시각 | 8번 | 19번 | 최악 오버슈트 | 최악 정상 오차 | MPC 복귀 |
|---|---|---|---|---|---|
| 0.8 s(가속 중) | **12/18 실패**(정상 오차 0.050~0.056 > 0.05) | **18/18 실패**(오버슈트 11.3~14.9 %) | 14.9 % | 0.056 m/s | 0/18 |
| 1.2 s(목표 근처) | **18/18 실패**(오버슈트 27.5~30.1 % > 20 %, 정상 오차 0.097~0.112) | **18/18 실패**(+ m×1.15 피치 2.16~2.21°) | 30.1 % | 0.112 m/s | 2/18 |
| 3.04 s(제동 중, 공칭) | 통과 | 통과 | — | — | 0 |

  - 복귀 진단: 0.8 s 실패 뒤 14.5 s 동안 725주기 중 684주기가 폴백, 폴백 중 |a| 최솟값 1.3e-5 m/s²(정지 후 구간)로 1e-6에 한 번도 닿지 않았다. 12 s 등속 주행에서도 복귀 없음.
  - 원인: MPC 모드의 LQI6 적분기 z는 동결 없이 감겨 있고 MPC는 그 되갚음을 예상해 기준을 목표보다 낮게 두고 있었다. 폴백에서 원시 목표를 성형 켜진 MCU로 보내면 되갚음이 목표 위에 더해진다(1단계 성형은 출발부터 동결해야 성립).
- 영향: "솔버 강제 실패에서 램프로 전환되고 1·8·11을 통과"(23번)는 실패 시점을 정하지 않는다. 기동 중 실패라는 자연스러운 해석에서 8번이 실패하므로 23번 판정이 바뀐다. 실기에서는 솔버 예외·DLL 문제·시간 초과가 주행 중에 생긴다.
- 수정 제안: (1) 기동 중 실패면 마지막 계획의 꼬리(또는 명시 해)를 `host_shaped = True`로 계속 보내고 정지 후에만 MCU 성형으로 넘기거나, MCU가 성형으로 바뀔 때 z를 현재 기준과 맞게 재설정·동결; (2) 복귀 조건을 "그림자 QP가 N주기 연속 성공 + |a| < 0.05 m/s²" 같은 잡음 수준 허용으로 바꾸고 무충격 전환(r_prev = MCU의 v_filt); (3) 23번에 가속·등속·제동 중 실패 변형 추가.

**M3. 정지 거리 판정(끝점)이 실제 정지 이탈을 숨기고, MPC의 넘김(handover) 설계가 이 정의에 맞춰져 있다**
- 위치: `acceptance.py:320`(`stop_disp = |x_끝 − x(3 s)|`), `reference_mpc.py:113-116, 714-719`(목표 0 뒤 0.5 s에 예측 상태만 0으로; 그 시점 r = 0.088~0.094 m/s, a = −a_max로 아직 감속 중 — 주석의 "r → 0"도 코드에 없음), `docs/plan4_mpc_host.md:85`("정지 거리 0.11 → 0.07 m"), `:329`("MPC는 최대 이탈이 더 작다").
- 근거(1.6절): MPC는 정지 명령 뒤 0.268~0.297 m 가서 멈춘 뒤 LQI6 적분기에 끌려 0.21~0.23 m 되돌아온다. 판정값은 0.06~0.075 m(×0.24), 19번 기준 문구("정지 명령 후 0.3 m 안에 정지")의 자연스러운 측정인 최대 이탈은 0.297 m(×0.99). 1단계 램프 호스트는 0.209~0.240 m로 **MPC가 22~26 % 더 길다**(문서는 반대). 200 Hz 13번 내리막은 0.303 m.
- 영향: 현 매트릭스에서 19번은 어느 정의로도 통과하지만 실제 여유가 1 % 안팎이라 보고된 여유(×0.24)가 판정 근거로 쓸 수 없는 수치다. 20번 지표 비교에서도 8번 정지 거리 여유가 ×0.48 → ×0.59(1 kHz, +22 %)·×0.47 → ×0.59(200 Hz, +26 %)로 10 % 넘게 나빠지는 것이 끝점 정의 때문에 보이지 않는다. 실기에서는 "멈췄다가 20 cm 뒤로 가는" 동작이다.
- 수정 제안: `stop_disp`를 정지 명령 뒤 최대 이탈(또는 첫 정지 거리)로 바꾸고 되돌아감 상한(예: ≤ 5 cm)을 함께 두기(기준 해석은 사용자 확인 필요); 넘김 시점·obs_hold_s·감속 기준 모델(ω_down 10 rad/s)을 실제 이탈 기준으로 다시 조정; 8·13·19·20 재판정.

**M4. 예측 모델이 최종 내부 루프(z_att 게이팅)를 표현하지 않아 피치 채널과 "피치에서 유도한" 가속도 한계가 무효다**
- 위치: `model.py:112-127, 184-186`(z_att가 항상 적분), `lqi6.py:224-246`(게이팅), `reference_mpc.py:246-312`(`derive_limits`가 같은 모델로 피치 피크 계산), `docs/plan4_mpc_host.md:30`("호스트는 … 코드 수정 없이 따라갔다").
- 근거(3.2절): MPC 스텝에서 모델 피치 피크 1.80~1.87° 대 실제 0.97~1.17°(rms 0.64~0.66°), 게이팅을 흉내 내면 0.18~0.34°; 반전 기동 모델 4.50° 대 실제 0.36~0.69°. 이득표에서 다시 만드는 방식은 이득·적분기 구조 변화는 따라가지만 조건부 적분 같은 논리 변화는 따라가지 못한다.
- 영향: 사양의 "가속도 한계(바퀴 토크 80 %와 피치 한계에서 유도)"와 "예측 모델 = 1단계 LQI6 폐루프"가 최종 시스템에서는 실질적으로 성립하지 않는다. a_max 0.835는 피치가 아니라 모델 허상이 정했고, 비용의 피치 항은 실제로 없는 피치를 줄이려 한다. 19번 피치 통과는 MPC 예측이 아니라 내부 루프 게이팅 덕분이다. 오차 방향이 보수적이라 판정·안전에는 영향이 없다.
- 수정 제안: (1) 예측에 게이팅을 넣기 — 계획된 기준에서 저역통과 가속도를 계산해 z_att 동결 구간을 정하는 전환(LTV) 모델, 또는 기동 중에는 z_att 동결 모델을 쓰는 단순화; (2) MPC 구동 실행(현재처럼 4 m/s² 램프 스텝이 아닌)으로 피치 채널을 검증하고 rms·피크를 기록; (3) a_max를 고친 모델로 다시 유도하고 8·13·19·21 재확인; (4) 내부 루프 논리를 바꿀 때 모델 재검증을 체크리스트에 넣기.

**M5. 최종 상태 절과 `results/plan4_mpc/` 산출물에 최종 코드로 재현되지 않는 수치가 있다**
- `docs/plan4_mpc_host.md:30`·`results/plan4_mpc/model_fit.json/png`(01:56): 스텝 피치 rms 0.46~0.52°, 밀기 피치 rms 0.47~0.59° → 최종 코드 재실행 0.66~0.70°, 0.11~0.29°(1.5절). `lqi6.py`가 02:00에 바뀐 뒤 다시 만들지 않았다. 사양이 요구한 "겹친 그림 + rms 기록" 산출물이다.
- `docs/plan4_mpc_host.md:25`: "19번 … 전체 매트릭스 최악 1.65°(1 kHz)·1.51°(200 Hz)" → 공식 JSON·재현 모두 **1.172°·1.292°**. 1.652°·1.505°는 01:53~01:54의 중간 실행 캐시 `mpc_w4_r1`(축소 매트릭스, 02:00 lqi6.py 수정 전)에 있는 값과 일치한다.
- `docs/plan4_mpc_host.md:86`: "6(1 kHz 3회, 바퀴 rms 0.22)" → 공식 1 kHz 6번 실패는 **10회**(m×0.85의 μ0.75·μ1.0 각 시드 0~4, 0.222~0.227; `docs/plan4_lqi8.md` 0절도 같은 오기).
- `docs/plan4_mpc_host.md:85`: "1~17은 … 수치가 같다" → 10번은 1 kHz에서 45회 모두 다르다(n3); "오버슈트 ≤ 11 % → ≈1 %" → 200 Hz는 13.3 % → 3.0 %; "정지 거리 0.11 → 0.07 m" → 1단계 0.087/0.088 m(그리고 M3); "여유율이 10 % 넘게 나빠진 지표 없음" → 저장소의 `regression.py` 규칙으로 200 Hz 8번 wheel_peak ×0.217 → ×0.247(+14 %).
- `results/plan4_mpc/regression.md·regression_vs_official_stage1.md·ramp_vs_mpc*.{png,json}·constraint_check.json·compare_hosts*.log·identify.log·timing_variants.json`은 01:10~01:31(시점 A/B) 산출이다. 예: `ramp_vs_mpc.json`의 MPC 피치 2.17°(19번 실패 수준), `constraint_check.json`의 바퀴 피크 0.43~0.53 N·m.
- 영향: 판정 결과 파일(`plan4_mpc_*Hz.json`)은 정확하므로 통과/실패는 바뀌지 않는다. 그러나 문서·산출물의 수치를 근거로 쓸 수 없다(등급 규칙상 재현 불가 수치).
- 수정 제안: 최종 해시로 `identify`·`compare_hosts`·`regression`·`acceptance_mpc`를 다시 돌려 산출물을 갱신하고, 모든 산출물에 코드 해시를 적기; 최종 상태 절 수치를 공식 JSON에서 자동으로 뽑기.

### minor

- **m1** `derive_limits`의 MCU 램프 상한이 호스트 생성 시점의 `ctrl.v_ramp_rate`(성형 2.0)를 써서 a_mcu = 1.6 m/s²다. MPC 모드에서 MCU가 실제로 쓰는 것은 `plain_ramp_rate` 4.0(lqi6.py:76-77, 108)이므로 3.2여야 한다. 토크·다리 후보가 1.6에서 잘린다. 지금은 피치(0.835)가 결정해 영향 없음; M4를 고치면 드러난다. `reference_mpc.py:284`(`_plan_key`의 135행도 같은 값을 키로 씀). 수정: `ctrl._plain[0]` 사용.
- **m2** 다리 길이 범위 제약이 QP에 없고 통과값 클립이다(reference_mpc.py:869-878, MCU 클램프와 중복). 예측 모델은 L0 = 0.31 하나뿐이라(reference_mpc.py:142) 웅크린 채 주행하면 모델이 틀린다. 수정: 사양 문구를 "통과값 클립"으로 명시하거나 L0 스케줄 모델·높이 속도 제약 추가.
- **m3** 속도 제약이 기준 r에만 있어 실제 몸체 속도가 v_max를 넘는다(반전 기동 1.02~1.06 m/s, reference_mpc.py:406-410). 사양의 "속도 한계"가 로봇 속도라면 예측 v̂_base에도 상한을 둬야 한다.
- **m4** 21번의 "가속도·속도 제약 위반 0회"는 성공한 QP 해를 그 자신의 제약으로 검사한 값(reference_mpc.py:853-867)이라 정의상 0이고, 실제 송신 패킷·폴백 주기는 보지 않는다(acceptance_mpc.py:121-133). 이번에 패킷으로 독립 검사해 0회를 확인했지만 판정 코드는 패킷(`link.receive`) 기준으로 세야 한다.
- **m5** 폴백 이벤트 문구가 실제 동작과 다르다: "fallback engaged: explicit unconstrained MPC law + ramp limiter"(reference_mpc.py:763-765) — 실제로는 원시 목표 + MCU 1단계 성형. 내부 상태는 송신하지 않는 명시 해로 전파·보정된다(780-805행). 실기 진단을 오도한다.
- **m6** 23번의 1번 시험이 60 s가 아니라 10 s다(acceptance_mpc.py:82). 폴백 상태의 정지는 1단계와 같은 경로라 결과는 같을 것으로 보이나 기준 정의와 다르다.
- **m7** 필수 항목 20이 배터리에 없어 `plan4_mpc_*Hz.md`의 "종합" 판정에서 빠진다(acceptance.py:137-149, 618-681). `regression.py:54`는 항목별 "가장 빠듯한 지표" 여유만 비교하고 (조합·시드)별 통과 집합을 비교하지 않는다. 이번 실행 단위 재검(1176회)에서 1단계 통과 → 2단계 실패는 0회였다.
- **m8** 백업 OSQP에 시간 제한이 없다(reference_mpc.py:521, `max_iter = 20000`). 최종 코드에서 OSQP를 1차로 쓰면 p99 16.3 ms, 최대 20.8 ms로 50 Hz 주기를 넘는다. 매번 새 OSQP 인스턴스를 만들어 분해한다. 실기에서는 DAQP 실패 주기에 게시가 늦는다. 수정: `time_limit`·반복 제한을 주기 예산에 맞추고 영속 OSQP 객체 + warm start, 초과 시 즉시 폴백.
- **m9** 1단계 `HostEmulator`의 실제 게시 간격은 2 s 동안 1 kHz에서 96개 중 71개가 21 ms, 200 Hz에서 84개 중 59개가 25 ms(평균 약 48 / 43 Hz, 시간이 갈수록 21 / 25 ms만 남음)다(host_link.py:133-136). MPC 호스트는 정확히 20 ms라 20번 비교가 같은 호스트 주기에서 이루어지지 않는다. 10번(목표 0)이 1 kHz에서 비트 동일하지 않은 원인이다(최대 wheel_peak 0.157 → 0.221 N·m, 여유 영향 없음). 문서는 "21 ms가 되는 경우가 있다"고만 적었다.
- **m10** MPC는 MCU 상태를 모른 채 내부 예측으로만 기준을 정한다: 텔레메트리 단절 뒤 재동기(`_resync`, reference_mpc.py:676-698)는 측정 속도를 현재 기준으로 삼아 MCU의 실제 v_filt·z와 어긋날 수 있고, M2의 복귀 시점에도 같은 문제가 있다. 수정: MCU가 텔레메트리에 v_filt(또는 v_ref)를 실어 보내고 호스트가 그것으로 무충격 전환.
- **m11** 실기 이식 가정이 코드에 없다: 호스트는 같은 프로세스의 `plan.mcu.est` 객체를 MCU 주기로 읽는다(reference_mpc.py:656-659). DIABLO 텔레메트리는 50 Hz다. 이번에 50 Hz 단일 표본·텔레메트리 20 ms 지연·명령 10~20 ms 지연을 넣어 보았는데 19번 지표는 모두 통과했다(6절). 다만 관측기 σ_v(0.01 m/s, 20 ms 평균 가정)는 단일 표본 잡음에 맞지 않으므로 실기 텔레메트리 형식을 정한 뒤 다시 정해야 한다.

### nit

- **n1** 본문 2.3·3.1·7.1절 수치가 낡았다(차수 1 kHz 6차 → 7차, a_max 0.833/0.848 → 0.835/0.834, a_lean ≥ 3.2/3.11 → 2.46, a_mcu 3.2 → 합격 시험 1.6). 최종 상태 절이 "대체한다"고 했지만 이 값들은 다시 적지 않았다.
- **n2** 풀이 시간은 `solve_problem` 호출만 잰다(reference_mpc.py:510, 523-525): q·h 빌드, 예외로 끝난 솔버 시간이 빠진다. 호스트 주기 전체는 p99 0.36~0.40 ms(1.4절, 세 경우)라 결론은 같다.
- **n3** 문서의 "목표가 0인 항목은 두 호스트 수치가 완전히 같다"는 10번 1 kHz에서 틀리다(m9).
- **n4** `horizon_s`·`host_hz` 범위 검사가 없고, 호스트 주기가 MCU 주기의 정수배가 아니면 `ValueError`가 잡혀 MPC가 조용히 꺼진다(reference_mpc.py:154-155, 576-579; 이벤트만 남음).
- **n5** `_send`가 `roll`·`leg_split`·`mode_mark`·나머지 모드 비트를 사용자 명령 그대로 통과시킨다(reference_mpc.py:881). 사양("속도·요·높이만")보다 넓다(기본값 0이라 실해 없음).
- **n6** 예측 모델이 시뮬레이션의 설정 지연 `plan.cfg.latency_ms`를 "측정된 지연"으로 쓴다(model.py:318-319). 15번 지연 스윕에서는 호스트가 매 실행의 참 지연을 안다(목표 0이라 영향 없음). 실기에서는 측정값으로 바꿔야 한다.
- **n7** LQI6의 성형 상태(`shaping_on`)가 `plan.reset()`에서 초기화되지 않는다(lqi6.py:111-120). 첫 MCU 틱에서 호스트 플래그가 바로 덮어써서 지금은 무해하지만 `_plan_key`·`derive_limits`가 직전 실행의 램프 값을 읽는다(m1과 같은 경로).

## 5. 판정 코드 검토(19~23, 회귀 비교)

| # | 판정 코드 | 검토 결과 |
|---|---|---|
| 19 | `STAGE2_ITEMS[0]`(acceptance.py:138-140): 실제 피치 피크 ≤ 2°, 오버슈트 ≤ 10 %(0.5~3.0 s 원시 vx 최대), 90 % 도달 ≤ 1.5 s, 정지 ≤ 0.3 m, 정착 + 토크 여유 | 피치·오버슈트·도달은 원자료로 재계산해 일치. **"느리게 가서 피치를 맞추기"는 막혀 있다**: 도달 ≤ 1.5 s가 실제로 판정되고 최악 0.958/0.990 s. 오버슈트는 원시 vx라 1 kHz 떨림이 들어가 보수적. 문제는 정지 거리 정의(M3) |
| 20 | 배터리에 없음, `regression.py`(항목별 최악 여유) | 실행 단위 재검(아래 표) 결과 회귀 없음. 배터리 종합 판정에 20이 빠짐(m7). 끝점 정지 거리 때문에 8번 정지 여유 악화(+22~26 %)가 안 보임(M3) |
| 21 | 조합·시드마다 8·9·13·19를 MPC로 돌려 최악 바퀴 피크·위반 합 | 90회 모두 QP 실패 0·위반 0·생존, 최악 0.438 N·m. 위반 카운터가 자기 검사(m4) — 패킷 독립 검사로 0회 확인 |
| 22 | 공칭 스텝 + 0.5 W 밀기, 750회, 백업 포함 합산 | 재현 p99 0.321/0.295 ms, 최대 0.62/0.51 ms, 실패 0. 750회 중 약 80 %가 정지 중의 쉬운 풀이지만 기동 구간만의 p99도 0.33 ms. OSQP 백업 시간 위험(m8) |
| 23 | 생성 직후부터 `force_fail` → 정지 10 s, 스텝, 링크 끊김 | t = 0 실패는 폴백 = 1단계와 같은 경로라 통과가 당연하다. 기동 중 실패는 시험하지 않음(M2), 정지 10 s(m6) |

20번 실행 단위 비교(`per_run_compare.py`, `final_s1` 대 `final_s2`, 같은 해시, 1176회 = 항목 1~17 × 9조합 × 5시드 × 2주기 + 공칭 항목):

| 항목 | 결과 |
|---|---|
| 1~7, 9, 12, 15, 16, 17(두 주기), 10(200 Hz) | 실행 결과 전 키가 비트 동일 |
| 10(1 kHz) | 45회 모두 다름(게시 간격 차이, m9), 판정 지표 최대 상대차 wheel_peak +40.7 %(0.157 → 0.221 N·m), 항목 최악 여유 변화 없음(leg_rms ×0.35) |
| 8, 11, 13 | 호스트 차이로 다름(기대). 1단계 통과 → 2단계 실패 0회, 그 반대 0회 |
| 항목별 가장 빠듯한 지표 | 10 % 넘게 나빠진 항목 없음(1 kHz·200 Hz) |
| 지표별(저장소 규칙: 여유 ≥ 0.05) | 200 Hz 8번 wheel_peak ×0.217 → ×0.247(+14 %) 1건. 끝점 대신 최대 이탈로 보면 8번 정지 거리 ×0.48 → ×0.59(1 kHz)·×0.47 → ×0.59(200 Hz) |
| 1단계도 실패인 항목 | 6(1 kHz 10회), 15(1 kHz), 16, 17 — 두 단계 실패 집합이 실행 단위로 같다 |

## 6. 검증한 것(문제 없음 또는 확인 완료)

- 재현성: 축소 매트릭스 100회 비트 동일, 공식 요약 JSON ↔ 캐시 일치(두 단계), 검토 전후 코드 해시 동일.
- 피치 기준 미송신, 20 ms 고정 격자, `host_shaped` 송신값(정상 참, 폴백 거짓), 타임아웃 시 MCU 자체 성형 복귀(11번 정지 2.10~2.36 s), 성형 전환 시 기준 연속.
- QP 구성: qpmpc 응축 행렬·제약 행이 직접 시뮬레이션과 일치(2e-15), 헤시안 조건수 8.0e5, DAQP warm start 전달, 해 비유한·예외 처리, 텔레메트리 NaN 무시.
- 송신 기준의 속도·가속도·저크 한계 준수(한계에 정확히 붙음), 21번 360시나리오 QP 실패 0.
- 19번 독립 재계산(피치·오버슈트·도달·바퀴 피크)이 판정 코드와 일치, 도달 시간 조건이 실제로 판정됨.
- 22번: 백업 포함 합산 측정, 호스트 주기 전체 p99 0.37~0.40 ms.
- 예측 모델 유도(플랜트·이득표·적분기 순서·지연 사슬·리프팅·균형 절단)가 `LQI6.step`과 일치, 속도 채널 15 % 규칙 충족(스텝 5.0~5.3 %, 밀기 0.027~0.036 m/s, MPC 구동 스텝 4.6~4.9 %).
- 실기 텔레메트리·지연 민감도(1 kHz·200 Hz, 공칭과 m×1.15 μ1.0 s2): 50 Hz 단일 표본, 텔레메트리 20 ms 지연, 명령 10·20 ms 지연, 둘의 조합 모두 19번 지표 통과 — 도달 0.89~0.99 s, 오버슈트 ≤ 3.4 %, 피치 ≤ 1.28°, 정지 끝점 ≤ 0.079 m(최대 이탈 0.267~0.295 m, M3와 같은 수준). 같은 명령 지연에서 1단계 램프 호스트는 오버슈트 7.6~10.5 %·피치 ≤ 2.03°.
- 제동 중(3.04 s) 0.1 s QP 실패는 지표 문제 없음(정지 최대 이탈 0.226~0.229 m) — 복귀 안 되는 문제만 남음(M2).

## 7. 권고(우선순위)

1. **M2**: 폴백 전환을 무충격으로(기동 중에는 호스트 성형 유지 또는 MCU 적분기 재정렬) 바꾸고 복귀 조건을 잡음 수준 허용으로 고친 뒤, 23번에 가속·등속·제동 중 실패 변형을 넣어 재판정.
2. **M1**: 목표 데드밴드 + 관측기 혁신 게이팅. 배터리에 "주행 중 밀기"·"목표 1e-4" 변형을 추가하고 1단계 램프 호스트와 비교(6번 정착 4 s 기준 포함).
3. **M3**: 정지 거리 정의를 최대 이탈(+ 되돌아감 상한)로 바꿀지 사용자에게 확인받고, 바꾸면 넘김·감속 기준 모델을 다시 조정해 8·13·19·20 재판정.
4. **M4**: 예측 모델에 z_att 게이팅 반영, MPC 구동 응답으로 피치 채널 검증, a_max 재유도(m1의 램프 값도 함께 수정).
5. **M5**: 최종 해시로 `identify`·`compare_hosts`·`regression`·`acceptance_mpc` 산출물 재생성, 최종 상태 절 수치 정정(19번 최악 1.172°/1.292°, 6번 10회 등), 산출물에 코드 해시 기록.
6. minor: m8(OSQP 시간 예산), m4(패킷 기준 위반 계수), m7(20번을 배터리에 편입하고 실행 단위 비교), m5(이벤트 문구), m9(1단계 호스트 게시 격자를 고정 격자로 맞춘 비교), m10·m11(실기 텔레메트리 형식 확정 후 관측기 재조정).

## 부록: 실행한 것과 스크래치 파일(`results/review_scratch/`)

| 파일 | 내용 |
|---|---|
| `acceptance_mpc_r1.log`, `acceptance_mpc/` | 지시된 축소 매트릭스 재현(캐시 태그 review_mpc_r1) |
| `per_run_compare.py`, `repro_vs_final_s2.json`, `s1_vs_s2_full.json` | 실행 단위 비교(재현 ↔ 공식, 1단계 ↔ 2단계) |
| `regression_official_final.md` | 저장소 `regression.py`를 최종 공식 JSON으로 다시 돌린 결과 |
| `run_identify_scratch.py`, `identify/` | `identify` 재실행(출력 경로만 변경) |
| `spot_check_19.py`, `spot_*.json` | 19번 원자료 재계산·패킷 검사·주기 시간·MPC 구동 모델 비교·게이팅 흉내 모델 |
| `stop_excursion_matrix.py/.json/.log` | 정지 최대 이탈 전체 매트릭스(두 호스트) |
| `host_analysis.py` | 응축 행렬 검증, 헤시안 조건수, 호스트 제어기 극·DC 이득 |
| `experiments_stage2.py/.json` | 일시 실패, 텔레메트리·명령 지연, 목표 1e-4(공칭), 반전 기동 |
| `experiments2_stage2.py/.json` | 기동 중 실패 18조합 × 2시각, 목표 1e-4의 2·5·6번, 복귀 진단 |
| `experiments3_stage2.py/.json`, `drivepush_trace.py` | 6번 목표 1e-4 전체 매트릭스, 주행 중 밀기(두 호스트), 시간 궤적 |
| `acceptance_mpc_1000_constraint_check.log`, `make_tables.py`, `table_repro.md` | 지시된 제약 점검 출력, 재현 표 |
