wisehyun-2/my_robot_project/wheeled_biped/docs/review_plan4_mpc_r2.md

# Plan 4 2단계(호스트 MPC 기준 생성기) 독립 검증 — 2라운드

작성 2026-10-23. 대상: 1라운드 검토(`docs/review_plan4_mpc_r1.md`)의 major 5건·minor 11건에 대한 저자 응답(`docs/review_plan4_r1_response.md`)과 그 반영 코드·결과. 검토 범위는 `wbr/controllers/mpc_host/`, `wbr/bench/acceptance_mpc.py`, `acceptance.py`의 19~24·`regression_row`, 호스트/MCU 경계(`host_link.py`, `mcu.py`, `lqi6.py`의 `set_reference_shaping`·`freeze_int_on_accel_plain`·z_att 게이팅), `plan4_upkie_lqi6.py`의 `_make_host`, `tests/test_plan4_safety.py`, 결과 `results/acceptance/plan4_mpc_*Hz.*`·`plan4_*Hz.*`, 캐시 `r3_s1`·`r3_s2`, `results/plan4_mpc/`, `models/upkie_plan4/plan4_closed_loop.json`, 문서 `docs/plan4_mpc_host.md`·`plan4_lqi8.md`·`합격기준.md`.

**코드 상태**: git `a083305`, 코드 해시 `a9b9530c55`(공식 캐시 `r3_s1` 1204개·`r3_s2` 1386개가 모두 이 해시의 키로 존재). 검토 도중 06:36에 **다른 작업자가 커밋되지 않은 수정 7개 파일**(`acceptance.py`, `filters.py`, `host_link.py`, `mcu.py`, `lqi6.py`, 테스트 2개; 1단계 2라운드 반영으로 보임, 해시 `9120f964d0`)과 `docs/review_plan4_r2.md`를 만들었다. 이후에도 같은 작업자가 문서 6개(`HANDOFF.md`, `plan4_lqi8.md`, `plan4_model.md`, `review_plan4_r1_response.md`, `비교보고서.md`, `합격기준.md`)를 고치고 있었다. 이 보고서의 수치와 인용한 줄 번호는 모두 `a083305`(코드 해시 `a9b9530c55`) 기준이다: 06:36 이후에 돌린 두 실행(`acceptance_mpc 1000`, 피치 계수 점검)은 `git archive HEAD`로 스크래치에 푼 스냅샷(해시 `a9b9530c55` 확인)에서 다시 돌려 같은 결과를 얻었다. 저장소에서 새로 만든 파일은 이 문서뿐이고, 산출물은 `results/review_scratch/r2/`(git 무시 대상)에 있다. `identify`는 출력 경로를 스크래치로 돌려 실행했다.

## 0. 요약

**등급 집계: MAJOR 3, minor 9, nit 6.**

- **재현성: 좋음.** 지시된 축소 매트릭스 재현 102회(8프로세스 92 s)가 공식 캐시 `r3_s2`와 시간 지표를 뺀 **모든 키에서 비트 단위로 같다**(판정 뒤집힘 0). 공식 요약 JSON 4개는 캐시에서 다시 집계해 차이 0, `identify` 재실행도 커밋된 `model_fit.json`(138키)·`plan4_closed_loop.json`(272키)과 차이 0. 단위 테스트 74개 통과.
- **1라운드 major는 M1·M2·M4가 해결, M3은 정의·되돌아감은 해결했지만 결론(19번 "물리적 한계")이 반증되고, M5는 부분 해결이다.** 텔레메트리 보정은 이제 극 0.887·DC 이득 −0.12의 약한 보정이고(1라운드 0.987·−1.57), 주행 중 밀기에서 두 호스트가 같은 거동을 보인다. 기동 중 일시 QP 실패 뒤 8번 통과·MPC 복귀가 54+36회 전부 확인된다. 예측 모델은 LQI6.step(플레인)과 일치한다.
- **새 MAJOR**:
  - **M1(r2)** 200 Hz 19번 실패(4/45)를 "물리적 한계"로 결론 내리고 기준 완화를 사용자 선택지로 올렸으나, **기존 설정 두 개(`decel_factor` 1.2, `obs_hold_s` 1.0)로 전체 매트릭스에서 19번이 두 주기 모두 45/45 통과**한다(8·11·13·19·21·23·24 배터리 462회 전부 통과, 패킷 위반 0). 저자는 제동 계수와 저크만 쓸었다.
  - **M2(r2)** 20번(회귀 없음)이 항목마다 "가장 빠듯한 지표" 하나만 비교한다. **지표별로 보면 8·13번 정지 거리 여유율이 두 주기 모두 27~29 % 나빠져(0.235 → 0.298 m) 20번이 실패**한다. 이 해석 선택이 6.2절의 사용자 결정 항목에 없고, 1라운드 M3이 바로 이 악화를 지적했다.
  - **M3(r2)** (1라운드 M5 미해결분) `plan4_mpc_host.md`·응답 문서의 서술 수치 다수가 공식 결과·재실행과 다르다. 특히 3.4절 근거 표("제동 피치 ≤ 1.95°, 정지 0.297~0.300 m, 여유 0~1 %/2.5 %")는 공식 200 Hz 결과(2.0005°, 0.3001 m, 실패)와 모순된다. "코드 해시를 각 결과 표에 기록"도 되어 있지 않고, 1라운드 시점 산출물이 `results/plan4_mpc/`에 그대로 커밋되어 있다.
- 판정 결론 자체(공식 해시에서 1 kHz 19~24 통과, 200 Hz 19 실패 4/45, 16·17 실패)는 재현된다. 위 MAJOR는 판정의 해석과 근거에 관한 것이다.

### 0.1 1라운드 추적 표

| 1라운드 | 저자 판정 | 2라운드 판정 | 근거(이번 측정) |
|---|---|---|---|
| **M1** 텔레메트리 보정이 LQI6와 싸움 | 반영 | **해결** | 호스트(y → r) 최대 극 0.887/0.882(시정수 0.17/0.16 s), DC 이득 −0.124/−0.132(1라운드 0.987·1.55 s·−1.57). 목표 1e-4: 2·5·6번 30회가 목표 0 공식 실행과 비트 동일·보정 0회. 크리프 0.03 m/s + 0.75 W: 두 호스트 9/9 통과(주기마다), 정착 차 ±0.04 s. 0.3 m/s 주행 중 0.5·0.75 W(9조합 × 2주기 × 2호스트): MPC 정착 최대 2.245 s(램프 2.331 s), 최저 속도 −0.018 m/s(1라운드 −0.67), 기준 흔들림 0.289~0.305 m/s, 밀기 뒤 내부 적분기 동결 0 s. 응답 문서의 "m×1.15 MPC 2.4 s / 램프 2.3 s"는 재현 안 됨(M3) |
| **M2** 일시 QP 실패 뒤 복귀 불가 | 반영 | **해결**(23번 기준) | 0.8·1.2·3.04 s × 9조합 × 2주기 54회: 8번 54/54, 복귀 54/54(1.84 / 2.24 / 4.64~4.92 s). 추가 시각 0.6·1.0·1.6·2.0·3.2·3.4 s × 3조합 × 2주기 36회: 8번 36/36, 복귀 36/36. v_ref 텔레메트리가 없어도 복귀(est.v로 재동기). 남은 것: 일시 실패 뒤 19번 기준은 질량 극단에서 깨짐(minor m5), 성형 전환 순간 기준 미세 불연속(minor m6), 문서의 "1.96 s"는 재현 안 됨(1.84 s) |
| **M3** 정지 거리 끝점 정의·되돌아감 | 반영 + 보류(해석) | **정의·되돌아감 해결, 결론은 반증(새 M1)** | `stop_disp` = 최대 이탈, 원자료 90회와 비트 동일. 되돌아감 0.21~0.23 → 최대 0.042/0.043 m. 비대칭 제동은 패킷으로 확인(로봇 속도 기준 위반 0, 정지마다 21패킷이 제동 여유 사용). 그러나 제동 피치(m×1.15)가 19번 피치를 묶어 200 Hz에서 2.0005°(실패), 그리고 "물리적 한계"는 다른 설정으로 통과 가능(새 M1). 폴백 램프는 a_dec를 쓰지 않는다(MCU 1단계 성형 2 m/s² 대칭) |
| **M4** 예측 모델이 z_att 게이팅 누락 | 반영 | **해결**(제동 쪽은 minor m2) | 독립 재유도(선형 플랜트 + 실제 `LQI6.step` 플레인 모드) 대 `model.plan_closed_loop`: 동결 구간 최대 오차 v_base 0.0042 m/s(0.6 %), 피치 0.05°(차이는 동결이 걸리기 전 첫 15 ms의 적분 때문), MPC형 S곡선 동결 구간 0.0002 m/s·0.003°. MPC 구동 실행에서 가속 피치 실측/모델 0.96~1.36(질량 의존), 가속 피치 최대 1.60° < 2°. 제동 피치(19번을 묶는 쪽)는 모델 밖(m2) |
| **M5** 재현되지 않는 수치 | 반영 | **부분 해결(새 M3)** | 결과 파일(JSON·md)과 `model_fit.*`는 재현됨. 서술 수치 13곳·응답 문서 4곳·낡은 산출물·해시 미기록이 남음 |
| m1 a_mcu 램프 값 | 반영 | 해결 | a_mcu 3.2(`_plain`), 토크·다리 후보 3.2 |
| m2 다리 길이 제약 | 반영(문서) | 해결 | QP 밖 클립 명시 |
| m3 몸체 속도 > v_max | 보류 | 보류 타당 | 기준 r 제약으로 해석, 문서 명시. 시험 범위 r ≤ 0.519 m/s |
| m4 위반 계수 자기 검사 | 반영 | 해결(nit 하나) | `packet_violations` 추가, 독립 재계수와 일치. 단 속도 상한은 패킷 검사에 없음(minor m9) |
| m5 폴백 이벤트 문구 | 반영 | 해결(주석은 낡음) | 이벤트는 실제 동작과 일치. 모듈 독스트링·설정 주석은 옛 동작(minor m8) |
| m6 23번 정지 10 s | 반영 | 해결 | 60 s |
| m7 20번 배터리 편입 | 반영 | **편입은 해결, 규칙은 새 M2** | `regression_row` 자동 계산·종합 판정 포함 |
| m8 OSQP 시간 제한 | 반영 | **미해결(minor m1)** | `ReferenceQP.solve`가 없는 속성 `self.period`를 써서 OSQP 경로가 항상 `AttributeError` |
| m9 HostEmulator 게시 격자 | 반영 | 해결 | 목표 0 항목 1~7·9·10·12·16·17이 두 호스트 사이에서 실행 단위 비트 동일(10번 포함) |
| m10 재동기 불일치 | 반영 | 해결(미세 잔여 m6) | MCU `Estimate.v_ref` 추가, 재동기에 사용 |
| m11 50 Hz 텔레메트리 | 보류 | 보류 타당, 단 명령 지연은 새 위험(minor m7) | 50 Hz 단일 표본·텔레메트리 20 ms 지연은 영향 미미, 명령 지연 10~20 ms는 19번 정지 거리를 깸 |
| n1~n7 | 반영/보류 | 해결(n4 범위 검사·n5 roll/split 0·n7 성형 리셋은 단위 테스트와 패킷으로 확인) | — |

## 1. 재현 결과

### 1.1 축소 매트릭스 재현(지시 명령 그대로)

`python -m wbr.bench.acceptance --host mpc --stage2 --rate both --matrix reduced --seeds 1 --tag review_mpc_r2 --jobs 8 --out results/review_scratch/r2/acceptance_mpc` → 102회, 92 s, 코드 해시 `a9b9530c55`. 20번 계산을 위해 공식 `plan4_<rate>Hz.json`을 출력 디렉터리에 복사했다. 같은 (항목, 주기, 조합, 시드 0)의 공식 실행(`r3_s2`, 전체 매트릭스의 부분집합)과 결과 사전의 모든 키를 비교했다(`repro_compare.py`).

| # | 1 kHz 재현: 판정, 가장 빠듯한 지표(여유율) | 200 Hz 재현 | 공식 같은 실행과 차이 |
|---|---|---|---|
| 1 | 통과, pitch_rms 0.288 (×0.58) | 통과, pitch_ma_max 0.639 (×0.64) | 0(비트 동일) |
| 2 | 통과, wheel_peak 1.286 (×0.95) | 통과, wheel_peak 1.288 (×0.95) | 0 |
| 3 | 통과, wheel_rms10 0.125 (×0.63) | 통과, wheel_rms10 0.117 (×0.58) | 0 |
| 4·7 | 통과(생존) | 통과 | 0 |
| 5 | 통과, settle_s 1.885 (×0.63) | 통과, settle_s 1.930 (×0.64) | 0 |
| 6 | 통과, wheel_rms10 0.116 (×0.58) | 통과, wheel_rms10 0.110 (×0.55) | 0 |
| 8 | 통과, rise_s 1.041 (×0.69) | 통과, rise_s 1.065 (×0.71) | 0 |
| 9 | 통과, wheel_rms10 0.106 (×0.53) | 통과, wheel_rms10 0.109 (×0.54) | 0 |
| 10 | 통과, leg_rms 1.974 (×0.49) | 통과, leg_rms 1.971 (×0.49) | 0 |
| 11 | 통과, stop_time 2.304 (×0.77) | 통과, stop_time 2.320 (×0.77) | 0 |
| 12 | 통과, wheel_rms10 0.155 (×0.77) | 통과, wheel_rms10 0.156 (×0.78) | 0 |
| 13 | 통과, wheel_rms10 0.172 (×0.86) | 통과, wheel_rms10 0.174 (×0.87) | 0 |
| 15 | **실패**(기록), 20 ms(강건 12 ms) | 통과, 25 ms | 0 |
| 16 | **실패**, drift_max 0.087 (×1.74) | **실패**, 0.089 (×1.78) | 0 |
| 17 | **실패**, drift_max 0.106 (×2.11) | **실패**, 0.102 (×2.04) | 0 |
| 19 | 통과, stop_disp 0.297 (×0.99) | 통과, stop_disp 0.299 (×1.00) | 0(200 Hz 공식 실패 4건은 축소 매트릭스에 없는 조합) |
| 20 | 통과(15항목) | 통과 | 공식과 같은 판정 |
| 21 | 통과, wheel_peak 0.415 (×0.30) | 통과, 0.403 (×0.30) | 0 |
| 22 | 통과, p99 0.318 ms | 통과, p99 0.281 ms | 시간 지표만 다름(아래) |
| 23 | 통과 | 통과 | 0 |
| 24 | 통과(기록), settle_s 1.905 | 통과, 1.995 | 0 |

- 102회 모두 시간 지표 외의 키가 공식 캐시와 같고 판정 뒤집힘이 0이다.
- 시간 지표(22번): p99 0.318 / 0.281 ms 대 공식 0.324 / 0.295(−1.7 % / −4.7 %), p50 0.096 / 0.075 대 0.110 / 0.082, 최대 0.536 / 0.506 대 0.529 / 0.443. p50·최대는 5 %를 넘게 다르지만 벽시계 측정이라 실행마다 달라지는 값이고, 판정 지표(p99 ≤ 5 ms)는 5 % 안에서 같으며 판정이 바뀌지 않는다 — MAJOR 규칙의 대상(결정적 지표)이 아니라고 판단했다.
- 공식 JSON ↔ 캐시: `r3_s1`·`r3_s2`로 `acceptance.summarize`를 다시 돌린 결과가 `plan4_1000Hz/200Hz.json`·`plan4_mpc_1000Hz/200Hz.json`과 차이 0(`cache_check.py`).

### 1.2 `python -m wbr.bench.acceptance_mpc 1000`

공칭·시드 0: 8·9·13·19의 바퀴 피크 0.252 / 0.297 / 0.376 / 0.252 N·m, QP 자기 검사 위반 0, 패킷 위반 0(패킷 300 / 125 / 600 / 300), QP 실패 0, 생존. (HEAD 스냅샷과 06:36 이후 수정 트리에서 같은 출력.)

### 1.3 19번 독립 재계산(원자료, 전체 매트릭스 9조합 × 5시드 × 2주기 = 90회)

`r2util.Recorder`가 매 스텝 `mujoco` 데이터에서 직접 몸체 자세(`xmat` → 피치), 위치(`xpos`), 바퀴 `actuator_force`, LQI6 내부 상태(v_filt, v_ramp, z, z_att, z_pos, 저역통과 기준 가속도, 성형 여부)를 기록하고, `link.receive`를 가로채 모든 MotionCtrl 패킷과 그 순간의 실제 몸체 속도·MCU 추정 속도를 기록했다(`exp_item19.py`, `analyze_item19.py`).

| 지표 | 1 kHz | 200 Hz |
|---|---|---|
| 판정 코드 값 대 공식 캐시 | 90회 모두 일치 | 같음 |
| 피치 피크·정지 최대 이탈·되돌아감: 판정 코드 대 원자료 | 최대 차 0 | 0 |
| 오버슈트(판정 vx 대 위치 유한차분) / 90 % 도달 | ≤ 0.03 %p / ≤ 1 ms | ≤ 0.48 %p / ≤ 5 ms |
| 피치 피크: 가속 구간 / 제동 구간 | 1.227~1.425° / 0.765~**1.893°** | 1.227~1.600° / 0.779~**2.001°** |
| 제동 피치가 최댓값인 실행 | 27/45(m×1.15 전부 포함) | 21/45 |
| 질량별 제동 피치 최대 m×0.85 / 1.0 / 1.15 | 0.82 / 1.34 / 1.89° | 0.91 / 1.45 / 2.00° |
| 정지 최대 이탈(전체) / m×0.85 최대 | 0.2728~0.2978 / 0.2978 m | 0.2717~**0.3001** / 0.3001 m |
| 되돌아감(stop_back) 최대 | 0.0422 m | 0.0433 m |
| 정지 명령 뒤 기준 최저값 | −0.085~−0.087 m/s | −0.083~−0.086 m/s |
| 적분기 동결 비율: 가속 구간 2.5 s / 정지 구간 3 s, 동결 중 z 변화 | 30~34 % / 30 %, 0 | 30~35 % / 30 %, 0 |
| 독립 19번 판정 실패 | 0 | 4(공식과 같은 4건) |

### 1.4 송신 패킷 독립 검사(19번 90회 + 13번 90회 × 오르기·내리기)

| 검사 | 1 kHz | 200 Hz |
|---|---|---|
| 패킷 수(19번) / 13번 | 13,500 / 27,000 | 13,500 / 27,000 |
| 간격 20.000 ms, host_shaped 참, pitch = 0, pitch_ctrl_mode 거짓, roll = 0, leg_split = 0 | 전부 | 전부 |
| \|r\| 최대(≤ 1.0) | 0.519 | 0.519 |
| \|Δr/T\| 최대 = a_dec | 1.15538 = 1.300 a_max | 1.14983 = 1.300 a_max |
| \|ΔΔr\| 최대 = j_max T, 저크 위반 | 0.17775, 0 | 0.17690, 0 |
| 가속도 위반 — 제동 = 실제 몸체 속도와 반대(판정 정의) / MCU 추정 속도 기준 / 기준 부호 기준 / 대칭 a_max만 | 0 / 0 / 90(정지마다 2) / 945(정지마다 21) | 0 / 0 / 90 / 963 |

판정 코드의 21번 패킷 검사(실제 몸체 속도 기준)와 같은 결과다. 제동 여유(1.3 a_max)는 정지 한 번에 약 21패킷(0.42 s) 쓰이고, "제동"을 기준 부호로 정의하면 기준이 0을 지난 뒤의 2패킷이 위반이 된다(설계 문서 3.4절과 일치).

### 1.5 풀이 시간(22번)과 솔버 실패 경로

| 측정 | p50 [ms] | p99 [ms] | 최대 [ms] |
|---|---|---|---|
| 공식 22번 1 kHz / 200 Hz(750회) | 0.110 / 0.082 | 0.324 / 0.295 | 0.529 / 0.443 |
| 재현 22번 | 0.096 / 0.075 | 0.318 / 0.281 | 0.536 / 0.506 |
| DAQP(기동 포함 200회 표본, 1 kHz) | 0.049 | 0.367 | 0.421 |
| **OSQP 백업(현재 코드)** | — | — | **`AttributeError('ReferenceQP' object has no attribute 'period')`로 매번 실패** |
| OSQP, 속성을 임시로 넣었을 때(시간 제한 10 ms) | 2.74 | 11.1 | 11.8(200회 중 19회 미수렴: 시간 제한·부정확) |

DAQP가 실패하면 OSQP 호출이 예외로 끝나고("QP solver osqp unavailable: AttributeError…" 이벤트) 같은 주기에 폴백한다. 안전 측면에서는 폴백이 실제 백업이지만, 문서의 "OSQP 백업(시간 제한 = 주기의 절반 10 ms)"은 동작하지 않는다(minor m1).

### 1.6 `identify` 재실행(출력만 스크래치로, `run_identify_r2.py`)

| 조건 | 주기 | 스텝 v_base rms | 스텝 피치 rms | 스텝 피치 피크 시뮬/모델(비) | 밀기 v rms / 피치 rms | 축약 모델 스텝 v |
|---|---|---|---|---|---|---|
| A 노이즈 끔·지연 0 | 1 kHz | 0.0292 (5.8 %) | 0.393° | 2.059 / 1.712 (1.20) | 0.0252 / 0.231° | 0.0294 |
| B 노이즈·10 ms | 1 kHz | 0.0286 (5.7 %) | **0.373°** | 2.061 / 1.783 (1.16) | **0.0276 / 0.212°** | 0.0289 |
| C = B − 건마찰 | 1 kHz | 0.0122 | 0.247° | 1.700 / 1.783 (0.95) | 0.0314 / 0.180° | 0.0127 |
| A | 200 Hz | 0.0308 | 0.426° | 2.184 / 1.724 (**1.27**) | 0.0258 / 0.240° | 0.0313 |
| B | 200 Hz | 0.0290 | 0.371° | 2.170 / 1.802 (1.20) | 0.0243 / 0.206° | 0.0297 |
| C | 200 Hz | 0.0131 | 0.266° | 1.789 / 1.802 (0.99) | 0.0067 / 0.098° | 0.0139 |

커밋된 `model_fit.json`·`plan4_closed_loop.json`과 차이 0. 문서 2.3절 표의 1 kHz B행(피치 rms 0.39°, 밀기 0.026 / 0.28°, 피크 2.07, 축약 0.028)과 "실측이 모델의 1.16~1.21배"는 이 재현 값과 다르다(새 M3).

## 2. 사양 준수 검토

| 사양(사용자 문구) | 구현 | 판정 |
|---|---|---|
| 호스트 프로세스, HostEmulator 자리, MotionCtrl(전진·요·높이) 출력 | `_make_host`(plan4_upkie_lqi6.py:160-167)가 `MpcHost`로 교체, 같은 `set_command`/`tick` | 충족 |
| LQI6를 대체하지 않음 | MCU의 LQI6 그대로, `host_shaped`로 MCU 성형만 켜고 끔(mcu.py:328-329) | 충족 |
| 출력은 속도·요·높이만, 피치 기준 미송신 | `_send`(reference_mpc.py:980-997)가 pitch = 0, pitch_ctrl_mode = 거짓, roll·leg_split = 0. 패킷 81,000개 전부 확인 | 충족 |
| MPC에 적분기 없음 | QP 상태 [x̂, s, r, a], s는 매 풀이 0, 외란 상태 없음. 텔레메트리 보정을 포함한 호스트(y → r)의 최대 극 0.887/0.882, DC 이득 −0.12/−0.13, 단위 계단 응답이 0.5 s 안에 정착(`host_analysis_r2.py`). 1라운드의 "숨은 적분기"(극 0.987, DC −1.57)는 해소 | 충족(반박 타당) |
| 텔레메트리만 읽음 | 실행 중 읽는 것은 `plan.mcu.est`(v, v_ref, pitch, position)뿐, `plan.sim`·`plan.observation` 접근 없음(코드 검색). 설계 정보로 이득표·플랜트·설정 지연(`latency_ms`, 1라운드 n6 보류) | 충족 |
| 주기 50~100 Hz, 구간 1~2 s | 50 Hz 고정 격자(간격 20.000 ms), 1.5 s(N 75), 범위 밖·정수배 아님 → `ValueError`(단위 테스트) | 충족 |
| 솔버 qpmpc + daqp(또는 osqp) | qpmpc 응축 + DAQP(warm start). OSQP 백업은 `AttributeError`로 항상 실패 | DAQP로 충족, 백업 무효(m1) |
| 제약: 속도 한계 | \|r_k\| ≤ 1.0(기준에만, 1라운드 m3 보류) | 기준 제약으로 충족 |
| 제약: 가속도 한계(바퀴 토크 80 %·피치 한계에서 유도) | 가속 a_max 0.889/0.884 = 19번 피치 예산 (2 − 0.5)/1.3을 모델로 역산(토크·다리 후보 3.2, a_mcu 3.2). 실측 가속 피치 최대 1.60° < 2°. **제동 a_dec = 1.3 a_max는 모델 유도가 아니라 19번 시험으로 정한 값**(문서도 "측정으로 정한 값") | 가속은 충족, 제동은 유도 근거 없음(m2) |
| 제약: 다리 길이 범위 | QP 밖 클립(문서 명시) | 충족(명시된 해석) |
| 제약: 저크 한계 | \|Δa\| ≤ j_max T(변수 상하한), 송신 패킷에서 한계에 정확히 붙고 위반 0 | 충족 |
| 단계별 가속도 상하한(`stage_bounds`)과 모드 전환 시 가능성 | 제동(직전 계획의 v̂ 부호와 반대)만 a_dec, 그 외 a_max, 전환 시 "현재 가속도에서 저크로 도달 가능한 값" 아래로 내리지 않음 → 구성상 항상 가능. 이번 실행 전체(19·13번 180회, 8·9·13·19 × 90, 일시 실패 90회, 스윕)에서 QP 실패 0. 단 넘김 뒤에는 v̂ 대신 기준 부호를 써서 방향이 틀릴 수 있음(m3) | 충족(잔여 m3) |
| QP 실패·비가용 → 램프 제한기로 즉시 전환, 이벤트 | 같은 주기에 원시 목표 + `host_shaped = False` → MCU 1단계 성형(램프 2 m/s² + 전치 필터 + 동결), 이벤트 문구가 실제 동작과 일치. 복귀는 1 s 뒤 조건부(54+36회 확인) | 충족(독스트링은 낡음, m8) |
| host_shaped 의미 | 타임아웃 단절 패킷은 기본값 거짓 → 성형 켜짐, 폴백 거짓, 복귀·정상 참 | 충족 |
| 예측 모델 (a)/(b) 중 택1 + 근거 | (a) 선형 폐루프 축약, 기동 영역 = 적분기 없는 상태 되먹임 | 충족 |
| 1단계 벤치 스텝·밀기 응답과 모델을 겹쳐 그리고 rms 기록 | `model_fit.png/json` 재현됨(차이 0). 문서의 일부 수치는 그 파일과 다름(새 M3) | 충족(문서 수치 M3) |

## 3. 예측 모델 검토

### 3.1 유도의 정확성(독립 재유도, `exp_model.py exact`)

`plan.plant.linearize(L0)`의 5상태를 MCU 주기로 ZOH 이산화하고 10 ms 측정 지연 사슬을 둔 선형 플랜트에 **MCU의 실제 `LQI6` 객체를 플레인 모드로 돌려**(`set_reference_shaping(False)`, 4 m/s² 램프, 동결 논리 그대로) 폐루프를 만들고, LQI6가 실제로 쓴 v_filt를 `model.plan_closed_loop`(기동 영역)에 넣어 비교했다.

| 기준 | 주기 | 동결 비율 | 동결 구간 최대 오차 v_base / 피치 / T | 피치 피크 실제 / 모델 |
|---|---|---|---|---|
| 일정 가속 0.5 m/s² 1.5 s 후 −0.5 | 1 kHz | 95 % | 0.0042 m/s(0.6 %) / 0.05° / 0.006 N·m | 0.954 / 0.948° |
| 같음 | 200 Hz | 95 % | 0.0044 / 0.05° / 0.010 | 0.960 / 0.955° |
| MPC형 S곡선 0 → 0.5(a 0.889, j 8.89) + 유지 | 1 kHz | 26 % | 0.0002 / 0.003° / 0.0009 | 1.154 / 1.151° |
| 같음 | 200 Hz | 26 % | 0.0002 / 0.003° / 0.006 | 1.169 / 1.167° |

- 동결 구간에서 모델은 `LQI6.step`과 일치한다. 남은 0.6 %는 저역통과 가속도가 0.1 m/s²를 넘기 전 첫 15 ms 동안 z가 적분한 값(−3.6e-3)이 그대로 동결된 효과다.
- 유지 구간(적분기 재개)에서는 v_base 오차가 최대 0.0117 m/s(2.3 %): 적분기 없는 모델의 r → v 정상 이득 1.017 대 실제 1.0(문서 2.2절의 설명과 일치). 텔레메트리 보정이 이 차이를 맡는다.
- 차수 자동 선택 1 kHz 4차·200 Hz 5차, 단위 스텝 오차 0.62 % / 0.046°, 0.25 % / 0.018°(문서 표와 일치). 관측기 극 0.9123 / 0.9128, QP 75변수·300부등식, 헤시안 조건수 4.5e5.

### 3.2 MPC가 실제로 구동한 기동에서의 모델 오차(`exp_model.py mpcfit`, 노이즈·10 ms, 원자료)

| 경우 | 가속 구간 rms v / 피치 | 가속 피크 실측/모델 | 제동 구간 rms v / 피치 | 제동 피크 실측/모델 | 호스트 자신의 제동 피치 예측 |
|---|---|---|---|---|---|
| 1 kHz 공칭 | 0.011 / 0.18° | 1.317 / 1.144 (1.15) | 0.027 / 0.32° | 1.325 / 1.392 (0.95) | 0.73° |
| 1 kHz m×1.15 μ0.75 s3 | 0.012 / 0.18° | 1.466 / 1.145 (1.28) | 0.032 / 0.51° | 1.829 / 1.393 (1.31) | 0.73° |
| 1 kHz m×0.85 μ0.75 s1 | 0.013 / 0.25° | 1.097 / 1.144 (0.96) | 0.024 / 0.24° | 0.907 / 1.393 (0.65) | 0.74° |
| 200 Hz 공칭 | 0.012 / 0.21° | 1.310 / 1.144 (1.15) | 0.028 / 0.30° | 1.273 / 1.392 (0.91) | 0.75° |
| 200 Hz m×1.15 μ0.75 s3 | 0.014 / 0.24° | 1.564 / 1.146 (**1.36**) | 0.033 / 0.42° | 1.837 / 1.390 (1.32) | 0.73° |
| 200 Hz m×0.85 μ1.0 s4 | 0.015 / 0.23° | 1.197 / 1.144 (1.05) | 0.024 / 0.25° | 0.906 / 1.392 (0.65) | 0.75° |

- 속도 채널은 MPC 기동에서도 좋다(rms 0.011~0.015 m/s).
- 피치 비는 공칭에서 1.15로 `pitch_model_factor` 1.3 안이지만 질량에 따라 0.96~1.36이다. m×1.15의 1.36은 계수 1.3을 넘고 0.5° 예비분이 흡수한다(가속 피치 최대 1.60°). 계수 1.3의 근거(공칭 4 m/s² 스텝 하나, 1.16~1.27)는 질량 변동을 담지 않는다(nit n6).
- **제동 피치는 모델과 제한 유도 밖이다.** 같은 기준에 대한 모델 예측(1.39°)이 실측의 0.65~1.32배이고, 호스트 자신의 예측은 3.5 s의 넘김(handover)에서 상태를 0으로 지워 제동 피치 최댓값(3.58~3.69 s)을 보지 못한다(0.73° 예측 대 1.83~1.88° 실측). 19번 피치를 묶는 것은 이 구간이다(minor m2·m3).
- 피치 계수를 1.0으로 두면 a_max 1.61 / 1.56 m/s², m×1.15 피치 2.88 / 2.94°로 19번이 깨진다(정성적 주장은 맞음, 문서의 1.73 m/s²·2.58°는 재현 안 됨).

## 4. 코드 findings(등급순)

### MAJOR

**M1(r2). 200 Hz 19번 실패를 "물리적 한계"로 결론 냈지만, 기존 설정 두 개로 전체 매트릭스가 통과한다**
- 위치: `docs/plan4_mpc_host.md` 0절 표 "물리적 한계"(24행), 3.4절(127-141행: "한쪽을 더 좋게 하면 다른 쪽이 깨진다"), 7절(193행: "한쪽을 1 % 좋게 하는 어떤 설정(제동 계수·저크)도 다른 쪽을 1 % 넘게 깨뜨린다"), 9절(268행: 선택지는 기준 해석 변경·질량 범위 축소·내부 루프 재설계뿐); `docs/비교보고서.md` 317행; `docs/review_plan4_r1_response.md` M3행; `reference_mpc.py:67-73`(decel_factor 주석), `:137`(`obs_hold_s` 0.5).
- 근거(`sweep19.py`, `sweep19b.py`, `variant_matrix.py`, `battery_variant.py`; 판정 코드·시나리오 그대로):
  - 저자가 쓸지 않은 손잡이: 넘김 시점 `obs_hold_s`(텔레메트리 보정을 목표 0 뒤 얼마나 유지할지)는 제동 계수와 교환 곡선이 다르다. 200 Hz 임계 조합에서 0.5 → 1.0 s: 정지 0.3001 → 0.2856 m(−4.8 %), 제동 피치 2.0005 → 2.038°(+1.9 %). 제동 계수 1.3 → 1.2: 피치 −6 %, 정지 +4.7 %.
  - 조합 `decel_factor` 1.2 + `obs_hold_s` 1.0(둘 다 기존 `MpcConfig` 필드): **19번 1 kHz 45/45, 200 Hz 45/45**(피치 최대 1.917 / 1.991°, 정지 최대 0.293 / 0.294 m, 오버슈트 ≤ 4.8 %, 도달 ≤ 1.09 s), 13번 90/90, 8번 90/90, 패킷 위반 0, QP 실패 0. 배터리 그대로 8·11·13·19·21·23·24 전체 매트릭스 462회: **두 주기 모두 종합 "합격"**(16·17은 1단계 문제라 이 실행에 포함하지 않음; 목표 0 항목은 이 두 설정의 영향을 받지 않는다).
  - 다른 조합: 1.2 + 넘김 없음, 1.2 + 0.75 s, 1.22 + 1.0 s, 1.15 + 1.0 s도 임계 7조합 통과.
- 영향: 200 Hz 19번 "불합격"의 원인이 하드웨어·내부 루프의 물리적 한계라는 결론과, 그 위에서 사용자에게 제시한 선택지(정지 거리 끝점 해석, 질량 범위 축소·0.35 m, 내부 루프 재설계)의 전제가 성립하지 않는다. 판정은 호스트 튜닝으로 뒤집힌다. 여유가 여전히 얇다(피치 0.45 %, 정지 2 %)는 점과 실기 명령 지연에 약하다는 점(m7)은 그대로 남는다.
- 수정 제안: `obs_hold_s` × `decel_factor`(× `ref_omega_down`) 격자를 전체 매트릭스에서 다시 쓸어 채택값을 정하고 공식 재실행; "물리적 한계" 서술과 사용자 결정 항목을 고침. 여유를 늘리려면 제동 한계를 예측 속도에 따라 단계별로 바꾸거나(초반 강하게, 끝에서 약하게) 넘김 직후의 저크 제한 역전(아래 m3)을 다듬는 방안을 함께 시험.

**M2(r2). 20번(회귀 없음)이 "항목별 가장 빠듯한 지표"만 비교 — 지표별로는 8·13번 정지 거리 여유율이 27~29 % 나빠져 두 주기 모두 실패**
- 위치: `acceptance.py:619-647`(`regression_row`: `tightest(it)` = 항목의 최대 여유율 하나, `m2 > 1.10 * m1`), `docs/합격기준.md` 6.2절 111행(정의), 118행(사용자 결정 항목 목록에 없음), `docs/plan4_mpc_host.md` 8절.
- 근거(`per_run_item20.py`, `item20_metrics.py`, 공식 캐시 `r3_s1` 대 `r3_s2`, 같은 해시·조합·시드):
  - 실행 단위(1,190회): 1단계 통과 → 2단계 실패 0, 그 반대 0. 목표 0 항목 1~7·9·10·12·16·17은 두 주기 모두 비트 동일(1라운드 m9 해결).
  - 지표별 항목 최악 여유율: 8번 `stop_disp` ×0.470 → ×0.596(1 kHz, +26.8 %)·×0.471 → ×0.600(200 Hz, +27.4 %), 13번 ×0.467 → ×0.596(+27.8 %)·×0.466 → ×0.599(+28.6 %). 실행 단위로는 8번 피치 최대 +21 %(14·12회), 8번 바퀴 피크 +19 %(200 Hz 12회), 11번 바퀴 피크 +14 %(1 kHz 4회).
  - 같은 항목의 다른 지표는 좋아졌다: 8번 오버슈트 −64 %, 정상 오차 −79~−80 %, 도달 −13~−14 %, 최악 피치 −9~−12 %(1단계 2.14 / 2.20° → 1.89 / 2.00°).
  - 1라운드 M3의 영향 문단이 바로 "20번 지표 비교에서 8번 정지 거리 여유가 10 % 넘게 나빠지는 것이 보이지 않는다"였다. 끝점 → 최대 이탈로 정의를 바꾼 뒤에도 `regression_row`가 가장 빠듯한 지표(8번은 rise_s)만 보므로 여전히 보이지 않는다.
  - M1(r2)의 재튜닝 뒤에도 정지 거리 0.293 m로 1단계(0.235 m)보다 25 % 길다. 19번의 2° 피치는 1단계(2 m/s² 제동, 피치 한계 5°)보다 부드러운 제동을 강요하므로, 지표별 해석에서는 19번과 20번이 이 하드웨어에서 함께 성립하기 어렵다(피치 계수 1.0 = 제동 2.1 m/s²는 정지 0.208 m를 주지만 피치 2.9°).
- 영향: 필수 항목 20의 판정이 문서에 선언되지 않은 해석 하나에 달려 있다(해석에 따라 통과/실패가 뒤집힘). 실기 관점에서도 "1단계보다 정지 거리 25~30 % 증가"가 회귀로 보고되지 않는다.
- 수정 제안: 항목 판정(가장 빠듯한 지표) 대 지표별 판정을 사용자 결정 항목으로 6.2절에 올리고, 20번 행에 지표별 10 % 초과 악화 목록(정지 거리, 실행 단위 피치·바퀴 피크)을 함께 표시. 지표별 판정을 채택하면 20번 실패와 19번 사이의 상충을 사용자에게 보고.

**M3(r2). (1라운드 M5 미해결분) 재현되지 않거나 공식 결과와 모순되는 문서 수치, 낡은 산출물, 해시 미기록**
- `docs/plan4_mpc_host.md`:
  1. 0절 24행 "질량 ±15 %에서 여유 0~3 %" — 공식 200 Hz는 −0.04 % / −0.03 %(실패 4건).
  2. 3.4절 표 135행 채택안 "0.297~0.300 m, 제동 피치 ≤ 1.95°, 여유 0~1 % / 2.5 %"와 141행 "2°는 질량 ×1.15(제동 피치 1.95°)에서 2.5 %" — 공식 정지 0.2717~0.3001 m, 제동 피치 최대 2.0005°(1.3절 표). 이 표가 "물리적 한계" 주장의 근거다.
  3. 3.4절 표 133행 "대칭 한계 a_dec = a_max(0.93)" — 현재 a_max 0.889 / 0.884.
  4. 2.3절 표 1 kHz B행(피치 rms 0.39°, 밀기 0.026 m/s / 0.28°, 피크 2.07°, 축약 0.028) — 재현·커밋 JSON 0.373°, 0.0276 / 0.212°, 2.061°, 0.0289. 86행 "실측이 모델의 1.16~1.21배" — 1.16~1.27(200 Hz A 1.27).
  5. 3.1절 116행 "계수 1.3이 없으면 a_max 1.73 m/s², m×1.15 피치 2.58°" — 재실행 1.61 / 1.56 m/s², 2.88 / 2.94°.
  6. 5절 168행 "m×1.15: 정착 MPC 2.4 s / 램프 2.3 s, 후진 0.02" — 재실행 MPC 2.21~2.24 s / 램프 2.24~2.33 s(MPC가 더 빠름), 후진 ≤ 0.018 m/s.
  7. 6절 174행 "1.96 s / 2.24 s에 MPC 복귀" — 공식 이벤트·재실행 1.84 s / 2.24 s(두 주기, 시드 0~4).
  8. 7절 191행 "8번 … 오버슈트 9~10 % → 3.8~4.8 %, 정상 오차 0.034 → 0.008, 피치 1.2~1.5° → 1.9~2.0°" — 1단계 8번 최악 오버슈트 10.6 / 12.6 %, 정상 오차 0.039, 피치 2.14 / 2.20°(범위 1.06~2.20°)이며 2단계 최악 피치 1.89 / 2.00°는 오히려 낮다. 비교가 1단계 공칭값과 2단계 최악값을 섞었다.
- `reference_mpc.py` 주석: `decel_factor`(70행) "factor 1.3: stop 0.28-0.30 m, pitch <= 1.91 deg"(공식 ≤ 2.0005°), `pitch_model_factor`(96-99행) "1.80-1.86 deg measured vs 1.50 deg predicted at a = 1.7"(identify 2.06~2.18 대 1.71~1.80, 4 m/s² 스텝).
- `docs/review_plan4_r1_response.md`: 캐시 "r2_s1·r2_s2"(공식·문서는 r3), "단위 테스트 73개"(74개), M2행 "1.96 s / 2.24 s, 오버슈트 6~11 %"(1.84 s, 5.6~9.5 %), M5행 "코드 해시를 각 결과 표에 기록"(어느 결과 파일·문서에도 해시 없음).
- `results/plan4_mpc/`의 `constraint_check.json`(01:25), `ramp_vs_mpc*.json/png`, `regression*.md`, `compare_hosts*.log`, `identify.log`, `timing_variants.json`, `acceptance_mpc_r1.log`가 1라운드 시점 산출물 그대로 커밋되어 있다(1라운드 M5 제안: 재생성). 지금 문서가 인용하지는 않지만 같은 디렉터리의 현재 산출물(`model_fit.*`)과 섞여 있다.
- 영향: 결과 파일(`results/acceptance/*.md|json`, `model_fit.*`)은 정확하므로 판정은 바뀌지 않는다. 그러나 사용자 결정의 근거로 제시된 서술(3.4절·0절·9절)이 공식 결과와 모순되고, 등급 규칙상 재현 불가 수치다.
- 수정 제안: 서술 수치를 공식 JSON·재실행에서 자동으로 뽑아 다시 적기, 낡은 산출물 삭제 또는 재생성, 결과 md/json 머리에 코드 해시 기록.

### minor

- **m1. OSQP 백업이 항상 실패한다** — `reference_mpc.py:587` `time_limit=0.5 * self.period`; `ReferenceQP`에는 `period`가 없다(`self.T`만 있음). DAQP 실패 주기에 OSQP는 `AttributeError`로 끝나고 이벤트는 "QP solver osqp unavailable"이 된다. 1라운드 m8 "반영"이 한 번도 실행되지 않은 셈이며 테스트가 없다. 속성을 고쳐도 OSQP는 p99 11.1 ms·최대 11.8 ms(시간 제한 10 ms 초과), 200회 중 19회 미수렴이다. 수정: `self.period = T`(또는 `0.5 * self.T`) + 백업 경로 단위 테스트, 또는 OSQP 백업을 빼고 즉시 폴백을 명시.
- **m2. 제동 한계 a_dec는 모델 유도가 아니라 합격 시험으로 맞춘 값이고, 19번 피치를 묶는 제동 피치는 예측 모델 밖이다** — `reference_mpc.py:618`, 문서 3.4절. 모델 예측 1.39° 대 실측 0.91~1.88°(질량에 따라 ×0.65~1.32), 호스트 자신의 예측 0.73°(3.2절 표). 사양의 "피치 한계에서 유도한 가속도 한계"가 제동에는 성립하지 않는다. 수정: 정지 기동(넘김 포함)을 모델로 시뮬레이션해 a_dec를 유도하거나, 시험으로 정한 값임을 사양 해석으로 명시.
- **m3. 넘김(handover)이 로봇이 아직 0.3 m/s로 굴러가는 중에 예측 상태를 버리고, 그 뒤 제동 방향을 기준 부호로 정한다** — `reference_mpc.py:799-805`, `:556-559`. 3.50 s에 x̂ = 0(로봇 +0.29 m/s, 기준 −0.038 m/s, 기준 가속도 −0.97 m/s²); 이후 `v_pred`가 없어 `r_prev` 부호(−)로 "뒤로 굴러감"으로 보고 양의 가속에 a_dec를 허용한다(실제로는 전진 중). 이 구간에서 기준이 저크 제한으로 −0.083 m/s까지 더 내려가며 제동 피치 최댓값이 생긴다(200 Hz m×1.15: 3.62 s, −2.0°). `obs_hold_s`는 19번의 가장 민감한 손잡이인데 문서의 교환 표에 없다(M1(r2)). 주석의 "r -> 0"(136행)도 코드에 없다.
- **m4. 기준 가속도가 부호를 바꾸는 순간 적분기 동결이 20~40 ms 풀린다** — `lqi6.py:239-242`(`abs(self._a_ref_lp) > att_accel_thresh`). 정지 끝에서 기준이 음수에서 0으로 되돌아갈 때 저역통과 가속도가 0을 지나며 동결이 풀리고, 그때 속도 오차 |v − v_filt| ≈ 0.2 m/s를 z가 적분한다(200 Hz m×1.15 μ0.75 s3: 3.66~3.72 s에 z 0.0266 → 0.0310). 효과는 작지만 "기동 중 적분기 전부 동결" 설명과 다르다. 수정: 최소 유지 시간·히스테리시스, 또는 |v − v_filt|가 클 때 동결 유지.
- **m5. 일시 QP 실패 뒤에는 최소 1 s 동안 1단계 성형이 돌아 19번 기준이 질량 극단에서 깨진다(23번 판정 영향 없음)** — `reference_mpc.py:834-835`(`fallback_hold_s` 1.0). 0.8 s 실패: m×0.85 정지 0.312 m(두 주기); 3.04 s 실패: m×1.15 피치 2.14~2.19°; 1.0 s 실패: 오버슈트 10.9~12.5 %; 2.0·3.2 s 실패: 피치 2.07~2.28°(54회 중 12회, 36회 중 9회). 23번이 요구하는 8번은 전부 통과한다. 0.1 s 솔버 이상이 1 s 넘는 성형 구간을 만든다는 점을 문서에 적을 것.
- **m6. 복귀 조건과 재동기가 MCU 쪽 기준과 정확히 맞물리지 않는다** — `reference_mpc.py:834-847`: 복귀 조건 |a| < 0.05는 실제로 보내지 않는 명시 해(그림자)의 가속도이고 MCU 기준의 변화율이 아니다; `lqi6.py:113-119`: 복귀 패킷(host_shaped 참)을 받은 MCU가 `v_filt = v_ramp`로 바꾸므로 호스트가 재동기에 쓴 텔레메트리 v_ref(성형된 v_filt)와 MCU의 새 출발점이 전치 필터 지연만큼 다르다. 측정: 1 kHz 0.6 s 실패 뒤 복귀 순간 MCU 기준이 0.4792 → 0.496 m/s로 0.017 뛰었다가 5 ms 동안 재동기 값으로 되돌아옴(0.8 s 실패 0.006); v_ref 없이 est.v로 재동기하면 200 Hz에서 0.022 m/s — 작지만 "무충격"은 아니다. 수정: 플레인 전환 시 `v_filt`를 유지하고 `v_ramp = v_filt`로 맞추기, 복귀 조건에 텔레메트리 v_ref 변화율 사용.
- **m7. 실기 명령 지연 10~20 ms만으로 19번 정지 거리가 두 주기 모두 깨진다** — 예측 모델의 지연은 10 ms 측정 지연뿐이다(`model.py:323-324`). 패킷 전달 지연 10 / 20 ms에서 m×0.85 정지 이탈 1 kHz 0.2978 → 0.3015 / 0.3063 m, 200 Hz 0.3001 → 0.3025 / 0.3073 m(공칭 0.285 → 0.289 / 0.294 m). 50 Hz 단일 표본 텔레메트리·텔레메트리 20 ms 지연·v_ref 필드 없음은 영향 미미, 주행 중 밀기·일시 실패 복귀도 정상(`exp_realrobot.py`). 수정: 측정한 명령·전송 지연을 예측 모델에 넣어 다시 유도하고, 실기용 정지 거리 여유를 따로 둘 것(M1(r2)의 재튜닝 여유 2 %도 20 ms 지연이면 사라짐).
- **m8. 낡은 독스트링·주석과 실제로 보내지 않는 그림자 경로** — `reference_mpc.py:1-36`(폴백 = 명시 해 + 램프, "5 states", "가장 느린 모드 = LQI6 적분기 모드"), `:109-115`(`fallback_mode` "explicit": "integrator not frozen … overshoots ~30 %"), `fallback.py:4-5`("integrator not frozen"), `model.py:8-9, 20-21`("integrator not frozen", "the only integrator in the prediction is the LQI6's own"). 폴백 중 명시 해와 `RampFallback`이 계산하는 기준은 송신되지 않고(송신은 원시 목표) 복귀 조건에만 쓰인다. 실기 진단·유지보수를 오도한다.
- **m9. 21번 패킷 검사에 속도 상한이 없다** — `acceptance_mpc.py:26-52`: 가속도·저크만 센다. "가속도·속도 제약 위반 0회" 중 속도는 QP 자기 검사뿐이다. 이번 독립 재계수에서 \|r\| 최대 0.519 m/s로 위반 0.

### nit

- **n1** `regression_row`가 `m2 > 1.10 * m1`(초과)인데 기준 문구는 "10 % 이상"(이상)이다(`acceptance.py:637`).
- **n2** `stage_bounds`가 직전 계획의 `v_pred`를 한 단 당기지 않고 쓴다(제동 방향 판정이 20 ms 늦음, `reference_mpc.py:554-559`, `:961`).
- **n3** 정지 명령 뒤 기준이 −0.083~−0.087 m/s까지 내려간다(로봇이 전진하는 동안 후진 명령). 제동 정의의 결과이지만 "기준 하향 초과(역방향 명령)"로 문서에 적혀 있지 않다.
- **n4** 24번의 `disp`(1.73 m)는 순항 거리라 이탈 지표로 의미가 없다(`acceptance.py:512`).
- **n5** 1단계 램프 호스트는 정지 뒤 0.155~0.163 m 되돌아간다(2단계 0.043 m). 1단계 범위라 판정하지 않았지만 20번 지표 비교 때 함께 보면 MPC 쪽이 낫다.
- **n6** `pitch_model_factor` 1.3의 근거가 공칭 질량 4 m/s² 스텝 하나(1.16~1.27)다. MPC 기동에서는 m×1.15 200 Hz 1.36으로 계수를 넘고 0.5° 예비분이 흡수한다(3.2절). 계수와 예비분의 역할을 나눠 적을 것.

## 5. 판정 코드 검토(19~24, 회귀)

| # | 판정 코드 | 검토 결과 |
|---|---|---|
| 19 | `STAGE2_ITEMS[0]`(acceptance.py:151-153): 실제 피치 피크 ≤ 2°, 오버슈트 ≤ 10 %(0.5~3.0 s 원시 vx), 90 % 도달 ≤ 1.5 s, 정지 = 정지 명령 뒤 최대 이탈 ≤ 0.3 m, 정착 + 토크 여유 | 원자료 재계산과 비트 동일(1.3절). 느리게 가서 피치를 맞추는 것은 막혀 있다(도달 ≤ 1.09 s 실제 판정). 실패 4건(200 Hz)은 재현되지만 원인 해석은 M1(r2) |
| 20 | `regression_row`: 1~17 중 1단계 통과 → 2단계 실패 없음 + 항목별 가장 빠듯한 지표 여유율 악화 ≤ 10 % | 실행 단위 뒤집힘 0 확인. 지표별 비교를 하지 않아 정지 거리 +27~29 %가 보이지 않음(M2(r2)). `>` 대 "이상"(n1) |
| 21 | 조합·시드마다 8·9·13·19를 MPC로 실행: QP 자기 검사 위반, 송신 패킷 위반(실제 몸체 속도와 반대면 a_dec), 바퀴 피크 ≤ 1.36, 생존 | 90회 위반 0·QP 실패 0, 최악 바퀴 0.440 / 0.422 N·m(13번). 패킷 독립 재계수(네 가지 제동 정의) 일치. 속도 상한은 패킷 검사에 없음(m9) |
| 22 | 공칭 스텝 + 0.5 W 밀기 750회의 `solve_problem` 시간(백업 포함 합산), QP 실패 | 재현 p99 0.318 / 0.281 ms, 실패 0. OSQP 경로는 예외로 끝나 시간에 들어가지 않음(m1) |
| 23 | (a) 생성 직후부터 강제 실패 → 1(60 s)·8·11; (b) 스텝 중 0.8·1.2·3.04 s에 0.1 s 실패 → 8번 + 실행 끝에서 `mode == "mpc"` | (a)는 1단계와 같은 경로라 통과가 당연. (b) 공식 캐시는 시드 0~4·두 주기 모두 1.84 / 2.24 / 4.76~4.86 s에 복귀, 오버슈트 5.6~9.5 %. 넓힌 재실험(9조합 × 2주기 × 3시각 54회 + 3조합 × 2주기 × 6시각 36회) 전부 8번 통과·복귀. 19번 기준은 일시 실패 뒤 깨질 수 있음(m5, 23번 기준 밖) |
| 24 | 0.3 m/s 순항 중 0.75 W 밀기(기록): 목표 기준 정착 ≤ 4 s, 후진 ≤ 0.1 m/s | 9조합 × 2주기 × 2호스트 × 0.5·0.75 W로 넓혀 확인: 두 호스트 같은 거동(1.1절 추적 표). `disp`는 의미 없음(n4) |

## 6. 검증한 것(문제 없음 또는 확인 완료)

- 공식 캐시 ↔ 현재 코드 해시(누락 0), 공식 요약 JSON 4개 ↔ 캐시 재집계(차이 0), 축소 매트릭스 102회 비트 동일, `identify` 산출물 재현(차이 0), 단위 테스트 74개 통과(`a9b9530c55`).
- 피치 기준 미송신, roll·leg_split 0, 20 ms 고정 격자, host_shaped 송신값, 텔레메트리만 사용(코드 검색), 사양 범위 검사(`ValueError`).
- 적분기 없음: 호스트(y → r) 극 0.887 / 0.882, DC 이득 −0.12 / −0.13, QP 상태에 적분 없음.
- 송신 기준의 속도·가속도(로봇 속도 기준 비대칭)·저크 한계 준수, 한계에 정확히 붙음, 19·13번 81,000패킷 위반 0.
- 19번 독립 재계산(피치·오버슈트·도달·정지 최대 이탈·되돌아감·바퀴 피크)과 판정 코드 일치.
- 동결 논리: 가속·제동 구간 30~35 %에서 z·z_att·z_pos가 움직이지 않음(동결 중 변화 0), 되돌아감 0.04 m대.
- M1 재실험 전부(목표 1e-4 비트 동일, 크리프 0.03 m/s, 주행 중 밀기 72회), M2 재실험 전부(일시 실패 90회 + v_ref 없음 6회).
- 예측 모델 유도: 독립 선형 플랜트 + 실제 `LQI6.step`(플레인)과 일치, 차수·관측기 극·한계 후보·피크 표가 코드 출력과 일치(`exp_model_limits.json`).
- 실기 텔레메트리 변형: 50 Hz 단일 표본, 텔레메트리 20 ms 지연, v_ref 없음 → 19번·24번·복귀에 영향 미미(명령 지연은 m7).

## 7. 권고(우선순위)

1. **M1(r2)**: `obs_hold_s` × `decel_factor`(× `ref_omega_down`) 격자를 전체 매트릭스에서 다시 쓸고(예: 1.2 / 1.0 s는 두 주기 19번 45/45), 공식 재실행 뒤 "물리적 한계" 서술과 사용자 결정 항목(9절, 비교보고서 11절, 응답 문서)을 고친다. 실기 여유(m7)를 위해 명령 지연을 모델에 넣고 같은 격자를 다시 본다.
2. **M2(r2)**: 20번의 비교 단위(항목의 가장 빠듯한 지표 대 지표별)를 사용자 결정 항목으로 올리고, 지표별 악화(정지 거리 +27~29 %, 실행 단위 피치 +21 %·바퀴 피크 +19 %)를 20번 행에 함께 표시한다. 지표별 판정이면 19번(2° 피치)과의 상충을 함께 보고한다.
3. **M3(r2)**: 서술 수치를 공식 JSON에서 다시 뽑고, `results/plan4_mpc/`의 1라운드 산출물을 정리하고, 결과 머리에 코드 해시를 남긴다.
4. minor: m1(OSQP `self.period` 한 줄 + 테스트), m7(지연 모델), m2·m3(제동 구간 모델링·넘김 방향), m6(성형 전환 시 기준 연속), m4(동결 히스테리시스), m8(독스트링), m9(패킷 속도 검사).

## 부록: 실행한 것과 스크래치 파일(`results/review_scratch/r2/`)

| 파일 | 내용 |
|---|---|
| `cache_check.py` | 공식 캐시 ↔ 현재 해시, 공식 요약 JSON 재집계 |
| `acceptance_mpc_r2.log`, `acceptance_mpc/` | 지시된 축소 매트릭스 재현(태그 review_mpc_r2) |
| `repro_compare.py` | 재현 ↔ 공식 실행 단위 비교 |
| `per_run_item20.py/.json`, `item20_metrics.py` | 20번 실행 단위·지표별 비교 |
| `stage2_details.py` | 19·21·22·23·24 공식 캐시 상세 |
| `r2util.py` | 원자료 기록기(mujoco 데이터·LQI6 내부·호스트), 패킷 가로채기·독립 검사 |
| `exp_item19.py/.json`, `exp_item13.json`, `analyze_item19.py`, `trace19.py` | 19번 원자료 재계산, 패킷 검사, 정지 구간 시간 궤적 |
| `sweep19.py/.json`, `sweep19b.py/.json`, `variant_matrix.py`, `variant_d120_h10.json`, `battery_variant.py`, `battery_variant/`, `battery_variant.log` | 19번 손잡이 스윕, 대안 설정 전체 매트릭스·배터리 |
| `exp_m1.py`, `exp_m1_[abc].json`, `exp_m2.py`, `exp_m2_[abc].json`, `analyze_m1m2.py` | M1·M2 재실험 |
| `exp_model.py`, `exp_model_{exact,limits,mpcfit}.json`, `run_identify_r2.py`, `identify/`, `factor_check.py/.json` | 모델 재유도·MPC 기동 적합·identify 재실행·피치 계수 점검 |
| `host_analysis_r2.py/.log` | 호스트(y → r) 극·DC 이득 |
| `osqp_backup_check.py` | OSQP 백업 실패 확인, 시간 측정 |
| `exp_realrobot.py/.json/.log`, `diag_tel50.py` | 실기 텔레메트리·명령 지연 변형(첫 실행은 하네스의 클래스 패치 누수로 무효 → 고쳐 다시 실행한 결과만 사용) |
| `head_src/` | `git archive HEAD`로 푼 검토 대상 코드 스냅샷(해시 a9b9530c55), 06:36 동시 수정 뒤 재실행용 |
| `unittest_r2.log`, `acceptance_mpc_1000.log`, `acceptance_mpc_1000_head.log` | 단위 테스트, 제약 점검 출력 |

참고: 이 검토 세션에서 표준 입력으로 띄운 점검 스크립트 하나(`multiprocessing.Pool`, Windows spawn에서 작업자 생성 실패)가 한동안 작업자 재생성을 반복했다(부모 PID 29108). 지시에 따라 검토자가 종료하지 않았고, 06:51에 프로세스가 끝났다(종료 코드 0). 그 출력 로그(약 144 MB)는 저장소 밖 하네스 임시 폴더에 있다. 같은 점검(피치 계수 1.0)은 파일 스크립트 `factor_check.py`로 단일 프로세스에서 다시 실행했다.
