wisehyun-2/my_robot_project/wheeled_biped/docs/review_plan4_mpc_r3.md

# Plan 4 2단계(호스트 MPC 기준 생성기) 독립 검증 — 3라운드

작성 2026-10-23. 범위(의도적으로 좁힘): 2라운드 검토(`docs/review_plan4_mpc_r2.md`)의 M1~M3·m1~m9·n1~n6이 실제로 고쳐졌는지, 그리고 공식 결과가 재현되는지. 저자 응답은 `docs/review_plan4_r1_response.md`의 "2라운드 (review_plan4_mpc_r2, 2단계)" 절. 새 영역은 찾아 나서지 않았고, 확인 도중 마주친 것만 적었다.

**코드 상태**: git `22e58a3`(작업 트리 깨끗), 코드 해시 `1cbc282b92` = 공식 결과 4개(`plan4_1000Hz/200Hz.json`, `plan4_mpc_1000Hz/200Hz.json`) 머리의 해시. 공식 캐시 `r4_s1`(1단계 1194작업)·`r4_s2`(2단계 1386작업)가 현재 해시의 키로 빠짐없이 있다. 저장소에서 새로 만든 파일은 이 문서뿐이고, 산출물은 `results/review_scratch/r3/`(git 무시 대상)에 있다. `identify`는 출력 경로를 스크래치로 돌려 실행했다. 검토 중 다른 작업자가 `docs/review_plan4_r3.md`(1단계 3라운드)를 만들었으나 코드 변경은 없었다(마지막에 해시 재확인).

## 0. 요약

**등급 집계: MAJOR 1, minor 4, nit 6.**

- **재현성: 좋음.** 지시된 축소 매트릭스 102회(8프로세스 92 s)가 공식 캐시 `r4_s2`의 같은 실행과 **모든 결정적 키에서 비트 단위로 같다**(100회 완전 동일, 나머지 2회는 22번의 벽시계 지표 `solve_mean_ms`만 다름). 판정 뒤집힘 0. `acceptance_mpc 1000`은 커밋된 `constraint_check.json`과 같고(위반 0, QP 실패 0), 단위 테스트 78개 통과, `identify` 재실행은 `model_fit.json` 138키·`plan4_closed_loop.json` 272키 차이 0.
- **판정**: 19번은 공식 전체 매트릭스에서 **두 주기 모두 45/45**이고, 제 기록기로 다시 돌린 90회(원자료: `xmat` 피치, `xpos` 위치, 패킷)가 판정 코드·공식 캐시와 차이 0이다. 여유: 1 kHz 정지 0.2960 m(×0.987)·피치 1.901°(×0.951), 200 Hz 0.2972 m(×0.991)·1.978°(×0.989); 피치 최댓값은 두 주기 모두 m×1.15의 **제동 구간**. 종합 판정은 두 주기 모두 불합격(원인 16·17, 1단계)으로 공식과 같다.
- **2라운드 MAJOR**: M1(물리적 한계 반증) **해결**, M2(20번 비교 단위) **해결**, M3(서술 수치) **부분 해결**.
- **새 MAJOR**: **M1(r3)** = 2라운드 M3의 남은 부분. 2라운드에서 고친 절(3.4·9절)과 2라운드 M3가 지목한 곳에 현재 코드로 재현되지 않는 수치가 남아 있다(3.4절 표 두 행과 비고, "정지 뒤 기준 −0.09 m/s"(실측 −0.137), "OSQP 90 % 수렴·p99 11 ms"(실측 99.6 %·6~7 ms), 비교보고서 11.7, 합격기준 6.2 "a_dec = 1.3 a_max", `pitch_model_factor` 주석, 응답 문서 1라운드 표의 M1~M4행). 판정에는 영향이 없다.
- **minor**: (m1) 2라운드 m7 반영인 `model_extra_latency_ms`는 명령 지연을 내부 루프의 되먹임 지연으로 모델링해, 문서가 말하는 10~20 ms를 넣으면 **MPC가 꺼진다**; (m2) 넘김 1.0 s는 0.5 m/s 정지만 덮고 0.8~1.0 m/s에서는 아직 구르는 중에 넘긴다; (m3) 동결 유지 0.1 s는 제동→복귀 교차는 덮지만 가속 끝 교차(121~165 ms)는 못 덮는다; (m4) 2라운드 m8 독스트링 일부가 그대로다.

### 0.1 2라운드 추적 표

| 2라운드 | 저자 조치 | 3라운드 판정 | 근거(이번 측정) |
|---|---|---|---|
| **M1** "물리적 한계" 반증 | 넘김 0.5 → 1.0 s, 제동 1.3 → 1.17, 문서 정정, 전체 재실행(`r4_s2`) | **해결** | 공식 19번 45/45 × 2주기, 원자료 90회 재계산 일치(1.7절), 지시된 모서리 8조합 16/16 통과. 격자 재현: 넘김 1.0 s에서 제동 1.15 / 1.17 / 1.20의 모서리 최소 여유(200 Hz) ×1.003 / ×1.010 / ×0.997 → 1.17 선택이 재현됨. 다만 응답 문서 1라운드 M3행(42행)에 반증된 "물리적 한계" 결론이 주석 없이 남음(M1(r3)) |
| **M2** 20번 비교 단위 | 판정은 항목별 가장 빠듯한 지표(`>=`), 지표별 악화는 같은 행에 기록, 6.2에 사용자 결정 (e) | **해결** | 공식 JSON·캐시에서 독립 재계산(1.8절): 뒤집힘 0, 가장 빠듯한 지표 악화 0(최대 비 1.024 / 1.046, 13번), 기록 `8:stop_disp ×0.47→×0.59, 13:stop_disp ×0.47→×0.59`(+25.7~27.4 %)와 일치, 0.05 필터로 가려진 지표 없음. 실행 단위 8번 피치 +21 %·바퀴 피크 +19 %는 9절 서술에만 있음 |
| **M3** 서술 수치·해시·낡은 산출물 | 수치 재기록, 결과 머리에 해시, `results/plan4_mpc/` 정리·재생성, 독스트링 | **부분 해결 → M1(r3)** | 해시 기록·산출물 재생성 해결(`constraint_check.json`·`ramp_vs_mpc.json`·`regression.md`·`model_fit.*`가 최종 코드 재실행과 일치). 0·2.3·7·8절 수치 일치. 남은 수치는 M1(r3) |
| m1 OSQP `AttributeError` | `self.T` | **해결** | DAQP 강제 실패 12회 모두 OSQP 경로 실행: 11회 같은 주기에 OSQP가 풀어 MPC 유지(첫 수 차 ≤ 3e-7), 1회(1 kHz 3.04 s) OSQP 시간 제한(11.5 ms) → 이벤트 + 폴백 → 4.82 s 복귀. 예외 경로("QP solver daqp unavailable")도 동작(1.5절) |
| m2 제동 한계는 시험값 | 문서 | 해결(문서) | 3.4절 "모델로 유도한 값이 아니라 시험으로 맞춘 값"(실측/모델 0.65~1.32) |
| m3 넘김 시점 | 넘김 1.0 s | **0.5 m/s에서만 해결 → m2(r3)** | 19번: 넘김(4.0 s) 순간 몸체 속도 −0.024 / 0.005 m/s, 패킷 위반 0. 0.8 / 1.0 m/s 정지에서는 0.17~0.37 m/s로 구르는 중에 넘김, 0.8 m/s 패킷 위반 3 / 2 |
| m4 가속 부호 변경 때 동결 해제 | `freeze_hold_s` 0.1 s | **부분 해결 → m3(r3)** | 제동→복귀 교차(간격 41 / 45 ms) 90/90에서 z·z_att·z_pos 불변. 가속 끝 교차(121~165 ms) 84/84에서 20~65 ms 적분 |
| m5 일시 실패 뒤 1 s 1단계 성형 | 문서(9절) | 해결(문서) | 재실험 36회(0.6~3.2 s 실패) 정지 최대 0.309 m·피치 2.24 / 2.29° — 9절 "0.31 m, 2.1~2.3°"와 일치 |
| m6 성형 전환 연속성 | `v_ramp = v_filt` | **해결** | 같은 실험의 옛 전환식 대조: 1 kHz 복귀 순간 루프 기준(v_filt) 한 스텝 변화 0.0168 → 0.0019 m/s(플레인 램프 한계 0.004), 200 Hz 0.0020(한계 0.02). 36/36 8번 통과·복귀(1.6절) |
| m7 실기 명령 지연 | `MpcConfig.model_extra_latency_ms` + HANDOFF 절차 | **미해결 → m1(r3)** | 10 / 15 / 20 ms를 넣으면 예측 모델 스펙트럼 반경 1.007~1.068 → "MPC disabled", 두 주기 |
| m8 낡은 독스트링 | 세 모듈 갱신 | **부분 해결 → m4(r3)** | `fallback.py`·`model.py` 머리 갱신. `reference_mpc.py:39-41`·`:115-118`·`:141-142`, `model.py:23-24` 그대로 |
| m9 패킷 속도 상한 | `packet_violations`에 \|r\| ≤ v_max | **해결**(테스트 없음, nit n1) | 합성 패킷 25/25 계수, 공식 21번 59,625패킷 × 2주기 위반 0, 원자료 27,000패킷 \|r\| ≤ 0.519 |
| n1 `>` → `>=` | `>=` | 해결(항목 이름은 "≤ 10 %", nit n2) | `acceptance.py:640` |
| n2 v_pred 한 단 지연 | 문서(5절) | 해결 | 5절 171행 |
| n3 정지 뒤 역방향 기준 | 문서(3.4절) | 문서화했으나 수치가 다름 → M1(r3) | "−0.09 m/s" 대 실측 −0.136~−0.137 m/s(90/90) |
| n4 24번 `disp` | 제거 | 해결 | 공식 JSON 24번에 `disp` 없음 |
| n5 1단계 되돌아감 0.16 m | 문서(`plan4_lqi8.md` 1.4) | 확인 안 됨(nit n4) | 1.4절에는 정지 최대 이탈 0.21~0.24 m만 |
| n6 피치 계수 근거 | 문서 | 확인 안 됨(nit n4) | 해당 문장을 찾지 못함 |

## 1. 재현 결과

### 1.1 축소 매트릭스(지시 명령 그대로)

`python -m wbr.bench.acceptance --host mpc --stage2 --rate both --matrix reduced --seeds 1 --tag review_mpc_r3 --jobs 8 --out results/review_scratch/r3/acceptance_mpc` → 102회, 92 s, 코드 해시 `1cbc282b92`. 출력 디렉터리에 공식 `plan4_<rate>Hz.json`을 먼저 복사해 20번을 계산했다. 같은 해시·같은 작업은 캐시 키가 같으므로, 재현 102회를 `r4_s2`의 같은 실행(전체 매트릭스의 시드 0 부분집합)과 결과 사전의 모든 키에서 비교했다(`repro_compare.py`).

| # | 1 kHz 재현: 판정, 가장 빠듯한 지표(여유율) | 200 Hz 재현 | 공식 같은 실행과 차이 |
|---|---|---|---|
| 1 | 통과, pitch_rms 0.288 (×0.58) | 통과, pitch_ma_max 0.639 (×0.64) | 0 |
| 2 | 통과, wheel_peak 1.286 (×0.95) | 통과, wheel_peak 1.288 (×0.95) | 0 |
| 3 | 통과, wheel_rms10 0.125 (×0.63) | 통과, wheel_rms10 0.117 (×0.58) | 0 |
| 4·7 | 통과(생존) | 통과 | 0 |
| 5 | 통과, settle_s 1.885 (×0.63) | 통과, settle_s 1.930 (×0.64) | 0 |
| 6 | 통과, wheel_rms10 0.116 (×0.58) | 통과, wheel_rms10 0.110 (×0.55) | 0 |
| 8 | 통과, rise_s 1.050 (×0.70) | 통과, rise_s 1.065 (×0.71) | 0 |
| 9 | 통과, wheel_rms10 0.106 (×0.53) | 통과, wheel_rms10 0.109 (×0.54) | 0 |
| 10 | 통과, leg_rms 1.974 (×0.49) | 통과, leg_rms 1.971 (×0.49) | 0 |
| 11 | 통과, stop_time 2.299 (×0.77) | 통과, stop_time 2.320 (×0.77) | 0 |
| 12 | 통과, wheel_rms10 0.155 (×0.77) | 통과, wheel_rms10 0.157 (×0.78) | 0 |
| 13 | 통과, rise_s 1.358 (×0.91) | 통과, rise_s 1.425 (×0.95) | 0 |
| 15 | 실패(기록), 20 ms | 통과, 25 ms | 0 |
| 16 | **실패**, drift_max 0.087 (×1.74) | **실패**, 0.089 (×1.78) | 0 |
| 17 | **실패**, drift_max 0.106 (×2.11) | **실패**, 0.102 (×2.04) | 0 |
| 19 | 통과, stop_disp 0.2956 (×0.99) | 통과, stop_disp 0.2963 (×0.99) | 0 |
| 20 | 통과(15항목, 기록 8·13 stop_disp ×0.47→×0.59) | 통과(같음) | 공식과 같은 행 |
| 21 | 통과, wheel_peak 0.415 (×0.31), 위반 0 | 통과, 0.410 (×0.30), 위반 0 | 0 |
| 22 | 통과, p99 0.274 ms | 통과, p99 0.213 ms | 벽시계 지표만 다름(1.2절) |
| 23 | 통과 | 통과 | 0 |
| 24 | 통과(기록), settle_s 1.911 | 통과, 2.025 | 0 |

- 102회 중 100회는 `wall_s`를 뺀 모든 키가 같고, 2회(22번)는 `solve_mean_ms`만 다르다. 실행 단위 판정 뒤집힘 0, 요약 판정(항목별 통과/실패·종합 불합격) 공식과 같다.

### 1.2 풀이 시간(22번, 벽시계)

| | p50 [ms] | p99 [ms] | 최대 [ms] |
|---|---|---|---|
| 공식 1 kHz / 200 Hz | 0.100 / 0.063 | 0.306 / 0.255 | 0.459 / 0.394 |
| 재현 | 0.072 / 0.060 | 0.274 / 0.213 | 0.414 / 0.421 |

p99가 10~17 % 다르다. 사용자의 뷰어가 도는 데스크톱에서 잰 벽시계 값이라 실행마다 달라지는 기록 항목이고, 판정(p99 ≤ 5 ms) 여유가 16~23배라 바뀌지 않는다. 2라운드와 같이 MAJOR 규칙(결정적 지표 5 % 초과)의 대상이 아니라고 판단했다(문서 표기는 nit n6).

### 1.3 `python -m wbr.bench.acceptance_mpc 1000`

공칭·시드 0: 8·9·13·19 바퀴 피크 0.2447 / 0.2970 / 0.3756 / 0.2447 N·m, QP 자기 검사 위반 0, 패킷 위반 0(패킷 300 / 125 / 600 / 300), QP 실패 0, 생존. 커밋된 `results/plan4_mpc/constraint_check.json`과 같은 값.

### 1.4 단위 테스트

`python -m unittest discover -s tests` → **78개 통과**(18.6 s).

### 1.5 OSQP 백업 경로(2라운드 m1, `osqp_check.py`)

`ReferenceQP.solve`를 감싸 19번 속도 스텝(공칭, 시드 0) 중 DAQP 풀이 하나만 실패시켰다(그 주기의 DAQP 해는 비교용으로만 따로 계산).

| 주기 | 실패 시각 | 결과(이벤트) | OSQP 시간 | 이후 |
|---|---|---|---|---|
| 1 kHz | 0.20 / 0.80 / 1.20 / 3.30 s | "QP infeasible / failed (daqp)" → "QP solved by the backup solver osqp" | 2.2 / 4.5 / 2.9 / 5.1 ms | MPC 유지, 폴백 패킷 0, 첫 수 차 ≤ 2e-7, 위반 0, 정지 이탈 차 ≤ 3e-4 m |
| 1 kHz | 3.04 s(제동 시작) | daqp 실패 → "QP infeasible / failed (osqp)"(OSQP "run time limit reached") → "fallback engaged: raw target … (host_shaped = False)" | 11.5 ms | 89패킷 host_shaped 거짓, 4.82 s "MPC resumed" |
| 1 kHz | 0.80 s, DAQP 예외 | "QP solver daqp unavailable: RuntimeError(…)" → OSQP 해결 | 4.6 ms | MPC 유지 |
| 200 Hz | 0.20 / 0.80 / 1.20 / 3.04 / 3.30 s | 다섯 번 모두 OSQP 해결 | 2.2 / 4.7 / 3.1 / 11.2 / 5.3 ms | MPC 유지, 위반 0 |
| 200 Hz | 0.80 s, DAQP 예외 | 예외 이벤트 → OSQP 해결 | 4.7 ms | MPC 유지 |

22번 시나리오(스텝 + 0.5 W 밀기)의 모든 QP를 OSQP로도 풀어 본 그림자 측정(750회): 1 kHz 수렴 748(99.7 %), p50 1.90 / p90 2.68 / p99 6.37 / 최대 11.81 ms, 10 ms 초과 4회; 200 Hz 수렴 747(99.6 %), p99 7.22 / 최대 11.04 ms, 10 ms 초과 5회. 미수렴은 0.50 s(스텝 시작)·3.00~3.02 s(제동 시작)에 몰린다. 수렴한 해의 첫 수는 DAQP와 p99 6e-7 m/s² 안에서 같다. → 백업은 이제 실제로 돈다. 9절의 "90 %만 수렴(p99 11 ms)"은 현재 코드와 다르다(M1(r3)).

### 1.6 성형 전환 무충격(2라운드 m6, `bumpless_check.py`)

23번 (b)와 같은 0.1 s 강제 실패를 0.6·0.8·1.2·2.0·3.04·3.2 s × 3조합(공칭, m×0.85 μ0.5, m×1.15 μ1.0) × 2주기로 돌리고, 같은 실험을 이 프로세스 안에서만 옛 전환식(`v_filt = v_ramp`)으로 바꿔 대조했다.

| | 1 kHz 현재 | 1 kHz 옛 전환식 | 200 Hz 현재 | 200 Hz 옛 |
|---|---|---|---|---|
| 복귀(→ 플레인) 순간 v_filt 한 스텝 변화 최대 | **0.0019 m/s** | 0.0168 m/s | 0.0020 | 0.0020 |
| 플레인 램프 한 스텝 한계(4 m/s² × Ts) | 0.004 | 0.004 | 0.020 | 0.020 |
| 복귀 순간 호스트 r − MCU v_filt | ≤ 0.0019 | ≤ 0.0019 | ≤ 0.0020 | ≤ 0.0020 |
| 8번 통과 / MPC 복귀 | 18/18 / 18/18 | 18/18 / 18/18 | 18/18 / 18/18 | 18/18 / 18/18 |
| 오버슈트 최대 / 정지 최대 / 피치 최대 | 8.8 % / 0.309 m / 2.24° | 8.8 % / 0.308 m / 2.24° | 9.95 % / 0.308 m / 2.29° | 9.95 % / 0.308 m / 2.29° |

1 kHz에서 2라운드가 잰 0.017 m/s 도약이 옛 전환식으로 재현되고, 현재 코드에서는 플레인 램프 한계 아래(0.0019)로 사라졌다. 200 Hz는 두 전환식 차이가 없다.
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
