wisehyun-2/my_robot_project/wheeled_biped/docs/review_plan4_r1_response.md

# Plan 4 검토 1라운드 응답 (반영 / 반박 / 보류)

작성 2026-10-23, 2·3라운드 반영 추가. 대상: `docs/review_plan4_r1.md`(1단계, major 5·minor 13·nit 8), `docs/review_plan4_mpc_r1.md`(2단계, major 5·minor 11·nit 7), 2라운드 `docs/review_plan4_r2.md`(major 2·minor 8·nit 14)·`docs/review_plan4_mpc_r2.md`(major 3·minor 9·nit 6), 3라운드(좁은 검증) `docs/review_plan4_r3.md`(major 0·minor 2·nit 9)·`docs/review_plan4_mpc_r3.md`(major 1·minor 4·nit 6). 모든 수정 뒤 단위 테스트 83개 통과(`tests/test_plan4.py` 38 + `tests/test_plan4_safety.py` 25 + `tests/test_core.py` 20), 두 단계 전체 매트릭스 재실행(1라운드 반영 캐시 `r3_s1`·`r3_s2`, 2라운드 `r4_s1`·`r4_s2`, 3라운드 `r5_s1`·`r5_s2`; 결과 파일 머리에 코드 해시를 적는다). 기준 수치·등급·노이즈·지연·모터 한계는 바꾸지 않았다(`docs/합격기준.md` 6.2에 측정 정의의 변경만 기록).

## 1단계 (review_plan4_r1)

| # | 판정 | 조치 | 위치 |
|---|---|---|---|
| M1 지연 여유 과대 보고 | **반영(부분)** | (1) 15번에 강건 여유 기록 지표 추가(노이즈·2 mm 낙하·0.5 W 밀기·20 s, 마지막 5 s 피치 rms < 0.5°; 첫 실패에서 중단). (2) 마찰 보상에 **피치 속도 게이트** 1/(1 + (φ̇/0.1)²)를 넣어 정지 보조로만 작동하게 함(`McuParams.friction_comp_rate_gate`, Plan 4 기본 0.1 rad/s). 측정(노이즈·2 mm 낙하·0.5 W 밀기, μ 0.75): 게이트 없음 1 kHz 12 ms 한계 사이클(피치 rms 2.1°)·13 ms 한계 사이클 3.2°(시드 5개 모두 생존)·14 ms 전복 → 게이트 있음 12 ms 깨끗한 정착(2.3 s, 꼬리 0.14°)·13 ms 한계 사이클(전복 없음)·15 ms 전복(2라운드 시드 5개 재측정 `results/review_scratch/r2/latency_robust.log`; 1라운드 반영 때 적은 "13 ms 전복"은 시드 하나의 값이었다 — 3라운드 n7). **반박 부분**: 검토가 지목한 마찰 보상은 주원인이 아니었다 — 보상을 둘 다 꺼도(변형 E) 1 kHz 13 ms부터 한계 사이클·14 ms 전복, 200 Hz 20 ms 전복이다. 2라운드 검토(m1)가 확인한 주 요인은 **5 ms 위치 차분 속도 창의 지연**이며, 창을 2 ms로 줄이면 1 kHz 강건 여유 ≥ 15 ms이지만 10° 바퀴 피크(1.39~1.47 Nm)와 μ0.5 15° 복귀가 깨지므로 5 ms를 유지한다(교환 관계를 `plan4_lqi8.md` 2절 12·4.2절에 기록). 10 ms 예측기(지연 허용 2배, 밀기
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
