wisehyun-2/my_robot_project/robot_cad_v5/images/02_leg_side_outboard.png

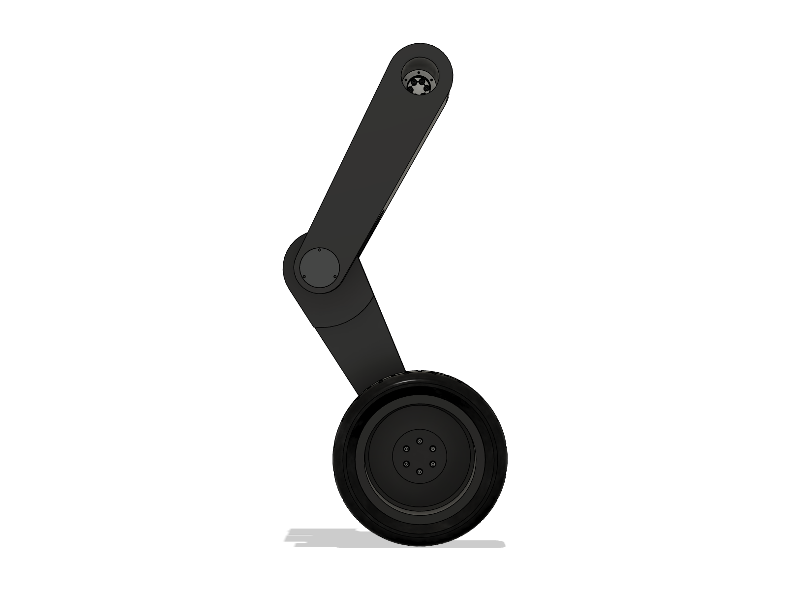
robot_cad_v5/images/02_leg_side_outboard.png
