wisehyun-2/my_robot_project/robot_cad_v5/images/06_robot_rear.png

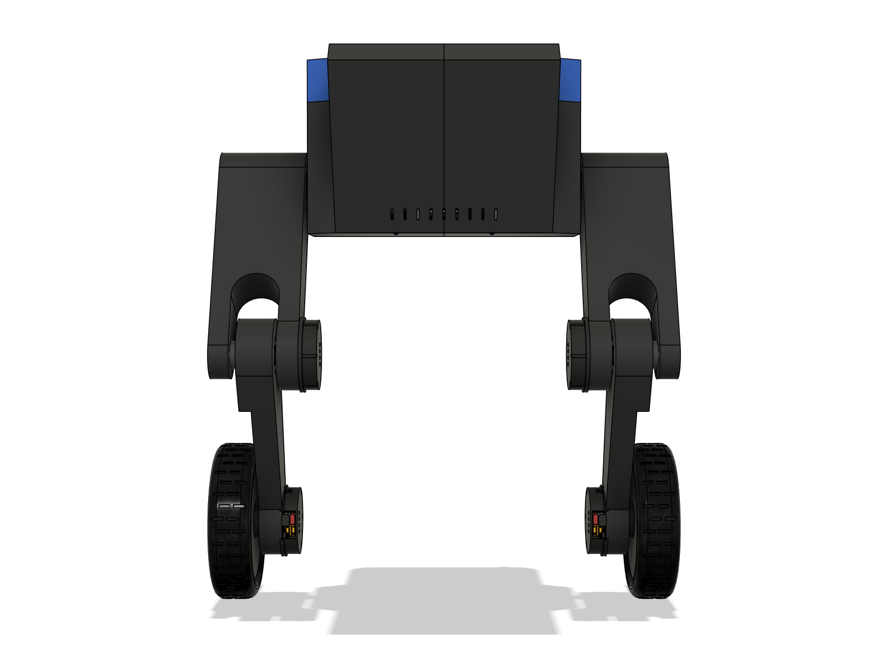
robot_cad_v5/images/06_robot_rear.png
