wisehyun-2/my_robot_project/robot_cad_v5/images/07_robot_side.png

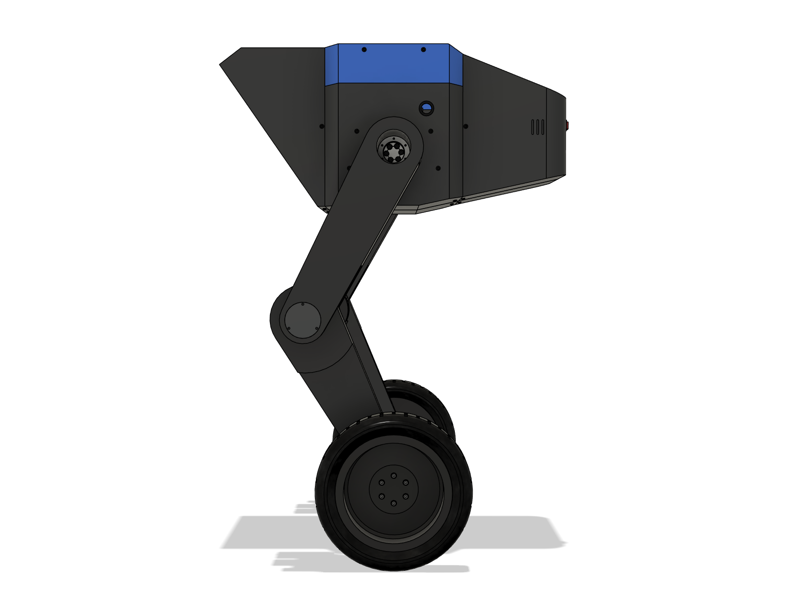
robot_cad_v5/images/07_robot_side.png
