wisehyun-2/my_robot_project/robot_cad_v5/images/11_electronics_top.png

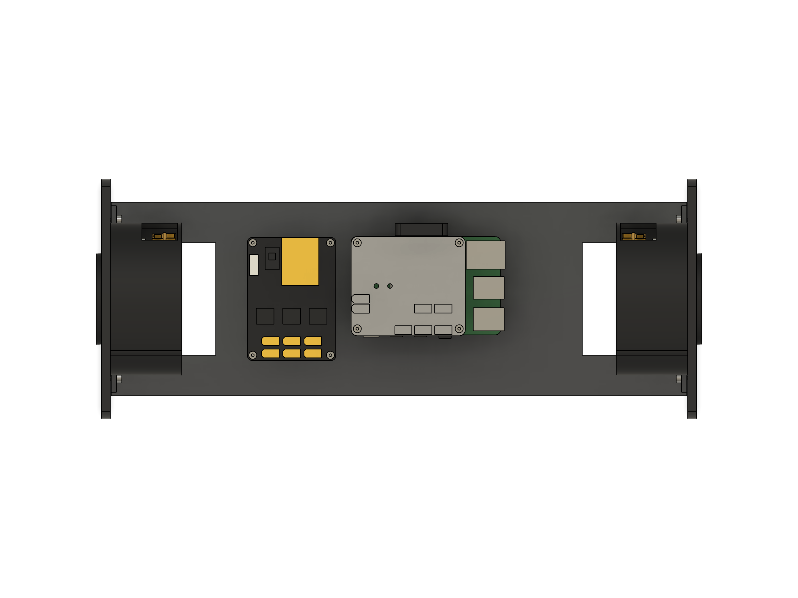
robot_cad_v5/images/11_electronics_top.png
