wisehyun-2/my_robot_project/robot_cad_v5/images/12_electronics_rear.png

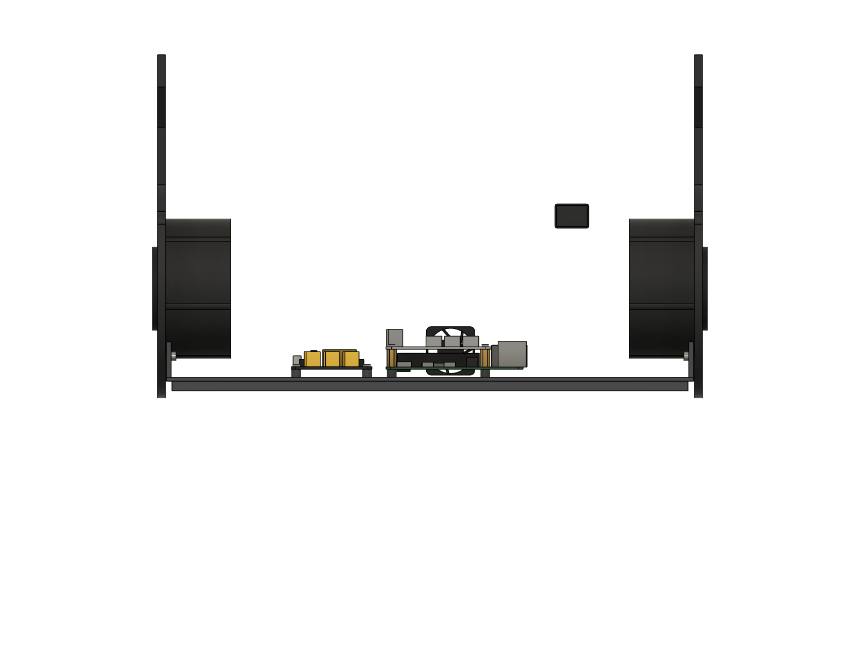
robot_cad_v5/images/12_electronics_rear.png
