wisehyun-2/my_robot_project/wheeled_biped/docs/balancing_robot_design/figures/bode_lqr_baseline.png

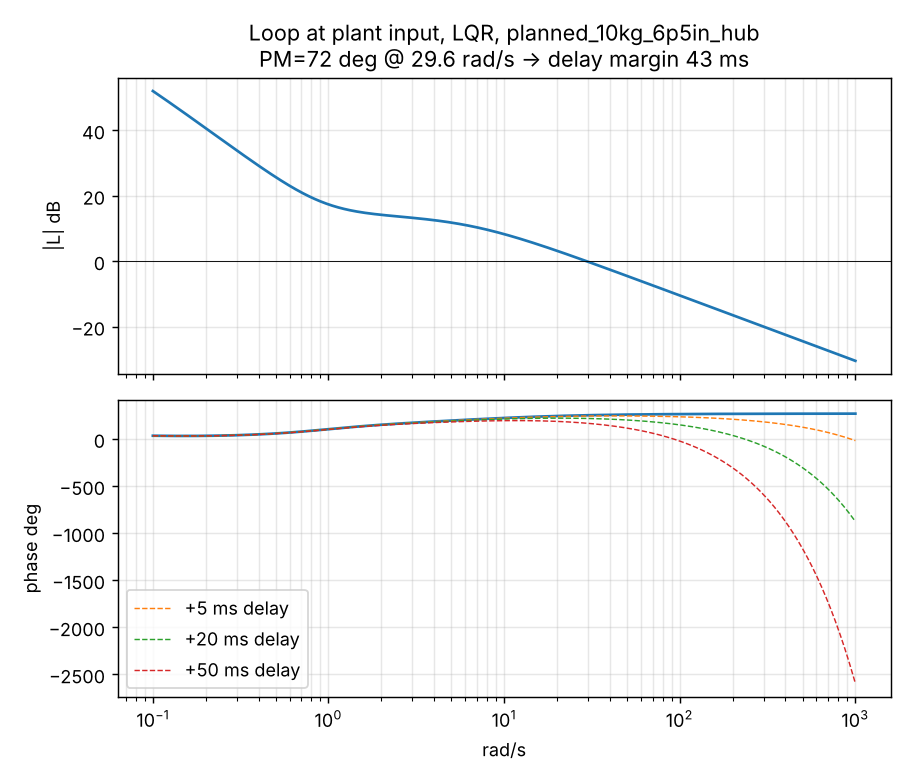
wheeled_biped/docs/balancing_robot_design/figures/bode_lqr_baseline.png
