wisehyun-2/my_robot_project/wheeled_biped/docs/balancing_robot_design/figures/mpc_vs_lqr_tilt_recovery.png

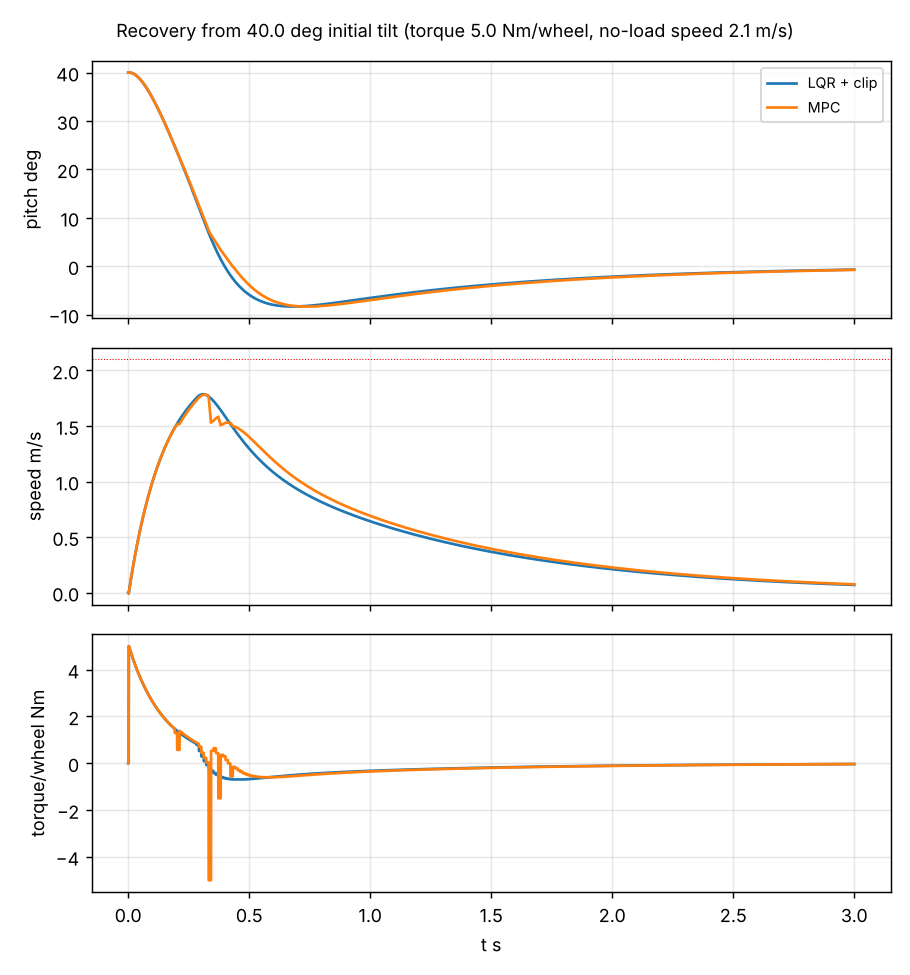
wheeled_biped/docs/balancing_robot_design/figures/mpc_vs_lqr_tilt_recovery.png
