wisehyun-2/my_robot_project/wheeled_biped/docs/balancing_robot_design/figures/sil6_responses_rm.png

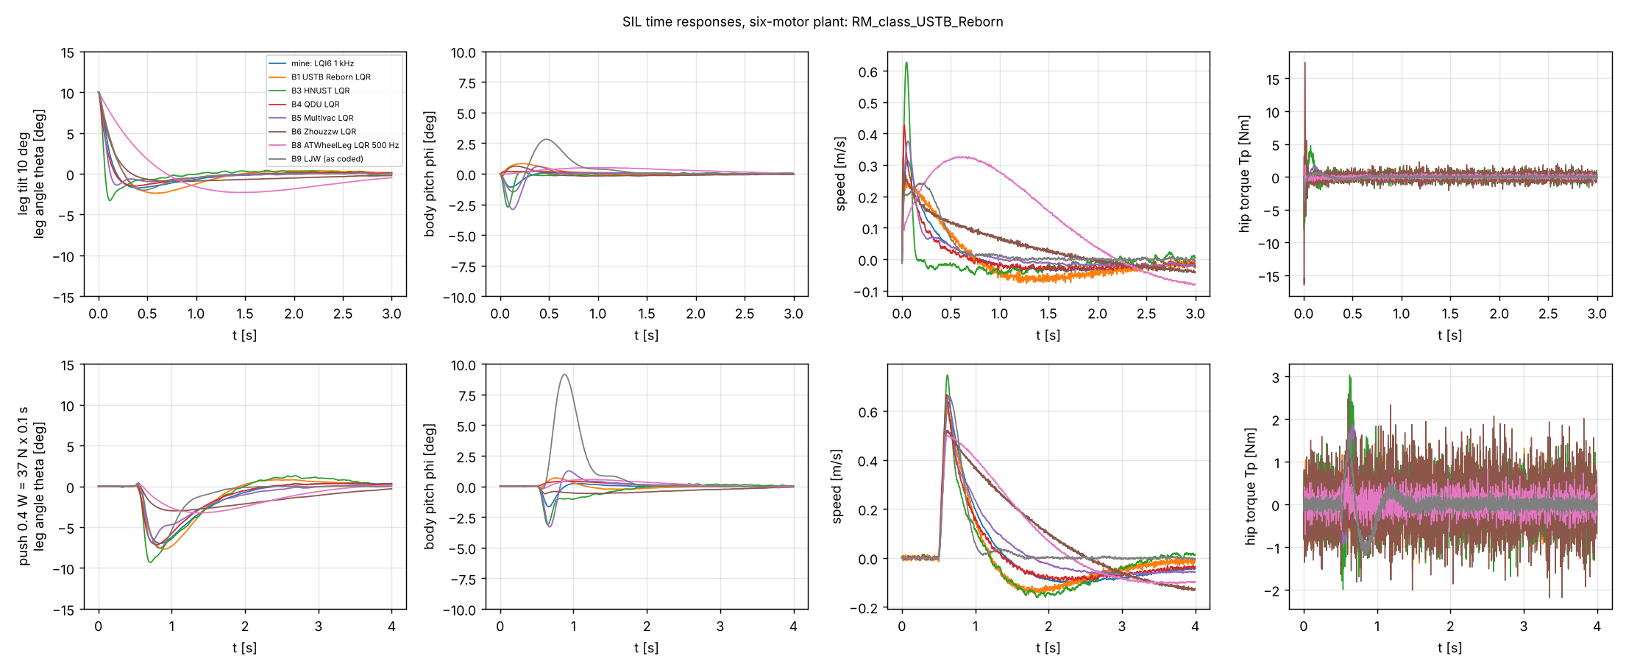
wheeled_biped/docs/balancing_robot_design/figures/sil6_responses_rm.png
