wisehyun-2/my_robot_project/wheeled_biped/docs/balancing_robot_design/figures/sil_responses_large.png

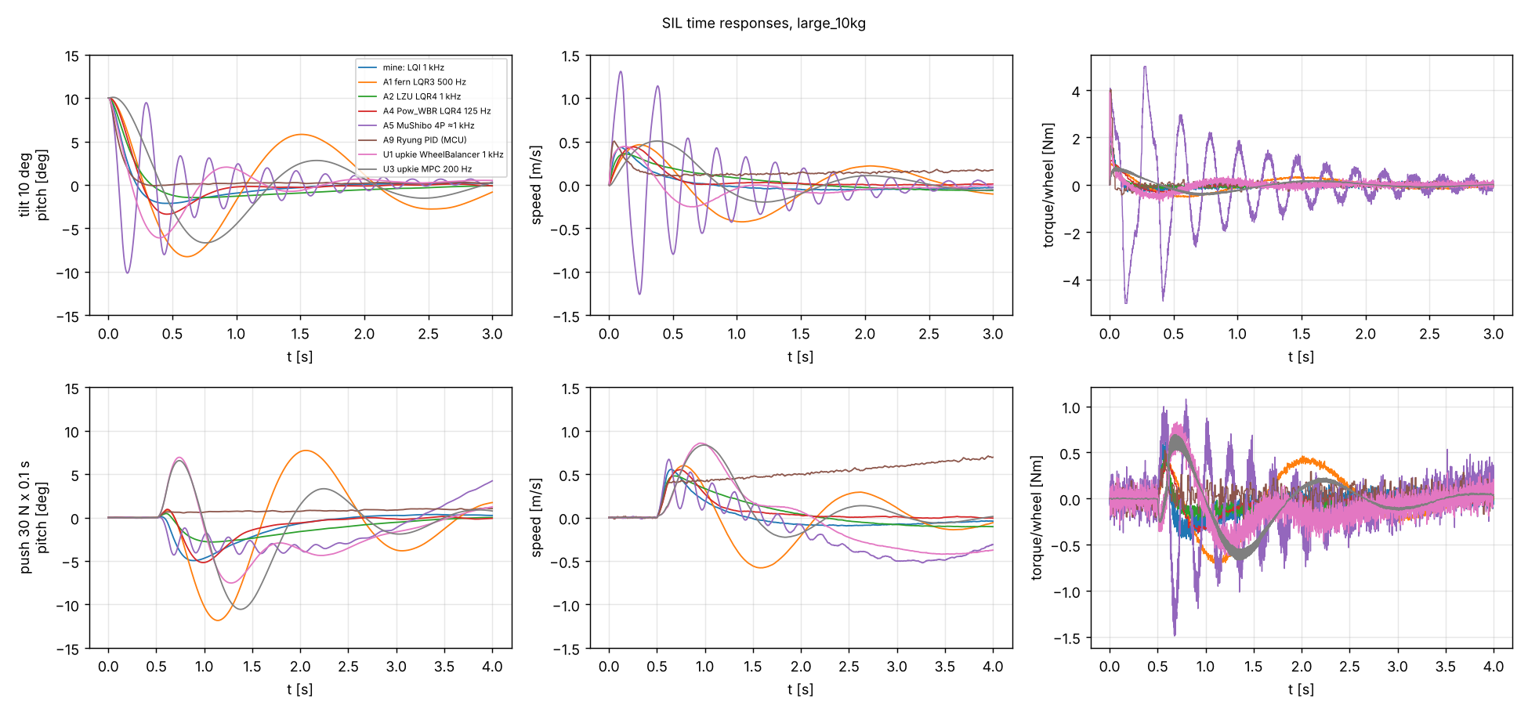
wheeled_biped/docs/balancing_robot_design/figures/sil_responses_large.png
