wisehyun-2/my_robot_project/wheeled_biped/docs/balancing_robot_design/figures/stability_map_rate_vs_latency.png

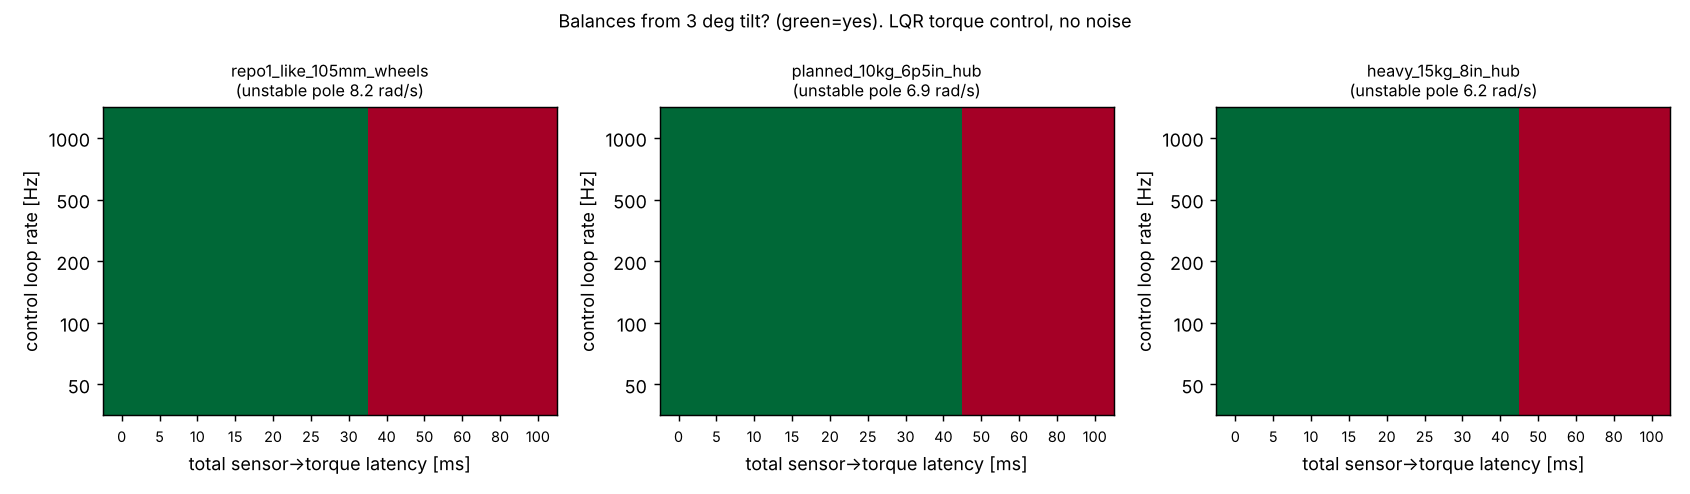
wheeled_biped/docs/balancing_robot_design/figures/stability_map_rate_vs_latency.png
