wisehyun-2/my_robot_project/wheeled_biped/docs/balancing_robot_design/figures/time_response_comparison.png

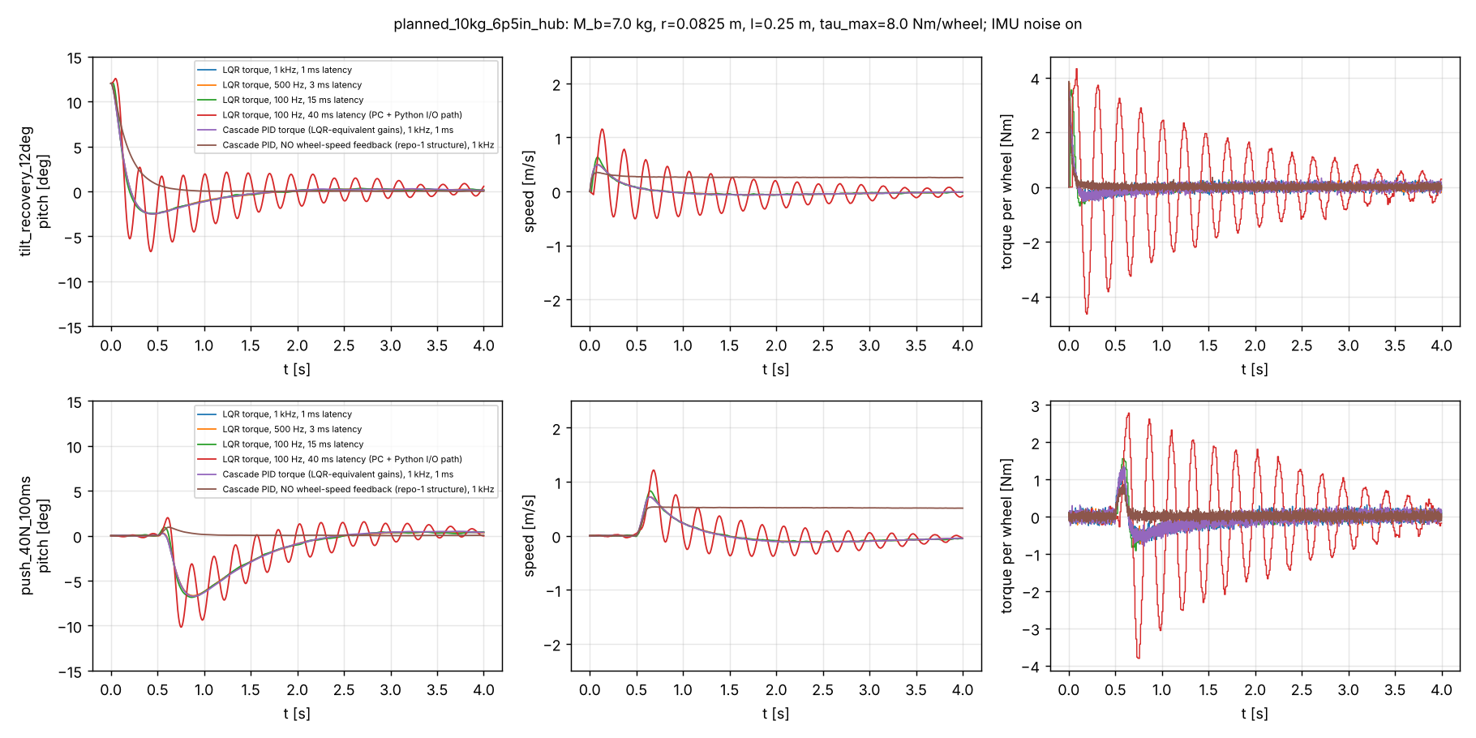
wheeled_biped/docs/balancing_robot_design/figures/time_response_comparison.png
