wisehyun-2/my_robot_project/robot_cad_v5/BOM.md

# WheelBiped v5 BOM — 주문용

`python manufacturing/bom.py`가 만든다(손으로 고치지 말 것). 모델에 있는 부품의 수량은 **조립 STEP**(`export/WheelBiped_v5_assembly.step`, 허브 버전 18(11-09: 버전 17의 받침·데크 두 조각 + 스위치 윗면 이동·그로밋 제거) = `export/WheelBiped_v5.f3d`; 링크 25 cm, 11.610 kg — 금속 부품 기준)의 인스턴스 수이고, 모델 부품이 하나라도 분류되지 않으면 스크립트가 멈춘다. 모델에 없는 것(v5 관절 볼트 ⑥·⑦과 그 인서트, 배선, 공구)은 손으로 넣었고 **★ 또는 "모델 없음"** 으로 표시했다. 출력 질량과 베드 크기는 `export/parts_stl`에서 계산했다. 가격은 넣지 않았다.

**11-09 사용자: 모든 부품을 3D 프린터(최대 300 × 300 mm)로 PLA 또는 PETG로 뽑는다. 강도는 보지 않는다.** 그래서 가공 주문은 없고, 예전 가공 부품(6061·SUS304)은 2절에서 출력 부품으로 바뀌었다. 놓는 면을 정한 출력 부품이 베드에 안 들어가면 스크립트가 멈춘다.

## 0. 한눈에

| 묶음 | 종류 | 개수 | 어디에 |
|---|---|---|---|
| 1. 구매품(모터·전장·바퀴) | 14 | 31 | mjbots, CubeMars, 전자 부품상, 베어링 |
| 2. 3D 출력 — 예전 가공 부품(가공 주문 없음) | 18 | 26 | 직접 출력 + 탭·다듬기. 필라멘트 약 0.76 kg |
| 3. 3D 출력 — 그 밖의 출력 부품 | 28 | 28 | 직접 출력. 필라멘트 약 4.6 kg |
| 4. 체결 부품 | 26 | 430 (주문 권장 504) | 나사 쇼핑몰 |
| 5. 배선·커넥터(모델 없음) | 11 | — | 전자 부품상 |
| 6. 공구·소모품(있으면 생략) | 11 | — | |

출력 필라멘트 합계(2·3절) 약 **5.4 kg**, 서포트·브림·실패 여유 15 %를 더하면 **6.2 kg → 1 kg 스풀 7개**. 조립 STEP의 부품 인스턴스 478개(링크 묶음 torso·femur·tibia·wheel 7개를 더하면 485개)를 모두 아래 줄로 나눴다.

## 1. 구매품

| 품목 | 규격 | 필요 | 주문 | 구입처 | 비고 |
|---|---|---|---|---|---|
| CubeMars AKE60-8 KV80 | 8:1, 피크 12.5 / 정격 5 N·m, 0.26 kg, Ø69 × 25 | 6 | 6 | CubeMars | hip·무릎·바퀴 × 좌우. 부속 자석 Ø6 × 2.5 N38H(엔코더용)를 출력한 자석 스페이서(2절)에 붙여 쓴다 |
| mjbots moteus r4.11 | XT30PW-M ×2, JST PH-3 CAN ×2, 10~44 V | 6 | 6 | mjbots | 관절마다 1개, 드라이버 컵 안 |
| Raspberry Pi 4 Model B | 4 GB 이상 | 1 | 1 | 라즈베리파이 판매점 | microSD는 이 표 맨 아래 |
| mjbots pi3hat r4.5 | CAN-FD ×5, IMU, 24 V → 5 V, M2.5 × 11 스탠드오프·나사 동봉 | 1 | 1 | mjbots | 파이에는 USB-C 전원을 넣지 않는다(pi3hat이 5 V를 만든다) |
| M2.5 × 11 육각 스탠드오프(수-암) | pi3hat 동봉 — 따로 사지 않는다 | 4 | — (동봉) | (pi3hat 동봉) | 파이 ↔ pi3hat |
| mjbots power dist r4.5b | XT90 입력, XT30 출력 ×6, 프리차지, CAN-FD(전압·전류·에너지, 소프트 종료), 10~44 V, 80 × 50, 구멍 74 × 44 | 1 | 1 | mjbots | 배터리를 파이·pi3hat에 바로 물리지 않는다(11-08 사용자: mjpower-ss 대신, 자동 종료용 CAN). 동봉: XT30U 수 6, XT90S 암 1, PH-4·PH-3 짝 커넥터, 로커 스위치 하네스. CAN1 → pi3hat JC3, 기본 CAN ID 32, 보드에 종단 저항 없음(선이 0.5 m 미만이라 pi3hat 쪽만으로 됨) |
| 배터리 24 V 15 Ah | 75 × 310 × 75 mm, XT60(F) 리드 | 1 | 1 | (가지고 있는 배터리) | 새로 살 때는 크기·커넥터가 같은 것 |
| 팬 30 × 30 × 7 mm 5 V | 2핀 | 1 | 1 | 전자 부품상 | pi3hat JP6(1번 5 V, 3번 GND), 데크에 1.5 mm 양면 폼테이프 |
| 로커 스위치 19 × 13 + mjbots PH4 스위치 하네스 | power dist J2(PH-4)용, E-Switch R1966 + 30 cm 하네스 | 1 | — (동봉) | (power dist r4.5b 동봉) | 11-09: 몸통 **윗면**, 위판 구멍 바로 뒤(무릎 쪽, CAD x +78) 좌우 정중앙의 19 × 13 구멍(셸 가운데 좌우 조각에 반씩, 긴 변 좌우 방향). 하네스 30 cm는 이 자리에서 데크의 power dist J2까지 어림 약 29 cm(모델 없음) — 실물에 대 보고 모자라면 PH-4 연장 |
| CAN-FD 종단 저항 120 Ω (JST PH-3) | 20 × 15 × 10 이하 | 2 | 2 | mjbots (또는 120 Ω 저항 + PHR-3로 직접) | 바퀴 드라이버 CAN1(다리 끝). moteus에는 종단 저항이 없고 pi3hat 쪽에는 있다 |
| XT30 보호 캡 | XT30 수 커넥터용 | 2 | 2 | 전자 부품상 | 바퀴 드라이버 J2(24 V가 살아 있는 빈 포트) |
| Xiaomi M365 8.5 × 2 (8 1/2 × 2) 통고무 허니콤 타이어 | 외경 202 × 폭 54, 안지름 141 × 안쪽 폭 36.5, 721 g | 2 | 2 | AliExpress | 사용자가 이미 주문함(v2 때) — 받았는지 확인 |
| 깊은 홈 볼 베어링 61807 | Ø35 × Ø47 × 7, 2RS 또는 ZZ | 2 | 2 | 베어링 판매점 | 정강이 머리 패드 바깥 면 자리(Ø47 압입), 안륜은 무릎 캡 관 |
| microSD 카드 | 32 GB 이상(A1/A2) | 1 | 1 | 전자 부품상 | 라즈베리파이 OS — 모델 없음 |

## 2. 3D 출력 — 예전 가공 부품 (11-09: 가공 주문 없음)

가공으로 주문하려던 부품 9종 26개를 **같은 STL로 출력**한다. 모양은 그대로다(모델을 바꾸지 않음). 공통:

- **채움 100 %**(속까지 꽉 차게): 탭 나사산과 끼워맞춤 자리가 속 빈 채움에 걸리지 않게 한다. 모두 작아서 필라멘트는 0.76 kg뿐이다.
- **탭**: 금속 가공 때의 탭 자리가 STL에 기초 구멍(M3 Ø2.5, M4 Ø3.3, M5 Ø4.2)으로 들어 있다. 그대로 뽑고, 같은 지름 드릴로 한 번 정리한 뒤 핸드 탭으로 나사산을 낸다. 플라스틱 나사산이라 세게 조이지 않는다.
- **끼워맞춤**(H7·g6·N7·h9 같은 가공 공차)은 출력 오차(±0.2)보다 작다. 맞닿는 실물(모터, 61807, 핀)에 대 보며 드릴·사포로 다듬는다. 아노다이징·버 제거 같은 금속 후처리는 없다.
- 도면(`manufacturing/drawings/`의 hip_plate·spine_tube·rail·clamp_ring_stator·magnet_spacer·hub_insert_hip·hub_insert_knee·knee_cap·hub_ring, `v2_*.pdf`)은 **치수 참고용**이다. 재질·공정 칸(6061·SUS304, 선반·MCT·아노다이징)은 예전 가공 기준이다.
- 모델(질량 11.610 kg)에서 이 부품들은 금속으로 1.65 kg이고, 꽉 찬 PETG로 뽑으면 0.76 kg이다. **로봇이 약 0.89 kg 가벼워진다**. CAD 재질·`calc/mass_properties.json`·URDF는 아직 금속 기준이다.

| 도번 | 파일 | 부품 | 재료 | 설정·놓는 면 | 색 | 수량 | 출력 질량(어림) | 외곽(mm) | 놓은 면 기준 베드 / 높이 | 비고 |
|---|---|---|---|---|---|---|---|---|---|---|
| WBv5-S14 | `parts_stl/hip_plate_L.stl` | hip 판 | PETG 권장(모터 열) | 채움 100 %, 안쪽 면(Ø80 컵 받침 턱)을 바닥에 — 턱 밖 웹 밑 1.5 mm만 바닥 서포트 | 검정 | 1 | 131 g | 213 × 136 × 10 | 213 mm / 10 mm | 출력 뒤: M3 탭 11(Ø2.5 구멍: 컵 3, 데크 2, 셸 6), Ø42 모터 파일럿 자리를 모터에 맞춰 다듬기. 왼·오른쪽 거울상 = 다른 파일. (예전: 6061-T6 판, 3축 MCT 양면, 검정 아노다이징) |
| WBv5-S14 | `parts_stl/hip_plate_R.stl` | hip 판 | PETG 권장(모터 열) | 채움 100 %, 안쪽 면(Ø80 컵 받침 턱)을 바닥에 — 턱 밖 웹 밑 1.5 mm만 바닥 서포트 | 검정 | 1 | 131 g | 213 × 136 × 10 | 213 mm / 10 mm | 출력 뒤: M3 탭 11(Ø2.5 구멍: 컵 3, 데크 2, 셸 6), Ø42 모터 파일럿 자리를 모터에 맞춰 다듬기. 왼·오른쪽 거울상 = 다른 파일. (예전: 6061-T6 판, 3축 MCT 양면, 검정 아노다이징) |
| WBv5-S15 | `parts_stl/spine_tube_F.stl` | 척추 봉 Ø16 × 328 | PLA 또는 PETG | 채움 100 %, 눕혀 대각선으로, 둥근 아래쪽은 바닥 서포트 | 검정 | 1 | 83 g | 328 × 16 × 16 | 243 mm / 16 mm | 출력 뒤: 양 끝 M5 탭 깊이 11(Ø4.2 구멍, 눕혀 뽑은 구멍이라 드릴로 정리 후 탭). 길이 328을 레일과 같게(길면 끝면을 사포로). (예전: 6061-T6 환봉, 길이 328.00 ±0.05) |
| WBv5-S15 | `parts_stl/spine_tube_B.stl` | 척추 봉 Ø16 × 328 | PLA 또는 PETG | 채움 100 %, 눕혀 대각선으로, 둥근 아래쪽은 바닥 서포트 | 검정 | 1 | 83 g | 328 × 16 × 16 | 243 mm / 16 mm | 출력 뒤: 양 끝 M5 탭 깊이 11(Ø4.2 구멍, 눕혀 뽑은 구멍이라 드릴로 정리 후 탭). 길이 328을 레일과 같게(길면 끝면을 사포로). (예전: 6061-T6 환봉, 길이 328.00 ±0.05) |
| WBv5-S16 | `parts_stl/rail_F.stl` | 위 레일 15 × 15 × 328 | PLA 또는 PETG | 채움 100 %, Ø4.4 관통 구멍이 위아래로 서게 옆면을 바닥에, 대각선으로 — 서포트 없음 | 검정 | 1 | 92 g | 328 × 15 × 15 | 243 mm / 15 mm | 출력 뒤: 양 끝 M4 탭 깊이 9(Ø3.3 구멍). 길이 328을 척추 봉과 같게. (예전: 6061-T6 각봉, 길이 328.00 ±0.05) |
| WBv5-S16 | `parts_stl/rail_B.stl` | 위 레일 15 × 15 × 328 | PLA 또는 PETG | 채움 100 %, Ø4.4 관통 구멍이 위아래로 서게 옆면을 바닥에, 대각선으로 — 서포트 없음 | 검정 | 1 | 92 g | 328 × 15 × 15 | 243 mm / 15 mm | 출력 뒤: 양 끝 M4 탭 깊이 9(Ø3.3 구멍). 길이 328을 척추 봉과 같게. (예전: 6061-T6 각봉, 길이 328.00 ±0.05) |
| WBv5-S17 | `parts_stl/clamp_ring_stator_D45_t2.0_SUS304.stl` | 고정자 클램프 링 Ø45 × 2 | PETG 권장(모터 열) | 채움 100 %, 평평하게 | 검정 | 4 | 9 g | 45 × 45 × 2 | 45 mm / 2 mm | 출력 뒤: 없음. 작고 얇아 여분 2개를 더 뽑는다. (예전: SUS304 2t 레이저) |
| WBv5-S18 | `parts_stl/magnet_spacer_D9x5.35_(6061)__spacer.stl` | 자석 스페이서 Ø9 × 5.35 | PETG 권장(모터 열) | 채움 100 %, 자석 구멍 쪽을 바닥에 스피곳을 위로, 층 0.1 mm 권장 | 검정 | 6 | 2 g | 9 × 9 × 8 | 9 mm / 8 mm | 출력 뒤: AKE 부속 자석 Ø6 × 2.5를 구멍에 순간접착, Ø5.9 스피곳을 끼울 자리에 맞춰 다듬기. 작아서 여분 2개를 더 뽑는다(출력이라 비자성 조건은 저절로 맞음). (예전: 6061(비자성) 선반) |
| WBv5-M01 | `parts_stl/hub_insert_hip_L.stl` | hip hub 인서트 | PETG 권장(모터 열) | 채움 100 %, 플랜지 바깥 면(접시 구멍 쪽, 평평)을 바닥에, 보스·스피곳을 위로 — 서포트 없음 | 검정 | 1 | 18 g | 48 × 48 × 18 | 48 mm / 18 mm | 출력 뒤: 평행핀 구멍 Ø3 × 7.5에 Ø3 드릴 → 핀 압입, Ø11.8 스피곳을 모터 출력부 Ø12 홈에, Ø48 플랜지를 링크 자리 Ø48.3에 맞춰 다듬기. 왼·오른쪽 거울상 = 다른 파일. (예전: 6061-T6 환봉 선반 + MCT, 아노다이징 권장) |
| WBv5-M01 | `parts_stl/hub_insert_hip_R.stl` | hip hub 인서트 | PETG 권장(모터 열) | 채움 100 %, 플랜지 바깥 면(접시 구멍 쪽, 평평)을 바닥에, 보스·스피곳을 위로 — 서포트 없음 | 검정 | 1 | 18 g | 48 × 48 × 18 | 48 mm / 18 mm | 출력 뒤: 평행핀 구멍 Ø3 × 7.5에 Ø3 드릴 → 핀 압입, Ø11.8 스피곳을 모터 출력부 Ø12 홈에, Ø48 플랜지를 링크 자리 Ø48.3에 맞춰 다듬기. 왼·오른쪽 거울상 = 다른 파일. (예전: 6061-T6 환봉 선반 + MCT, 아노다이징 권장) |
| WBv5-M02 | `parts_stl/hub_insert_knee_L.stl` | 무릎 hub 인서트 | PETG 권장(모터 열) | 채움 100 %, hip hub 인서트와 같게 플랜지 바깥 면을 바닥에 — 서포트 없음 | 검정 | 1 | 18 g | 48 × 48 × 17 | 48 mm / 17 mm | 출력 뒤: hip hub 인서트와 같음(보스 길이만 다름). 왼·오른쪽 거울상 = 다른 파일. (예전: 6061-T6 환봉 선반 + MCT, 아노다이징 권장) |
| WBv5-M02 | `parts_stl/hub_insert_knee_R.stl` | 무릎 hub 인서트 | PETG 권장(모터 열) | 채움 100 %, hip hub 인서트와 같게 플랜지 바깥 면을 바닥에 — 서포트 없음 | 검정 | 1 | 18 g | 48 × 48 × 17 | 48 mm / 17 mm | 출력 뒤: hip hub 인서트와 같음(보스 길이만 다름). 왼·오른쪽 거울상 = 다른 파일. (예전: 6061-T6 환봉 선반 + MCT, 아노다이징 권장) |
| WBv5-M03 | `parts_stl/knee_cap_L.stl` | 무릎 캡 | PLA 또는 PETG | 채움 100 %, 플랜지를 바닥에 관을 위로 — 서포트 없음 | 검정 | 1 | 20 g | 46 × 46 × 42 | 46 mm / 42 mm | 출력 뒤: Ø35 관을 61807 안륜·허벅지 바깥 막대 구멍에 꼭 맞게 사포로. 왼·오른쪽 같은 부품. (예전: 6061-T6 환봉 선반 + 드릴, 아노다이징 권장) |
| WBv5-M03 | `parts_stl/knee_cap_R.stl` | 무릎 캡 | PLA 또는 PETG | 채움 100 %, 플랜지를 바닥에 관을 위로 — 서포트 없음 | 검정 | 1 | 20 g | 46 × 46 × 42 | 46 mm / 42 mm | 출력 뒤: Ø35 관을 61807 안륜·허벅지 바깥 막대 구멍에 꼭 맞게 사포로. 왼·오른쪽 같은 부품. (예전: 6061-T6 환봉 선반 + 드릴, 아노다이징 권장) |
| WBv5-M04 | `parts_stl/hub_ring_hip_L.stl` | 받침 링 Ø43 / Ø29 × 6 | PETG 권장(모터 열) | 채움 100 %, 평평하게 | 검정 | 1 | 6 g | 43 × 43 × 6 | 43 mm / 6 mm | 출력 뒤: M3 탭 관통 6(Ø2.5 구멍). hip·무릎 × 왼·오른쪽 모두 같은 부품 — 한 파일로 4개를 뽑아도 된다. (예전: 6061-T6 환봉 선반, M3 탭 관통 6) |
| WBv5-M04 | `parts_stl/hub_ring_hip_R.stl` | 받침 링 Ø43 / Ø29 × 6 | PETG 권장(모터 열) | 채움 100 %, 평평하게 | 검정 | 1 | 6 g | 43 × 43 × 6 | 43 mm / 6 mm | 출력 뒤: M3 탭 관통 6(Ø2.5 구멍). hip·무릎 × 왼·오른쪽 모두 같은 부품 — 한 파일로 4개를 뽑아도 된다. (예전: 6061-T6 환봉 선반, M3 탭 관통 6) |
| WBv5-M04 | `parts_stl/hub_ring_knee_L.stl` | 받침 링 Ø43 / Ø29 × 6 | PETG 권장(모터 열) | 채움 100 %, 평평하게 | 검정 | 1 | 6 g | 43 × 43 × 6 | 43 mm / 6 mm | 출력 뒤: M3 탭 관통 6(Ø2.5 구멍). hip·무릎 × 왼·오른쪽 모두 같은 부품 — 한 파일로 4개를 뽑아도 된다. (예전: 6061-T6 환봉 선반, M3 탭 관통 6) |
| WBv5-M04 | `parts_stl/hub_ring_knee_R.stl` | 받침 링 Ø43 / Ø29 × 6 | PETG 권장(모터 열) | 채움 100 %, 평평하게 | 검정 | 1 | 6 g | 43 × 43 × 6 | 43 mm / 6 mm | 출력 뒤: M3 탭 관통 6(Ø2.5 구멍). hip·무릎 × 왼·오른쪽 모두 같은 부품 — 한 파일로 4개를 뽑아도 된다. (예전: 6061-T6 환봉 선반, M3 탭 관통 6) |

**뽑지 않는 것**: `clamp_ring_output_D27_t2.0_SUS304`(v4 출력 클램프 링). v5에서는 hub 인서트가 대신하고 모델에도 없지만 `export/parts_step`·`parts_stl`에 파일이 남아 있다. 같은 폴더의 `magnet_spacer_…__magnet_D6x2.5_N38H_(AKE).stl`은 모터 부속 자석이라 뽑지 않는다.

## 3. 3D 출력 — 그 밖의 출력 부품 (PLA 또는 PETG)

| 도번 | 파일 | 부품 | 재료 | 설정·놓는 면 | 색 | 수량 | 출력 질량(어림) | 외곽(mm) | 놓은 면 기준 베드 / 높이 | 비고 |
|---|---|---|---|---|---|---|---|---|---|---|
| WBv5-P01 | `parts_stl/thigh_L.stl` | 허벅지 | PETG 권장(모터 열) | FDM 한 덩어리: 벽 3.5 둘레선, 채움 100 %, 닫힌 칸(배출 구멍 없음), 바깥 면(평평, y 288.5)을 바닥에 — 갈래 틈 안 서포트 | 검정 | 1 | 827 g | 303 × 198 × 114 | 259 mm / 114 mm | 열압입 M2.5 인서트 6(컵 3 + 무릎 캡 3), 캡 관 구멍 Ø35 H7은 0.2 작게 뽑고 리머 |
| WBv5-P01 | `parts_stl/thigh_R.stl` | 허벅지 | PETG 권장(모터 열) | FDM 한 덩어리: 벽 3.5 둘레선, 채움 100 %, 닫힌 칸(배출 구멍 없음), 바깥 면(평평, y 288.5)을 바닥에 — 갈래 틈 안 서포트 | 검정 | 1 | 827 g | 303 × 198 × 114 | 259 mm / 114 mm | 열압입 M2.5 인서트 6(컵 3 + 무릎 캡 3), 캡 관 구멍 Ø35 H7은 0.2 작게 뽑고 리머 |
| WBv5-P02 | `parts_stl/shank_L.stl` | 정강이 | PETG 권장(모터 열) | FDM 한 덩어리: 벽 3.5 둘레선, 채움 100 %, 닫힌 칸(배출 구멍 없음), 안쪽 면(평평, y 208)을 바닥에 — 바퀴 모터 칸 Ø74 안 서포트 | 검정 | 1 | 420 g | 310 × 205 × 45 | 266 mm / 45 mm | 열압입 M2.5 인서트 3(바퀴 컵), 61807 자리 Ø47 압입 |
| WBv5-P02 | `parts_stl/shank_R.stl` | 정강이 | PETG 권장(모터 열) | FDM 한 덩어리: 벽 3.5 둘레선, 채움 100 %, 닫힌 칸(배출 구멍 없음), 안쪽 면(평평, y 208)을 바닥에 — 바퀴 모터 칸 Ø74 안 서포트 | 검정 | 1 | 420 g | 310 × 205 × 45 | 266 mm / 45 mm | 열압입 M2.5 인서트 3(바퀴 컵), 61807 자리 Ø47 압입 |
| WBv5-S01 | `parts_stl/cup_hip_L.stl` | hip 드라이버 컵 | PETG 권장(모터 열) | 채움 30 %, 바닥(덮개 면)을 바닥에, 서포트는 커넥터 창만 | 검정 | 1 | 48 g | 87 × 87 × 40 | 87 mm / 40 mm | 열압입 M2.5 인서트 4 |
| WBv5-S01 | `parts_stl/cup_hip_R.stl` | hip 드라이버 컵 | PETG 권장(모터 열) | 채움 30 %, 바닥(덮개 면)을 바닥에, 서포트는 커넥터 창만 | 검정 | 1 | 48 g | 87 × 87 × 40 | 87 mm / 40 mm | 열압입 M2.5 인서트 4 |
| WBv5-S02 | `parts_stl/cup_knee_L.stl` | 무릎 드라이버 컵 | PETG 권장(모터 열) | 채움 30 %, 바닥을 바닥에, 서포트는 커넥터 창만 | 검정 | 1 | 34 g | 93 × 90 × 22 | 93 mm / 22 mm | 열압입 M2.5 인서트 4 |
| WBv5-S02 | `parts_stl/cup_knee_R.stl` | 무릎 드라이버 컵 | PETG 권장(모터 열) | 채움 30 %, 바닥을 바닥에, 서포트는 커넥터 창만 | 검정 | 1 | 34 g | 93 × 90 × 22 | 93 mm / 22 mm | 열압입 M2.5 인서트 4 |
| WBv5-S03 | `parts_stl/cup_wheel_L.stl` | 바퀴 드라이버 컵 | PETG 권장(모터 열) | 채움 30 %, 바닥을 바닥에, 서포트는 커넥터 창만 | 검정 | 1 | 34 g | 93 × 93 × 22 | 93 mm / 22 mm | 열압입 M2.5 인서트 4 |
| WBv5-S03 | `parts_stl/cup_wheel_R.stl` | 바퀴 드라이버 컵 | PETG 권장(모터 열) | 채움 30 %, 바닥을 바닥에, 서포트는 커넥터 창만 | 검정 | 1 | 34 g | 93 × 93 × 22 | 93 mm / 22 mm | 열압입 M2.5 인서트 4 |
| WBv5-S04 | `parts_stl/hub_flange_L.stl` | 바퀴 허브 플랜지 | PETG 권장(모터 열) | 채움 100 %, 모터 쪽 면을 바닥에 | 검정 | 1 | 20 g | 46 × 46 × 19 | 46 mm / 19 mm | 열압입 M3 인서트 6 |
| WBv5-S04 | `parts_stl/hub_flange_R.stl` | 바퀴 허브 플랜지 | PETG 권장(모터 열) | 채움 100 %, 모터 쪽 면을 바닥에 | 검정 | 1 | 20 g | 46 × 46 × 19 | 46 mm / 19 mm | 열압입 M3 인서트 6 |
| WBv5-S05 | `parts_stl/rim_L.stl` | 바퀴 림(한 조각) | PLA 또는 PETG | 벽 6겹(2.4 mm) · 채움 40 %, 허브 쪽 평면을 바닥에, 열린 쪽 플랜지 밑 4.5 mm 턱만 서포트 | 검정 | 1 | 278 g | 150 × 150 × 44 | 150 mm / 44 mm |  |
| WBv5-S05 | `parts_stl/rim_R.stl` | 바퀴 림(한 조각) | PLA 또는 PETG | 벽 6겹(2.4 mm) · 채움 40 %, 허브 쪽 평면을 바닥에, 열린 쪽 플랜지 밑 4.5 mm 턱만 서포트 | 검정 | 1 | 278 g | 150 × 150 × 44 | 150 mm / 44 mm |  |
| WBv5-S06 | `parts_stl/shell_front_L.stl` | 몸통 셸 앞(스위치 쪽) | PLA 또는 PETG | 채움 25 %, 바깥 면을 위로(서포트 필요) | 진회색 | 1 | 132 g | 196 × 145 × 135 | 187 mm / 135 mm | v4와 달리 세로 모서리 R30, 앞면 스위치 구멍 없음(11-09) |
| WBv5-S06 | `parts_stl/shell_front_R.stl` | 몸통 셸 앞(스위치 쪽) | PLA 또는 PETG | 채움 25 %, 바깥 면을 위로(서포트 필요) | 진회색 | 1 | 132 g | 196 × 145 × 135 | 187 mm / 135 mm | v4와 달리 세로 모서리 R30, 앞면 스위치 구멍 없음(11-09) |
| WBv5-S07 | `parts_stl/shell_mid_L.stl` | 몸통 셸 가운데(hip) | PLA 또는 PETG | 채움 25 %, 바깥 면을 위로(서포트 필요) | 진회색 | 1 | 145 g | 218 × 190 × 172 | 218 mm / 172 mm | 윗면 위판 뒤 좌우 정중앙의 스위치 구멍 19 × 13을 좌우 조각이 반씩 나눔(11-09). 옆면 Ø16 hip 케이블 구멍은 그로밋 없이 씀 |
| WBv5-S07 | `parts_stl/shell_mid_R.stl` | 몸통 셸 가운데(hip) | PLA 또는 PETG | 채움 25 %, 바깥 면을 위로(서포트 필요) | 진회색 | 1 | 145 g | 218 × 190 × 172 | 218 mm / 172 mm | 윗면 위판 뒤 좌우 정중앙의 스위치 구멍 19 × 13을 좌우 조각이 반씩 나눔(11-09). 옆면 Ø16 hip 케이블 구멍은 그로밋 없이 씀 |
| WBv5-S08 | `parts_stl/shell_rear_L.stl` | 몸통 셸 뒤(무릎 쪽) | PLA 또는 PETG | 채움 25 %, 바깥 면을 위로(서포트 필요) | 진회색 | 1 | 126 g | 218 × 145 × 135 | 206 mm / 135 mm |  |
| WBv5-S08 | `parts_stl/shell_rear_R.stl` | 몸통 셸 뒤(무릎 쪽) | PLA 또는 PETG | 채움 25 %, 바깥 면을 위로(서포트 필요) | 진회색 | 1 | 126 g | 218 × 145 × 135 | 206 mm / 135 mm |  |
| WBv5-S09 | `parts_stl/saddle_L.stl` | hip 위 안장 | PLA 또는 PETG | 채움 25 % | 파랑 | 1 | 32 g | 190 × 53 × 37 | 169 mm / 37 mm |  |
| WBv5-S09 | `parts_stl/saddle_R.stl` | hip 위 안장 | PLA 또는 PETG | 채움 25 % | 파랑 | 1 | 32 g | 190 × 53 × 37 | 169 mm / 37 mm |  |
| WBv5-S10 | `parts_stl/top_plate.stl` | 위판(짐 판) | PLA 또는 PETG | 채움 25 % | 검정 | 1 | 132 g | 210 × 120 × 6 | 210 mm / 6 mm | 열압입 M4 인서트 35 |
| WBv5-S11 | `parts_stl/battery_tray_L.stl` | 배터리 받침(두 조각) | PLA 또는 PETG | 채움 30 %, 긴 옆면(159 × 28)을 바닥에 세워서 — 배터리 옆 턱 2줄(14 mm) 밑만 서포트(눕히면 바닥 판 밑 전체에 서포트) | 진회색 | 1 | 82 g | 159 × 112 × 28 | 127 mm / 112 mm | 11-09 두 조각: 가운데(리브 자리)의 이음 턱끼리 M3 × 10 버튼 볼트 + 너트 2쌍(3절 끝). _L·_R은 다른 파일(리드선 홈은 _R 끝) |
| WBv5-S11 | `parts_stl/battery_tray_R.stl` | 배터리 받침(두 조각) | PLA 또는 PETG | 채움 30 %, 긴 옆면(159 × 28)을 바닥에 세워서 — 배터리 옆 턱 2줄(14 mm) 밑만 서포트(눕히면 바닥 판 밑 전체에 서포트) | 진회색 | 1 | 81 g | 159 × 112 × 28 | 127 mm / 112 mm | 11-09 두 조각: 가운데(리브 자리)의 이음 턱끼리 M3 × 10 버튼 볼트 + 너트 2쌍(3절 끝). _L·_R은 다른 파일(리드선 홈은 _R 끝) |
| WBv5-S12 | `parts_stl/electronics_deck_L.stl` | 전장 데크(두 조각) | PLA 또는 PETG | 채움 30 %, 놓인 그대로(보스·끝 플랜지를 위로) — 바닥 판·리브 밑 서포트 | 진회색 | 1 | 80 g | 244 × 110 × 32 | 244 mm / 32 mm | 11-09 두 조각: y 80(라즈베리파이와 끝 창 사이) 이음 턱끼리 M3 × 10 + 너트 2쌍(3절 끝). 열압입 M2.5 인서트 8은 모두 _L(파이·전원보드 쪽) |
| WBv5-S12 | `parts_stl/electronics_deck_R.stl` | 전장 데크(두 조각) | PLA 또는 PETG | 채움 30 %, 놓인 그대로(보스·끝 플랜지를 위로) — 바닥 판·리브 밑 서포트 | 진회색 | 1 | 26 g | 110 × 84 × 32 | 110 mm / 32 mm | 11-09 두 조각: y 80(라즈베리파이와 끝 창 사이) 이음 턱끼리 M3 × 10 + 너트 2쌍(3절 끝). 열압입 M2.5 인서트 8은 모두 _L(파이·전원보드 쪽) |
| WBv5-S13 | `parts_stl/splice_tabs.stl` | 셸 이음판 12개(한 파일) | PLA 또는 PETG | 채움 100 % | 진회색 | 1 | 10 g | 267 × 215 × 206 | 247 mm / 206 mm | 12개가 로봇 위치 그대로 한 파일에 있다 — 슬라이서에서 나눠 놓는다(베드 값은 무시) |

- **재료**: PLA 또는 PETG(사용자 11-09). "PETG 권장(모터 열)"은 모터·드라이버에 닿는 부품이다 — PLA는 55~60 °C 안팎에서 물러지는데, 모터·드라이버는 오래 돌리면 그 근처까지 데워질 수 있다. 강도는 보지 않는다(사용자).
- 출력 질량은 v4 `check.print_fraction`의 식(벽 두께만큼 꽉 차고 속은 채움 비율)으로 STL에서 어림했고 PETG 밀도(1.27) 기준이다. PLA(1.24)는 약 2 % 가볍다. 허벅지·정강이는 꽉 찬 출력이라 모델 값(827.5 / 420.7 g)과 같다.
- 색별 합계(2·3절): 검정 4.21 kg, 진회색 1.09 kg, 파랑 0.06 kg. 여유 15 %를 더하면 **약 6.2 kg → 1 kg 스풀 7개**(색을 하나로 하면).
- **베드 300 × 300**(사용자): "놓은 면 기준 베드"는 표의 놓는 면으로 두고 대각선으로 돌리는 것까지 따진 가장 작은 정사각 베드 한 변이고, "높이"는 그때의 출력 높이다. **모든 부품이 들어간다** — 가장 큰 것은 정강이 266 mm(브림 5 mm를 둘러도 276 mm), 가장 높은 것은 몸통 셸 가운데(hip) 172 mm. 척추 봉·위 레일은 길이 328 mm로 베드 한 변(300)보다 길지만 베드 대각선은 424 mm라, 45° 돌려 대각선 방향으로 놓으면 들어간다. 부품 길이는 그대로이고, 243 mm는 그렇게 놓았을 때 필요한 정사각 베드 한 변이다(봉 끝이 베드 가장자리에서 약 28 mm 안쪽).
- **배터리 받침·전장 데크는 두 조각으로 뽑아 잇는다**(사용자 11-09, `fusion/split_v5.py`): 한 덩어리로는 대각선으로도 304 / 309 mm가 필요했다. 자른 면마다 바닥 밑으로 이음 턱(두께 3, 깊이 8 mm)이 있어 두 턱을 맞대고 ISO 7380 M3 × 10 버튼 볼트 + DIN 934 너트 2쌍으로 조인다(머리는 -y 조각 쪽, 육각 렌치 2 mm·스패너 5.5 mm). 원하면 턱 면을 접착해도 된다. 조일 때 두 조각의 윗면을 평평한 판에 함께 대고 맞춘다. 배터리 받침은 가운데 리브 자리(y 0)에서 나뉘고 조각마다 척추 봉 받침과 벨크로 슬롯이 있어 따로도 얹힌다. 전장 데크는 y 80(라즈베리파이 USB 끝과 +y 끝 창 사이)에서 나뉘고, 이음 턱은 리브 바깥 면까지(셸 바닥 경사와 1.5 mm)다. 6자세 간섭 0건.
- 인서트는 모두 열압입이다.

## 4. 체결 부품·베어링

### 4-1. 주문용 합계 (같은 품목·크기를 모음)

주문 권장 = 필요 + 여유(나사·와셔·너트 +10 %, 최소 2 / 인서트 +20 %, 최소 4 / 핀 +3). ★는 모델에 없는 v5 관절 부품이 들어간 줄.

| 품목 | 규격 | 필요 | 주문 권장 | 쓰는 곳(수량) |
|---|---|---|---|---|
| 나일론 너트 DIN 985 | M4 | 8 | 10 | 위 레일 아래 × 8 |
| 버튼 볼트 ISO 7380 | M3 × 10 | 4 | 6 | 배터리 받침·전장 데크 두 조각의 이음 턱 (조각 이음마다 2) × 4 |
| 버튼 볼트 ISO 7380 | M3 × 8 | 36 | 40 | 셸(hip 조각·안장) 안쪽 받침 → hip 판 M3 탭 (11-08) × 12; 셸 앞·뒤 조각 ↔ hip 조각 이음판 12개 × 24 |
| 벨크로 스트랩 ★ | 폭 25 × 400 mm | 2 | 2 | 배터리 + 받침을 척추 봉에 묶음(받침 슬롯) × 2 |
| 열압입 인서트 황동 ★ | M2.5 × 4 (구멍 Ø3.6) | 50 | 60 | 드라이버 컵 스탠드오프 × 24; 허벅지·정강이의 컵 기둥 자리(열압입) × 12; 데크 보스(라즈베리파이 4, power dist 4) × 8; ⑦ 무릎 캡 자리(허벅지 바깥 막대, 구멍 깊이 7) × 6 |
| 열압입 인서트 황동 | M3 × 5.7 (구멍 Ø4.0) | 12 | 16 | 허브 플랜지 × 12 |
| 열압입 인서트 황동 | M4 × 5.7 (구멍 Ø5.6) | 35 | 42 | 위판 25 mm 격자(짐·로봇팔) × 35 |
| 육각 너트 DIN 934 | M3 | 28 | 31 | 이음판 안쪽 × 24; 배터리 받침·전장 데크 이음 턱 (+y 조각 쪽) × 4 |
| 육각 홈붙이 볼트 ISO 4762 | M2.5 × 18 | 12 | 14 | 무릎 컵 → 허벅지 인서트 × 6; 바퀴 컵 → 정강이 인서트 × 6 |
| 육각 홈붙이 볼트 ISO 4762 | M3 × 40 | 6 | 8 | hip 컵 → hip 판 M3 탭 × 6 |
| 육각 홈붙이 볼트 ISO 4762 | M3 × 8 | 4 | 6 | 전장 데크 플랜지 → hip 판 M3 탭 × 4 |
| 육각 홈붙이 볼트 ISO 4762 | M4 × 25 | 8 | 10 | 위판 → 위 레일(관통) × 8 |
| 육각 홈붙이 볼트 ISO 4762 12.9 | M2.5 × 6 | 12 | 14 | hip 고정자 링 → hip 판 ① × 12 |
| 육각 홈붙이 볼트 ISO 4762 12.9 | M3 × 14 | 12 | 14 | 바퀴 모터 출력 → 허브 플랜지 (와셔 위) × 12 |
| 육각 홈붙이 볼트 ISO 4762 12.9 | M3 × 16 | 24 | 27 | hip·무릎 모터 출력 → hub 인서트 ② (와셔 위) × 24 |
| 육각 홈붙이 볼트 ISO 4762 8.8 | M3 × 14 | 12 | 14 | 림 → 허브 플랜지 인서트 (와셔 위) × 12 |
| 저두 볼트 DIN 7984 | M2.5 × 5 | 24 | 27 | moteus → 컵 스탠드오프 (끝이 4 mm 인서트 안, 11-08) × 24 |
| 저두 볼트 DIN 7984 | M2.5 × 6 | 4 | 6 | power dist r4.5b → 데크 보스 × 4 |
| 저두 볼트 DIN 7984 8.8 ★ | M2.5 × 8 | 30 | 33 | 무릎·바퀴 고정자 링 → 링크 모터 판, 클램프 링 위 ① × 24; ⑦ 무릎 캡 플랜지 → 허벅지 바깥 막대 인서트 (캡마다 3) × 6 |
| 접시 볼트 ISO 10642 | M4 × 12 | 4 | 6 | hip 판 → 위 레일 끝 M4 탭 × 4 |
| 접시 볼트 ISO 10642 | M5 × 12 | 4 | 6 | hip 판 → 척추 봉 끝 M5 탭 × 4 |
| 접시 볼트 ISO 10642 12.9 ★ | M3 × 16 | 24 | 27 | ⑥ hub 인서트 플랜지(접시, 면과 같게) → 링크 벽 6 → 받침 링 탭(출력 부품, 손으로 가볍게, 혐기성 고정제 쓰지 않음) (hub 인서트마다 6) × 24 |
| 평와셔 DIN 125 A2 | M3 | 48 | 53 | ② M3 × 16, 허브 M3 × 14, 림 M3 × 14 머리 밑 × 48 |
| 평와셔 DIN 125 A2 | M4 | 8 | 10 | 위 레일 아래 나일론 너트 밑 × 8 |
| 평행 핀 ISO 8734 m6 경화 | Ø3 × 10 | 18 | 21 | 출력 다웰 ③: hub 인서트 12 (Ø3 압입) + 바퀴 허브 플랜지 6 × 18 |
| 폼 패드 | 75 × 310 × 1 mm | 1 | 1 | 배터리 밑 × 1 |

- pi3hat의 M2.5 × 5 나사 4개와 스탠드오프 4개는 pi3hat에 들어 있어 뺐다.
- 고무 그로밋(셸 hip 케이블 구멍 Ø16 × 2)은 뺐다(사용자 11-09). 구멍은 그대로 두고 케이블이 그냥 지나간다.
- 12.9 볼트(①·②·⑥·허브)는 6061 부품을 조이던 때의 등급이다. 이제는 모두 출력 부품을 조이거나 출력 부품의 탭에 들어가고 강도는 보지 않으므로 (사용자 11-09) **더 싼 등급(8.8·A2)으로 사도 된다**. ⑥은 출력 받침 링의 플라스틱 나사산이라 0.7 N·m·나사 고정제 없이 손으로 가볍게 조인다.
- ISO 4762 M3 × 14는 12.9(허브) 12 + 8.8(림) 12다. 같은 길이이므로 한 등급으로 24개를 사도 된다.

### 4-2. 쓰는 곳별 상세

| 묶음 | 품목 | 규격 | 수량 | 위치 | 모델 |
|---|---|---|---|---|---|
| 관절 | 육각 홈붙이 볼트 ISO 4762 12.9 | M2.5 × 6 | 12 | hip 고정자 링 → hip 판 ① | 있음 |
| 관절 | 저두 볼트 DIN 7984 8.8 | M2.5 × 8 | 24 | 무릎·바퀴 고정자 링 → 링크 모터 판, 클램프 링 위 ① | 있음 |
| 관절 | 육각 홈붙이 볼트 ISO 4762 12.9 | M3 × 16 | 24 | hip·무릎 모터 출력 → hub 인서트 ② (와셔 위) | 있음 |
| 관절 | 평행 핀 ISO 8734 m6 경화 | Ø3 × 10 | 18 | 출력 다웰 ③: hub 인서트 12 (Ø3 압입) + 바퀴 허브 플랜지 6 | 있음 |
| 관절 | 평와셔 DIN 125 A2 | M3 | 48 | ② M3 × 16, 허브 M3 × 14, 림 M3 × 14 머리 밑 | 있음 |
| 바퀴 | 육각 홈붙이 볼트 ISO 4762 12.9 | M3 × 14 | 12 | 바퀴 모터 출력 → 허브 플랜지 (와셔 위) | 있음 |
| 바퀴 | 육각 홈붙이 볼트 ISO 4762 8.8 | M3 × 14 | 12 | 림 → 허브 플랜지 인서트 (와셔 위) | 있음 |
| 바퀴 | 열압입 인서트 황동 | M3 × 5.7 (구멍 Ø4.0) | 12 | 허브 플랜지 | 있음 |
| 드라이버 | 저두 볼트 DIN 7984 | M2.5 × 5 | 24 | moteus → 컵 스탠드오프 (끝이 4 mm 인서트 안, 11-08) | 있음 |
| 드라이버 | 열압입 인서트 황동 | M2.5 × 4 (구멍 Ø3.6) | 24 | 드라이버 컵 스탠드오프 | 있음 |
| 드라이버 | 육각 홈붙이 볼트 ISO 4762 | M3 × 40 | 6 | hip 컵 → hip 판 M3 탭 | 있음 |
| 드라이버 | 육각 홈붙이 볼트 ISO 4762 | M2.5 × 18 | 6 | 무릎 컵 → 허벅지 인서트 | 있음 |
| 드라이버 | 육각 홈붙이 볼트 ISO 4762 | M2.5 × 18 | 6 | 바퀴 컵 → 정강이 인서트 | 있음 |
| 드라이버 | 열압입 인서트 황동 | M2.5 × 4 (구멍 Ø3.6 × 6) | 12 | 허벅지·정강이의 컵 기둥 자리(열압입) | 있음 |
| 몸통 | 접시 볼트 ISO 10642 | M5 × 12 | 4 | hip 판 → 척추 봉 끝 M5 탭 | 있음 |
| 몸통 | 접시 볼트 ISO 10642 | M4 × 12 | 4 | hip 판 → 위 레일 끝 M4 탭 | 있음 |
| 몸통 | 육각 홈붙이 볼트 ISO 4762 | M4 × 25 | 8 | 위판 → 위 레일(관통) | 있음 |
| 몸통 | 나일론 너트 DIN 985 | M4 | 8 | 위 레일 아래 | 있음 |
| 몸통 | 평와셔 DIN 125 A2 | M4 | 8 | 위 레일 아래 나일론 너트 밑 | 있음 |
| 몸통 | 열압입 인서트 황동 | M4 × 5.7 (구멍 Ø5.6) | 35 | 위판 25 mm 격자(짐·로봇팔) | 있음 |
| 몸통 | 육각 홈붙이 볼트 ISO 4762 | M3 × 8 | 4 | 전장 데크 플랜지 → hip 판 M3 탭 | 있음 |
| 몸통 | 버튼 볼트 ISO 7380 | M3 × 8 | 12 | 셸(hip 조각·안장) 안쪽 받침 → hip 판 M3 탭 (11-08) | 있음 |
| 몸통 | 버튼 볼트 ISO 7380 | M3 × 8 | 24 | 셸 앞·뒤 조각 ↔ hip 조각 이음판 12개 | 있음 |
| 몸통 | 육각 너트 DIN 934 | M3 | 24 | 이음판 안쪽 | 있음 |
| 몸통 | 저두 볼트 DIN 7984 | M2.5 × 6 | 4 | power dist r4.5b → 데크 보스 | 있음 |
| 몸통 | 열압입 인서트 황동 | M2.5 × 4 (구멍 Ø3.6) | 8 | 데크 보스(라즈베리파이 4, power dist 4) | 있음 |
| 몸통 | 폼 패드 | 75 × 310 × 1 mm | 1 | 배터리 밑 | 있음 |
| 몸통 | 버튼 볼트 ISO 7380 | M3 × 10 | 4 | 배터리 받침·전장 데크 두 조각의 이음 턱 (조각 이음마다 2) | 있음 |
| 몸통 | 육각 너트 DIN 934 | M3 | 4 | 배터리 받침·전장 데크 이음 턱 (+y 조각 쪽) | 있음 |
| 관절 | 접시 볼트 ISO 10642 12.9 | M3 × 16 | 24 | ⑥ hub 인서트 플랜지(접시, 면과 같게) → 링크 벽 6 → 받침 링 탭(출력 부품, 손으로 가볍게, 혐기성 고정제 쓰지 않음) (hub 인서트마다 6) | 없음 ★ |
| 관절 | 저두 볼트 DIN 7984 8.8 | M2.5 × 8 | 6 | ⑦ 무릎 캡 플랜지 → 허벅지 바깥 막대 인서트 (캡마다 3) | 없음 ★ |
| 관절 | 열압입 인서트 황동 | M2.5 × 4 (구멍 Ø3.6) | 6 | ⑦ 무릎 캡 자리(허벅지 바깥 막대, 구멍 깊이 7) | 없음 ★ |
| 몸통 | 벨크로 스트랩 | 폭 25 × 400 mm | 2 | 배터리 + 받침을 척추 봉에 묶음(받침 슬롯) | 없음 ★ |

①~⑦은 관절 단면도(`manufacturing/explain/hip_section.png`, `knee_section.png`, `wheel_section.png`)의 번호다.

## 5. 배선·커넥터 (모델 없음)

사용자 요청(11-01)으로 배선은 모델에 없다. 연결은 v2 README 8절과 같다: 전원보드 P5 → pi3hat, P3·P6 → 왼·오른 hip → 무릎 → 바퀴(XT30 데이지 체인, 16 AWG), pi3hat JC1 → 왼 다리, JC4 → 오른 다리(11-14 사용자: 두 다리를 pi3hat의 두 프로세서에 나눔), 각 다리 hip → 무릎 → 바퀴(CAN, 바퀴 CAN1에 종단 저항), pi3hat JC3 → power dist CAN1(11-08). CAN은 mjbots 기성 케이블(11-08 사용자 주문), 전원선 길이는 어림이므로 실물에서 재서 자른다. 한 번 깔아 본 v5 다리 경로는 git `5a01c18`(`fusion/harness_v5.py`, 17.5 cm 링크).

| 품목 | 규격 | 필요 | 주문 권장 | 비고 |
|---|---|---|---|---|
| XT30U 플러그 수(M), 16 AWG 납땜형 | 전원 케이블 끝 | 3 | — (동봉) | 전원보드 P5 → pi3hat, P3 → 왼 hip, P6 → 오른 hip: 수-암 케이블 3개의 보드 쪽 끝 (power dist r4.5b에 6개 동봉) |
| XT30U 플러그 암(F), 16 AWG 납땜형 | 전원 케이블 끝 | 11 | 13 | 위 3개의 드라이버 쪽 끝 + hip → 무릎 → 바퀴 암-암 4개(양 끝) |
| 16 AWG 실리콘선 빨강 | 전원 | 약 2.7 m | 5 m | 어림: v2 모델 길이 2.4 m + 링크 25 cm로 다리마다 +0.15 m, 실물에서 재서 자름 |
| 16 AWG 실리콘선 검정 | 전원 | 약 2.7 m | 5 m | 같음 |
| mjbots JST PH3 Cable 30 cm | CAN-FD용 꼬은 3선, 1:1 | 2 | 2 | pi3hat JC1 → 왼 hip, JC4 → 오른 hip (몸통 안) |
| mjbots JST PH3 Cable 50 cm | 같음 | 4 | 4 | hip → 무릎, 무릎 → 바퀴 × 좌우. 25 cm 링크의 다리 경로는 어림 45~55 cm(모델 없음): 실물에 대 보고 모자라면 PHR-3 하우징 + SPH-002T 단자 + 26 AWG 꼬은선으로 직접 만든다 |
| mjbots JST PH3 Cable 10 cm | 같음 | 1 | 1 | pi3hat JC3 → power dist CAN1 (자동 종료·전력 측정) |
| XT90(F) → XT60(M) 변환 케이블 | 12 AWG | 1 | 1 | 배터리 XT60(F) 리드 → power dist XT90(M). 동봉 XT90S 암에 XT60 수를 납땜해 만들어도 된다 |
| 접착식 케이블타이 마운트 | 20 × 20 mm 안팎 | 약 16 | 20 | 링크에 구멍이 없어 다리 배선은 허벅지·정강이 뒷면을 따라 붙인다(git 5a01c18 경로) |
| 케이블타이 | 100 × 2.5 mm | 약 30 | 1봉(100개) | 마운트·다발 묶음 |
| 수축 튜브 | Ø3·Ø6 안팎 | - | 1세트 | XT30 납땜부, 선 끝 |

커넥터 암·수는 실물 보드를 보고 한 번 더 확인한다(moteus·pi3hat은 XT30 수, 전원보드 출력은 암 기준으로 셈).

## 6. 공구·소모품 (이미 있으면 생략)

| 품목 | 쓰는 곳 |
|---|---|
| 핸드 탭 M3 · M4 · M5 + 탭 핸들 | 예전 가공 부품의 탭 구멍(출력 뒤): M3 46(hip 판 · 받침 링), M4 4(레일 끝), M5 4(척추 봉 끝) |
| 드릴 날 Ø2.5 · 3.0 · 3.3 · 4.2 | 탭 전에 출력 구멍 정리(M3 · M4 · M5), hub 인서트 평행핀 구멍 Ø3 |
| 사포 #240~400 · 작은 줄 | 끼움 자리 다듬기: hip 판 Ø42 파일럿, hub 인서트 스피곳·플랜지, 무릎 캡 관, 자석 스페이서 |
| 나사 고정제 (선택) | 모터 금속 탭에 들어가는 ①·② 나사에만 소량. 출력 부품의 나사산(⑥, hip 판·봉·레일 탭)에는 혐기성 고정제(243 등)를 쓰지 않는다 — PLA·PETG가 갈라질 수 있다 |
| 순간접착제 | AKE 부속 자석 → 출력 자석 스페이서 구멍 |
| 열압입 인서트 인두 팁 M2.5 · M3 · M4 | 출력 부품 인서트 97개 |
| JST PH 압착 공구 | mjbots 케이블이 다리 경로에 모자랄 때만: CAN 케이블 단자(SPH-002T) |
| 리머 Ø35 H7 | 허벅지 바깥 막대의 무릎 캡 구멍 2곳(0.2 작게 출력한 뒤) |
| 2.5 mm 육각 볼드라이버, 축 120 mm 이상 | hip·무릎 출력 볼트 ②를 Ø44 접근 구멍 안으로 |
| 육각 렌치 1.5 · 2 · 2.5 · 3 mm | DIN 7984 M2.5(1.5), ISO 4762 M2.5 · 10642 M3 · 7380 M3(2), ISO 4762 M3 · 10642 M4(2.5), ISO 4762 M4 · 10642 M5(3) |
| 스패너 5.5 · 7 mm | M3 너트(셸 이음판, 받침·데크 이음 턱), M4 나일론 너트(위 레일) |

## 7. 주문 전 확인

- **가공 주문은 없다**(11-09 사용자: 모두 3D 출력, PLA 또는 PETG, 강도는 보지 않음). 예전 가공 부품은 출력한 뒤 탭·다듬기가 필요하다(2절).
- **타이어**는 v2 때 이미 주문했다(AliExpress). 받았는지만 확인한다. **배터리**는 가지고 있는 24 V 15 Ah(XT60) 기준이다.
- **hip 판·hub 인서트는 왼·오른쪽이 거울상**이라 STL이 따로 있다(각 1개씩). 받침 링 4개, 무릎 캡 2개는 같은 부품이다.
- v2 도면(S14~S18)은 금속 가공용이고 이름이 v2 기준이다: `v2_hip_plate_L.pdf` = 이 로봇의 `hip_plate_R`(CAD +y). 출력은 STL로 한다.
- 61807은 2RS(고무 실)나 ZZ(금속 실) 어느 쪽이든 폭 7 mm면 맞는다.
- 프린터 베드 300 × 300에 모두 들어간다. 배터리 받침·전장 데크는 두 조각씩 뽑아 M3로 잇는다(3절).
- 금속 → 출력으로 로봇이 약 0.89 kg 가벼워진다(2절). 강도 계산(`calc/strength_v5.md`)과 질량·URDF는 아직 금속 기준이다.
- 남은 설계 결정(README 5절: 정강이 처짐 기준, hip ②·⑥ 검토 하중 초과, 무릎 완전 신장 멈춤)은 부품 목록을 바꾸지 않는다. 기구 멈춤을 넣기로 하면 그때 부품이 늘어난다.
