wisehyun-2/my_robot_project/robot_cad_v5/BOM.csv

묶음 | 품목 | 규격·설명 | 필요 수량 | 주문 권장 | 도번·파일 | 구입처·공정 | 위치·비고 | 모델에 있음
1 구매품 | CubeMars AKE60-8 KV80 | 8:1, 피크 12.5 / 정격 5 N·m, 0.26 kg, Ø69 × 25 | 6 | 6 |  | CubeMars | hip·무릎·바퀴 × 좌우. 부속 자석 Ø6 × 2.5 N38H(엔코더용)를 출력한 자석 스페이서(2절)에 붙여 쓴다 | 있음
1 구매품 | mjbots moteus r4.11 | XT30PW-M ×2, JST PH-3 CAN ×2, 10~44 V | 6 | 6 |  | mjbots | 관절마다 1개, 드라이버 컵 안 | 있음
1 구매품 | Raspberry Pi 4 Model B | 4 GB 이상 | 1 | 1 |  | 라즈베리파이 판매점 | microSD는 이 표 맨 아래 | 있음
1 구매품 | mjbots pi3hat r4.5 | CAN-FD ×5, IMU, 24 V → 5 V, M2.5 × 11 스탠드오프·나사 동봉 | 1 | 1 |  | mjbots | 파이에는 USB-C 전원을 넣지 않는다(pi3hat이 5 V를 만든다) | 있음
1 구매품 | M2.5 × 11 육각 스탠드오프(수-암) | pi3hat 동봉 — 따로 사지 않는다 | 4 | 0 |  | (pi3hat 동봉) | 파이 ↔ pi3hat | 있음
1 구매품 | mjbots power dist r4.5b | XT90 입력, XT30 출력 ×6, 프리차지, CAN-FD(전압·전류·에너지, 소프트 종료), 10~44 V, 80 × 50, 구멍 74 × 44 | 1 | 1 |  | mjbots | 배터리를 파이·pi3hat에 바로 물리지 않는다(11-08 사용자: mjpower-ss 대신, 자동 종료용 CAN). 동봉: XT30U 수 6, XT90S 암 1, PH-4·PH-3 짝 커넥터, 로커 스위치 하네스. CAN1 → pi3hat JC3, 기본 CAN ID 32, 보드에 종단 저항 없음(선이 0.5 m 미만이라 pi3hat 쪽만으로 됨) | 있음
1 구매품 | 배터리 24 V 15 Ah | 75 × 310 × 75 mm, XT60(F) 리드 | 1 | 1 |  | (가지고 있는 배터리) | 새로 살 때는 크기·커넥터가 같은 것 | 있음
1 구매품 | 팬 30 × 30 × 7 mm 5 V | 2핀 | 1 | 1 |  | 전자 부품상 | pi3hat JP6(1번 5 V, 3번 GND), 데크에 1.5 mm 양면 폼테이프 | 있음
1 구매품 | 로커 스위치 19 × 13 + mjbots PH4 스위치 하네스 | power dist J2(PH-4)용, E-Switch R1966 + 30 cm 하네스 | 1 | 0 |  | (power dist r4.5b 동봉) | 11-09: 몸통 **윗면**, 위판 구멍 바로 뒤(무릎 쪽, CAD x +78) 좌우 정중앙의 19 × 13 구멍(셸 가운데 좌우 조각에 반씩, 긴 변 좌우 방향). 하네스 30 cm는 이 자리에서 데크의 power dist J2까지 어림 약 29 cm(모델 없음) — 실물에 대 보고 모자라면 PH-4 연장 | 있음
1 구매품 | CAN-FD 종단 저항 120 Ω (JST PH-3) | 20 × 15 × 10 이하 | 2 | 2 |  | mjbots (또는 120 Ω 저항 + PHR-3로 직접) | 바퀴 드라이버 CAN1(다리 끝). moteus에는 종단 저항이 없고 pi3hat 쪽에는 있다 | 있음
1 구매품 | XT30 보호 캡 | XT30 수 커넥터용 | 2 | 2 |  | 전자 부품상 | 바퀴 드라이버 J2(24 V가 살아 있는 빈 포트) | 있음
1 구매품 | Xiaomi M365 8.5 × 2 (8 1/2 × 2) 통고무 허니콤 타이어 | 외경 202 × 폭 54, 안지름 141 × 안쪽 폭 36.5, 721 g | 2 | 2 |  | AliExpress | 사용자가 이미 주문함(v2 때) — 받았는지 확인 | 있음
1 구매품 | 깊은 홈 볼 베어링 61807 | Ø35 × Ø47 × 7, 2RS 또는 ZZ | 2 | 2 |  | 베어링 판매점 | 정강이 머리 패드 바깥 면 자리(Ø47 압입), 안륜은 무릎 캡 관 | 있음
1 구매품 | microSD 카드 | 32 GB 이상(A1/A2) | 1 | 1 |  | 전자 부품상 | 라즈베리파이 OS | 없음
2 출력(예전 가공) | hip_plate_L | hip 판; PETG 권장(모터 열); 채움 100 %, 안쪽 면(Ø80 컵 받침 턱)을 바닥에 — 턱 밖 웹 밑 1.5 mm만 바닥 서포트; 색 검정 | 1 | 1 | WBv5-S14; export/parts_stl/hip_plate_L.stl | 출력 약 131 g, 정사각 베드 213 mm, 높이 10 mm | 출력 뒤: M3 탭 11(Ø2.5 구멍: 컵 3, 데크 2, 셸 6), Ø42 모터 파일럿 자리를 모터에 맞춰 다듬기. 왼·오른쪽 거울상 = 다른 파일. (예전: 6061-T6 판, 3축 MCT 양면, 검정 아노다이징) | 있음
2 출력(예전 가공) | hip_plate_R | hip 판; PETG 권장(모터 열); 채움 100 %, 안쪽 면(Ø80 컵 받침 턱)을 바닥에 — 턱 밖 웹 밑 1.5 mm만 바닥 서포트; 색 검정 | 1 | 1 | WBv5-S14; export/parts_stl/hip_plate_R.stl | 출력 약 131 g, 정사각 베드 213 mm, 높이 10 mm | 출력 뒤: M3 탭 11(Ø2.5 구멍: 컵 3, 데크 2, 셸 6), Ø42 모터 파일럿 자리를 모터에 맞춰 다듬기. 왼·오른쪽 거울상 = 다른 파일. (예전: 6061-T6 판, 3축 MCT 양면, 검정 아노다이징) | 있음
2 출력(예전 가공) | spine_tube_F | 척추 봉 Ø16 × 328; PLA 또는 PETG; 채움 100 %, 눕혀 대각선으로, 둥근 아래쪽은 바닥 서포트; 색 검정 | 1 | 1 | WBv5-S15; export/parts_stl/spine_tube_F.stl | 출력 약 83 g, 정사각 베드 243 mm, 높이 16 mm | 출력 뒤: 양 끝 M5 탭 깊이 11(Ø4.2 구멍, 눕혀 뽑은 구멍이라 드릴로 정리 후 탭). 길이 328을 레일과 같게(길면 끝면을 사포로). (예전: 6061-T6 환봉, 길이 328.00 ±0.05) | 있음
2 출력(예전 가공) | spine_tube_B | 척추 봉 Ø16 × 328; PLA 또는 PETG; 채움 100 %, 눕혀 대각선으로, 둥근 아래쪽은 바닥 서포트; 색 검정 | 1 | 1 | WBv5-S15; export/parts_stl/spine_tube_B.stl | 출력 약 83 g, 정사각 베드 243 mm, 높이 16 mm | 출력 뒤: 양 끝 M5 탭 깊이 11(Ø4.2 구멍, 눕혀 뽑은 구멍이라 드릴로 정리 후 탭). 길이 328을 레일과 같게(길면 끝면을 사포로). (예전: 6061-T6 환봉, 길이 328.00 ±0.05) | 있음
2 출력(예전 가공) | rail_F | 위 레일 15 × 15 × 328; PLA 또는 PETG; 채움 100 %, Ø4.4 관통 구멍이 위아래로 서게 옆면을 바닥에, 대각선으로 — 서포트 없음; 색 검정 | 1 | 1 | WBv5-S16; export/parts_stl/rail_F.stl | 출력 약 92 g, 정사각 베드 243 mm, 높이 15 mm | 출력 뒤: 양 끝 M4 탭 깊이 9(Ø3.3 구멍). 길이 328을 척추 봉과 같게. (예전: 6061-T6 각봉, 길이 328.00 ±0.05) | 있음
2 출력(예전 가공) | rail_B | 위 레일 15 × 15 × 328; PLA 또는 PETG; 채움 100 %, Ø4.4 관통 구멍이 위아래로 서게 옆면을 바닥에, 대각선으로 — 서포트 없음; 색 검정 | 1 | 1 | WBv5-S16; export/parts_stl/rail_B.stl | 출력 약 92 g, 정사각 베드 243 mm, 높이 15 mm | 출력 뒤: 양 끝 M4 탭 깊이 9(Ø3.3 구멍). 길이 328을 척추 봉과 같게. (예전: 6061-T6 각봉, 길이 328.00 ±0.05) | 있음
2 출력(예전 가공) | clamp_ring_stator_D45_t2.0_SUS304 | 고정자 클램프 링 Ø45 × 2; PETG 권장(모터 열); 채움 100 %, 평평하게; 색 검정 | 4 | 4 | WBv5-S17; export/parts_stl/clamp_ring_stator_D45_t2.0_SUS304.stl | 출력 약 9 g, 정사각 베드 45 mm, 높이 2 mm | 출력 뒤: 없음. 작고 얇아 여분 2개를 더 뽑는다. (예전: SUS304 2t 레이저) | 있음
2 출력(예전 가공) | magnet_spacer_D9x5.35_(6061)__spacer | 자석 스페이서 Ø9 × 5.35; PETG 권장(모터 열); 채움 100 %, 자석 구멍 쪽을 바닥에 스피곳을 위로, 층 0.1 mm 권장; 색 검정 | 6 | 6 | WBv5-S18; export/parts_stl/magnet_spacer_D9x5.35_(6061)__spacer.stl | 출력 약 2 g, 정사각 베드 9 mm, 높이 8 mm | 출력 뒤: AKE 부속 자석 Ø6 × 2.5를 구멍에 순간접착, Ø5.9 스피곳을 끼울 자리에 맞춰 다듬기. 작아서 여분 2개를 더 뽑는다(출력이라 비자성 조건은 저절로 맞음). (예전: 6061(비자성) 선반) | 있음
2 출력(예전 가공) | hub_insert_hip_L | hip hub 인서트; PETG 권장(모터 열); 채움 100 %, 플랜지 바깥 면(접시 구멍 쪽, 평평)을 바닥에, 보스·스피곳을 위로 — 서포트 없음; 색 검정 | 1 | 1 | WBv5-M01; export/parts_stl/hub_insert_hip_L.stl | 출력 약 18 g, 정사각 베드 48 mm, 높이 18 mm | 출력 뒤: 평행핀 구멍 Ø3 × 7.5에 Ø3 드릴 → 핀 압입, Ø11.8 스피곳을 모터 출력부 Ø12 홈에, Ø48 플랜지를 링크 자리 Ø48.3에 맞춰 다듬기. 왼·오른쪽 거울상 = 다른 파일. (예전: 6061-T6 환봉 선반 + MCT, 아노다이징 권장) | 있음
2 출력(예전 가공) | hub_insert_hip_R | hip hub 인서트; PETG 권장(모터 열); 채움 100 %, 플랜지 바깥 면(접시 구멍 쪽, 평평)을 바닥에, 보스·스피곳을 위로 — 서포트 없음; 색 검정 | 1 | 1 | WBv5-M01; export/parts_stl/hub_insert_hip_R.stl | 출력 약 18 g, 정사각 베드 48 mm, 높이 18 mm | 출력 뒤: 평행핀 구멍 Ø3 × 7.5에 Ø3 드릴 → 핀 압입, Ø11.8 스피곳을 모터 출력부 Ø12 홈에, Ø48 플랜지를 링크 자리 Ø48.3에 맞춰 다듬기. 왼·오른쪽 거울상 = 다른 파일. (예전: 6061-T6 환봉 선반 + MCT, 아노다이징 권장) | 있음
2 출력(예전 가공) | hub_insert_knee_L | 무릎 hub 인서트; PETG 권장(모터 열); 채움 100 %, hip hub 인서트와 같게 플랜지 바깥 면을 바닥에 — 서포트 없음; 색 검정 | 1 | 1 | WBv5-M02; export/parts_stl/hub_insert_knee_L.stl | 출력 약 18 g, 정사각 베드 48 mm, 높이 17 mm | 출력 뒤: hip hub 인서트와 같음(보스 길이만 다름). 왼·오른쪽 거울상 = 다른 파일. (예전: 6061-T6 환봉 선반 + MCT, 아노다이징 권장) | 있음
2 출력(예전 가공) | hub_insert_knee_R | 무릎 hub 인서트; PETG 권장(모터 열); 채움 100 %, hip hub 인서트와 같게 플랜지 바깥 면을 바닥에 — 서포트 없음; 색 검정 | 1 | 1 | WBv5-M02; export/parts_stl/hub_insert_knee_R.stl | 출력 약 18 g, 정사각 베드 48 mm, 높이 17 mm | 출력 뒤: hip hub 인서트와 같음(보스 길이만 다름). 왼·오른쪽 거울상 = 다른 파일. (예전: 6061-T6 환봉 선반 + MCT, 아노다이징 권장) | 있음
2 출력(예전 가공) | knee_cap_L | 무릎 캡; PLA 또는 PETG; 채움 100 %, 플랜지를 바닥에 관을 위로 — 서포트 없음; 색 검정 | 1 | 1 | WBv5-M03; export/parts_stl/knee_cap_L.stl | 출력 약 20 g, 정사각 베드 46 mm, 높이 42 mm | 출력 뒤: Ø35 관을 61807 안륜·허벅지 바깥 막대 구멍에 꼭 맞게 사포로. 왼·오른쪽 같은 부품. (예전: 6061-T6 환봉 선반 + 드릴, 아노다이징 권장) | 있음
2 출력(예전 가공) | knee_cap_R | 무릎 캡; PLA 또는 PETG; 채움 100 %, 플랜지를 바닥에 관을 위로 — 서포트 없음; 색 검정 | 1 | 1 | WBv5-M03; export/parts_stl/knee_cap_R.stl | 출력 약 20 g, 정사각 베드 46 mm, 높이 42 mm | 출력 뒤: Ø35 관을 61807 안륜·허벅지 바깥 막대 구멍에 꼭 맞게 사포로. 왼·오른쪽 같은 부품. (예전: 6061-T6 환봉 선반 + 드릴, 아노다이징 권장) | 있음
2 출력(예전 가공) | hub_ring_hip_L | 받침 링 Ø43 / Ø29 × 6; PETG 권장(모터 열); 채움 100 %, 평평하게; 색 검정 | 1 | 1 | WBv5-M04; export/parts_stl/hub_ring_hip_L.stl | 출력 약 6 g, 정사각 베드 43 mm, 높이 6 mm | 출력 뒤: M3 탭 관통 6(Ø2.5 구멍). hip·무릎 × 왼·오른쪽 모두 같은 부품 — 한 파일로 4개를 뽑아도 된다. (예전: 6061-T6 환봉 선반, M3 탭 관통 6) | 있음
2 출력(예전 가공) | hub_ring_hip_R | 받침 링 Ø43 / Ø29 × 6; PETG 권장(모터 열); 채움 100 %, 평평하게; 색 검정 | 1 | 1 | WBv5-M04; export/parts_stl/hub_ring_hip_R.stl | 출력 약 6 g, 정사각 베드 43 mm, 높이 6 mm | 출력 뒤: M3 탭 관통 6(Ø2.5 구멍). hip·무릎 × 왼·오른쪽 모두 같은 부품 — 한 파일로 4개를 뽑아도 된다. (예전: 6061-T6 환봉 선반, M3 탭 관통 6) | 있음
2 출력(예전 가공) | hub_ring_knee_L | 받침 링 Ø43 / Ø29 × 6; PETG 권장(모터 열); 채움 100 %, 평평하게; 색 검정 | 1 | 1 | WBv5-M04; export/parts_stl/hub_ring_knee_L.stl | 출력 약 6 g, 정사각 베드 43 mm, 높이 6 mm | 출력 뒤: M3 탭 관통 6(Ø2.5 구멍). hip·무릎 × 왼·오른쪽 모두 같은 부품 — 한 파일로 4개를 뽑아도 된다. (예전: 6061-T6 환봉 선반, M3 탭 관통 6) | 있음
2 출력(예전 가공) | hub_ring_knee_R | 받침 링 Ø43 / Ø29 × 6; PETG 권장(모터 열); 채움 100 %, 평평하게; 색 검정 | 1 | 1 | WBv5-M04; export/parts_stl/hub_ring_knee_R.stl | 출력 약 6 g, 정사각 베드 43 mm, 높이 6 mm | 출력 뒤: M3 탭 관통 6(Ø2.5 구멍). hip·무릎 × 왼·오른쪽 모두 같은 부품 — 한 파일로 4개를 뽑아도 된다. (예전: 6061-T6 환봉 선반, M3 탭 관통 6) | 있음
3 출력 | thigh_L | 허벅지; PETG 권장(모터 열); FDM 한 덩어리: 벽 3.5 둘레선, 채움 100 %, 닫힌 칸(배출 구멍 없음), 바깥 면(평평, y 288.5)을 바닥에 — 갈래 틈 안 서포트; 색 검정 | 1 | 1 | WBv5-P01; export/parts_stl/thigh_L.stl | 출력 약 827 g, 정사각 베드 259 mm, 높이 114 mm | 열압입 M2.5 인서트 6(컵 3 + 무릎 캡 3), 캡 관 구멍 Ø35 H7은 0.2 작게 뽑고 리머 | 있음
3 출력 | thigh_R | 허벅지; PETG 권장(모터 열); FDM 한 덩어리: 벽 3.5 둘레선, 채움 100 %, 닫힌 칸(배출 구멍 없음), 바깥 면(평평, y 288.5)을 바닥에 — 갈래 틈 안 서포트; 색 검정 | 1 | 1 | WBv5-P01; export/parts_stl/thigh_R.stl | 출력 약 827 g, 정사각 베드 259 mm, 높이 114 mm | 열압입 M2.5 인서트 6(컵 3 + 무릎 캡 3), 캡 관 구멍 Ø35 H7은 0.2 작게 뽑고 리머 | 있음
3 출력 | shank_L | 정강이; PETG 권장(모터 열); FDM 한 덩어리: 벽 3.5 둘레선, 채움 100 %, 닫힌 칸(배출 구멍 없음), 안쪽 면(평평, y 208)을 바닥에 — 바퀴 모터 칸 Ø74 안 서포트; 색 검정 | 1 | 1 | WBv5-P02; export/parts_stl/shank_L.stl | 출력 약 420 g, 정사각 베드 266 mm, 높이 45 mm | 열압입 M2.5 인서트 3(바퀴 컵), 61807 자리 Ø47 압입 | 있음
3 출력 | shank_R | 정강이; PETG 권장(모터 열); FDM 한 덩어리: 벽 3.5 둘레선, 채움 100 %, 닫힌 칸(배출 구멍 없음), 안쪽 면(평평, y 208)을 바닥에 — 바퀴 모터 칸 Ø74 안 서포트; 색 검정 | 1 | 1 | WBv5-P02; export/parts_stl/shank_R.stl | 출력 약 420 g, 정사각 베드 266 mm, 높이 45 mm | 열압입 M2.5 인서트 3(바퀴 컵), 61807 자리 Ø47 압입 | 있음
3 출력 | cup_hip_L | hip 드라이버 컵; PETG 권장(모터 열); 채움 30 %, 바닥(덮개 면)을 바닥에, 서포트는 커넥터 창만; 색 검정 | 1 | 1 | WBv5-S01; export/parts_stl/cup_hip_L.stl | 출력 약 48 g, 정사각 베드 87 mm, 높이 40 mm | 열압입 M2.5 인서트 4 | 있음
3 출력 | cup_hip_R | hip 드라이버 컵; PETG 권장(모터 열); 채움 30 %, 바닥(덮개 면)을 바닥에, 서포트는 커넥터 창만; 색 검정 | 1 | 1 | WBv5-S01; export/parts_stl/cup_hip_R.stl | 출력 약 48 g, 정사각 베드 87 mm, 높이 40 mm | 열압입 M2.5 인서트 4 | 있음
3 출력 | cup_knee_L | 무릎 드라이버 컵; PETG 권장(모터 열); 채움 30 %, 바닥을 바닥에, 서포트는 커넥터 창만; 색 검정 | 1 | 1 | WBv5-S02; export/parts_stl/cup_knee_L.stl | 출력 약 34 g, 정사각 베드 93 mm, 높이 22 mm | 열압입 M2.5 인서트 4 | 있음
3 출력 | cup_knee_R | 무릎 드라이버 컵; PETG 권장(모터 열); 채움 30 %, 바닥을 바닥에, 서포트는 커넥터 창만; 색 검정 | 1 | 1 | WBv5-S02; export/parts_stl/cup_knee_R.stl | 출력 약 34 g, 정사각 베드 93 mm, 높이 22 mm | 열압입 M2.5 인서트 4 | 있음
3 출력 | cup_wheel_L | 바퀴 드라이버 컵; PETG 권장(모터 열); 채움 30 %, 바닥을 바닥에, 서포트는 커넥터 창만; 색 검정 | 1 | 1 | WBv5-S03; export/parts_stl/cup_wheel_L.stl | 출력 약 34 g, 정사각 베드 93 mm, 높이 22 mm | 열압입 M2.5 인서트 4 | 있음
3 출력 | cup_wheel_R | 바퀴 드라이버 컵; PETG 권장(모터 열); 채움 30 %, 바닥을 바닥에, 서포트는 커넥터 창만; 색 검정 | 1 | 1 | WBv5-S03; export/parts_stl/cup_wheel_R.stl | 출력 약 34 g, 정사각 베드 93 mm, 높이 22 mm | 열압입 M2.5 인서트 4 | 있음
3 출력 | hub_flange_L | 바퀴 허브 플랜지; PETG 권장(모터 열); 채움 100 %, 모터 쪽 면을 바닥에; 색 검정 | 1 | 1 | WBv5-S04; export/parts_stl/hub_flange_L.stl | 출력 약 20 g, 정사각 베드 46 mm, 높이 19 mm | 열압입 M3 인서트 6 | 있음
3 출력 | hub_flange_R | 바퀴 허브 플랜지; PETG 권장(모터 열); 채움 100 %, 모터 쪽 면을 바닥에; 색 검정 | 1 | 1 | WBv5-S04; export/parts_stl/hub_flange_R.stl | 출력 약 20 g, 정사각 베드 46 mm, 높이 19 mm | 열압입 M3 인서트 6 | 있음
3 출력 | rim_L | 바퀴 림(한 조각); PLA 또는 PETG; 벽 6겹(2.4 mm) · 채움 40 %, 허브 쪽 평면을 바닥에, 열린 쪽 플랜지 밑 4.5 mm 턱만 서포트; 색 검정 | 1 | 1 | WBv5-S05; export/parts_stl/rim_L.stl | 출력 약 278 g, 정사각 베드 150 mm, 높이 44 mm |  | 있음
3 출력 | rim_R | 바퀴 림(한 조각); PLA 또는 PETG; 벽 6겹(2.4 mm) · 채움 40 %, 허브 쪽 평면을 바닥에, 열린 쪽 플랜지 밑 4.5 mm 턱만 서포트; 색 검정 | 1 | 1 | WBv5-S05; export/parts_stl/rim_R.stl | 출력 약 278 g, 정사각 베드 150 mm, 높이 44 mm |  | 있음
3 출력 | shell_front_L | 몸통 셸 앞(스위치 쪽); PLA 또는 PETG; 채움 25 %, 바깥 면을 위로(서포트 필요); 색 진회색 | 1 | 1 | WBv5-S06; export/parts_stl/shell_front_L.stl | 출력 약 132 g, 정사각 베드 187 mm, 높이 135 mm | v4와 달리 세로 모서리 R30, 앞면 스위치 구멍 없음(11-09) | 있음
3 출력 | shell_front_R | 몸통 셸 앞(스위치 쪽); PLA 또는 PETG; 채움 25 %, 바깥 면을 위로(서포트 필요); 색 진회색 | 1 | 1 | WBv5-S06; export/parts_stl/shell_front_R.stl | 출력 약 132 g, 정사각 베드 187 mm, 높이 135 mm | v4와 달리 세로 모서리 R30, 앞면 스위치 구멍 없음(11-09) | 있음
3 출력 | shell_mid_L | 몸통 셸 가운데(hip); PLA 또는 PETG; 채움 25 %, 바깥 면을 위로(서포트 필요); 색 진회색 | 1 | 1 | WBv5-S07; export/parts_stl/shell_mid_L.stl | 출력 약 145 g, 정사각 베드 218 mm, 높이 172 mm | 윗면 위판 뒤 좌우 정중앙의 스위치 구멍 19 × 13을 좌우 조각이 반씩 나눔(11-09). 옆면 Ø16 hip 케이블 구멍은 그로밋 없이 씀 | 있음
3 출력 | shell_mid_R | 몸통 셸 가운데(hip); PLA 또는 PETG; 채움 25 %, 바깥 면을 위로(서포트 필요); 색 진회색 | 1 | 1 | WBv5-S07; export/parts_stl/shell_mid_R.stl | 출력 약 145 g, 정사각 베드 218 mm, 높이 172 mm | 윗면 위판 뒤 좌우 정중앙의 스위치 구멍 19 × 13을 좌우 조각이 반씩 나눔(11-09). 옆면 Ø16 hip 케이블 구멍은 그로밋 없이 씀 | 있음
3 출력 | shell_rear_L | 몸통 셸 뒤(무릎 쪽); PLA 또는 PETG; 채움 25 %, 바깥 면을 위로(서포트 필요); 색 진회색 | 1 | 1 | WBv5-S08; export/parts_stl/shell_rear_L.stl | 출력 약 126 g, 정사각 베드 206 mm, 높이 135 mm |  | 있음
3 출력 | shell_rear_R | 몸통 셸 뒤(무릎 쪽); PLA 또는 PETG; 채움 25 %, 바깥 면을 위로(서포트 필요); 색 진회색 | 1 | 1 | WBv5-S08; export/parts_stl/shell_rear_R.stl | 출력 약 126 g, 정사각 베드 206 mm, 높이 135 mm |  | 있음
3 출력 | saddle_L | hip 위 안장; PLA 또는 PETG; 채움 25 %; 색 파랑 | 1 | 1 | WBv5-S09; export/parts_stl/saddle_L.stl | 출력 약 32 g, 정사각 베드 169 mm, 높이 37 mm |  | 있음
3 출력 | saddle_R | hip 위 안장; PLA 또는 PETG; 채움 25 %; 색 파랑 | 1 | 1 | WBv5-S09; export/parts_stl/saddle_R.stl | 출력 약 32 g, 정사각 베드 169 mm, 높이 37 mm |  | 있음
3 출력 | top_plate | 위판(짐 판); PLA 또는 PETG; 채움 25 %; 색 검정 | 1 | 1 | WBv5-S10; export/parts_stl/top_plate.stl | 출력 약 132 g, 정사각 베드 210 mm, 높이 6 mm | 열압입 M4 인서트 35 | 있음
3 출력 | battery_tray_L | 배터리 받침(두 조각); PLA 또는 PETG; 채움 30 %, 긴 옆면(159 × 28)을 바닥에 세워서 — 배터리 옆 턱 2줄(14 mm) 밑만 서포트(눕히면 바닥 판 밑 전체에 서포트); 색 진회색 | 1 | 1 | WBv5-S11; export/parts_stl/battery_tray_L.stl | 출력 약 82 g, 정사각 베드 127 mm, 높이 112 mm | 11-09 두 조각: 가운데(리브 자리)의 이음 턱끼리 M3 × 10 버튼 볼트 + 너트 2쌍(3절 끝). _L·_R은 다른 파일(리드선 홈은 _R 끝) | 있음
3 출력 | battery_tray_R | 배터리 받침(두 조각); PLA 또는 PETG; 채움 30 %, 긴 옆면(159 × 28)을 바닥에 세워서 — 배터리 옆 턱 2줄(14 mm) 밑만 서포트(눕히면 바닥 판 밑 전체에 서포트); 색 진회색 | 1 | 1 | WBv5-S11; export/parts_stl/battery_tray_R.stl | 출력 약 81 g, 정사각 베드 127 mm, 높이 112 mm | 11-09 두 조각: 가운데(리브 자리)의 이음 턱끼리 M3 × 10 버튼 볼트 + 너트 2쌍(3절 끝). _L·_R은 다른 파일(리드선 홈은 _R 끝) | 있음
3 출력 | electronics_deck_L | 전장 데크(두 조각); PLA 또는 PETG; 채움 30 %, 놓인 그대로(보스·끝 플랜지를 위로) — 바닥 판·리브 밑 서포트; 색 진회색 | 1 | 1 | WBv5-S12; export/parts_stl/electronics_deck_L.stl | 출력 약 80 g, 정사각 베드 244 mm, 높이 32 mm | 11-09 두 조각: y 80(라즈베리파이와 끝 창 사이) 이음 턱끼리 M3 × 10 + 너트 2쌍(3절 끝). 열압입 M2.5 인서트 8은 모두 _L(파이·전원보드 쪽) | 있음
3 출력 | electronics_deck_R | 전장 데크(두 조각); PLA 또는 PETG; 채움 30 %, 놓인 그대로(보스·끝 플랜지를 위로) — 바닥 판·리브 밑 서포트; 색 진회색 | 1 | 1 | WBv5-S12; export/parts_stl/electronics_deck_R.stl | 출력 약 26 g, 정사각 베드 110 mm, 높이 32 mm | 11-09 두 조각: y 80(라즈베리파이와 끝 창 사이) 이음 턱끼리 M3 × 10 + 너트 2쌍(3절 끝). 열압입 M2.5 인서트 8은 모두 _L(파이·전원보드 쪽) | 있음
3 출력 | splice_tabs | 셸 이음판 12개(한 파일); PLA 또는 PETG; 채움 100 %; 색 진회색 | 1 | 1 | WBv5-S13; export/parts_stl/splice_tabs.stl | 출력 약 10 g, 정사각 베드 247 mm, 높이 206 mm | 12개가 로봇 위치 그대로 한 파일에 있다 — 슬라이서에서 나눠 놓는다(베드 값은 무시) | 있음
4 체결(주문 합계) | 나일론 너트 DIN 985 | M4 | 8 | 10 |  |  | 위 레일 아래 × 8 | 있음
4 체결(주문 합계) | 버튼 볼트 ISO 7380 | M3 × 10 | 4 | 6 |  |  | 배터리 받침·전장 데크 두 조각의 이음 턱 (조각 이음마다 2) × 4 | 있음
4 체결(주문 합계) | 버튼 볼트 ISO 7380 | M3 × 8 | 36 | 40 |  |  | 셸(hip 조각·안장) 안쪽 받침 → hip 판 M3 탭 (11-08) × 12; 셸 앞·뒤 조각 ↔ hip 조각 이음판 12개 × 24 | 있음
4 체결(주문 합계) | 벨크로 스트랩 | 폭 25 × 400 mm | 2 | 2 |  |  | 배터리 + 받침을 척추 봉에 묶음(받침 슬롯) × 2 | ★ 일부 없음
4 체결(주문 합계) | 열압입 인서트 황동 | M2.5 × 4 (구멍 Ø3.6) | 50 | 60 |  |  | 드라이버 컵 스탠드오프 × 24; 허벅지·정강이의 컵 기둥 자리(열압입) × 12; 데크 보스(라즈베리파이 4, power dist 4) × 8; ⑦ 무릎 캡 자리(허벅지 바깥 막대, 구멍 깊이 7) × 6 | ★ 일부 없음
4 체결(주문 합계) | 열압입 인서트 황동 | M3 × 5.7 (구멍 Ø4.0) | 12 | 16 |  |  | 허브 플랜지 × 12 | 있음
4 체결(주문 합계) | 열압입 인서트 황동 | M4 × 5.7 (구멍 Ø5.6) | 35 | 42 |  |  | 위판 25 mm 격자(짐·로봇팔) × 35 | 있음
4 체결(주문 합계) | 육각 너트 DIN 934 | M3 | 28 | 31 |  |  | 이음판 안쪽 × 24; 배터리 받침·전장 데크 이음 턱 (+y 조각 쪽) × 4 | 있음
4 체결(주문 합계) | 육각 홈붙이 볼트 ISO 4762 | M2.5 × 18 | 12 | 14 |  |  | 무릎 컵 → 허벅지 인서트 × 6; 바퀴 컵 → 정강이 인서트 × 6 | 있음
4 체결(주문 합계) | 육각 홈붙이 볼트 ISO 4762 | M3 × 40 | 6 | 8 |  |  | hip 컵 → hip 판 M3 탭 × 6 | 있음
4 체결(주문 합계) | 육각 홈붙이 볼트 ISO 4762 | M3 × 8 | 4 | 6 |  |  | 전장 데크 플랜지 → hip 판 M3 탭 × 4 | 있음
4 체결(주문 합계) | 육각 홈붙이 볼트 ISO 4762 | M4 × 25 | 8 | 10 |  |  | 위판 → 위 레일(관통) × 8 | 있음
4 체결(주문 합계) | 육각 홈붙이 볼트 ISO 4762 12.9 | M2.5 × 6 | 12 | 14 |  |  | hip 고정자 링 → hip 판 ① × 12 | 있음
4 체결(주문 합계) | 육각 홈붙이 볼트 ISO 4762 12.9 | M3 × 14 | 12 | 14 |  |  | 바퀴 모터 출력 → 허브 플랜지 (와셔 위) × 12 | 있음
4 체결(주문 합계) | 육각 홈붙이 볼트 ISO 4762 12.9 | M3 × 16 | 24 | 27 |  |  | hip·무릎 모터 출력 → hub 인서트 ② (와셔 위) × 24 | 있음
4 체결(주문 합계) | 육각 홈붙이 볼트 ISO 4762 8.8 | M3 × 14 | 12 | 14 |  |  | 림 → 허브 플랜지 인서트 (와셔 위) × 12 | 있음
4 체결(주문 합계) | 저두 볼트 DIN 7984 | M2.5 × 5 | 24 | 27 |  |  | moteus → 컵 스탠드오프 (끝이 4 mm 인서트 안, 11-08) × 24 | 있음
4 체결(주문 합계) | 저두 볼트 DIN 7984 | M2.5 × 6 | 4 | 6 |  |  | power dist r4.5b → 데크 보스 × 4 | 있음
4 체결(주문 합계) | 저두 볼트 DIN 7984 8.8 | M2.5 × 8 | 30 | 33 |  |  | 무릎·바퀴 고정자 링 → 링크 모터 판, 클램프 링 위 ① × 24; ⑦ 무릎 캡 플랜지 → 허벅지 바깥 막대 인서트 (캡마다 3) × 6 | ★ 일부 없음
4 체결(주문 합계) | 접시 볼트 ISO 10642 | M4 × 12 | 4 | 6 |  |  | hip 판 → 위 레일 끝 M4 탭 × 4 | 있음
4 체결(주문 합계) | 접시 볼트 ISO 10642 | M5 × 12 | 4 | 6 |  |  | hip 판 → 척추 봉 끝 M5 탭 × 4 | 있음
4 체결(주문 합계) | 접시 볼트 ISO 10642 12.9 | M3 × 16 | 24 | 27 |  |  | ⑥ hub 인서트 플랜지(접시, 면과 같게) → 링크 벽 6 → 받침 링 탭(출력 부품, 손으로 가볍게, 혐기성 고정제 쓰지 않음) (hub 인서트마다 6) × 24 | ★ 일부 없음
4 체결(주문 합계) | 평와셔 DIN 125 A2 | M3 | 48 | 53 |  |  | ② M3 × 16, 허브 M3 × 14, 림 M3 × 14 머리 밑 × 48 | 있음
4 체결(주문 합계) | 평와셔 DIN 125 A2 | M4 | 8 | 10 |  |  | 위 레일 아래 나일론 너트 밑 × 8 | 있음
4 체결(주문 합계) | 평행 핀 ISO 8734 m6 경화 | Ø3 × 10 | 18 | 21 |  |  | 출력 다웰 ③: hub 인서트 12 (Ø3 압입) + 바퀴 허브 플랜지 6 × 18 | 있음
4 체결(주문 합계) | 폼 패드 | 75 × 310 × 1 mm | 1 | 1 |  |  | 배터리 밑 × 1 | 있음
5 배선 | XT30U 플러그 수(M), 16 AWG 납땜형 | 전원 케이블 끝 | 3 | — (동봉) |  |  | 전원보드 P5 → pi3hat, P3 → 왼 hip, P6 → 오른 hip: 수-암 케이블 3개의 보드 쪽 끝 (power dist r4.5b에 6개 동봉) | 없음
5 배선 | XT30U 플러그 암(F), 16 AWG 납땜형 | 전원 케이블 끝 | 11 | 13 |  |  | 위 3개의 드라이버 쪽 끝 + hip → 무릎 → 바퀴 암-암 4개(양 끝) | 없음
5 배선 | 16 AWG 실리콘선 빨강 | 전원 | 약 2.7 m | 5 m |  |  | 어림: v2 모델 길이 2.4 m + 링크 25 cm로 다리마다 +0.15 m, 실물에서 재서 자름 | 없음
5 배선 | 16 AWG 실리콘선 검정 | 전원 | 약 2.7 m | 5 m |  |  | 같음 | 없음
5 배선 | mjbots JST PH3 Cable 30 cm | CAN-FD용 꼬은 3선, 1:1 | 2 | 2 |  |  | pi3hat JC1 → 왼 hip, JC4 → 오른 hip (몸통 안) | 없음
5 배선 | mjbots JST PH3 Cable 50 cm | 같음 | 4 | 4 |  |  | hip → 무릎, 무릎 → 바퀴 × 좌우. 25 cm 링크의 다리 경로는 어림 45~55 cm(모델 없음): 실물에 대 보고 모자라면 PHR-3 하우징 + SPH-002T 단자 + 26 AWG 꼬은선으로 직접 만든다 | 없음
5 배선 | mjbots JST PH3 Cable 10 cm | 같음 | 1 | 1 |  |  | pi3hat JC3 → power dist CAN1 (자동 종료·전력 측정) | 없음
5 배선 | XT90(F) → XT60(M) 변환 케이블 | 12 AWG | 1 | 1 |  |  | 배터리 XT60(F) 리드 → power dist XT90(M). 동봉 XT90S 암에 XT60 수를 납땜해 만들어도 된다 | 없음
5 배선 | 접착식 케이블타이 마운트 | 20 × 20 mm 안팎 | 약 16 | 20 |  |  | 링크에 구멍이 없어 다리 배선은 허벅지·정강이 뒷면을 따라 붙인다(git 5a01c18 경로) | 없음
5 배선 | 케이블타이 | 100 × 2.5 mm | 약 30 | 1봉(100개) |  |  | 마운트·다발 묶음 | 없음
5 배선 | 수축 튜브 | Ø3·Ø6 안팎 | - | 1세트 |  |  | XT30 납땜부, 선 끝 | 없음
6 공구·소모품 | 핸드 탭 M3 · M4 · M5 + 탭 핸들 |  |  |  |  |  | 예전 가공 부품의 탭 구멍(출력 뒤): M3 46(hip 판 · 받침 링), M4 4(레일 끝), M5 4(척추 봉 끝) | 없음
6 공구·소모품 | 드릴 날 Ø2.5 · 3.0 · 3.3 · 4.2 |  |  |  |  |  | 탭 전에 출력 구멍 정리(M3 · M4 · M5), hub 인서트 평행핀 구멍 Ø3 | 없음
6 공구·소모품 | 사포 #240~400 · 작은 줄 |  |  |  |  |  | 끼움 자리 다듬기: hip 판 Ø42 파일럿, hub 인서트 스피곳·플랜지, 무릎 캡 관, 자석 스페이서 | 없음
6 공구·소모품 | 나사 고정제 (선택) |  |  |  |  |  | 모터 금속 탭에 들어가는 ①·② 나사에만 소량. 출력 부품의 나사산(⑥, hip 판·봉·레일 탭)에는 혐기성 고정제(243 등)를 쓰지 않는다 — PLA·PETG가 갈라질 수 있다 | 없음
6 공구·소모품 | 순간접착제 |  |  |  |  |  | AKE 부속 자석 → 출력 자석 스페이서 구멍 | 없음
6 공구·소모품 | 열압입 인서트 인두 팁 M2.5 · M3 · M4 |  |  |  |  |  | 출력 부품 인서트 97개 | 없음
6 공구·소모품 | JST PH 압착 공구 |  |  |  |  |  | mjbots 케이블이 다리 경로에 모자랄 때만: CAN 케이블 단자(SPH-002T) | 없음
6 공구·소모품 | 리머 Ø35 H7 |  |  |  |  |  | 허벅지 바깥 막대의 무릎 캡 구멍 2곳(0.2 작게 출력한 뒤) | 없음
6 공구·소모품 | 2.5 mm 육각 볼드라이버, 축 120 mm 이상 |  |  |  |  |  | hip·무릎 출력 볼트 ②를 Ø44 접근 구멍 안으로 | 없음
6 공구·소모품 | 육각 렌치 1.5 · 2 · 2.5 · 3 mm |  |  |  |  |  | DIN 7984 M2.5(1.5), ISO 4762 M2.5 · 10642 M3 · 7380 M3(2), ISO 4762 M3 · 10642 M4(2.5), ISO 4762 M4 · 10642 M5(3) | 없음
6 공구·소모품 | 스패너 5.5 · 7 mm |  |  |  |  |  | M3 너트(셸 이음판, 받침·데크 이음 턱), M4 나일론 너트(위 레일) | 없음
