wisehyun-2/my_robot_project/robot_cad_v5/export/WheelBiped_v5_assembly.step

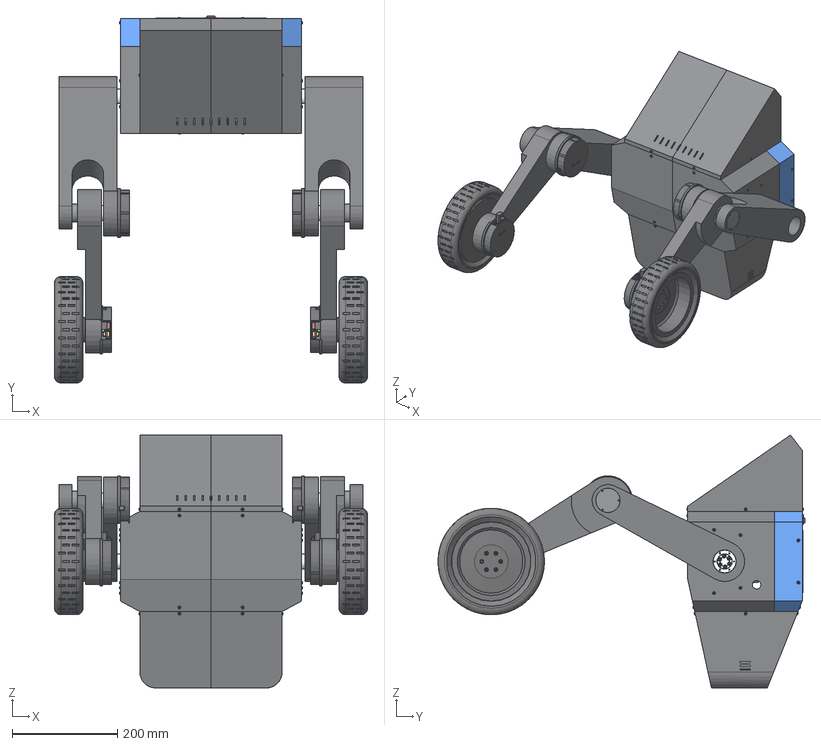
[picture p30: CAD file, 2026-11-09]
robot_cad_v5/export/WheelBiped_v5_assembly.step
594.0 x 696.4 x 480.0 mm
AKE60-8-KV80 x 6
moteus controller x 6
pi3hat
power_dist r4
AKE60-8-KV80_1 x 6
