wisehyun-2/my_robot_project/robot_cad_v5/export/links_stl/wheel_L.stl

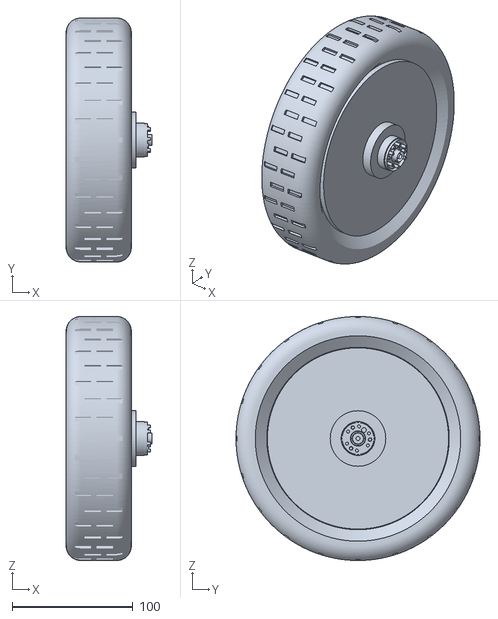
[picture p31: CAD file, 2026-11-07]
robot_cad_v5/export/links_stl/wheel_L.stl
71.0 x 202.0 x 202.0
