wisehyun-2/my_robot_project/robot_cad_v5/export/parts_step/shell_mid_R.step

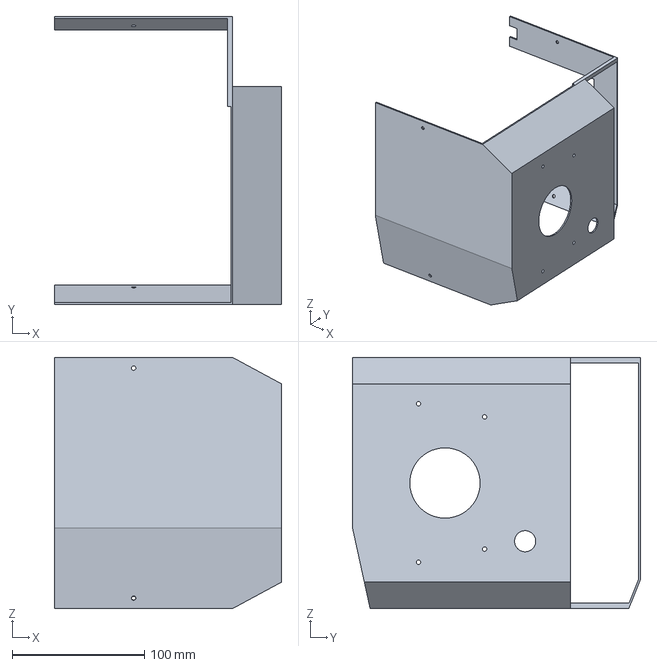
[picture p32: CAD file, 2026-11-09]
robot_cad_v5/export/parts_step/shell_mid_R.step
172.0 x 218.0 x 190.0 mm
