wisehyun-2/my_robot_project/robot_cad_v5/export/parts_stl/magnet_spacer_D9x5.35_(6061)__spacer.stl

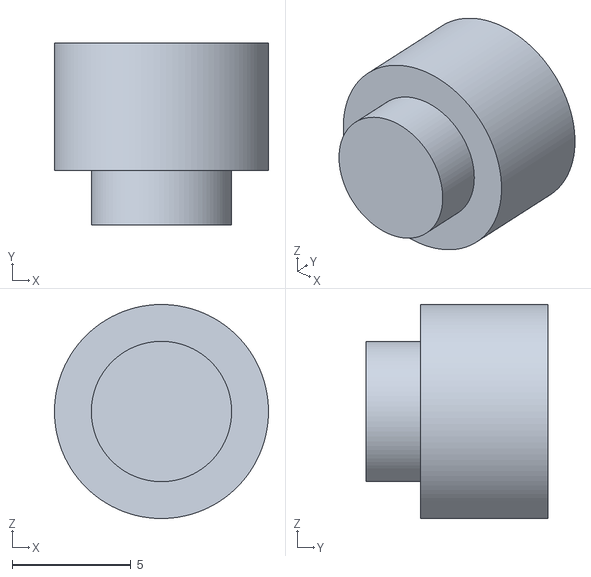
[picture p33: CAD file, 2026-10-29]
robot_cad_v5/export/parts_stl/magnet_spacer_D9x5.35_(6061)__spacer.stl
9.00 x 7.65 x 9.00
