wisehyun-2/my_robot_project/robot_cad_v5/manufacturing/step/shank_L.step

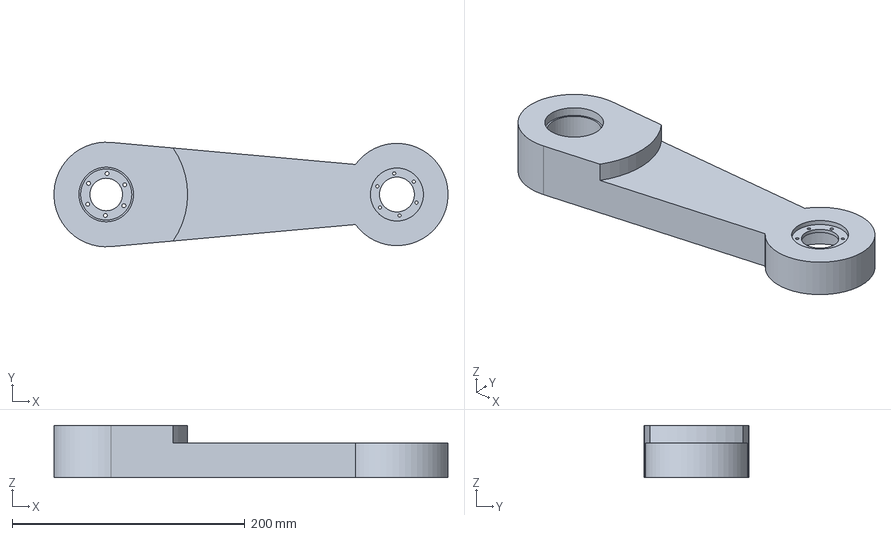
[picture p34: CAD file, 2026-11-08]
robot_cad_v5/manufacturing/step/shank_L.step
338.8 x 90.0 x 45.0 mm
