wisehyun-2/my_robot_project/robot_cad_v5/manufacturing/v2/step/hip_plate_L.step

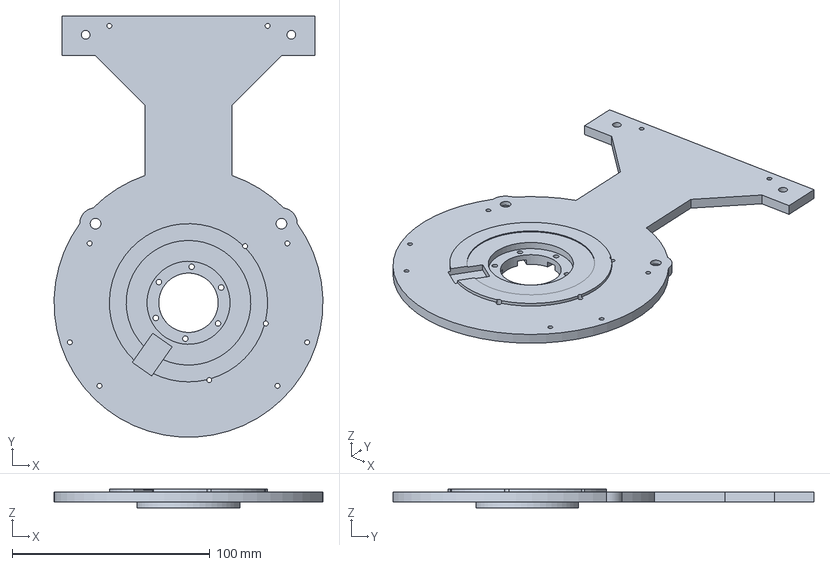
[picture p35: CAD file, 2026-10-30]
robot_cad_v5/manufacturing/v2/step/hip_plate_L.step
135.9 x 212.9 x 9.50 mm
