wisehyun-2/my_robot_project/wheeled_biped/models/upkie_description/meshes/add-ons/camera_support.stl

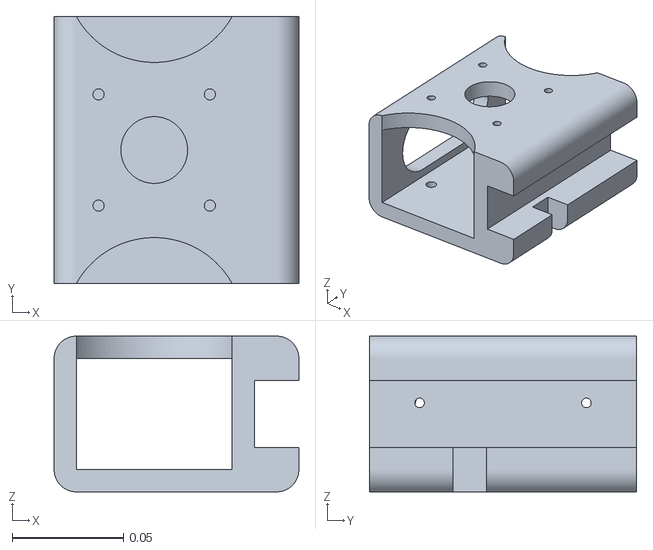
[picture p36: CAD file, 2026-10-21]
wheeled_biped/models/upkie_description/meshes/add-ons/camera_support.stl
0.11 x 0.12 x 0.07
