wisehyun-2/my_robot_project/wheeled_biped/models/upkie_description/meshes/hollow_leg/hollow_hip.stl

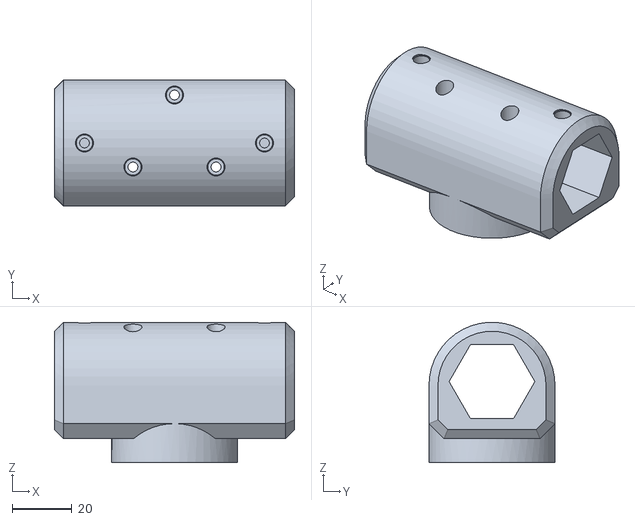
[picture p37: CAD file, 2026-10-21]
wheeled_biped/models/upkie_description/meshes/hollow_leg/hollow_hip.stl
80.0 x 42.0 x 46.7
