wisehyun-2/my_robot_project/wheeled_biped/models/upkie_description/meshes/mjbots/qdd100_rotor.stl

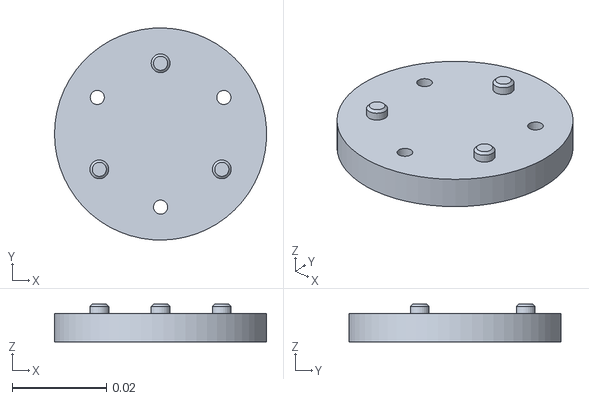
[picture p38: CAD file, 2026-10-21]
wheeled_biped/models/upkie_description/meshes/mjbots/qdd100_rotor.stl
0.045 x 0.045 x 0.008
