wisehyun-2/my_robot_project/wheeled_biped/models/upkie_description/meshes/wheel_hub.stl

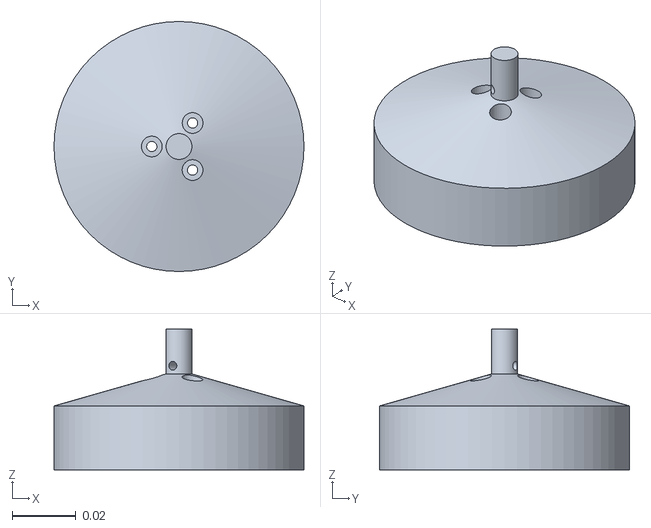
[picture p39: CAD file, 2026-10-21]
wheeled_biped/models/upkie_description/meshes/wheel_hub.stl
0.0782 x 0.0782 x 0.044
