wisehyun-2/my_robot_project/wheeled_biped/models/upkie_description/meshes/wheel_tire/wheel_tire.stl

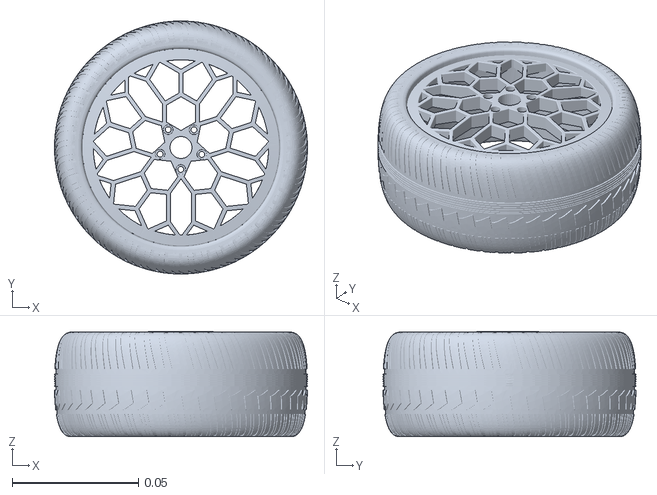
[picture p40: CAD file, 2026-10-21]
wheeled_biped/models/upkie_description/meshes/wheel_tire/wheel_tire.stl
0.1 x 0.1 x 0.0417
