wisehyun-2/my_robot_project/wheeled_biped/models/upkie_step/hip_support.step

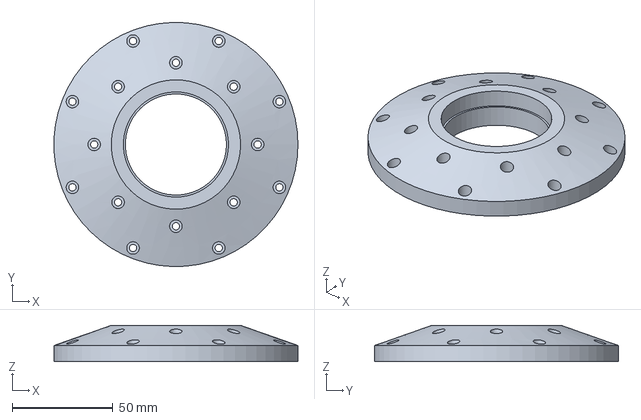
[picture p41: CAD file, 2026-10-25]
wheeled_biped/models/upkie_step/hip_support.step
120.9 x 121.0 x 18.0 mm
