wisehyun-2/my_robot_project/wheeled_biped/models/wheelbiped_v5/meshes/base.stl

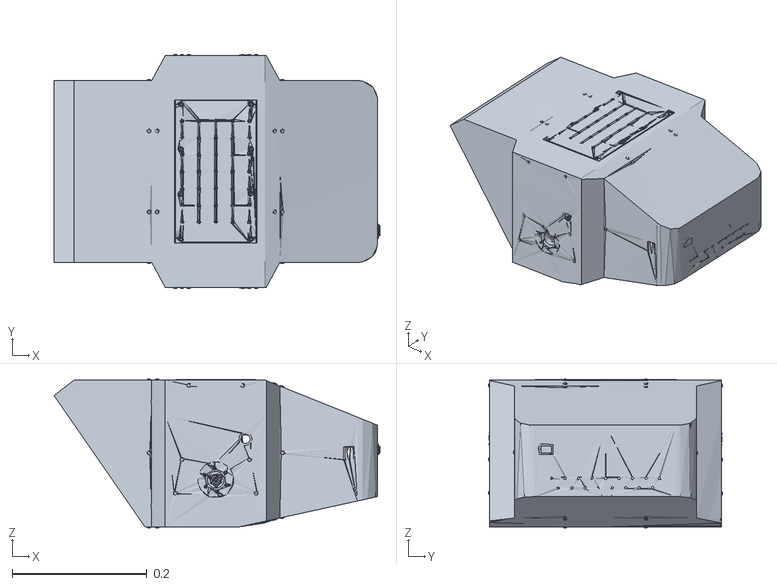
[picture p42: CAD file, 2026-11-07]
wheeled_biped/models/wheelbiped_v5/meshes/base.stl
0.484 x 0.347 x 0.221
