wisehyun-2/my_robot_project/robot_cad_v5/export/parts_step/shell_front_R.step

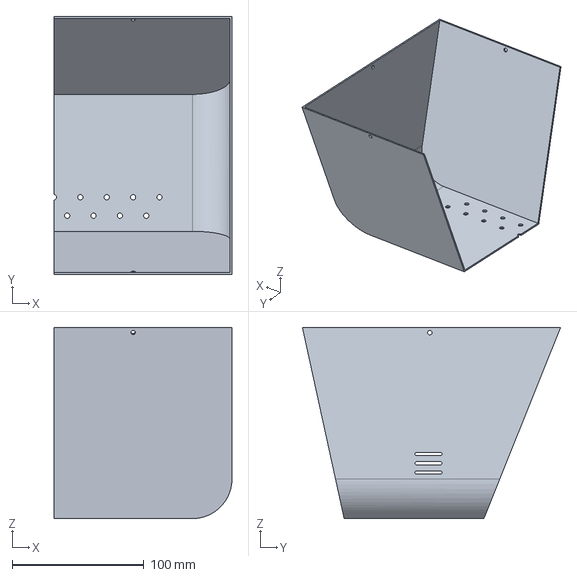
[picture p43: CAD file, 2026-11-09]
robot_cad_v5/export/parts_step/shell_front_R.step
135.0 x 195.8 x 145.0 mm
