wisehyun-2/my_robot_project/robot_cad_v5/export/parts_stl/magnet_spacer_D9x5.35_(6061)__magnet_D6x2.5_N38H_(AKE).stl

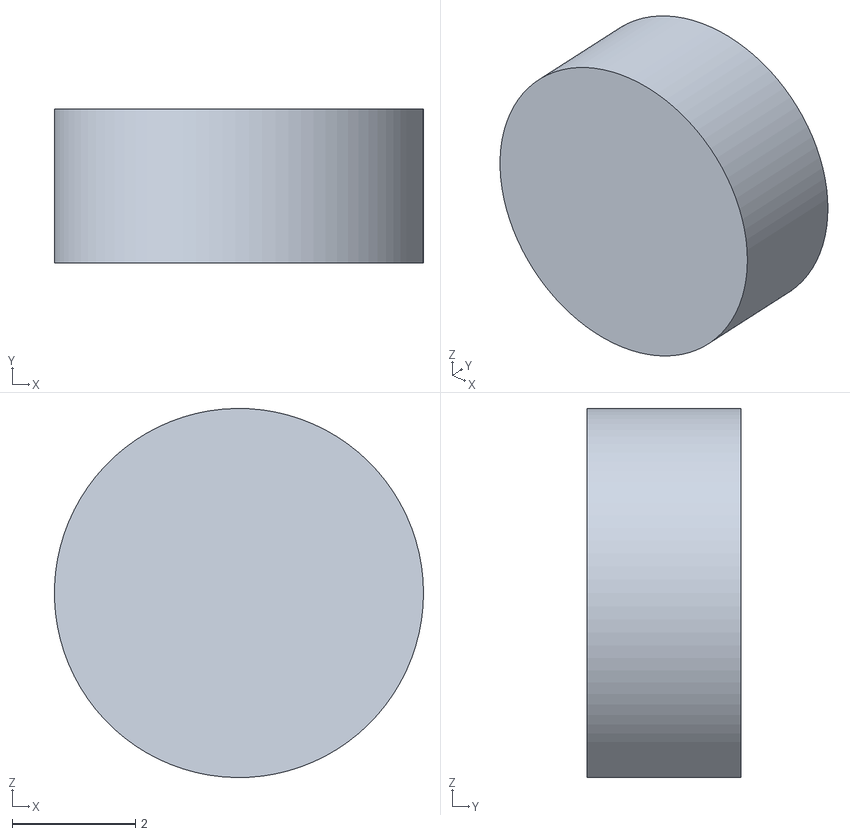
[picture p44: CAD file, 2026-10-29]
robot_cad_v5/export/parts_stl/magnet_spacer_D9x5.35_(6061)__magnet_D6x2.5_N38H_(AKE).stl
6.00 x 2.50 x 6.00
