wisehyun-2/my_robot_project/wheeled_biped/models/upkie_description/meshes/add-ons/handle.stl

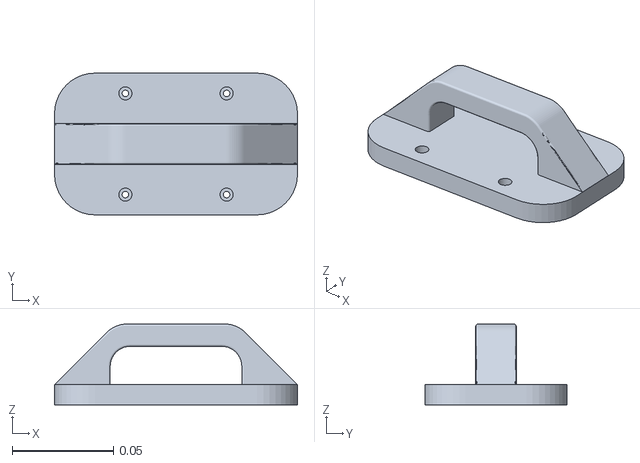
[picture p45: CAD file, 2026-10-21]
wheeled_biped/models/upkie_description/meshes/add-ons/handle.stl
0.12 x 0.07 x 0.0399
