wisehyun-2/my_robot_project/wheeled_biped/models/upkie_description/meshes/ankle_stator.stl

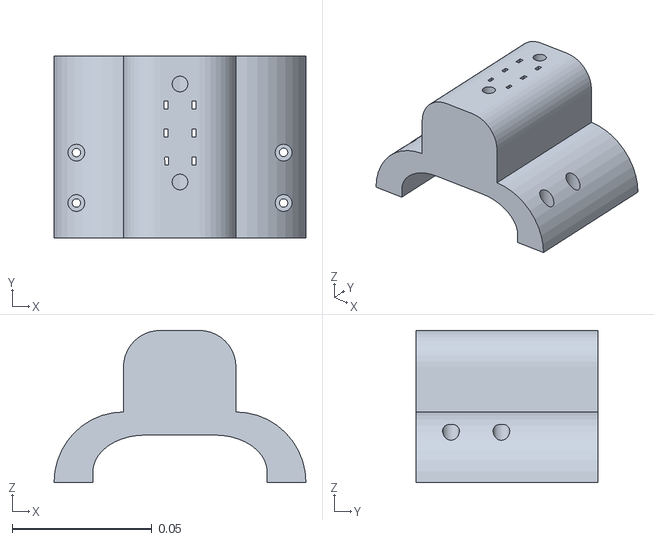
[picture p46: CAD file, 2026-10-21]
wheeled_biped/models/upkie_description/meshes/ankle_stator.stl
0.09 x 0.065 x 0.0543
