wisehyun-2/my_robot_project/wheeled_biped/models/upkie_description/meshes/hollow_leg/hollow_knee.stl

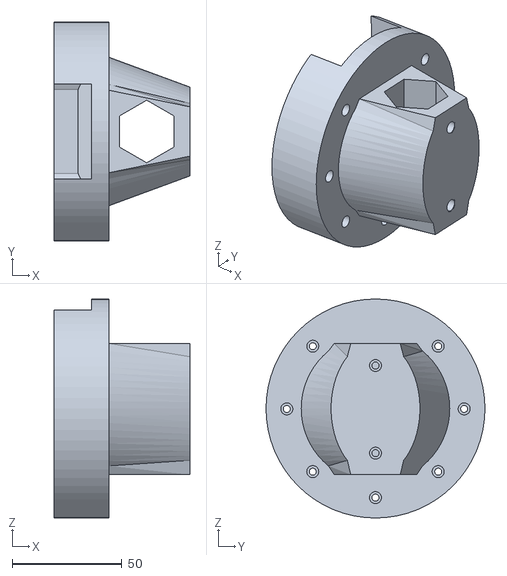
[picture p47: CAD file, 2026-10-21]
wheeled_biped/models/upkie_description/meshes/hollow_leg/hollow_knee.stl
62.0 x 100.0 x 100.0
