wisehyun-2/my_robot_project/wheeled_biped/models/upkie_description/meshes/mjbots/qdd100_stator.stl

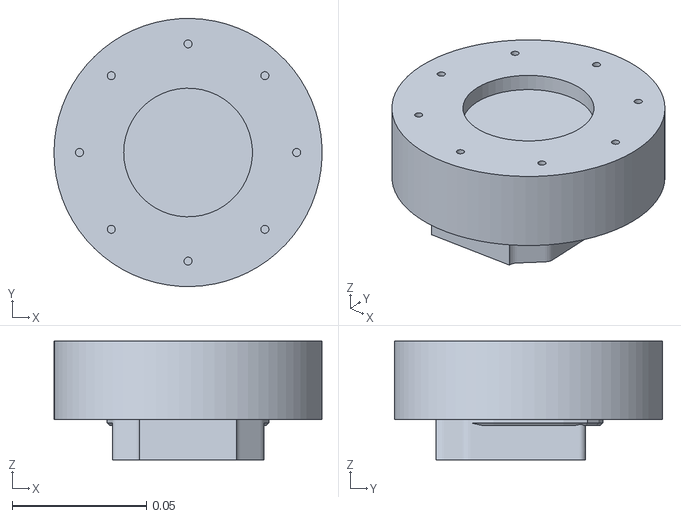
[picture p48: CAD file, 2026-10-21]
wheeled_biped/models/upkie_description/meshes/mjbots/qdd100_stator.stl
0.1 x 0.1 x 0.0442
