wisehyun-2/my_robot_project/wheeled_biped/models/upkie_step/lower_leg.step

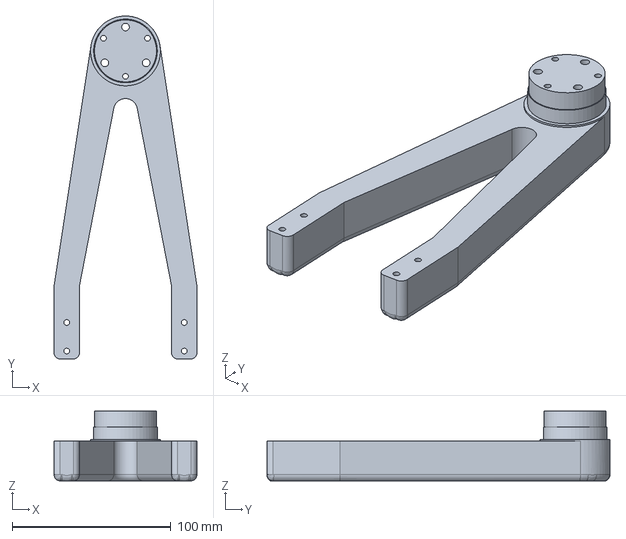
[picture p49: CAD file, 2026-10-25]
wheeled_biped/models/upkie_step/lower_leg.step
90.0 x 216.0 x 44.0 mm
