wisehyun-2/my_robot_project/wheeled_biped/models/wheelbiped_v5/meshes/left_thigh.stl

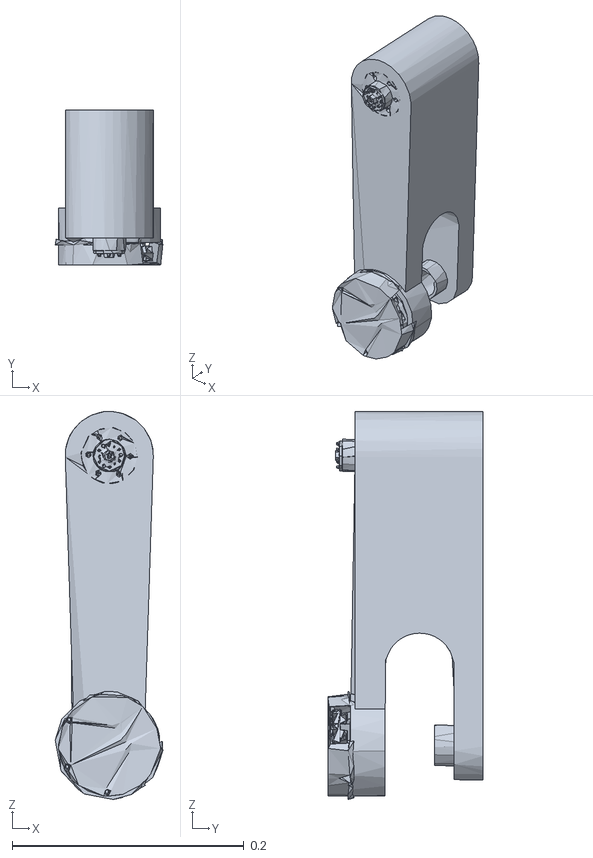
[picture p50: CAD file, 2026-11-07]
wheeled_biped/models/wheelbiped_v5/meshes/left_thigh.stl
0.0929 x 0.134 x 0.335
