wisehyun-2/my_robot_project/robot_cad_v5/export/links_stl/femur_R.stl

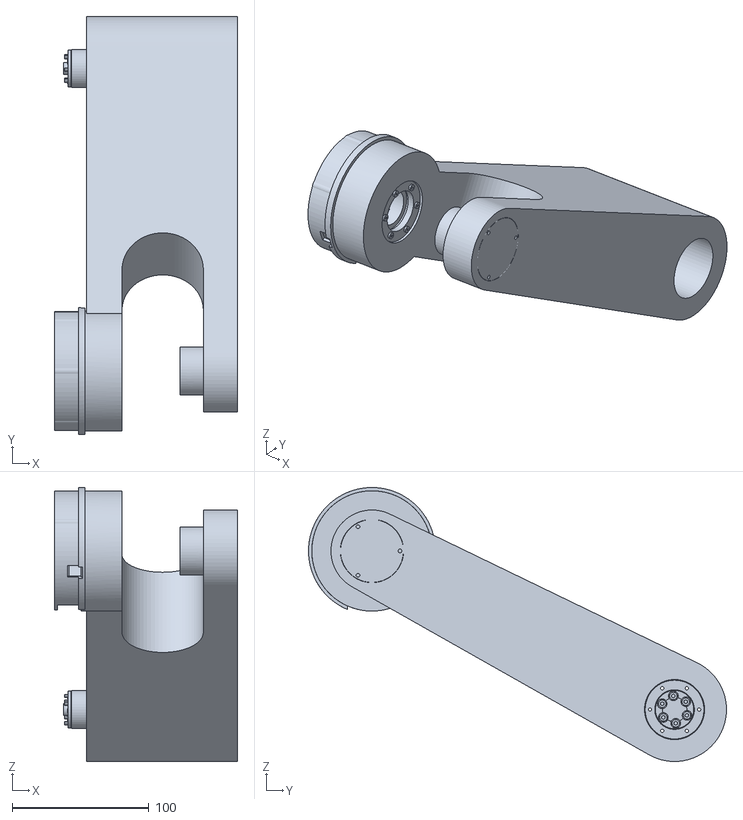
[picture p51: CAD file, 2026-11-07]
robot_cad_v5/export/links_stl/femur_R.stl
133.9 x 305.9 x 200.5
