wisehyun-2/my_robot_project/robot_cad_v5/manufacturing/step/hub_insert_knee_R.step

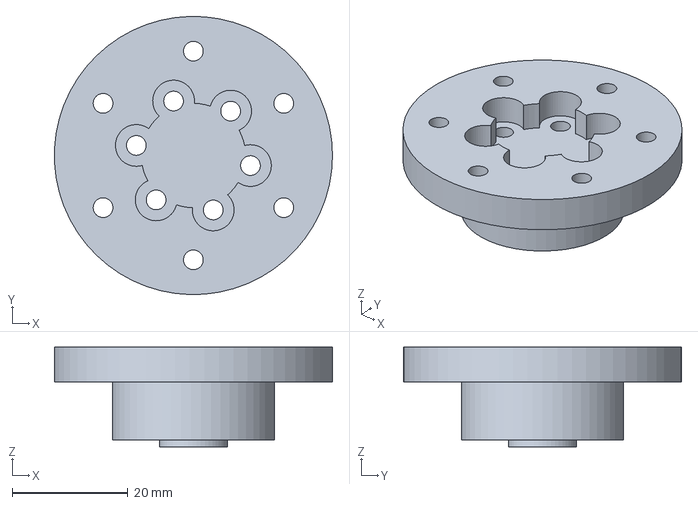
[picture p52: CAD file, 2026-11-08]
robot_cad_v5/manufacturing/step/hub_insert_knee_R.step
48.0 x 48.0 x 17.2 mm
