wisehyun-2/my_robot_project/wheeled_biped/models/upkie_description/meshes/hollow_leg/hollow_femur.stl

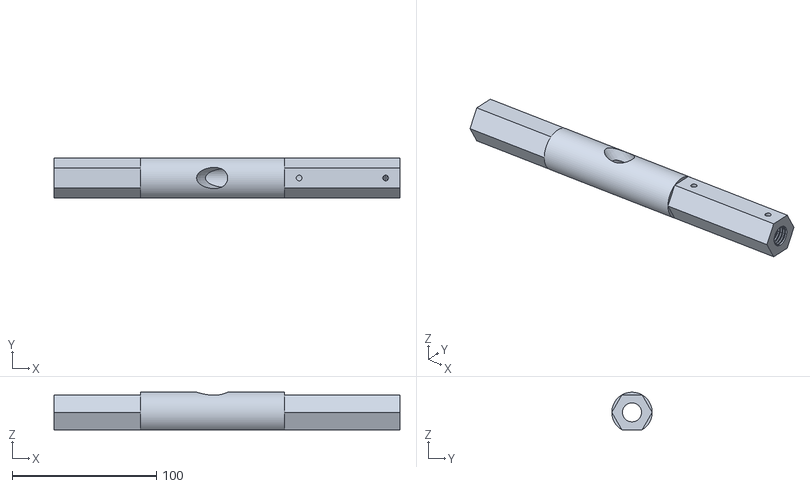
[picture p53: CAD file, 2026-10-21]
wheeled_biped/models/upkie_description/meshes/hollow_leg/hollow_femur.stl
240.0 x 28.0 x 26.1
