wisehyun-2/my_robot_project/wheeled_biped/models/upkie_description/meshes/knee_stator.stl

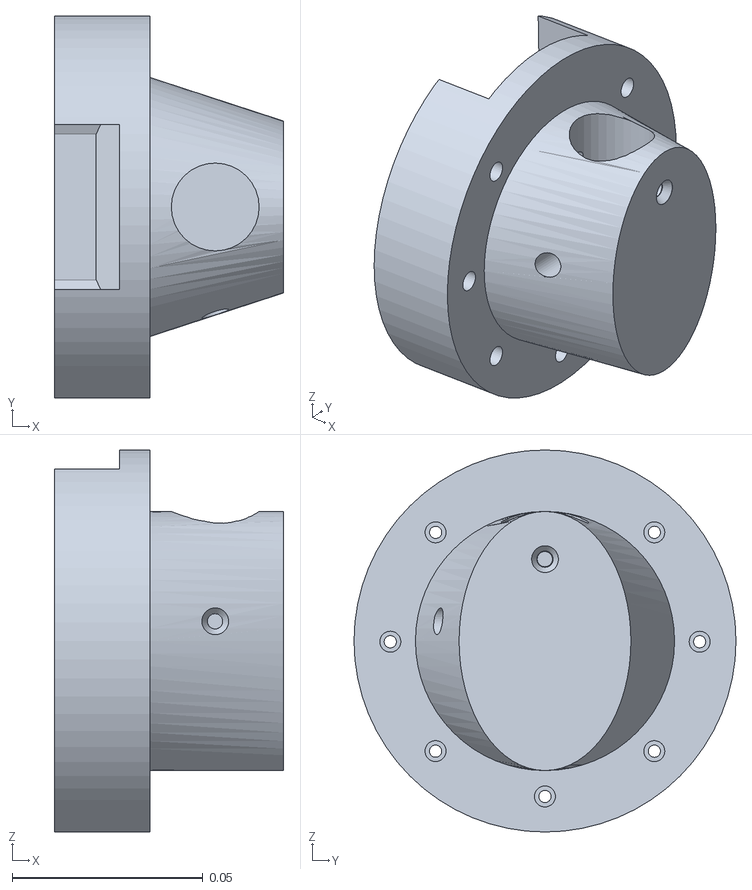
[picture p54: CAD file, 2026-10-21]
wheeled_biped/models/upkie_description/meshes/knee_stator.stl
0.06 x 0.1 x 0.1
