wisehyun-2/my_robot_project/wheeled_biped/models/upkie_description/meshes/mjbots/qdd100_horn.stl

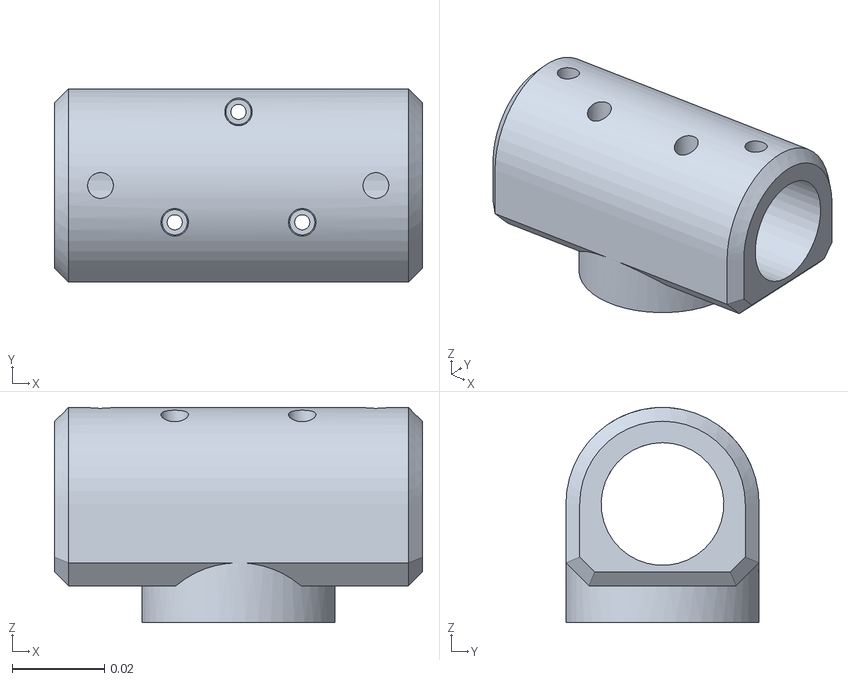
[picture p55: CAD file, 2026-10-21]
wheeled_biped/models/upkie_description/meshes/mjbots/qdd100_horn.stl
0.08 x 0.042 x 0.0468
