wisehyun-2/my_robot_project/wheeled_biped/models/upkie_step/wheel_hub.step

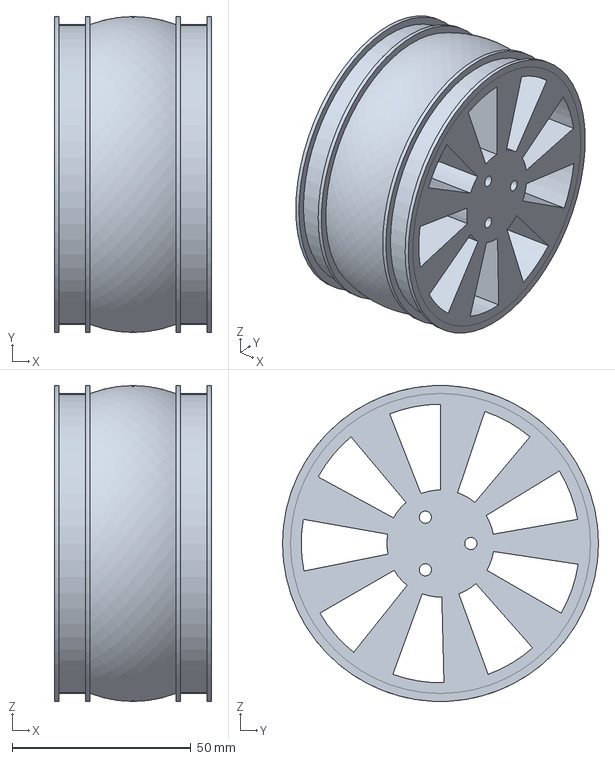
[picture p56: CAD file, 2026-10-25]
wheeled_biped/models/upkie_step/wheel_hub.step
44.0 x 88.5 x 88.5 mm
