wisehyun-2/my_robot_project/wheeled_biped/models/wheelbiped_v5/meshes/right_shank.stl

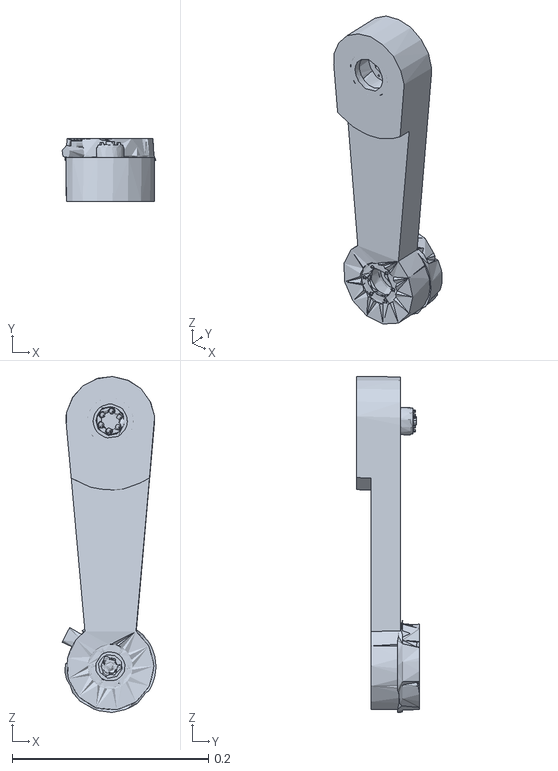
[picture p57: CAD file, 2026-11-07]
wheeled_biped/models/wheelbiped_v5/meshes/right_shank.stl
0.0956 x 0.0645 x 0.342
