wisehyun-2/my_robot_project/robot_cad_v5/export/links_stl/tibia_L.stl

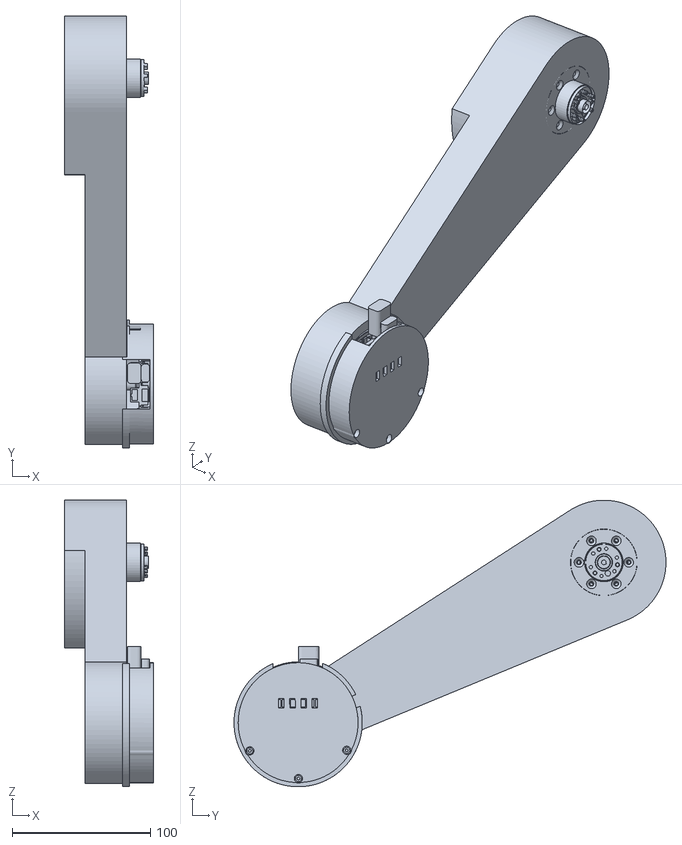
[picture p58: CAD file, 2026-11-07]
robot_cad_v5/export/links_stl/tibia_L.stl
64.4 x 312.9 x 207.5
