wisehyun-2/my_robot_project/robot_cad_v5/manufacturing/step/hub_insert_hip_L.step

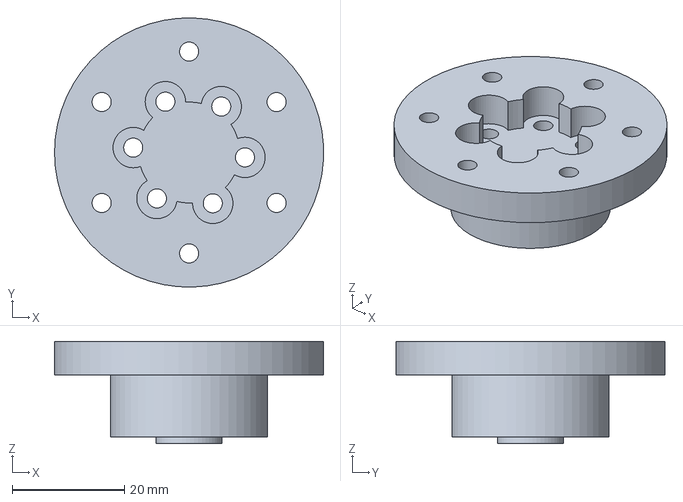
[picture p60: CAD file, 2026-11-08]
robot_cad_v5/manufacturing/step/hub_insert_hip_L.step
48.0 x 48.0 x 18.2 mm
