wisehyun-2/my_robot_project/robot_cad_v5/manufacturing/v2/step/spine_tube.step

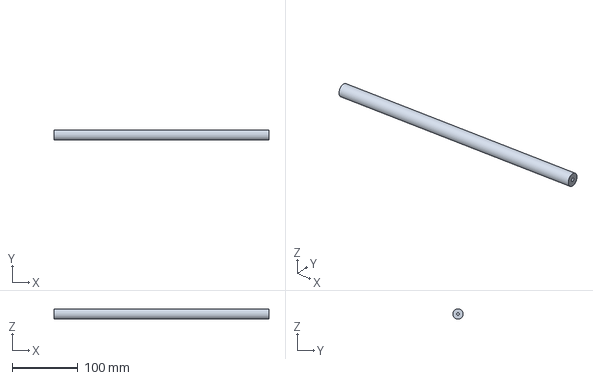
[picture p61: CAD file, 2026-10-29]
robot_cad_v5/manufacturing/v2/step/spine_tube.step
328.0 x 16.0 x 16.0 mm
