wisehyun-2/my_robot_project/wheeled_biped/models/upkie_description/meshes/mjbots/mj5208_stator.stl

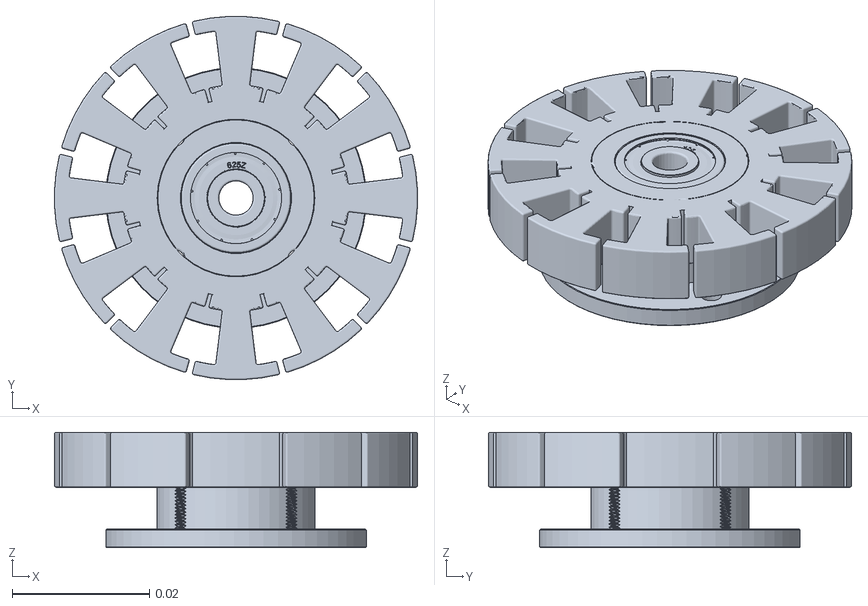
[picture p62: CAD file, 2026-10-21]
wheeled_biped/models/upkie_description/meshes/mjbots/mj5208_stator.stl
0.0529 x 0.0529 x 0.0168
