wisehyun-2/my_robot_project/wheeled_biped/models/upkie_step/knee_support.step

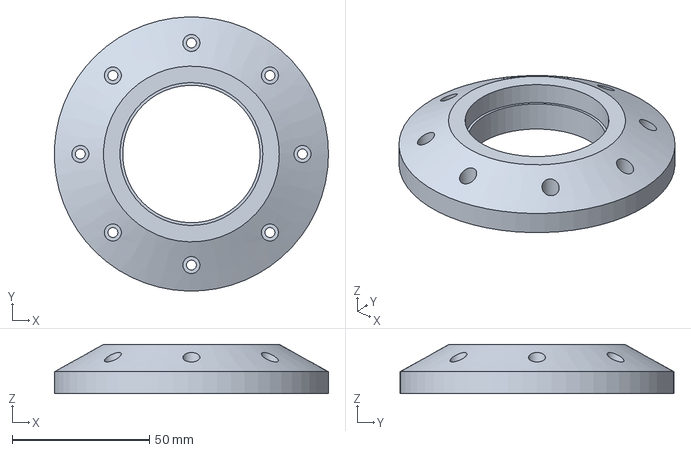
[picture p63: CAD file, 2026-10-25]
wheeled_biped/models/upkie_step/knee_support.step
99.9 x 100.0 x 18.0 mm
