wisehyun-2/my_robot_project/wheeled_biped/models/wheelbiped_v5/meshes/right_wheel_link.stl

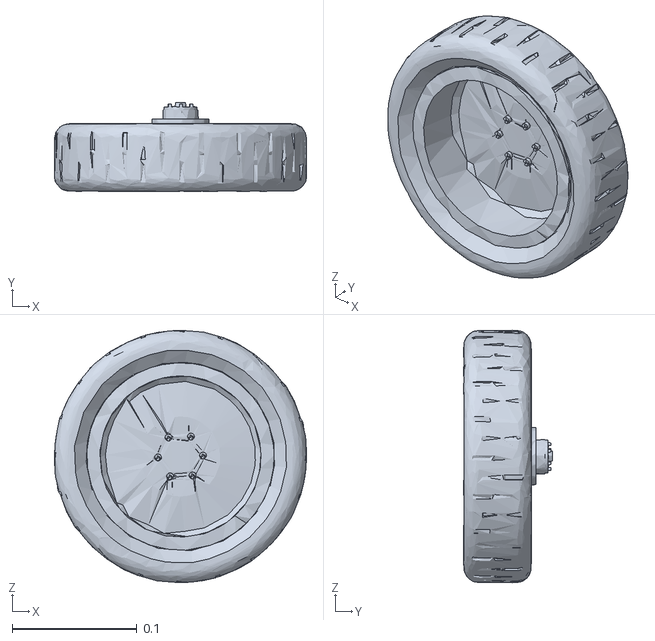
[picture p64: CAD file, 2026-11-07]
wheeled_biped/models/wheelbiped_v5/meshes/right_wheel_link.stl
0.202 x 0.0713 x 0.202
