wisehyun-2/my_robot_project/robot_cad_v5/export/parts_step/battery_tray_R.step

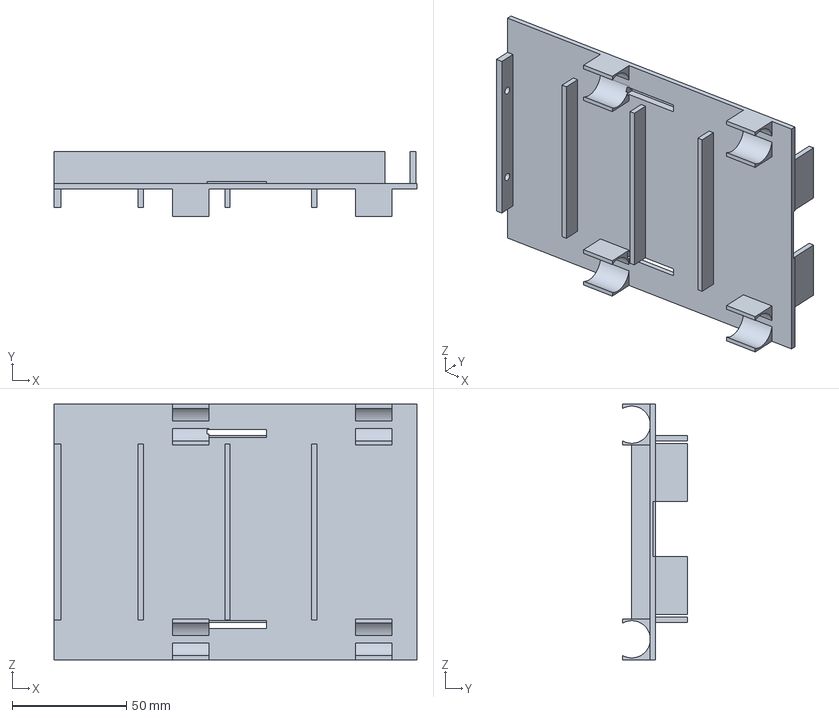
[picture p65: CAD file, 2026-11-09]
robot_cad_v5/export/parts_step/battery_tray_R.step
159.0 x 28.4 x 112.0 mm
