wisehyun-2/my_robot_project/robot_cad_v5/manufacturing/v2/step/rail.step

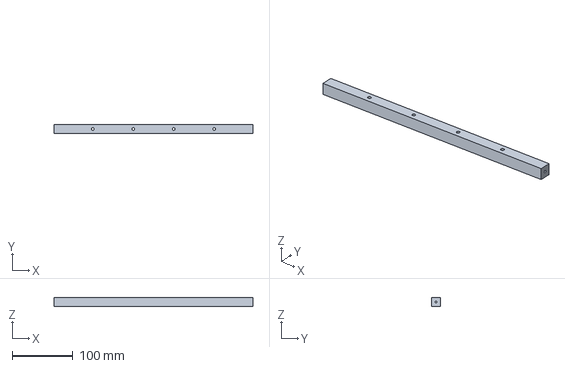
[picture p66: CAD file, 2026-10-29]
robot_cad_v5/manufacturing/v2/step/rail.step
328.0 x 15.0 x 15.0 mm
