wisehyun-2/my_robot_project/wheeled_biped/models/upkie_description/meshes/mjbots/mj5208_rotor.stl

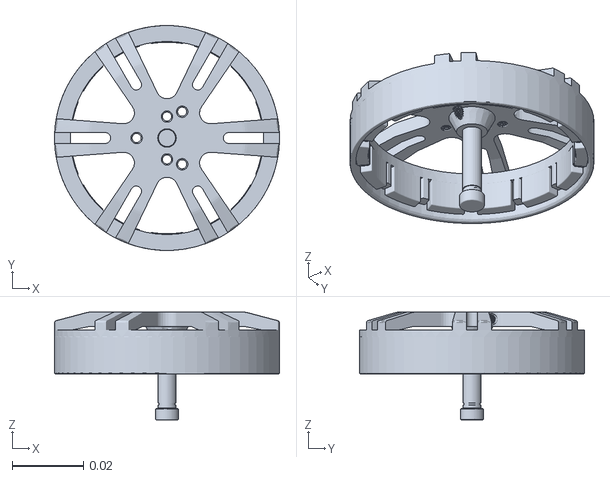
[picture p67: CAD file, 2026-10-21]
wheeled_biped/models/upkie_description/meshes/mjbots/mj5208_rotor.stl
0.063 x 0.063 x 0.0302
