wisehyun-2/my_robot_project/wheeled_biped/models/upkie_step/upper_leg.step

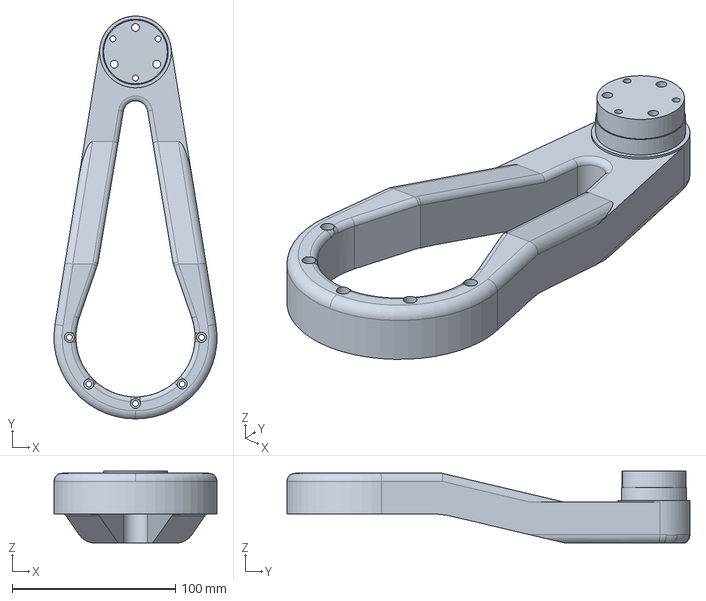
[picture p68: CAD file, 2026-10-25]
wheeled_biped/models/upkie_step/upper_leg.step
99.9 x 247.0 x 44.0 mm
