wisehyun-2/my_robot_project/wheeled_biped/models/wheelbiped_v5/meshes/right_thigh.stl

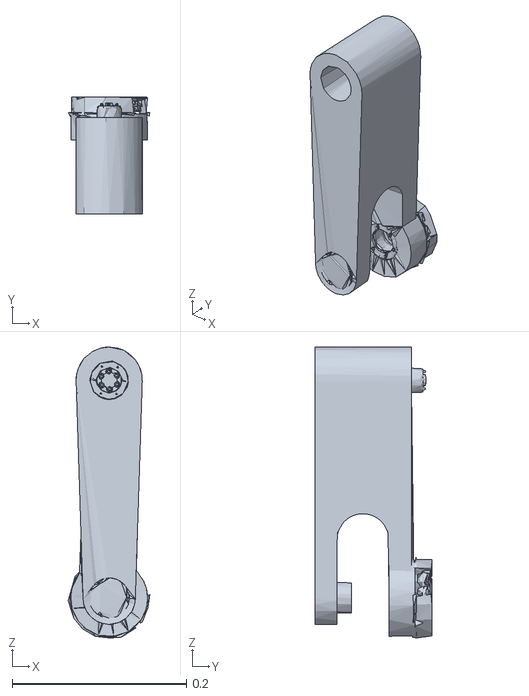
[picture p69: CAD file, 2026-11-07]
wheeled_biped/models/wheelbiped_v5/meshes/right_thigh.stl
0.0939 x 0.134 x 0.334
