wisehyun-2/my_robot_project/robot_cad_v5/manufacturing/step/thigh_R.step

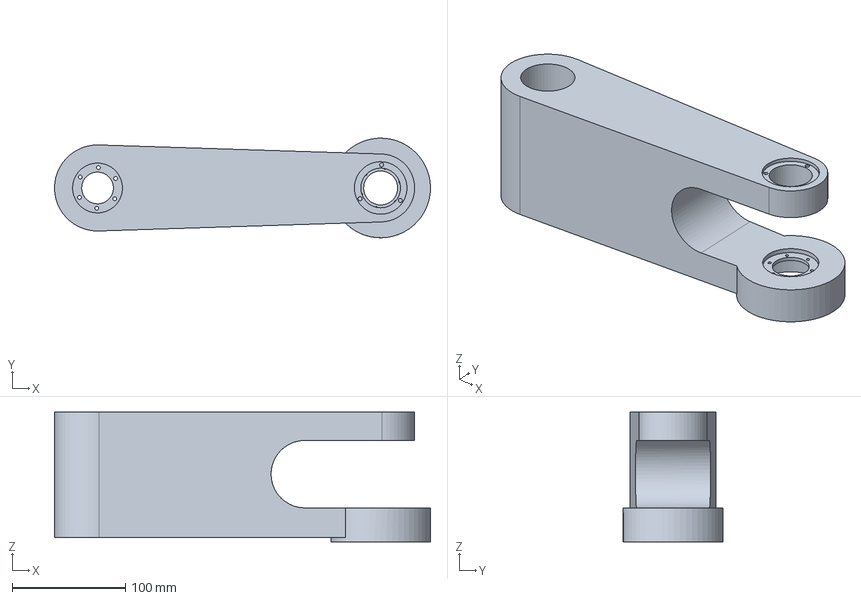
[picture p71: CAD file, 2026-11-08]
robot_cad_v5/manufacturing/step/thigh_R.step
332.0 x 87.9 x 114.5 mm
