wisehyun-2/my_robot_project/robot_cad_v5/manufacturing/v2/step/clamp_ring_stator.step

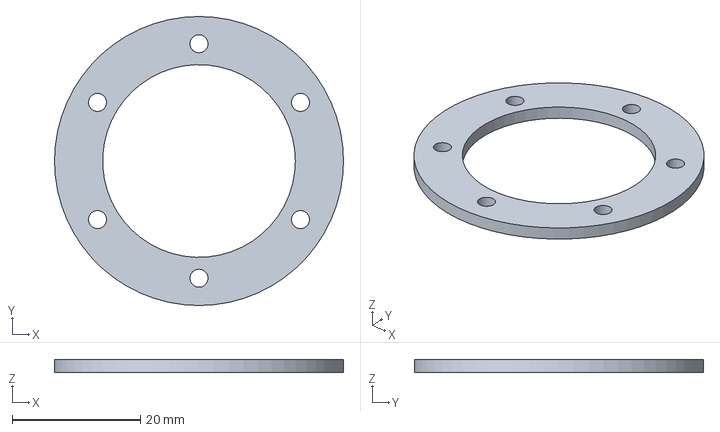
[picture p72: CAD file, 2026-10-29]
robot_cad_v5/manufacturing/v2/step/clamp_ring_stator.step
45.0 x 45.0 x 2.00 mm
