wisehyun-2/my_robot_project/robot_cad_v5/export/links_stl/torso.stl

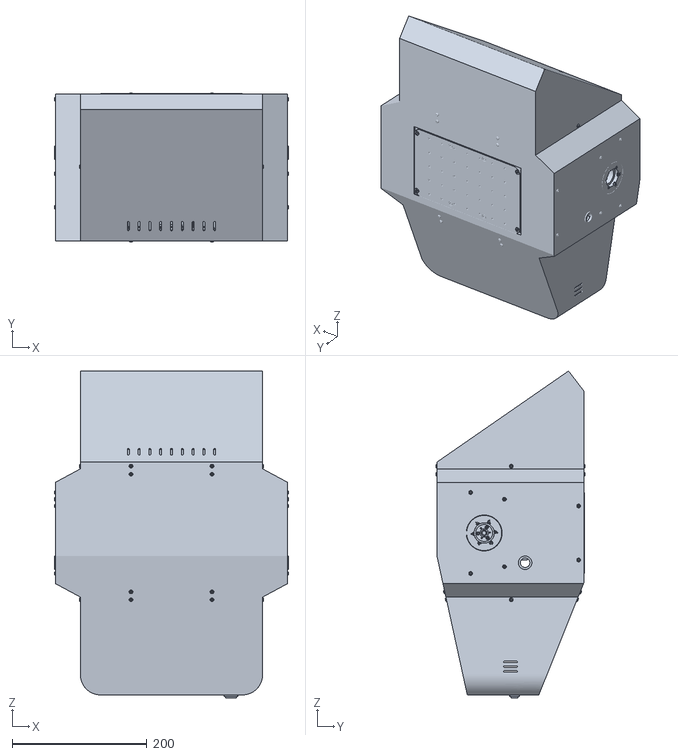
[picture p73: CAD file, 2026-11-07]
robot_cad_v5/export/links_stl/torso.stl
347.3 x 221.3 x 484.5
