wisehyun-2/my_robot_project/robot_cad_v5/export/parts_step/electronics_deck_R.step

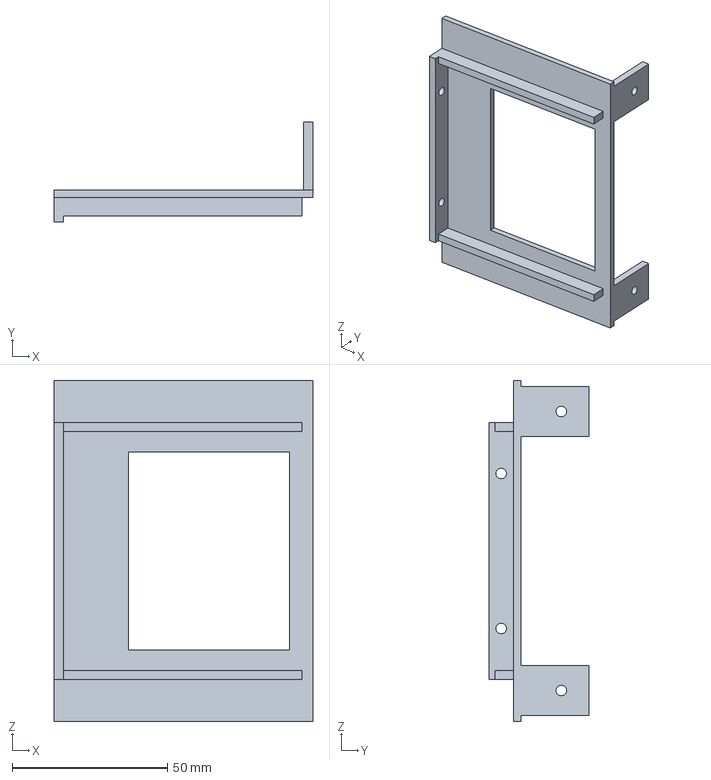
[picture p74: CAD file, 2026-11-09]
robot_cad_v5/export/parts_step/electronics_deck_R.step
83.5 x 32.4 x 110.0 mm
