wisehyun-2/my_robot_project/wheeled_biped/models/wheelbiped_v5/meshes/left_shank.stl

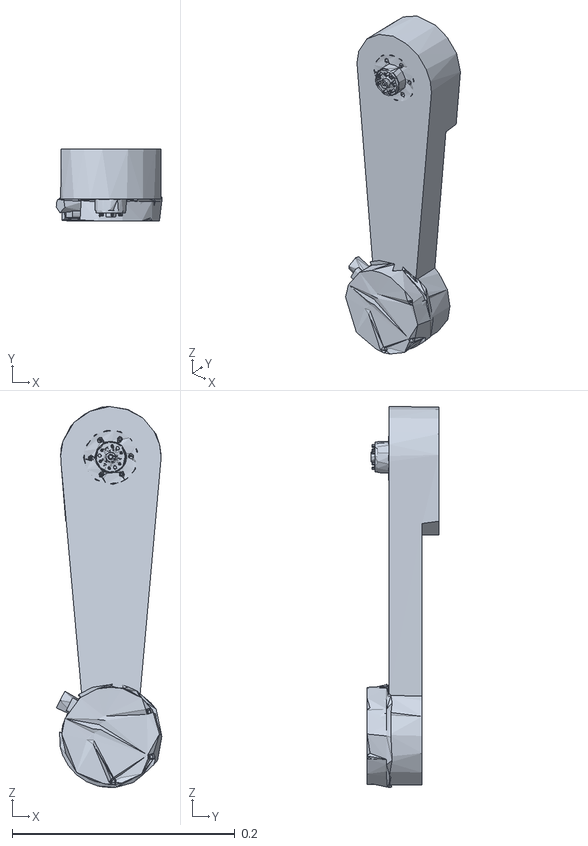
[picture p75: CAD file, 2026-11-07]
wheeled_biped/models/wheelbiped_v5/meshes/left_shank.stl
0.0947 x 0.0645 x 0.342
