wisehyun-2/my_robot_project/robot_cad_v5/export/parts_step/shank_R.step

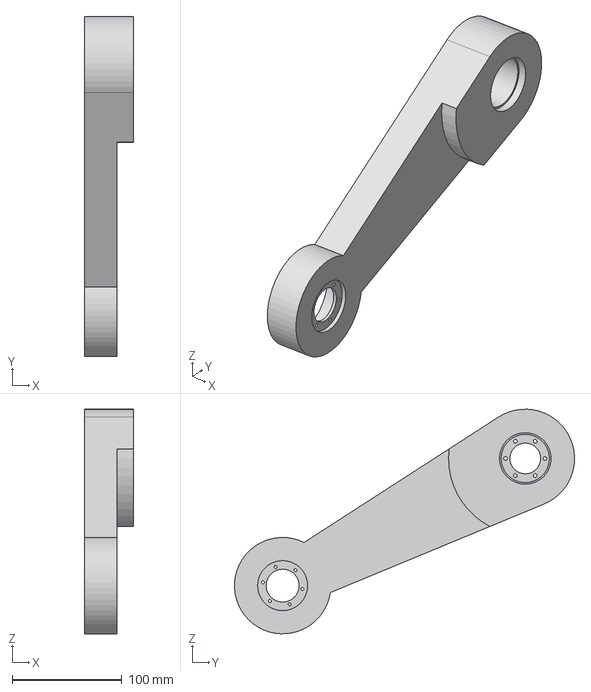
[picture p76: CAD file, 2026-11-08]
robot_cad_v5/export/parts_step/shank_R.step
45.0 x 310.3 x 205.0 mm
