wisehyun-2/my_robot_project/robot_cad_v5/manufacturing/step/knee_cap_R.step

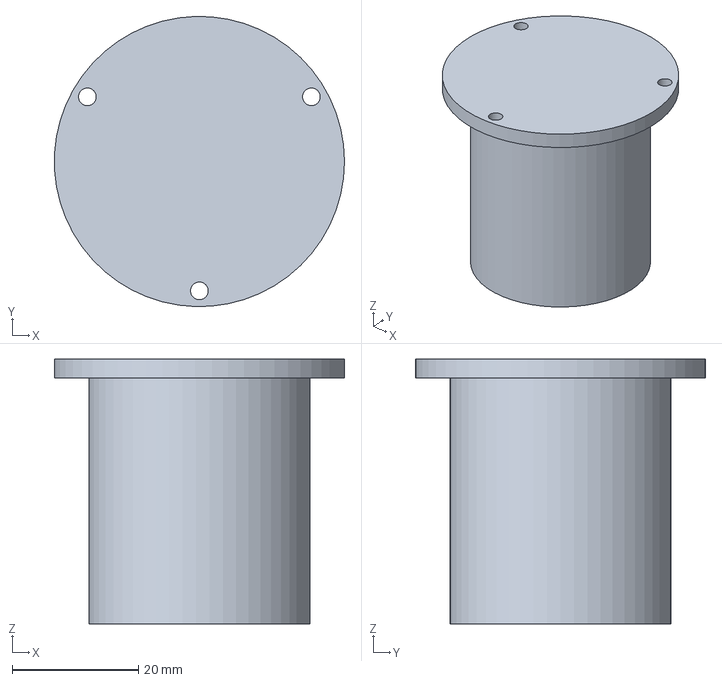
[picture p77: CAD file, 2026-11-07]
robot_cad_v5/manufacturing/step/knee_cap_R.step
46.0 x 46.0 x 42.0 mm
