wisehyun-2/my_robot_project/robot_cad_v5/export/parts_step/shell_rear_R.step

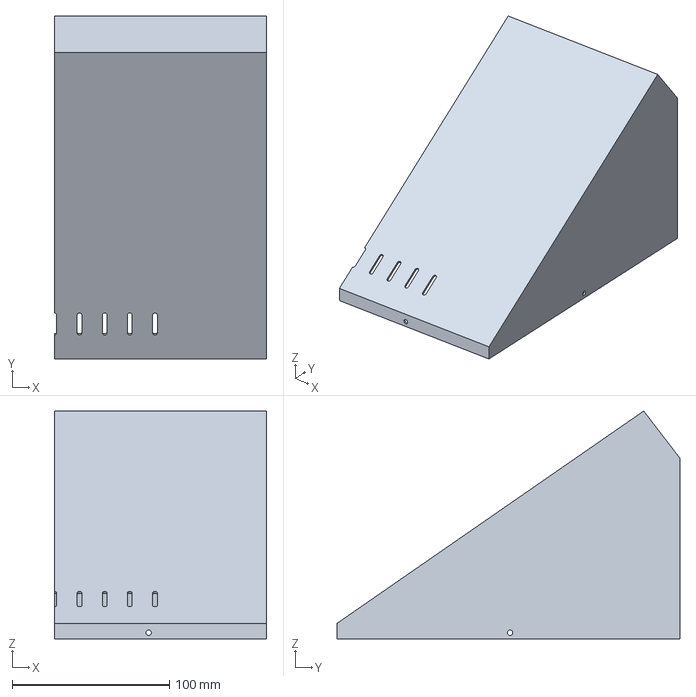
[picture p78: CAD file, 2026-11-08]
robot_cad_v5/export/parts_step/shell_rear_R.step
135.0 x 218.0 x 145.0 mm
