wisehyun-2/my_robot_project/robot_cad_v5/manufacturing/step/hub_ring_R.step

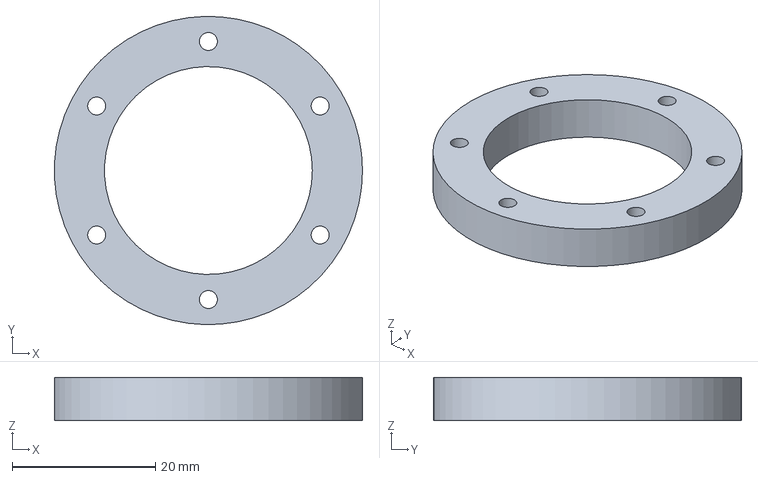
[picture p79: CAD file, 2026-11-07]
robot_cad_v5/manufacturing/step/hub_ring_R.step
43.0 x 43.0 x 6.00 mm
