wisehyun-2/my_robot_project/robot_cad_v5/export/parts_step/hub_flange_L.step

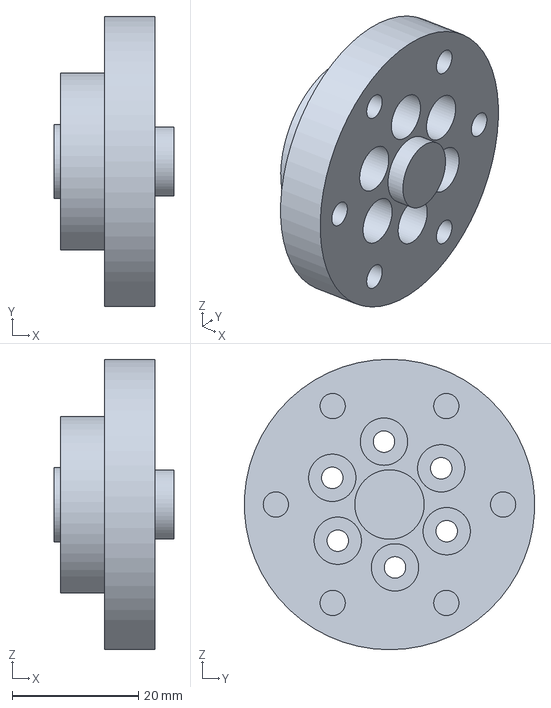
[picture p80: CAD file, 2026-11-08]
robot_cad_v5/export/parts_step/hub_flange_L.step
19.0 x 45.9 x 46.0 mm
