wisehyun-2/my_robot_project/robot_cad_v5/export/parts_step/splice_tabs.step

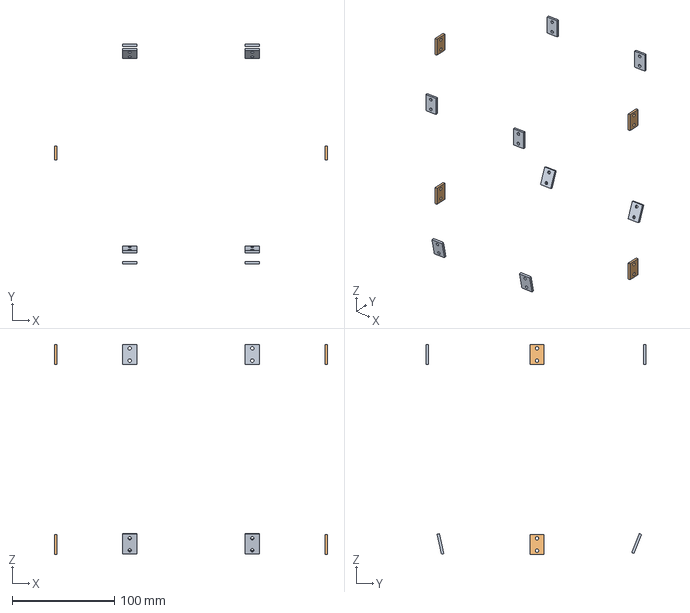
[picture p81: CAD file, 2026-11-08]
robot_cad_v5/export/parts_step/splice_tabs.step
267.2 x 215.2 x 206.0 mm
