wisehyun-2/my_robot_project/robot_cad_v5/export/parts_step/rim_R.step

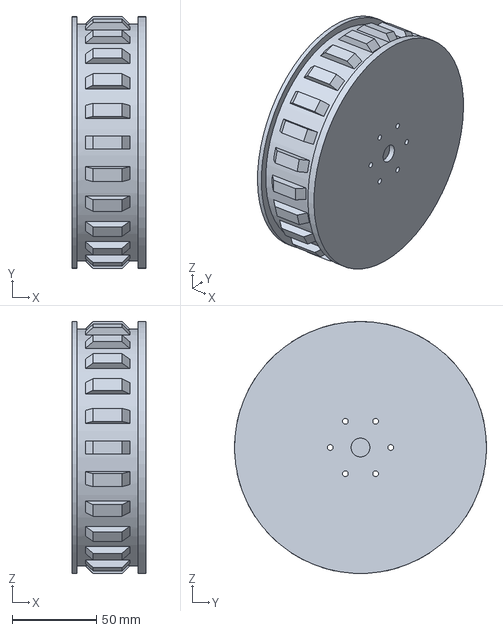
[picture p82: CAD file, 2026-11-08]
robot_cad_v5/export/parts_step/rim_R.step
44.2 x 150.0 x 150.0 mm
