wisehyun-2/my_robot_project/robot_cad_v5/export/parts_step/top_plate.step

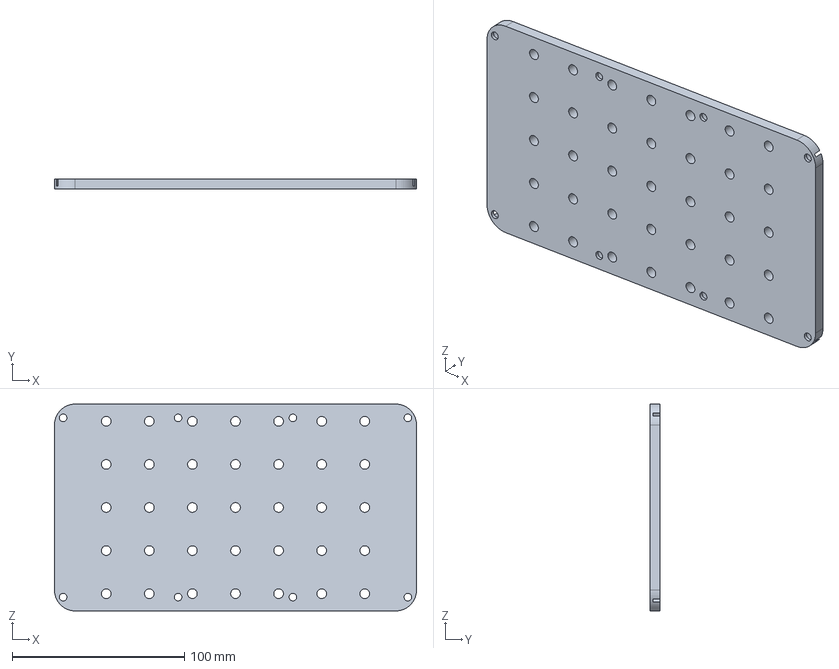
[picture p83: CAD file, 2026-11-08]
robot_cad_v5/export/parts_step/top_plate.step
210.0 x 6.00 x 120.0 mm
