wisehyun-2/my_robot_project/robot_cad_v5/export/parts_step/saddle_L.step

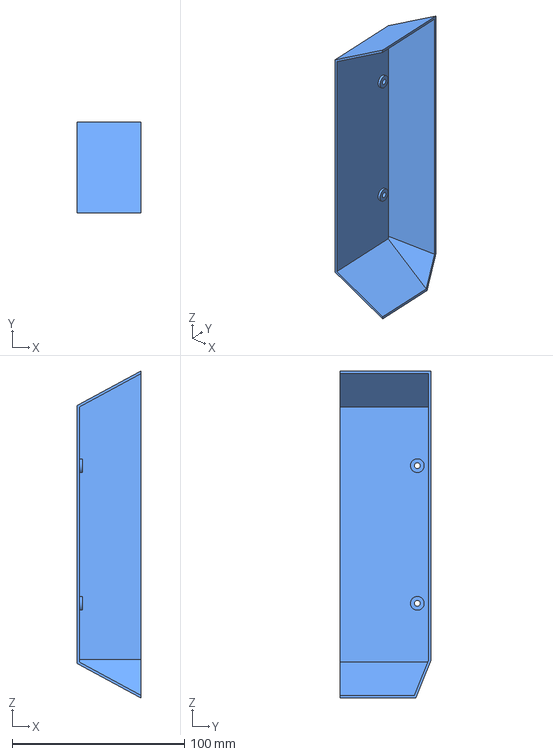
[picture p84: CAD file, 2026-11-08]
robot_cad_v5/export/parts_step/saddle_L.step
37.0 x 53.0 x 190.0 mm
