wisehyun-2/my_robot_project/robot_cad_v5/export/parts_step/thigh_L.step

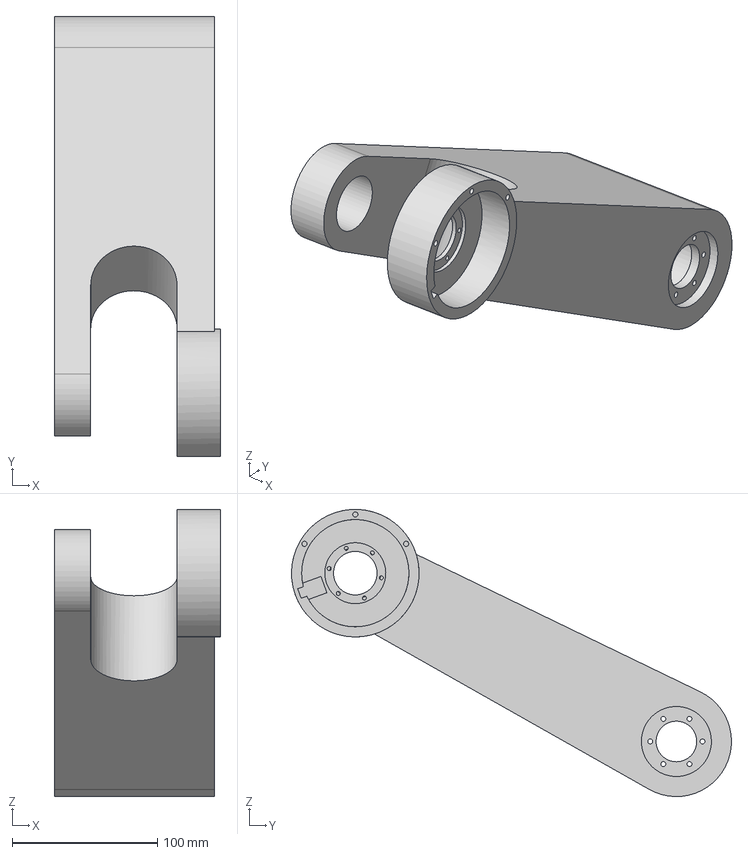
[picture p85: CAD file, 2026-11-08]
robot_cad_v5/export/parts_step/thigh_L.step
114.5 x 303.4 x 198.0 mm
