wisehyun-2/my_robot_project/robot_cad_v5/export/parts_step/cup_hip_L.step

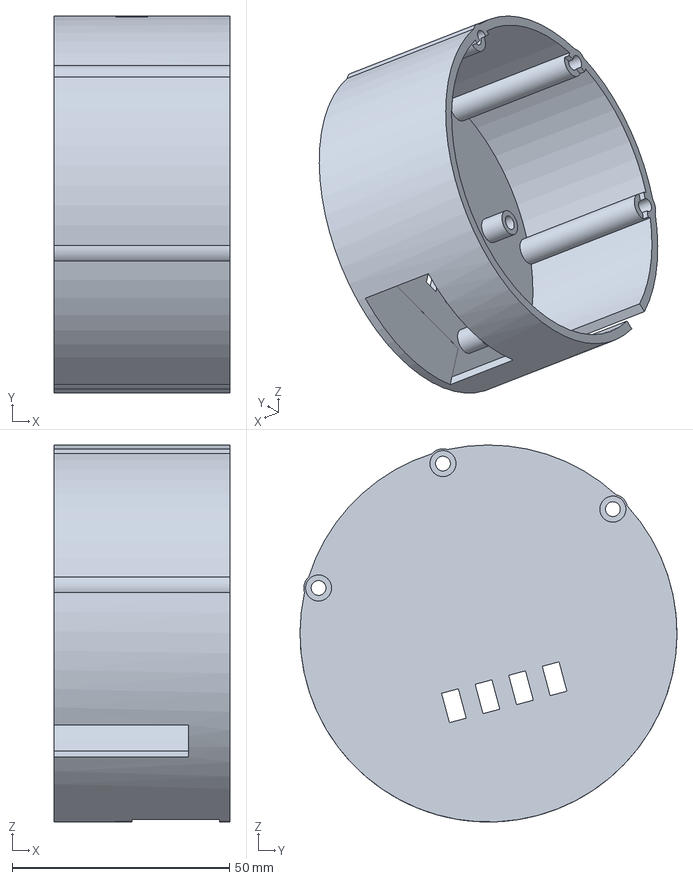
[picture p87: CAD file, 2026-11-07]
robot_cad_v5/export/parts_step/cup_hip_L.step
40.5 x 86.8 x 86.8 mm
