wisehyun-2/my_robot_project/robot_cad_v5/export/parts_step/cup_knee_R.step

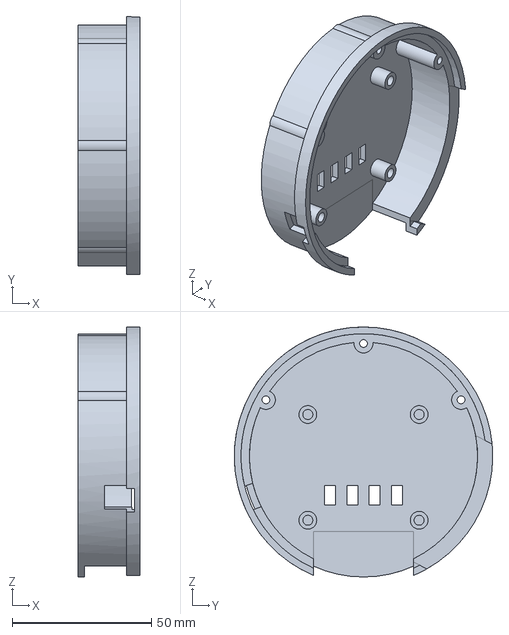
[picture p88: CAD file, 2026-11-07]
robot_cad_v5/export/parts_step/cup_knee_R.step
22.4 x 92.9 x 89.8 mm
