wisehyun-2/my_robot_project/robot_cad_v5/export/parts_step/clamp_ring_output_D27_t2.0_SUS304.step

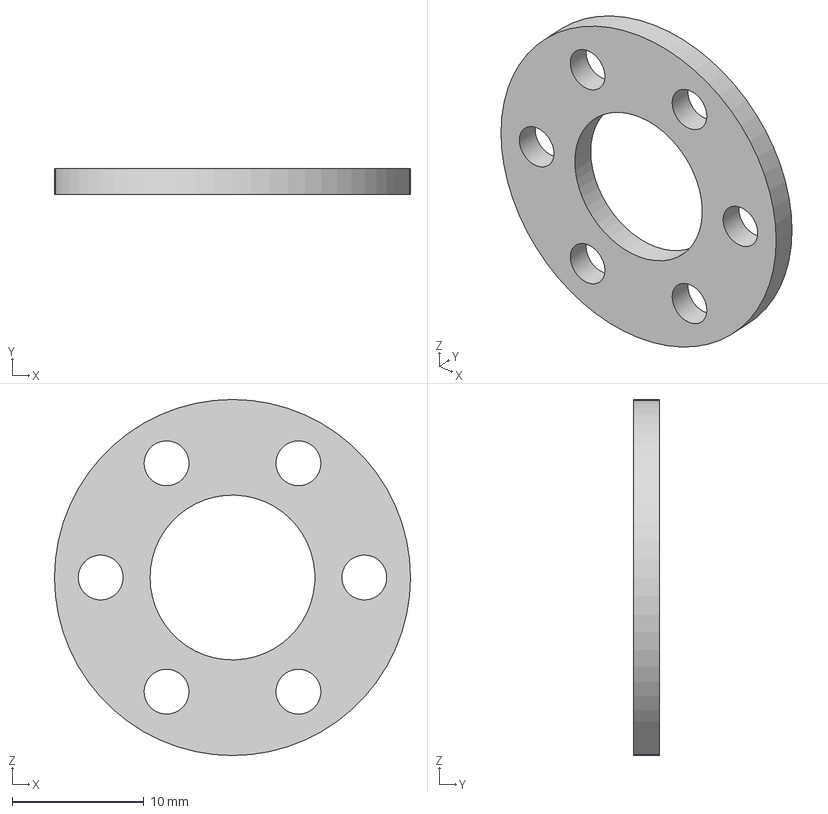
[picture p89: CAD file, 2026-11-07]
robot_cad_v5/export/parts_step/clamp_ring_output_D27_t2.0_SUS304.step
27.0 x 2.00 x 27.0 mm
