wisehyun-2/my_robot_project/robot_cad_v5/export/parts_step/magnet_spacer_D9x5.35_(6061).step

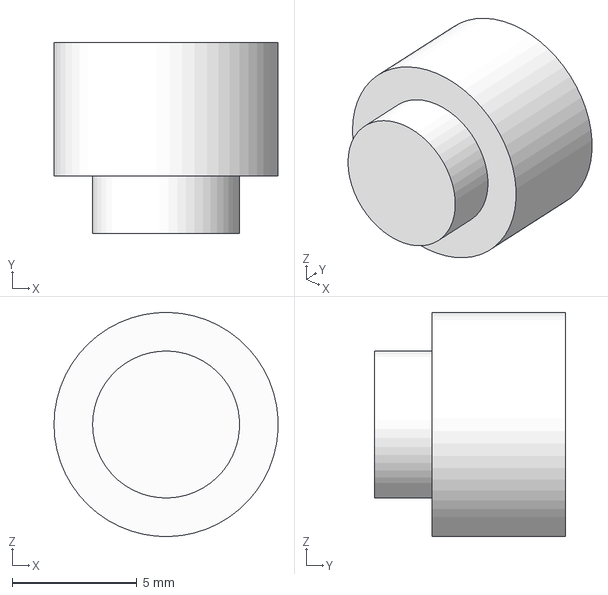
[picture p90: CAD file, 2026-11-07]
robot_cad_v5/export/parts_step/magnet_spacer_D9x5.35_(6061).step
8.99 x 7.65 x 9.00 mm
