wisehyun-2/my_robot_project/(list of files, cad)

Other CAD files:
robot_cad_v5/export/links_stl/wheel_R.stl
robot_cad_v5/manufacturing/step/shank_R.step
robot_cad_v5/manufacturing/v2/step/hip_plate_R.step
robot_cad_v5/export/parts_step/shell_mid_L.step
robot_cad_v5/manufacturing/v2/step/magnet_spacer.step
robot_cad_v5/export/links_stl/femur_L.stl
robot_cad_v5/manufacturing/step/hub_insert_knee_L.step
robot_cad_v5/export/links_stl/tibia_R.stl
wheeled_biped/models/wheelbiped_v5/meshes/left_wheel_link.stl
robot_cad_v5/manufacturing/step/thigh_L.step
robot_cad_v5/manufacturing/step/hub_insert_hip_R.step
robot_cad_v5/export/parts_step/shank_L.step
robot_cad_v5/manufacturing/step/knee_cap_L.step
robot_cad_v5/export/parts_step/hub_insert_knee_R.step
robot_cad_v5/manufacturing/step/hub_ring_L.step
robot_cad_v5/export/parts_step/hub_insert_hip_L.step
robot_cad_v5/export/parts_step/hub_insert_knee_L.step
robot_cad_v5/export/parts_step/hub_flange_R.step
robot_cad_v5/export/parts_step/shell_rear_L.step
robot_cad_v5/export/parts_step/thigh_R.step
robot_cad_v5/export/parts_step/hub_insert_hip_R.step
robot_cad_v5/export/parts_step/rim_L.step
robot_cad_v5/export/parts_step/shell_front_L.step
robot_cad_v5/export/parts_step/saddle_R.step
robot_cad_v5/export/parts_step/hub_ring_knee_L.step
robot_cad_v5/export/parts_step/spine_tube_B.step
robot_cad_v5/export/parts_step/hub_ring_hip_L.step
robot_cad_v5/export/parts_step/knee_cap_R.step
robot_cad_v5/export/parts_step/hip_plate_L.step
robot_cad_v5/export/parts_step/hip_plate_R.step
robot_cad_v5/export/parts_step/rail_B.step
robot_cad_v5/export/parts_step/rail_F.step
robot_cad_v5/export/parts_step/cup_hip_R.step
robot_cad_v5/export/parts_step/cup_knee_L.step
robot_cad_v5/export/parts_step/knee_cap_L.step
robot_cad_v5/export/parts_step/clamp_ring_stator_D45_t2.0_SUS304.step
robot_cad_v5/export/parts_step/spine_tube_F.step
robot_cad_v5/export/parts_step/cup_wheel_R.step
robot_cad_v5/export/parts_step/hub_ring_hip_R.step
robot_cad_v5/export/parts_step/hub_ring_knee_R.step
robot_cad_v2/export/parts_step/clamp_ring_output_D27_t1.5_SUS304.step
robot_cad_v2/export/parts_step/clamp_ring_stator_D45_t1.5_SUS304.step
robot_cad_v2/export/parts_step/magnet_spacer_D9x4.5_(6061).step
robot_cad_v5/export/WheelBiped_v5.f3d
robot_cad_v5/export/parts_stl/battery_tray_L.stl
robot_cad_v5/export/parts_stl/battery_tray_R.stl
robot_cad_v5/export/parts_stl/clamp_ring_output_D27_t2.0_SUS304.stl
robot_cad_v5/export/parts_stl/clamp_ring_stator_D45_t2.0_SUS304.stl
robot_cad_v5/export/parts_stl/cup_hip_L.stl
robot_cad_v5/export/parts_stl/cup_hip_R.stl
robot_cad_v5/export/parts_stl/cup_knee_L.stl
robot_cad_v5/export/parts_stl/cup_knee_R.stl
robot_cad_v5/export/parts_stl/cup_wheel_L.stl
robot_cad_v5/export/parts_stl/cup_wheel_R.stl
robot_cad_v5/export/parts_stl/electronics_deck_L.stl
robot_cad_v5/export/parts_stl/electronics_deck_R.stl
robot_cad_v5/export/parts_stl/hip_plate_L.stl
robot_cad_v5/export/parts_stl/hip_plate_R.stl
robot_cad_v5/export/parts_stl/hub_flange_L.stl
robot_cad_v5/export/parts_stl/hub_flange_R.stl
robot_cad_v5/export/parts_stl/hub_insert_hip_L.stl
robot_cad_v5/export/parts_stl/hub_insert_hip_R.stl
robot_cad_v5/export/parts_stl/hub_insert_knee_L.stl
robot_cad_v5/export/parts_stl/hub_insert_knee_R.stl
robot_cad_v5/export/parts_stl/hub_ring_hip_L.stl
robot_cad_v5/export/parts_stl/hub_ring_hip_R.stl
robot_cad_v5/export/parts_stl/hub_ring_knee_L.stl
robot_cad_v5/export/parts_stl/hub_ring_knee_R.stl
robot_cad_v5/export/parts_stl/knee_cap_L.stl
robot_cad_v5/export/parts_stl/knee_cap_R.stl
robot_cad_v5/export/parts_stl/rail_B.stl
robot_cad_v5/export/parts_stl/rail_F.stl
robot_cad_v5/export/parts_stl/rim_L.stl
robot_cad_v5/export/parts_stl/rim_R.stl
robot_cad_v5/export/parts_stl/saddle_L.stl
robot_cad_v5/export/parts_stl/saddle_R.stl
robot_cad_v5/export/parts_stl/shank_L.stl
robot_cad_v5/export/parts_stl/shank_R.stl
robot_cad_v5/export/parts_stl/shell_front_L.stl
robot_cad_v5/export/parts_stl/shell_front_R.stl
robot_cad_v5/export/parts_stl/shell_mid_L.stl
robot_cad_v5/export/parts_stl/shell_mid_R.stl
robot_cad_v5/export/parts_stl/shell_rear_L.stl
robot_cad_v5/export/parts_stl/shell_rear_R.stl
robot_cad_v5/export/parts_stl/spine_tube_B.stl
robot_cad_v5/export/parts_stl/spine_tube_F.stl
robot_cad_v5/export/parts_stl/splice_tabs.stl
robot_cad_v5/export/parts_stl/thigh_L.stl
robot_cad_v5/export/parts_stl/thigh_R.stl
robot_cad_v5/export/parts_stl/top_plate.stl
