wisehyun-2/my_robot_project/robot_cad_v5/manufacturing/drawings/shell_mid.pdf

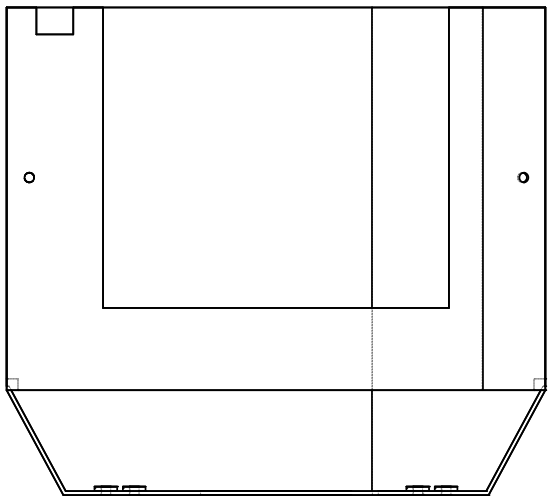
[picture p91: figure]
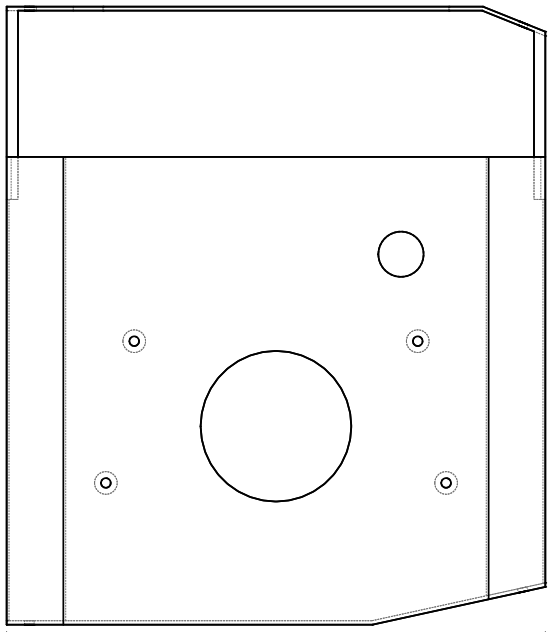
[picture p92: figure]

## +y(바깥)에서 본 그림

## 위(+z)에서 본 그림

## 앞(-x, 스위치 쪽)에서 본 그림

190.0 (x)

218.0 (z)

172.0 (y)

주기

1. 단위 mm, 3각법이 아닌 CAD 축 방향 그림(그림 이름 참고, 로봇 앞 = -x). 전체 크기만 적었다 — 형상의 원본은 STEP (export/parts_step/shell_mid_R, shell_mid_L.step, CAD 좌표).
2. 부피 114.4 cm³. v4 부품에 hip 판 나사 4곳 안쪽 받침 Ø8 × 1.6(셸 벽에서 hip 판 웹 면까지, 조이면 벽이 휘던 1.6 틈을 메움) — 나사 ISO 7380 M3 × 8(사용자 11-08); 윗면 위판 구멍 뒤 x +78, 좌우 정중앙에 로커 스위치 구멍 19 × 13(긴 변 좌우 방향, 좌우 조각에 반씩; 사용자 11-09, switch_v5.py)(robot_cad_v4 코드로 만듦).
3. 왼쪽 부품은 거울상 — export/parts_step/shell_mid_L.step으로 따로 만든다.
품명 | 몸통 셸 가운데 (hip) (shell_mid) | 도번 | WBv5-S07
재질 | PETG 진회색 | 수량 | 왼 1 + 오른 1
공정 | 3D 프린트 25 %, 바깥 면을 위로 | 척도 | 1:2.5
후처리 | - | 투상 | 3각법
STEP | ../export/parts_step/shell_mid_R.step | 일반 공차 | KS B ISO 2768-mK / 출력 ±0.2
프로젝트 | WheelBiped v5 (robot_cad_v5) | 작성일 | 2026-11-08
