wisehyun-2/my_robot_project/robot_cad_v5/manufacturing/drawings/hub_flange.pdf

## +y(바깥)에서 본 그림

## 위(+z)에서 본 그림

## 앞(-x, 스위치 쪽)에서 본 그림

46.0 (x)

46.0 (z)

19.0 (y)

주기

1. 단위 mm, 3각법이 아닌 CAD 축 방향 그림(그림 이름 참고, 로봇 앞 = -x). 전체 크기만 적었다 — 형상의 원본은 STEP (export/parts_step/hub_flange_R, hub_flange_L.step, CAD 좌표).
2. 부피 15.4 cm³. v4 부품에서 평행핀 구멍 3개(Ø3, 출력 쪽 면에서) 깊이 7.0 → 8.0 — 핀 Ø3 × 10을 바닥까지 넣으면 2.0 나와 출력부 핀 구멍(깊이 3)에 여유 1.0, 스피곳 Ø11.8 높이 1.3 → 1.0(출력부 홈 1.5 바닥에서 0.5 뜸; 사용자 11-08)(robot_cad_v4 코드로 만듦).
3. 왼쪽 부품은 거울상 — export/parts_step/hub_flange_L.step으로 따로 만든다.
품명 | 바퀴 허브 플랜지 (hub_flange) | 도번 | WBv5-S04
재질 | PETG | 수량 | 왼 1 + 오른 1
공정 | 3D 프린트 100 %, 모터 쪽 면을 바닥에, M3 × 5.7 인서트 6 | 척도 | 1:1
후처리 | - | 투상 | 3각법
STEP | ../export/parts_step/hub_flange_R.step | 일반 공차 | KS B ISO 2768-mK / 출력 ±0.2
프로젝트 | WheelBiped v5 (robot_cad_v5) | 작성일 | 2026-11-08
