wisehyun-2/my_robot_project/robot_cad_v5/manufacturing/drawings/rim.pdf

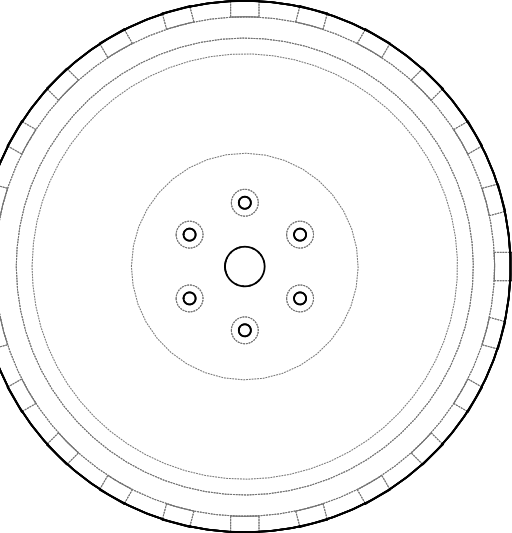
[picture p93: figure]

## +y(바깥)에서 본 그림

## 위(+z)에서 본 그림

## 앞(-x, 스위치 쪽)에서 본 그림

150.2 (x)

150.2 (z)

44.3 (y)

주기

1. 단위 mm, 3각법이 아닌 CAD 축 방향 그림(그림 이름 참고, 로봇 앞 = -x). 전체 크기만 적었다 — 형상의 원본은 STEP (export/parts_step/rim_R, rim_L.step, CAD 좌표).
2. 부피 259.7 cm³. v4 부품에서 등록 홈만 Ø11.2 × 3.2 → × 3.6 — 허브 쪽 면을 바닥에 두고 출력해 홈 바닥이
브리지로 처져도 허브 플랜지의 Ø11 × 3 턱이 바닥에 먼저 닿지 않게(사용자 11-08)(robot_cad_v4 코드로 만듦).
3. 왼쪽 부품은 거울상 — export/parts_step/rim_L.step으로 따로 만든다.
품명 | 바퀴 림 (한 조각) (rim) | 도번 | WBv5-S05
재질 | PETG | 수량 | 왼 1 + 오른 1
공정 | 3D 프린트 벽 6겹 · 채움 40 %, 허브 쪽 평면을 바닥에 | 척도 | 1:2
후처리 | - | 투상 | 3각법
STEP | ../export/parts_step/rim_R.step | 일반 공차 | KS B ISO 2768-mK / 출력 ±0.2
프로젝트 | WheelBiped v5 (robot_cad_v5) | 작성일 | 2026-11-08
