wisehyun-2/my_robot_project/robot_cad_v5/manufacturing/v2/drawings/magnet_spacer.pdf

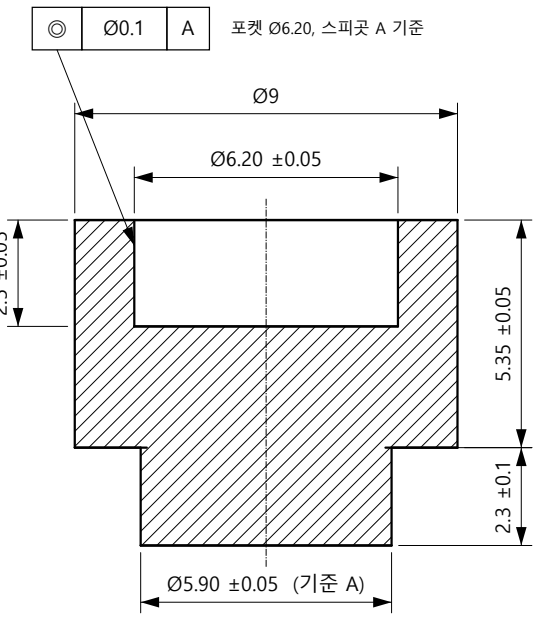
[picture p94: figure]
포켓 Ø6.20, 스피곳 A 기준

## 단면 (축 포함) 6:1

2.5 ±0.05

주기
1. 단위 mm, 3각법.
2. 지시 없는 공차: KS B ISO 2768-mK (치수·각도 m급, 기하 K급).
3. 모서리 버 제거, 지시 없는 바깥 모서리 C0.2~0.5.
4. 지시 없는 형상·치수는 같은 이름의 STEP 파일 기준.
5. 재질 비자성 필수(AL6061-T6). 강·스테인리스 금지.
6. Ø6.20 포켓: AKE 부속품 자석 Ø6 × 2.5(공차 미표기, ±0.1로 봄)를 에폭시로 붙임(로터 자석 자리 대신).
7. Ø5.90 스피곳(A): AKE 로터의 빈 자석 자리(Ø6)에 접착. 자리 실측 뒤 그 값 -0.10으로 조정 가능.
8. 높이 5.35가 자석 윗면–moteus 기판 거리(2.55)를 정함: 엔코더 칩 자기장 35~70 mT.
9. 자석 쪽 끝면은 축에 직각, 버·턱 없이.
품명 | 자석 스페이서 (magnet spacer Ø9 × 5.35) | 도번 | WBv2-M02
재질 | AL6061-T6 환봉 Ø10 (비자성) | 수량 | 6개
공정 | 선반 | 척도 | 6:1
후처리 | 없음(탈지) | 투상 | 3각법
STEP | step/magnet_spacer.step | 일반 공차 | KS B ISO 2768-mK
프로젝트 | WheelBiped v2 (robot_cad_v2) | 작성일 | 2026-10-29
