wisehyun-2/my_robot_project/robot_cad_v5/manufacturing/v2/drawings/rail.pdf

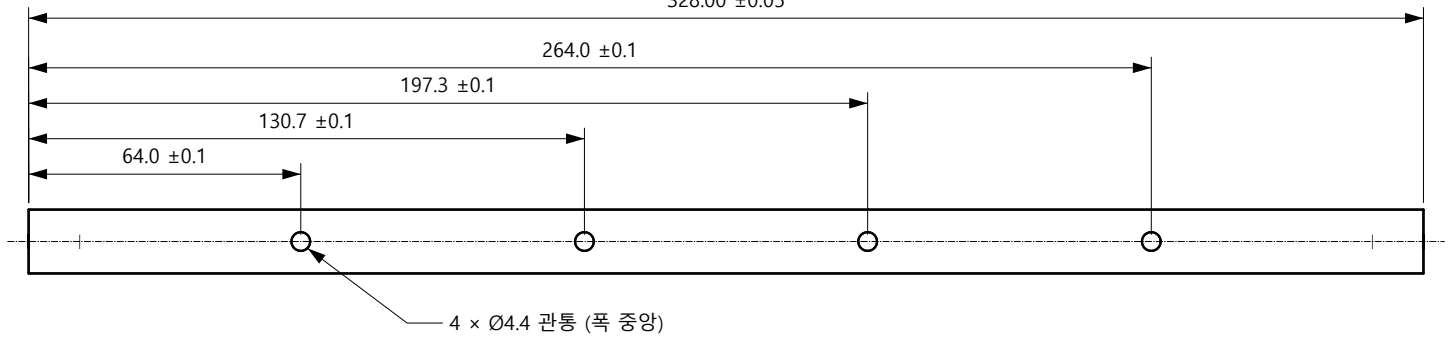
[picture p95: figure]

## 위에서 본 그림 0.6:1

328.00 ±0.05

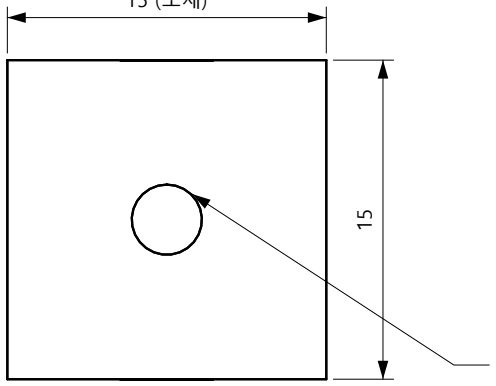
[picture p96: figure]

끝면 3:1

15 (소재)

### 양 끝 M4 탭 깊이 9 (기초 Ø3.3 깊이 12)

주기
1. 단위 mm, 3각법.
2. 지시 없는 공차: KS B ISO 2768-mK (치수·각도 m급, 기하 K급).
3. 모서리 버 제거, 지시 없는 바깥 모서리 C0.2~0.5.
4. 지시 없는 형상·치수는 같은 이름의 STEP 파일 기준.
5. 시판 6061-T6 각봉 15 × 15(통짜)를 잘라 양 끝 면삭, 양 끝 중심에 M4 탭.
6. 길이 328.00 ±0.05: 척추 봉(WBv2-M05) 2개와 함께 4개를 같은 값으로 같은 세팅에서 맞춤.
7. Ø4.4 관통 4곳: 위에서 아래로 한 번에(폭 중앙, 위치 ±0.1). 윗판 M4×25 관통 볼트 자리.
8. 양 끝면 직각 0.05, 버 제거, 탭 입구 C0.3. 탭은 단면 중심 Ø0.1 안.
9. hip 판 쪽에서 ISO 10642 M4×12가 약 7.5 mm 물림.
10. 6061-T6을 구할 수 없으면 6063-T5/T6 사용 가능(강도 재계산 통과, calc/strength.md 4절).
품명 | 위 레일 (rail 15 × 15, 통짜) | 도번 | WBv2-M06
재질 | AL6061-T6 각봉 15 × 15 (6063-T5/T6 허용) | 수량 | 2개
공정 | 3축 MCT (끝면 면삭 + 양 끝 M4 탭 + 구멍) | 척도 | 0.6:1, 3:1
후처리 | 없음 | 투상 | 3각법
STEP | step/rail.step | 일반 공차 | KS B ISO 2768-mK
프로젝트 | WheelBiped v2 (robot_cad_v2) | 작성일 | 2026-10-29
