wisehyun-2/my_robot_project/robot_cad_v5/manufacturing/v2/drawings/clamp_ring_stator.pdf

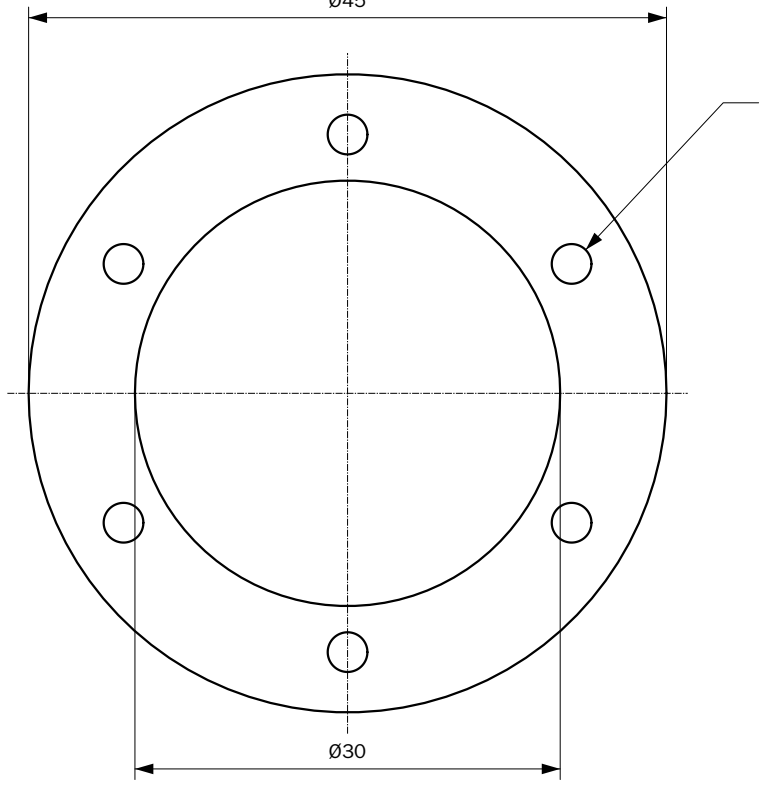
[picture p97: figure]

## 위에서 본 그림 2:1

Ø45

### 6 × Ø2.8 관통, PCD 36.5, 60° 등간격

주기
1. 단위 mm. 두께 2 (소재 SUS304 2B 2t, 평판).
2. 지시 없는 공차 ±0.1 (레이저, KS B ISO 2768-m 안), 평탄도 0.1. 두께는 소재 공차.
3. 양면 버·드로스 제거, 질소 절단 권장(산화 변색 최소).
4. 같은 이름의 DXF(dxf/) 또는 STEP(step/) 사용.
5. knee·wheel PETG 판 바깥 홈, 고정링 M2.5×8 머리 밑.
6. 안쪽 살(구멍–안지름) 1.85 mm, 바깥 살 2.85 mm: 2t 레이저가 어려우면 와이어커팅(워터젯은 작은 구멍 정밀도가 낮아 쓰지 않음).
품명 | 고정링 클램프 링 (clamp ring stator Ø45) | 도번 | WBv2-M08
재질 | SUS304 2B 2t | 수량 | 4개
공정 | 판금 레이저 절단 (대안: 와이어커팅) | 척도 | 2:1
후처리 | 없음(버 제거) | 투상 | 3각법
STEP | step/clamp_ring_stator.step | 일반 공차 | KS B ISO 2768-mK
프로젝트 | WheelBiped v2 (robot_cad_v2) | 작성일 | 2026-10-29
