wisehyun-2/my_robot_project/robot_cad_v5/manufacturing/explain/assembly/hip/02_s2_a_before.png

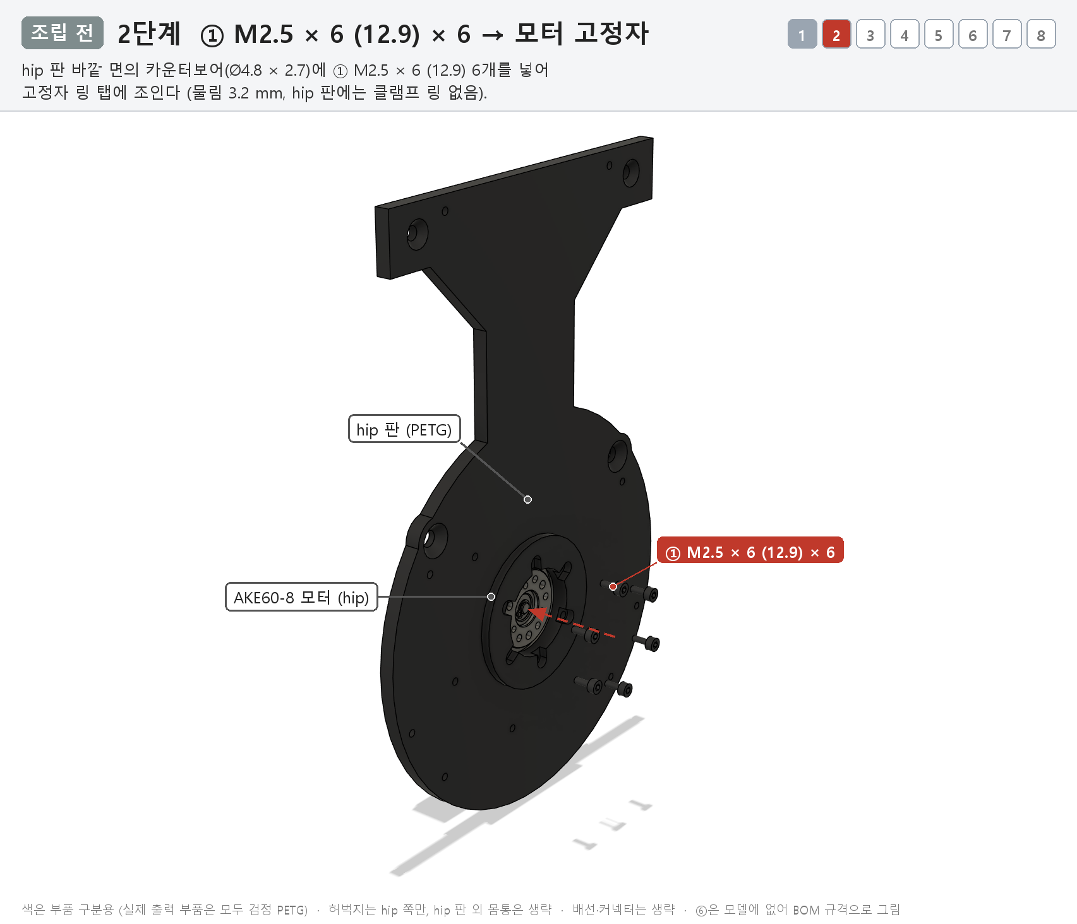
robot_cad_v5/manufacturing/explain/assembly/hip/02_s2_a_before.png
