wisehyun-2/my_robot_project/robot_cad_v5/manufacturing/explain/assembly/hip/05_s5_a_before.png

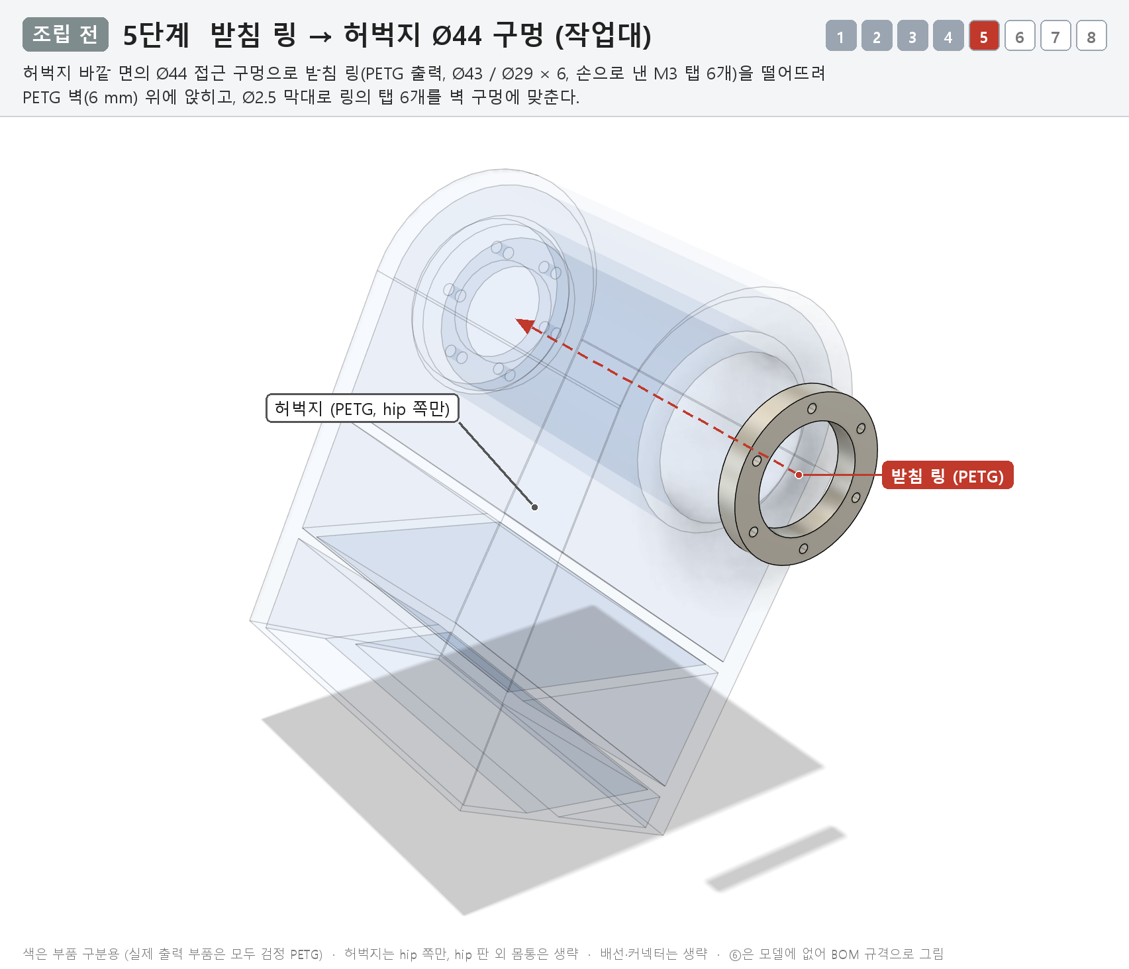
robot_cad_v5/manufacturing/explain/assembly/hip/05_s5_a_before.png
