wisehyun-2/my_robot_project/robot_cad_v5/manufacturing/explain/assembly/hip/06_s6_a_before.png

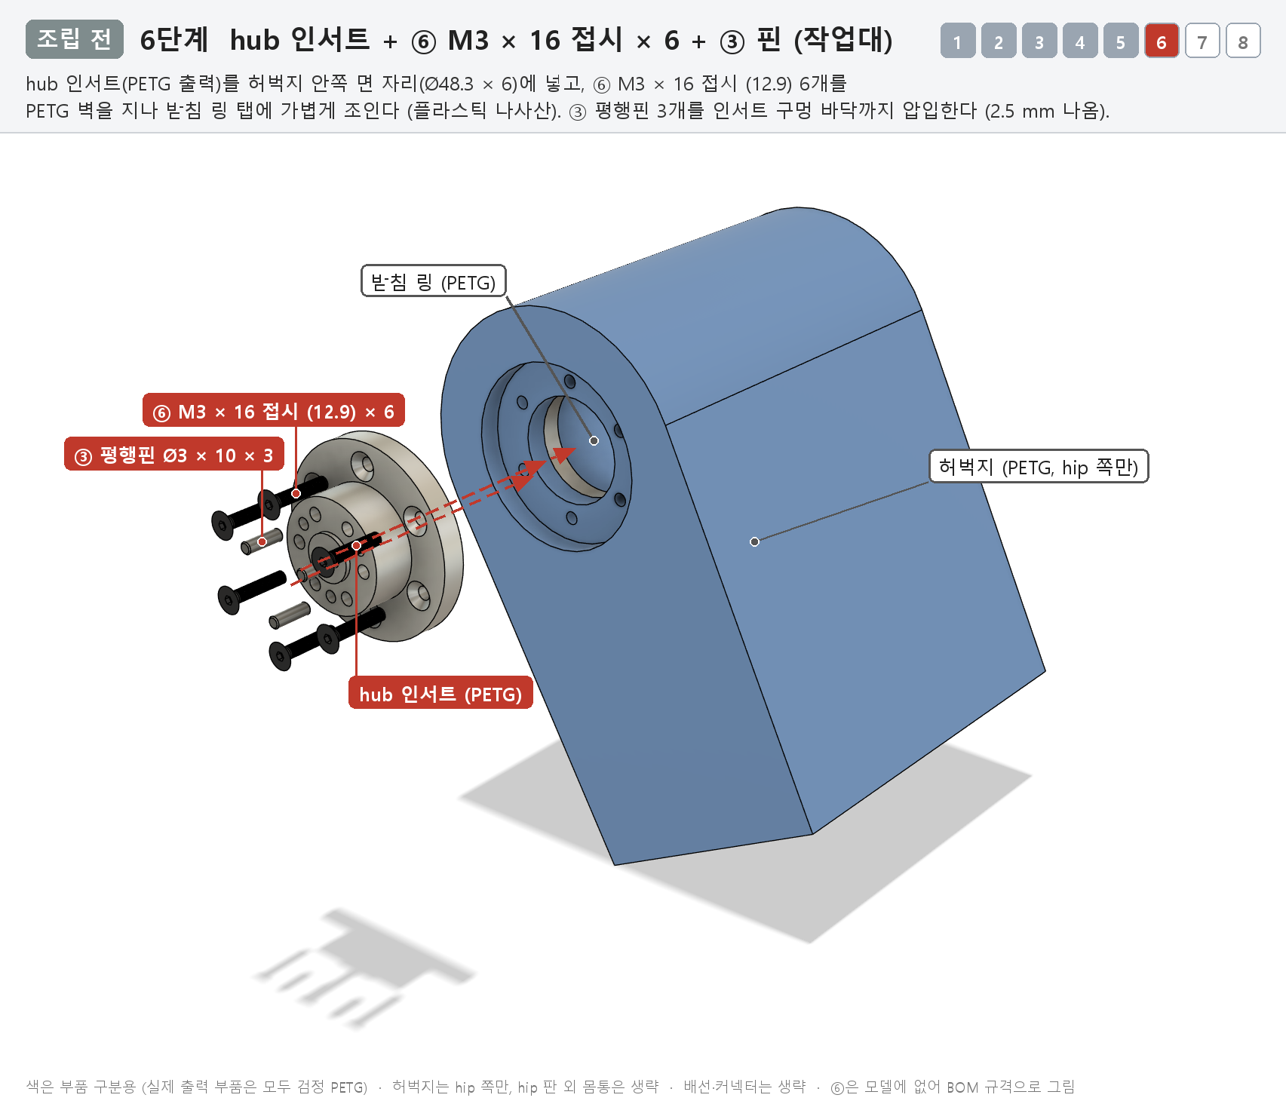
robot_cad_v5/manufacturing/explain/assembly/hip/06_s6_a_before.png
