wisehyun-2/my_robot_project/robot_cad_v5/manufacturing/explain/assembly/hip/07_s7_b_after.png

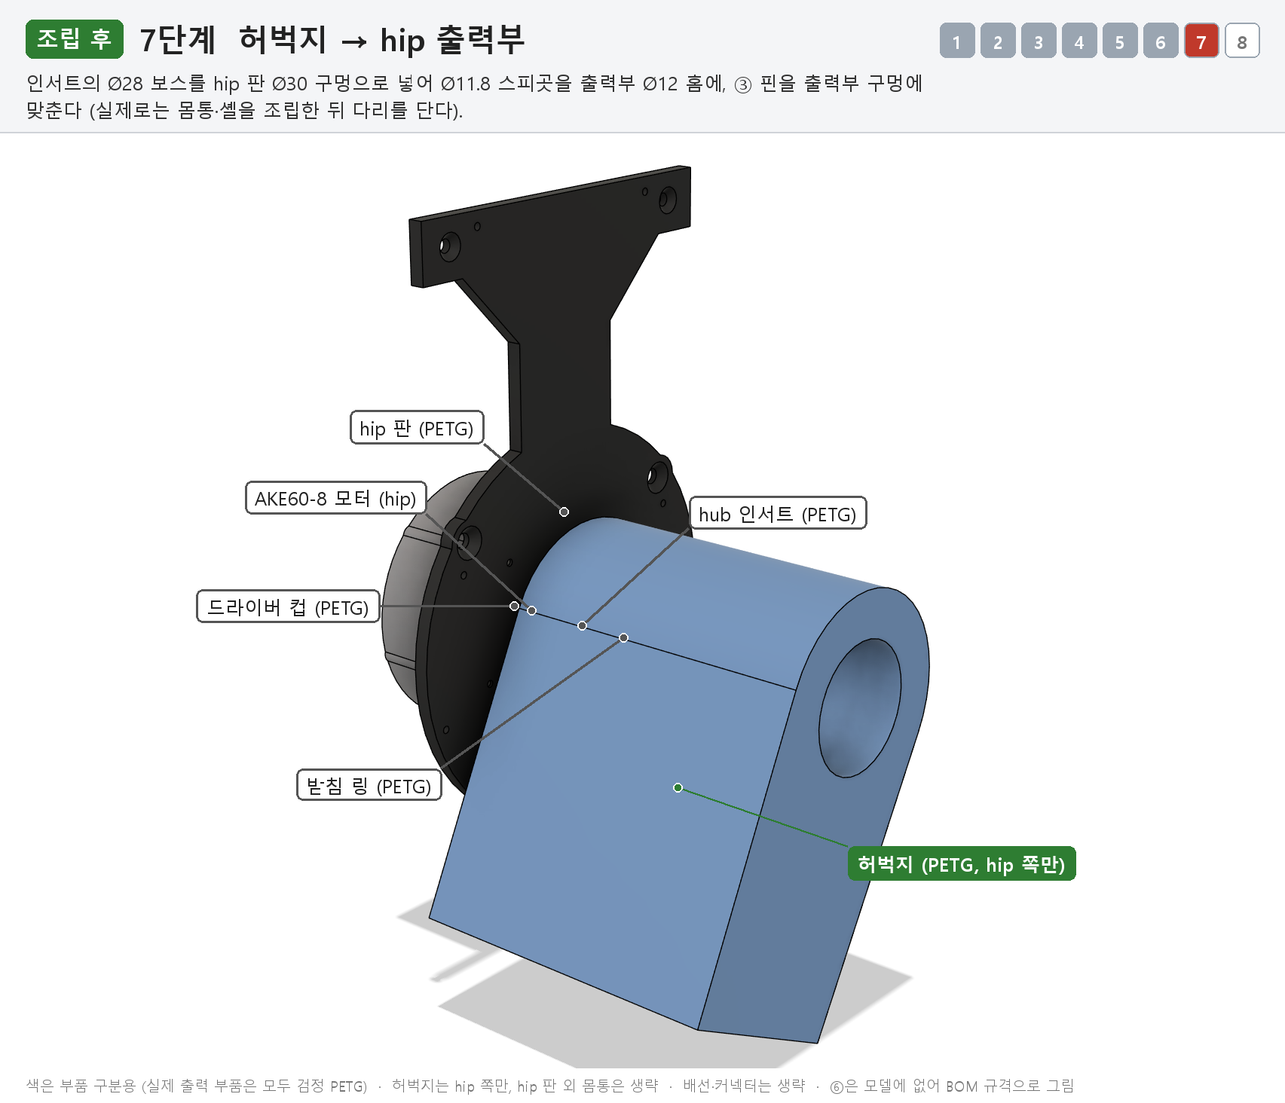
robot_cad_v5/manufacturing/explain/assembly/hip/07_s7_b_after.png
