wisehyun-2/my_robot_project/robot_cad_v5/manufacturing/explain/assembly/hip/08_s8_b_after.png

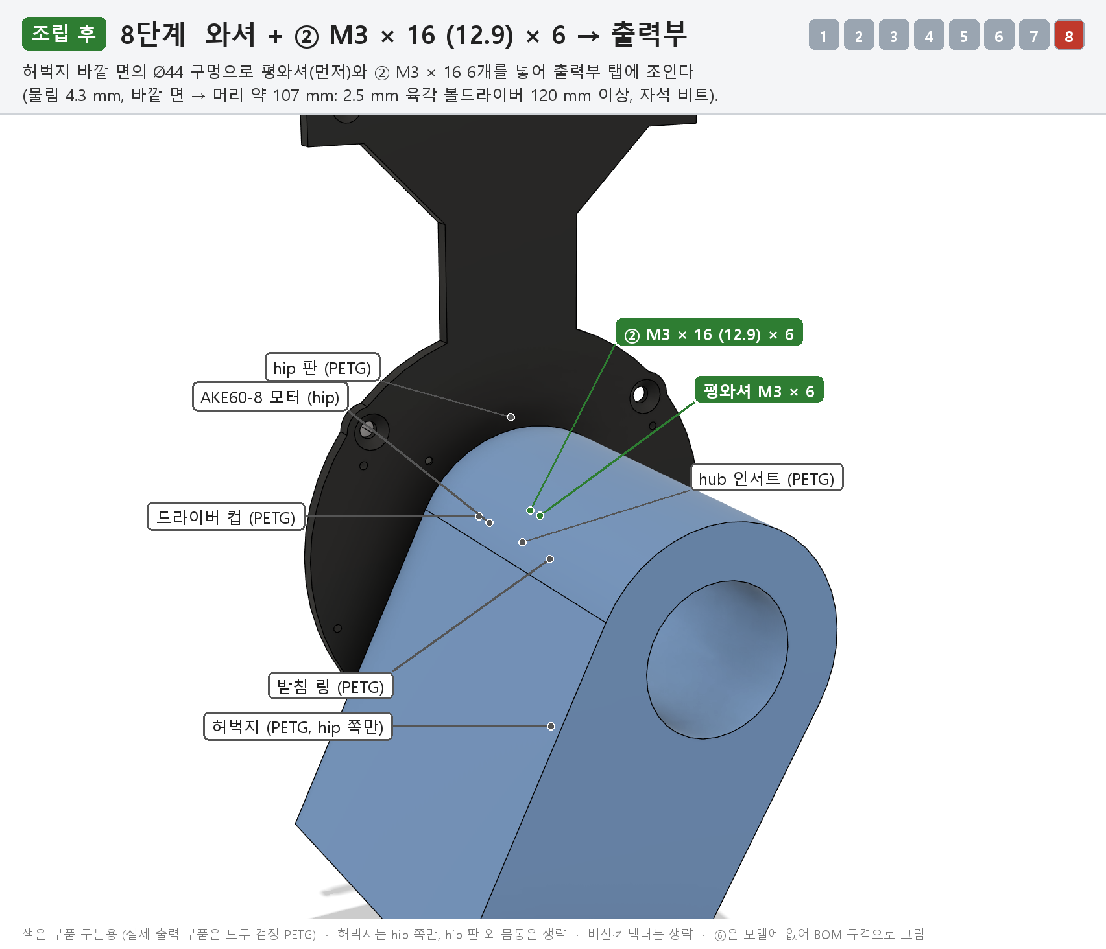
robot_cad_v5/manufacturing/explain/assembly/hip/08_s8_b_after.png
