wisehyun-2/my_robot_project/robot_cad_v5/manufacturing/explain/assembly/hip/11_cut2.png

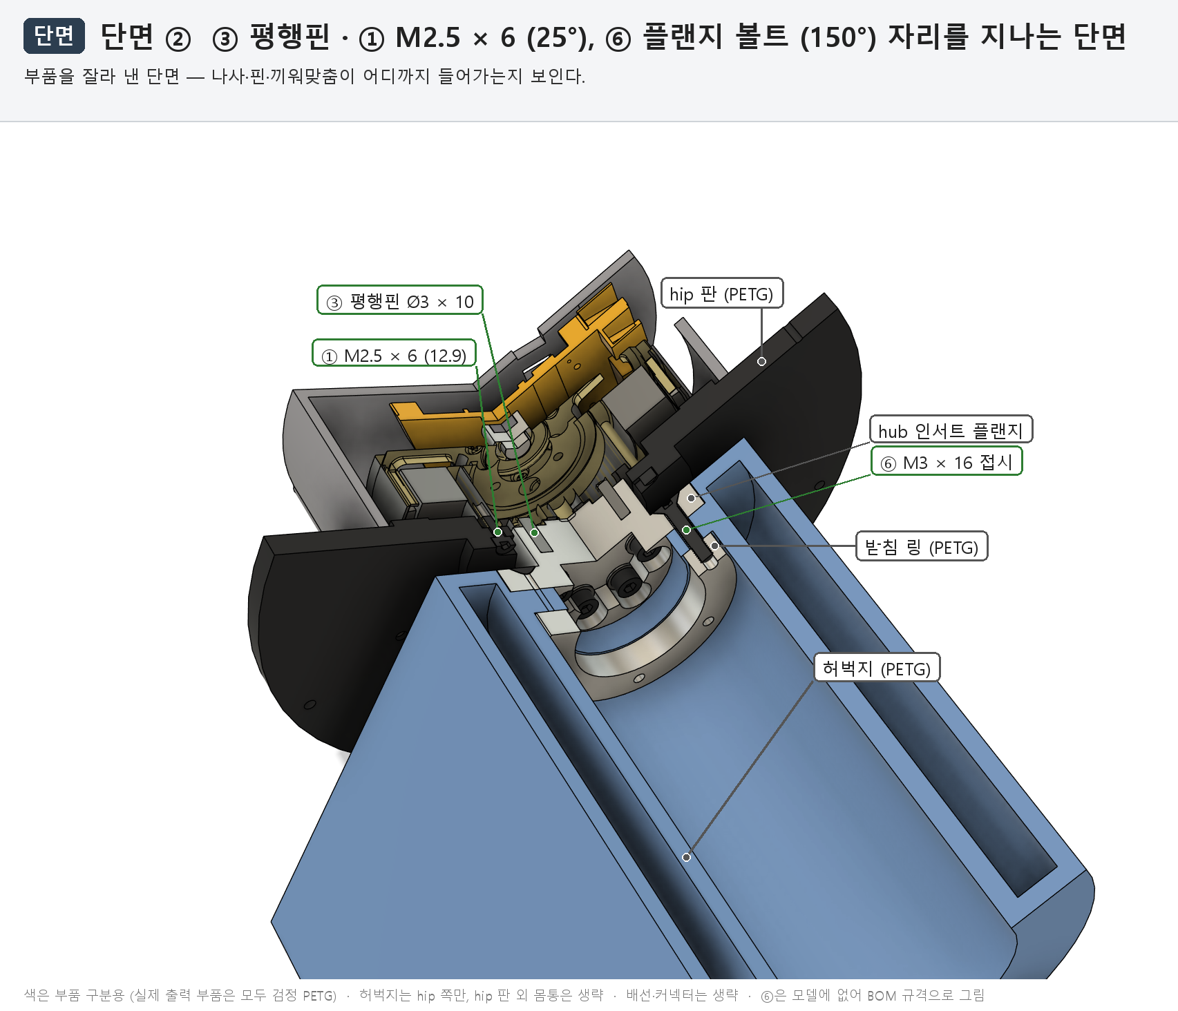
robot_cad_v5/manufacturing/explain/assembly/hip/11_cut2.png
