wisehyun-2/my_robot_project/robot_cad_v5/manufacturing/explain/assembly/knee/08_s8_a_before.png

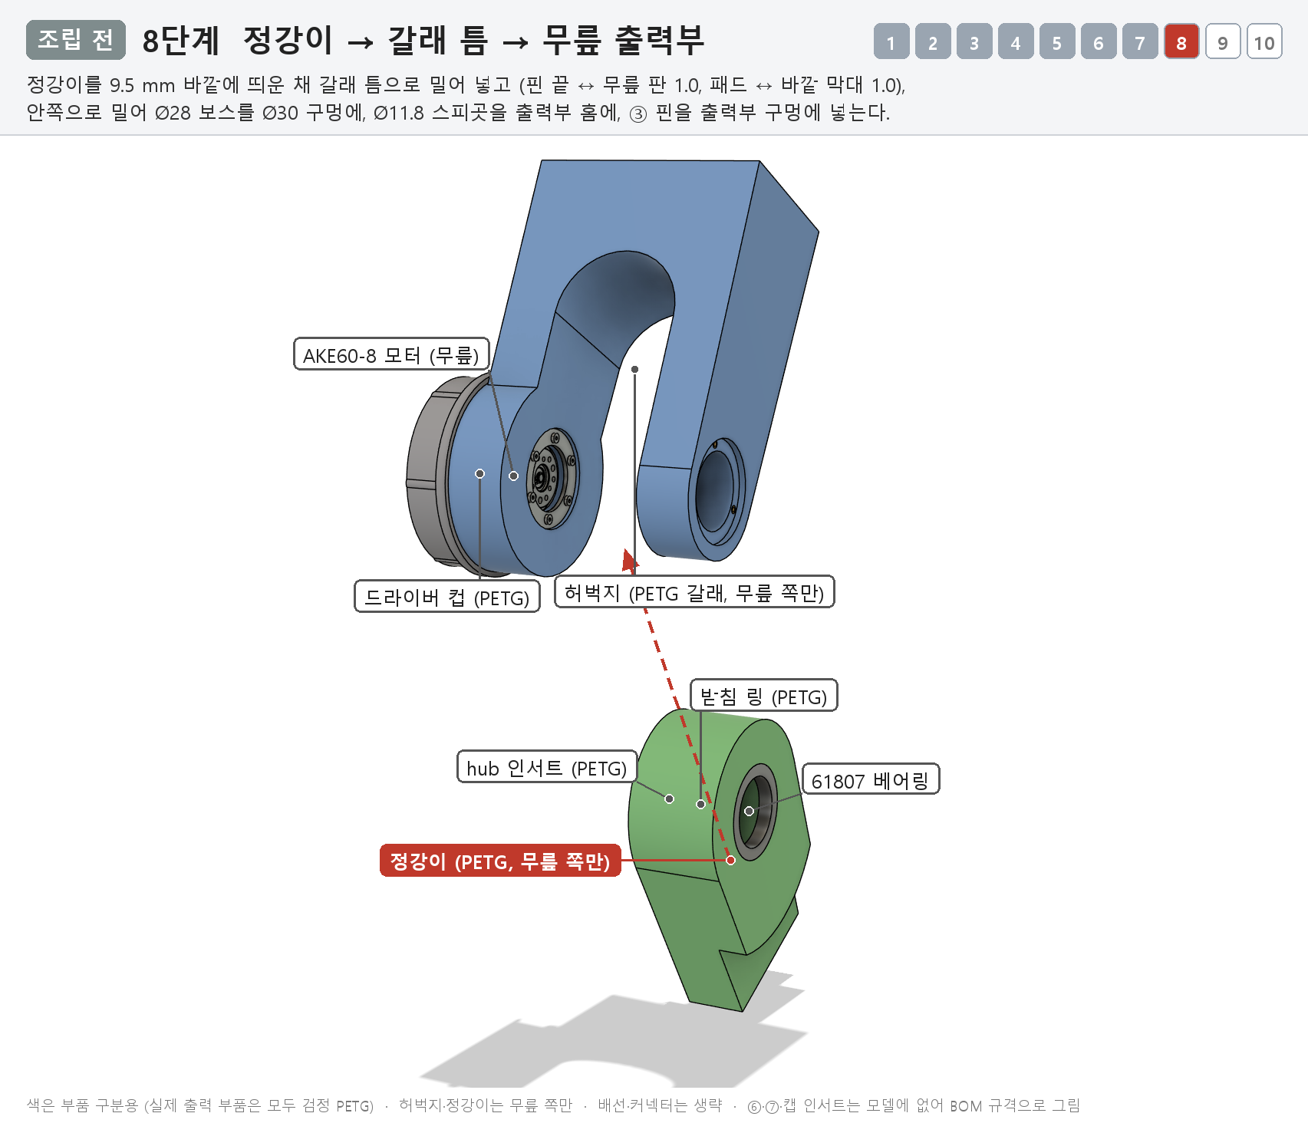
robot_cad_v5/manufacturing/explain/assembly/knee/08_s8_a_before.png
