wisehyun-2/my_robot_project/robot_cad_v5/manufacturing/explain/assembly/knee/10_s10_b_after.png

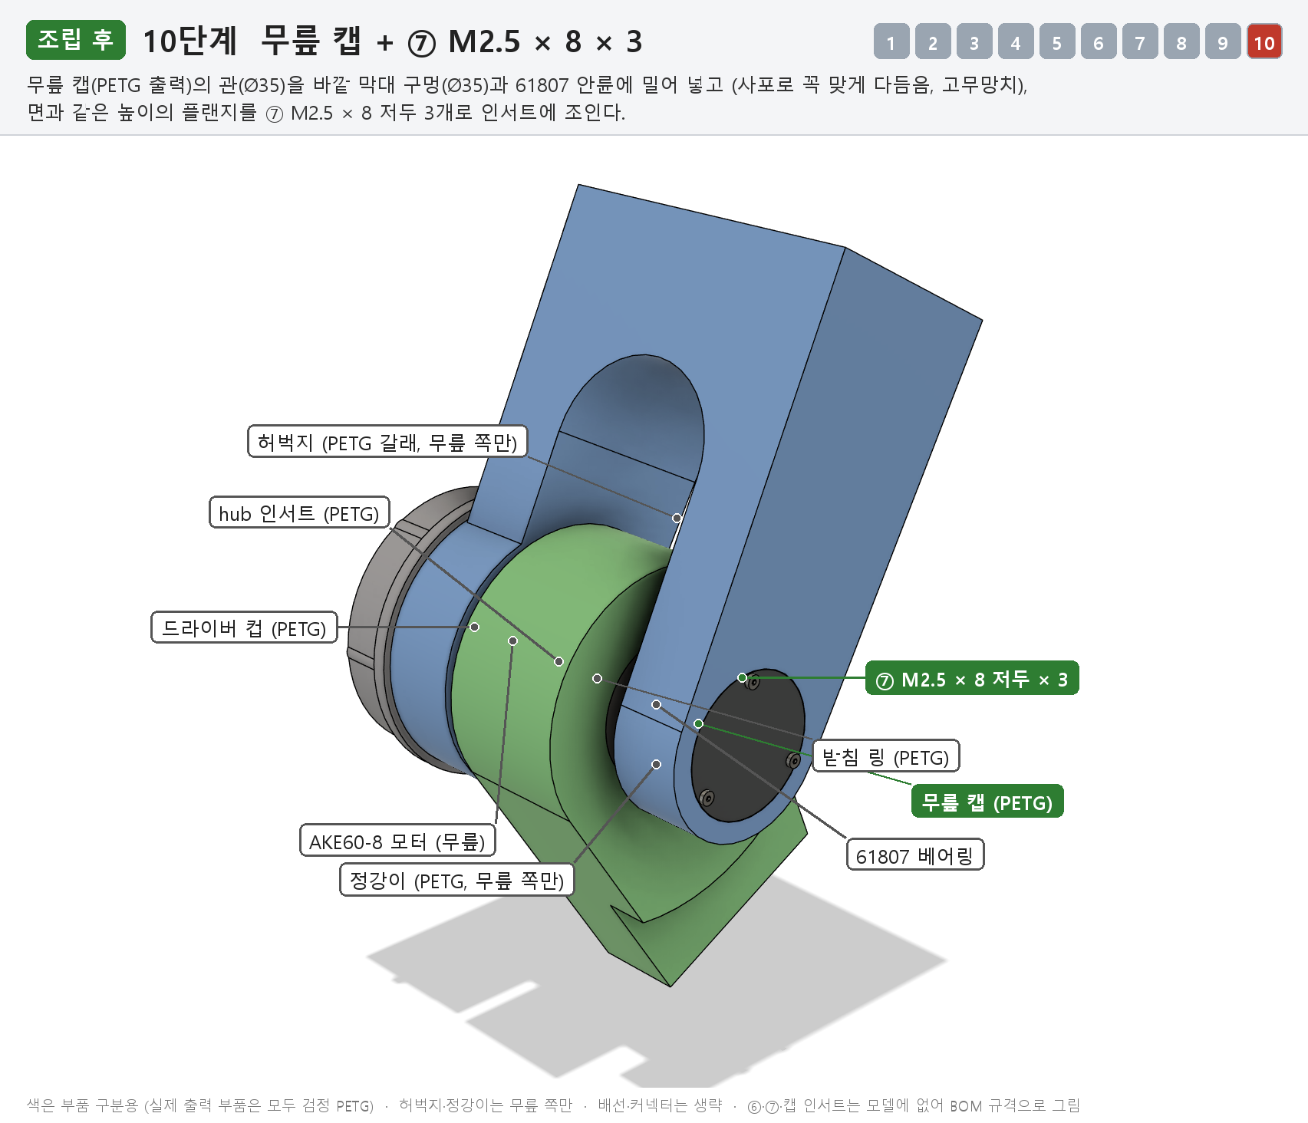
robot_cad_v5/manufacturing/explain/assembly/knee/10_s10_b_after.png
