wisehyun-2/my_robot_project/robot_cad_v5/manufacturing/explain/assembly/knee/11_done.png

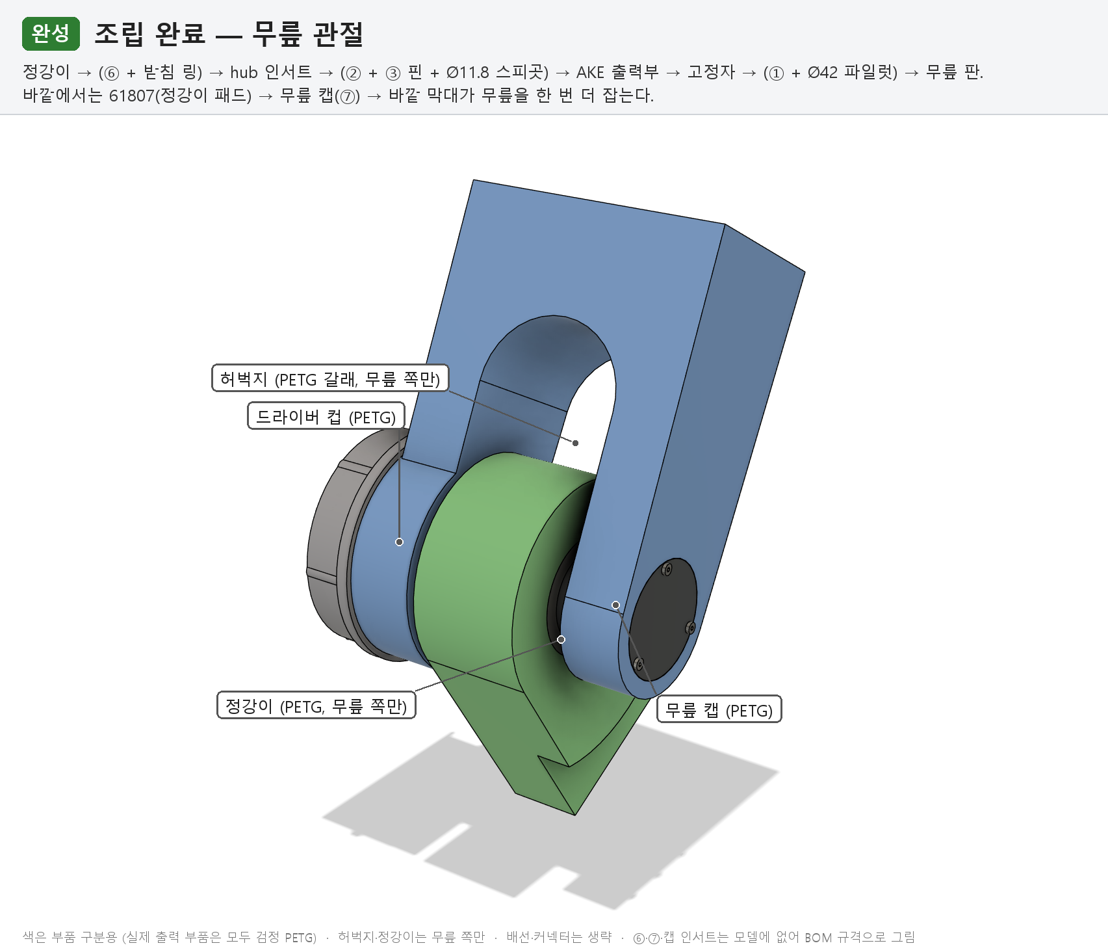
robot_cad_v5/manufacturing/explain/assembly/knee/11_done.png
