wisehyun-2/my_robot_project/robot_cad_v5/manufacturing/explain/assembly/knee/12_cut1.png

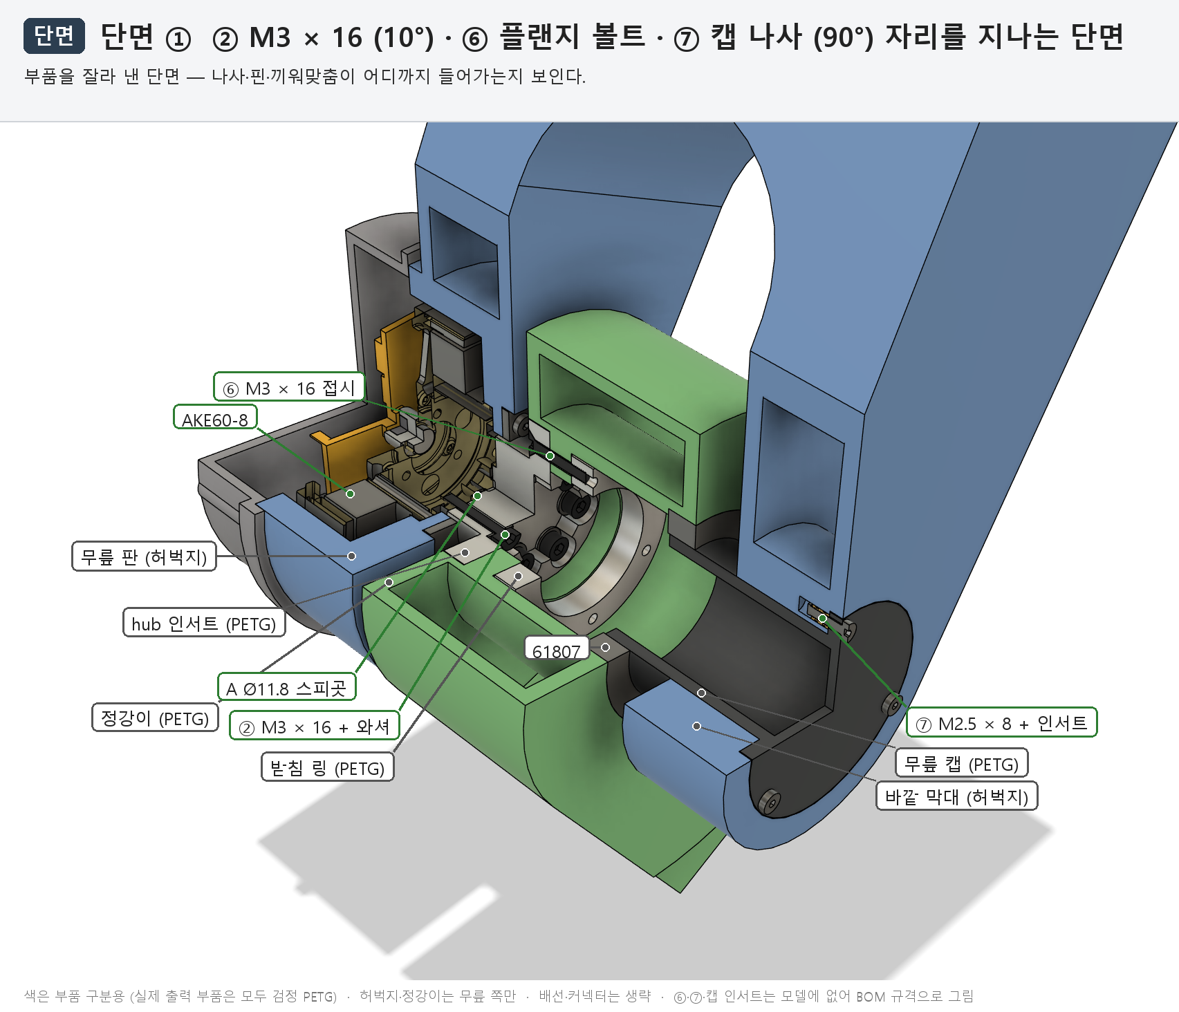
robot_cad_v5/manufacturing/explain/assembly/knee/12_cut1.png
