wisehyun-2/my_robot_project/robot_cad_v5/manufacturing/explain/assembly/wheel/01_s1_b_after.png

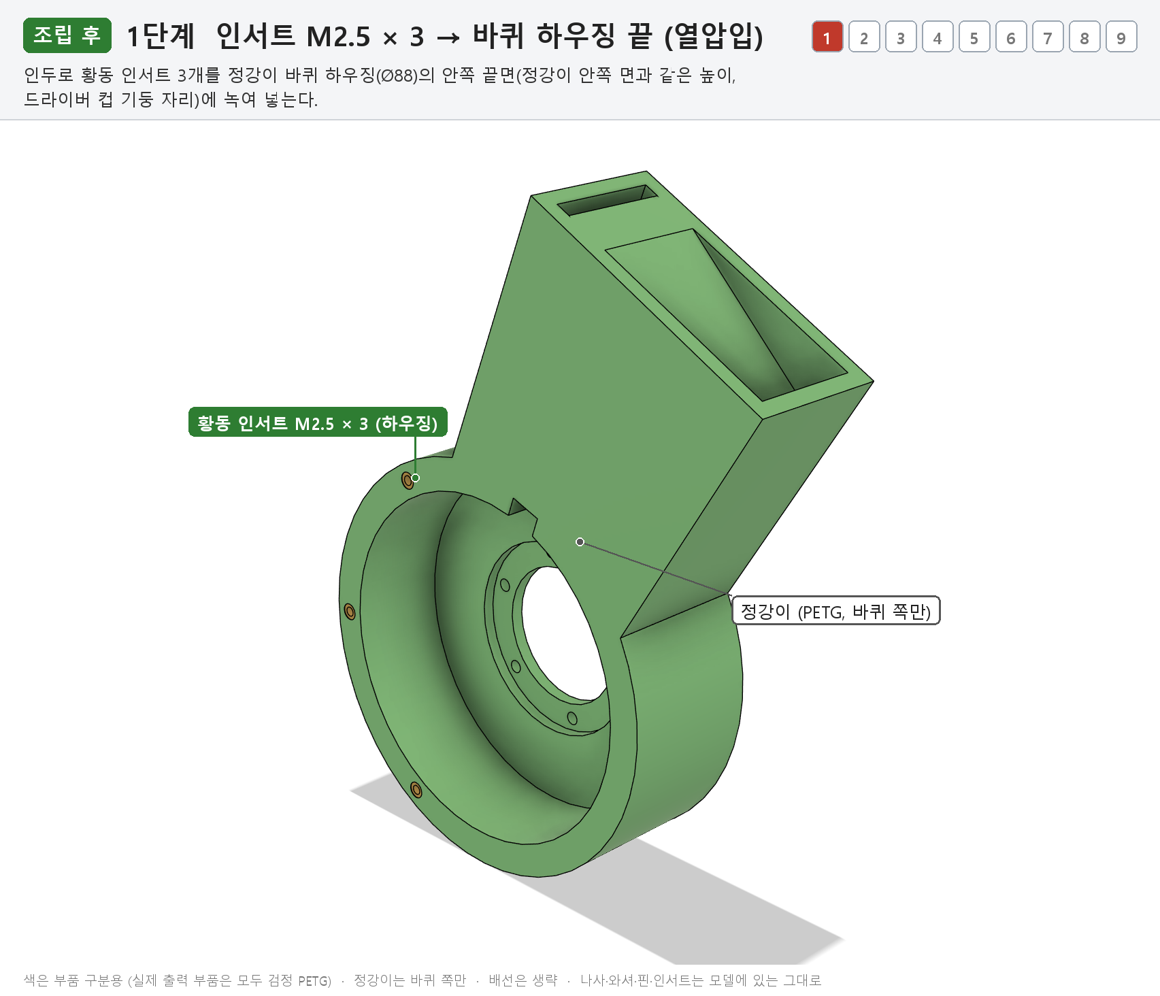
robot_cad_v5/manufacturing/explain/assembly/wheel/01_s1_b_after.png
