wisehyun-2/my_robot_project/robot_cad_v5/manufacturing/explain/assembly/wheel/11_cut1.png

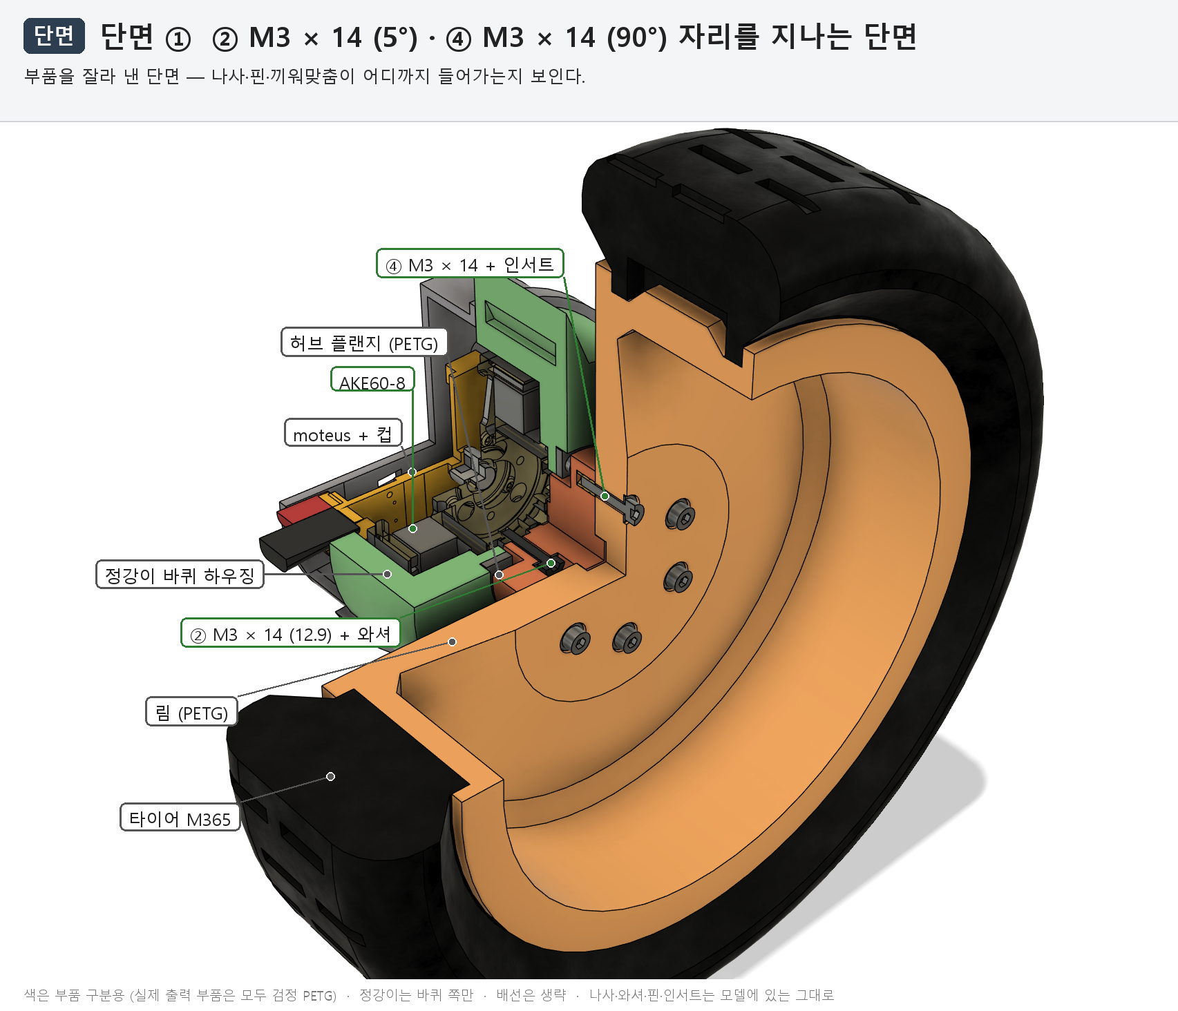
robot_cad_v5/manufacturing/explain/assembly/wheel/11_cut1.png
