wisehyun-2/my_robot_project/robot_cad_v5/manufacturing/explain/assembly/wheel/12_cut2.png

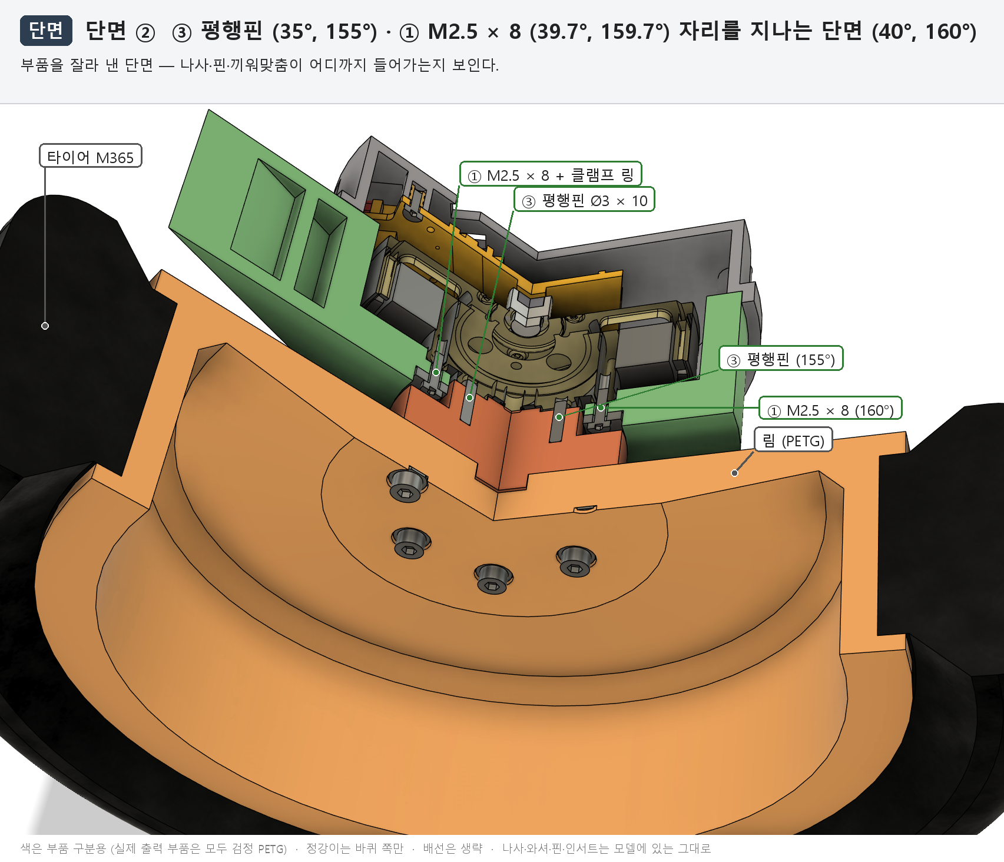
robot_cad_v5/manufacturing/explain/assembly/wheel/12_cut2.png
