wisehyun-2/my_robot_project/robot_cad_v5/manufacturing/explain/wheel_section.png

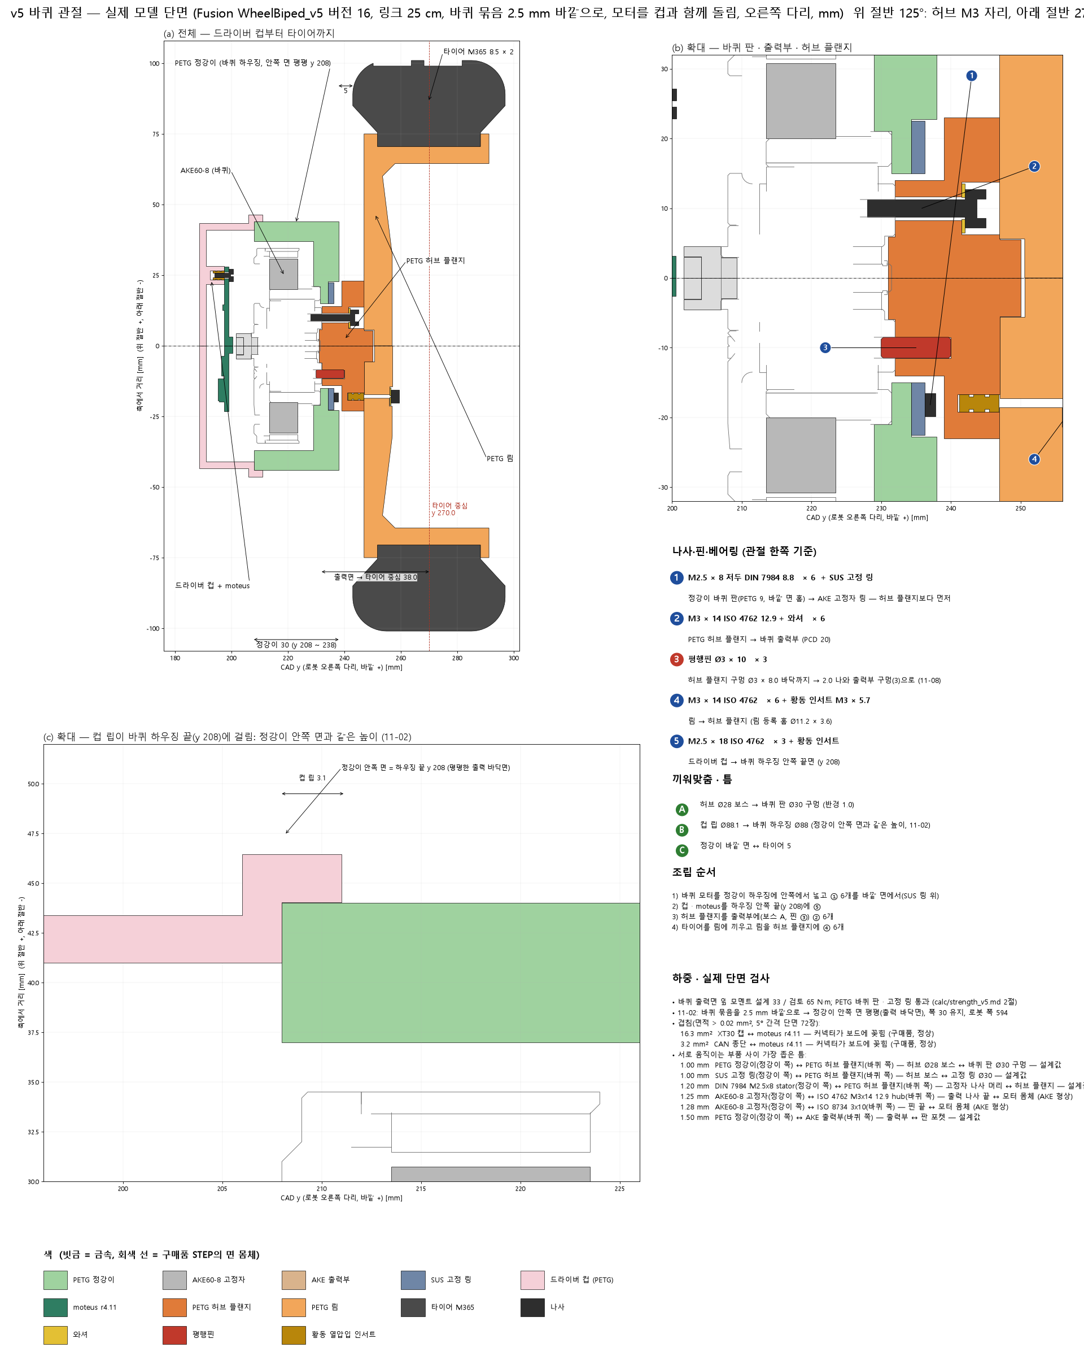
robot_cad_v5/manufacturing/explain/wheel_section.png
