wisehyun-2/my_robot_project/wheeled_biped/docs/balancing_robot_design/figures/mpc_vs_lqr_velocity_step.png

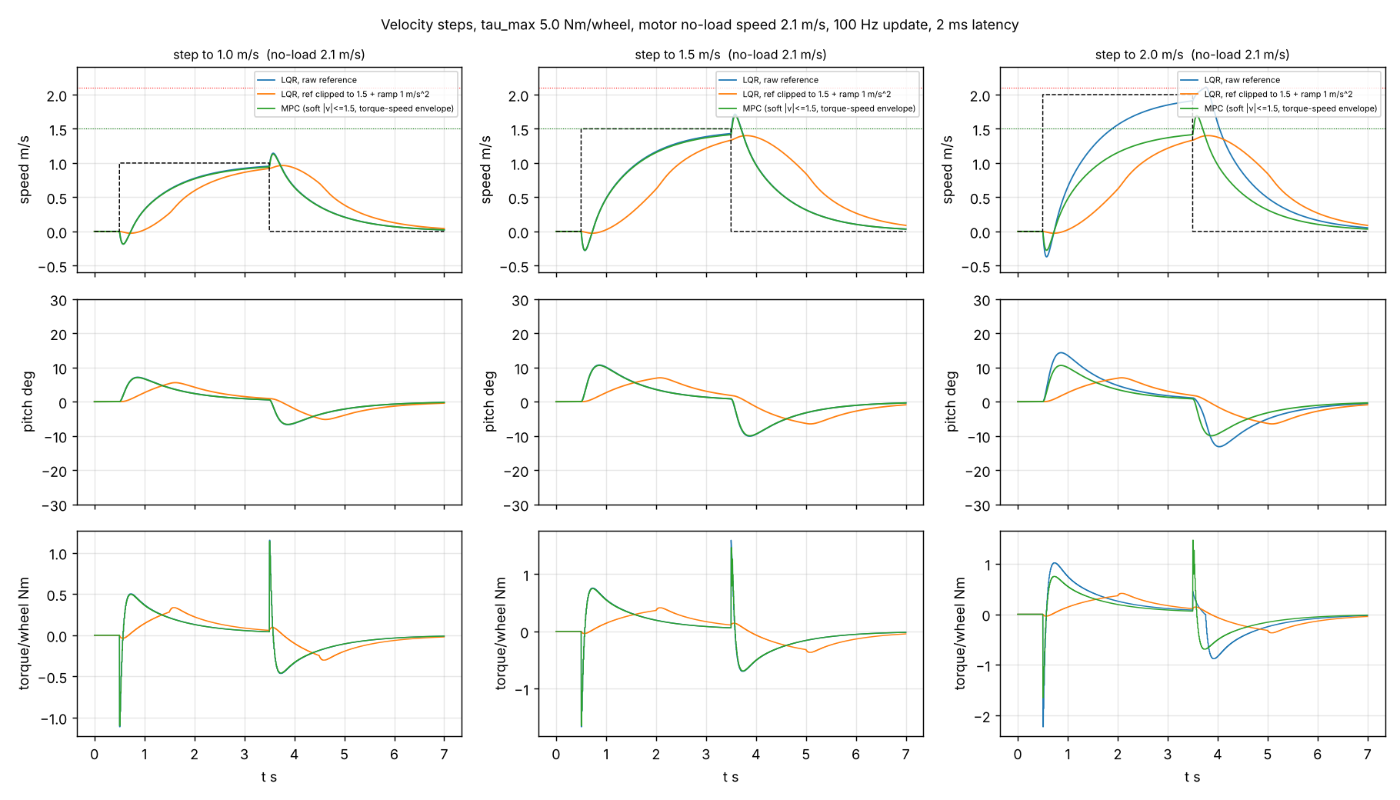
wheeled_biped/docs/balancing_robot_design/figures/mpc_vs_lqr_velocity_step.png
