wisehyun-2/my_robot_project/wheeled_biped/v5_lqi/TEST/README.md

# 단계별 통과 시험 (LQI8) — LQR 먼저, 적분은 나중에

> 2026-11-10: 이 폴더는 `wheeled_biped/TEST/`에서 `wheeled_biped/v5_lqi/TEST/`로 옮겼다. 시나리오·지표·기준·보고서 코드는
> `wbr/bench/stage_tests.py`로 빼서 MPC 폴더(`v5_mpc/TEST/`)와 같이 쓴다. 두 폴더의 보고서는 같은 시험·같은 기준이라 줄마다 비교할 수 있다.
> 이 폴더의 `stage_common.py`는 LQI 단계(`v5_lqi/controller.py`의 `STAGES`)를 등록만 한다.

균형 제어기를 한 번에 완성하지 않고 **순수 LQR → 바깥 루프 → ∫위치 → ∫기울기** 순서로 올리기 위한 시험이다.
한 단계를 통과한 뒤 다음 단계로 넘어가고, 뒤 단계는 앞 단계의 시험을 전부 다시 통과해야 한다.

대상 로봇은 v5 CAD 로봇이다(Fusion에서 뽑은 전용 URDF `models/wheelbiped_v5`, AKE60-8 × 6, 링크 25 cm, 11.60 kg, `docs/robot_v5_model.md`). 앞은 로커 스위치 쪽이고 무릎은 뒤를 향한다. MuJoCo 폐루프로 돌린다.

**현재 판정(11-07, 링크 25 cm): 단계 4 시험 27개 중 7개가 일부 기준을 넘는다(5절 앞 "링크 25 cm 결과"). 넘어지거나 무릎이 꺾인 경우는 없다. 기준 숫자는 바꾸지 않았다.**
IMU는 실제 칩 위치에서 재고, pi3hat 펌웨어 필터 → MCU 자세 필터를 거쳐 제어기에 들어간다.
시나리오와 측정 정의는 기존 합격 판정(`docs/합격기준.md`, `wbr/bench/acceptance.py`)의 것을 그대로 쓴다.
기존 단위 테스트(`tests/`)와는 별개다. `WBR_TEST_CAD`로 전용 URDF가 없는 CAD 버전(v2~v4)을 주면 예전 upkie 경로로 돈다.

## 1. 단계

| 단계 | 균형 제어기 | `lqi_kwargs` | 이 단계에서 확인하는 것 | 파일 |
|---|---|---|---|---|
| 1 | 순수 LQR, 상태 6개 `[θ, θ̇, v − v_ref, φ, φ̇, x − x_ref]` | `q_att=None, q_pos=None` | 상태 피드백만으로 서고, 기울기·밀기에서 복귀하고, 속도 스텝을 따라간다 | `test_stage1_lqr.py` |
| 2 | 단계 1과 같음 | 같음 | 논문 Fig. 6의 나머지 네 제어기(높이, 요, 롤, 다리 벌어짐)가 균형을 해치지 않고 제 일을 한다. 무릎 결합 보상이 hip·바퀴 토크의 영향을 다리 길이에서 뺀다 | `test_stage2_outer_loops.py` |
| 3 | + ∫위치 (z3) | `q_att=None, q_pos=0.5` | 일정한 외란 아래에서 출발 위치로 돌아온다. 단계 1·2 시험 재통과 | `test_stage3_int_position.py` |
| 4 | + ∫기울기 (z2) = 현재 제어기 | `q_att=0.2, q_pos=0.5` | 일정한 외란 아래에서 실제 몸통이 수평으로 돌아온다. 단계 1·2·3 시험 재통과 | `test_stage4_int_tilt.py` |

상태 6번째(`x − x_ref`)는 코드에서 `z1 = ∫(v − v_ref)`다. 속도를 적분한 값이라 위치 그 자체이고 논문의 `x` 상태에 해당한다.
논문의 `∫x`가 z3, `∫γ`가 z2다. 코드에서는 `Plan4Config(lqi_kwargs={...})`에 위 값을 넣으면 그 단계가 된다.

## 2. 실행

`wheeled_biped/`에서 실행한다.

```
python v5_lqi/TEST/run_stages.py --stage 4 --keep-going    # 전체 제어기(현재 쓰는 시험). 보고서: v5_lqi/TEST/results/stage_report.md
python v5_lqi/TEST/run_stages.py                    # 단계 1 → 4, 실패한 단계에서 멈춤
python v5_lqi/TEST/run_stages.py --stage 1 2        # 일부 단계만
python v5_lqi/TEST/run_stages.py --keep-going       # 실패해도 끝까지
python -m unittest discover -s v5_lqi/TEST -v                            # unittest로 전부
python -m unittest discover -s v5_lqi/TEST -p "test_stage1*.py" -v      # 한 단계만
```

시드 하나에 단계 4만 약 2분 30초, 전체 약 7분(다른 실행과 동시에 돌렸을 때 잰 값). 2-16이 30 s를 돌고 필터가 스텝마다 돈다.

| 환경 변수 | 기본 | 뜻 |
|---|---|---|
| `WBR_TEST_SEEDS` | `0` | 노이즈 시드 목록, 예 `0,1,2,3,4` |
| `WBR_TEST_LATENCY_MS` | `10` | 센서 → 토크 지연 |
| `WBR_TEST_RATE` | `1000` | 제어 주기 [Hz] (200도 가능) |
| `WBR_TEST_LONG` | `0` | `1`이면 정지 시험을 합격 기준대로 60 s (기본 30 s) |
| `WBR_TEST_CAD` | v5 | 다른 CAD 버전의 `mass_properties.json` 경로 |

PowerShell 예: `$env:WBR_TEST_SEEDS = "0,1,2"; python v5_lqi/TEST/run_stages.py`

## 3. 통과 기준

공통 조건: 센서 노이즈 켬, 지연 10 ms, 1 kHz, 판정 피치는 시뮬레이터의 실제 몸통 피치.

모든 시험에 함께 붙는 기준: 넘어지지 않음, 무릎이 완전 신장 반대쪽으로 넘어가지 않음, 완전 신장까지 5 mm 이상,
바퀴·hip·무릎 토크 피크 ≤ 10 N m(AKE60 피크의 80 %), hip·무릎 rms ≤ 5 N m(정격), 바퀴 10 s rms ≤ 2.5 N m.

| 시험 | 시나리오 | 기준 | 출처 |
|---|---|---|---|
| 1-1 | 정지 30 s | 20 ms 이동평균 \|피치\| ≤ 1°, rms ≤ 0.5°, 드리프트 ≤ 5 cm | 합격기준 1번 |
| 1-2 | 초기 기울기 10° | 정착 ≤ 2 s, 이동 ≤ 0.3 m | 2번 |
| 1-3 | 밀기 0.5 W(무게의 절반), 0.1 s | 정착 ≤ 3 s, 피치 피크 ≤ 8°, 이동 ≤ 0.5 m | 5번 |
| 1-4 | 속도 스텝 0 → 0.5 m/s(2.5 s) → 0 | 90 % 도달 ≤ 1.5 s, 오버슈트 ≤ 20 %, 정상 오차 ≤ 0.05 m/s, 피치 ≤ 5°, 정지 뒤 이탈 ≤ 0.5 m, **정지 뒤 정착 ≤ 3 s** | 8번(정착 시간은 4절 참고) |
| 1-5 | 경사 5° / IMU 오차 +1° / 앞쪽 짐 0.5 kg 정지 30 s | 넘어지지 않음. 남는 위치 오프셋과 기울기를 **기록**(안전 한계 15 cm, 2.5°) | 이 폴더 |
| 2-1 | 4 cm 웅크림 후 복귀 | 피치 ≤ 3°, 복귀 후 정착, 다리 길이 오차 ≤ 3 mm | 10번 + 길이 오차 |
| 2-2 | 요 1 rad/s, 2 s | 마지막 1 s 평균 오차 ≤ 10 %, 피치 ≤ 2° | 9번 |
| 2-3 | 롤 기준 3° | 마지막 1 s 평균 오차 ≤ 0.5°, 피치 ≤ 2° | 이 폴더 |
| 2-4 | 0.5 m/s로 가며 1 rad/s 회전, 정지 | 요 오차 ≤ 10 %, 좌우 다리각 차 ≤ 5°, 피치 ≤ 5°, 정지 뒤 정착 ≤ 3 s | 이 폴더 |
| 2-5 | 경사 10° 정지 6 s | 마지막 1 s 평균 다리 길이 오차 ≤ 1 mm(무릎 결합 보상) | 이 폴더 |
| 2-6 | 밀기 0.5 W, 0.1 s | 밀기 뒤 다리 길이 오차 변화 최대 ≤ 3 mm(무릎 결합 보상) | 이 폴더 |
| 2-7 | 왼쪽 바퀴만 턱 4 cm(경사 30 cm, 윗면 50 cm), 0.5 m/s | 롤 피크 ≤ 0.5°, 턱 위 평균 롤 ≤ 0.2°, 좌우 다리 길이 차 ≥ 턱 높이의 90 %, 피치 ≤ 3° | 이 폴더(순응 롤) |
| 2-8 | 오른쪽 바퀴만 턱 4 cm, 1 m/s | 2-7과 같음 | 이 폴더(순응 롤) |
| 2-9 | 기립 +20 mm에서 롤 6° 명령 | 무릎 안 꺾임, 완전 신장까지 ≥ 5 mm(공통 항목), 낼 수 있는 롤 ≥ 3° | 이 폴더(다리 범위 벽) |
| 2-10 | 왼쪽 15 cm에 아래로 20 N 유지 | 마지막 1 s 평균 롤 ≤ 0.1°, 롤 피크 ≤ 1° | 이 폴더(롤 적분) |
| 2-11 | 왼쪽 바퀴만 날카로운 턱 2 cm(경사 15 mm, 윗면 50 cm), 0.3 m/s | 방향 최대 ≤ 6°, 정지 3 s 뒤 방향 ≤ 2°, 옆 이동 ≤ 15 cm, 롤 ≤ 1°, 피치 ≤ 6° | 이 폴더(바퀴 속도 차 요) |
| 2-12 | 왼쪽 바퀴만 날카로운 턱 4 cm, 0.5 m/s | 방향 최대 ≤ 15.5°, 정지 3 s 뒤 방향 ≤ 3.1°, 옆 이동 ≤ 15 cm, 롤 ≤ 1°, 피치 ≤ 6° | 이 폴더(앞 주행 측정, 5절) |
| 2-13 | 오른쪽 바퀴만 날카로운 턱 4 cm, 1 m/s | 방향 최대 ≤ 15°, 정지 3 s 뒤 방향 ≤ 2°, 옆 이동 ≤ 17.5 cm, 롤 ≤ 1°, 피치 ≤ 7.5° | 이 폴더(앞 주행 측정, 5절) |
| 2-14 | 1 m/s 출발·정지 | 추정 − 실제 피치(50 ms 평균의 최대) ≤ 0.5°, 실제 피치 최대 ≤ 3.2° | 이 폴더(IMU 경로) |
| 2-15 | 1 m/s로 가며 2 rad/s 회전 6 s | 추정 − 실제 피치 ≤ 0.5°, 롤 ≤ 0.5° | 이 폴더(IMU 경로) |
| 2-16 | 2 rad/s로 30 s 회전 뒤 정지 | 회전 끝 요 속도 오차 ≤ 5 %, 정지 뒤 남은 요 속도 ≤ 0.01 rad/s | 이 폴더(IMU 경로) |
| 2-17 | 한쪽 바퀴 과속방지턱 10 cm, 0.3 m/s | 롤 ≤ 1°, 피치 ≤ 4°, 방향 ≤ 8°, 몸통 상승 ≤ 22 mm, 수직 가속도 ≤ 1.5 m/s² | 이 폴더(서스펜션) |
| 2-18 | 한쪽 바퀴 과속방지턱 14 cm, 0.3 m/s | 롤 ≤ 1.5°, 피치 ≤ 4°, 방향 ≤ 8° | 이 폴더(서스펜션) |
| 2-19 | 한쪽 바퀴 과속방지턱 20 cm, 0.3 m/s | 넘어지지 않음, 무릎 안 꺾임, 완전 신장 여유 ≥ 5 mm, 롤 ≤ 8°, 턱 위 롤 ≤ 7°, 피치 ≤ 5°, 다리 토크 ≤ 모터 피크 | 이 폴더(다리 범위를 넘는 턱) |
| 2-20 | 한쪽 바퀴 과속방지턱 10 cm, 명령 0.5 m/s | 턱 위 속도 ≤ 0.3 m/s, 감속도 ≤ 1.2 m/s², 롤 ≤ 1.5°, 피치 ≤ 4° | 이 폴더(감속) |
| 2-21 | 한쪽 바퀴 과속방지턱 10 cm, 명령 1 m/s | 턱을 지나 2.5 s 뒤 속도 ≥ 0.8 m/s, 감속도 ≤ 1.2 m/s², 롤 ≤ 1.5°, 피치 ≤ 4° | 이 폴더(감속) |
| 3-1~3 | 경사 5° / IMU 오차 +1° / 앞쪽 짐 0.5 kg 정지 30 s | **마지막 5 s 평균 위치가 출발점에서 3 cm 이내**, 최대 이탈 ≤ 10 cm | 12·16·17번의 10 cm + 이 폴더 |
| 4-1~3 | 같은 세 외란 | **마지막 5 s 평균 실제 피치 ≤ 0.5°**, 흔들림 rms ≤ 0.5° | 이 폴더 |

기준 숫자는 `wbr/bench/stage_tests.py`의 믹스인 클래스와 맨 위 상수에 모여 있다(MPC 폴더와 같이 쓴다).

턱 모양: 2-7·2-8은 경사 30 cm, 윗면 50 cm인 사다리꼴 턱, 2-11~2-13은 경사 1.5 cm로 거의 계단인 턱이다(폭 14 cm). 2-17~2-21의 과속방지턱은 곡선 `z = h/2 (1 − cos(2π s / 길이))`이고, 길이는 턱 높이의 10배(최소 0.8 m, 20 cm 턱은 2 m에 최대 경사 17°), 폭 30 cm, 한쪽 바퀴 밑에만 있다.

## 4. 합격기준.md와 다른 점

- **모터 한계**: upkie의 qdd100·mj5208 대신 AKE60-8(피크 12.5, 정격 5 N m). 포화 지속·관절 속도 기준은 넣지 않았다.
- **센서 노이즈**: 합격 기준의 노이즈는 upkie 하네스의 "참 자세 + 흰 잡음"이고 Plan 4 판정(`wbr/bench/acceptance.py`)은 그대로 그것을 쓴다. 이 폴더는 v5 시험이라 칩 위치의 자이로·가속도 노이즈를 펌웨어 필터 포팅과 MCU 자세 필터에 통과시킨다. 그래서 1-1의 피치 rms를 합격 기준 수치와 바로 비교할 수 없다.
- **정지 시험 길이**: 기본 30 s(합격 기준은 60 s). `WBR_TEST_LONG=1`로 60 s.
- **속도 스텝의 정지 뒤 정착**: 합격 판정은 정지 뒤 3 s만 돌리고 마지막 위반이 끝 1 s 안이면 미정착이라, 사실상 2 s 안에
  정착해야 한다. v5는 정지할 때 25~29 cm 나갔다가 0.13~0.16 m/s로 되돌아와 **2.1~2.2 s**가 걸린다(세 단계 모두). 이 시험은
  정지 뒤 5 s를 돌리고 정착 시간 ≤ 3 s로 판정한다. 2 s로 맞추려면 제어기를 조정해야 한다(결정 사항).
- **짐**: 0.5 kg(합격 기준 17번은 5.3 kg upkie에 0.3 kg). 로봇 질량 비로 키웠다.
- **16·17번의 피치 기준**: 합격 기준은 전 구간 이동평균 ≤ 1°다. 여기서는 적분 두 개의 역할을 따로 보려고 끝 5 s 평균을 쓴다.
- **변동 매트릭스 없음**: 질량 ±15 %, 마찰 0.5~1.0 조합은 돌리지 않는다(공칭만). 시드는 기본 0 하나.
- **추가 항목**: 무릎 꺾임과 완전 신장 여유(전 시험, 더 긴 쪽 다리 기준), 롤 기준, 주행 중 회전, 한쪽 턱, 다리 범위, 한쪽 짐, 날카로운 턱의 방향, IMU 추정 오차.
- **시험하지 않는 경우**: 4 cm 턱을 0.2~0.4 m/s로 넘기(바퀴가 끼여 약 45° 돈다, `robot_cad_v5/README.md` 6절 한계). 기준을 정한 조건은 넘어갈 수 있는 속도다.

## 링크 25 cm 결과 (11-07, 전체 제어기, 시드 0~4, 1440건 중 41건 초과)

기립 460 mm, 범위 372~485 mm, 지연 10 ms. 기준은 17.5 cm 때 그대로다. 전체 값은 `results/stage_report.md`.

| 시험 | 넘은 항목 | 기준 | 측정(시드 범위) | 초과한 시드 | 원인 |
|---|---|---|---|---|---|
| 2-3 롤 기준 3° | hip·무릎 rms | ≤ 5 N·m | 5.19~5.39 | 5 / 5 | 롤을 만들려고 짧아진 다리의 무릎 팔이 길어짐 |
| 2-9 기립 +20 mm, 롤 6° | hip·무릎 rms | ≤ 5 N·m | 6.46~6.54 | 5 / 5 | 같음, 가장 큰 명령 |
| 2-10 왼쪽에 아래로 20 N | hip·무릎 rms | ≤ 5 N·m | 5.21~5.26 | 5 / 5 | 같음 |
| 2-12 날카로운 턱 4 cm, 0.5 m/s | 방향 최대 | ≤ 15.5° | 18.6~21.2° | 5 / 5 | 롤 대역을 낮춤(롤 34 rad/s에서는 통과) |
| 2-12 | 옆 이동 | ≤ 15 cm | 16.6~17.9 cm | 5 / 5 | 같음 |
| 2-12 | 롤 피크 | ≤ 1° | 1.55~1.63° | 5 / 5 | 같음 |
| 2-13 날카로운 턱 4 cm, 1 m/s | 롤 피크 | ≤ 1° | 1.77~1.83° | 5 / 5 | 같음 |
| 2-13 | 다리 토크 피크 | ≤ 10 N·m | 10.05 | 1 / 5 | 근소 |
| 2-15 1 m/s로 가며 2 rad/s 회전 | 추정 − 실제 피치 | ≤ 0.5° | 0.51~0.54° | 4 / 5 | 근소, 다리가 길어 무게중심이 높음 |
| 2-8 완만한 턱 4 cm, 1 m/s | 롤 피크 | ≤ 0.5° | 0.52° | 1 / 5 | 근소 |

통과: 1-1~1-5(0.5 W 밀기 다리 토크 피크 9.68~9.83 N·m, 피치 6.3°), 나머지 2-x(한쪽 바퀴 과속방지턱 10·14·20 cm 포함), 3-x, 4-x.

롤 대역 17 rad/s는 시험 성적만 보면 불리하다(34 rad/s면 시드 0에서 2-3, 2-9, 2-10만 실패). 그래도 고른 이유는 시뮬레이션의 링크가 강체라서다. hip에 힌지를 넣어 PETG 옆 휨을 흉내 내면 24·34 rad/s에서는 낮은 자세에서 무릎 토크가 떨리며 포화하고(rms 8.1~8.5, 피크 12.5 N·m), 17 rad/s에서는 떨리지 않는다(rms 5.9, 피크 6.5 N·m, `docs/robot_v5_model.md` 10절). 기립을 465·470 mm로 올려 보면 2-3·2-10은 좋아지지만 2-12가 21.8·24.3°로 나빠져 460 mm로 두었다.

## 5. 측정값, 링크 17.5 cm 때 (전체 제어기 = 단계 4, 시드 0~4의 범위, 2026-11-07, 앞 = 로커 스위치 쪽)

**시드 5개 1440건 모두 통과.** 순수 LQR은 쓰지 않기로 해서(11-07 사용자) `--stage 4`만 재고 있다. 단계 1~3은 정적 힘 식, 벌어짐 PD, 서스펜션, 감속을 넣은 뒤 다시 재지 않았고, 저장소의 `results/stage_report.*`도 단계 4, 시드 0 실행이다.

2-12, 2-13의 방향·옆 이동 기준은 무릎이 뒤따르는 앞 주행의 측정값에 맞춰 다시 정했다(11-07 사용자). 원인은 무릎 쪽 기하다(`docs/robot_v5_model.md` 6절).

| 기준을 바꾼 항목 | 전 | 후 | 측정 |
|---|---|---|---|
| 2-12 방향 최대 | ≤ 15° | ≤ 15.5° | 13.2~13.8° |
| 2-12 정지 뒤 방향 | ≤ 2° | ≤ 3.1° | 2.4~2.8° |
| 2-13 방향 최대 | ≤ 12° | ≤ 15° | 12.9~13.3° |
| 2-13 옆 이동 | ≤ 15 cm | ≤ 17.5 cm | 14.9~15.7 cm |
| 2-13 피치 | ≤ 6° | ≤ 7.5° | 6.6~6.8° |

| 시험 | 측정 |
|---|---|
| 1-1 피치 rms / 드리프트 | 0.25~0.26° / 2.3~2.6 cm |
| 1-2 정착 | 1.64~1.67 s |
| 1-3 정착 / 피치 피크 | 2.1 s / 3.3° |
| 1-4 도달 / 오버슈트 / 정상 오차 / 정지 뒤 정착 | 1.28~1.29 s / 10.6~11.0 % / 0.041~0.043 / 2.09~2.11 s |
| 2-1 다리 길이 오차 (웅크림 / 복귀) | 0.00~0.05 / 0.00~0.05 mm |
| 2-2 요 오차 | 0.5 % |
| 2-3 롤 오차 | 0.02~0.07° |
| 2-4 좌우 다리각 차 | 2.4° |
| 2-5 경사 10° 다리 길이 오차 | 0.16~0.23 mm |
| 2-6 밀기 뒤 다리 길이 변화 | 0.56~0.63 mm |
| 2-7 턱 4 cm, 0.5 m/s: 롤 피크 / 턱 위 롤 / 다리 길이 차 | 0.14~0.18° / 0.01~0.04° / 101~102 % |
| 2-8 턱 4 cm, 1 m/s: 롤 피크 / 턱 위 롤 / 다리 길이 차 | 0.17~0.20° / 0.04~0.07° / 101~102 % |
| 2-9 330 mm에서 롤 6°: 낸 롤 / 완전 신장 여유 | 6.06~6.11° / 12.0~12.1 mm |
| 2-10 한쪽 짐 20 N: 끝 롤 / 피크 | 0.00~0.03° / 0.20~0.23° |
| 2-11 날카로운 턱 2 cm, 0.3 m/s: 방향 최대 / 정지 뒤 방향 / 옆 이동 | 3.2~3.3° / 0.7~1.0° / 3.6~3.9 cm |
| 2-12 날카로운 턱 4 cm, 0.5 m/s: 방향 최대 / 정지 뒤 방향 / 옆 이동 | 13.2~13.8° / 2.4~2.8° / 12.5~13.6 cm |
| 2-13 날카로운 턱 4 cm, 1 m/s: 방향 최대 / 정지 뒤 방향 / 옆 이동 / 다리 토크 피크 / 피치 | 12.9~13.3° / 1.1~1.2° / 14.9~15.7 cm / 8.4~8.9 N m / 6.6~6.8° |
| 2-14 1 m/s 출발·정지: 피치 추정 오차 / 실제 피치 최대 | 0.13~0.17° / 2.5° |
| 2-15 1 m/s + 2 rad/s: 피치 / 롤 추정 오차 | 0.10~0.12° / 0.12~0.15° |
| 2-16 2 rad/s 30 s: 회전 끝 요 오차 / 정지 뒤 요 속도 | 0.00~0.01 % / 0.000 rad/s |
| 2-17 과속방지턱 10 cm, 0.3 m/s: 롤 피크 / 몸통 상승 / 수직 가속도 / 방향 최대 | 0.30~0.33° / 15.2~15.3 mm / 0.37 m/s² / 5.3~5.4° |
| 2-18 과속방지턱 14 cm, 0.3 m/s: 롤 피크 / 다리 토크 피크 | 0.46~0.49° / 7.9~8.1 N m |
| 2-19 과속방지턱 20 cm, 0.3 m/s: 롤 피크 / 턱 위 롤 / 다리 토크 피크 / 완전 신장 여유 | 6.4° / 5.5° / 9.1~9.4 N m / 5.8~5.9 mm |
| 2-20 과속방지턱 10 cm, 명령 0.5 m/s: 턱 위 속도 / 감속도 최대 | 0.22 m/s / 0.63~0.64 m/s² |
| 2-21 과속방지턱 10 cm, 명령 1 m/s: 2.5 s 뒤 속도 / 감속도 최대 | 1.05 m/s / 0.76~0.78 m/s² |
| 경사 5°: 위치 / 기울기 / 최대 이탈 | 1.1~1.4 cm / 0.00~0.01° / 4.8~5.3 cm |
| IMU 오차 +1°: 위치 / 기울기 / 최대 이탈 | 0.0~0.2 cm / 0.00~0.02° / 7.5~7.7 cm |
| 앞쪽 짐 0.5 kg: 위치 / 기울기 / 최대 이탈 | 0.5~0.7 cm / 0.18~0.19° / 7.2~7.4 cm |

- 통과 항목 중 여유가 작은 지표: 2-13 롤 0.93 / 1°, 2-12 정지 뒤 방향 2.84 / 3.1°, 2-12 옆 이동 13.6 / 15 cm, 2-13 피치 6.75 / 7.5°, 2-13 다리 토크 8.9 / 10 N m, 1-4 정상 오차 0.043 / 0.05, 1-4 도달 1.29 / 1.5 s.
- 2-9의 낸 롤이 5.4°에서 6.1°로 늘었다. 서스펜션이 평균 높이를 내려 명령한 6°를 낸다(330 mm 기준 높이가 약 30 mm 낮아진다).
- **지연 여유는 이 시험에 보이지 않는다.** 위 값은 지연 10 ms에서 잰 것이다. 밀기 뒤 떨림은 전체 제어기가 11 ms까지 0/6, 12 ms 4/6, 13 ms 6/6이다.

### 시험이 실제로 걸러내는가

기능을 끈 제어기에 해당 시험을 걸었을 때의 값이다(전체 제어기, 시드 0. 적분 두 줄은 힘 식·벌어짐 PD를 바꾸기 전, 시드 0~4의 범위).

| 시험을 건 제어기 | 시험 | 결과 |
|---|---|---|
| 순수 LQR(변경 전) | 3-2, 3-3 (IMU 오차, 짐: 위치) | 실패 — 위치 8.2~9.1 / 8.2~9.1 cm (기준 3), 최대 이탈 11.1~11.6 / 11.2~11.7 cm (기준 10) |
| LQR + ∫위치(변경 전) | 4-1, 4-2, 4-3 (기울기) | 실패 — 0.89~0.97 / 1.37~1.49 / 0.74~0.86° (기준 0.5) |
| 옛 힘 식 `F_ff / cos θ`(`exact_leg_force=False`) | 2-5 | 실패 — 1.21 mm (기준 1) |
| 벌어짐 PD 60 / 3 | 2-13 | 다리 토크 피크 10.7 N m (기준 10), 정지 뒤 방향 2.11° (기준 2) |
| 무릎 결합 보상 끔(`wheel_reaction_ff=False`) | 2-5, 2-6 (다리 길이) | 실패 — 3.76 mm (기준 1), 5.66 mm (기준 3) |
| 순응 롤 끔(`roll_compliant=False`, 다리 길이 차 롤) | 2-7, 2-8 (턱) | 실패 — 롤 피크 2.44 / 2.69° (기준 0.5), 턱 위 2.05 / 2.26° (기준 0.2), 다리 길이 차 52 / 46 % (기준 90) |
| 같은 제어기 | 2-9, 2-10 | 통과 — 3.87°, 여유 10.8 mm / 0.02°. 이 둘은 옛 방식을 걸러내려는 시험이 아니라, 순응 롤이 다리 범위와 한쪽 짐을 지키는지 보는 시험이다 |
| 바퀴 속도 차 요 끔(`kw_yaw=0`, `ki_yaw` 원래 값) | 2-11, 2-12, 2-13 (방향) | 실패 — 방향 최대 40.1 / 59.9 / 21.1° (기준 6 / 15 / 12), 옆 이동 29 / 38 / 23 cm (기준 15) |
| 서스펜션 끔, 평균 길이 유지(`suspension=False` 등 이전 방식) | 2-17 | 실패 — 몸통 상승 31 mm (기준 22). 14 cm에서 롤 2.75°, 20 cm에서 11.6° |
| 감속 끔(`uneven_speed=0`) | 2-20 | 실패 — 턱 위 속도 0.47 m/s (기준 0.3) |
| 보드 자세·요 속도만 사용(`attitude_tau=0`, `yaw_offset_tau=0`) | 2-14, 2-15 (자세 추정) | 실패 — 피치 오차 1.49 / 1.78° (기준 0.5), 실제 피치 최대 3.96° (기준 3.2), 롤 오차 1.02° (기준 0.5) |
| 같은 제어기 | 2-16 (요) | 실패 — 회전 끝 요 오차 33 % (기준 5), 정지 뒤 남은 요 속도 0.69 rad/s (기준 0.01) |

## 6. 실패했을 때

| 실패 | 먼저 볼 것 |
|---|---|
| 단계 1의 1-1, 1-2 | 플랜트 파라미터(`models/wheelbiped_v5/plant_params.json`), 관절 부호, IMU 방향. 게인이 아니라 모델이 틀린 경우가 많다 |
| 1-3, 1-4 | LQR 가중치(`q_v`, `r_wheel_frac`, `r_hip_frac`), 속도 기준 성형(램프 2 m/s², 필터 0.3 s) |
| `knee_flipped`, `leg_margin_mm` | 다리 길이 PD가 로봇 무게에 비해 무르다(`kp_leg`, `kd_leg`). 몸통 질량 비로 환산한다 |
| 2-2, 2-4의 요 오차 | 요 PI(`kp_yaw`, `ki_yaw`). 제어 대상 이득 W / (2 R I_zz) 비로 환산한다 |
| 2-4의 다리각 차 | 다리 벌어짐 PD(`kp_split`, `kd_split`). **`kp_split`을 낮추지 않는다**: 80에서 2.4°, 60에서 3.4°, 50에서 5.7°이고 30이면 회전 중 다리가 85°까지 벌어진다 |
| 2-5, 2-6 | `exact_leg_force`와 `wheel_reaction_ff`가 켜졌는지, 관절 부호. 무릎 토크에 `τ_h/2 + τ_w/2`가 **+y축 기준 같은 부호**로 들어가야 한다(`−τ_h/2`면 밀기 때 22 mm까지 벌어진다) |
| 2-7, 2-8 | `roll_compliant`가 켜졌는지, 롤 부호(양의 오차 = 왼쪽 다리 늘림). 턱 위 롤만 크면 평균 길이 대신 다리별 길이 PD가 돌고 있다 |
| 2-14, 2-15 | `attitude_tau`가 켜졌는지(MCU 자세 필터), `imu_position`이 칩 위치와 맞는지, 가속도 보정 게이트(`reject`, `quiet`). 오차가 1.5~2°면 보드 자세를 그대로 쓰고 있는 것이다 |
| 2-16 | `yaw_offset_tau`가 켜졌는지(요에 원시 자이로), 보드의 `rate_dps`를 그대로 쓰지 않는지. 정지 뒤 0.7 rad/s가 남으면 보드 요 속도를 쓰고 있는 것이다 |
| 2-17~2-19 | `suspension`, `suspension_share`, `kd_leg_own`이 켜졌는지. 몸통이 턱 높이의 절반만큼 오르면 평균 길이 제어로 돌고 있다. 무릎 피크가 크면 다리 범위 벽(`L_min_margin`, `L_max_margin`, `LEG_WALL_SCALE`) |
| 2-20, 2-21 | `uneven_speed`, `uneven_brake`, `uneven_lean`, `uneven_hold_int`. 턱 뒤에서 속도가 다시 오르면 위치 적분이 멈추지 않은 것이다 |
| 2-9, 2-3 | 다리 범위 벽(`kp_leg_limit`, `kd_leg_limit`), 차동 힘 한계(`roll_force_limit`) |
| 2-10 | 롤 적분(`ki_roll_force`, `roll_force_int_limit`) |
| 2-11~2-13 | `kw_yaw`가 켜졌는지, 바퀴 속도 부호(`v_우 − v_좌` > 0이 왼쪽 회전), MCU `track`. 방향 최대만 크면 바퀴 항, 정지 뒤 방향만 크면 `ki_yaw`를 본다. 자이로 게인을 키우지 않는다(`kp_yaw` × 3이면 다리와 물려 흔들린다) |
| 단계 3·4에서 1-x가 새로 실패 | 적분 가중치가 너무 세다(`q_pos`, `q_att`는 클수록 약하다) |
| 3-x 위치, 4-x 기울기 | 적분 한계(`pos_limit`, `att_limit`)에 걸렸는지, 기준이 움직이는 동안의 적분 동결이 풀리는지 |

## 7. 실기에서

실물도 전체 제어기(단계 4)로 한다. 순수 LQR로 시작해 적분을 하나씩 켜는 방식은 쓰지 않기로 했다(11-07 사용자). 시험 1-1~1-4부터 실물로 반복하고, 처음에는 낮은 게인으로 시작해 올린다(`ros2_ws/README.md` 6절 C8).

- 실기에는 "실제 피치"가 없다. IMU 추정 피치만 있으므로 4-2(IMU 오차)는 실물에서 직접 볼 수 없다. 수평계를 몸통에 올리거나,
  짐(4-3)과 경사(4-1)로 확인한다.
- 위치는 바퀴 오도메트리로 잰다. 바닥에 출발선을 표시해 두면 3-x를 눈으로도 확인할 수 있다.
- 요·다리 길이 게인은 이 시뮬레이션과 같은 환산값을 MCU 설정에 넣어야 한다(`ake_cad.outer_loop_gains`).
- 무릎 결합 보상도 켜야 한다(`wheel_reaction_ff=True`, 2-5·2-6의 조건). 끈 채로는 경사에서 다리가 늘어난 자세로 선다.
- 순응 롤도 켜야 한다(`roll_compliant=True`와 `ake_cad.compliant_roll_gains`의 값, 2-7~2-10의 조건). 처음에는 턱 없이 2-3부터 확인한다.
- 바퀴 속도 차 요도 켜야 한다(`kw_yaw`, `ki_yaw`, `ake_cad.yaw_wheel_damping_gains`의 값, 2-11~2-13의 조건). 처음에는 턱 없이 2-2, 2-4부터 확인한다. 실제 공기 타이어는 시뮬레이션의 단단한 타이어보다 턱을 잘 넘을 수 있으므로 낮은 턱부터 올린다.
- IMU: pi3hat은 `mounting_deg` 0, `attitude_rate_hz` 1000으로 둔다. 로봇의 앞은 로커 스위치 쪽이다. 원시 축은 +x 로봇 뒤, +y 로봇 오른쪽, +z 위이고(`R_base_to_imu` = diag(−1, −1, 1)), 수평에서 보드는 롤 180°로 읽는 것이 정상이다(hat이 위, `R_ars_to_world` = diag(1, −1, −1)). 필터에 넣을 원시값은 보드 출력에서 복원한다: 자이로 = `rate_dps − bias_dps`, 가속도 = `accel_mps2 + 9.81 × 중력(자세)`. 켜기 전에 로봇을 손으로 스위치 쪽으로 기울여 피치 부호부터 확인한다(앞으로 기울이면 + 피치).

- 서스펜션과 감속: 낮은 턱부터 올린다. 다리가 345 mm 넘게 펴지면 멈춘다(350 mm에서 무릎이 반대로 꺾인다). 200 mm 아래는 Fusion 간섭 검사 범위 밖이다.

## 8. 파일

| 파일 | 내용 |
|---|---|
| `stage_common.py` | LQI 단계 등록(`v5_lqi/controller.py`의 `STAGES`) + 공통 코드 다시 내보내기 |
| `../../wbr/bench/stage_tests.py` | 로봇·폐루프 생성, 시나리오와 지표, 기준(믹스인 클래스), 보고서, 실행기(두 폴더 공통) |
| `test_stage1_lqr.py` ~ `test_stage4_int_tilt.py` | 단계별 시험 |
| `run_stages.py` | 순서대로 실행하고 보고서 작성 |
| `results/stage_report.md`, `.json` | 마지막 실행의 지표별 측정값·기준·판정 |
