wisehyun-2/my_robot_project/wheeled_biped/results/wheelbiped_v5_model/linearization.md

접촉 임피던스 강성(solimp 0.99/0.999, 대조용); 무릎 잠금 아마추어 1000, 건마찰 0, noslip 0.

| L0 [m] | θ_eq [°] | 불안정 극 모델 / MuJoCo [rad/s] | 극 오차 | B 오차 노름 바퀴 / 엉덩이 | B 성분 오차 최대 바퀴 / 엉덩이 | 3° 0.3 s rms θ / φ / x | 선형 구간 rms θ / φ | 정적 엉덩이 토크 모델 / MuJoCo [Nm] | base 잔차 [N] |
|---|---|---|---|---|---|---|---|---|---|
| 0.46 | +3.50 | 6.127, 8.014 / 6.125, 8.003 | 0.03 % / 0.15 % | 0.03 % / 0.00 % | 0.06 % / 0.03 % | 0.67° / 3.56° / 1.2 mm | 0.19° / 1.02° (0.17 s) | +0.050 / +0.177 | 4.52 |
| 0.40 | +6.19 | 6.264, 8.110 / 6.264, 8.112 | 0.00 % / 0.02 % | 0.02 % / 0.00 % | 0.07 % / 0.03 % | 0.12° / 0.64° / 0.3 mm | 0.04° / 0.20° (0.18 s) | +0.050 / +0.027 | 0.53 |
| 0.37 | +7.41 | 6.326, 8.154 / 6.326, 8.157 | 0.00 % / 0.03 % | 0.02 % / 0.00 % | 0.07 % / 0.03 % | 0.15° / 0.70° / 0.3 mm | 0.04° / 0.22° (0.18 s) | +0.050 / +0.024 | 0.53 |
| 0.48 | +2.03 | 6.068, 7.975 / 6.068, 7.975 | 0.00 % / 0.01 % | 0.03 % / 0.00 % | 0.07 % / 0.03 % | 0.02° / 0.16° / 0.1 mm | 0.01° / 0.05° (0.19 s) | +0.050 / +0.044 | 0.54 |
