wisehyun-2/my_robot_project/wheeled_biped/results/ake_sizing/summary.md

# AKE motor check of the user's robot (`python -m wbr.bench.ake_sizing`)

| motor | peak / rated [N m] | no-load [rpm] (rad/s) | gear | mass [kg] | reflected inertia [kg m^2] | backdrive [N m] |
|---|---|---|---|---|---|---|
| AKE50-8 KV110 (hip, knee) | 7.5 / 2.5 | 320 (33.5) | 8:1 | 0.19 | 9.84e-04 | 0.09 |
| AKE60-8 KV80 (wheel) | 12.5 / 5.0 | 240 (25.1) | 8:1 | 0.26 | 4.14e-03 | 0.12 |

## Per wheel diameter

| case | wheel [mm] | seed | V | mass [kg] | not recovered | wheel peak [N m] (scenario) | wheel RMS max | wheel sat % max | wheel speed max [rad/s] | v at 1.0 m/s cmd | hip peak (scenario) | hip RMS max | knee peak (scenario) | knee static max | knee RMS max | tire off the floor max [ms] (scenario) | slip max [m/s] |
|---|---|---|---|---|---|---|---|---|---|---|---|---|---|---|---|---|---|
| d112 | 112 | 0 | 24.0 | 4.881 | push_1.5 | 3.30 (tilt_25) | 0.62 | 76.5 | 25.3 | 1.09 | 4.34 (tilt_25) | 1.21 | 3.31 (push_1.5) | 2.03 | 2.03 | 0 | 0.01 |
| d112_seed1 | 112 | 1 | 24.0 | 4.881 | push_1.5 | 3.33 (tilt_25) | 0.62 | 75.9 | 25.3 | 1.09 | 4.31 (tilt_25) | 1.21 | 3.27 (push_1.5) | 2.02 | 2.03 | 0 | 0.01 |
| d125 | 125 | 0 | 24.0 | 4.881 | none | 3.46 (tilt_25) | 0.48 | 10.8 | 26.0 | 1.08 | 4.50 (tilt_25) | 0.46 | 3.29 (push_1.5) | 2.02 | 2.03 | 0 | 0.01 |
| d125_v22 | 125 | 0 | 22.2 | 4.881 | push_1.5 | 3.46 (tilt_25) | 0.54 | 78.6 | 23.6 | 1.08 | 4.50 (tilt_25) | 1.12 | 3.29 (push_1.5) | 2.02 | 2.03 | 0 | 0.01 |
| d135 | 135 | 0 | 24.0 | 4.881 | none | 3.64 (tilt_25) | 0.51 | 3.9 | 26.0 | 1.08 | 4.58 (tilt_25) | 0.46 | 3.29 (push_1.5) | 2.02 | 2.03 | 0 | 0.01 |
| d150 | 150 | 0 | 24.0 | 4.881 | none | 3.85 (tilt_25) | 0.56 | 2.1 | 25.8 | 1.07 | 4.68 (tilt_25) | 0.46 | 3.23 (push_1.5) | 2.02 | 2.03 | 2 (tilt_25) | 0.02 |
| d150_seed1 | 150 | 1 | 24.0 | 4.881 | none | 3.78 (tilt_25) | 0.56 | 2.3 | 25.8 | 1.07 | 4.64 (tilt_25) | 0.46 | 3.23 (push_1.5) | 2.02 | 2.03 | 2 (tilt_25) | 0.01 |
| d150_v22 | 150 | 0 | 22.2 | 4.881 | none | 3.85 (tilt_25) | 0.56 | 2.7 | 24.4 | 1.07 | 4.68 (tilt_25) | 0.46 | 3.23 (push_1.5) | 2.02 | 2.03 | 2 (tilt_25) | 0.02 |
| d200 | 200 | 0 | 24.0 | 4.881 | none | 4.71 (tilt_25) | 0.70 | 0.9 | 25.0 | 1.06 | 4.84 (tilt_25) | 0.46 | 3.19 (push_1.5) | 2.02 | 2.03 | 5 (push_1.5) | 0.03 |
| d250 | 250 | 0 | 24.0 | 4.881 | none | 5.53 (tilt_25) | 0.86 | 0.0 | 24.3 | 1.06 | 4.94 (tilt_25) | 0.46 | 3.17 (push_1.5) | 2.03 | 2.04 | 19 (push_1.5) | 0.07 |
| d300 | 300 | 0 | 24.0 | 4.881 | none | 6.44 (tilt_25) | 1.01 | 0.0 | 23.2 | 1.05 | 5.02 (tilt_25) | 0.46 | 3.21 (push_1.5) | 2.02 | 2.03 | 30 (push_1.5) | 0.15 |
| d400 | 400 | 0 | 24.0 | 4.881 | none | 8.22 (tilt_25) | 1.31 | 0.7 | 25.0 | 1.05 | 5.18 (tilt_25) | 0.52 | 6.79 (push_1.5) | 2.02 | 2.03 | 76 (push_1.5) | 1.27 |
| d400_seed1 | 400 | 1 | 24.0 | 4.881 | none | 8.35 (tilt_25) | 1.32 | 0.7 | 25.0 | 1.05 | 5.15 (tilt_25) | 0.52 | 7.50 (push_1.5) | 2.02 | 2.03 | 82 (push_1.5) | 1.54 |
| d450 | 450 | 0 | 24.0 | 4.881 | push_1.5, slope_15_down_0.5 | 12.50 (push_1.5) | 4.98 | 49.9 | 27.6 | 1.04 | 7.50 (push_1.5) | 2.84 | 7.50 (push_1.5) | 2.02 | 3.87 | 20 (tilt_25) | 0.29 |
| d500 | 500 | 0 | 24.0 | 4.881 | tilt_25, push_1.5, slope_15_up_0.5, slope_15_down_0.5 | 12.50 (tilt_25) | 5.06 | 60.4 | 26.0 | 1.04 | 7.50 (tilt_25) | 3.07 | 7.50 (tilt_25) | 2.02 | 4.32 | 15 (push_1.0) | 0.26 |
| d600 | 600 | 0 | 24.0 | 4.881 | tilt_25, push_1.0, push_1.5, slope_10_down_0.5, slope_15_stand, slope_15_up_0.5, slope_15_down_0.5 | 12.50 (tilt_25) | 5.58 | 56.4 | 25.6 | 1.04 | 7.50 (tilt_25) | 2.51 | 7.50 (tilt_25) | 2.02 | 3.54 | 7 (tilt_20) | 0.28 |

## Scenarios not recovered

| case | scenario | why | wheel peak / sat % / speed | knee peak / sat % | hip peak / sat % |
|---|---|---|---|---|---|
| d112 | push_1.5 | t=1.83 s, pitch 33 deg, height 0.265 m | 2.06 / 76.5 / 25.3 | 3.31 / 0.0 | 4.11 / 0.0 |
| d112_seed1 | push_1.5 | t=1.83 s, pitch 33 deg, height 0.263 m | 2.06 / 75.9 / 25.3 | 3.27 / 0.0 | 4.05 / 0.0 |
| d125_v22 | push_1.5 | t=1.96 s, pitch 30 deg, height 0.266 m | 1.98 / 78.6 / 23.6 | 3.29 / 0.0 | 4.07 / 0.0 |
| d450 | push_1.5 | t=2.20 s, pitch -57 deg, height 0.349 m | 12.50 / 49.9 / 27.6 | 7.50 / 18.6 | 7.50 / 5.2 |
| d450 | slope_15_down_0.5 | t=7.10 s, pitch 24 deg, height 0.353 m | 12.50 / 4.8 / 25.0 | 7.08 / 0.0 | 3.15 / 0.0 |
| d500 | tilt_25 | t=1.90 s, pitch 52 deg, height 0.360 m | 12.50 / 51.5 / 26.0 | 7.50 / 14.5 | 7.50 / 0.4 |
| d500 | push_1.5 | t=2.74 s, pitch 44 deg, height 0.362 m | 12.50 / 60.4 / 25.8 | 7.50 / 22.5 | 7.50 / 4.6 |
| d500 | slope_15_up_0.5 | t=3.32 s, pitch 22 deg, height 0.366 m | 12.50 / 18.7 / 25.1 | 7.50 / 0.3 | 7.50 / 0.1 |
| d500 | slope_15_down_0.5 | t=6.93 s, pitch 19 deg, height 0.366 m | 12.50 / 5.4 / 25.0 | 7.50 / 0.3 | 5.46 / 0.0 |
| d600 | tilt_25 | t=0.93 s, pitch -51 deg, height 0.386 m | 12.50 / 37.0 / 25.1 | 7.50 / 5.8 | 7.50 / 2.0 |
| d600 | push_1.0 | t=2.57 s, pitch -58 deg, height 0.446 m | 12.50 / 53.0 / 25.6 | 7.50 / 14.5 | 7.50 / 1.4 |
| d600 | push_1.5 | t=1.41 s, pitch -57 deg, height 0.385 m | 12.50 / 56.4 / 25.0 | 7.50 / 3.0 | 7.50 / 2.5 |
| d600 | slope_10_down_0.5 | t=7.16 s, pitch 31 deg, height 0.387 m | 12.50 / 7.7 / 25.1 | 7.50 / 0.2 | 7.50 / 0.2 |
| d600 | slope_15_stand | t=1.37 s, pitch 27 deg, height 0.391 m | 12.50 / 25.5 / 25.2 | 7.50 / 1.4 | 7.20 / 0.0 |
| d600 | slope_15_up_0.5 | t=1.37 s, pitch 29 deg, height 0.392 m | 12.50 / 25.6 / 25.2 | 7.50 / 1.3 | 7.50 / 0.6 |
| d600 | slope_15_down_0.5 | t=1.33 s, pitch 15 deg, height 0.391 m | 12.50 / 23.6 / 25.1 | 7.50 / 1.1 | 4.39 / 0.0 |
