wisehyun-2/my_robot_project/wheeled_biped/results/torque_sizing/summary.md

# Plan 2 mass-scaled torque sizing (`python -m wbr.bench.torque_sizing`)

## Demand: demand_15kg (15.0 kg, LQI6 budget 30.0 / 12.50 N m, seed 0, unclamped)

| scenario | recovered | pitch peak [deg] | hip peak / RMS [N m] | wheel peak / RMS [N m] | hip / wheel speed peak [rad/s] | hip / wheel power peak [W] |
|---|---|---|---|---|---|---|
| stand_L0.120 | O | 1.0 | 8.13 / 6.72 | 0.59 / 0.15 | 0.4 / 0.5 | 3 / 0 |
| stand_L0.140 | O | 1.0 | 7.69 / 6.43 | 0.53 / 0.15 | 0.3 / 0.4 | 2 / 0 |
| stand_L0.160 | O | 0.8 | 7.35 / 6.06 | 0.61 / 0.17 | 0.3 / 0.4 | 2 / 0 |
| stand_L0.180 | O | 0.8 | 6.85 / 5.63 | 0.63 / 0.18 | 0.3 / 0.4 | 2 / 0 |
| stand_L0.198 | O | 0.9 | 6.32 / 5.15 | 0.70 / 0.19 | 0.4 / 0.5 | 2 / 0 |
| stand_L0.220 | O | 0.8 | 5.56 / 4.43 | 0.71 / 0.20 | 0.4 / 0.5 | 2 / 0 |
| stand_L0.240 | O | 0.9 | 4.63 / 3.56 | 0.73 / 0.21 | 0.4 / 0.6 | 2 / 0 |
| stand_L0.260 | O | 0.8 | 3.45 / 2.33 | 0.79 / 0.22 | 0.4 / 0.8 | 1 / 0 |
| tilt_5 | O | 5.4 | 6.75 / 5.18 | 1.63 / 0.21 | 0.5 / 3.7 | 3 / 3 |
| tilt_10 | O | 10.2 | 7.42 / 5.20 | 2.71 / 0.26 | 0.8 / 7.6 | 5 / 9 |
| tilt_15 | O | 15.5 | 8.11 / 5.20 | 4.34 / 0.34 | 1.0 / 11.5 | 6 / 19 |
| tilt_20 | O | 20.3 | 8.61 / 5.21 | 5.58 / 0.42 | 1.4 / 15.5 | 8 / 31 |
| tilt_25 | O | 25.3 | 9.42 / 5.22 | 6.79 / 0.53 | 2.0 / 19.4 | 10 / 49 |
| push_0.25 | O | 1.4 | 5.94 / 5.21 | 1.15 / 0.23 | 0.6 / 7.8 | 3 / 7 |
| push_0.5 | O | 1.7 | 6.82 / 5.23 | 2.15 / 0.32 | 1.4 / 15.9 | 6 / 23 |
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
| yaw_2.0 | X | 58.8 | 29.33 / 4.30 | 90.90 / 12.25 | 65.9 / 2267.1 | 619 / 206068 |
| height_full_range | O | 0.8 | 3.95 / 2.11 | 0.31 / 0.08 | 2.6 / 2.8 | 5 / 1 |
| velocity_0.8_L0.14 | O | 2.4 | 3.12 / 2.57 | 0.42 / 0.12 | 0.4 / 15.4 | 1 / 4 |
| velocity_0.8_L0.24 | O | 2.1 | 1.84 / 1.43 | 0.48 / 0.14 | 0.4 / 15.4 | 1 / 5 |
| slope_5_stand | O | 1.2 | 2.55 / 1.96 | 0.42 / 0.18 | 0.7 / 1.1 | 1 / 0 |
| slope_5_up_0.5 | O | 2.3 | 2.24 / 1.96 | 0.58 / 0.21 | 0.4 / 10.0 | 1 / 4 |
| slope_5_down_0.5 | O | 2.4 | 2.25 / 1.97 | 0.55 / 0.19 | 0.4 / 10.0 | 1 / 4 |
| slope_10_stand | O | 1.6 | 2.55 / 1.86 | 0.58 / 0.34 | 1.0 / 2.0 | 2 / 1 |
| slope_10_up_0.5 | O | 2.7 | 2.12 / 1.86 | 0.75 / 0.36 | 0.4 / 9.9 | 1 / 6 |
| slope_10_down_0.5 | O | 2.8 | 2.14 / 1.87 | 0.72 / 0.34 | 0.4 / 10.0 | 1 / 5 |
| slope_15_stand | O | 2.1 | 2.57 / 1.76 | 0.75 / 0.50 | 1.4 / 3.0 | 3 / 2 |
| slope_15_up_0.5 | O | 3.1 | 2.00 / 1.76 | 0.92 / 0.52 | 0.4 / 9.8 | 1 / 7 |
| slope_15_down_0.5 | O | 3.2 | 2.02 / 1.76 | 0.89 / 0.49 | 0.3 / 10.0 | 1 / 7 |

Envelope over recovered scenarios: hip_peak 5.46 (push_2.0), wheel_peak 2.72 (tilt_25), hip_speed_peak 6.76 (push_2.0), wheel_speed_peak 65.70 (push_2.0), hip_power_peak 18.94 (push_2.0), wheel_power_peak 125.89 (push_2.0); excluded (not recovered): yaw_2.0

## Static holding torque per hip motor (steady mean, stand_L*) vs. analytic VMC (per-leg weight incl. legs)

| L0 [m] | demand_15kg sim / analytic | demand_15kg_seed1 sim / analytic | demand_6kg sim / analytic |
|---|---|---|---|
| 0.120 | 6.71 / 7.80 (L0 0.120) | 6.71 / 7.80 (L0 0.120) | 2.68 / 3.12 (L0 0.120) |
| 0.140 | 6.42 / 7.46 (L0 0.140) | 6.42 / 7.46 (L0 0.140) | 2.57 / 2.99 (L0 0.140) |
| 0.160 | 6.06 / 7.06 (L0 0.160) | 6.06 / 7.06 (L0 0.160) | 2.42 / 2.83 (L0 0.160) |
| 0.180 | 5.63 / 6.59 (L0 0.180) | 5.63 / 6.59 (L0 0.180) | 2.25 / 2.63 (L0 0.180) |
| 0.198 | 5.15 / 6.01 (L0 0.200) | 5.15 / 6.01 (L0 0.200) | 2.06 / 2.41 (L0 0.200) |
| 0.220 | 4.43 / 5.31 (L0 0.220) | 4.42 / 5.31 (L0 0.220) | 1.77 / 2.13 (L0 0.220) |
| 0.240 | 3.56 / 4.42 (L0 0.240) | 3.56 / 4.42 (L0 0.240) | 1.42 / 1.77 (L0 0.240) |
| 0.260 | 2.30 / 3.19 (L0 0.260) | 2.28 / 3.19 (L0 0.260) | 0.93 / 1.27 (L0 0.260) |

## Wheel slope holding torque (steady mean) vs. m g R sin(a) / 2

| case | slope | sim [N m] | analytic [N m] |
|---|---|---|---|
| demand_15kg | 5 deg | 0.41 | 0.42 |
| demand_15kg | 10 deg | 0.82 | 0.83 |
| demand_15kg | 15 deg | 1.22 | 1.24 |
| demand_15kg_seed1 | 5 deg | 0.41 | 0.42 |
| demand_15kg_seed1 | 10 deg | 0.82 | 0.83 |
| demand_15kg_seed1 | 15 deg | 1.22 | 1.24 |
| demand_6kg | 5 deg | 0.17 | 0.17 |
| demand_6kg | 10 deg | 0.33 | 0.33 |
| demand_6kg | 15 deg | 0.49 | 0.50 |

## Verification with motor limits

| case | LQI6 budget hip / wheel | clamp hip / wheel | not recovered | tilt_20: pitch pk / hip pk / wheel pk | tilt_25: pitch pk / hip pk / wheel pk | push_1.5: pitch pk / hip pk / wheel pk | push_2.0: pitch pk / hip pk / wheel pk | yaw_1.0: pitch pk / hip pk / wheel pk | height_full_range: pitch pk / hip pk / wheel pk | slope_15_up_0.5: pitch pk / hip pk / wheel pk |
|---|---|---|---|---|---|---|---|---|---|---|
| clamp_15kg_12_5 | 30.0 / 12.50 | 12 / 5 | none | 20.3 / 8.6 / 5.0 | 25.3 / 9.4 / 5.0 | 4.3 / 11.4 / 5.0 | 7.7 / 12.0 / 5.0 | 0.8 / 9.4 / 3.9 | 0.8 / 9.9 / 0.8 | 3.1 / 5.0 / 2.3 |
| clamp_15kg_15_6 | 30.0 / 12.50 | 15 / 6 | none | 20.3 / 8.6 / 5.6 | 25.3 / 9.4 / 6.0 | 4.3 / 11.4 / 5.1 | 5.8 / 14.1 / 6.0 | 0.8 / 9.4 / 3.9 | 0.8 / 9.9 / 0.8 | 3.1 / 5.0 / 2.3 |
| clamp_15kg_20_8 | 30.0 / 12.50 | 20 / 8 | yaw_2.0 | 20.3 / 8.6 / 5.6 | 25.3 / 9.4 / 6.8 | 4.3 / 11.4 / 5.1 | 5.7 / 14.0 / 6.7 | 0.8 / 9.4 / 3.9 | 0.8 / 10.0 / 0.7 | 3.1 / 5.0 / 2.3 |
| clamp_15kg_design20_8 | 20.0 / 8.00 | 20 / 8 | yaw_2.0, slope_10_up_0.5, slope_15_up_0.5 | 20.3 / 7.9 / 4.4 | 25.3 / 8.5 / 5.4 | 6.0 / 10.6 / 4.9 | 7.9 / 12.9 / 6.5 | 0.8 / 9.4 / 3.7 | 0.9 / 10.0 / 0.6 | 4.2 / 5.0 / 2.1 |
