wisehyun-2/my_robot_project/wheeled_biped/results/acceptance/plan4_mpc_1000Hz.md

# Plan 4 합격 판정 — 1000 Hz, 호스트 mpc, 매트릭스 full, 시드 5개

**종합: 합격**  (노이즈 ON, 지연 10 ms, 판정 피치 = 시뮬 실제 피치; 종합 판정은 필수 항목만, 기록 항목은 자체 통과/실패만 표시; 코드 해시 345db37b94)

| # | 항목 | 등급 | 판정 | 실행 수 | 가장 빠듯한 지표 (측정 / 기준, 여유율) | 최악 조합 |
|---|---|---|---|---|---|---|
| 1 | 정지 60 s | 필수-정착 | 통과 | 45 | pitch_rms: 0.288 <= 0.500 (×0.58) | m×1.15 μ1.00 s0 |
| 2 | 초기 기울기 10° | 필수-정착 | 통과 | 45 | wheel_peak: 1.323 <= 1.360 (×0.97) | m×0.85 μ0.50 s3 |
| 3 | 초기 기울기 15° | 필수-정착 | 통과 | 45 | wheel_rms10: 0.125 <= 0.200 (×0.63) | m×0.85 μ0.50 s0 |
| 4 | 초기 기울기 20° | 필수-생존 | 통과 | 5 | alive: O >= 1 (×0.00) | m×1.00 μ0.75 s0 |
| 5 | 밀기 0.5 W | 필수-정착 | 통과 | 45 | settle_s: 1.899 <= 3.000 (×0.63) | m×0.85 μ0.75 s1 |
| 6 | 밀기 0.75 W | 필수-정착 | 통과 | 45 | wheel_rms10: 0.122 <= 0.200 (×0.61) | m×0.85 μ1.00 s3 |
| 7 | 밀기 1.0 W | 필수-생존 | 통과 | 5 | alive: O >= 1 (×0.00) | m×1.00 μ0.75 s0 |
| 8 | 속도 스텝 0.5 m/s | 필수-정착 | 통과 | 45 | rise_s: 1.103 <= 1.500 (×0.74) | m×0.85 μ1.00 s1 |
| 9 | 요 1 rad/s | 필수-정착 | 통과 | 45 | wheel_rms10: 0.107 <= 0.200 (×0.53) | m×1.15 μ1.00 s1 |
| 10 | 4 cm 웅크림 후 복귀 | 필수-정착 | 통과 | 45 | leg_rms: 1.975 <= 4.000 (×0.49) | m×1.15 μ0.50 s2 |
| 11 | 링크 끊김(0.5 m/s 주행 중) | 필수-정착 | 통과 | 45 | stop_time: 2.326 <= 3.000 (×0.78) | m×0.85 μ1.00 s3 |
| 12 | 경사 5° 정지 | 필수-정착 | 통과 | 45 | wheel_rms10: 0.156 <= 0.200 (×0.78) | m×1.15 μ0.75 s2 |
| 13 | 경사 5° 주행 0.5 m/s(오르기·내리기) | 필수-정착 | 통과 | 45 | rise_s: 1.417 <= 1.500 (×0.94) | m×1.15 μ0.50 s1 |
| 15 | 지연 스윕(3° 기울기, 무노이즈; 강건 여유도 함께 기록) | 기록 | **실패** | 1 | max_latency_ms: 20 >= 25.000 (×1.25) | m×1.00 μ0.75 s0 |
| 16 | IMU 피치 바이어스 +1° | 필수-정착 | 통과 | 45 | drift_max: 0.072 <= 0.100 (×0.72) | m×1.15 μ0.50 s3 |
| 17 | 무게중심 전방 오프셋(0.3 kg, +10 cm) | 필수-정착 | 통과 | 45 | drift_max: 0.086 <= 0.100 (×0.86) | m×0.85 μ0.75 s2 |
| 19 | MPC 속도 스텝 0.5 m/s | 필수-정착 | 통과 | 45 | stop_disp: 0.296 <= 0.300 (×0.99) | m×0.85 μ0.75 s0 |
| 20 | 회귀 없음(1~17: 1단계 통과 유지, 가장 빠듯한 지표 여유율 악화 < 10 %) | 필수-정착 | 통과 | 15 | regression_flips: 0 <= 0 (×0.00) | - |
| 21 | MPC 제약 준수(8·9·13·19) | 필수-정착 | 통과 | 45 | wheel_peak: 0.440 <= 1.360 (×0.32) | m×1.15 μ0.50 s0 |
| 22 | MPC 풀이 시간 | 기록 | 통과 | 1 | solve_p99_ms: 0.330 <= 5.000 (×0.07) | m×1.00 μ0.75 s0 |
| 23 | MPC 폴백(솔버 강제 실패) | 필수-생존 | 통과 | 5 | alive: 1 >= 1 (×0.00) | m×1.00 μ0.75 s0 |
| 24 | 주행 중 밀기(0.3 m/s 순항, 0.75 W; 기록, 검토 r1) | 기록 | 통과 | 1 | settle_s: 1.911 <= 4.000 (×0.48) | m×1.00 μ0.75 s0 |

## 실패 목록

| # | 항목 | 조합 | 지표 | 측정 | 기준 |
|---|---|---|---|---|---|
| 15 | 지연 스윕(3° 기울기, 무노이즈; 강건 여유도 함께 기록) | m×1.00 μ0.75 seed 0 | max_latency_ms | 20 | >= 25.000 |

## 항목별 전체 지표(최악값)

- **1 정지 60 s**: alive O, pitch_ma_max 0.547, pitch_rms 0.288, drift_max 0.019, wheel_rms10 0.038, wheel_sat_duty 0.000, wheel_peak 0.146, leg_peak 1.882, leg_rms 1.629, wheel_speed_peak 1.186, leg_speed_peak 0.483
- **2 초기 기울기 10°**: settled 1, settle_s 1.387, disp 0.134, wheel_peak 1.323, wheel_rms10 0.081, wheel_sat_duty 0.000, leg_peak 1.951, leg_rms 1.639, wheel_speed_peak 16.606, leg_speed_peak 2.059
- **3 초기 기울기 15°**: settled 1, settle_s 1.723, disp 0.197, wheel_sat_s 0.008, wheel_rms10 0.125, wheel_sat_duty 0.001, leg_peak 2.716, leg_rms 1.657, wheel_speed_peak 36.824, leg_speed_peak 3.061
- **4 초기 기울기 20°**: alive O
- **5 밀기 0.5 W**: settled 1, settle_s 1.899, pitch_peak 3.472, disp 0.148, wheel_peak 0.472, wheel_rms10 0.080, wheel_sat_duty 0.000, leg_peak 3.234, leg_rms 1.678, wheel_speed_peak 20.230, leg_speed_peak 3.537
- **6 밀기 0.75 W**: settled 1, settle_s 2.305, pitch_peak 5.172, wheel_rms10 0.122, wheel_sat_duty 0.000, leg_peak 4.671, leg_rms 1.693, wheel_speed_peak 31.114, leg_speed_peak 5.372
- **7 밀기 1.0 W**: alive O
- **8 속도 스텝 0.5 m/s**: rise_s 1.103, overshoot_pct 2.702, ss_err 0.003, pitch_peak 1.901, stop_disp 0.296, settled 1, wheel_peak 0.288, wheel_rms10 0.080, wheel_sat_duty 0.000, leg_peak 1.903, leg_rms 1.634, wheel_speed_peak 10.911, leg_speed_peak 0.868
- **9 요 1 rad/s**: yaw_err_pct 0.494, pitch_peak 0.340, alive O, wheel_peak 0.327, wheel_rms10 0.107, wheel_sat_duty 0.000, leg_peak 2.514, leg_rms 1.967, wheel_speed_peak 3.571, leg_speed_peak 0.784
- **10 4 cm 웅크림 후 복귀**: alive O, pitch_peak 0.696, settled 1, wheel_peak 0.158, wheel_rms10 0.042, wheel_sat_duty 0.000, leg_peak 3.490, leg_rms 1.975, wheel_speed_peak 3.929, leg_speed_peak 3.898
- **11 링크 끊김(0.5 m/s 주행 중)**: alive O, stop_time 2.326, motors_on 1, settled 1, wheel_peak 0.314, wheel_rms10 0.068, wheel_sat_duty 0.000, leg_peak 1.914, leg_rms 1.648, wheel_speed_peak 12.446, leg_speed_peak 1.194
- **12 경사 5° 정지**: alive O, disp_max 0.055, pitch_dev_ma_max 0.437, pitch_dev_rms 0.143, wheel_rms10 0.156, wheel_sat_duty 0.000, wheel_peak 0.280, leg_peak 1.947, leg_rms 1.549, wheel_speed_peak 3.642, leg_speed_peak 1.266
- **13 경사 5° 주행 0.5 m/s(오르기·내리기)**: rise_s 1.417, overshoot_pct 7.071, ss_err 0.023, pitch_peak 2.452, stop_disp 0.297, settled 1, wheel_peak 0.440, wheel_rms10 0.172, wheel_sat_duty 0.000, leg_peak 1.798, leg_rms 1.555, wheel_speed_peak 11.161, leg_speed_peak 0.918
- **15 지연 스윕(3° 기울기, 무노이즈; 강건 여유도 함께 기록)**: max_latency_ms 20 ✗, max_latency_robust_ms 12
- **16 IMU 피치 바이어스 +1°**: alive O, pitch_ma_max 0.569, pitch_rms 0.293, drift_max 0.072, wheel_rms10 0.038, wheel_sat_duty 0.000, wheel_peak 0.158, leg_peak 1.862, leg_rms 1.631, wheel_speed_peak 1.559, leg_speed_peak 0.484
- **17 무게중심 전방 오프셋(0.3 kg, +10 cm)**: alive O, pitch_ma_max 0.708, pitch_rms 0.419, drift_max 0.086, wheel_rms10 0.038, wheel_sat_duty 0.000, wheel_peak 0.156, leg_peak 1.916, leg_rms 1.664, wheel_speed_peak 1.822, leg_speed_peak 0.481
- **19 MPC 속도 스텝 0.5 m/s**: pitch_peak 1.901, overshoot_pct 2.702, rise_s 1.103, stop_disp 0.296, settled 1, wheel_peak 0.288, wheel_rms10 0.080, wheel_sat_duty 0.000, leg_peak 1.903, leg_rms 1.634, wheel_speed_peak 10.911, leg_speed_peak 0.868
- **20 회귀 없음(1~17: 1단계 통과 유지, 가장 빠듯한 지표 여유율 악화 < 10 %)**: regression_flips 0, margin_worse_10pct 0, metric_worse_10pct_record 2
- **21 MPC 제약 준수(8·9·13·19)**: constraint_violations 0, packet_violations 0, wheel_peak 0.440, alive 1
- **22 MPC 풀이 시간**: solve_p99_ms 0.330, qp_failures 0
- **23 MPC 폴백(솔버 강제 실패)**: alive 1, fallback_used 1, passes_1_8_11 1, passes_8_transient 1, mpc_resumed 1
- **24 주행 중 밀기(0.3 m/s 순항, 0.75 W; 기록, 검토 r1)**: alive O, settled 1, settle_s 1.911, v_back 0.004
