wisehyun-2/my_robot_project/wheeled_biped/results/plan4_mpc/regression.md

# 2단계 회귀 비교(기준 20): 1단계 램프 호스트 vs MPC 호스트

1단계: `C:\Users\User\Desktop\myrobot\my_robot_project\wheeled_biped\results\acceptance`, 2단계: `C:\Users\User\Desktop\myrobot\my_robot_project\wheeled_biped\results\acceptance`. 여유율 = 측정/기준(≤) 또는 기준/측정(≥), 작을수록 여유. 회귀 = 1단계 통과→2단계 실패, 또는 가장 빠듯한 지표의 여유율이 1.1배 이상(≥ 10 %) 나빠짐.

## 1000 Hz — 항목별(가장 빠듯한 지표)

| # | 항목 | 1단계 | 2단계 | 1단계 지표(여유율) | 2단계 지표(여유율) | 회귀 |
|---|---|---|---|---|---|---|
| 1 | 정지 60 s | 통과 | 통과 | pitch_rms (0.58) | pitch_rms (0.58) | 아니오 |
| 2 | 초기 기울기 10° | 통과 | 통과 | wheel_peak (0.97) | wheel_peak (0.97) | 아니오 |
| 3 | 초기 기울기 15° | 통과 | 통과 | wheel_rms10 (0.63) | wheel_rms10 (0.63) | 아니오 |
| 4 | 초기 기울기 20° | 통과 | 통과 | alive (0.00) | alive (0.00) | 아니오 |
| 5 | 밀기 0.5 W | 통과 | 통과 | settle_s (0.63) | settle_s (0.63) | 아니오 |
| 6 | 밀기 0.75 W | 통과 | 통과 | wheel_rms10 (0.61) | wheel_rms10 (0.61) | 아니오 |
| 7 | 밀기 1.0 W | 통과 | 통과 | alive (0.00) | alive (0.00) | 아니오 |
| 8 | 속도 스텝 0.5 m/s | 통과 | 통과 | rise_s (0.83) | rise_s (0.74) | 아니오 |
| 9 | 요 1 rad/s | 통과 | 통과 | wheel_rms10 (0.53) | wheel_rms10 (0.53) | 아니오 |
| 10 | 4 cm 웅크림 후 복귀 | 통과 | 통과 | leg_rms (0.49) | leg_rms (0.49) | 아니오 |
| 11 | 링크 끊김(0.5 m/s 주행 중) | 통과 | 통과 | stop_time (0.79) | stop_time (0.78) | 아니오 |
| 12 | 경사 5° 정지 | 통과 | 통과 | wheel_rms10 (0.78) | wheel_rms10 (0.78) | 아니오 |
| 13 | 경사 5° 주행 0.5 m/s(오르기·내리기) | 통과 | 통과 | rise_s (0.92) | rise_s (0.94) | 아니오 |
| 15 | 지연 스윕(3° 기울기, 무노이즈; 강건 여유도 함께 기록) | 실패 | 실패 | max_latency_ms (1.25) | max_latency_ms (1.25) | 아니오 |
| 16 | IMU 피치 바이어스 +1° | 통과 | 통과 | drift_max (0.72) | drift_max (0.72) | 아니오 |
| 17 | 무게중심 전방 오프셋(0.3 kg, +10 cm) | 통과 | 통과 | drift_max (0.86) | drift_max (0.86) | 아니오 |
| 24 | 주행 중 밀기(0.3 m/s 순항, 0.75 W; 기록, 검토 r1) | 통과 | 통과 | settle_s (0.47) | settle_s (0.48) | 아니오 |

### 1000 Hz — 지표별로 10 % 이상 나빠진 것(1단계 여유율이 0.05 미만인 지표는 제외 — 판정 코드의 기록과 같은 규칙)

| # | 지표 | 1단계 값 | 2단계 값 | 기준 | 여유율 1→2 |
|---|---|---|---|---|---|
| 8 | stop_disp | 0.235 | 0.296 | <= 0.500 | 0.47 → 0.59 |
| 13 | stop_disp | 0.234 | 0.297 | <= 0.500 | 0.47 → 0.59 |

## 200 Hz — 항목별(가장 빠듯한 지표)

| # | 항목 | 1단계 | 2단계 | 1단계 지표(여유율) | 2단계 지표(여유율) | 회귀 |
|---|---|---|---|---|---|---|
| 1 | 정지 60 s | 통과 | 통과 | pitch_ma_max (0.69) | pitch_ma_max (0.69) | 아니오 |
| 2 | 초기 기울기 10° | 통과 | 통과 | wheel_peak (0.95) | wheel_peak (0.95) | 아니오 |
| 3 | 초기 기울기 15° | 통과 | 통과 | wheel_rms10 (0.59) | wheel_rms10 (0.59) | 아니오 |
| 4 | 초기 기울기 20° | 통과 | 통과 | alive (0.00) | alive (0.00) | 아니오 |
| 5 | 밀기 0.5 W | 통과 | 통과 | settle_s (0.65) | settle_s (0.65) | 아니오 |
| 6 | 밀기 0.75 W | 통과 | 통과 | wheel_rms10 (0.56) | wheel_rms10 (0.56) | 아니오 |
| 7 | 밀기 1.0 W | 통과 | 통과 | alive (0.00) | alive (0.00) | 아니오 |
| 8 | 속도 스텝 0.5 m/s | 통과 | 통과 | rise_s (0.83) | rise_s (0.72) | 아니오 |
| 9 | 요 1 rad/s | 통과 | 통과 | wheel_rms10 (0.54) | wheel_rms10 (0.54) | 아니오 |
| 10 | 4 cm 웅크림 후 복귀 | 통과 | 통과 | leg_rms (0.49) | leg_rms (0.49) | 아니오 |
| 11 | 링크 끊김(0.5 m/s 주행 중) | 통과 | 통과 | stop_time (0.80) | stop_time (0.79) | 아니오 |
| 12 | 경사 5° 정지 | 통과 | 통과 | wheel_rms10 (0.79) | wheel_rms10 (0.79) | 아니오 |
| 13 | 경사 5° 주행 0.5 m/s(오르기·내리기) | 통과 | 통과 | rise_s (0.94) | rise_s (0.98) | 아니오 |
| 15 | 지연 스윕(3° 기울기, 무노이즈; 강건 여유도 함께 기록) | 통과 | 통과 | max_latency_ms (1.00) | max_latency_ms (1.00) | 아니오 |
| 16 | IMU 피치 바이어스 +1° | 통과 | 통과 | drift_max (0.73) | drift_max (0.73) | 아니오 |
| 17 | 무게중심 전방 오프셋(0.3 kg, +10 cm) | 통과 | 통과 | drift_max (0.87) | drift_max (0.87) | 아니오 |
| 24 | 주행 중 밀기(0.3 m/s 순항, 0.75 W; 기록, 검토 r1) | 통과 | 통과 | settle_s (0.50) | settle_s (0.51) | 아니오 |

### 200 Hz — 지표별로 10 % 이상 나빠진 것(1단계 여유율이 0.05 미만인 지표는 제외 — 판정 코드의 기록과 같은 규칙)

| # | 지표 | 1단계 값 | 2단계 값 | 기준 | 여유율 1→2 |
|---|---|---|---|---|---|
| 8 | stop_disp | 0.236 | 0.297 | <= 0.500 | 0.47 → 0.59 |
| 13 | stop_disp | 0.233 | 0.297 | <= 0.500 | 0.47 → 0.59 |
