wisehyun-2/my_robot_project/wheeled_biped/results/bench/summary.md

| variant | max tilt settled / alive [deg] | max push settled / alive [xW] | latency tol. settled / alive [ms] | stand: pitch rms [deg] / drift [m] / wheel tau rms [Nm] | 10 deg tilt settle [s] / disp [m] | 0.5 W push: pitch peak [deg] / settle [s] | 0.8 m/s step: rise [s] / overshoot [%] / pitch peak [deg] | yaw 1 rad/s -> [rad/s] | max crouch | link loss (alive / v after 6 s) | RT factor |
|---|---|---|---|---|---|---|---|---|---|---|---|
| plan1_mpc | 20 / 20 | 0.75 / 0.75 | 80 / 80 | 0.31 / 0.072 / 0.022 | 1.67 / 0.62 | 10.4 / 2.40 | 0.93 / 15 / 8.6 | 0.93 | 6 cm (pitch 4.0 deg) | n/a | 7.4 |
| plan1_pid | 25 / 25 | 0.25 / 0.50 | 40 / 60 | 1.08 / 0.096 / 0.102 | 0.94 / 0.05 | 14.3 / - | 0.54 / 31 / 18.6 | 0.93 | X | n/a | 8.2 |
| plan1_pid@g0.5 | 0 / 0 | 0.00 / 0.00 | - / - | 16.54 / 0.396 / 0.229 | - / - | 57.3 / - | - / - / - | - | X | n/a | 17.3 |
| plan1_pid@g1.5 | 25 / 25 | 0.50 / 0.75 | - / - | 0.38 / 0.049 / 0.148 | 0.89 / 0.04 | 8.9 / - | - / - / - | - | X | n/a | 9.4 |
| plan1_pid@g2.0 | 20 / 20 | 0.25 / 1.00 | - / - | 0.38 / 0.046 / 0.195 | 0.50 / 0.03 | 6.6 / - | - / - / - | - | X | n/a | 8.4 |
| plan2_lqi6 | 30 / 30 | 2.50 / 2.50 | 30 / 30 | 0.21 / 0.008 / 0.073 | 0.36 / 0.01 | 1.7 / 2.83 | 1.16 / 22 / 2.1 | 1.00 | 6 cm (pitch 0.9 deg) | O / 0.01 | 5.6 |
| plan3_mpc | 30 / 30 | 0.50 / 0.50 | 80 / 80 | 0.22 / 0.005 / 0.020 | 1.22 / 0.17 | 12.7 / 2.06 | 0.91 / 4 / 10.5 | 0.93 | 6 cm (pitch 1.3 deg) | O / -0.01 | 4.5 |
| plan3_pid | 30 / 30 | 0.25 / 0.75 | 60 / 60 | 0.71 / 0.292 / 0.092 | 0.72 / 0.01 | 11.8 / - | 0.52 / 25 / 17.5 | 0.93 | 6 cm (pitch 4.0 deg) | O / 0.02 | 5.7 |
| plan3_pid@g0.5 | 0 / 15 | 0.00 / 0.00 | - / - | 19.58 / 1.114 / 0.505 | - / - | 57.6 / - | - / - / - | - | X | n/a | 5.9 |
| plan3_pid@g1.5 | 30 / 30 | 0.25 / 1.00 | - / - | 0.58 / 0.214 / 0.136 | 0.51 / 0.00 | 8.4 / - | - / - / - | - | X | n/a | 5.5 |
| plan3_pid@g2.0 | 30 / 30 | 0.25 / 1.00 | - / - | 0.67 / 0.164 / 0.179 | 0.41 / 0.00 | 6.8 / - | - / - / - | - | X | n/a | 5.4 |
| plan3_pid@g3.0 | 30 / 30 | 0.25 / 1.25 | - / - | 0.91 / 0.043 / 0.265 | 0.31 / 0.00 | 4.8 / - | - / - / - | - | X | n/a | 5.4 |
| plan4_lqi6 | 25 / 25 | 1.50 / 1.50 | 20 / 20 | 0.23 / 0.018 / 0.037 | 1.42 / 0.03 | 3.2 / 1.83 | 1.35 / 6 / 2.4 | 1.00 | 6 cm (pitch 1.1 deg) | O / -0.02 | 2.7 |
| plan4_lqi6_200hz | 25 / 25 | 1.75 / 1.75 | 20 / 20 | 0.22 / 0.007 / 0.040 | 1.37 / 0.02 | 3.4 / 1.80 | 1.35 / 7 / 2.7 | 1.00 | 6 cm (pitch 1.0 deg) | O / -0.02 | 8.1 |
