wisehyun-2/my_robot_project/wheeled_biped/results/figures/pi_gain_sweep.png

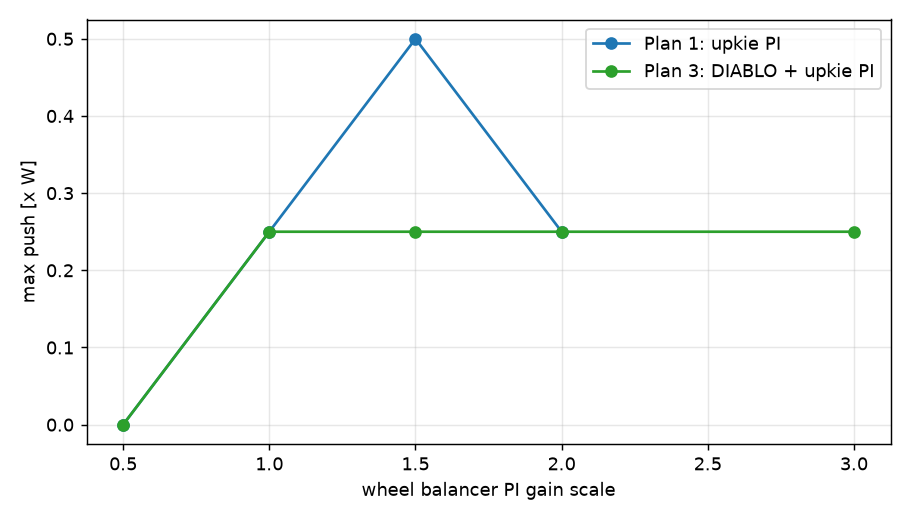
wheeled_biped/results/figures/pi_gain_sweep.png
