wisehyun-2/my_robot_project/wheeled_biped/results/figures/robustness.png

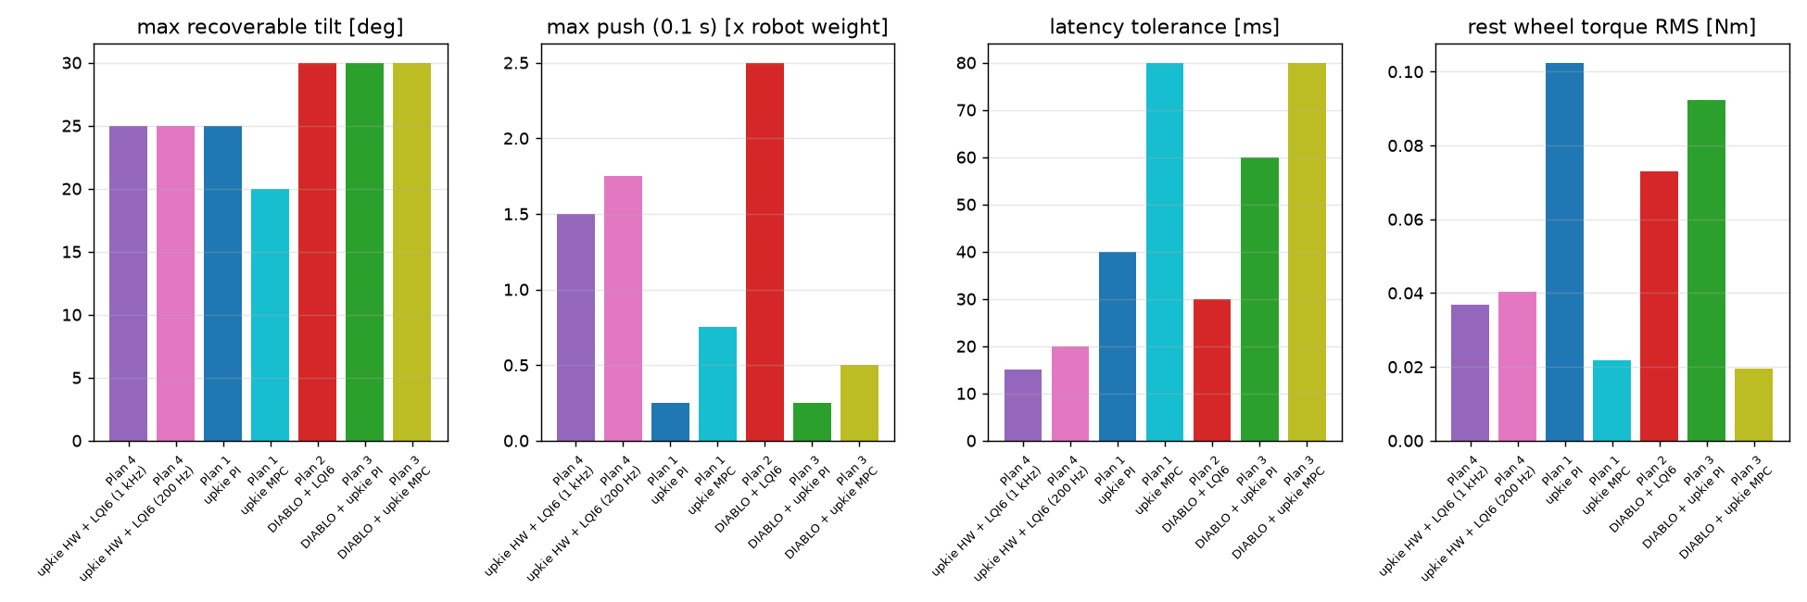
wheeled_biped/results/figures/robustness.png
