wisehyun-2/my_robot_project/wheeled_biped/results/figures/time_responses.png

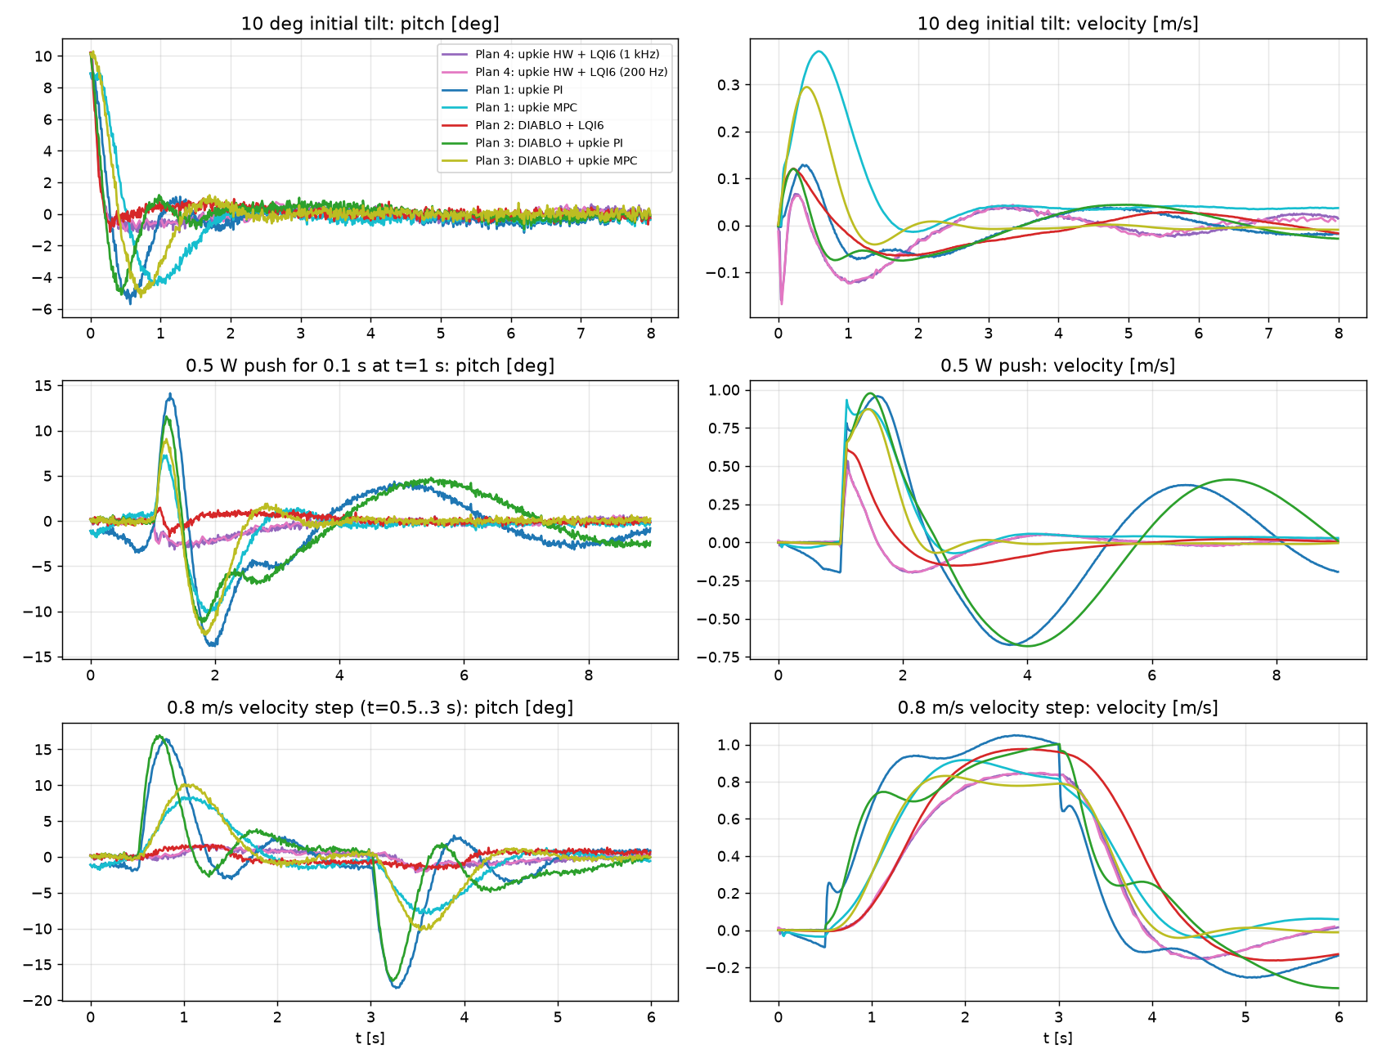
wheeled_biped/results/figures/time_responses.png
