wisehyun-2/my_robot_project/wheeled_biped/results/plan4_mpc/model_fit.png

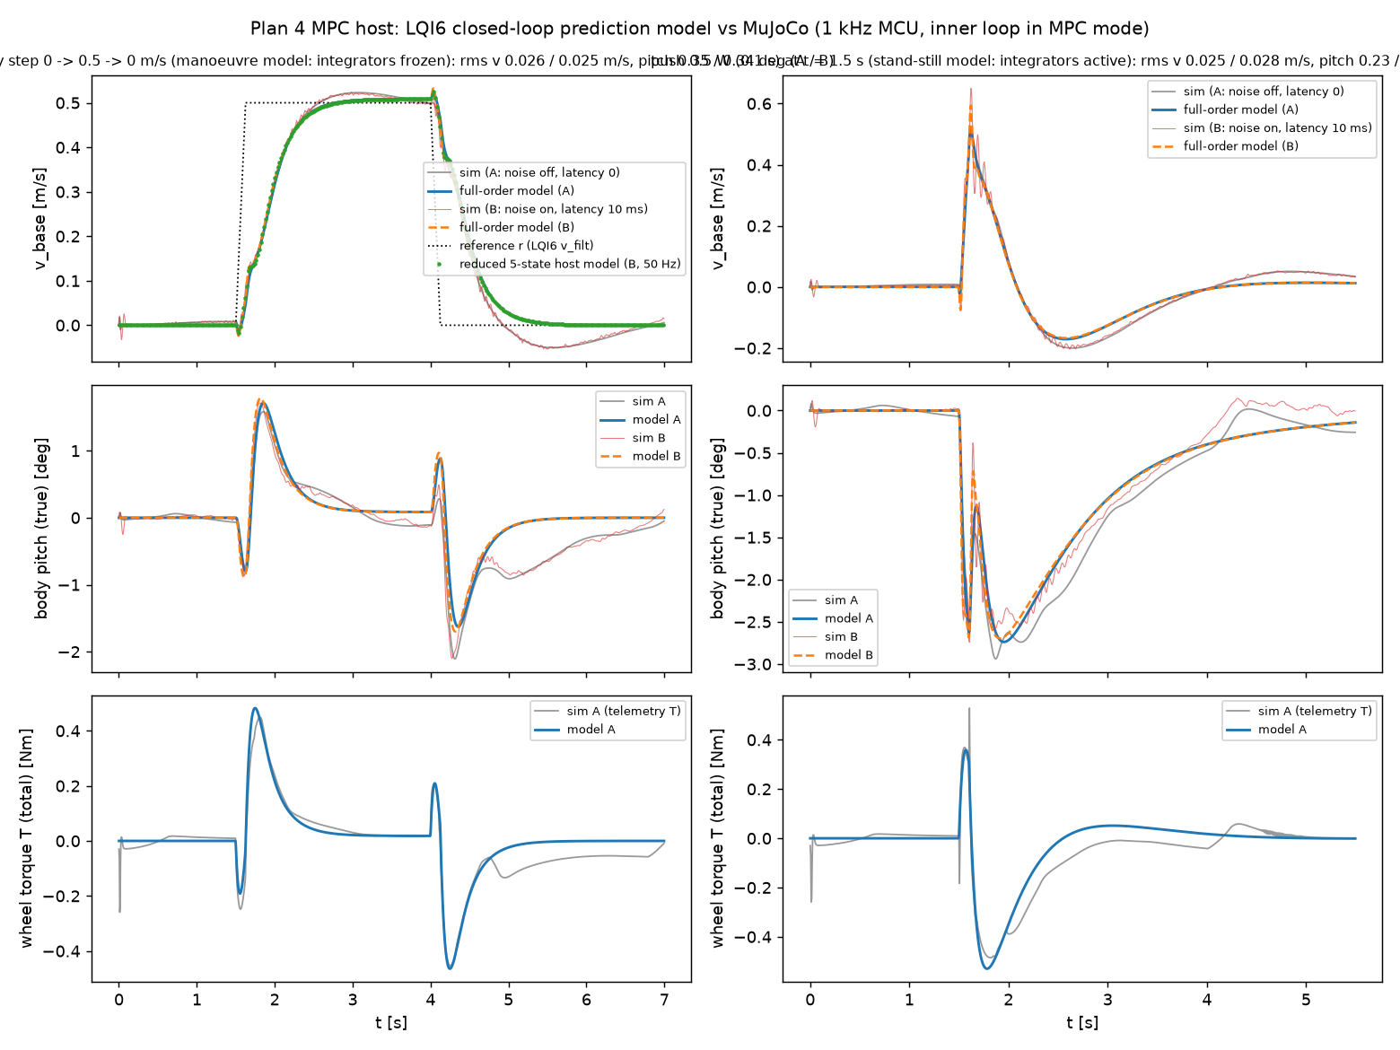
wheeled_biped/results/plan4_mpc/model_fit.png
