wisehyun-2/my_robot_project/wheeled_biped/results/plan4_mpc/ramp_vs_mpc.png

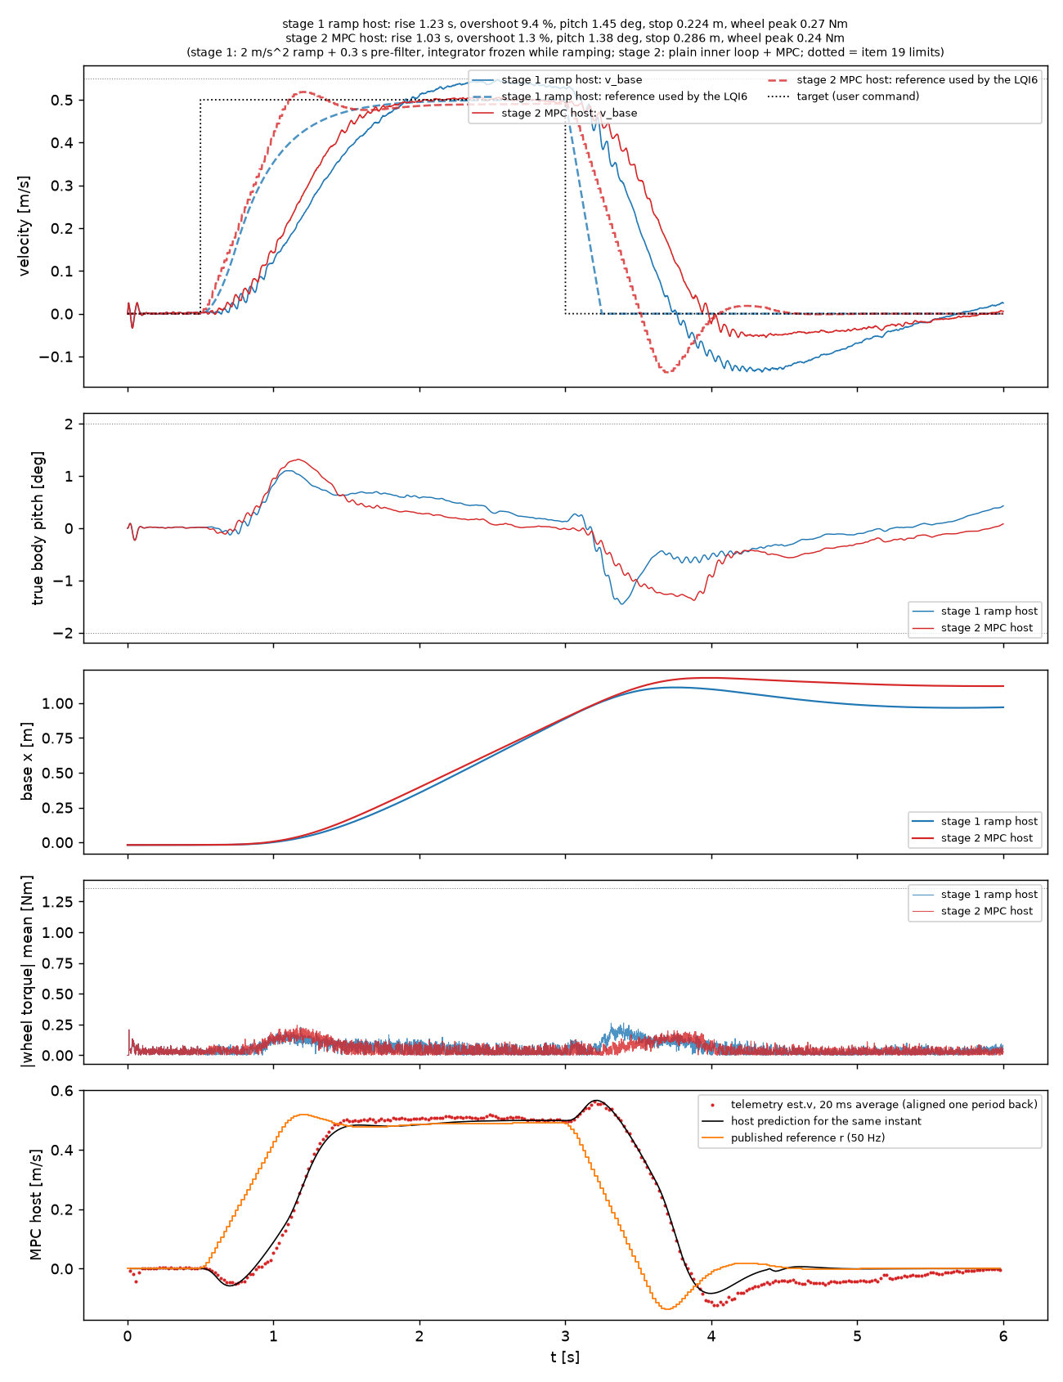
wheeled_biped/results/plan4_mpc/ramp_vs_mpc.png
