wisehyun-2/my_robot_project/wheeled_biped/results/wheelbiped_v5_model/openloop_3deg.png

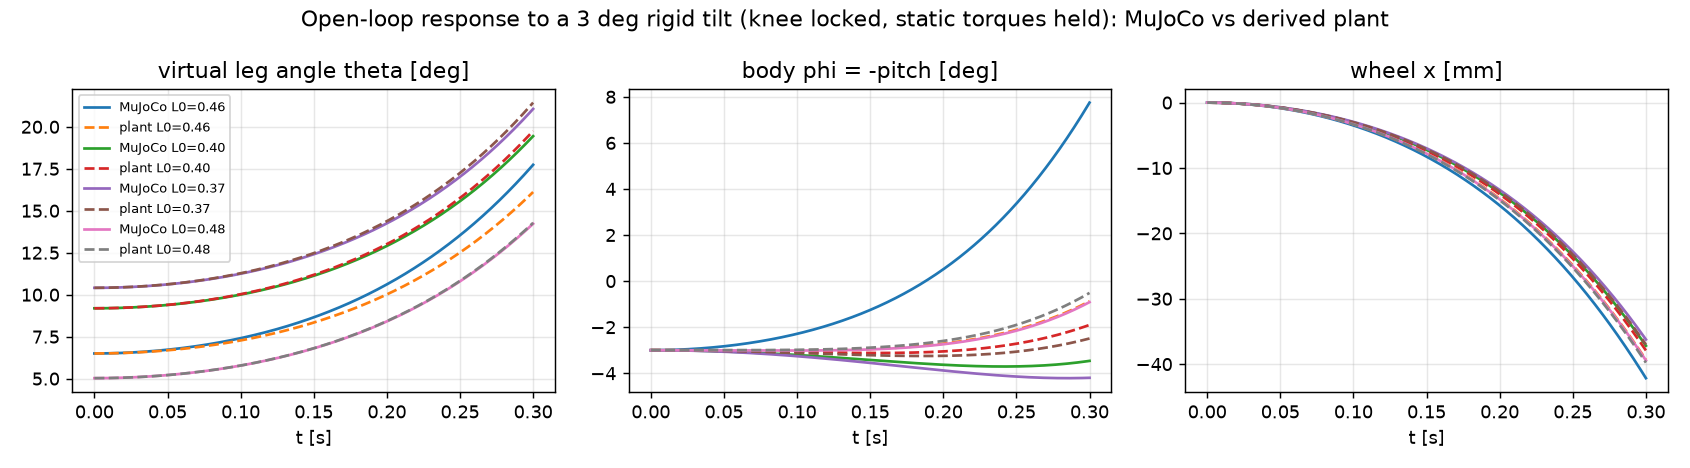
wheeled_biped/results/wheelbiped_v5_model/openloop_3deg.png
