wisehyun-2/my_robot_project/wheeled_biped/models/upkie_plan4/upkie_patched.urdf

<?xml version="1.0" ?>
<!--

SPDX-License-Identifier: Apache-2.0
Copyright 2022 Stéphane Caron
Copyright 2023 Inria

This file was generated from `upkie.xacro`.

Conventions in this file are detailed in:
https://upkie.github.io/upkie/kinematics.html#model-conventions

-->
<robot name="upkie">
  <mujoco><compiler meshdir="../upkie_description" discardvisual="false" fusestatic="false" balanceinertia="true" boundmass="0.001" boundinertia="1e-7" strippath="false"/></mujoco>
  <material name="black">
    <color rgba="0.1 0.1 0.1 1"/>
  </material>
  <material name="chalky_blue">
    <color rgba="0.65 0.76 0.91 1"/>
  </material>
  <material name="dark_gray">
    <color rgba="0.3 0.3 0.3 1"/>
  </material>
  <material name="light_gray">
    <color rgba="0.8 0.8 0.8 1"/>
  </material>
  <material name="light_wood">
    <color rgba="1 0.77 0.48 1"/>
  </material>
  <material name="mj5208_rotor">
    <color rgba="0.5 0.55 0.6 1.0"/>
  </material>
  <material name="mj5208_stator">
    <color rgba="0.22 0.22 0.25 1.0"/>
  </material>
  <material name="terracotta_light">
    <color rgba="0.93 0.64 0.52 1"/>
  </material>
  <material name="terracotta_transparent">
    <color rgba="0.93 0.64 0.52 0.8"/>
  </material>
  <link name="base">
    <!-- virtual link: https://upkie.github.io/upkie/kinematics.html#virtual-links -->
    <visual>
      <geometry>
        <box size="0 0 0"/>
      </geometry>
    </visual>
    <inertial>
      <mass value="0.001"/>
      <origin rpy="0 0 0" xyz="0 0 0"/>
      <inertia ixx="0" ixy="0" ixz="0" iyy="0" iyz="0" izz="0"/>
    </inertial>
  </link>
  <!-- Torso -->
  <link name="torso">
    <visual>
      <geometry>
        <box size="0.125 0.17 0.25"/>
      </geometry>
      <material name="terracotta_transparent"/>
    </visual>
    <collision>
      <geometry>
        <box size="0.125 0.17 0.25"/>
      </geometry>
    </collision>
    <inertial>
      <origin rpy="0 0 0" xyz="0 0 0"/>
      <mass value="1"/>
      <inertia ixx="0.007616666666666667" ixy="0" ixz="0" iyy="0.006510416666666667" iyz="0" izz="0.0037104166666666674"/>
    </inertial>
  </link>
  <joint name="torso_fix" type="fixed">
    <origin rpy="0 0 0" xyz="0 0 -0.1"/>
    <parent link="base"/>
    <child link="torso"/>
  </joint>
  <!-- IMU -->
  <link name="imu">
    <!-- virtual link: https://upkie.github.io/upkie/kinematics.html#virtual-links -->
    <visual>
      <geometry>
        <box size="0 0 0"/>
      </geometry>
    </visual>
    <inertial>
      <mass value="0.001"/>
      <origin rpy="0 0 0" xyz="0 0 0"/>
      <inertia ixx="0" ixy="0" ixz="0" iyy="0" iyz="0" izz="0"/>
    </inertial>
  </link>
  <joint name="imu_fix" type="fixed">
    <!-- not that the origin frame is not translated -->
    <origin rpy="3.141592653589793 0 3.141592653589793" xyz="0 0 0"/>
    <parent link="torso"/>
    <child link="imu"/>
  </joint>
  <!-- Battery -->
  <link name="battery">
    <visual>
      <geometry>
        <box size="0.13 0.074 0.055"/>
      </geometry>
      <material name="dark_gray"/>
    </visual>
    <collision>
      <geometry>
        <box size="0.13 0.074 0.055"/>
      </geometry>
    </collision>
    <inertial>
      <origin rpy="0 0 0" xyz="0 0 0"/>
      <mass value="0.8"/>
      <inertia ixx="0.0005667333333333333" ixy="0" ixz="0" iyy="0.0013283333333333335" iyz="0" izz="0.0014917333333333335"/>
    </inertial>
  </link>
  <joint name="battery_fix" type="fixed">
    <origin rpy="1.5707963267948966 0 1.5707963267948966" xyz="-0.04 0 0"/>
    <parent link="torso"/>
    <child link="battery"/>
  </joint>
  <!-- Handle -->
  <link name="handle">
    <visual>
      <geometry>
        <mesh filename="meshes/add-ons/handle.stl"/>
      </geometry>
      <material name="terracotta_light"/>
    </visual>
    <collision>
      <origin rpy="0 0 0" xyz="0 0 0.01"/>
      <geometry>
        <box size="0.120 0.07 0.04"/>
      </geometry>
    </collision>
    <inertial>
      <origin rpy="0 0 0" xyz="0 0 0.01"/>
      <mass value="0.0525"/>
      <inertia ixx="2.8437500000000003e-05" ixy="0" ixz="0" iyy="7.000000000000001e-05" iyz="0" izz="8.44375e-05"/>
    </inertial>
  </link>
  <joint name="handle_fix" type="fixed">
    <origin rpy="0 0 -1.5707963267948966" xyz="0 0 0.135"/>
    <parent link="torso"/>
    <child link="handle"/>
  </joint>
  <!-- Left leg -->
  <!-- Left hip -->
  <link name="left_hip_qdd100_stator">
    <visual>
      <geometry>
        <mesh filename="meshes/mjbots/qdd100_stator.stl"/>
      </geometry>
      <material name="black"/>
    </visual>
    <collision>
      <origin rpy="0 0 0" xyz="0 0 0.015"/>
      <geometry>
        <cylinder length="0.03" radius="0.05"/>
      </geometry>
    </collision>
    <inertial>
      <origin rpy="0 0 0" xyz="0 0 0.015"/>
      <mass value="0.47"/>
      <inertia ixx="0.00032900000000000003" ixy="0" ixz="0" iyy="0.00032900000000000003" iyz="0" izz="0.0005875000000000001"/>
    </inertial>
  </link>
  <joint name="left_hip_qdd100_stator_fix" type="fixed">
    <origin rpy="-1.5707963267948966 0 0" xyz="0.0 0.085 -0.064"/>
    <parent link="torso"/>
    <child link="left_hip_qdd100_stator"/>
  </joint>
  <link name="left_hip_qdd100_rotor">
    <visual>
      <geometry>
        <mesh filename="meshes/mjbots/qdd100_rotor.stl"/>
      </geometry>
      <material name="black"/>
    </visual>
    <collision>
      <origin rpy="0 0 0" xyz="0 0 -0.0025"/>
      <geometry>
        <cylinder length="0.005" radius="0.023"/>
      </geometry>
    </collision>
    <inertial>
      <origin rpy="0 0 0" xyz="0 0 -0.0025"/>
      <mass value="0.015"/>
      <inertia ixx="2.0149999999999998e-06" ixy="0" ixz="0" iyy="2.0149999999999998e-06" iyz="0" izz="3.9675e-06"/>
    </inertial>
  </link>
  <joint name="left_hip" type="revolute">
    <parent link="left_hip_qdd100_stator"/>
    <child link="left_hip_qdd100_rotor"/>
    <origin rpy="0 0 0" xyz="0 0 0.0292"/>
    <!-- negative z-axis: search "moteus-direction-configuration" -->
    <axis xyz="0 0 -1"/>
    <limit effort="16.0" lower="-1.26" upper="1.26" velocity="28.8"/>
  </joint>
  <link name="left_hip_horn">
    <visual>
      <geometry>
        <mesh filename="meshes/mjbots/qdd100_horn.stl"/>
      </geometry>
      <material name="black"/>
    </visual>
    <collision>
      <origin rpy="0 1.5707963267948966 0" xyz="0 0 0.025"/>
      <geometry>
        <cylinder length="0.09" radius="0.025"/>
      </geometry>
    </collision>
    <inertial>
      <origin rpy="0 1.5707963267948966 0" xyz="0 0 0.025"/>
      <mass value="0.05267"/>
      <inertia ixx="4.37819375e-05" ixy="0" ixz="0" iyy="4.37819375e-05" iyz="0" izz="1.6459375000000005e-05"/>
    </inertial>
  </link>
  <joint name="left_hip_horn_fix" type="fixed">
    <parent link="left_hip_qdd100_rotor"/>
    <child link="left_hip_horn"/>
    <origin rpy="0 0 1.5707963267948966" xyz="0 0 0"/>
  </joint>
  <!-- Left femur -->
  <link name="left_femur">
    <visual>
      <geometry>
        <cylinder length="0.25" radius="0.011"/>
      </geometry>
      <material name="light_wood"/>
    </visual>
    <collision>
      <geometry>
        <cylinder length="0.26" radius="0.012"/>
      </geometry>
      <material name="light_wood"/>
    </collision>
    <inertial>
      <origin rpy="0 0 0" xyz="0 0 0"/>
      <mass value="0.056"/>
      <inertia ixx="5.170666666666667e-06" ixy="0" ixz="0" iyy="5.170666666666667e-06" iyz="0" izz="4.0320000000000005e-06"/>
    </inertial>
  </link>
  <joint name="left_femur_fix" type="fixed">
    <parent link="left_hip_qdd100_rotor"/>
    <child link="left_femur"/>
    <origin rpy="1.5707963267948966 0 0" xyz="0 0.07 0.025"/>
  </joint>
  <!-- Left knee -->
  <joint name="left_knee_stator_fix" type="fixed">
    <parent link="left_femur"/>
    <child link="left_knee_stator"/>
    <origin rpy="0 0 -1.5707963267948966" xyz="0 0.042 -0.098"/>
  </joint>
  <link name="left_knee_stator">
    <visual>
      <geometry>
        <mesh filename="meshes/knee_stator.stl"/>
      </geometry>
      <material name="terracotta_light"/>
    </visual>
    <collision>
      <origin rpy="0 1.5707963267948966 0" xyz="0.03 0 0"/>
      <geometry>
        <cylinder length="0.06" radius="0.05"/>
      </geometry>
    </collision>
    <inertial>
      <origin rpy="0 1.5707963267948966 0" xyz="0.03 0 0"/>
      <mass value="0.09874"/>
      <inertia ixx="9.133450000000001e-05" ixy="0" ixz="0" iyy="9.133450000000001e-05" iyz="0" izz="0.000123425"/>
    </inertial>
  </link>
  <link name="left_knee_qdd100_stator">
    <visual>
      <geometry>
        <mesh filename="meshes/mjbots/qdd100_stator.stl"/>
      </geometry>
      <material name="black"/>
    </visual>
    <collision>
      <origin rpy="0 0 0" xyz="0 0 0.015"/>
      <geometry>
        <cylinder length="0.03" radius="0.05"/>
      </geometry>
    </collision>
    <inertial>
      <origin rpy="0 0 0" xyz="0 0 0.015"/>
      <mass value="0.47"/>
      <inertia ixx="0.00032900000000000003" ixy="0" ixz="0" iyy="0.00032900000000000003" iyz="0" izz="0.0005875000000000001"/>
    </inertial>
  </link>
  <joint name="left_knee_qdd100_stator_fix" type="fixed">
    <parent link="left_knee_stator"/>
    <child link="left_knee_qdd100_stator"/>
    <origin rpy="-1.5707963267948966 0 1.5707963267948966" xyz="0 0 0"/>
  </joint>
  <joint name="left_knee" type="revolute">
    <parent link="left_knee_qdd100_stator"/>
    <child link="left_knee_qdd100_rotor"/>
    <origin rpy="0 0 0" xyz="0 0 0.0292"/>
    <!-- negative z-axis: search "moteus-direction-configuration" -->
    <axis xyz="0 0 -1"/>
    <limit effort="16.0" lower="-2.51" upper="2.51" velocity="28.8"/>
  </joint>
  <link name="left_knee_qdd100_rotor">
    <visual>
      <geometry>
        <mesh filename="meshes/mjbots/qdd100_rotor.stl"/>
      </geometry>
      <material name="black"/>
    </visual>
    <collision>
      <origin rpy="0 0 0" xyz="0 0 -0.0025"/>
      <geometry>
        <cylinder length="0.005" radius="0.023"/>
      </geometry>
    </collision>
    <inertial>
      <origin rpy="0 0 0" xyz="0 0 -0.0025"/>
      <mass value="0.015"/>
      <inertia ixx="2.0149999999999998e-06" ixy="0" ixz="0" iyy="2.0149999999999998e-06" iyz="0" izz="3.9675e-06"/>
    </inertial>
  </link>
  <link name="left_knee_horn">
    <visual>
      <geometry>
        <mesh filename="meshes/mjbots/qdd100_horn.stl"/>
      </geometry>
      <material name="terracotta_light"/>
    </visual>
    <collision>
      <origin rpy="0 1.5707963267948966 0" xyz="0 0 0.025"/>
      <geometry>
        <cylinder length="0.09" radius="0.025"/>
      </geometry>
    </collision>
    <inertial>
      <origin rpy="0 1.5707963267948966 0" xyz="0 0 0.025"/>
      <mass value="0.05267"/>
      <inertia ixx="4.37819375e-05" ixy="0" ixz="0" iyy="4.37819375e-05" iyz="0" izz="1.6459375000000005e-05"/>
    </inertial>
  </link>
  <joint name="left_knee_horn_fix" type="fixed">
    <parent link="left_knee_qdd100_rotor"/>
    <child link="left_knee_horn"/>
    <origin rpy="0 0 1.5707963267948966" xyz="0 0 0"/>
  </joint>
  <!-- Left tibia -->
  <link name="left_tibia">
    <visual>
      <geometry>
        <cylinder length="0.25" radius="0.011"/>
      </geometry>
      <material name="light_wood"/>
    </visual>
    <collision>
      <geometry>
        <cylinder length="0.26" radius="0.012"/>
      </geometry>
      <material name="light_wood"/>
    </collision>
    <inertial>
      <origin rpy="0 0 0" xyz="0 0 0"/>
      <mass value="0.056"/>
      <inertia ixx="5.170666666666667e-06" ixy="0" ixz="0" iyy="5.170666666666667e-06" iyz="0" izz="4.0320000000000005e-06"/>
    </inertial>
  </link>
  <joint name="left_tibia_fix" type="fixed">
    <parent link="left_knee_qdd100_rotor"/>
    <child link="left_tibia"/>
    <origin rpy="1.5707963267948966 3.141592653589793 0" xyz="0 0.07 0.025"/>
  </joint>
  <!-- Left ankle -->
  <link name="left_ankle_base">
    <visual>
      <geometry>
        <mesh filename="meshes/ankle_stator.stl"/>
      </geometry>
      <material name="chalky_blue"/>
    </visual>
    <collision>
      <origin rpy="0 0 0" xyz="0 0.002 0.0275"/>
      <geometry>
        <box size="0.092 0.068 0.056"/>
      </geometry>
    </collision>
    <inertial>
      <origin rpy="0 0 0" xyz="0 0.002 0.0275"/>
      <mass value="0.07863"/>
      <inertia ixx="5.084740000000002e-05" ixy="0" ixz="0" iyy="7.6009e-05" iyz="0" izz="8.575912e-05"/>
    </inertial>
  </link>
  <joint name="left_ankle_base_fix" type="fixed">
    <parent link="left_tibia"/>
    <child link="left_ankle_base"/>
    <origin rpy="1.5707963267948966 0 0" xyz="0 0.034 -0.105"/>
  </joint>
  <link name="left_ankle_plate">
    <visual>
      <geometry>
        <box size="0.08 0.045 0.003"/>
      </geometry>
      <material name="light_gray"/>
    </visual>
    <collision>
      <geometry>
        <box size="0.09 0.046 0.004"/>
      </geometry>
    </collision>
    <inertial>
      <origin rpy="0 0 0" xyz="0 0 0"/>
      <mass value="0.02"/>
      <inertia ixx="3.5533333333333333e-06" ixy="0" ixz="0" iyy="1.3526666666666667e-05" iyz="0" izz="1.7026666666666667e-05"/>
    </inertial>
  </link>
  <joint name="left_ankle_plate_fix" type="fixed">
    <parent link="left_ankle_base"/>
    <child link="left_ankle_plate"/>
    <origin rpy="0 0 0" xyz="0 0 -0.0015"/>
  </joint>
  <link name="left_ankle_mj5208_stator">
    <visual>
      <geometry>
        <mesh filename="meshes/mjbots/mj5208_stator.stl"/>
      </geometry>
      <material name="mj5208_stator"/>
    </visual>
    <collision>
      <origin rpy="0 0 0" xyz="0 0 0.01"/>
      <geometry>
        <cylinder length="0.018" radius="0.03"/>
      </geometry>
    </collision>
    <inertial>
      <origin rpy="0 0 0" xyz="0 0 0.01"/>
      <mass value="0.1721"/>
      <inertia ixx="4.3369200000000005e-05" ixy="0" ixz="0" iyy="4.3369200000000005e-05" iyz="0" izz="7.7445e-05"/>
    </inertial>
  </link>
  <joint name="left_ankle_mj5208_stator_fix" type="fixed">
    <parent link="left_ankle_plate"/>
    <child link="left_ankle_mj5208_stator"/>
    <origin rpy="3.141592653589793 0 0" xyz="0 0 -0.0015"/>
  </joint>
  <link name="left_anchor">
    <!-- virtual link: https://upkie.github.io/upkie/kinematics.html#virtual-links -->
    <visual>
      <geometry>
        <box size="0 0 0"/>
      </geometry>
    </visual>
    <inertial>
      <mass value="0.001"/>
      <origin rpy="0 0 0" xyz="0 0 0"/>
      <inertia ixx="0" ixy="0" ixz="0" iyy="0" iyz="0" izz="0"/>
    </inertial>
  </link>
  <joint name="left_anchor_fix" type="fixed">
    <parent link="left_ankle_mj5208_stator"/>
    <child link="left_anchor"/>
    <origin rpy="1.5707963267948966 3.141592653589793 0" xyz="0 0.0545 0.05"/>
  </joint>
  <link name="left_ankle_mj5208_rotor">
    <visual>
      <geometry>
        <mesh filename="meshes/mjbots/mj5208_rotor.stl"/>
      </geometry>
      <material name="mj5208_rotor"/>
    </visual>
    <collision>
      <origin rpy="0 0 0" xyz="0 0 0.015"/>
      <geometry>
        <cylinder length="0.016" radius="0.034"/>
      </geometry>
    </collision>
    <inertial>
      <origin rpy="0 0 0" xyz="0 0 0.015"/>
      <mass value="0.05"/>
      <inertia ixx="1.551666666666667e-05" ixy="0" ixz="0" iyy="1.551666666666667e-05" iyz="0" izz="2.8900000000000005e-05"/>
    </inertial>
  </link>
  <joint name="left_wheel" type="revolute">
    <parent link="left_ankle_mj5208_stator"/>
    <child link="left_ankle_mj5208_rotor"/>
    <origin rpy="0 0 0" xyz="0 0 0"/>
    <!-- negative z-axis: search "moteus-direction-configuration" -->
    <axis xyz="0 0 -1"/>
    <limit effort="1.7" velocity="111.0"/>
  </joint>
  <!-- Left wheel -->
  <link name="left_wheel_hub">
    <visual>
      <geometry>
        <mesh filename="meshes/wheel_hub.stl"/>
      </geometry>
      <material name="terracotta_light"/>
    </visual>
    <collision>
      <origin rpy="0 0 0" xyz="0 0 0.0125"/>
      <geometry>
        <cylinder length="0.025" radius="0.039"/>
      </geometry>
    </collision>
    <inertial>
      <origin rpy="0 0 0" xyz="0 0 0.0125"/>
      <mass value="0.0454"/>
      <inertia ixx="1.9627933333333332e-05" ixy="0" ixz="0" iyy="1.9627933333333332e-05" iyz="0" izz="3.45267e-05"/>
    </inertial>
  </link>
  <joint name="left_wheel_hub_fix" type="fixed">
    <parent link="left_ankle_mj5208_rotor"/>
    <child link="left_wheel_hub"/>
    <origin rpy="0 0 0" xyz="0 0 0.0251"/>
  </joint>
  <link name="left_wheel_tire">
    <visual>
      <geometry>
        <mesh filename="meshes/wheel_tire/wheel_tire.stl"/>
      </geometry>
      <material name="dark_gray"/>
    </visual>
    <collision>
      <geometry>
        <cylinder length="0.04" radius="0.05"/>
      </geometry>
    </collision>
    <inertial>
      <origin rpy="0 0 0" xyz="0 0 0"/>
      <mass value="0.08715"/>
      <inertia ixx="6.608875000000002e-05" ixy="0" ixz="0" iyy="6.608875000000002e-05" iyz="0" izz="0.00010893750000000003"/>
    </inertial>
    <contact>
      <lateral_friction value="1.0"/>
      <rolling_friction value="0.01"/>
      <stiffness value="30000"/>
      <damping value="1000"/>
    </contact>
  </link>
  <joint name="left_wheel_fix" type="fixed">
    <parent link="left_wheel_hub"/>
    <child link="left_wheel_tire"/>
    <origin rpy="0 0 0" xyz="0 0 0.0209"/>
  </joint>
  <link name="left_contact">
    <!-- virtual link: https://upkie.github.io/upkie/kinematics.html#virtual-links -->
    <visual>
      <geometry>
        <box size="0 0 0"/>
      </geometry>
    </visual>
    <inertial>
      <mass value="0.001"/>
      <origin rpy="0 0 0" xyz="0 0 0"/>
      <inertia ixx="0" ixy="0" ixz="0" iyy="0" iyz="0" izz="0"/>
    </inertial>
  </link>
  <joint name="left_contact_fix" type="fixed">
    <parent link="left_wheel_tire"/>
    <child link="left_contact"/>
    <!-- contact target is a bit inside to avoid collisions with its box -->
    <!-- tangent contact surface would be xyz="0 0.05 0" -->
    <origin rpy="1.5707963267948966 0 0" xyz="0 0.047 0"/>
  </joint>
  <link name="left_wheel_center">
    <!-- virtual link: https://upkie.github.io/upkie/kinematics.html#virtual-links -->
    <visual>
      <geometry>
        <box size="0 0 0"/>
      </geometry>
    </visual>
    <inertial>
      <mass value="0.001"/>
      <origin rpy="0 0 0" xyz="0 0 0"/>
      <inertia ixx="0" ixy="0" ixz="0" iyy="0" iyz="0" izz="0"/>
    </inertial>
  </link>
  <joint name="left_wheel_center_fix" type="fixed">
    <parent link="left_wheel_tire"/>
    <child link="left_wheel_center"/>
    <origin rpy="1.5707963267948966 3.141592653589793 0" xyz="0 0 0"/>
  </joint>
  <!-- Right leg -->
  <!-- Right hip -->
  <link name="right_hip_qdd100_stator">
    <visual>
      <geometry>
        <mesh filename="meshes/mjbots/qdd100_stator.stl"/>
      </geometry>
      <material name="black"/>
    </visual>
    <collision>
      <origin rpy="0 0 0" xyz="0 0 0.015"/>
      <geometry>
        <cylinder length="0.03" radius="0.05"/>
      </geometry>
    </collision>
    <inertial>
      <origin rpy="0 0 0" xyz="0 0 0.015"/>
      <mass value="0.47"/>
      <inertia ixx="0.00032900000000000003" ixy="0" ixz="0" iyy="0.00032900000000000003" iyz="0" izz="0.0005875000000000001"/>
    </inertial>
  </link>
  <joint name="right_hip_qdd100_stator_fix" type="fixed">
    <origin rpy="1.5707963267948966 3.141592653589793 0" xyz="0.0 -0.085 -0.064"/>
    <parent link="torso"/>
    <child link="right_hip_qdd100_stator"/>
  </joint>
  <link name="right_hip_qdd100_rotor">
    <visual>
      <geometry>
        <mesh filename="meshes/mjbots/qdd100_rotor.stl"/>
      </geometry>
      <material name="black"/>
    </visual>
    <collision>
      <origin rpy="0 0 0" xyz="0 0 -0.0025"/>
      <geometry>
        <cylinder length="0.005" radius="0.023"/>
      </geometry>
    </collision>
    <inertial>
      <origin rpy="0 0 0" xyz="0 0 -0.0025"/>
      <mass value="0.015"/>
      <inertia ixx="2.0149999999999998e-06" ixy="0" ixz="0" iyy="2.0149999999999998e-06" iyz="0" izz="3.9675e-06"/>
    </inertial>
  </link>
  <joint name="right_hip" type="revolute">
    <parent link="right_hip_qdd100_stator"/>
    <child link="right_hip_qdd100_rotor"/>
    <origin rpy="0 0 0" xyz="0 0 0.0292"/>
    <!-- negative z-axis: search "moteus-direction-configuration" -->
    <axis xyz="0 0 -1"/>
    <limit effort="16.0" lower="-1.26" upper="1.26" velocity="28.8"/>
  </joint>
  <link name="right_hip_horn">
    <visual>
      <geometry>
        <mesh filename="meshes/mjbots/qdd100_horn.stl"/>
      </geometry>
      <material name="black"/>
    </visual>
    <collision>
      <origin rpy="0 1.5707963267948966 0" xyz="0 0 0.025"/>
      <geometry>
        <cylinder length="0.09" radius="0.025"/>
      </geometry>
    </collision>
    <inertial>
      <origin rpy="0 1.5707963267948966 0" xyz="0 0 0.025"/>
      <mass value="0.05267"/>
      <inertia ixx="4.37819375e-05" ixy="0" ixz="0" iyy="4.37819375e-05" iyz="0" izz="1.6459375000000005e-05"/>
    </inertial>
  </link>
  <joint name="right_hip_horn_fix" type="fixed">
    <parent link="right_hip_qdd100_rotor"/>
    <child link="right_hip_horn"/>
    <origin rpy="0 0 1.5707963267948966" xyz="0 0 0"/>
  </joint>
  <!-- Right femur -->
  <link name="right_femur">
    <visual>
      <geometry>
        <cylinder length="0.25" radius="0.011"/>
      </geometry>
      <material name="light_wood"/>
    </visual>
    <collision>
      <geometry>
        <cylinder length="0.26" radius="0.012"/>
      </geometry>
      <material name="light_wood"/>
    </collision>
    <inertial>
      <origin rpy="0 0 0" xyz="0 0 0"/>
      <mass value="0.056"/>
      <inertia ixx="5.170666666666667e-06" ixy="0" ixz="0" iyy="5.170666666666667e-06" iyz="0" izz="4.0320000000000005e-06"/>
    </inertial>
  </link>
  <joint name="right_femur_fix" type="fixed">
    <parent link="right_hip_qdd100_rotor"/>
    <child link="right_femur"/>
    <origin rpy="1.5707963267948966 0 0" xyz="0 0.07 0.025"/>
  </joint>
  <!-- Right knee -->
  <joint name="right_knee_stator_fix" type="fixed">
    <parent link="right_femur"/>
    <child link="right_knee_stator"/>
    <origin rpy="0 0 -1.5707963267948966" xyz="0 0.042 -0.098"/>
  </joint>
  <link name="right_knee_stator">
    <visual>
      <geometry>
        <mesh filename="meshes/knee_stator.stl"/>
      </geometry>
      <material name="terracotta_light"/>
    </visual>
    <collision>
      <origin rpy="0 1.5707963267948966 0" xyz="0.03 0 0"/>
      <geometry>
        <cylinder length="0.06" radius="0.05"/>
      </geometry>
    </collision>
    <inertial>
      <origin rpy="0 1.5707963267948966 0" xyz="0.03 0 0"/>
      <mass value="0.09874"/>
      <inertia ixx="9.133450000000001e-05" ixy="0" ixz="0" iyy="9.133450000000001e-05" iyz="0" izz="0.000123425"/>
    </inertial>
  </link>
  <link name="right_knee_qdd100_stator">
    <visual>
      <geometry>
        <mesh filename="meshes/mjbots/qdd100_stator.stl"/>
      </geometry>
      <material name="black"/>
    </visual>
    <collision>
      <origin rpy="0 0 0" xyz="0 0 0.015"/>
      <geometry>
        <cylinder length="0.03" radius="0.05"/>
      </geometry>
    </collision>
    <inertial>
      <origin rpy="0 0 0" xyz="0 0 0.015"/>
      <mass value="0.47"/>
      <inertia ixx="0.00032900000000000003" ixy="0" ixz="0" iyy="0.00032900000000000003" iyz="0" izz="0.0005875000000000001"/>
    </inertial>
  </link>
  <joint name="right_knee_qdd100_stator_fix" type="fixed">
    <parent link="right_knee_stator"/>
    <child link="right_knee_qdd100_stator"/>
    <origin rpy="-1.5707963267948966 0 1.5707963267948966" xyz="0 0 0"/>
  </joint>
  <joint name="right_knee" type="revolute">
    <parent link="right_knee_qdd100_stator"/>
    <child link="right_knee_qdd100_rotor"/>
    <origin rpy="0 0 0" xyz="0 0 0.0292"/>
    <!-- negative z-axis: search "moteus-direction-configuration" -->
    <axis xyz="0 0 -1"/>
    <limit effort="16.0" lower="-2.51" upper="2.51" velocity="28.8"/>
  </joint>
  <link name="right_knee_qdd100_rotor">
    <visual>
      <geometry>
        <mesh filename="meshes/mjbots/qdd100_rotor.stl"/>
      </geometry>
      <material name="black"/>
    </visual>
    <collision>
      <origin rpy="0 0 0" xyz="0 0 -0.0025"/>
      <geometry>
        <cylinder length="0.005" radius="0.023"/>
      </geometry>
    </collision>
    <inertial>
      <origin rpy="0 0 0" xyz="0 0 -0.0025"/>
      <mass value="0.015"/>
      <inertia ixx="2.0149999999999998e-06" ixy="0" ixz="0" iyy="2.0149999999999998e-06" iyz="0" izz="3.9675e-06"/>
    </inertial>
  </link>
  <link name="right_knee_horn">
    <visual>
      <geometry>
        <mesh filename="meshes/mjbots/qdd100_horn.stl"/>
      </geometry>
      <material name="terracotta_light"/>
    </visual>
    <collision>
      <origin rpy="0 1.5707963267948966 0" xyz="0 0 0.025"/>
      <geometry>
        <cylinder length="0.09" radius="0.025"/>
      </geometry>
    </collision>
    <inertial>
      <origin rpy="0 1.5707963267948966 0" xyz="0 0 0.025"/>
      <mass value="0.05267"/>
      <inertia ixx="4.37819375e-05" ixy="0" ixz="0" iyy="4.37819375e-05" iyz="0" izz="1.6459375000000005e-05"/>
    </inertial>
  </link>
  <joint name="right_knee_horn_fix" type="fixed">
    <parent link="right_knee_qdd100_rotor"/>
    <child link="right_knee_horn"/>
    <origin rpy="0 0 1.5707963267948966" xyz="0 0 0"/>
  </joint>
  <!-- Right tibia -->
  <link name="right_tibia">
    <visual>
      <geometry>
        <cylinder length="0.25" radius="0.011"/>
      </geometry>
      <material name="light_wood"/>
    </visual>
    <collision>
      <geometry>
        <cylinder length="0.26" radius="0.012"/>
      </geometry>
      <material name="light_wood"/>
    </collision>
    <inertial>
      <origin rpy="0 0 0" xyz="0 0 0"/>
      <mass value="0.056"/>
      <inertia ixx="5.170666666666667e-06" ixy="0" ixz="0" iyy="5.170666666666667e-06" iyz="0" izz="4.0320000000000005e-06"/>
    </inertial>
  </link>
  <joint name="right_tibia_fix" type="fixed">
    <parent link="right_knee_qdd100_rotor"/>
    <child link="right_tibia"/>
    <origin rpy="1.5707963267948966 3.141592653589793 0" xyz="0 0.07 0.025"/>
  </joint>
  <!-- Right ankle -->
  <link name="right_ankle_base">
    <visual>
      <geometry>
        <mesh filename="meshes/ankle_stator.stl"/>
      </geometry>
      <material name="chalky_blue"/>
    </visual>
    <collision>
      <origin rpy="0 0 0" xyz="0 0.002 0.0275"/>
      <geometry>
        <box size="0.092 0.068 0.056"/>
      </geometry>
    </collision>
    <inertial>
      <origin rpy="0 0 0" xyz="0 0.002 0.0275"/>
      <mass value="0.07863"/>
      <inertia ixx="5.084740000000002e-05" ixy="0" ixz="0" iyy="7.6009e-05" iyz="0" izz="8.575912e-05"/>
    </inertial>
  </link>
  <joint name="right_ankle_base_fix" type="fixed">
    <parent link="right_tibia"/>
    <child link="right_ankle_base"/>
    <origin rpy="1.5707963267948966 0 0" xyz="0 0.034 -0.105"/>
  </joint>
  <link name="right_ankle_plate">
    <visual>
      <geometry>
        <box size="0.08 0.045 0.003"/>
      </geometry>
      <material name="light_gray"/>
    </visual>
    <collision>
      <geometry>
        <box size="0.09 0.046 0.004"/>
      </geometry>
    </collision>
    <inertial>
      <origin rpy="0 0 0" xyz="0 0 0"/>
      <mass value="0.02"/>
      <inertia ixx="3.5533333333333333e-06" ixy="0" ixz="0" iyy="1.3526666666666667e-05" iyz="0" izz="1.7026666666666667e-05"/>
    </inertial>
  </link>
  <joint name="right_ankle_plate_fix" type="fixed">
    <parent link="right_ankle_base"/>
    <child link="right_ankle_plate"/>
    <origin rpy="0 0 0" xyz="0 0 -0.0015"/>
  </joint>
  <link name="right_ankle_mj5208_stator">
    <visual>
      <geometry>
        <mesh filename="meshes/mjbots/mj5208_stator.stl"/>
      </geometry>
      <material name="mj5208_stator"/>
    </visual>
    <collision>
      <origin rpy="0 0 0" xyz="0 0 0.01"/>
      <geometry>
        <cylinder length="0.018" radius="0.03"/>
      </geometry>
    </collision>
    <inertial>
      <origin rpy="0 0 0" xyz="0 0 0.01"/>
      <mass value="0.1721"/>
      <inertia ixx="4.3369200000000005e-05" ixy="0" ixz="0" iyy="4.3369200000000005e-05" iyz="0" izz="7.7445e-05"/>
    </inertial>
  </link>
  <joint name="right_ankle_mj5208_stator_fix" type="fixed">
    <parent link="right_ankle_plate"/>
    <child link="right_ankle_mj5208_stator"/>
    <origin rpy="3.141592653589793 0 0" xyz="0 0 -0.0015"/>
  </joint>
  <link name="right_anchor">
    <!-- virtual link: https://upkie.github.io/upkie/kinematics.html#virtual-links -->
    <visual>
      <geometry>
        <box size="0 0 0"/>
      </geometry>
    </visual>
    <inertial>
      <mass value="0.001"/>
      <origin rpy="0 0 0" xyz="0 0 0"/>
      <inertia ixx="0" ixy="0" ixz="0" iyy="0" iyz="0" izz="0"/>
    </inertial>
  </link>
  <joint name="right_anchor_fix" type="fixed">
    <parent link="right_ankle_mj5208_stator"/>
    <child link="right_anchor"/>
    <origin rpy="1.5707963267948966 0 0" xyz="0 0.0545 0.048"/>
  </joint>
  <link name="right_ankle_mj5208_rotor">
    <visual>
      <geometry>
        <mesh filename="meshes/mjbots/mj5208_rotor.stl"/>
      </geometry>
      <material name="mj5208_rotor"/>
    </visual>
    <collision>
      <origin rpy="0 0 0" xyz="0 0 0.015"/>
      <geometry>
        <cylinder length="0.016" radius="0.034"/>
      </geometry>
    </collision>
    <inertial>
      <origin rpy="0 0 0" xyz="0 0 0.015"/>
      <mass value="0.05"/>
      <inertia ixx="1.551666666666667e-05" ixy="0" ixz="0" iyy="1.551666666666667e-05" iyz="0" izz="2.8900000000000005e-05"/>
    </inertial>
  </link>
  <joint name="right_wheel" type="revolute">
    <parent link="right_ankle_mj5208_stator"/>
    <child link="right_ankle_mj5208_rotor"/>
    <origin rpy="0 0 0" xyz="0 0 0"/>
    <!-- negative z-axis: search "moteus-direction-configuration" -->
    <axis xyz="0 0 -1"/>
    <limit effort="1.7" velocity="111.0"/>
  </joint>
  <!-- Right wheel -->
  <link name="right_wheel_hub">
    <visual>
      <geometry>
        <mesh filename="meshes/wheel_hub.stl"/>
      </geometry>
      <material name="terracotta_light"/>
    </visual>
    <collision>
      <origin rpy="0 0 0" xyz="0 0 0.0125"/>
      <geometry>
        <cylinder length="0.025" radius="0.039"/>
      </geometry>
    </collision>
    <inertial>
      <origin rpy="0 0 0" xyz="0 0 0.0125"/>
      <mass value="0.0454"/>
      <inertia ixx="1.9627933333333332e-05" ixy="0" ixz="0" iyy="1.9627933333333332e-05" iyz="0" izz="3.45267e-05"/>
    </inertial>
  </link>
  <joint name="right_wheel_hub_fix" type="fixed">
    <parent link="right_ankle_mj5208_rotor"/>
    <child link="right_wheel_hub"/>
    <origin rpy="0 0 0" xyz="0 0 0.0251"/>
  </joint>
  <link name="right_wheel_tire">
    <visual>
      <geometry>
        <mesh filename="meshes/wheel_tire/wheel_tire.stl"/>
      </geometry>
      <material name="dark_gray"/>
    </visual>
    <collision>
      <geometry>
        <cylinder length="0.04" radius="0.05"/>
      </geometry>
    </collision>
    <inertial>
      <origin rpy="0 0 0" xyz="0 0 0"/>
      <mass value="0.08715"/>
      <inertia ixx="6.608875000000002e-05" ixy="0" ixz="0" iyy="6.608875000000002e-05" iyz="0" izz="0.00010893750000000003"/>
    </inertial>
    <contact>
      <lateral_friction value="1.0"/>
      <rolling_friction value="0.01"/>
      <stiffness value="30000"/>
      <damping value="1000"/>
    </contact>
  </link>
  <joint name="right_wheel_fix" type="fixed">
    <parent link="right_wheel_hub"/>
    <child link="right_wheel_tire"/>
    <origin rpy="0 0 0" xyz="0 0 0.0209"/>
  </joint>
  <link name="right_contact">
    <!-- virtual link: https://upkie.github.io/upkie/kinematics.html#virtual-links -->
    <visual>
      <geometry>
        <box size="0 0 0"/>
      </geometry>
    </visual>
    <inertial>
      <mass value="0.001"/>
      <origin rpy="0 0 0" xyz="0 0 0"/>
      <inertia ixx="0" ixy="0" ixz="0" iyy="0" iyz="0" izz="0"/>
    </inertial>
  </link>
  <joint name="right_contact_fix" type="fixed">
    <parent link="right_wheel_tire"/>
    <child link="right_contact"/>
    <!-- contact target is a bit inside to avoid collisions with its box -->
    <!-- tangent contact surface would be xyz="0 0.05 0" -->
    <origin rpy="1.5707963267948966 0 0" xyz="0 0.047 0"/>
  </joint>
  <link name="right_wheel_center">
    <!-- virtual link: https://upkie.github.io/upkie/kinematics.html#virtual-links -->
    <visual>
      <geometry>
        <box size="0 0 0"/>
      </geometry>
    </visual>
    <inertial>
      <mass value="0.001"/>
      <origin rpy="0 0 0" xyz="0 0 0"/>
      <inertia ixx="0" ixy="0" ixz="0" iyy="0" iyz="0" izz="0"/>
    </inertial>
  </link>
  <joint name="right_wheel_center_fix" type="fixed">
    <parent link="right_wheel_tire"/>
    <child link="right_wheel_center"/>
    <origin rpy="1.5707963267948966 3.141592653589793 0" xyz="0 0 0"/>
  </joint>
</robot>
