wisehyun-2/my_robot_project/wheeled_biped/models/wheelbiped_v5/wheelbiped_v5.urdf

<robot name="wheelbiped_v5">
  <!-- Generated by wbr/models/build_v5.py from the Fusion model (robot_cad_v5). q = 0: straight legs. Base frame: midpoint of
       the hip axes, x forward, y left, z up; every joint axis is +y. Masses, COMs and inertias: mass_properties.json. -->
  <material name="body"><color rgba="0.25 0.25 0.27 1"/></material>
  <link name="base">
    <inertial><origin xyz="0.0009640859 0.0001309282 0.05898933" rpy="0 0 0"/><mass value="5.248826"/><inertia ixx="0.08584487" ixy="0.0001607838" ixz="0.001377685" iyy="0.04175314" iyz="9.143988e-05" izz="0.08849805"/></inertial>
    <visual><geometry><mesh filename="meshes/base.stl"/></geometry><material name="body"/></visual>
    <collision><origin xyz="0.00225 0 0.039" rpy="0 0 0"/><geometry><box size="0.4845 0.3473 0.2213"/></geometry></collision>
  </link>
  <link name="imu"/>
  <joint name="imu_fix" type="fixed">
    <origin xyz="-0.0005 -0.00245 -0.0355" rpy="0 -0 3.141593"/><parent link="base"/><child link="imu"/>
  </joint>
  <link name="left_thigh">
    <inertial><origin xyz="-0.0001321901 0.04517764 -0.1455838" rpy="0 0 0"/><mass value="1.260606"/><inertia ixx="0.01106419" ixy="-2.486555e-06" ixz="0.003029101" iyy="0.01397073" iyz="-0.0006128648" izz="0.007025958"/></inertial>
    <visual><geometry><mesh filename="meshes/left_thigh.stl"/></geometry><material name="body"/></visual>
    <collision><origin xyz="0 0.049525 -0.125" rpy="0 0 0"/><geometry><box size="0.06622591 0.13395 0.25"/></geometry></collision>
  </link>
  <link name="left_shank">
    <inertial><origin xyz="-0.0001604264 0.01399181 -0.1482051" rpy="0 0 0"/><mass value="0.8572084"/><inertia ixx="0.008200375" ixy="-4.703406e-07" ixz="-0.001787271" iyy="0.01095732" iyz="-0.0001875019" izz="0.003142783"/></inertial>
    <visual><geometry><mesh filename="meshes/left_shank.stl"/></geometry><material name="body"/></visual>
    <collision><origin xyz="0 0.02425 -0.125" rpy="0 0 0"/><geometry><box size="0.07136908 0.0415 0.25"/></geometry></collision>
    <collision><origin xyz="0 0.005275002 -0.25" rpy="1.570796 0 0"/><geometry><cylinder radius="0.04645" length="0.04945"/></geometry></collision>
  </link>
  <link name="left_wheel_link">
    <inertial><origin xyz="-1.30381e-13 -0.004022413 6.44667e-14" rpy="0 0 0"/><mass value="1.056258"/><inertia ixx="0.003577866" ixy="-4.767672e-16" ixz="1.202257e-12" iyy="0.006629081" iyz="1.685614e-16" izz="0.003577866"/></inertial>
    <visual><geometry><mesh filename="meshes/left_wheel_link.stl"/></geometry><material name="body"/></visual>
    <collision><origin xyz="0 0 0" rpy="1.570796 0 0"/><geometry><cylinder radius="0.101" length="0.054"/></geometry></collision>
  </link>
  <joint name="left_hip" type="revolute">
    <origin xyz="0 0.172 0" rpy="0 0 0"/><parent link="base"/><child link="left_thigh"/>
    <axis xyz="0 1 0"/><limit effort="12.5" velocity="25.13" lower="-3.14159" upper="3.14159"/>
  </joint>
  <joint name="left_knee" type="revolute">
    <origin xyz="0 0.036 -0.25" rpy="0 0 0"/><parent link="left_thigh"/><child link="left_shank"/>
    <axis xyz="0 1 0"/><limit effort="12.5" velocity="25.13" lower="-3.14159" upper="3.14159"/>
  </joint>
  <joint name="left_wheel" type="continuous">
    <origin xyz="0 0.062 -0.25" rpy="0 0 0"/><parent link="left_shank"/><child link="left_wheel_link"/>
    <axis xyz="0 1 0"/><limit effort="12.5" velocity="25.13"/>
  </joint>
  <link name="right_thigh">
    <inertial><origin xyz="-0.0001321901 -0.04517764 -0.1455838" rpy="0 0 0"/><mass value="1.260606"/><inertia ixx="0.01106419" ixy="2.486555e-06" ixz="0.003029101" iyy="0.01397073" iyz="0.0006128648" izz="0.007025958"/></inertial>
    <visual><geometry><mesh filename="meshes/right_thigh.stl"/></geometry><material name="body"/></visual>
    <collision><origin xyz="0 -0.049525 -0.125" rpy="0 0 0"/><geometry><box size="0.06622591 0.13395 0.25"/></geometry></collision>
  </link>
  <link name="right_shank">
    <inertial><origin xyz="-0.0001604264 -0.01399181 -0.1482051" rpy="0 0 0"/><mass value="0.8572084"/><inertia ixx="0.008200375" ixy="4.703406e-07" ixz="-0.001787271" iyy="0.01095732" iyz="0.0001875019" izz="0.003142783"/></inertial>
    <visual><geometry><mesh filename="meshes/right_shank.stl"/></geometry><material name="body"/></visual>
    <collision><origin xyz="0 -0.02425 -0.125" rpy="0 0 0"/><geometry><box size="0.07136908 0.0415 0.25"/></geometry></collision>
    <collision><origin xyz="0 -0.005275002 -0.25" rpy="1.570796 0 0"/><geometry><cylinder radius="0.04645" length="0.04945"/></geometry></collision>
  </link>
  <link name="right_wheel_link">
    <inertial><origin xyz="3.855043e-14 0.004022413 -1.730683e-14" rpy="0 0 0"/><mass value="1.056258"/><inertia ixx="0.003577866" ixy="-6.395061e-15" ixz="-9.553806e-12" iyy="0.006629081" iyz="3.264004e-15" izz="0.003577866"/></inertial>
    <visual><geometry><mesh filename="meshes/right_wheel_link.stl"/></geometry><material name="body"/></visual>
    <collision><origin xyz="0 -0 0" rpy="1.570796 0 0"/><geometry><cylinder radius="0.101" length="0.054"/></geometry></collision>
  </link>
  <joint name="right_hip" type="revolute">
    <origin xyz="0 -0.172 0" rpy="0 0 0"/><parent link="base"/><child link="right_thigh"/>
    <axis xyz="0 1 0"/><limit effort="12.5" velocity="25.13" lower="-3.14159" upper="3.14159"/>
  </joint>
  <joint name="right_knee" type="revolute">
    <origin xyz="0 -0.036 -0.25" rpy="0 0 0"/><parent link="right_thigh"/><child link="right_shank"/>
    <axis xyz="0 1 0"/><limit effort="12.5" velocity="25.13" lower="-3.14159" upper="3.14159"/>
  </joint>
  <joint name="right_wheel" type="continuous">
    <origin xyz="0 -0.062 -0.25" rpy="0 0 0"/><parent link="right_shank"/><child link="right_wheel_link"/>
    <axis xyz="0 1 0"/><limit effort="12.5" velocity="25.13"/>
  </joint>
</robot>
