wisehyun-2/my_robot_project/robot_cad_v5/manufacturing/drawings/shell_front.pdf

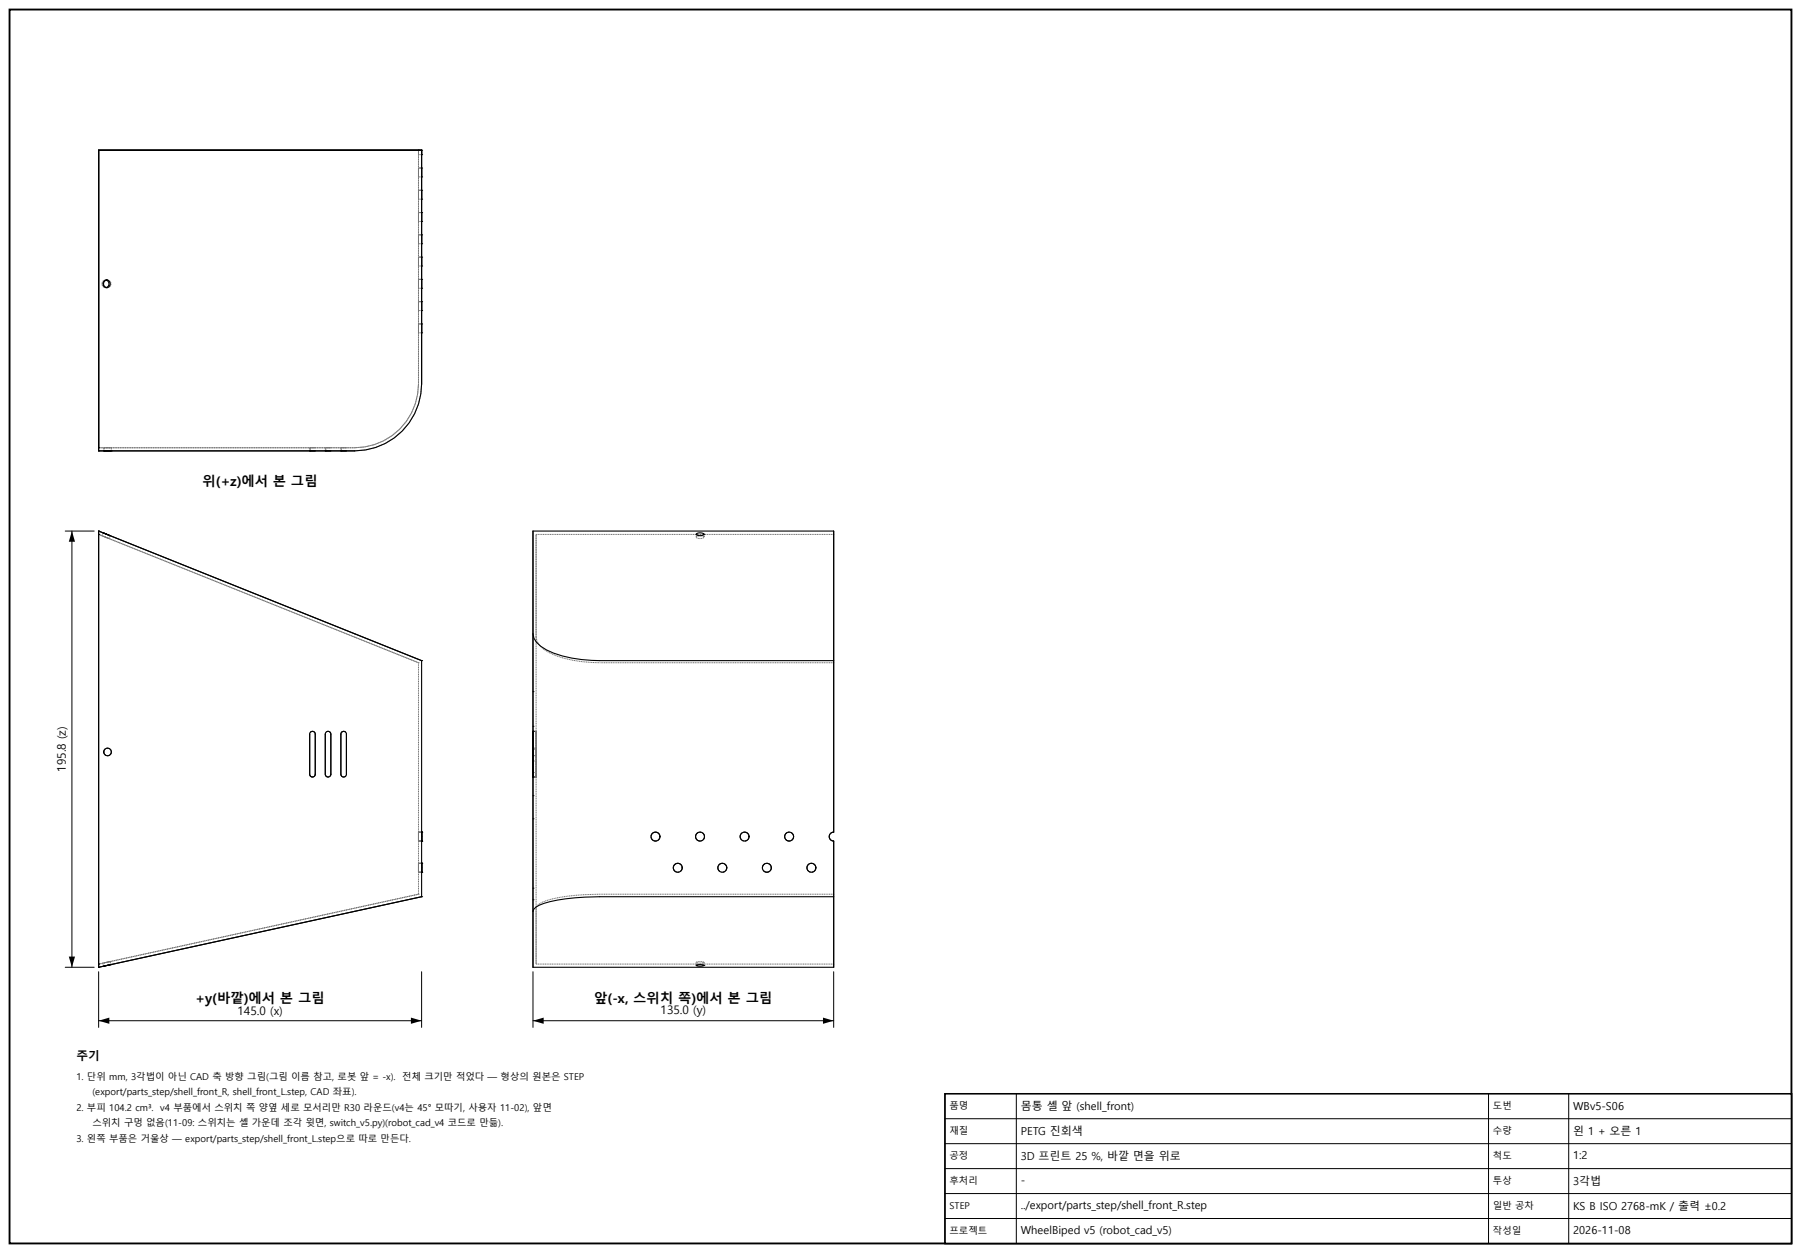
[picture p186: page 1]
몸통 셸 앞 (shell_front); WBv5-S06; PETG 진회색; 3D 프린트 25 %, 바깥 면을 위로; 후처리; STEP; ../export/parts_step/shell_front_R.step; KS B ISO 2768-mK / 출력 ±0.2; 프로젝트; WheelBiped v5 (robot_cad_v5); 작성일

앞(-x, 스위치 쪽)에서 본 그림

1. 단위 mm, 3각법이 아닌 CAD 축 방향 그림(그림 이름 참고, 로봇 앞 = -x). 전체 크기만 적었다 — 형상의 원본은 STEP
(export/parts_step/shell_front_R, shell_front_L.step, CAD 좌표).
2. 부피 104.2 cm³. v4 부품에서 스위치 쪽 양옆 세로 모서리만 R30 라운드(v4는 45° 모따기, 사용자 11-02), 앞면
스위치 구멍 없음(11-09: 스위치는 셸 가운데 조각 윗면, switch_v5.py)(robot_cad_v4 코드로 만듦).
3. 왼쪽 부품은 거울상 — export/parts_step/shell_front_L.step으로 따로 만든다.
