wisehyun-2/my_robot_project/robot_cad_v5/manufacturing/drawings/saddle.pdf

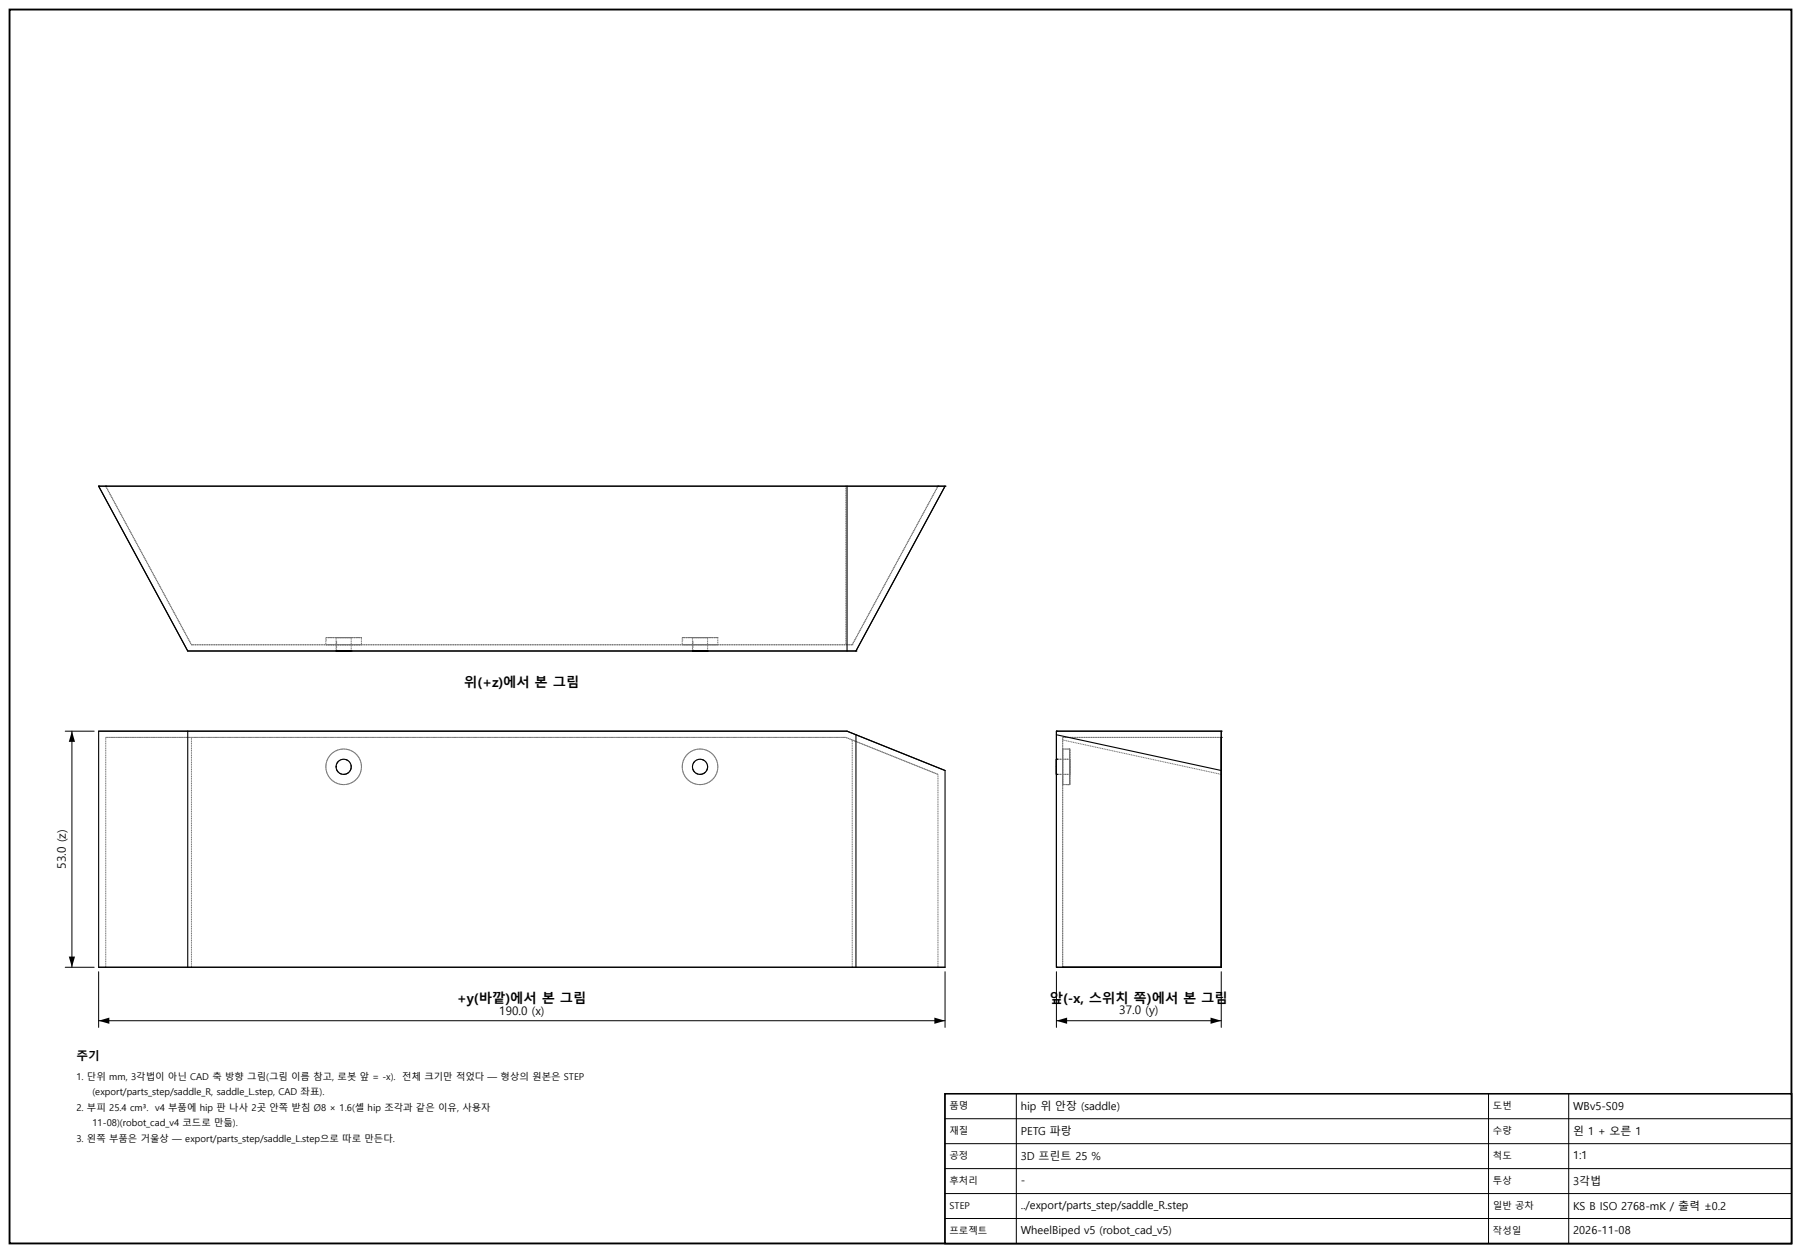
[picture p187: page 1]
hip 위 안장 (saddle); WBv5-S09; PETG 파랑; 3D 프린트 25 %; 후처리; STEP; ../export/parts_step/saddle_R.step; KS B ISO 2768-mK / 출력 ±0.2; 프로젝트; WheelBiped v5 (robot_cad_v5); 작성일

앞(-x, 스위치 쪽)에서 본 그림

1. 단위 mm, 3각법이 아닌 CAD 축 방향 그림(그림 이름 참고, 로봇 앞 = -x). 전체 크기만 적었다 — 형상의 원본은 STEP
(export/parts_step/saddle_R, saddle_L.step, CAD 좌표).
2. 부피 25.4 cm³. v4 부품에 hip 판 나사 2곳 안쪽 받침 Ø8 × 1.6(셸 hip 조각과 같은 이유, 사용자
11-08)(robot_cad_v4 코드로 만듦).
3. 왼쪽 부품은 거울상 — export/parts_step/saddle_L.step으로 따로 만든다.
