wisehyun-2/my_robot_project/robot_cad_v5/manufacturing/drawings/top_plate.pdf

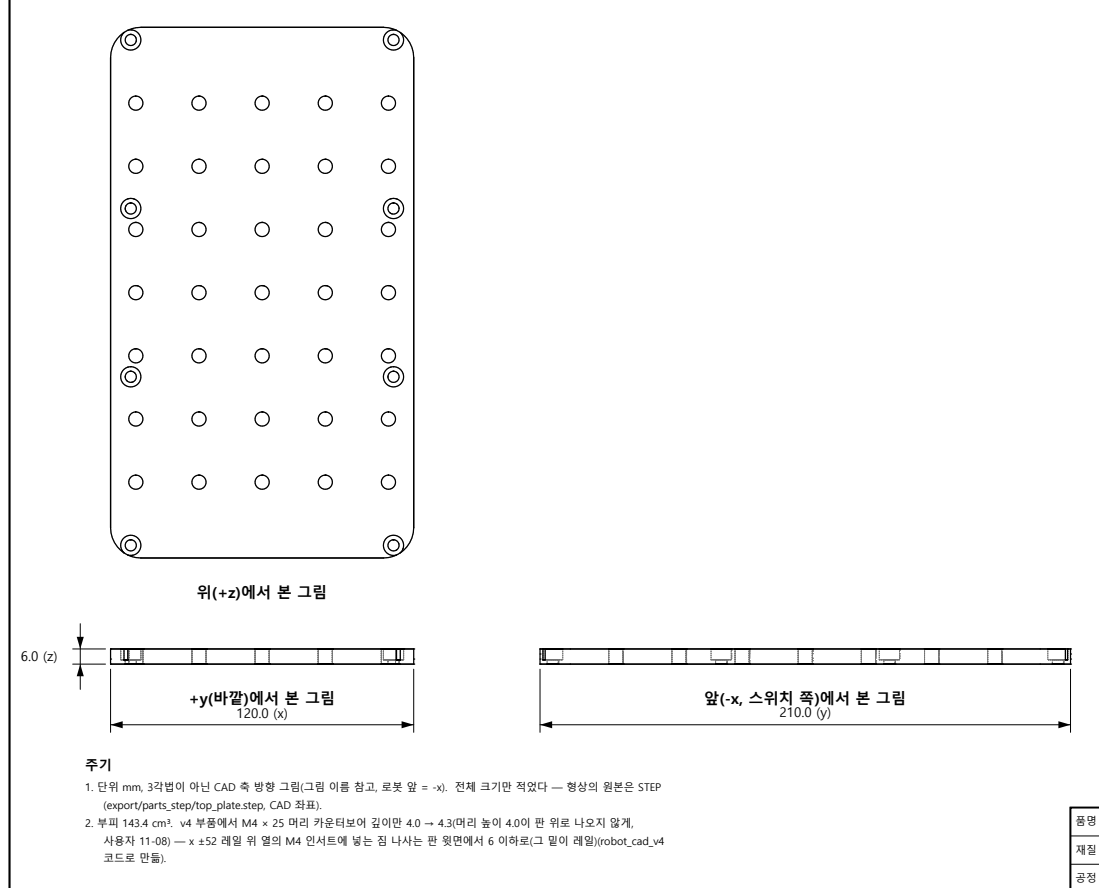
[picture p188: page 1]
위판 (짐 판) (top_plate); WBv5-S10; PETG; 3D 프린트 25 %, M4 열압입 인서트; 후처리; STEP; ../export/parts_step/top_plate.step; KS B ISO 2768-mK / 출력 ±0.2; 프로젝트; WheelBiped v5 (robot_cad_v5); 작성일

앞(-x, 스위치 쪽)에서 본 그림

1. 단위 mm, 3각법이 아닌 CAD 축 방향 그림(그림 이름 참고, 로봇 앞 = -x). 전체 크기만 적었다 — 형상의 원본은 STEP
(export/parts_step/top_plate.step, CAD 좌표).
2. 부피 143.4 cm³. v4 부품에서 M4 × 25 머리 카운터보어 깊이만 4.0 → 4.3(머리 높이 4.0이 판 위로 나오지 않게,
사용자 11-08) — x ±52 레일 위 열의 M4 인서트에 넣는 짐 나사는 판 윗면에서 6 이하로(그 밑이 레일)(robot_cad_v4
코드로 만듦).
