wisehyun-2/my_robot_project/robot_cad_v5/manufacturing/drawings/clamp_ring_stator_D45_t2.0_SUS304.pdf

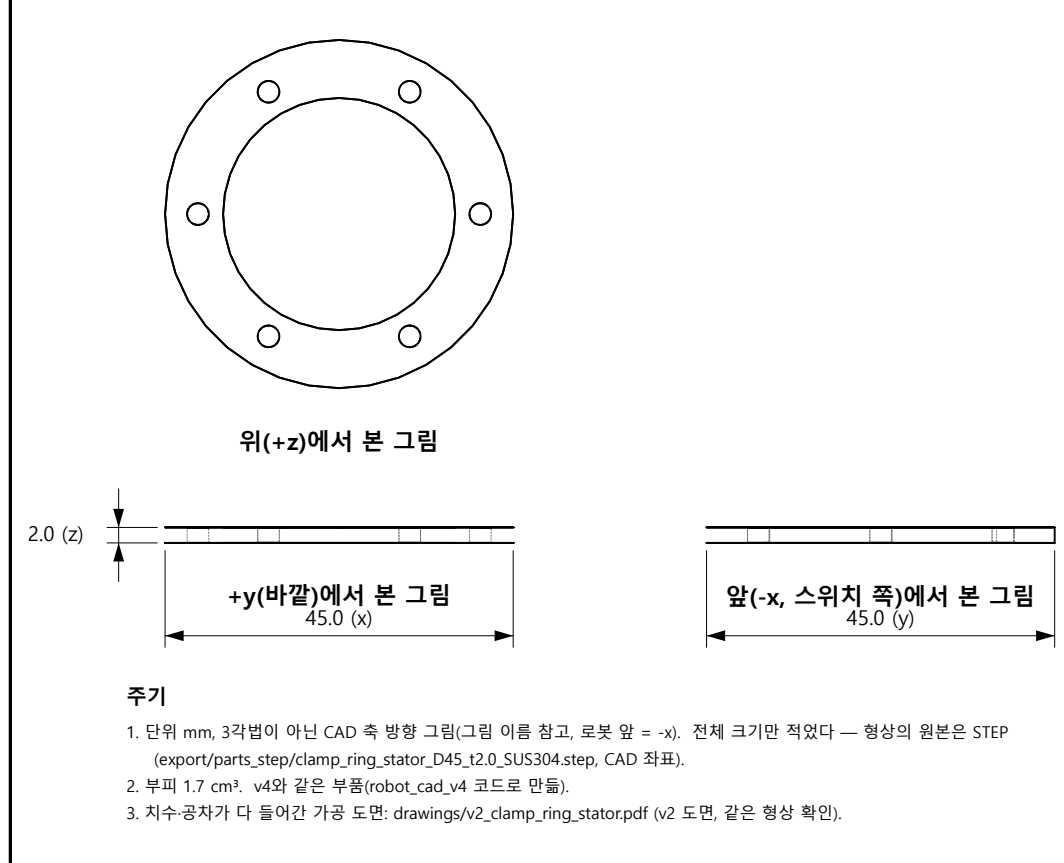
[picture p189: page 1]
고정 링 (고정자) (clamp_ring_stator_D45_t2.0_SUS304); WBv5-S17; SUS304 2t; 레이저 가공; 후처리; STEP; ../export/parts_step/clamp_ring_stator_D45_t2.0_SUS304.step; KS B ISO 2768-mK / 출력 ±0.2; 프로젝트; WheelBiped v5 (robot_cad_v5); 작성일

앞(-x, 스위치 쪽)에서 본 그림

1. 단위 mm, 3각법이 아닌 CAD 축 방향 그림(그림 이름 참고, 로봇 앞 = -x). 전체 크기만 적었다 — 형상의 원본은 STEP
(export/parts_step/clamp_ring_stator_D45_t2.0_SUS304.step, CAD 좌표).
2. 부피 1.7 cm³. v4와 같은 부품(robot_cad_v4 코드로 만듦).
3. 치수·공차가 다 들어간 가공 도면: drawings/v2_clamp_ring_stator.pdf (v2 도면, 같은 형상 확인).
