wisehyun-2/my_robot_project/robot_cad_v5/manufacturing/drawings/hip_plate.pdf

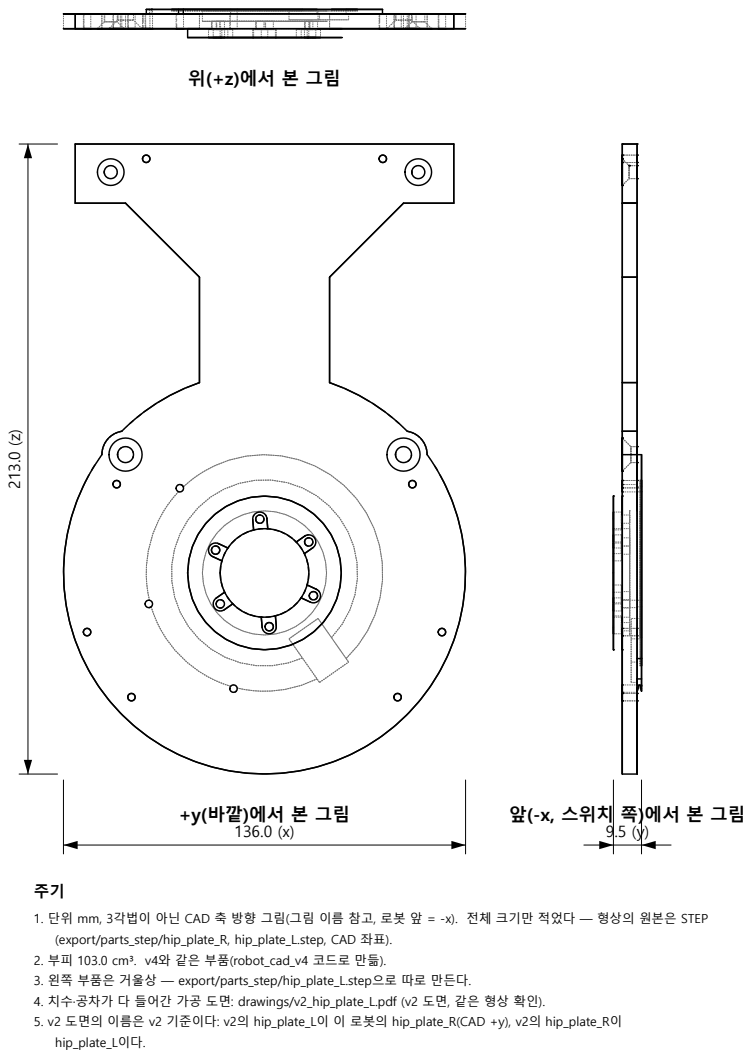
[picture p193: page 1]
hip 판 (hip_plate); WBv5-S14; 3축 MCT 양면 (v2 도면 WBv2-M01 참고); 후처리; STEP; ../export/parts_step/hip_plate_R.step; KS B ISO 2768-mK / 출력 ±0.2; 프로젝트; WheelBiped v5 (robot_cad_v5); 작성일

앞(-x, 스위치 쪽)에서 본 그림

1. 단위 mm, 3각법이 아닌 CAD 축 방향 그림(그림 이름 참고, 로봇 앞 = -x). 전체 크기만 적었다 — 형상의 원본은 STEP
(export/parts_step/hip_plate_R, hip_plate_L.step, CAD 좌표).
2. 부피 103.0 cm³. v4와 같은 부품(robot_cad_v4 코드로 만듦).
3. 왼쪽 부품은 거울상 — export/parts_step/hip_plate_L.step으로 따로 만든다.
4. 치수·공차가 다 들어간 가공 도면: drawings/v2_hip_plate_L.pdf (v2 도면, 같은 형상 확인).
5. v2 도면의 이름은 v2 기준이다: v2의 hip_plate_L이 이 로봇의 hip_plate_R(CAD +y), v2의 hip_plate_R이
hip_plate_L이다.
