wisehyun-2/my_robot_project/robot_cad_v5/manufacturing/drawings/knee_cap.pdf

42.0

주기

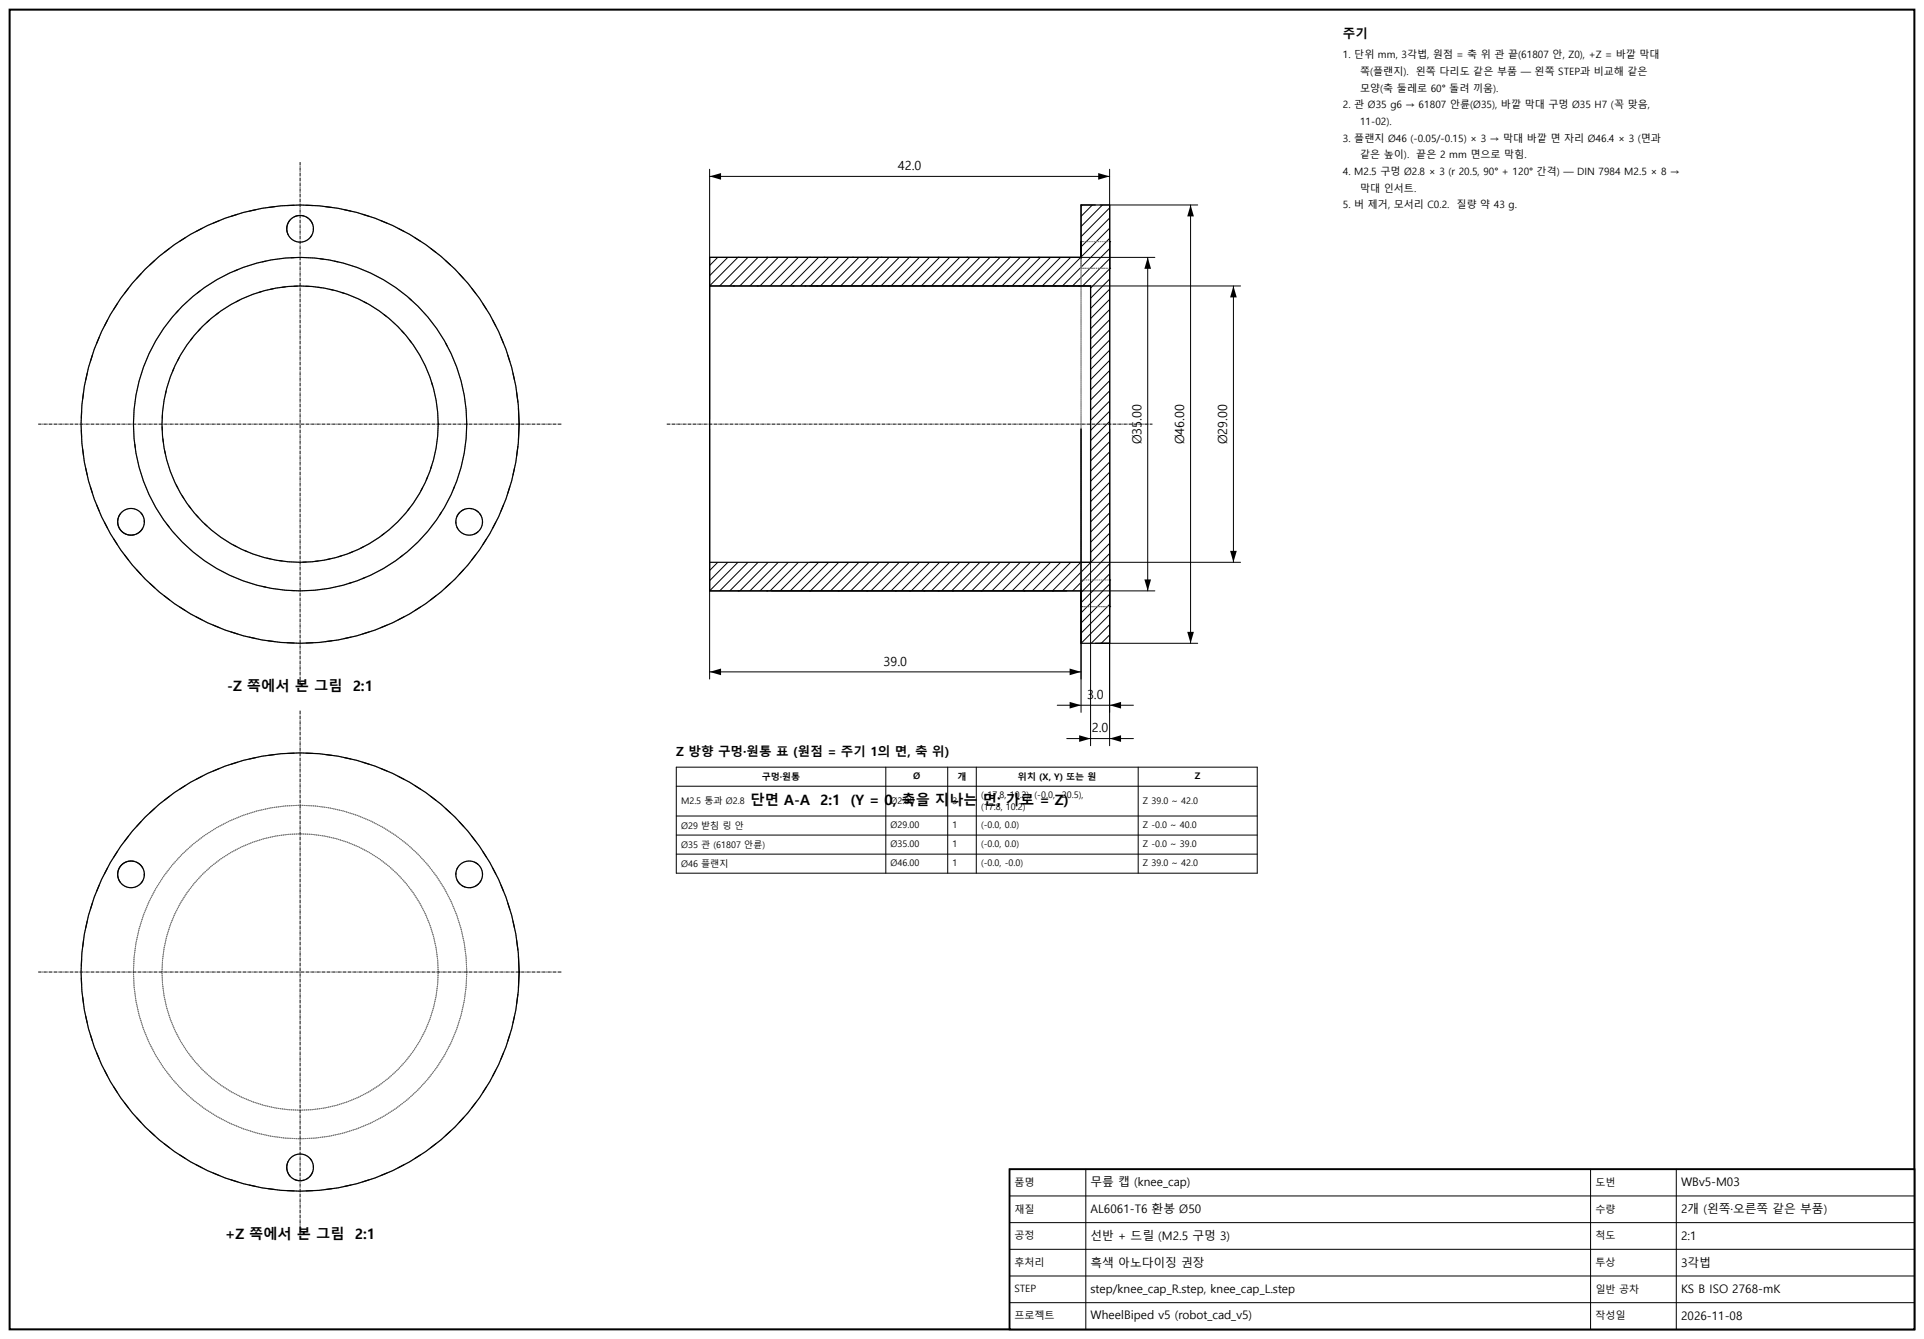
[picture p194: page 1]
-Z 쪽에서 본 그림 2:1; +Z 쪽에서 본 그림 2:1; 무릎 캡 (knee_cap); WBv5-M03; 2개 (왼쪽·오른쪽 같은 부품); 후처리; 흑색 아노다이징 권장; STEP; step/knee_cap_R.step, knee_cap_L.step; KS B ISO 2768-mK; 프로젝트; WheelBiped v5 (robot_cad_v5); 작성일

쪽(플랜지). 왼쪽 다리도 같은 부품 — 왼쪽 STEP과 비교해 같은
모양(축 둘레로 60° 돌려 끼움).
3. 플랜지 Ø46 (-0.05/-0.15) × 3 → 막대 바깥 면 자리 Ø46.4 × 3 (면과
같은 높이). 끝은 2 mm 면으로 막힘.
4. M2.5 구멍 Ø2.8 × 3 (r 20.5, 90° + 120° 간격) — DIN 7984 M2.5 × 8 →
막대 인서트.
5. 버 제거, 모서리 C0.2. 질량 약 43 g.

M2.5 통과 Ø2.8 단면 A-A 2:1 (Y = 0, 축을 지나는 면; 가로 = Z) | Ø2.80 | 3 | (-17.8, 10.2), (-0.0, -20.5), (17.8, 10.2) | Z 39.0 ~ 42.0

Ø29 받침 링 안 | Ø29.00 | 1 | (-0.0, 0.0) | Z -0.0 ~ 40.0
Ø35 관 (61807 안륜) | Ø35.00 | 1 | (-0.0, 0.0) | Z -0.0 ~ 39.0
Ø46 플랜지 | Ø46.00 | 1 | (-0.0, -0.0) | Z 39.0 ~ 42.0
