wisehyun-2/my_robot_project/robot_cad_v5/manufacturing/drawings/magnet_spacer_D9x5.35_(6061).pdf

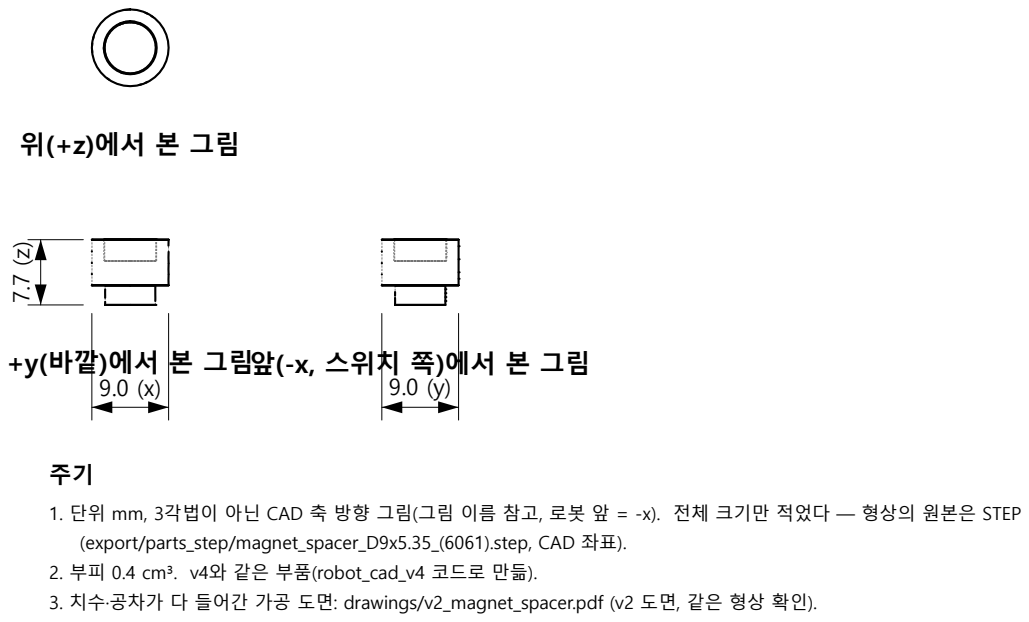
[picture p195: page 1]
자석 스페이서 (magnet_spacer_D9x5.35_(6061)); WBv5-S18; AL6061 (비자성); 후처리; STEP; ../export/parts_step/magnet_spacer_D9x5.35_(6061).step; KS B ISO 2768-mK / 출력 ±0.2; 프로젝트; WheelBiped v5 (robot_cad_v5); 작성일

앞(-x, 스위치 쪽)에서 본 그림

1. 단위 mm, 3각법이 아닌 CAD 축 방향 그림(그림 이름 참고, 로봇 앞 = -x). 전체 크기만 적었다 — 형상의 원본은 STEP
(export/parts_step/magnet_spacer_D9x5.35_(6061).step, CAD 좌표).
2. 부피 0.4 cm³. v4와 같은 부품(robot_cad_v4 코드로 만듦).
3. 치수·공차가 다 들어간 가공 도면: drawings/v2_magnet_spacer.pdf (v2 도면, 같은 형상 확인).
