wisehyun-2/my_robot_project/robot_cad_v5/manufacturing/drawings/shell_rear.pdf

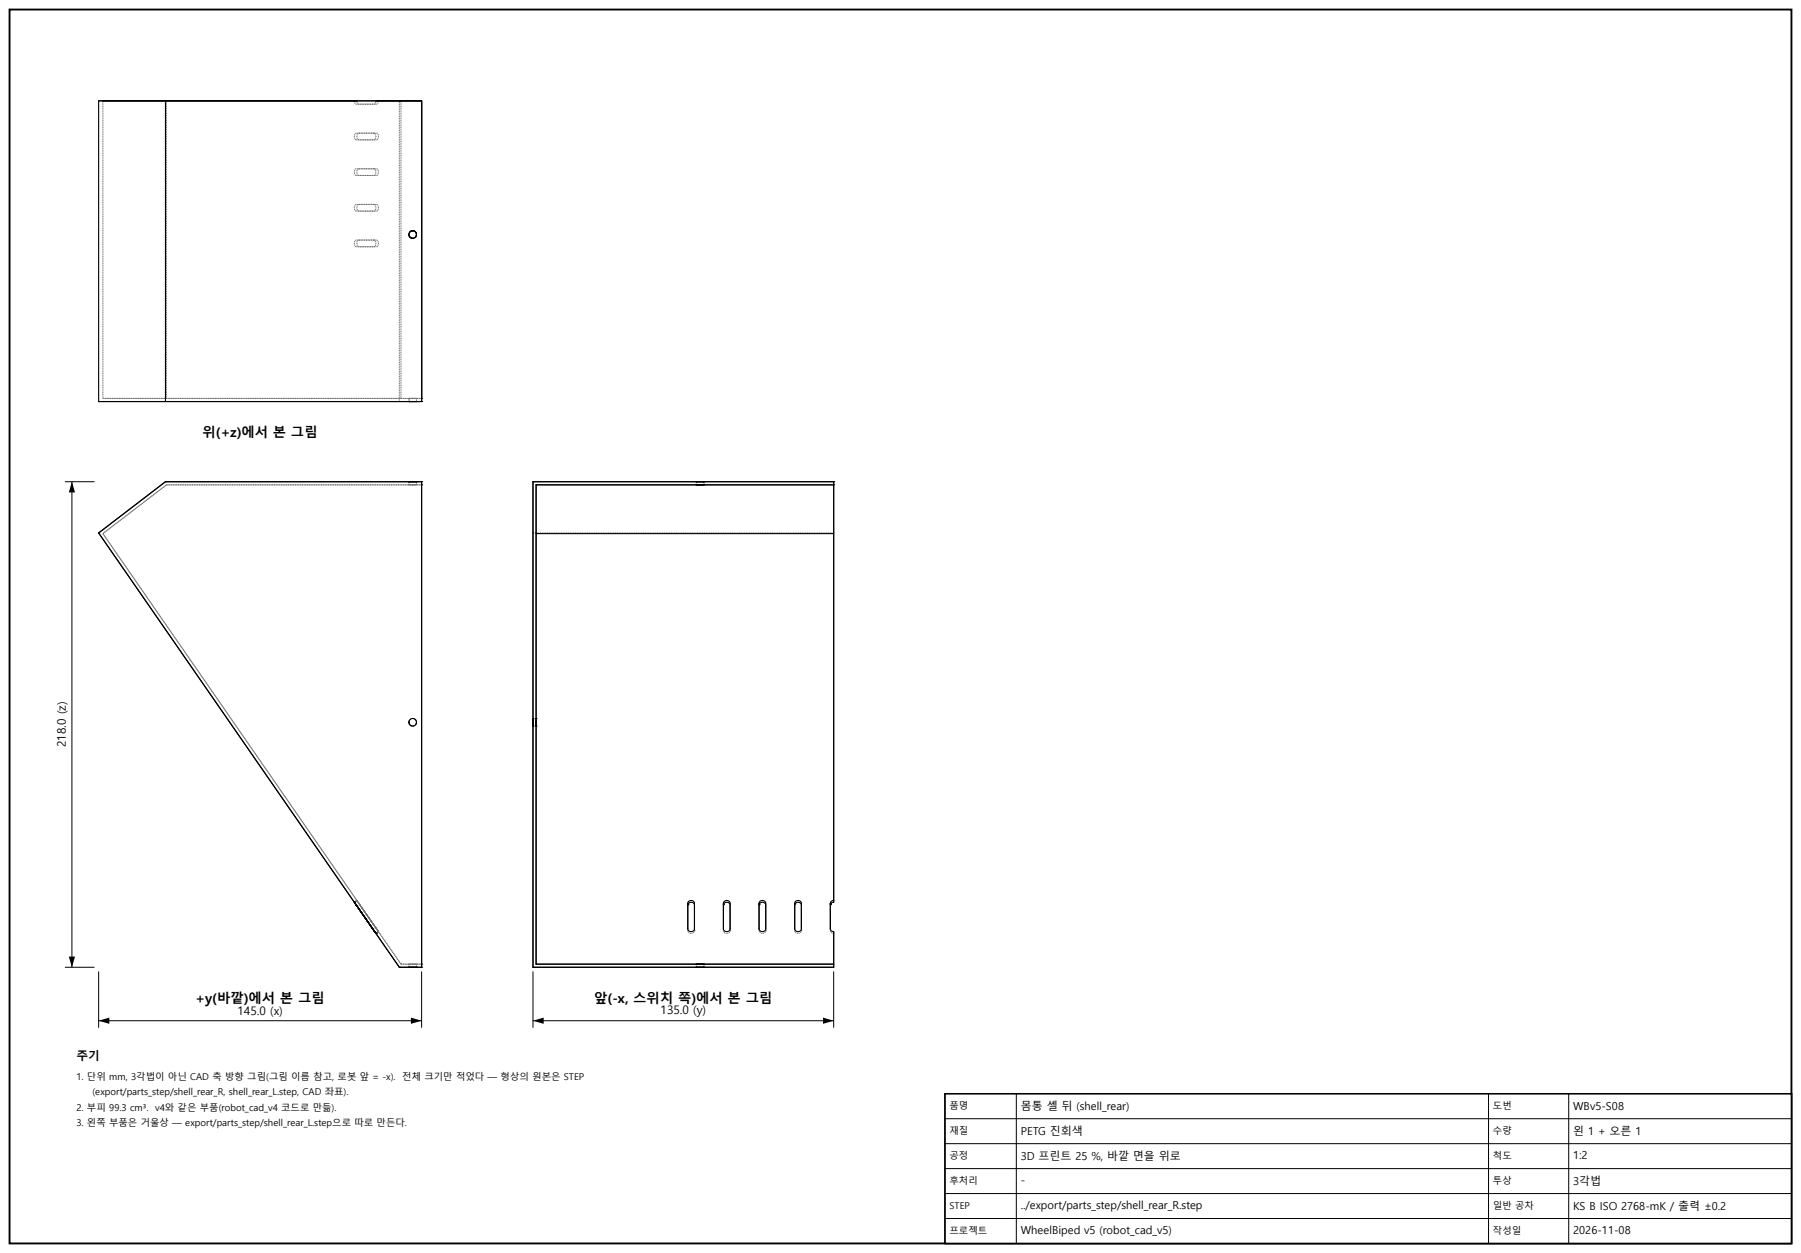
[picture p197: page 1]
몸통 셸 뒤 (shell_rear); WBv5-S08; PETG 진회색; 3D 프린트 25 %, 바깥 면을 위로; 후처리; STEP; ../export/parts_step/shell_rear_R.step; KS B ISO 2768-mK / 출력 ±0.2; 프로젝트; WheelBiped v5 (robot_cad_v5); 작성일

앞(-x, 스위치 쪽)에서 본 그림

1. 단위 mm, 3각법이 아닌 CAD 축 방향 그림(그림 이름 참고, 로봇 앞 = -x). 전체 크기만 적었다 — 형상의 원본은 STEP
(export/parts_step/shell_rear_R, shell_rear_L.step, CAD 좌표).
2. 부피 99.3 cm³. v4와 같은 부품(robot_cad_v4 코드로 만듦).
3. 왼쪽 부품은 거울상 — export/parts_step/shell_rear_L.step으로 따로 만든다.
