wisehyun-2/my_robot_project/robot_cad_v5/manufacturing/drawings/splice_tabs.pdf

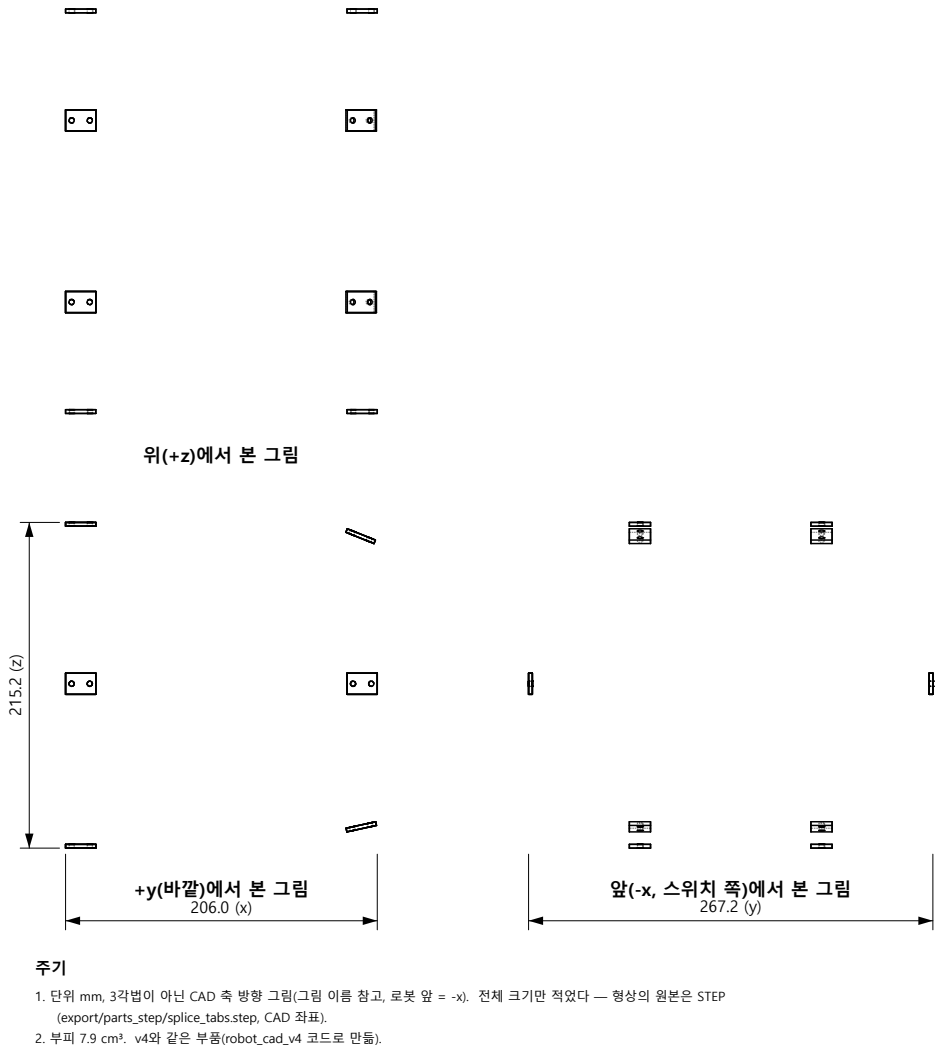
[picture p199: page 1]
2. 부피 7.9 cm³. v4와 같은 부품(robot_cad_v4 코드로 만듦).; 셸 이음판 (splice_tabs); WBv5-S13; PETG; 3D 프린트 100 %, M3 + 너트; 후처리; STEP; ../export/parts_step/splice_tabs.step; KS B ISO 2768-mK / 출력 ±0.2; 프로젝트; WheelBiped v5 (robot_cad_v5); 작성일

앞(-x, 스위치 쪽)에서 본 그림

1. 단위 mm, 3각법이 아닌 CAD 축 방향 그림(그림 이름 참고, 로봇 앞 = -x). 전체 크기만 적었다 — 형상의 원본은 STEP
(export/parts_step/splice_tabs.step, CAD 좌표).
