wisehyun-2/my_robot_project/robot_cad_v5/v4/fusion/finalize.py

"""Finishing steps of the v4 model: part numbers, images, BOM, as-built joints and exports.

Run each step in its own MCP script after v4run.load() (a failed script rolls the whole step back):
    finalize.set_part_numbers()
    finalize.images()        # direct design, poses set with poses.apply
    finalize.link_images(); finalize.truss_images()   # v4 links outside / cut (27, 28)
    finalize.bom()           # ../BOM.csv, ../BOM.md (parts and fasteners counted in the model)
    finalize.joints()        # switches the design to parametric (assembly.reset() switches back for a rebuild)
    finalize.exports()       # ../export: f3d (with the joints), assembly STEP, designed parts STEP + STL

_library holds the master of every reused part and must stay (it owns those components); it is hidden, and
hidden occurrences are not written to STEP.
"""
import csv
import math
import os

import adsk.core
import adsk.fusion

import cadlib as C
import layout as LY
import params as P
import poses as PO
import view

HERE = os.path.dirname(os.path.abspath(__file__))
BASE = os.path.dirname(HERE)
IMG = os.path.join(BASE, 'images')
EXP = os.path.join(BASE, 'export')

# designed parts: component name prefix -> (material / process, how to make it)
PRINT_NOTE = {
    'thigh': 'SLA 유사ABS 검정 레진, 한 덩어리(닫힌 상자 + 트러스 리브, 구멍·배선 창 없음 — 닫힌 칸 4개, 속은 비었다고 '
             '가정), 서포트는 바깥 면에만; 인서트 M2.5 3개 에폭시 접착',
    'shank': 'SLA 유사ABS 검정 레진, 한 덩어리(닫힌 상자 + 트러스 리브, 구멍·배선 창 없음 — 닫힌 칸 4개, 속은 비었다고 '
             '가정), 서포트는 바깥 면에만; 인서트 M2.5 3개 에폭시 접착',
    'hub_flange': 'PETG 100 %, 모터 쪽 면을 바닥에',
    'rim_': 'PETG 벽 6겹(2.4 mm) · 채움 40 %, 한 조각 — 허브 쪽 평면을 바닥에(돌기 양 끝 45°), 열린 쪽 플랜지 밑 '
            '4.5 mm 턱만 서포트',
    'cup_': 'PETG 30 %, 바닥(덮개 면)을 바닥에, 서포트는 커넥터 창만',
    'top_plate': 'PETG 25 %, M4 열압입 인서트',
    'battery_tray': 'PETG 30 %, 리브를 위로',
    'electronics_deck': 'PETG 30 %',
    'shell_': 'PETG 진회색 25 %, 바깥 면을 위로(서포트 필요), 앞·hip·뒤 × 좌우 6조각',
    'saddle_': 'PETG 파랑 25 % (hip 위 안장)',
    'splice_tabs': 'PETG 100 %, 셸 조각 이음판(M3 + 너트)',
}
MACHINED = {
    'hip_plate': '6061-T6 판 10t 이상(완성 9.5 mm) 3축 MCT 양면, Ø42 H7, 보스 면 Ø63 × 0.5 홈, M5·M4 90° 접시, M3 탭 11개, 검정 아노다이징 '
                 '(manufacturing/ 도면 WBv2-M01)',
    'spine_tube': '6061-T6 환봉 Ø16(통짜), 길이 %.0f mm, 양 끝 면삭 + M5 탭 깊이 %.0f'
                  % (2 * (P.YW - P.HIP_PLATE_T), P.END_TAP['M5'][1]),
    'rail': '6061-T6 각봉 15 × 15(통짜), 길이 %.0f mm, 양 끝 M4 탭 깊이 %.0f, Ø4.4 관통 4곳'
            % (2 * (P.YW - P.HIP_PLATE_T), P.END_TAP['M4'][1]),
    'clamp ring output': 'SUS304 %g mm 레이저 가공, Ø%g/Ø%g, Ø3.4 × 6 (PCD %g)' % ((P.RING_T,) + P.RING_OUT + (P.AKE_PCD_OUT,)),
    'clamp ring stator': 'SUS304 %g mm 레이저 가공, Ø%g/Ø%g, Ø2.8 × 6 (PCD %g)' % ((P.RING_T,) + P.RING_STATOR + (P.AKE_PCD_RING,)),
    'magnet spacer': '6061(비자성) 선반 가공, Ø9 × %g, 위 Ø%.2f × %g 자석 포켓, 아래 Ø%.2f × %g 스피곳'
                     % ((P.SPACER_H,) + P.SPACER_POCKET + P.SPACER_SPIGOT),
}
PURCHASED = {   # component name prefix -> (BOM name, spec / source)
    'AKE60-8_KV80_stator': ('CubeMars AKE60-8 KV80', '8:1, 12.5 / 5 N·m, 0.26 kg, Ø69 × 25'),
    'moteus_r4.11': ('mjbots moteus r4.11', 'XT30PW ×2, JST PH-3 CAN ×2'),
    'pi3hat_r4.5': ('mjbots pi3hat r4.5', 'CAN-FD ×5, IMU, 24 V → 5 V'),
    'raspberry_pi_4b': ('Raspberry Pi 4 Model B', '4 GB 이상'),
    'mjpower_ss': ('mjbots power dist (mjpower-ss)', 'XT90 입력, XT30 출력 ×6, 프리차지·스위치'),
    'battery_24V_15Ah': ('배터리 24 V 15 Ah', '75 × 310 × 75 mm, XT60(F) 리드'),
    'tyre M365': ('Xiaomi M365 8.5 × 2(8 1/2 × 2) 통고무 허니콤 타이어',
                  '외경 202 × 폭 54, 안지름 141 × 안쪽 폭 36.5, 721 g (사용자 주문, AliExpress)'),
    'XT30U plug': ('XT30U 플러그(16 AWG)', '암·수는 README 배선표'),
    'JST PHR-3': ('JST PHR-3 하우징 + SPH-002T-P0.5S 단자 3개', 'CAN 케이블 끝'),
    'CAN terminator': ('CAN-FD 종단 저항 120 Ω (PH-3)', '20 × 15 × 10 이하, 바퀴 드라이버 CAN1'),
    'XT30 cap': ('XT30 보호 캡', '바퀴 드라이버 J2(24 V 살아 있음)'),
    'XT90-F to XT60-M': ('XT90(F) → XT60(M) 변환 케이블', '배터리 → 전원보드'),
    'XT60 pair': ('XT60 커넥터 쌍', '배터리 리드 ↔ 변환기'),
    'fan 30x30x7': ('팬 30 × 30 × 7 mm 5 V', 'pi3hat JP6(1번 5 V, 3번 GND), 데크에 1.5 mm 양면 폼테이프'),
    'rocker switch': ('로커 스위치 19 × 13 (mjbots PH4 스위치 하네스)', '몸통 뒷면 수직면 로봇 왼쪽(+y), 바깥에서 조작'),
    'standoff M2.5x11': ('M2.5 × 11 육각 스탠드오프(수-암)', 'pi3hat 동봉'),
}


def design_parts():
    """{component name: (kind, note)} of the designed parts present in the model."""
    out = {}
    for c in C.design().allComponents:
        n = c.name
        for k, v in PRINT_NOTE.items():
            if n.startswith(k):
                out[n] = ('3D 프린트', v)
        for k, v in MACHINED.items():
            if n.startswith(k):
                out[n] = ('가공', v)
    return out


def set_part_numbers():
    d = C.design()
    d.rootComponent.partNumber = 'WheelBiped_v4'
    dp = design_parts()
    for c in d.allComponents:
        if c != d.rootComponent:
            c.partNumber = c.name
            if c.name in dp:
                c.description = dp[c.name][1]
    for o in d.rootComponent.occurrences:
        if o.component.name == '_library':
            o.isLightBulbOn = False


# ----------------------------------------------------------------------------- images
def show_all():
    root = C.design().rootComponent
    for o in root.occurrences:
        o.isLightBulbOn = o.component.name != '_library'
    for o in root.allOccurrences:              # the masters too (hidden by _library): new instances copy their bulb
        if o.component.name != '_library':
            o.isLightBulbOn = True
    root.isJointsFolderLightBulbOn = False


def set_visible(prefixes, on):
    for o in C.design().rootComponent.allOccurrences:
        if o.component.name.startswith(tuple(prefixes)):
            o.isLightBulbOn = on


SHELL = ('shell_', 'saddle_', 'splice_tabs')


def snap(name, eye, target, **kw):
    return view.snap(os.path.join(IMG, name + '.png'), eye, target, **kw)


def _lift(dz):
    """Move the whole robot (every root occurrence) by dz mm along robot z, e.g. to put a crouched pose's
    wheels back on the floor for a picture; _lift(-dz) moves it back."""
    p = C.rf((0.0, 0.0, dz))
    for o in C.design().rootComponent.occurrences:
        if o.component.name == '_library':
            continue
        m = o.transform2
        v = m.translation
        m.translation = adsk.core.Vector3D.create(v.x + p[0] * C.CM, v.y + p[1] * C.CM, v.z + p[2] * C.CM)
        o.transform2 = m


def images():
    show_all()
    PO.reset()
    c = (0, 0, 290)
    # close-ups (fit=False) keep the zoom of the previous perspective view, so they follow a fitted perspective one
    out = [snap('01_iso_front_left', (1100, 800, 750), c),
           snap('07_leg_outboard_left', (330, 760, 300), (40, 200, 210), fit=False),
           snap('02_iso_back_right', (-1000, -850, 700), c),
           snap('08_leg_inboard_front_left', (520, -120, 120), (40, 200, 200), fit=False),
           snap('03_front', (2000, 0, 290), c, ortho=True),
           snap('04_side_left', (0, 2000, 290), c, ortho=True),
           snap('05_back', (-2000, 0, 290), c, ortho=True),
           snap('06_top', (0, 0, 2500), c, ortho=True, up=(1, 0, 0))]
    set_visible(SHELL + ('top_plate',), False)
    out.append(snap('09_torso_inside', (650, 750, 760), (0, 0, 400)))
    out.append(snap('10_torso_inside_back', (-650, -700, 700), (0, 0, 380)))
    set_visible(SHELL + ('top_plate',), True)
    set_visible(('cup_knee_L',), False)
    out.append(snap('11_knee_driver_left_inboard', (170, -40, 150), (85, 175, 230), fit=False))
    set_visible(('cup_knee_L',), True)
    set_visible(('cup_wheel_L',), False)
    out.append(snap('12_wheel_driver_left_outboard', (-110, 500, 120), (-10, 245, 95), fit=False))
    set_visible(('cup_wheel_L',), True)
    for (L0, hip), nm, eye, ortho in (((200.0, 0.0), '13_crouch_L0_200', (1100, 800, 700), False),
                                      ((335.0, 0.0), '14_stretch_L0_335', (1100, 800, 700), False),
                                      ((P.L0, -80.0), '15_hip_minus80', (0, 2000, 290), True),
                                      ((P.L0, 60.0), '16_hip_plus60', (0, 2000, 290), True)):
        PO.show_pose(L0, hip)                     # cable loops redrawn for the pose
        dz = L0 - P.L0 if hip == 0.0 else 0.0     # wheels back on the floor
        _lift(dz)
        out.append(snap(nm, eye, (0, 0, 250), ortho=ortho))
        _lift(-dz)
    PO.clear_pose()
    view.look((1100, 800, 750), c)
    return out


def inside_images():
    """Views of the inside: shell and payload plate hidden, then layers peeled off (rails, battery, tray)."""
    show_all()
    c = (0, 0, 420)
    out = []
    set_visible(SHELL + ('top_plate',), False)
    out.append(snap('17_inside_front_top', (700, 500, 900), c))
    out.append(snap('18_inside_hip_left_from_front', (250, 30, 330), (0, 150, 390), fit=False))
    out.append(snap('19_inside_front', (2000, 0, 420), c, ortho=True))
    out.append(snap('20_inside_top', (0, 0, 2500), c, ortho=True, up=(1, 0, 0)))
    set_visible(('femur_L', 'tibia_L', 'wheel_L'), False)
    out.append(snap('21_inside_side_left_leg_off', (0, 2000, 420), c, ortho=True))
    set_visible(('femur_L', 'tibia_L', 'wheel_L'), True)
    set_visible(('rail_', 'battery_24V'), False)
    out.append(snap('22_battery_tray_and_tubes', (700, -500, 900), c))
    set_visible(('battery_tray', 'spine_tube_'), False)
    out.append(snap('23_electronics_deck', (330, 230, 560), (0, 0, 335), fit=False))
    set_visible(SHELL + ('top_plate', 'rail_', 'battery_24V', 'battery_tray', 'spine_tube_'), True)
    set_visible(('shell_front_L', 'shell_mid_L', 'shell_rear_L', 'saddle_L'), False)
    out.append(snap('24_cutaway_left_shell_off', (900, 950, 700), (0, 0, 330)))
    show_all()
    view.look((1100, 800, 750), (0, 0, 290))
    return out


def link_images():
    """v4: the SLA links seen from outboard / inboard (the truss inside is shown by the section images of
    calc/strength_v4 / README)."""
    show_all()
    out = []
    set_visible(('torso', 'femur_R', 'tibia_R', 'wheel_R', 'cup_knee_L', 'moteus'), False)
    out.append(snap('25_thigh_left_inboard', (330, -260, 520), (40, 190, 330), fit=False))
    show_all()
    set_visible(('cup_wheel_L', 'tyre M365', 'rim_L'), False)
    out.append(snap('26_shank_left_outboard', (260, 760, 260), (40, 220, 180), fit=False))
    show_all()
    view.look((1100, 800, 750), (0, 0, 290))
    return out


def truss_images(cuts=(('27_thigh_left_truss_cut', 'femur', 200.0), ('28_shank_left_truss_cut', 'tibia', 232.0))):
    """v4: the left links rebuilt alone, cut at robot y (the outboard part removed) and seen from outboard - the
    closed truss cells (no channels, windows or drain holes since 11-02)."""
    import legs as LG
    root = C.design().rootComponent
    occ = root.occurrences.addNewComponent(adsk.core.Matrix3D.create())
    occ.component.name = '_section'
    out = []
    try:
        for o in root.occurrences:
            o.isLightBulbOn = o.component.name == '_section'
        B = C.Builder(side=1)
        for name, link, y in cuts:
            body = LG.femur(1) if link == 'femur' else LG.tibia(1)
            C.cut(body, B.abox(-400.0, 400.0, y, 400.0, -400.0, 800.0))
            b = C.add_body(occ.component, body, 'section', None, 'black')
            a, c, _h = LG._link_geo(link)
            mid = ((a[0] + c[0]) / 2, y, (a[1] + c[1]) / 2)
            out.append(snap(name, (mid[0], 1600.0, mid[2]), mid))
            b.deleteMe()
    finally:
        occ.deleteMe()
        show_all()
    view.look((1100, 800, 750), (0, 0, 290))
    return out


# ----------------------------------------------------------------------------- BOM
WIRE_CLASS = ((3.5, '12 AWG 배터리·변환기 리드', '배터리·변환기에 포함'),
              (2.5, '16 AWG 실리콘선', '전원 데이지 체인, P5 → pi3hat'),
              (1.8, 'CAN 26 AWG 꼬은선(PH-3, 1번 H·2번 L)', 'JC1·JC2 → hip → knee → 바퀴'),
              (0.0, '가는 선(팬·스위치 하네스)', '팬·mjbots 스위치 하네스에 포함'))


def wires():
    """{(class, colour): (m, note)} of the modelled wires; a wire body's centre-line length is
    L = A^2 / (4 pi V) and its diameter 4 V / A (long round body)."""
    out = {}
    for o in C.design().rootComponent.allOccurrences:
        if not o.component.name.startswith('harness_'):
            continue
        for b in o.component.bRepBodies:
            A, V = b.area * 100.0, b.volume * 1000.0          # mm2, mm3
            od = 4 * V / A
            cls, note = next((c, n) for (lim, c, n) in WIRE_CLASS if od >= lim)
            colour = (b.appearance.name if b.appearance else '?').replace('wire ', '')
            m, _n = out.get((cls, colour), (0.0, note))
            out[(cls, colour)] = (m + A * A / (4 * math.pi * V) / 1000.0, note)
    return out


def counts():
    """Instances of every component in the visible tree (the _library masters excluded)."""
    n = {}
    for o in C.design().rootComponent.allOccurrences:
        if o.fullPathName.startswith('_library'):
            continue
        n[o.component.name] = n.get(o.component.name, 0) + 1
    return n


def fasteners():
    """BOM rows of the fasteners: modelled ones (fasteners.specs(), 'FX ...' masters) counted in the model, plus the
    parts not modelled (fasteners.NOT_MODELLED)."""
    import fasteners as FX
    n = counts()
    rows = []
    for name, (_g, _m, _l, (grp, item, spec, where), _k) in FX.specs().items():
        rows.append((grp, item, spec, n.get(name, 0), where))
    return rows + list(FX.NOT_MODELLED)


def bom():
    n = counts()
    rows = []
    for name, (kind, note) in sorted(design_parts().items()):
        if n.get(name):
            rows.append((kind, name, note, n[name], ''))
    seen = {}
    for name, k in n.items():
        for pre, (item, spec) in PURCHASED.items():
            if name.startswith(pre):
                seen[item] = (spec, seen.get(item, ('', 0))[1] + k)
    for item, (spec, k) in seen.items():
        rows.append(('구매품', item, spec, k, ''))
    for (grp, item, spec, k, where) in fasteners():
        rows.append(('체결·' + grp, item, spec, k, where))
    for (cls, colour), (m, note) in sorted(wires().items()):
        buy = '%.1f m (모델 %.2f m + 20 %%)' % (math.ceil(m * 1.2 * 10) / 10, m)
        rows.append(('배선', '%s, %s' % (cls, colour), buy, 1, note))
    path = os.path.join(BASE, 'BOM.csv')
    with open(path, 'w', encoding='utf-8-sig', newline='') as f:
        w = csv.writer(f)
        w.writerow(('구분', '품목', '규격·설명', '수량', '위치·비고'))
        w.writerows(rows)
    md = ['# WheelBiped v4 BOM (`finalize.bom()`이 모델에서 생성)\n',
          '| 구분 | 품목 | 규격·설명 | 수량 | 위치·비고 |', '|---|---|---|---|---|']
    md += ['| %s | %s | %s | %s | %s |' % r for r in rows]
    with open(os.path.join(BASE, 'BOM.md'), 'w', encoding='utf-8') as f:
        f.write('\n'.join(md) + '\n')
    return rows


# ----------------------------------------------------------------------------- joints
def _axis_circle(comp, x, z, name):
    """Sketch circle about a joint axis drawn in a link component (robot x, z; axis along robot y)."""
    sk = comp.sketches.add(comp.yZConstructionPlane)
    sk.name = name
    p = C.rf((x, 0.0, z))
    c = sk.modelToSketchSpace(adsk.core.Point3D.create(p[0] * C.CM, p[1] * C.CM, p[2] * C.CM))
    circ = sk.sketchCurves.sketchCircles.addByCenterRadius(c, 0.8)
    sk.isVisible = False
    return circ


def _revolute(name, occ1, occ2, curve):
    root = C.design().rootComponent
    geo = adsk.fusion.JointGeometry.createByCurve(curve, adsk.fusion.JointKeyPointTypes.CenterKeyPoint)
    ji = root.asBuiltJoints.createInput(occ1, occ2, geo)
    ji.setAsRevoluteJointMotion(adsk.fusion.JointDirections.ZAxisJointDirection)
    j = root.asBuiltJoints.add(ji)
    j.name = name
    return j


def joints():
    """Six as-built revolute joints (torso grounded).  Joints exist only in parametric designs: everything
    built so far becomes base features.  Every nested occurrence is grounded to its parent first, otherwise
    the joint solver leaves parts behind when a link moves."""
    PO.reset()
    d = C.design()
    d.designType = adsk.fusion.DesignTypes.ParametricDesignType
    root = d.rootComponent
    torso = C.root_occ('torso')
    torso.isGrounded = True
    kids = [c.occurrences.item(i) for c in d.allComponents for i in range(c.occurrences.count) if c != root]
    for o in kids:                       # setting the flag reorders the collections: gather first
        o.isGroundToParent = True
    left = [o.name for o in kids if not o.isGroundToParent]
    if left:
        raise RuntimeError('not grounded to parent: %s' % left[:5])
    out = []
    for k in ('L', 'R'):
        f, t, w = C.root_occ('femur_' + k), C.root_occ('tibia_' + k), C.root_occ('wheel_' + k)
        hip = _axis_circle(f.component, 0.0, P.Z_HIP, 'hip_axis')
        knee = _axis_circle(f.component, P.KNEE_X, P.KNEE_Z, 'knee_axis')
        axle = _axis_circle(t.component, 0.0, P.R_WHEEL, 'wheel_axis')
        out.append(_revolute('hip_' + k, torso, f, hip.createForAssemblyContext(f)))
        out.append(_revolute('knee_' + k, f, t, knee.createForAssemblyContext(f)))
        out.append(_revolute('wheel_' + k, t, w, axle.createForAssemblyContext(t)))
    root.isJointsFolderLightBulbOn = False
    return [j.name for j in out]


def drive_check(angle_deg=20.0):
    """Turn every joint by angle_deg and back; returns how far the moved link's origin went and how far it is from
    the start afterwards (mm).  The link transform, not a bounding box (those stay stale inside one script, 11-02)."""
    root = C.design().rootComponent
    res = {}
    for j in root.asBuiltJoints:
        link = j.occurrenceTwo
        p0 = link.transform2.translation.copy()
        j.jointMotion.rotationValue = math.radians(angle_deg)
        p1 = link.transform2.translation.copy()
        j.jointMotion.rotationValue = 0.0
        p2 = link.transform2.translation
        res[j.name] = (round(p0.asPoint().distanceTo(p1.asPoint()) * 10, 1),
                       round(p0.asPoint().distanceTo(p2.asPoint()) * 10, 3))
    return res


# ----------------------------------------------------------------------------- exports
def _file_name(name):
    return name.replace(' ', '_').replace('Ø', 'D')


def exports():
    d = C.design()
    em = d.exportManager
    os.makedirs(os.path.join(EXP, 'parts_step'), exist_ok=True)
    os.makedirs(os.path.join(EXP, 'parts_stl'), exist_ok=True)
    done = []
    f3d = os.path.join(EXP, 'WheelBiped_v4.f3d')
    em.execute(em.createFusionArchiveExportOptions(f3d))
    done.append(f3d)
    step = os.path.join(EXP, 'WheelBiped_v4_assembly.step')
    em.execute(em.createSTEPExportOptions(step, d.rootComponent))
    done.append(step)
    for name in sorted(design_parts()):
        comp = C.find_comp(name)
        safe = _file_name(name)
        p = os.path.join(EXP, 'parts_step', safe + '.step')
        em.execute(em.createSTEPExportOptions(p, comp))
        done.append(p)
        solids = [b for b in comp.bRepBodies if b.isSolid]
        for b in solids:
            fn = safe if len(solids) == 1 else safe + '__' + _file_name(b.name)
            s = os.path.join(EXP, 'parts_stl', fn + '.stl')
            o = em.createSTLExportOptions(b, s)
            o.isBinaryFormat = True
            o.meshRefinement = adsk.fusion.MeshRefinementSettings.MeshRefinementHigh
            em.execute(o)
            done.append(s)
    return done
