wisehyun-2/my_robot_project/wheeled_biped/wbr/bench/acceptance_mpc.py

"""Stage-2 (MPC host) items of the Plan 4 acceptance battery that are not plain scenarios (docs/합격기준.md 22, 23).

    run_mpc_item(item, task) -> dict          called by wbr.bench.acceptance.run_task for scenarios "mpc_timing" / "mpc_fallback"

22 (record)        QP solve time on the development PC: velocity step 0 -> 0.5 -> 0 m/s and a 0.5 W push with host="mpc";
                   p50 / p99 / max of time.perf_counter() around every QP solve, QP failures (no solution from DAQP nor
                   OSQP), constraint violations of the MPC's own plan.
23 (must-survive)  forced solver failure (MpcHost.force_fail = True on every host the plan creates): the host must switch
                   to the ramp fallback and items 1 (stand, here 10 s), 8 (velocity step) and 11 (link loss) must pass
                   with the stage-1 criteria.  The per-item verdicts are returned as item1_pass / item8_pass /
                   item11_pass and passes_1_8_11.

Also: constraint_check(rate, ...) runs items 8 / 9 / 13 / 19 with the MPC host and counts the plan's constraint
violations (criterion 21 covers 8, 9, 13 and 19; the battery's item 21 only runs the velocity step).
"""
from __future__ import annotations

import math
from typing import Dict, List

import numpy as np

from wbr.bench import acceptance as A


def packet_violations(packets: List[tuple], a_max: float, j_max: float, period: float, tol: float = 1e-3,
                      a_dec: float | None = None, v_of_t=None, v_max: float | None = None) -> int:
    """Review r1 m4: count the acceleration / jerk violations of the reference the host actually SENT (MotionCtrl
    packets (t, forward, host_shaped)), independently of the QP's self-check.  Only consecutive host-shaped packets
    one period apart are compared (a fallback packet carries the raw target, a resync restarts the sequence)."""
    if not a_max or not j_max or not period:
        return 0
    n, prev_a = 0, None
    for i in range(1, len(packets)):
        t0, r0, s0 = packets[i - 1][:3]
        t1, r1, s1 = packets[i][:3]
        if not (s0 and s1) or abs((t1 - t0) - period) > 1e-6:
            prev_a = None
            continue
        if v_max is not None and prev_a is None and abs(r0) > v_max * (1 + tol) + 1e-9:   # r3 n1: the first packet of a
            n += 1                                                                            # sequence has no pair of its own
        a = (r1 - r0) / period
        # braking = the reference acceleration opposes the ROBOT's motion (body speed recorded with the packet, or
        # v_of_t(t), or the reference itself when neither is available): the larger a_dec applies there
        v_dir = packets[i - 1][3] if len(packets[i - 1]) > 3 and np.isfinite(packets[i - 1][3]) else \
            (float(v_of_t(t0)) if v_of_t is not None else r0)
        braking = (a * v_dir < 0.0) and abs(v_dir) > 0.02
        bound = a_dec if (a_dec is not None and braking) else a_max
        if abs(a) > bound * (1 + tol) + 1e-9:
            n += 1
        if v_max is not None and abs(r1) > v_max * (1 + tol) + 1e-9:       # r2 m9: velocity bound of the sent reference
            n += 1
        if prev_a is not None and abs(a - prev_a) > j_max * period * (1 + tol) + 1e-9:
            n += 1
        prev_a = a
    return n


def _capture_packets(plan) -> List[tuple]:
    """Record every MotionCtrl packet the host hands to the MCU link: (t, forward, host_shaped, v_robot), v_robot =
    the simulator's body speed at that instant (ground truth, used only by the independent packet check to decide
    whether a reference acceleration brakes or drives the robot)."""
    rec: List[tuple] = []
    orig = plan.link.receive

    def receive(cmd, t):
        try:
            v_robot = float(plan.observation["sim"]["base"]["linear_velocity"][0])
        except Exception:  # noqa
            v_robot = float("nan")
        rec.append((float(t), float(cmd.forward), bool(getattr(cmd, "host_shaped", False)), v_robot))
        return orig(cmd, t)

    plan.link.receive = receive
    return rec


def _v_of_t(plan):
    """Logged body speed as a function of time (braking direction of the packet check)."""
    L = getattr(plan, "log", None)
    if L is None or "t" not in L.rows or len(L["t"]) < 2:
        return None
    t, v = np.asarray(L["t"]), np.asarray(L["vx"])
    return lambda tq: float(np.interp(tq, t, v))


def _host_stats(hosts: List, packets: List[tuple] | None = None, period: float | None = None, plan=None) -> dict:
    times = np.concatenate([np.asarray(h.solve_times_ms, dtype=float) for h in hosts]) if hosts else np.zeros(0)
    times = times[np.isfinite(times)]
    st0 = hosts[0].stats() if hosts else {}
    pv = (packet_violations(packets, st0.get("a_max"), st0.get("j_max"), period, a_dec=st0.get("a_dec_max"),
                            v_of_t=_v_of_t(plan) if plan is not None else None, v_max=st0.get("v_max"))
          if packets is not None else None)
    return dict(n_solves=int(times.size), packet_violations=pv, n_packets=None if packets is None else len(packets),
                solve_p50_ms=float(np.percentile(times, 50)) if times.size else None,
                solve_p99_ms=float(np.percentile(times, 99)) if times.size else None,
                solve_max_ms=float(times.max()) if times.size else None,
                solve_mean_ms=float(times.mean()) if times.size else None,
                qp_failures=int(sum(h.qp_failures for h in hosts)),
                solver_failures=int(sum(getattr(h, "solver_failures", 0) for h in hosts)),
                constraint_violations=int(sum(h.violations for h in hosts)),
                fallback_used=int(any(h.fallback_used for h in hosts)),
                n_var=st0.get("n_var"), n_ineq=st0.get("n_ineq"), horizon_steps=st0.get("horizon_steps"),
                a_max=st0.get("a_max"), j_max=st0.get("j_max"), model_ok=int(all(getattr(h, "model_ok", True) for h in hosts)))


def _capture_hosts(plan, force_fail: bool = False) -> List:
    """Wrap plan._make_host so that every host the plan creates (the scenarios call plan.reset()) is recorded and,
    for item 23, has force_fail set before its first tick."""
    hosts: List = []
    make = type(plan)._make_host

    def _make_host():
        h = make(plan)
        if force_fail:
            h.force_fail = True
        hosts.append(h)
        return h

    plan._make_host = _make_host
    plan._packets = _capture_packets(plan)
    plan.host = _make_host()
    plan.host.set_command(forward=0.0, left=0.0, up=plan.up_cmd, stand_mode=True)
    return hosts


def _verdict(item_id: int, res: dict) -> bool:
    it = A._item(item_id)
    ev = A.evaluate(it, res)
    return bool(all(c["passed"] for c in ev.values()))


def run_timing(task) -> dict:
    plan = A.make_plan(task.rate, task.seed, task.mass_scale, task.friction, "mpc")
    hosts = _capture_hosts(plan)
    vel = A.scenario_velocity(plan, V=0.5)
    push = A.scenario_push(plan, frac=0.5)
    out = _host_stats(hosts[1:] if len(hosts) > 1 else hosts, plan._packets, plan.host.period, plan)   # hosts[0]: never ticked
    out.update(alive=int(bool(vel["alive"]) and bool(push["alive"])), vel_rise_s=vel["rise_s"], vel_overshoot_pct=vel["overshoot_pct"],
               push_settle_s=push["settle_s"])
    return out


TRANSIENT_FAIL_TIMES = (0.8, 1.2, 3.04)     # s into the velocity step: accelerating, near the target, braking (r1 M2)
TRANSIENT_FAIL_S = 0.1
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
