wisehyun-2/my_robot_project/wheeled_biped/wbr/models/upkie_params.py

"""Plan 4 plant parameters of the upkie MuJoCo model: lumped leg table over the virtual leg length,
body / wheel parameters, standing posture (docs/plan4_model.md, section 2).

    python -m wbr.models.upkie_params [--model upkie_plan4]   # writes models/<model>/plan4_params.json

Bodies are grouped by the last joint on their path from the base: base group (torso, battery,
handle, hip stators) = body; hip group (hip rotor, horn, femur, knee stator) = thigh; knee group
(knee rotor, horn, tibia, ankle, mj5208 stator) = shank; wheel group (mj5208 rotor, hub, tire).
For each L0 the legs are set to the IK posture with the virtual leg vertical (theta_v = 0), so the
leg frame coincides with the world frame: c = COM height above the axle, d = COM forward offset.
"""
from __future__ import annotations

import math
from pathlib import Path
from typing import Dict

import mujoco
import numpy as np

from wbr import MODELS_DIR
from wbr.controllers.lqi8.plant_serial import LegTable, SerialPlantParams
from wbr.controllers.lqi8.serial_leg import UPKIE_JOINT_SIGNS, SerialLeg, SerialLegGeometry

L_STAND = 0.31          # standing virtual leg length (knee ~51 deg; straight leg = 0.343 is singular)
L_MIN, L_MAX = 0.24, 0.335
TABLE_GRID = np.round(np.arange(0.22, 0.3401, 0.005), 4)
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
