wisehyun-2/my_robot_project/(commit log)

2026-10-20 Add self-balancing robot design study (ROS 2 + Teensy, direct-drive)
    Design report (Korean), TWIP simulation (LQR/LQI vs cascade PID vs MPC,
    loop-rate x latency stability map, motor sizing for 5-10 kg robots),
    gain generator, Teensy 4.1 balance-loop firmware skeleton, figures and
    result JSONs.
    Claude-Session: https://claude.ai/code/session_0113ysMeAN3Lyk161zhY7Khb
2026-10-20 Add software-in-the-loop harness for comparing balance controllers
    C controller interface (ctrl_api.h), Python harness driving compiled
    controllers against the nonlinear TWIP model with loop period, latency,
    torque/velocity-mode drivers, IMU noise and leg-length changes.
    Includes the proposed LQI controller (online Riccati, gain-scheduled)
    and a faithful port of the Ryung ICT2024 3-loop PID.
    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
2026-10-20 Port balance controllers of 8 open-source wheel-legged robots into the SIL harness
    Faithful C ports (gains, rates, filters, structure as in the sources) of
    MuShibo Micro-Wheeled_leg-Robot, lk888l WL1, fernandomierhicks
    wheeled-leg-robot, hpzhaozhao LZU_ASCENTO, 123zhengzz zephyr_ascento,
    SeungbinOh Pow_WBR, XRobots SonicRobot and track-tech Venus-1, plus the
    harness output-scale search and per-controller parameters.
    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
2026-10-20 Add SIL benchmark results and controller comparison conclusions
    Results for 15 controller configurations on 5 kg and 10 kg robot models,
    fixed-scenario metrics, response plots, retuned fern-structure variants,
    and the completed comparison report.
    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
2026-10-20 Add upkie (hip+knee+wheel) balance controllers to the SIL comparison
    Ports of upkie's WheelBalancer (spine C++), pd_balancing and
    torque_balancing examples, and upkie's actual Python MPCBalancer run
    in the loop via qpmpc/ProxQP; Python-controller support in the harness;
    results, tables, plots and a new report section.
    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
2026-10-20 Add six-motor (five-bar) SIL harness, ten ported balance laws, WheelLeg_LQR 4-state port
    - sim6/plant6.py: three-body wheel-leg plant (HEU equations), validated against USTB Reborn gains
    - sim6/controllers6.py: Jerry/Skythinker/HNUST/QDU/Multivac/Zhouzzw/Liu/ATWheelLeg/LJW ports + my LQI6
    - sim6/sil6_harness.py, make_report6.py: sign/scale search, benchmark, tables, plots (RM plant results)
    - sil/controllers/wheelleg_lqr4.c: 4-state cart-pole dLQR port, rows added to report section 5
    - README: index sil/ and sim6/
    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
2026-10-20 Add six-motor benchmark results on the Liu (Webots, 15 kg) plant
    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
2026-10-20 Add six-motor benchmark results on the Skythinker 0.6 kg plant
    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
2026-10-20 Scale my LQI6 torque weights with the robot's motor limits
    Absolute R made the 0.6 kg Skythinker plant a bang-bang controller; R now uses 25 % of the wheel and 15 % of the hip torque limit (unchanged 1.5 / 4.5 Nm on the RM plant).
    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
2026-10-20 Update six-motor results (RM, Liu, Skythinker plants) with the torque-scaled LQI6
    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
2026-10-20 Add six-motor benchmark results on the 5 kg five-bar plant (my LQI6 re-run pending)
    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
2026-10-20 Merge the torque-scaled LQI6 re-run into the 5 kg six-motor results
    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
2026-10-20 Add report section 8: six-motor five-bar projects (10 laws, 5 plants) with results, interpretation, conclusions
    - results6_large.json, results6_tables.md, response plots for RM / 5 kg / 10 kg plants
    - summary updated (§0, §1.2 pointer)
    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
2026-10-20 Fix GitHub strikethrough: replace range/approximation tildes with en dash and ≈ in the reports
    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
2026-10-20 Add simulation-environment survey of the surveyed wheel-leg repositories (Ubuntu 24.04 verification)
    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
2026-10-20 Report: link the six-motor repositories like the four-motor table, drop the two now-inaccessible repos from the list
    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
2026-10-20 Report: drop B7 (LiuDingchuan, simulation-only) from the six-motor list, results and figures; keep its 15 kg plant
    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
2026-10-20 Add Kollarcik (CTU 2021 thesis) 4-state LQR+integral port to the 4-motor SIL harness and the CTU robot parameters (benchmark pending)
    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
2026-10-20 Kollarcik port: error-form speed-reference variant, report labels, merged 5 kg/10 kg results
    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
2026-10-20 Report: add A10 Kollarcik (CTU 2021 thesis) to the four-motor survey, port notes, result tables and interpretation
    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
2026-10-21 sim6: upkie WheelBalancer/MPC ports on the six-motor plant, upkie-class plant, driver-side servo loops
    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
2026-10-21 sim6: upkie WheelBalancer/MPC on the six-motor upkie plant (§8.4.1), results, figure, report
    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
2026-10-21 Add wheeled_biped: 6-motor wheeled biped plans 1-3 in MuJoCo + ROS 2 packages
    - wbr core (ROS-free): MuJoCo backend, upkie URDF->MJCF, 6 kg DIABLO-lite five-bar model,
    ports of upkie observers / WheelBalancer PI / MPC / gyropod, LQI6 (design report sec. 8)
    with precomputed gain table and five-bar VMC, DIABLO-style MCU program and host link
    (modes, MotionCtrl, 500 ms timeout, 180 ms heartbeat, safety rules)
    - plans: 1 = upkie stack, 2 = DIABLO architecture + LQI6, 3 = DIABLO architecture + upkie code
    - benchmark battery (tilt / push / velocity / yaw / latency / crouch / link loss / 60 s),
    figures, demo videos, live viewer, 16 unit tests
    - ROS 2 Jazzy packages (wbr_msgs, DIABLO-compati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
    [ankle_stator.stl, box_inertia.xacro, camera_support.stl, cylinder_inertia.xacro, diablo_lite.urdf, handle.stl, hollow_femur.stl, hollow_hip.stl]
2026-10-21 Apply pass-2 Opus review (docs/review_opus_pass2.md): arm gate, link-off latch, smooth IMU zero, settle metric, tests
    - MCU: arm() needs a valid estimate, motors-off latch only after a connection, no event flood
    - Plan 1: equilibrium-pitch (IMU zero) follows the crouch with the leg filter time constant
    - bench: edge-padded moving average in settle_time; Plan 3 MPC turning leg gains
    - ROS: spine pitch_offset parameter, mcu_node rejects start_mode car, yaml/comment updates
    - tests: 4 regression tests (20 total); benchmark, figures and report tables regenerated
2026-10-22 Plan 4: upkie serial-leg LQI6 (stage 1) + host MPC reference generator (stage 2), acceptance battery, docs
    - Serial-leg kinematics, three-body plant re-derived from the Lagrangian for upkie, parameter table,
    MuJoCo linearisation check (poles within 0.2 % / 3 %), models/upkie_plan4 (112 mm ellipsoid tires)
    - LQI6 on the serial leg inside the DIABLO-style MCU: velocity window estimator (wheel jitter fix),
    stiction compensation, static-tilt and position integrators, reference shaping, host_shaped flag
    - Acceptance battery (docs/합격기준.md) with mass x friction matrix, seeds, both rates, torque margins;
    full-matrix results in results/acceptance (stage 1: 6 at 1 kHz, 16, 17 open; stage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
    [upkie_patched.urdf]
2026-10-22 Plan 4 review round 1 fixes: sensor guards + IMU adapter, plant armature on the joint rate, MPC-mode integrator freeze, asymmetric braking, judgement definitions
    - MCU: non-finite / stale sample hold then FAULT, roll FAULT, BaseOrientation IMU adapter (the sim emulates the pi3hat ARS frame), friction-compensation pitch-rate gate, v_ref telemetry, NaN torque -> FAULT
    - Plant: wheel rotor armature and damping on the wheel joint rate (MuJoCo match: poles 0.06 %, B 0.3 %), stiff-contact comparison, 4 leg lengths, linearization.md
    - Stage 2: all LQI6 integrators frozen while the host reference accelerates; integrator-free prediction model (select_gains); a_max from the step pitch budget with a 1.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
    [acceptance.py, acceptance_mpc.py, build_upkie.py, host_link.py, mcu.py]
2026-10-22 Plan 4 review round 2 fixes: servo sample hold in the VMC, host MotionCtrl validation, MPC hand-over 1.0 s + braking 1.17, criterion-20 per-metric record, docs
    - MCU: VMC / leg PD use the last valid servo sample (hip/knee NaN no longer reaches the torques), quaternion normalised, rejected-packet events, FAULT when the balance law holds on non-finite inputs; HostLink rejects MotionCtrl packets with non-finite fields (timeout -> disconnect program); Ramp ignores NaN targets; LQI6 non-finite counter, 0.1 s integrator-freeze hold-off across acceleration sign changes, bumpless shaping switch
    - MPC host: obs_hold_s 0.5 -> 1.0 s, decel_factor 1.3 -> 1.17 (grid on the item-19 corner cases: both rate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
    [acceptance.py, acceptance_mpc.py, host_link.py, mcu.py]
2026-10-22 Plan 4 review round 3 fixes + items 16/17 decision: drift = max |x(t) - x(0)| for t >= 2 s, 10 cm limit for the constant-disturbance stand items; both stages pass at both rates
    - Items 16 / 17 (user-delegated decision, 합격기준 6.3): drift reference point x(0) with the 2 s reset transient excluded from the search only (the 2 s reference point over-measured by 1-2 cm, review r2 m3); drift limit 10 cm as for item 12 (same constant-disturbance class, same holding-torque order); item 1 keeps 5 cm; old definitions kept as drift_max_from_t2 / drift_max_from_t0; start-up IMU / COM zeroing procedure in HANDOFF 2.1
    - Stage 1 (review_plan4_r3: major 0 / minor 2 / nit 9): held servo sample copied (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
    [acceptance.py, acceptance_mpc.py, mcu.py]
2026-10-22 docs: round 4 skipped by the user's decision (비교보고서 11.8 pointer to the never-written round-4 reports removed)
2026-10-22 docs: the four interpretation items of 합격기준 6.2 settled by the user as the current reading (6.4): criterion-20 comparison unit, stop-distance definition / measurement point, items 3/6 saturation read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
2026-10-23 Plan 2 motor torque sizing at 15 kg: wbr.bench.torque_sizing, results, docs
    - wbr/bench/torque_sizing.py: rebuilds DIABLO-lite in a temporary folder with the same geometry and every mass / rotor inertia / joint friction scaled by k = mass / 6 kg (Plan 2 code untouched: parameters and model folder patched per case), scales the force-like MCU gains by k, runs 44 scenarios (static postures over the leg-length range, tilt 5-25 deg, push 0.25-2 W, velocity steps, yaw, full height range, crouched / tall driving, slopes 5-15 deg) with noise + 2 ms latency and records the true torques / speeds of all six motors; clamp 0 measures the demand, clamp > 0 verifies a motor limit; slope-aware fall check
    -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
2026-10-24 User's build with CubeMars AKE motors: wbr.bench.ake_sizing, results, docs
    - wbr/bench/ake_sizing.py: builds the Plan 4 upkie model in a temporary folder with the masses saved in the knee-torque calculator (torso 2.5 kg, battery centred over the hip, total 4.881 kg), hip / knee = AKE50-8 KV110, wheel = AKE60-8 KV80 (peak torque, voltage line of the torque-speed curve while motoring, reflected rotor inertia as armature, backdrive torque as joint friction), tire touching only the floor; Plan 4 LQI6 with the plant re-identified and the torque budget scaled by mass and wheel radius (Plan 4 module patched per case only); 28 scenarios with noise + 2 ms latency; records joint torques / speeds, satu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
    [ake_sizing.py]
2026-10-25 AKE sizing: tire-to-leg interference of the upkie layout (--clearance, docs 4.5)
    - wbr/bench/ake_sizing.py: tire_clearance() measures the smallest gap between the tire and every leg part from the MuJoCo collision shapes (mj_geomDistance, knee swept over its range; Plan 4 leg lengths and knee angle >= 60 deg), `--clearance [D ...]` writes results/ake_sizing/clearance.md; module doc corrected: in upkie the wheel is inboard of the shank, in the lateral band of the thigh-side knee-motor bracket (r ~50 mm about the knee axis, 175 mm from the axle) and the thigh link, so from 250 mm diameter the tire hits the bracket (the earlier "ankle / shank" diagnosis was wrong)
    - results/ake_sizing/clearance.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
    [ake_sizing.py]
2026-10-25 ake_sizing: motor per joint, wheel mass and torso options
    - Case.hip_motor / knee_motor / wheel_motor (keys of MOTORS: AKE50-8, AKE60-8): the stator masses, armature, friction, actuator and servo limits follow each joint's motor; Plan 4's single leg limit is the larger of the hip and knee peaks, each joint is still clipped at its own motor
    - Case.wheel_kg: one wheel (hub + tire) mass, hub and tire scaled to it (None keeps the upkie wheel, so the standard cases are unchanged)
    - CLI for the custom case: --torso, --wheel-kg, --hip-motor / --knee-motor / --wheel-motor; summary table lists the motors per case, result JSON records the motor of each joint
    - checked: the default layout reproduces th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
2026-10-25 robot_cad: Fusion model of the real robot (upkie 2.0 legs + CubeMars AKE motors)
    AKE50-8 hip and wheel, AKE60-8 knee, 150 mm wheel (hub, 6-spoke rim, TPU tyre),
    24 V 15 Ah battery, Raspberry Pi 4B + pi3hat, moteus-c1 drivers behind every motor.
    Torso COM 52.6 mm above the hip-axis midpoint, 6.54 kg total, no interference
    from L0 200 to 335 mm and hip +-60 deg.
    - export/: Fusion archive (.f3d), assembly STEP, 15 parts as STEP/STL
    - fusion/: scripts that rebuild the model from scratch (params.py holds all dims)
    - upkie_step/: upkie_parts 2.0 FCStd converted to STEP; tools/fcstd_to_step.py
    - images/, README.md (design, BOM, fastener list, assumptions)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
    [WheelBiped_AKE.f3d, WheelBiped_AKE_assembly.step, ankle_plate_AKE50.step, ankle_plate_AKE50.stl, battery_tray.step, battery_tray.stl, electronics_sled.step, electronics_sled.stl]
2026-10-28 robot_cad_v2: Fusion redesign (AKE60-8 x6, moteus r4.11, PETG legs, TITA-style torso)
    All six joints are AKE60-8 with moteus r4.11 drivers in PETG cups on the motor
    axis (chip-magnet 2.00 mm via a 6061 magnet spacer). The PETG thigh and shank
    are widened outboard where nothing sweeps (lateral deflection 0.91 / 0.94 mm at
    the design load). The torso follows TITA's proportions with blue accents; its
    rear end (the side the knee crooks face) carries the user's sketch profile:
    upper slope, short vertical face, lower slope. 8.44 kg, torso COM 0.2 mm off the
    hip-axis midpoint, no real interference over L0 200-335 mm x hip -80..+60 deg
    (30 poses), encoder gaps 2.00 mm on all six joints.
    - robot_cad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
    [BOM.csv, WheelBiped_v2.f3d, WheelBiped_v2_assembly.step, battery_tray.step, battery_tray.stl, cable_clips_shank_L.step, cable_clips_shank_L.stl, cable_clips_shank_R.step]
2026-10-28 robot_cad_v2: README notes the WheelBiped_v2 document is saved to the Fusion hub
    Saved to Default Project as version 1 (same content as export/WheelBiped_v2.f3d).
2026-10-29 robot_cad_v2: review of the machined BOM items (sheet laser vs CNC)
    로봇_부품_검토사항.md covers the 10 BOM rows marked "가공": which ones are
    laser-cut sheet (the two SUS304 clamp rings) and which need CNC (hip
    plates, magnet spacers, end plugs, tube and rail end facing / drilling),
    with dimensions measured from the exported STEP files.
    Lists the BOM/STEP mismatches to fix before ordering (hip plate is 9.5 mm,
    not 8 mm stock; countersinks modelled at ~70-74 deg instead of 90; taps
    not modelled; Ø42 pocket is 42.05 vs H7) and the open user decisions
    (stator ring ID, 6063 fallback for the tube and rail).
    Claude-Session: http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
2026-10-29 robot_cad_v2: quote STEP files and 2D drawings for the machined parts
    manufacturing/ builds one single-body STEP per machined part (hip plates
    L/R, magnet spacer, round and square end plugs, spine tube, rail, the two
    SUS clamp rings) plus DXF for the rings, and PDF drawings with hole
    tables, sections, tolerances and notes (make_parts.py, drawings.py; needs
    cadquery-ocp, ezdxf, matplotlib, no Fusion).
    The hip plate quote STEP fixes what the Fusion export gets wrong: Ø42
    pilot pocket 42.00 (H7 on the drawing), 90 deg countersinks, and the top
    lightening windows shortened so the shell M3 tapped holes at x ±40,
    z +140 have material (their centres were inside the windows).
    로봇_부품_검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
    [clamp_ring_output.dxf, clamp_ring_output.step, clamp_ring_stator.dxf, clamp_ring_stator.step, end_plug_round.step, end_plug_square.step, hip_plate_L.step, hip_plate_R.step]
2026-10-29 robot_cad_v2: apply the verified machined-part fixes to the Fusion source
    Re-checked the review items against the Fusion scripts, the part STEP
    files and the assembly STEP exported from the same document:
    - hip plate is 9.5 mm (8 mm hub + Ø80 x 1.5 cup register boss): docstring,
    params comment and the BOM text now say 10 mm+ stock;
    - countersinks were modelled at 73.7 / 69.0 deg (cadlib.ycyl cone): now
    90 deg with the ISO 10642 theoretical head diameters Ø11.2 / Ø9.0
    (params.CSK_M5 / CSK_M4; the earlier Ø10.4 / Ø9.4 were not ISO 10642);
    - pilot pocket radius 21.025 added the H7 band to the radius: the
    machined hip plate now uses params.PILOT_D_HIP = 42.0125 (H7 mid);
    - the shel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
    [BOM.csv, clamp_ring_output.dxf, clamp_ring_output.step, clamp_ring_stator.dxf, clamp_ring_stator.step, end_plug_round.step, end_plug_square.step, hip_plate_L.step]
2026-10-29 robot_cad_v2: clamp rings from 2 mm SUS304 (1.5 mm sheet not stocked)
    params.RING_T 1.5 -> 2.0. The screw head positions are fixed by
    BEARING_FACE (output side) and the low-head recess depth (stator side),
    so screw lengths and thread engagement stay the same; only the PETG under
    the rings gets 0.5 mm thinner (knee / wheel plate web 3.3 -> 2.8 mm,
    driven boss floor 9.7 -> 9.2 mm).
    strength.py now also checks the peak PETG pressure next to a stator-ring
    screw (ring as a beam on an elastic PETG foundation): 21 MPa at the knee
    review load with 2 mm (25 with 1.5, 33 with 1 mm, limit 50); hole-wall
    bearing in the 2.8 mm web 32.6 MPa. 1 mm was rejected because the
    output ring peak reaches 48 MPa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
    [BOM.csv, clamp_ring_output.dxf, clamp_ring_output.step, clamp_ring_stator.dxf, clamp_ring_stator.step]
2026-10-29 robot_cad_v2: wheel joint section figure (dowel pins, washers, screws)
    manufacturing/explain/wheel_joint_pins_washers.png, drawn to scale from
    fusion/params.py by wheel_joint_section.py: upper half through an M3
    output screw (DIN 125 washer, M3 x 16 into the AKE output, 4.3 mm
    engagement) and the M2.5 low-head screw on the stator clamp ring, lower
    half through a Ø3 x 10 dowel pin (3 mm in the output, 7 mm in the hub
    flange); also the Ø11.8 spigot and the M5 axle bolt. Linked from the
    review doc (7.1).
    Claude-Session: https://claude.ai/code/session_013mJBYH9GbCcYcGELGdS5Dv
2026-10-29 robot_cad_v2: torso frame figure (spine tubes, rails, end plugs, screws)
    manufacturing/explain/torso_tubes_rails.png from torso_frame.py: side view
    of the left hip plate (quote STEP outline) with the tube / rail sections,
    battery, tray and top plate, and a front section showing the glued end
    plugs, the M5 / M4 countersunk screws from the hip plate webs and the
    M4 x 25 top plate bolts. Review doc links it next to the existing Fusion
    renders (images/19, images/22).
    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
2026-10-29 robot_cad_v2: per-part tolerances (ISO 2768-mK + functional tolerances)
    - review doc section 8: general tolerance class, per-part tolerance tables
    - drawings: title block 2768-mK, Ø80 register boss 0/-0.1 concentric to
    Ø42, Z=8 datum flatness 0.1, A holes Ø2.8 +0.1/0, end plugs glued
    0-0.2 below the tube ends
    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
2026-10-29 robot_cad_v2: order request text for all machined parts
    - manufacturing/주문_요청서.md: per-part tolerances, threads, finishes and
    questions for the CNC and laser shops, quote-site field values, checks
    - clamp ring drawings / review doc: wire EDM is the only fallback
    (waterjet dropped)
    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
2026-10-29 robot_cad_v2: order request rewritten for one CNC + sheet-metal shop
    One letter covering all 9 parts (28 pcs), attachment list, per-part quote
    fields, and the magnet seat check made optional (spigot fits any seat
    that takes the Ø6 accessory magnet).
    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
2026-10-29 robot_cad_v2: order request attachment size
    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
2026-10-29 robot_cad_v2: encoder magnet comes loose in the AKE accessory pack
    The Ø6 x 2.5 magnet ships separately (CubeMars product page), so it is
    glued on the spacer instead of being taken off the rotor; the rotor seat
    size is from the CubeMars STEP and measuring it is optional.
    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
2026-10-29 robot_cad_v2: remaining explanatory figures (stator ring, joint contact, hip screws)
    - explain/stator_ring.py: ring webs and joint section; the stator now
    sits on the Ø42 pilot only, 1.5 mm clear of the PETG face
    - explain/wheel_joint_contact.py: what touches and what does not
    - explain/hip_plate_screws.py: hip plate holes coloured by screw (A-F)
    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
2026-10-29 robot_cad_v2: remove hip plate lightening holes (machining cost), Fusion rebuild
    - Hip plate: the five Ø22 holes, the 30 x 58 window and the two top windows only
    saved weight, so they are gone (torso.py). make_parts.py fills them in older
    exports; drawings.py drops the G holes, the P2/P3 windows and their dimensions.
    Plate 104.0 cm3 (281 g, +51 g each), robot 8.46 -> 8.56 kg.
    - Fusion rebuilt on 10-29 (machined-part fixes, then the hole removal):
    mass_properties.json, 0 real interferences, joints return to 0.0 mm, exports
    (2 mm clamp rings under their new names), sweeps / gaps of the first rebuild,
    inside images 09, 10, 17-24.
    - Hip plate quote STEP, PDF drawings and explain fig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
    [WheelBiped_v2.f3d, WheelBiped_v2_assembly.step, battery_tray.step, cable_clips_shank_L.step, cable_clips_shank_R.step, cable_clips_thigh_L.step, cable_clips_thigh_R.step, clamp_ring_output_D27_t1.5_SUS304.stl]
2026-10-29 robot_cad_v2: hip plate thin walls and wider lead groove
    - No wall under 1.5 mm on the machined hip plate (manufacturing/wall_check.py, gmsh
    ray-cast): lead groove starts at r 23 (0.49 mm fin -> 2.0 mm), the M2.5 counterbores
    run out into the Ø30 hole (0.86 mm wall removed), R8 ears around the M5 countersinks
    (0.74 -> 2.4 mm). Thinnest wall now 1.85 mm (A hole to Ø30).
    - Lead groove 7 -> 12 mm wide (params.HIP_GROOVE_W) so the three AKE60 phase pins
    clear the plate by 1.25 mm or more.
    - Hip plate quote STEP and explain figures (thin walls, counterbore run-out, lead
    groove); drawing shape table P1/P3/P4 and order request text.
    - The hip plate PDFs and the Fusion exports are commit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
    [hip_plate_L.step, hip_plate_R.step]
2026-10-29 robot_cad_v2: solid tapped spine bars and rails instead of tubes + end plugs
    - The Ø16 x 1.0 spine tubes and 15 x 15 x 1.0 rails needed 8 glued tapped end
    plugs only because the walls were too thin to tap. They are now solid 6061-T6
    Ø16 / 15 x 15 bars tapped M5 / M4 at both ends (params.END_TAP: thread 11 / 9),
    same ISO 10642 x 12 screws from the hip plate (~7.5 mm engagement). 4 fewer
    part kinds, no glue joint in the load path; WBv2-M03/M04 retired, end plug
    STEP/PDF/export files removed. Quote: 9 kinds / 28 parts -> 7 / 20.
    - Fourth Fusion rebuild: robot 8.563 -> 9.096 kg (torso 5.270 kg, COM 57.2 mm above
    the hip axis), 0 real interferences. Strength (calc/strength.py, solid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
    [end_plug_round.step, end_plug_square.step, end_plugs.step, end_plugs.stl, rail.step, spine_tube.step]
2026-10-29 robot_cad_v2: magnet spacer sized for the AS5047P field window, Fusion rebuild
    - The old 2.0 mm chip-to-magnet gap was the AS5047P datasheet's reference-magnet
    (Ø8 x 3) distance, and the modelled chip (1.40 tall) is taller than the real
    TSSOP-14 (<= 1.20), so the real magnet-to-die distance was ~2.55 mm, ~34 mT,
    under the 35 mT minimum. Sized from Bz on the r 1.1 Hall circle at the die for the
    AKE Ø6 x 2.5 magnet (no tolerance on the AKE drawing -> +-0.1), N35..N42, 0..80 C:
    magnet top -> PCB face 2.55 mm (window 2.34..2.76, ~52 mT), params.MAGNET_PCB
    replaces AIR_GAP; board and cup stay where they were.
    - Spacer body 4.5 -> 5.35 +-0.05, magnet pocket Ø6.04 +0.03/0 -> Ø6.20 +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
    [BOM.csv, WheelBiped_v2.f3d, WheelBiped_v2_assembly.step, battery_tray.step, cable_clips_shank_L.step, cable_clips_shank_R.step, cable_clips_thigh_L.step, cable_clips_thigh_R.step]
2026-10-29 robot_cad_v2: knee / wheel plate lead groove like the hip plate (12 wide, from r 23)
    - params.LEAD_GROOVE_R / LEAD_GROOVE_W (was HIP_GROOVE_*) shared by the hip plate and the knee / wheel
    PETG plates (legs._motor_seat); hip plate geometry unchanged.
    - PETG plates: groove 7 -> 12 mm wide, start r 21.5 -> 23. The AKE60 phase pins stop 1.5 mm short of the
    plate face there, but the outer two hung over the edges of the 7 mm groove; now pins -> link 1.95 mm,
    2.25 mm each side, 3.5 mm below the tips. The 0.5 mm PETG fin beside the Ø42 pocket becomes a 2.0 mm wall.
    - 7th Fusion rebuild: nominal interference 0 real (109 mating), joints return to 0.0, BOM unchanged;
    thigh / shank STEP + STL,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
    [WheelBiped_v2.f3d, WheelBiped_v2_assembly.step, shank_L.step, shank_L.stl, shank_R.step, shank_R.stl, thigh_L.step, thigh_L.stl]
2026-10-29 robot_cad_v2: join the knee / wheel driver cup lip to the cup wall, Fusion rebuild
    The register lip over the link housing OD (r 44.05..46.45) did not touch the cup wall
    (r 41..43.4), so each knee / wheel cup exported as three solids (cup, loose lip ring,
    a sliver). A 2 mm ring over the housing end (legs.CUP_LIP_BRIDGE, r 41..46.45) now joins
    them; the phase-lead slot runs 1 mm further out so no 0.45 mm skin is left. All six cups
    are single solids (+1.8 g each). Driver mounting unchanged: board on the 4 cup standoffs
    (M2.5 inserts), cup by 3 screws.
    Nominal pose: 0 real interferences (109 mating); 30-pose sweep and the 49 fixed gaps equal
    HEAD to 0.000 mm. Images, joints, drive check and exp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
    [WheelBiped_v2.f3d, WheelBiped_v2_assembly.step, cup_knee_L.step, cup_knee_L.stl, cup_knee_R.step, cup_knee_R.stl, cup_wheel_L.step, cup_wheel_L.stl]
2026-10-29 robot_cad_v2: area-weighted skin in the printed-mass estimate, motor re-check at 8.93 kg
    - check.skin_area: the surface facing the build direction is taken from each face's display mesh
    (triangle normals, area-weighted) instead of one normal per face, which classified whole cylinders
    at once and flipped with small topology changes (+15.6 g on the thigh from the 7th-rebuild groove).
    Only the thigh and shank have a build direction: thigh 480 -> 424 g, shank 427 -> 381 g.
    - Robot 9.095 -> 8.928 kg; calc/mass_properties.json and the f3d (material densities) updated;
    nominal interference 0 real. README: summary, wall-count table (8 walls now -0.28 kg), section 7.
    - python -m wbr.bench.ake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
    [WheelBiped_v2.f3d]
2026-10-30 robot_cad_v2: encoder gap figure from the main-branch magnet spacer
    explain/encoder_gap.py: motor-axis section (spacer 5.35, MAGNET_PCB 2.55)
    with mm scales, CAD chip block vs real TSSOP-14 top vs die distances, and
    Bz on the Hall circle vs magnet-to-die distance; review notes section 10
    links it.
    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
2026-10-30 robot_cad_v2: axial view of the wheel driver cup encoder alignment
    explain/encoder_axial.py: cup_wheel projected along the motor axis with
    mm scales - r4.11 outline, M2.5 mount holes (R25.00 / R30.48 from the
    axis), cup and register lip, and a centre zoom of the AS5147 package,
    Hall circle, magnet, pocket and spacer with the allowed chip-centre
    offset; review notes section 10 links it.
    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
2026-10-30 robot_cad_v2: hip encoder figures (stack section, axial view)
    - explain/encoder_gap_hip.py: section through the hip plate, AKE motor
    (simplified), spacer, driver cup and r4.11 with the height chain from
    the pocket floor to the die (2.50 machined + 31.55 printed cup ...,
    magnet to die 1.70), a gap zoom and the tolerance stack vs wheel/knee
    - explain/encoder_axial.py --joint hip|knee|wheel: hip version shows the
    hip plate Ø80 boss / Ø42 pocket / Ø30 hole and the three cup columns
    that locate on the boss; wheel figure only relabels the columns
    - review notes section 10: links, and that the AKE stator front and the
    Ø80 boss face are at the same height (zero gap) in the model
    Co-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
2026-10-30 robot_cad_v2: hip motor seating figures (stator front vs Ø80 boss)
    - explain/hip_seat.py: the AKE pilot end and the stator front land on the
    hip plate pocket floor and the Ø80 boss face at the same height in the
    model; the two real cases (pilot seats / stator seats, 0.1 mm drawn x5)
    and the printed knee / wheel plate with its 1.5 mm gap
    - explain/hip_relief.py: pilot, pocket and boss explained, and the
    proposed Ø63 x 0.5 relief in the boss face on the quote STEP, in section
    and from the inside face
    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
2026-10-30 robot_cad_v2: hip plate Ø63 x 0.5 relief in the Ø80 boss face (stator front clears)
    The hip plate pilot pocket is 4.0 deep and the AKE60 stator front is 4.0
    from the pilot end, so the motor met the pocket floor and the Ø80 boss
    face at once. A Ø63 x 0.5 relief (params.HIP_STATOR_RELIEF) leaves a 0.5
    gap at the stator front so the pilot end alone locates the motor, like
    the printed knee / wheel plates (1.5 gap); the Ø63..Ø80 rim still
    registers the driver cup.
    - fusion/params.py, torso.py: relief in the Fusion hip plate (rebuild needed)
    - manufacturing/make_parts.py: relief in the upload STEP (-2.2 g each)
    - drawings.py + hip_plate_L/R PDFs, BOM, finalize.py, order request, README
    - re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
    [BOM.csv, hip_plate_L.step, hip_plate_R.step]
2026-10-30 robot_cad_v2: hip plate Ø63 x 0.5 relief rebuilt in Fusion (9th rebuild)
    Ran README section 2 one line per script: build, print mass, mass json,
    interference, pose sweep (2 parts), gaps, part numbers + images, inside
    images + BOM, joints, drive check, exports.
    - Hip plate 102 956.9 mm3 each (same as the upload STEP), robot 8.928 ->
    8.924 kg (torso 5.269 -> 5.265).
    - Hip stator to hip plate, both sides: Ø63 relief floor 0.500 mm, pilot
    pocket floor 0.000 (the only seat), lead groove 2.0, counterbores 2.8.
    - 0 real interferences (109 mating); sweep 240 minima and the 49 gaps equal
    HEAD to 0.000 mm (files left as committed); BOM text unchanged; joints
    return to 0.0 mm.
    - Exports: f3d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
    [WheelBiped_v2.f3d, WheelBiped_v2_assembly.step, hip_plate_L.step, hip_plate_L.stl, hip_plate_R.step, hip_plate_R.stl]
2026-10-30 robot_cad_v2: wheel output assembly figures and video
    - explain/wheel_output_stack.py/.png: 2D half section of the wheel output
    (shank plate, AKE60-8, hub flange, hex hub, RC wheel) with dimensions,
    every screw / pin / insert and the load path
    - explain/wheel_assembly/: Fusion exploded view, before/after stills of the
    7 assembly steps, finished joint, two cutaways and a 55 s fastening video
    (1920x1080); scripts/ rebuild them from WheelBiped_v2 in a scratch doc with
    the BOM-only fasteners modelled
2026-10-30 robot_cad_v2: knee, hip and torso assembly figures and videos
    explain/assembly/: exploded views, before/after stills of every assembly
    step, finished assembly, two cutaways and a fastening video (1920x1080)
    for the left knee (7 steps), the left hip (6 steps) and the torso
    (9 steps: electronics deck, spine bars/rails, hip units, tray + battery,
    payload plate, shell and splice tabs, decor).
    scripts/axlib.py generalises the wheel renderer: parts copied from
    WheelBiped_v2 into a scratch doc, BOM-only fasteners (screws, washers,
    nuts, dowels, inserts) built from the model's hole coordinates in a
    travel-direction frame, 3D exploded offsets, sector/plane cutaways;
    job_knee/hip/torso.py hold the pa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
2026-10-30 robot_cad_v2: hip and knee joint section figures
    explain/hip_joint_stack.py and knee_joint_stack.py draw half sections of the
    left hip (6061 hip plate -> AKE60-8 -> thigh driven boss) and knee (thigh knee
    plate -> AKE60-8 -> shank driven boss) in the style of wheel_output_stack.py:
    overview + to-scale detail from params.py and the cup levels / screw lengths of
    legs.py (adsk stubbed, nothing built), every fastener with size, count, PCD and
    thread engagement, the centring features (pilot, spigot, Ø28 boss in the Ø30
    hole, driver cup register; hip register shown in a x3 inset of a column flank),
    the load path and the strength.md section 2 / 4 / 5 numbers.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
2026-10-30 robot_cad_v2: every fastener modelled, wheel hub M3 x 14 clears the hex hub
    The wheel hub flange's M3 x 16 heads stood 1.2 mm into the hex hub's Ø20
    register spigot (10.3 mm3 each), unseen because the screws were BOM lines
    only. Washer seat moved 11.2 -> 9.5 mm from the output face
    (params.HUB_SCREW_SEAT) with M3 x 14 12.9 (HUB_SCREW_L): heads 0.5 mm clear,
    4.0 mm engagement (thread shear check added to calc/strength.py).
    fusion/fasteners.py puts all 428 BOM fasteners (32 kinds: screws, washers,
    nuts, dowels, inserts, pi3hat screws, foam pad, grommets) into the model as
    _library masters placed on their links; threads at the minor diameter and
    inserts at their hole diameter so mating parts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
    [BOM.csv, WheelBiped_v2.f3d, WheelBiped_v2_assembly.step, battery_tray.step, cable_clips_shank_L.step, cable_clips_shank_R.step, cable_clips_thigh_L.step, cable_clips_thigh_R.step]
2026-10-31 robot_cad_v2: mjpower-ss from the mjbots r2 STEP, 0 real interferences
    The hand-made mjpower-ss stand-in had its XT90 / PH-4 / XT30 blocks over
    the mounting holes, which clashed with the four M2.5 x 6 screws. The real
    board (user-supplied r2 drawing and STEP) is clear around the holes.
    vendor.mjpower_ss imports the STEP and splits it into PCB and connector
    bodies; XT30 outputs, XT90 face and PH-4 header positions follow the STEP
    and the harness ends moved with them.
    Nominal and 30-pose checks: 0 real interferences. 9.178 kg. MuJoCo
    recheck at 9.21 / 14.21 kg: all recover, peak torque <= 82 % of 12.5 N m.
    Exports, images, BOM and torso assembly stills regenerated; the torso
    video is kept as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
    [BOM.csv, WheelBiped_v2.f3d, WheelBiped_v2_assembly.step, battery_tray.step, cable_clips_shank_L.step, cable_clips_shank_R.step, cable_clips_thigh_L.step, cable_clips_thigh_R.step]
2026-10-31 robot_cad_v2: wheel axle bolt M5 x 55 (full engagement in the wheel nut)
    The M5 x 50 axle bolt engaged only 3.5 mm of the 6 mm serrated wheel nut.
    M5 x 55 runs through the whole nut and ends 2.5 mm past it, still 2.5 mm
    inside the tyre's outer face.
    Rebuilt: nominal and 30-pose checks 0 real interferences, 9.179 kg,
    MuJoCo recheck at 9.21 / 14.21 kg recovers everywhere (peaks hip 10.33,
    knee 10.23, wheel 9.15 N m, <= 83 % of 12.5). Exports, BOM, images,
    wheel_output_stack and the wheel assembly stills regenerated; the wheel
    assembly video is kept as it was.
    [BOM.csv, WheelBiped_v2.f3d, WheelBiped_v2_assembly.step, battery_tray.step, cable_clips_shank_L.step, cable_clips_shank_R.step, cable_clips_thigh_L.step, cable_clips_thigh_R.step]
2026-10-31 robot_cad_v2: README notes the Fusion hub version 6 (M5 x 55 axle bolt, 97bc56e)
2026-10-31 robot_cad_v2: move the wheel assembly pictures into explain/assembly/wheel
    explain/wheel_assembly -> explain/assembly/wheel next to knee / hip / torso.
    The f_wx script paths and the README references follow the new place.
2026-10-31 robot_cad_v2: saddles without edge chamfers, decor cleanup, thigh clears the shell screw heads
    User requests (10-31):
    - Hip section ends lose the 20 mm top / bottom edge chamfers (MID_CH): the
    saddle front and back faces run straight up to the top and to the rear
    upper slope, the bottom corners are no longer cut.
    - Removed the top three-bar stripes (front top and rear slope), the face
    panel, the camera bezel and its lens hole, and every white line on the
    left side.
    - Removed the hip drums (ring, light ring, arc); the shell side wall fills
    the old 1 mm drum seat.
    - The ISO 7380 M3 x 6 shell heads stood 0.35 mm from the thigh (the pose
    sweep never measured the thigh body; it does n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
    [BOM.csv, WheelBiped_v2.f3d, WheelBiped_v2_assembly.step, battery_tray.step, cable_clips_shank_L.step, cable_clips_shank_R.step, cable_clips_thigh_L.step, cable_clips_thigh_R.step]
2026-10-31 robot_cad_v2: remove every glued decor part (white lines, blue band, rear panel)
    User request (10-31): no deco_* parts at all. shell.py loses the trim
    section (stripes, white lines, rear knob panel); the shell openings (vents,
    rear perforation, rocker switch) and the blue saddles stay. The torso
    assembly job drops the decor step (8 steps).
    0 real interferences (nominal + 30 poses), 9.118 kg; tyre-torso minimum
    5.5 mm (shell rear, was 4.9 to the blue band). Images, exports (stale deco
    STEP / STL removed), BOM and torso assembly stills regenerated. MuJoCo not
    rerun for the decor-only change (user decision; README notes the 9.130 kg
    run).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
    [BOM.csv, WheelBiped_v2.f3d, WheelBiped_v2_assembly.step, battery_tray.step, cable_clips_shank_L.step, cable_clips_shank_R.step, cable_clips_thigh_L.step, cable_clips_thigh_R.step]
2026-10-31 robot_cad_v2: square front corners of the shell front pieces
    The 30 mm vertical corner chamfers at the front end met the top-front
    chamfer and the raked face in one point (x 240, z 125), leaving a
    triangular facet on both front pieces (user, 10-31). shell.end_plan keeps
    the chamfers at the rear end only.
    0 real interferences (nominal + 30 poses), minimum clearances unchanged,
    9.121 kg (+3 g). Images, exports, BOM and torso assembly stills
    regenerated; MuJoCo not rerun for the few-gram change (user decision).
    [WheelBiped_v2.f3d, WheelBiped_v2_assembly.step, battery_tray.step, cable_clips_shank_L.step, cable_clips_shank_R.step, cable_clips_thigh_L.step, cable_clips_thigh_R.step, clamp_ring_output_D27_t2.0_SUS304.step]
2026-10-31 robot_cad_v2: M365 8.5x2 tyre + one-piece lugged PETG rim (10.537 kg)
    - Wheel = the user's Xiaomi M365 8 1/2 x 2 solid honeycomb tyre (OD 202 x 54,
    bore 141 x 36.5, 721 g, 24 bore cavities); RC wheel, 17 mm hex hub, M5 x 55
    axle bolt and wheel nut removed (vendor.m365_tyre, params TYRE_*).
    - One-piece rim (legs.rim, rim_out merged): 10 mm hub tapering to a 6 mm web
    (no holes), Ø141 seat ring with 24 lugs (8 x 26.5 x 4.5, 45 deg ends) keyed
    into the tyre cavities, Ø150 bead flanges. The first 4.75 mm disc was 81 MPa
    at the design load at the hub flange edge; now 37 / 45 MPa at the check load.
    M3 x 14 8.8 + DIN 125 on an 8 mm seat, Ø11 x 3 register moved to the hub
    flange so t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
    [BOM.csv, WheelBiped_v2.f3d, WheelBiped_v2_assembly.step, battery_tray.step, battery_tray.stl, cable_clips_shank_L.step, cable_clips_shank_L.stl, cable_clips_shank_R.step]
2026-10-31 robot_cad_v2 README: hub version 10 = M365 tyre + one-piece rim (7adbca6)
2026-10-31 robot_cad_v2: wheel assembly video for the M365 tyre + one-piece rim
    - f_wx_video / compose_video take the step count from wxlib.STEPS (6 steps:
    tyre -> rim on the bench, rim + tyre -> hub flange with M3 x 14 + washers),
    new side panel legend / load path; 51.6 s, 1920 x 1080.
    - The first camera set after the scratch doc opens landed far off (blank
    overview frame): set it twice with adsk.doEvents.
    - READMEs: the wheel video is no longer the RC wheel version.
2026-10-31 robot_cad_v2: rim screw seat 9 mm, register recess Ø11.2, rim joint shear check
    - Rim M3 x 14 tip was 0.5 mm off the Ø4 x 6 insert hole floor; screw length
    tolerance, print tolerance and PETG pushed under a heat-set insert could
    bottom it before the washer clamps. Washer seat 8 -> 9 mm: tip 1.5 mm,
    4.4 mm in the insert (brass thread ~3 kN vs 8.8 proof 3.0 kN; the limit is
    the insert pulling out of PETG, ~1 kN, independent of engagement).
    - Register recess Ø11.4 -> Ø11.2 (params.RIM_REG_GAP, radial 0.1 < screw hole
    0.2) so the register takes the wheel load before the screws.
    - strength.py: combined shear (25 N m + 600 N, friction ignored) 431 N per
    screw -> 96 / 371 MPa, beari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
    [BOM.csv, WheelBiped_v2.f3d, WheelBiped_v2_assembly.step, battery_tray.step, cable_clips_shank_L.step, cable_clips_shank_R.step, cable_clips_thigh_L.step, cable_clips_thigh_R.step]
2026-10-31 robot_cad_v2 README: hub version 11 = rim screw seat 9 mm, register Ø11.2 (6c750d7)
2026-10-31 robot_cad_v3: 6061 thigh / shank boxes on the v2 robot (10.388 kg, 510 mm wide)
    New folder robot_cad_v3 = robot_cad_v2 at 987a914 with only the thigh and shank changed
    from widened PETG (76 / 55 mm) to 6061-T6 closed boxes 30 mm wide: a shell machined from
    40 mm plate (face plate and walls 2.5 mm, motor housing r 41.5-44 with tapped cup bosses,
    8 mm motor seat with a 42 H7 pocket, driven boss with an r 18 spool) and a 3 mm cover on
    10 x ISO 10642 M3 x 8 10.9. Every joint plane is kept, so motors, cups, hub, rim, tyre and
    torso are the v2 parts. SUS clamp rings, link inserts and cable clips are gone; the leg
    cables run inside the boxes through two back-wall windows; the hip loop plane moves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
    [BOM.csv, WheelBiped_v3.f3d, WheelBiped_v3_assembly.step, battery_tray.step, battery_tray.stl, cup_hip_L.step, cup_hip_L.stl, cup_hip_R.step]
2026-10-31 robot_cad_v2 / v3: solid 4 x 4 mm corner posts in shell_mid
    The saddle takes the hip-section shell outside the end width above SADDLE_Z, so the top face of
    shell_mid stood on the 1.4 mm taper-wall sliver at its four corners (|x| 95, |y| 135).
    shell.corner_posts() adds a SHELL_POST = 4 mm square solid post at each corner, from 15 mm below
    SADDLE_Z up to the outer surface (the rear ones end under the upper rear slope); outer shape and
    saddle faces are unchanged. Same code in robot_cad_v2 and robot_cad_v3 (shell.py identical).
    Fusion rebuild of both documents: real interference 0 (111 results, all mating; none with
    shell_mid), post section 4.0 x 4.0 mm measured at hip + 100 / 120 / 135 mm, ro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
    [shell_mid_L.step, shell_mid_L.stl, shell_mid_R.step, shell_mid_R.stl]
2026-10-31 robot_cad_v3: wheel hub flange spigot 1.4 -> 1.3 mm (0.2 off the output recess floor)
    The Ø11.8 spigot of the PETG wheel hub flange goes into the AKE output's Ø12 x 1.5 recess. At
    1.4 mm its tip was only 0.1 mm off the recess floor; a printed height error (+-0.1) or a shallow
    recess (depth untoleranced on the AKE drawing) would let the tip seat first, so the 6 x M3 x 14
    output screws would clamp a tilted flange instead of the flat faces. params.HUB_SPIGOT = (5.9, 1.3)
    leaves 0.2 mm, the same margin as the rim register (RIM_REG_GAP); the dowels locate the flange,
    the spigot only guides. The machined hip / knee boss spigots stay 1.4.
    Fusion rebuild of WheelBiped_v3 (also brings the f3d /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
    [WheelBiped_v3.f3d, WheelBiped_v3_assembly.step, hub_flange_L.step, hub_flange_L.stl, hub_flange_R.step, hub_flange_R.stl]
2026-10-31 robot_cad_v3: wheel output section figure + wheel assembly stills / video (v2 explain format)
    manufacturing/explain/wheel_output_stack.py/.png: the v2 to-scale half section with the 6061
    shank - 8 mm seat plate, Ø42 H7 pocket 1.5 deep, M2.5 low heads in Ø4.8 x 1.7 counterbores (no
    SUS clamp ring), r 41.5 .. 44 housing wall, hollow box beam with the 3 mm cover - plus the v3
    checks (seat plate bending 29 / 52 MPa, M2.5 head pressure 100 MPa on 6061) and the 1.3 mm hub
    flange spigot (A: 0.2 off the recess floor, B: register floor gap noted too).
    manufacturing/explain/assembly/wheel/: the v2 wx scripts pointed at WheelBiped_v3 (shank + cover
    copied, body light bulbs instead of visibility beca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
2026-10-31 robot_cad_v3: thigh / shank drawings + part-frame STEP, boss dowel holes 7.5 mm
    Manufacturing package for the 6061 links (manufacturing/link_drawings.py, run with the venv python):
    step/*.step in a part frame (origin = upper joint axis on the face plate, X to the lower joint, Z to the
    cover side) and drawings/*.pdf - thigh / shank shells L and R (WBv3-M11 / M13, 3 A3 sheets each: plan
    views + GD&T with datums A boss face, B spigot, C seat floor, D Ø42 pocket; section A-A + 2:1 details;
    hole, Z-level, fit tables and notes) and one cover each for both sides (WBv3-M12 / M14, the hole pattern
    is symmetric; make_step checks the R export is the same solid). Fits to the mating parts: Ø42 H7 pock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
    [BOM.csv, WheelBiped_v3.f3d, WheelBiped_v3_assembly.step, shank_L.step, shank_L.stl, shank_R.step, shank_R.stl, shank_cover.step]
2026-10-31 robot_cad_v4: SLA resin truss-box thigh / shank on the v3 robot (10.05 kg)
    User 11-01: the six 6061 machined parts quote ~3.0 M KRW vs ~0.7 M KRW printed, so print as much as
    possible; thigh / shank as a truss instead of solid, in ABS-like black SLA resin (E 2.73 GPa, tensile
    41..58, flexural 69..76 MPa, 1.20 g/cm3, HDT 60 C).
    robot_cad_v4 = robot_cad_v3 at 5a550c1 with only the thigh and shank changed (fusion/legs.py
    _hollow_link): one-piece closed box (SLA_WALL 3.0) braced by a Warren truss of three 2.0 mm ribs
    across the full width, widened outboard like the v2 PETG links (at the 30 mm v3 width even solid resin
    bends 2.6 mm at the tip). The ribs cut the face plates into triangles (buckl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
    [BOM.csv, WheelBiped_v4.f3d, WheelBiped_v4_assembly.step, battery_tray.step, battery_tray.stl, clamp_ring_output_D27_t2.0_SUS304.step, clamp_ring_output_D27_t2.0_SUS304.stl, clamp_ring_stator_D45_t2.0_SUS304.step]
2026-11-01 robot_cad_v4 README: hub WheelBiped_v4 version 1 = export/WheelBiped_v4.f3d (93a2aa2)
    The v4 build document was gone after a Fusion restart, so the committed f3d (6 joints, thigh 251.1 cm3
    SLA resin) was imported into a new document and saved to the Default Project root as WheelBiped_v4.
2026-11-01 robot_cad_v5: outboard wheels + MJF PA12 fork legs (concept A, 10.47 kg)
    v4 robot (681ad00) with the wheel groups turned outboard and the thigh / shank
    replaced by the user's chosen concept A (monolith):
    - fork thigh + 61807 knee bearing on a flush 6061 knee cap in the outer spar
    (knee held on both sides), shank 90 mm deep at the knee tapering to the wheel
    - straight tangent-hull outlines, flat faces, round only at the joints and the
    crotch; closed PA12 boxes (wall 3.5) with Warren ribs joined to every wall,
    round mid-rib powder holes, printed-in cable conduit
    - 6061 turned hub inserts at hip / knee, flush hip / knee caps
    - fusion/v5run.py builds on the v4 code (build(), then turn() in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
    [WheelBiped_v5.f3d]
2026-11-01 robot_cad_v5: no cable / rib holes, per-cell powder escapes, external leg harness (10.61 kg)
    User 11-01 follow-ups on concept A:
    - thigh / shank: cable windows, shank exit hole and the printed conduit removed
    - Warren ribs without holes; every cell they close off gets one 6 mm powder
    escape in a face that meets another part (legs_v5.cell_escapes: thigh 8,
    shank 7); 1 lump / 1 shell per link, 0 rib gaps (v5run.rib_check)
    - harness_v5.py: v4 torso cables + the two leg cables re-routed outside along
    the flat back faces (tie mounts), knee loop through the open knee wedge, wheel
    cable over the cup to the turned wheel driver; loop lengths 162 / 115 mm from
    the 30-pose chords, spare lengt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
    [WheelBiped_v5.f3d]
2026-11-01 robot_cad_v5 README: hub WheelBiped_v5 version 1 = export/WheelBiped_v5.f3d (5a01c18)
    Saved to the Default Project root after checking the imported model (wheel
    stators at the turned place, 0 real interferences at the nominal pose).
2026-11-01 robot_cad_v5: wiring removed from the model (10.43 kg)
    User 11-01: all cables out - leg and torso wires, XT30 / PH-3 plugs, XT60 / XT90
    connectors. harness_v5.py and the harness() / chords() steps deleted (the
    external route that was tried stays in 5a01c18); build() now places the
    back-panel rocker switch itself; the wheel drivers keep their CAN terminator
    and XT30 cap. Build order back to build() -> turn().
    Checks after a rebuild from an empty document: 0 real interferences in 6 poses
    (4 mating), every link 1 lump / 1 shell, 0 rib gaps, 8 / 7 escape holes; robot
    10.43 kg. README, CLAUDE.md, images 01-10 and export/WheelBiped_v5.f3d updated
    (the hub WheelBiped_v5 v1 still holds the wired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
    [WheelBiped_v5.f3d]
2026-11-01 robot_cad_v5 README: hub WheelBiped_v5 version 2 = the model without wiring (0e8be1a)
    Version 1's document with the wire parts deleted and saved (checked first:
    wheel stators turned, 0 real interferences at the nominal pose, 10.43 kg).
2026-11-02 robot_cad_v4: no cable channels, windows or drain holes in the links; wiring removed (9.90 kg)
    User 11-02: the thigh / shank lose the rib cable channel (14 x 14), the front
    drain channel (8 x 8), the back-wall cable windows (12 x 16 x 2) and the front
    Ø4 drain holes; the model carries no wiring (wires, plugs, XT60 / XT90).
    Every link is now 1 lump / 5 shells (4 closed truss cells), taken as empty
    (user: assume no resin is trapped).
    - legs.py: plain ribs, _openings removed; params: SLA_CHANNEL, SLA_DRAIN_D,
    DUCT_WINDOW removed
    - v4run.build(): no harness by default; assembly.place_switch places the
    back-panel switch (v5run.build no longer places it itself)
    - poses / gaps: no cable loops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
    [BOM.csv, WheelBiped_v4.f3d, WheelBiped_v4_assembly.step, battery_tray.step, clamp_ring_output_D27_t2.0_SUS304.step, clamp_ring_stator_D45_t2.0_SUS304.step, cup_hip_L.step, cup_hip_R.step]
2026-11-02 robot_cad_v5: PETG legs, knee gap 4.0, backing rings, rounded rear shell corners (10.93 kg, hub v7)
    Uncommitted v5 work of 11-01 / 11-02 (two sessions) in one commit:
    - 11-01 plan A: outer spar y 261..286 (fork gap, shank slid in from
    outboard), countersunk flange screws, 61807 seat relief; v5run.relegs()
    rebuilds only the leg parts in the hub file
    - 11-02 (user): hip cap and per-cell escape holes removed (closed cells);
    knee gap 1.5 -> 4.0 by moving the whole wheel group 2.5 mm outboard
    (v5run.shift(); tyre centre y 270, width 594, flat 30 mm shank); links
    PETG FDM (aluminium CNC option dropped); 6061 backing rings hold the hub
    inserts, knee cap tube fitted
    - 11-02 (user): shel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
    [WheelBiped_v5.f3d, WheelBiped_v5_assembly.step, battery_tray.step, battery_tray.stl, clamp_ring_output_D27_t2.0_SUS304.step, clamp_ring_output_D27_t2.0_SUS304.stl, clamp_ring_stator_D45_t2.0_SUS304.step, clamp_ring_stator_D45_t2.0_SUS304.stl]
2026-11-05 robot_cad_v5 MuJoCo recheck: mass properties, CAD lateral geometry, scaled yaw / leg gains (28/28 recovered)
    - robot_cad_v5/fusion/v5run.py: save_mass_json() (read-only script, outboard tyre centre y 270)
    -> robot_cad_v5/calc/mass_properties.json (hub v7, 10.931 kg; MuJoCo 10.965 kg, inertias within 0.4 %).
    - wbr/bench/ake_cad.py: lateral = cad by default (link COM y, tyre centre and MCU track from the CAD;
    --lateral upkie = the layout of the results before 11-05, tire centres 305 mm apart);
    outer_loop_gains(): the yaw PI and the leg-length PD scaled from the 5.3 kg upkie tuning to the robot
    (user decision 11-05; v5 1.60 / 3.21 and 1504 / 75, with 5 kg 1.70 / 3.40 and 2936 / 147;
    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
2026-11-05 wheeled_biped/TEST: staged pass tests - pure LQR first, integrators later (v5 robot, 4 stages pass)
    The user wants to get the LQR right before adding integral action and asked for the stage tests in a separate
    TEST folder. Stages on the v5 CAD robot (MuJoCo closed loop, noise on, 10 ms latency, 1 kHz):
    1 pure LQR, 6 states (q_att = None, q_pos = None): stand, 10 deg tilt, 0.5 W push, velocity step; the offsets a
    constant disturbance leaves without integrators are recorded
    2 the other four controllers of the paper's Fig. 6 on the pure LQR: height, yaw, roll, split angle
    3 + position integral (q_pos): ends within 3 cm of the start under a slope / IMU bias / payload
    4 + static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
    [ake_sizing.py]
2026-11-07 robot_cad_v5: joints, centre-line electronics, links 25 cm, part names from the switch side (11.597 kg, hub v12)
    Fusion model and everything exported from it since hub version 7:
    - 6 as-built revolute joints (v5run.joints / unjoint / joint_check / pose), hub v8.
    - Pi + pi3hat on the robot's centre line (v5run.relayout, torso.centre_imu; v4 keeps its layout), hub v9.
    - urdf_export writes calc/urdf_data.json + export/links_stl for wbr.models.build_v5.
    - Thigh = shank 250 mm (fusion/link_length.py, v5run.relink): joint seats untouched, one straight flank, ribs 3.0 x 9 / 10, hub v10.
    - Part, body and joint names follow the robot (user 11-08): front = rocker switch side = CAD -x, _L = CAD -y.
    v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
    [WheelBiped_v5.f3d, WheelBiped_v5_assembly.step, battery_tray.step, clamp_ring_output_D27_t2.0_SUS304.step, clamp_ring_stator_D45_t2.0_SUS304.step, cup_hip_L.step, cup_hip_L.stl, cup_hip_R.step]
2026-11-07 wheeled_biped: v5 own URDF and IMU chain, knees-trailing front, compliant legs over bumps, 25 cm controller
    Controller and simulation work on the v5 robot since the staged tests (34831bb):
    - wbr.models.build_v5 + plans/plan_v5: URDF, MJCF and plant parameters from the Fusion model only, no upkie file.
    Front = rocker switch side (CAD -x), knees trail, R_base_to_imu diag(-1, -1, 1); build_v5 stops on JSON with old part names.
    - pi3hat firmware filter port (observers/pi3hat_ars), MCU attitude filter (observers/body_attitude), raw yaw gyro with learned offset.
    - Compliant roll, wheel speed difference yaw, exact static leg force, split PD; speed-bump suspension and gentle slow-down.
    - Links 250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
    [base.stl, left_shank.stl, left_thigh.stl, left_wheel_link.stl, right_shank.stl, right_thigh.stl, right_wheel_link.stl, wheelbiped_v5.urdf]
2026-11-08 robot_cad_v5: order BOM from the assembly STEP (BOM.md, BOM.csv, manufacturing/bom.py)
    - manufacturing/bom.py counts every component instance in
    export/WheelBiped_v5_assembly.step (hub version 11: 470 parts + 7 link
    containers = 477) and stops on any model part without a BOM line; the v4
    fastener counts are checked against fasteners.specs
    - groups for ordering: bought parts (incl. 61807), machining (v2 parts S14-S18
    + v5 hub inserts / backing rings / knee caps M01-M04), PETG prints with
    estimated print mass and the smallest square bed, fasteners summed per size
    with spare, wiring and tools
    - parts not in the model added by hand and marked: joint screws 6 (ISO 10642
    M3x16 12.9 x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
    [BOM.csv]
2026-11-08 robot_cad_v5: wheel hub flange dowel holes 7.0 -> 7.5 mm (hub v13)
    The Ø3 x 10 pins stood 3.0 proud into the AKE output's 3 mm dowel holes,
    so a pin at the long end of its length tolerance bottomed before the
    flange face seated. Now 2.5 proud, as the hip / knee hub inserts.
    - v4 params.HUB_DOWEL_HOLE (7.0, v4 unchanged); v5 sets 7.5 in v5run
    - v5run.deepen_hub_dowels(): migrates an existing hub document
    (unjoint -> deepen -> turn -> joints)
    - hub WheelBiped_v5 version 13: against v12 at the nominal pose only the
    6 wheel pins moved (0.5 mm along the axis) and hub_flange_L/R lost
    10.60 mm3 each; joint_check clean, 6 poses 0 real interferences
    - re-exported f3d, assembly STEP, hub_flang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
    [WheelBiped_v5.f3d, WheelBiped_v5_assembly.step, hub_flange_L.step, hub_flange_L.stl, hub_flange_R.step, hub_flange_R.stl]
2026-11-08 robot_cad_v5: axial stack-up fixes from the fastener review (hub v14)
    A review of every screw, pin, spigot and insert with tolerances found two
    real problems and some zero-margin stacks; all fixed (user: "문제 2건 +
    쉬운 것"). v4 files keep their values; v5 values in fusion/v5_params.py
    (applied by v5run.load, part_drawings, stack_common, strength_v5).
    - rim register recess 3.2 -> 3.6: the rim prints hub side down, the
    recess floor bridges and sags, and the Ø11 x 3 spigot seated first
    - shell hip section / saddle: Ø8 x 1.6 pads over the 1.6 mm gap to the
    hip plate web, ISO 7380 M3 x 6 -> M3 x 8 (engagement 3.0 -> 5.0)
    - wheel hub flange dowel holes 7.5 -> 8.0, spigots 1.3 -> 1.0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
    [BOM.csv, WheelBiped_v5.f3d, WheelBiped_v5_assembly.step, hub_flange_L.step, hub_flange_L.stl, hub_flange_R.step, hub_flange_R.stl, hub_insert_hip_L.step]
2026-11-08 robot_cad_v5: power dist r4.5b instead of the mjpower-ss (hub v15)
    User 11-08: the mjbots order is final with the power_dist r4.5b (CAN-FD
    soft power-down so the Pi can shut down before the switch cuts power).
    - fusion/pdist_v5.py: board from the mjbots r4.3b mechanical STEP
    (80 x 50, PCB 1.5, holes 74 x 44, 36 g), split into PCB + connector
    groups; v5run.load() patches the v4 modules (vendor master, deck
    bosses, board screw height, lumped mass) - v4 files untouched,
    build() also makes the r4.5b
    - v5run.relayout() swaps an mjpower-ss for it and drops the old master
    - same place / turn as before (XT90 to the switch side), 5 mm longer
    at each end; 0 real interferences in 6 poses, 11.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
    [BOM.csv, electronics_deck.step, electronics_deck.stl]
2026-11-08 robot_cad_v5: wheel motor re-clocked with its cup, M3 depth read as thread depth (hub v16)
    Work of the "M3 볼트 깊이 확인" session (11-09, user: "알아서 판단해서
    수정"), committed on the user's request:
    - legs_v5.CLOCK_MOTOR: the wheel motor stator, clamp ring / screws and
    the shank's motor seat (screw holes, lead groove and slot) turn with
    the cup (wheel_clock, 55.3 deg), so the motor leads, the slot and the
    cup's lead notch line up again; the cup column insert hole no longer
    runs into the lead slot
    - v5run.turn_wheels turns the stator group too
    - AKE output M3 "depth 5" taken as thread depth (user)
    - f3d, assembly STEP, shank STEP / STL / drawing, joint sections
    re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
    [WheelBiped_v5.f3d, WheelBiped_v5_assembly.step, shank_L.step, shank_L.stl, shank_R.step, shank_R.stl]
2026-11-08 robot_cad_v5: joint assembly figures and videos (hip, knee, wheel)
    Exploded -> assembled step images and an mp4 per joint of the right leg,
    from export/WheelBiped_v5.f3d of hub version 11 (copied into unsaved
    documents, the hub file untouched); v2 layout, numbers as the real
    section figures (① .. ⑦), the unmodelled ⑥ / ⑦ fasteners drawn from the
    BOM. README section "조립 그림·영상" and manufacturing/explain/assembly/
    README (scripts/ rebuilds them).
    Made before hub versions 13-16: the pictures do not show the later
    changes (wheel dowel holes 8.0, shell pads, M2.5 x 5 board screws, wheel
    motor re-clocked with its cup), and scripts/job5_*.py still name the old
    'FX DIN 7984 M2.5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
2026-11-08 wheeled_biped: bring-up step 0 guards - arm refusal, IMU channel faults, time-stamped attitude
    From the review of docs/bringup_step0.md (v5 robot, 25 cm links):
    - DiabloMcu.arm() refuses (reason in arm_refused) when the body pitch is
    over arm_pitch, a leg reads outside the leg-control range (an un-homed
    knee reads |sigma2| <= 22.5 deg, a leg of >= 490 mm), a leg is more
    than arm_leg_angle (20 deg) off vertical (an un-homed hip turns it by
    45 deg multiples), or a servo sample with home_state says a hip / knee
    is not referenced to the output; armed like that the v5 simulation
    fell in 0.24 s
    - the IMU accelerometer and gyro-bias channels the estimator integrates
    are checked: NaN o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
2026-11-09 robot_cad_v5: assembly figures and videos redone from hub v16
    The hip / knee / wheel stills (66) and videos (3) re-rendered from the
    current export/WheelBiped_v5.f3d (hub version 16), so they show the
    changes of versions 13-16:
    - moteus board screws ④ DIN 7984 M2.5 x 5 (pick names and labels)
    - wheel step 7: the dowels pressed into the hub flange's 8 mm holes go
    onto the output with the flange (2.0 mm proud)
    - wheel step 9: rim register recess Ø11.2 x 3.6 over the Ø11 x 3 spigot
    - wheel step 2 / cut ②: the motor turned with its cup (leads at the
    cup's lead notch); the ① stator screws now sit at 39.7 + 60k deg, so
    cut ② is taken at 40 / 160 deg (pins at 35 / 155 still cut)
    - s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
2026-11-09 robot_cad_v5: every part 3D printed (BOM), battery tray / deck in two pieces (hub v17)
    User 11-09: all parts are printed in PLA or PETG on a 300 x 300 mm bed, strength
    not considered, so there is no machining order.
    - bom.py: the former 6061 / SUS304 parts (hip plates, spine bars, rails, stator
    clamp rings, magnet spacers, hub inserts, knee caps, backing rings) become
    solid prints from the existing STLs: tap-drill holes hand-tapped, fits worked
    to the real parts; material column, PETG advised next to motors, 300 mm bed
    check with print height (the script stops on a part that does not fit),
    12.9 grades and threadlocker notes for plastic threads, tools (taps, drills).
    - split_v5.py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
    [BOM.csv, WheelBiped_v5.f3d, WheelBiped_v5_assembly.step, battery_tray.step, battery_tray.stl, battery_tray_L.step, battery_tray_L.stl, battery_tray_R.step]
2026-11-09 robot_cad_v5: rocker switch on the torso top, shell grommets removed (hub v18)
    - switch_v5.py: the rocker switch moves from the switch-side face to the
    top of the hip shell section, just behind the payload plate (x +78, y 0);
    the 19 x 13 cut-out is split between shell_mid_L / _R, the face hole is
    filled. v5run.reswitch() applies it to the hub file, build() makes it.
    - v5run.drop_grommets(): the two FX grommet D16 and their _library master
    removed; the 16 mm hip cable holes stay.
    - Hub WheelBiped_v5 saved as version 18 (11.610 kg, joints 0, nothing
    hidden); export f3d, assembly STEP (478 leaves), shell_front_R /
    shell_mid_L / _R STEP and STL, drawings, BOM, README and CLAUDE.md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
    [BOM.csv, WheelBiped_v5.f3d, WheelBiped_v5_assembly.step, shell_front_R.step, shell_front_R.stl, shell_mid_L.step, shell_mid_L.stl, shell_mid_R.step]
2026-11-09 robot_cad_v5: assembly figures and videos redone from hub v18 with printed-part labels
    Following the 11-09 decision that every part is 3D printed (BOM section 2,
    no machining order), the hip / knee / wheel stills (66) and videos (3)
    no longer name metal materials:
    - hip plate, hub insert, backing ring, knee cap: (6061) -> (PETG)
    - SUS304 clamp ring -> clamp ring (PETG), in the knee step 4 and wheel
    step 3 titles, step lists and fastener legends
    - the flange bolts into the backing ring tap: "about 0.7 N m" ->
    "lightly (plastic thread)"; the knee cap tube is sanded to fit;
    H7 / g6 machining tolerances dropped
    - subtitles say model version 18 (rendered from the current
    export/WheelBiped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
2026-11-10 wheeled_biped: v5 LQI8 / MPC controller folders, LQI6 renamed LQI8, Plans 1-3 removed
    v5 controller folders (2026-11-10):
    - v5_lqi (LQI8 only) and v5_mpc (an MPC in the MCU's balance slot: v5 plant
    prediction model, 0.15 s preview, motor torque limits, DAQP); outer loops,
    VMC, model and IMU chain are shared. Staged tests moved from TEST/ to
    v5_lqi/TEST and v5_mpc/TEST with the shared runner wbr/bench/stage_tests.py;
    course_v5 --controller lqi|mpc.
    - The v5_mpc staged tests and tests/test_v5_mpc.py have not run in MuJoCo yet
    (the MuJoCo DLL was blocked by application control on this PC).
    LQI6 -> LQI8 (the controller runs 8 states [theta, theta_dot, v - v_ref, phi,
    phi_dot, z1, z2,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
    [diablo_lite.urdf, upkie_patched.urdf]
2026-11-11 v5_mpc: torque limits use the leg force the MCU commanded; first stage-4 results
    First MuJoCo run of the v5_mpc staged tests (stage 4, seed 0) and the fix of
    what it showed on the 20 cm bump (test 2-19: body pitch 10.1 deg, LQI8 1.5).
    Cause: MpcLaw.limits built each hip / knee torque offset from the static leg
    force only. With a leg on its range wall the leg loop puts 10.5-12.5 N m on
    that knee while the static force gave 8.6-9.4, just under the 9.38 N m limit
    (0.75 of the motor peak). The knee row stayed in with almost no room, the wheel
    torque needed on the slope used it up, and the QP pushed the hip balance torque
    the wrong way (0.8 -> 9.7 deg in 0.35 s) until the row dropped out.
    Fix: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
    [mcu.py]
2026-11-11 v5_mpc: the MPC law uses the MCU's lean when it slows down over uneven ground
    Staged tests 2-20 (speed on a 10 cm bump 0.316 m/s, limit 0.3) and 2-13
    (19.0 cm sideways after a sharp 4 cm step, limit 17.5) had one cause: over
    uneven ground the MCU lowers the speed reference and hands the balance law
    v_lean, which the LQI8 law uses and MpcLaw did not. Leaning back counted as an
    error in the MPC's cost, so it braked half as hard as the LQI8 (0.33 vs
    0.60 m/s^2) and stayed above the reference.
    Fix: MpcLaw.compute shifts the virtual leg's target by v_lean * a_ref / g, as
    LQI8Law does. The 0.15 s lead on that slow-down is kept: without it the heading
    peak of 2-13 went over its limit in a scratch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
2026-11-12 ros2_ws: decisions of 2026-11-12, package layout proposal and laptop setup; shared branch ros2-v5
    - ros2_ws/README.md: how the Windows PC and the Ubuntu 24.04 laptop share the branch, laptop setup
    (Python core, ROS packages, colcon, reference repositories), what was decided, the package layout
    proposal, what a real robot needs beyond the layout, porting pitfalls, order of work, open points
    - decisions: left leg on pi3hat JC1, right leg on JC2 (JC3 = power dist); start pose and stand-up later,
    balance while driving first (idle -> balance -> fault); control rate target 1 kHz, a parameter
    - docs/bringup_step0.md: bus assignment, --pi3hat-cfg "1=1,2,3;2=4,5,6", pi3hat_tool bus numbers
    - CL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
2026-11-12 ros2_ws/README.md: Isaac Sim is a simulator too; the Windows PC sentence removed
    Simulators are now MuJoCo, Gazebo and Isaac Sim (user, 2026-11-12): hw_env gets `isaac`,
    wbr_description gets an isaac folder, the order of work and the open points list it. How Isaac Sim
    attaches to ros2_control and the URDF to USD conversion are not investigated yet.
    The sentence about what the Windows PC cannot build was removed at the user's request.
2026-11-12 ros2_ws/README.md: final order of work with pass conditions, real-robot items from the project notes
    - order of work A0-A8 (laptop), B1-B3 (Pi without the hat), C1-C7 (pi3hat + moteus), D; sign checks
    in the ROS simulation and again on the robot; baseline check against the committed stage report
    - full controller only (LQI8, 8 states, all outer loops): no pure-LQR / staged-integrator steps
    (user, 2026-11-07)
    - section 4 items 9-15: pi3hat settings, torque off on shutdown and moteus watchdog, missing replies,
    one program per pi3hat, empty CAN ports, full-rate logging, FAULT list
    - porting notes: core takes the Python obs convention, IMU in its own axes, signal paths, golden data
    and p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
2026-11-12 ros2_ws/README.md rewritten after a three-reviewer check against code, sources and official docs
    Three Opus 5.5 reviewers compared the hand-over document with the Python code, the pi3hat / moteus /
    upkie / DDT sources and the official Jazzy documentation; every finding used here was confirmed again
    in the source.
    README
    - moteus C++ traps: PositionMode sends no torque with the default Format (position 0, kp_scale 1),
    watchdog NaN disables the timeout, home_state is not in the default query, a position-mode command
    before homing gives fault 39, a timeout does not drop torque (timeout_mode 12)
    - pi3hat: attitude detail must be requested or the bias is silently zero, no sample time in Atti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
2026-11-14 pi3hat bring-up decisions of 11-14: right leg on JC4, library-default wait values, IMU detail always on
    - Right leg moved from JC2 to JC4 so the two legs sit on pi3hat processors 1 and 2
    (upkie-style split, power dist stays on JC3): --pi3hat-cfg "1=1,2,3;4=4,5,6" in
    bringup_step0.md, ros2_ws/README.md (2, C4, 7), CLAUDE.md and the v5 BOM
    (bom.py and its BOM.md / BOM.csv edited to the same text, bom.py not re-run)
    - pi3hat CAN wait values stay at the library v1.1.0 defaults (timeout 0, min_tx 200 us,
    rx_baseline 1 ms, rx_extra 0); bringup 9 measures with --can-rx-extra-wait-ns 0 to
    match, since pi3hat_tool cannot set rx_baseline_wait_ns
    - request_attitude_detail always on in the fut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
    [BOM.csv]
2026-11-14 CLAUDE.md: reference repos rule rewritten after the 11-14 cleanup of ../references
    Kept: mjbots pi3hat, moteus, power_dist, fdcanusb, moteus_ros2 (the last three
    added 11-14), upkie, ddt_ros2_control, TITA_ROS2_Control_Sim,
    TITA-Development-Manual, diablo_ros2, diablo_sdk, diablo-sdk-docs, plus the five
    laptop clones of ros2_ws/README.md 1(d).
    Deleted on the user's request and not to be cloned again: upkie_parts (v1 CAD
    STEPs live in robot_cad/upkie_step), upkie_description (the repo copy in
    wheeled_biped/models is the one the code uses), mjlab_upkie and
    Col_DIABLO_Issac_RL (reinforcement learning, out of scope), diablo-sim-env and
    DiabloSTLSDF (deleted Plan 2), TITA-SDK-ROS2 and TITA_CAN_I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
2026-11-14 CLAUDE.md rewritten to current facts only; robot_cad v1 removed except upkie_step; front is no longer "the switch side"
    CLAUDE.md (14,874 -> about 5,300 characters): checked line by line against
    the repository on 2026-11-14. Removed or corrected: the Plan 1-3 era decisions
    that later dated decisions replaced (Plan 2 recommendation, 6 kg / 65 mm wheel
    assumptions, "Isaac Sim optional", the unbuilt ROS 2 packages, "no real MCU
    program"), the 9,000-character robot_cad_v5 change history that
    robot_cad_v5/README.md already records, wrong pointers (MineLQI6 is section 8
    of the controller comparison report, sim/ is not a SIL harness, lqi6/ paths,
    benchmark keys), and the three different "read this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
    [WheelBiped_AKE.f3d, WheelBiped_AKE_assembly.step, ankle_plate_AKE50.step, ankle_plate_AKE50.stl, battery_tray.step, battery_tray.stl, electronics_sled.step, electronics_sled.stl]
2026-11-14 references/: reference repos as pinned git submodules, so every computer reads the same commits
    - 17 shallow submodules under references/ (.gitmodules shallow = true):
    pi3hat 12ab9af (v1.1.0), moteus aec0333, power_dist 5936cba, fdcanusb 91c2b7f,
    moteus_ros2 3d0f85b, upkie ffa9e4d, ddt_ros2_control beb05df,
    TITA_ROS2_Control_Sim 3c782e4, TITA-Development-Manual aba3583,
    diablo_ros2 ed0de02, diablo_sdk cf2c2a9, diablo-sdk-docs 6b73c5b,
    tita_hardware_ros2_control 8c7256c, pi3hat_hw_bartlomiej 04a3a29,
    pi3hat_robotic_systems 168a9b4, pi3hat_hw_glevine da07dcb,
    ros2_control_demos 5b8777c (branch jazzy).
    The first twelve keep the commits the existing file:line citations were made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
2026-11-14 Only robot_cad_v5 and wheeled_biped stay: old CAD folders and the two-wheel design removed, what v5 uses moved in
    User decision of 2026-11-14. The state before this commit is tagged
    before-cleanup-2026-11-14 (bbb4294); everything removed here is there.
    Moved (git mv), because code or current documents use it:
    - robot_cad_v4/fusion -> robot_cad_v5/v4/fusion (the v4 code v5run.load() imports
    and patches) and robot_cad_v4/calc -> robot_cad_v5/v4/calc (strength_v5 cites it)
    - robot_cad_v3/manufacturing/hlr_gmsh.py -> robot_cad_v5/manufacturing/
    - the six v2 machining drawings / STEPs of part_drawings.V2_COPY ->
    robot_cad_v5/manufacturing/v2/
    - the v2 / v3 / v4 READMEs with the twelve image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
    [BOM.csv, WheelBiped_v2.f3d, WheelBiped_v2_assembly.step, WheelBiped_v3.f3d, WheelBiped_v3_assembly.step, WheelBiped_v4.f3d, WheelBiped_v4_assembly.step, battery_tray.step]
